dj-filippo241/maelcum_mixer/proto-max/RISULTATI-P0.md

# RISULTATI P0 — MC-CHANNEL (2026-10-14)

Piano: `docs/proto-max/piano.md` §2 P0 e §3. Generatore:
`proto-max/coefficienti/genera.py` (numeri in `canale.py`).

## Cosa contiene

- GAIN −∞ … 0 … +10 dB, law del VCA di canale (`sim/cdj/vca-law.cir`):
  metà CCW lineare in dB da −100 a 0, metà CW da 0 a +10.
- Isolator v0.4 (`eq-isolator-v0.4.md` §3, §9): banca LR4, allpass del
  2° ordine, pot lineare ×2, silenzio a fondo corsa (contatto).
  Selettore A 150/500/2500 Hz, C 150 dolce/350/3150, D 150 dolce/700/3150
  Hz (B7; fino al
  2026-10-14 sera B 100/630/4000, scartata con A, dec. 114), dissolvenza
  20 ms tra due banche che girano entrambe.
- Fader −∞ … 0, law [PROVVISORIA]: θ², −12 dB a metà corsa.
- Manopole lisciate a 10 ms.
- Non modellati: blocco della continua d'ingresso (0,72 Hz) e servo DC
  (Live non porta continua); clip e rumore (non si validano a orecchio,
  piano §1).

## FINDING: serve l'oversampling 4×

La banca convertita in digitale (bilineare con prewarp) stringe le
pendenze vicino a fs/2. Scarti contro LTspice senza oversampling:

| Incroci | 44,1 kHz | 48 kHz | 96 kHz |
|---|---|---|---|
| A 150/500/2500 | 1,09 dB (HIGH chiusa, 5 kHz) | 0,91 | 0,23 |
| B 100/630/4000 | 3,24 dB (HIGH chiusa, 8 kHz) | 2,73 | 0,85 |

Rimedio: la banca gira a 4× la frequenza di Live. Due stadi 2×
halfband polifase (schema hiir, de Soras): 12 coefficienti per
fs → 2fs, 4 per 2fs → 4fs. A 20 kHz passano con perdita < 0,000001 dB;
le immagini restano sotto −116 dB. L'infrastruttura serve anche a P1 e
P2: i saturatori la chiedono comunque.

## Verifica 1 — modello contro LTspice (`verifica.py`)

Criterio: scarto ≤ 0,5 dB dove LTspice sta sopra −40 dB; sotto, anche
il modello sotto −40 dB. Casi: le 9 righe di `eq-isolator` §4 e §9
(`iso-c-ac.log`) e le 6 della variante B (`iso-ac-b.log`), 12
frequenze, a 44,1 / 48 / 96 kHz.

| Incroci | 44,1 kHz | 48 kHz | 96 kHz |
|---|---|---|---|
| A (netlist col contatto) | 0,070 dB | 0,060 | 0,018 |
| B (netlist senza contatto) | 0,443 | 0,416 | 0,347 |

**PASS.** Lo scarto di B viene dal netlist, non dal modello: senza
contatto il pot chiuso lascia passare −54 dB (10 Ω su 10 kΩ). Con il
residuo del pot nel modello lo scarto scende a 0,01-0,03 dB. Il circuito
di progetto ha il contatto (eq-isolator §8): il modello segue quello.

## Verifica 2 — codice gen~ contro modello (`prova_gen.py`)

Il testo di `MC-CHANNEL.genexpr` tradotto in Python e suonato campione
per campione a 48 kHz (sinusoidi, ampiezza con fit ai minimi quadrati).
20 punti dell'isolator (A e B), 5 di GAIN, 3 di FADER, separazione dei
lati: **PASS, scarti ≤ 0,002 dB.**

Due errori trovati e corretti in questa verifica (il modello in
frequenza non li vedeva):

1. Ogni sotto-campione a 4× aveva filtri suoi: ogni filtro vedeva un
   campione su quattro e gli incroci scendevano di 4 volte (LOW chiusa:
   −0,4 dB a 80 Hz invece di −22,5).
2. Lo stesso errore sul secondo stadio dell'halfband: calo di −0,09 dB
   a 8 kHz con le manopole al centro.

## Verifica 3 — in Live (Filippo, 2026-10-14, `montaggio.md` §4)

- `MC-CHANNEL.amxd` si apre trascinato su una traccia; gen~ compila.
- Tutto al 50 %: suono invariato. Quattro bande a 0 %: silenzio.
- CPU con 4 dispositivi: **4 %** (240 biquad e 64 sezioni allpass per
  campione, per dispositivo). Margine ampio per P1-P4.

## Non verificato
- Confronto con LTspice dentro Max (rumore rosa, piano §3): sostituito
  dalle due verifiche sopra, che coprono la stessa catena in modo
  ripetibile.

## Variante C (2026-10-14 sera, dopo l'ascolto, dec. 114)

Richiesta di Filippo: HI a metà tra A e B; MID-HIGH che scende più in
basso; LOW e LOW-MID più accavallate. Proposta approvata: **C = 150 Hz
dolce / 350 / 3150 Hz**. Il primo incrocio è LR2 (12 dB/ott, Q 0,5):
LP2 − HP2 = allpass del 1° ordine, quindi i rami alti girano di polarità
e la somma resta piatta senza allpass in più (`canale.PENDENZE`). In
hardware è lo stesso schema con meno componenti su quell'incrocio; il
netlist LTspice di C si fa solo se C (o una sua figlia) passa l'ascolto.

Modello (`canale.isolator`, analogico), dB:

| Banda chiusa, punto | A | B | C |
|---|---|---|---|
| LOW, 50 Hz | −38,3 | −24,6 | −20,0 |
| LOW, 80 Hz | −22,5 | −10,7 | −13,1 |
| LOW, 250 Hz | −1,1 | −0,2 | −2,7 |
| LOW-MID, buco più profondo | −16,0 (275 Hz) | −26,3 (251) | **−7,8 (229)** |
| MID-HIGH, buco più profondo | −22,4 (1122) | −26,4 (1585) | −27,5 (1148) |
| HIGH, 5 kHz | −24,6 | −10,7 | −17,3 |
| HIGH, 8 kHz | −40,5 | −24,6 | −32,5 |

FINDING: con C la LOW-MID chiusa da sola scava solo −7,8 dB (stima a
voce prima del calcolo: ~−15). Banda stretta (1,2 ottave) e fianco basso
dolce: LOW e MID-HIGH la riempiono. È il prezzo dell'accavallamento.

Verifiche: `verifica.py` PASS invariato (A e B contro LTspice, il
modello LR4 non cambia); `prova_gen.py` PASS con 16 punti di C, scarti
≤ 0,001 dB. Il selettore ora porta A e C.

## Variante D (2026-10-14 sera)

Richiesta di Filippo: HI-MID «abbastanza ampio ma senza il kick», «più
simile ai mixer DJ del benchmark» (`docs/09`: confine implicito tra i
centri LO-MID e HI-MID = 620-760 Hz). **D = 150 Hz dolce / 700 / 3150 Hz**,
scelta di Filippo tra D, 500 Hz e entrambe. Nota a Filippo: contraddice in
parte la richiesta di prima (HI-MID sotto 500/630); nei mixer DJ i medi
sono campane larghe e il taglio di HI-MID si sente anche verso 400 Hz.

| Modello, dB | C (350) | D (700) |
|---|---|---|
| HI-MID aperta da sola, 250 Hz (colpo del kick) | −16,4 | −38,6 |
| HI-MID aperta da sola, 150 Hz | −35,7 | −59,6 |
| HI-MID chiusa, buco più profondo | −27,5 (1148 Hz) | −19,9 (1514 Hz) |
| LOW-MID chiusa, buco più profondo | −7,8 (226 Hz) | −13,8 (367 Hz) |

Selettore a tre posizioni (A, C, D), dissolvenza 20 ms tra varianti
vicine. `prova_gen.py` PASS con 9 punti di D in più.

## Selettore CURVA (2026-10-14, 23:55)

Filippo vuole la curva dei DJM Pioneer. I dati (docs/09 §7) dicono
−12 dB a ore 9 (DJM-600/850) e taglio rapido a fine corsa; col pot
lineare di serie nessuna rete passiva ci arriva. Per sentire se la
differenza conta: selettore **CURVA = LINEARE / PIONEER** (ideale, solo
ascolto). PIONEER: lato taglio (2θ)^1,5, lato boost uguale al lineare.

| Manopola | 5 % | 10 % | 20 % (ore 9) | 30 % | 40 % | 50 % | 75 % | 100 % |
|---|---|---|---|---|---|---|---|---|
| LINEARE, dB | −20,0 | −14,0 | −8,0 | −4,4 | −1,9 | 0 | +3,5 | +6,0 |
| PIONEER, dB | −30,0 | −21,0 | −11,9 | −6,7 | −2,9 | 0 | +3,5 | +6,0 |

`prova_gen.py` PASS (6 punti della curva PIONEER su D). Se PIONEER vince
all'ascolto, il circuito per costruirla resta da studiare (pot a taper
con trim, oppure stadio attivo).

## Selettore EQ TIPO (2026-10-15, voce B5)

Filippo tiene B5 aperta come opzione d'ascolto: **EQ TIPO = ISOLATOR /
SERIE**. SERIE è l'EQ in serie archiviato (v0.3 beta-3,
`docs/fase1/eq-serie-v0.3.md`): LOW Baxandall a shelf (70 Hz), LOW-MID e
MID-HIGH a campana sottrattiva (250 Hz Q 0,8 e 1 kHz Q 0,9), HIGH
sottrattiva con HP2 (~4,9 kHz). L'EQ di progetto resta l'isolator
(dec. 105). Modello: `coefficienti/serie.py`, ricavato dai componenti di
`sim/eq-serie/cascade-b3.cir` con op-amp ideali. Gira a 4× come
l'isolator; dissolvenza di 20 ms tra i due EQ. INCROCI e CURVA agiscono
solo su ISOLATOR.

Law delle manopole (eq-serie §10): LOW e HIGH a tratti, con il kill
negli ultimi 5 % di corsa; LOW-MID e MID-HIGH pot lineare col cursore
caricato dal summer (10k su 49,9k). Per la HIGH il netlist dà solo gli
estremi: la law intermedia segue quella della LOW in dB, normalizzata
agli estremi del netlist [PROVVISORIO, solo ascolto].

| Manopola | 0 % | 5 % | 10 % | 20 % | 30 % | 40 % | 50 % | 75 % | 100 % |
|---|---|---|---|---|---|---|---|---|---|
| LOW, 20 Hz | −29,2 | −23,6 | −17,9 | −11,3 | −6,9 | −3,3 | 0 | +2,8 | +5,8 |
| LOW-MID, 250 Hz | −48,3 | −19,2 | −13,3 | −7,5 | −4,2 | −1,8 | 0 | +3,4 | +6,0 |
| MID-HIGH, 1 kHz | −44,0 | −19,4 | −13,5 | −7,6 | −4,2 | −1,8 | 0 | +3,4 | +6,0 |
| HIGH, 20 kHz | −9,1 | −9,2 | −9,2 | −8,3 | −6,1 | −3,2 | 0 | +2,8 | +5,9 |

Cosa si sente rispetto all'isolator: nessuna banda spegne. LOW a zero
lascia la coda del basso (−16 dB a 250 Hz, −5 a 1 kHz); i medi a zero
scavano una buca stretta (−2 dB a un'ottava dal centro); HIGH a zero
scurisce invece di togliere (+1,7 dB a 5 kHz, −3 a 10 kHz: il finding
della questione 68). Tutte a zero: ~−26 dB sotto, ma 2,5-5 kHz restano
aperti.

Verifiche:
- `verifica_serie.py`: modello contro `cascade-b3.log`, 10 modi × 12
  frequenze. **PASS**, scarto massimo 0,24 dB analogico, 0,25 a 48 kHz,
  0,07 a 44,1, 0,01 a 96 (sotto −40 dB i notch del modello sono più
  profondi: op-amp ideali).
- `prova_gen.py`: 37 punti di SERIE in più, gen~ contro modello.
  **PASS**, scarti ≤ 0,001 dB; i punti di prima restano invariati.
- Non verificato: apertura in Max (sintassi gen~) e CPU con il ramo in
  più (4 biquad × 4 sotto-campioni × 2 lati).

## CPU: solo i blocchi che si sentono (2026-10-15 sera)

Finding in Live (Filippo): con canale, filtro e 5-way sulla stessa traccia,
muovendo le manopole l'audio «cambia velocità». Causa: Live calcola i
dispositivi di una traccia in fila su un solo core; il processo Live stava
a ~80 % di un core (l'indicatore CPU di Live, ~45 %, è la media dei core).
Il MC-CHANNEL con EQ TIPO non partiva più (Edit compreso). Con i
dispositivi MC spenti il problema spariva.

Rimedio: MC-CHANNEL calcola solo le varianti con peso > 1e-5 (−100 dB):
in uso normale una banca su quattro (A, C, D, SERIE), due durante i 20 ms
di dissolvenza. Gli stati di un blocco spento vanno a zero, così riparte
pulito. `prova_gen.py` PASS, più una prova nuova dei cambi di selettore
(A → D → SERIE → C: valore giusto dopo l'assestamento, nessun picco).

## SERIE v2 (2026-10-31, todo 210)

In Live, EQ TIPO = SERIE dava rumore fortissimo e clip continuo con la
musica che suona; tornava normale su ISOLATOR. La prova Python
(`prova_gen.py`) sullo stesso codice era stabile, e nel modello non c'e
alcun anello: le celle sommano in avanti. La causa esatta dentro gen~ non
e trovata. La v1 calcolava i biquad passando alla bilineare i polinomi in
s interi (coefficienti fino a 1e8 prima della divisione).

v2: LOW = due celle del 1o ordine, fattori esatti del Baxandall
(R + Zb) / (R + Za); LOW-MID, MID-HIGH e HIGH = biquad con prewarp da f0, Q
e guadagno al centro del circuito, come le bande dell'isolator che in Live
funzionano. Stabili per costruzione: polo piu vicino al cerchio 0,99938
(0-100 % di corsa, 44,1-192 kHz a 4x). `verifica_serie.py` contro
`cascade-b3.log`: PASS (scarto max 0,24 dB analogico, 0,23 dB a 48 kHz).
`prova_gen.py`: PASS. Comandi e law invariati.

Protezione (stesso giorno, solo prototipo): un campione NaN, infinito o
oltre +36 dBFS azzera gli stati ed esce silenzio; senza, un NaN avvelena il
mixer della traccia di Live. `MC-CHANNEL-PROVA` (`genera.py --prova`) ha
in piu il selettore STADI SERIE per accendere le celle una alla volta.

## XONE al posto di SERIE (2026-10-31, B5)

All'ascolto SERIE v2 era pulito, ma Filippo: «l'eq taglia veramente troppo
poco» (a 0 %: LOW -25 dB a 70 Hz, medi buco stretto, HIGH -3 dB a 10 kHz).
Richiesta: «serie ridisegnato in modo tale da essere simile al eq degli
xone». Il selettore EQ TIPO ora e ISOLATOR / XONE; il modello archiviato
`serie.py` resta, non e piu nel dispositivo.

Modello `coefficienti/xone.py`, dall'EQ musicale del Xone:92 (user guide
AP5345, guida Limited Edition): LO 250 Hz e HI 2,5 kHz da +6 dB a kill
(coppie Linkwitz-Riley 2: g LP2 - HP2, allpass a g = 1, a fondo corsa
filtro a 12 dB/ottava), LO-MID 350 Hz e HI-MID 2 kHz campane RBJ da +6 a
-30 dB, Q 0,6 in taglio e 2 in boost [PROVVISORIO: il Xone non le
pubblica]. Law delle manopole dell'isolator, CURVA compresa.

| pos % | LO a 60 Hz | LO-MID a 350 Hz | HI-MID a 2 kHz | HI a 10 kHz |
|---|---|---|---|---|
| 0 | -25,3 | -30,0 | -30,0 | -24,7 |
| 10 | -12,3 | -14,0 | -14,0 | -12,2 |
| 25 | -5,6 | -6,0 | -6,0 | -5,5 |
| 50 | 0 | 0 | 0 | 0 |
| 100 | +5,8 | +6,0 | +6,0 | +5,8 |

(CURVA LINEARE, 48 kHz.) A 0 % il LO e un passa-alto: piu si scende sotto
250 Hz, piu taglia (-37 dB a 30 Hz); lo stesso per HI sopra 2,5 kHz.
Tutte al centro: piatto entro 1e-11 dB. Polo piu vicino al cerchio
0,99949 (44,1-192 kHz a 4x). `prova_gen.py`: PASS (casi XONE gen~ contro
`xone.xone_os`). `MC-CHANNEL-PROVA` tolto: serviva solo al guasto di SERIE.

## DJM al posto di XONE (2026-10-31, B5)

All'ascolto XONE taglia ancora troppo poco (Filippo). ISOLATOR va bene;
Filippo vuole un'opzione che tagli tantissimo, sul modello del DJM-900NXS,
in due versioni («dammi sia 1 che 2»): fedele al manuale e spinta. Il
selettore EQ TIPO ora e ISOLATOR / DJM -26 / DJM SPINTO -40; `xone.py`
resta come archivio, non e piu nel dispositivo.

Dato del manuale DJM-900NXS: LOW 70 Hz, MID 1 kHz, HI 13 kHz, ognuna da
-26 a +6 dB. Pioneer non pubblica dove partono gli scaffali ne la larghezza
della campana: i numeri sotto sono scelte [PROVVISORIO]. Modello
`coefficienti/djm.py`: celle RBJ (scaffali S = 1, campana), LOW = scaffale
basso, LOW-MID = campana a 1 kHz, HIGH = scaffale alto, MID-HIGH non agisce.
Law dell'isolator in dB, fermata al fondo; +6 dB a fine corsa.

| variante | scaffale LOW | scaffale HIGH | stadi per lato | Q MID | fondo |
|---|---|---|---|---|---|
| DJM -26 | 300 Hz | 3,6 kHz | 1 | 0,7 | -26 dB |
| DJM SPINTO -40 | 320 Hz | 3 kHz | 2 | 0,5 | -40 dB |

Tagli a 0 % (le altre al centro, 48 kHz):

| banda | DJM -26 | DJM SPINTO -40 |
|---|---|---|
| LOW a 70 / 150 / 250 / 500 Hz | -25,8 / -22,5 / -15,8 / -5,5 | -39,8 / -36,6 / -26,8 / -8,4 |
| MID a 300 / 1000 / 4000 Hz | -7,3 / -26,0 / -5,9 | -16,5 / -40,0 / -14,7 |
| HIGH a 2 / 3,5 / 5 / 13 kHz | -4,6 / -12,6 / -18,0 / -25,5 | -9,3 / -24,3 / -32,9 / -39,8 |

Corsa uguale per tutte: 10 % circa -14 dB, 25 % -6 dB, 50 % 0, 100 % +6
(CURVA LINEARE). Tutte al centro: piatto. `prova_gen.py`: PASS (casi DJM
F e P gen~ contro `djm.djm_os`, cambi di selettore senza picchi);
`prova_semplice.py` PASS; `regole_gen.py` nessuna collisione; rumore
bianco con manopole a 0 e a 100 %: stabile. MC-CHANNEL-S invariato.

## INCROCI A 400 e A 450 (2026-10-31, libretto 7.2)

Filippo: «incroci da rivedere: vorrei un MID-HIGH più ampio verso il basso
(non di molto)»; scelta «400 450». Due voci nuove nel selettore INCROCI di
MC-CHANNEL, tutte LR4 come A: A 400 = 150 / 400 / 2500 Hz, A 450 = 150 /
450 / 2500 Hz. Le voci si chiamano ora A 500, C 350, D 700, A 400, A 450
(il numero e l'incrocio fra LOW-MID e MID-HIGH). MC-CHANNEL-S resta su A.

Esito: Filippo sceglie **C** (dec. 152). MC-CHANNEL-S passa da A a C;
A 400 e A 450 restano nel selettore della versione completa.

## MC-CHANNEL-S sulla curva LINEARE (2026-11-04, todo 240, dec. 168)

L'hardware usa un pot lineare B a catalogo: la curva PIONEER non si fa
(dec. 168, `sim/eq-iso/RISULTATI-incroci-C.md` §3). MC-CHANNEL-S passa da
PIONEER a LINEARE, come il mixer vero. Sopra il centro non cambia niente;
sotto il centro il taglio è più dolce: a ore 9 la banda sta a −8 dB invece
di −12, a 10 % a −14 invece di −21.

Il selettore CURVA di MC-CHANNEL ha già la voce LINEARE (pot lineare ×2):
nessuna voce nuova. Confronto con la simulazione dell'hardware (stesso
§3, tutte le manopole alla stessa posizione, 1 kHz):

| θ | 0,05 | 0,1 | 0,2 | 0,25 | 0,3 | 0,4 | 0,5 | 0,75 | 1 |
|---|---|---|---|---|---|---|---|---|---|
| prototipo LINEARE, dB | −20,0 | −14,0 | −8,0 | −6,0 | −4,4 | −1,9 | 0 | +3,5 | +6,0 |
| HW pot lineare B, dB | −19,7 | −13,8 | −7,9 | −6,0 | −4,4 | −1,9 | 0 | +3,5 | +6,0 |

Scarto massimo 0,3 dB, a θ 0,05. Unica differenza vera: a fondo corsa il
prototipo tace, l'hardware resta a −48 dB (residuo di 20 Ω del pot, niente
contatto di fondo corsa, dec. 127). Il prototipo non la imita.

MC-CHANNEL invariato (rigenerato identico). `prova_semplice.py` confronta
ora il -S con MC-CHANNEL su INCROCI C 350 e CURVA LINEARE: PASS, scarto 0
su 6 casi. `prova_gen.py` PASS; `regole_gen.py` nessuna collisione.

## GAIN a pot doppio in MC-CHANNEL e MC-CHANNEL-S (2026-11-12, dec. 162)

Il GAIN del prototipo seguiva ancora la legge del VCA (−100 dB → 0 → +10 dB, a ore 11 già
−20 dB). La dec. 162 ha messo un pot doppio nel segnale: ora il prototipo usa il circuito T1
(`sim/gain-pot/`, pot 10k lineare, Rl 4,30k dal cursore a massa, non invertente ×3,15;
`canale.gain_lin`, `genera.py`). All'orecchio: la metà sinistra diventa un trim (−5,2 dB al
25 %, silenzio solo a fondo corsa), la metà destra resta 0 → +10 dB (+4,3 dB al 75 %). Lo
stesso per il GAIN dei ritorni (RISULTATI-P3, T2). Prove: `prova_gen.py` (attesi dal modello)
e `prova_fx.py` PASS; `prova_semplice.py` PASS.

Verificato in: Python sì / LTspice no (la curva viene da `sim/gain-pot/gain_pot.py`) / Live no.
