dj-filippo241/maelcum_mixer/docs/01-decisioni-bloccate.md

# Decisioni bloccate

> Regola del progetto: una decisione sta qui UNA VOLTA SOLA. Se cambia, si sposta in
> `questioni-aperte.md` con la data e il motivo, e qui si aggiorna. Niente duplicati.
>
> Legenda origine: **[F]** = detta da Filippo il 2026-09-17 · **[R]** = dal resoconto
> ChatGPT (da riverificare sull'export completo) · **[C]** = proposta di Claude accettata da Filippo.

## Scopo e portata

1. **[F]** Esemplare unico, per il soundsystem di Filippo. Nessuna produzione in serie: si ottimizza per qualità sonora e manutenibilità, non per costi.
2. **[F]** Ruolo di Claude: supporto quasi totale — specifica, progettazione circuiti, simulazioni, selezione componenti, schemi.
3. **[F]** Costruzione fisica: da decidere chi la esegue (vedi questioni aperte).
4. **[F]** Ordine di costruzione — **fase 1**: un modulo canale (phono o CDJ/line), un modulo FX, master out, alimentazione di base. **Fase 2**: 5-way preamp e filtro globale. Motivazione: i moduli semplici validano il backplane prima di affrontare i blocchi difficili.
5. **[F]** Metodo: PRIMA revisione completa e critica del lavoro fatto con ChatGPT (appena arriva l'export), POI si progetta. Niente costruzione sulla base del solo resoconto parziale.

## Architettura generale (dal resoconto, da confermare su export)

6. **[R]** 100% analogico per l'audio. Nessun DSP interno. Il DSP esterno resta responsabile di: crossover di sistema, protezione altoparlanti, EQ di sistema, delay/allineamento, gestione finali.
7. **[R]** Livelli: nominale 0 dBu; headroom interna pulita ≥ +24 dBu come requisito DI SISTEMA (non di ogni IC — correzione 1/2 della review).
8. **[R]** Alimentazione: rail di sistema ±24 V con regolazione locale per ogni dominio di tensione degli integrati (es. ±15 V locali).
9. **[R]** Nessun compressore/limiter/AGC nel percorso audio. Le uniche nonlinearità volute: overdrive del filtro globale e drive del 5-way. [ECCEZIONE dec. 145, 2026-10-31: limiter fisso sul solo modulo MIC.]
10. **[R]** Protezione elettrica ≠ processing dinamico: restano obbligatorie protezioni DC, corto, ESD, mute power-on/off (non sono "dinamica").
11. **[R]** Buffering a bassa impedenza tra stadi/moduli. Ogni uscita (MASTER, BOOTH, REC) ha il suo buffer dedicato: mai un buffer unico splittato.
12. **[R]** Architettura stereo: no pan, controlli linked L/R, tracking ≤ 0,25 dB, mono-compatibile.
13. **[R]** Costruzione modulare su backplane. Il backplane separa fisicamente: bus audio, bus di controllo, alimentazione, ground/reference, chassis/shield. Niente connessioni a nodi interni tra moduli. Niente hot-swap. Test point sui moduli.
14. **[R]** Convenzione d'interfaccia CV 0–5 V sul backplane — è una convenzione di interfaccia, NON la tensione nativa di ogni circuito (ogni stadio può avere la sua legge interna, es. esponenziale per le frequenze).

## Canali DJ

15. **[R]** 4 canali DJ. Catena: input → gain → EQ → split CUE/FX → filtro (selettore locale) → fader → bus.
16. **[F]** Ogni canale può esistere come modulo a sé stante.
17. **[F]** EQ di canale: 4 bande in stile Xone — bassi, medio-bassi, medi, alti. Ogni knob scende fino a −∞ (full CCW = kill della banda).
18. **[F]** Frequenze e comportamenti esatti dell'EQ di canale: da rivedere insieme in seguito (non bloccati).
19. **[R]** Phono: ingressi con RIAA (costanti 3180/318/75 µs come riferimento concettuale — il circuito vero è da progettare), loading/capacità dipendenti dalla testina, terminale di terra dedicato per giradischi.

## 5-way performance EQ (il "preamp")

20. **[R]** Il 5-way sta tra i bus di canale e il master: DJ bus → 5-way → master.
21. **[F]** Le 5 bande (SUB, KICK, MID, HIGH, SUPER HI) corrispondono alle 5 vie fisiche dell'impianto di Filippo.
22. **[F]** I kill switch stanno nella sezione preamp: uno per via, tarati per spegnere interamente il segnale di quella via dell'impianto.
23. **[R]** KILL prima dell'EQ creativo: l'EQ non può ripristinare materiale killato. Il KILL va progettato come filter bank complementare (le 5 bande sommate ricostruiscono risposta piatta senza kill attivi), non come 5 filtri indipendenti.
24. **[F]** Curva del drive — piena CCW = pulito (0); a metà corsa (~50%) il 5-way lavora nel punto ottimale (es. boost +7 dB senza distorsione); oltre il 50% la saturazione entra progressivamente e interagisce con i gain di banda e con l'overdrive del filtro. Da tradurre in taper del pot + gain staging.
25. **[R]** Drive: JFET in prima istanza / BJT asimmetrico in seconda, post-EQ, con input drive e headroom globali. È un dub-preamp su misura, non un parametrico generico.

## Filtro globale

26. **[R]** Controlli: 4 condivisi (freq HPF, freq LPF, risonanza, overdrive) + selettore locale per canale HPF/OFF/LPF. (La versione precedente "controlli locali per canale" è SUPERATA.)
27. **[R]** SVF 4 poli; HPF 20 Hz–1,5 kHz; LPF 500 Hz–20 kHz; risonanza fino all'auto-oscillazione che segue il cutoff (max ~+6/+10 dBu con limiting morbido); overdrive DOPO il filtro.
28. **[F]** Riferimento sonoro: più vicino allo Sherman Filterbank che all'E&S — carattere aggressivo, risonante, personalità marcata.
29. **[F]** Auto-oscillazione usata musicalmente (non solo come colore al limite).

## Sistema FX

30. **[R]** 4 bus FX. Mandate con EQ 2 bande e switch di assegnazione. Ritorni con fader.
31. **[R]** Matrice di feedback tra FX: 12 percorsi diretti, 3 destinazioni per ritorno, niente self-route. Da progettare come rete di routing analogica unica, non come 12 hack indipendenti.
32. **[R]** Reroute PRE-fader: il fader del ritorno taglia l'audio verso il master ma NON il feedback interno.
33. **[R]** VCA analogici per il rerouting (THAT 2180 come candidato reale) con gestione di livello propria (il VCA non eredita automaticamente il +24 dBu di sistema).
34. **[F]** Interfaccia pedali: pronta SIA per pedali chitarra SIA per rack da studio → pad di mandata selezionabile (−20 dB è valore di prototipo, non congelato). Ritorno: alta impedenza (≥ 1 MΩ), alto headroom, protezione.
35. **[F/C]** I controlli della matrice vanno pensati per l'uso dal vivo: utilizzabili mentre si mixa, con via di fuga rapida (il fader taglia subito l'audio). Elettricamente identica alla versione studio.

## Mic e ingressi generici

36. **[F]** Mic: solo dinamici, NIENTE phantom 48 V. Semplifica preamp e protezioni; gain ~40-50 dB.
37. **[R]** Ingressi mono generici: architettura a modulo sorgente generico, non cucita su uno strumento specifico. Mono → stereo conversion, EQ 2 bande, clip warning, FX send.

## Master, uscite, metering

38. **[R]** MASTER LEVEL: −∞ → 0 dB → +6 dB, stadio attivo (non solo pot passivo), stereo-linked, full CCW = mute pratico. Meter DOPO il level (il meter mostra il livello reale in uscita).
39. **[R]** BOOTH: presa da MASTER SUM prima del MASTER LEVEL; −∞ → 0 dB; il master level non influenza il booth.
40. **[R]** REC: presa da MASTER SUM prima di entrambi i level; nessun controllo utente; ≈ 0 dBu al nominale.
41. **[F]** REC out → registratore Zoom (modello esatto da comunicare; implica livello/impedenza/connettore adatti all'ingresso Zoom).
42. **[R]** Uscita master: driver di linea bilanciato attivo, XLR L/R, Z out < 50 Ω ideale, capacità pulita ≥ +24 dBu, protezione corto, niente trasformatore d'uscita, nessuna colorazione intenzionale.
43. **[R]** Metering a 6 zone: blue (poco) → green (safe) → yellow (loud) → amber (hard) → red (extreme) → purple (clipping reale, con clip detector vero sul nodo).
44. **[R]** Banda complessiva target 8 Hz–35 kHz con filtro OFF (il filtro inserito limita volutamente la banda); la tolleranza esatta (es. ±0,1 dB) NON si specifica prima di misurare.

## Alimentazione

45. **[F/C]** PSU: lineare con trasformatore toroidale + regolazione locale per sezione. Nessun vincolo di peso dichiarato. Switching = piano B se il peso diventasse un problema.
46. **[R]** Power-on mute e power-off mute obbligatori. Sequencing e protezione per ramo di modulo. Budget di corrente e termico da calcolare.

## Interfaccia fisica

47. **[F]** Fader = slider; tutto il resto = potenziometri rotativi.
48. **[R]** Il design del pannello frontale è di Filippo; da Claude solo i requisiti elettrici (consumi modulo, pin connector, correnti backplane, contatti di massa, schermature, accessi di servizio/test).

## Modulo MASTER OUT — decisioni di Filippo (2026-09-18)

49. **[F]** MASTER OUT universale: deve lavorare con la maggior parte dei DSP standard, nessun processor specifico di riferimento (XLR bilanciato, 0 dBu nominale, capace di pilotare ingressi pro +4 dBu con trim, Z out < 50 Ω).
50. **[F]** REC OUT universale: compatibile con la maggior parte dei registratori standard (Zoom o equivalente): jack TRS con cablaggio unbalanced-compatible, attenuazione fissa a −10 dBV [PROVVISORIO], jumper −10/−20 dB opzionale sul PCB.
51. **[F]** Connettore BOOTH: XLR bilanciato.
52. **[F]** MASTER LEVEL con detent meccanico a unity. L'hardware di tutte le manopole (marca/modello pot, slider, cap) si rivede globalmente in una sessione dedicata più avanti.
53. **[F]** Metering master alla massima precisione possibile: scala logaritmica 20 segmenti per canale a passi 3 dB (LM3915 in cascata come candidato), attacco < 1 ms, decay regolabile, purple = clip detector indipendente con latch 0,5 s.
54. **[F]** Rail ±15 V low-noise con LT3045/LT3094 confermati (summing, CV del VCA, meter).
55. **[F]** La logica colori/zone del meter NON si reinventa: è definita nel backlog con ChatGPT e si recupera dall'export [EXPORT]. La scala elettrica a 20 segmenti è progettata indipendentemente dai colori.

## Modulo CANALE CDJ/LINE (2026-09-18)

56. **[F]** Scope fase 1 del canale: SOLO ingresso line (CDJ/line). La sezione phono/RIAA non si progetta ora; il modulo lascia spazio a una variante phono futura. Design v0.1 in `docs/fase1/cdj-line-channel.md`.
57. **[R derivato]** Split CUE e FX send sono PRE-FADER (derivato dalla catena bloccata del resoconto, voce 15): canale chiuso non zittisce CUE né FX send.

## Dalle risposte di Filippo ai 12 quesiti + status document (2026-09-18 pomeriggio)

58. **[R2]** Corpus di riferimento CHIUSO: resoconto 00 + i due status doc del 2026-09-18 (`docs/export-chatgpt/`) sono la referenza completa e definitiva. Non è possibile ottenere un export migliore della conversazione; non esiste una "project specification" separata lato ChatGPT. Le voci [EXPORT] si risolvono contro questi documenti o restano aperte in modo definitivo.
59. **[R2]** Dettagli confermati dagli status doc: canali STEREO identici; gain canale −∞→0→+10 dB con detent centrale e tracking ≤0,5 dB; EQ 4 bande −∞→0→+6 dB (LOCKED) con tracking ≤0,25 dB e law "lenta al centro, rapida agli estremi"; frequenze EQ proposte 70/250/1k/5k Hz (LOW/LOW-MID/MID-HIGH/HIGH, Q ~0,7-0,9); assignment FX multiple simultanee con precision analogue switch (JFET scartati); CUE post-EQ/pre-filter/pre-fader; return gain −∞→0→+20 dB; meter DJ completo post-filter/overdrive pre-fader con persistenza e calibrazione identica tra canali; tabella legge di reroute FX.
60. **[F]** Il MODULO FILTRO è ESTERNO ai canali (chiarimento del proprietario, corregge la lettura di docs/03 §3.3): il canale ha SOLO il selettore HPF/OFF/LPF; i 4 core filtro stereo + controlli condivisi (freq HPF, freq LPF, risonanza, overdrive) + stadio overdrive vivono nel modulo filtro dedicato. Tra canale e modulo filtro: send/return audio sul backplane + logica del selettore. L'ipotesi originale del CDJ v0.1 §3.6 è quella valida.
61. **[F]** Build order confermato (nessuno spezzamento 1a/1b necessario, dato il filtro esterno): fase 1 = canale line (senza phono; filtro su OFF/bypass finché il modulo filtro non esiste) + modulo FX + master-out + PSU base; fase 2 = modulo filtro e 5-way. Phono Rev A solo su carta.
62. **[F]** Phono V1: MM-only (copre testine DJ standard e MM di alta qualità); MC fuori scope (eventuale step-up/Rev B). Connettore RCA stereo + ground dedicato; 47 kΩ al connettore; capacità interna selezionabile con default 100 pF, accesso solo tecnico (nessun selettore user). Gain totale 40-42 dB NON congelato: si bilancia nel gain-staging globale. Primo stadio: entrambe le varianti dei documenti restano [PROVVISORIO] (21,3 dB del PDF, grounded sul PhL-100 / 26,0 dB dell'addendum DOCX, che Filippo indica come successivo) — sceglie la simulazione (rumore vs overload).
63. **[F]** REC OUT: 0 dBu nominali fissi, nessun controllo utente («la cosa più semplice e standard»); pad solder-only 0/−10/−20 dB sul PCB per registratori sensibili (accesso tecnico). Supersede la proposta −10 dBV + jumper utente.
64. **[F]** Terza banda EQ = MID-HIGH @ ~1 kHz (è ciò che Filippo chiama «medi»).
65. **[F — REQUISITO NUOVO]** Capacità infrasub ~10 Hz: il mixer deve poter scendere sotto i sub. Specifica derivata: banda complessiva −3 dB a ≤8 Hz (10 Hz entro ±1 dB); territorio del KILL SUB esteso a ~10-90 Hz; nessun accoppiamento AC con corner >5 Hz nel percorso principale (DC servo); metering leggibile anche a 10 Hz (peak detector senza sagging) — **PARTE REVISIONATA 2026-09-28 dalla decisione 81: ballistica meter stile Pioneer DJM (release ~0,3 s), «senza sagging» sostituito da «leggibile a zone con ballistica viva»**; HPF min esteso a 10 Hz oppure 20 Hz con posizione OFF per l'infrasub → [APERTO-F, nuova voce 49]. Il resto della decisione (banda infrasub, DC servo, territorio KILL SUB) resta invariato.
66. **[R2]** Riferimento impianto: typologia «5-way dub soundsystem» (i modelli specifici non contano, erano indicativi); crossover di riferimento ~90 Hz / ~350 Hz / ~1,2 kHz / ~3,5 kHz [PROVVISORIO]; espansione futura 4×SUB + 4×KICK annotata come concept.

## Modulo FILTRO — architettura scelta da Filippo (2026-09-18, "B prime")

67. **[RIVISTA dalla dec. 159 (2026-10-31): i core non sono più per canale, ma uno stereo per sezione sulla somma dopo il fader; pannello e 6 knob restano.]** **[F]** Architettura filtro = **B′**: un core filtro dedicato per canale (4 stereo, tutti nel modulo filtro esterno — decisione 60 confermata), con DUE set di parametri indipendenti e condivisi: sezione HPF (freq, resonance, overdrive) e sezione LPF (freq, resonance, overdrive) = **6 knob sul modulo filtro**. Sul modulo canale: **solo switch 3 posizioni HPF/OFF/LPF** (niente BPF — escluso esplicitamente). Tutti i canali nella stessa modalità seguono gli stessi knob. L'overdrive di canale segue il set della sezione selezionata dallo switch. Conseguenza elettrica accettata: 8 core mono (4 canali × L/R) sullo stesso PCB, con trimming per il tracking (voce 51).
68. **[F derivato — veto possibile]** HPF min esteso a **10 Hz** (range 10 Hz–1,5 kHz): conseguenza diretta del requisito infrasub (decisione 65) — con filtro inserito e knob al minimo, l'infrasub a 10 Hz resta udibile. Fattibilità del converter da verificare in simulazione SVF; se impossibile, ripiegare a 20 Hz + posizione OFF e riaprire la questione.
69. **[F]** Phono, conferma risposta "7 rca": pannello = RCA stereo + ground dedicato; loading/capacità solo interni (tecnico). Capacità selezionabile: resta come opzione economica su solder-pad/DIP interno (default ~100 pF) — non è strettamente necessaria (un valore fisso ben scelto + capacità del cavo copre il 90% dei casi MM), ma costa ~2 € e dà margine di rifinitura; se Filippo preferisce eliminarla, fisso ~150 pF.

## Legge dei knob filtro + gain staging (2026-09-18 pomeriggio)

70. **[F]** Legge dei controlli di frequenza del filtro (HPF e LPF): agli estremi della corsa il filtro **cancella tutto** (silenzio); la curva è musicale per ~il 90% centrale e **accelera fortemente negli ultimi ~5% a entrambe le estremità**. Implementazione: shaper di CV a tratti (rete diodi/resistori, tecnica standard da sintetizzatore, rifinitura a banco). Conseguenza ingegneristica [DA CONFERMA ESPLICITA]: entrambe le sezioni spazzano l'intera banda audio ~10 Hz–25 kHz (carattere Sherman) — questo SUPEREREBBE i range dei documenti (HPF 20 Hz–1,5 kHz / LPF 500 Hz–20 kHz). Range gm ~2500:1 con converter esponenziale + tempco (tecnica VCO da synth, fattibilità da verificare in simulazione SVF; niente fallback 20 Hz: Filippo rifiuta il compromesso di base).
71. **[C]** Mappa dei domini di alimentazione (sheet §1): ±24 V solo stadio HV master; ±18 V per tutto l'audio di potenza/percorso; ±15 V ultra-low-noise per phono/mic/CV/metering/CUE; +5 V control. Il gain-staging sheet (`docs/fase1/gain-staging-sheet.md`) è la referenza autorevole dei livelli.
72. **[C]** Gain totale phono: **42 dB** a 1 kHz (bilanciamento di sistema: testina 5 mV → −1,8 dBu ≈ nominale con gain di canale a 0). Split primo stadio (21,3 vs 26 dB) rinviato alla simulazione phono.
73. **[C]** 5-way con riferimento interno −6 dB: pad −6 in ingresso, makeup +6 in uscita — headroom per i boost +15 dB delle bande, nessun effetto udibile (simmetrico).

## Conferma filtro full-range + feedback comunicazione (2026-09-18)

74. **[F]** Conferma e precisione della decisione 70, nelle parole di Filippo: il filtro è fatto di **2 sezioni — una low-pass e una high-pass — entrambe tarate sul range 10 Hz–35 kHz**. Knob con curva musicale nei ~90% centrali e forte accelerazione negli ultimi ~5% a entrambe le estremità; all'estremo di taglio il segnale è cancellato del tutto (HPF in cima alla corsa, LPF in fondo). Il fallback a 20 Hz è DEFINITIVAMENTE TOLTO («di base non lo voglio»). La decisione 68 è assorbita in questa. Nota ingegneristica: range gm ~3500:1 (~11,8 ottave) via converter esponenziale + tempco; la precisione richiesta è più lasca di un VCO (un filtro tollera ±5-10% in frequenza senza che sia udibile come "stonato"); fattibilità da verificare in simulazione (fase 2); le macchine di riferimento (Sherman Filterbank, E&S) coprono range analoghi.
75. **[F — comunicazione]** Feedback di Filippo: linguaggio troppo stringato, in particolare sulle sensazioni sonore. Registrato come regola 8 del CLAUDE.md di progetto: quando si parla di suono, spiegare in modo concreto e disteso cosa si sente e in che situazione.

## Modulo CANALE CDJ — topologia EQ (2026-09-24)

76. **[F]** Topologia EQ del canale CDJ = **serie per banda (famiglia Baxandall / filtri a guadagno variabile in cascata)**. Origine: questione 62 — la simulazione LTspice (`sim/cdj-eq/RISULTATI-eq.md`) ha dimostrato che la cella a contribuzione bipolare non realizza fisicamente il kill/boost locked sulle bande LOW/HIGH (la math validata ignorava la fase dei filtri; misure: kill LOW −8 dB @20 Hz con bump +1,5 dB @70 Hz, boost HIGH ~0 dB al centro, leak all-kill −0,67 dB). Filippo sceglie l'opzione B. Proprietà da realizzare in EQ v0.3 [target ingegneristici PROVVISORI, da confermare in simulazione]: kill profondo e monotono per banda (target −20…−40 dB), boost +6 dB locked (requisito §1 immutato), detent piatto entro ±0,1-0,3 dB (tolleranze componenti — non più "zero esatto per costruzione": sotto la soglia uditiva e sotto il requisito di tracking 0,25 dB, giudicato accettabile), law "lenta al centro, rapida agli estremi" [requisito immutato]. Conseguenze: ridisegno EQ v0.3 (celle, curve, law, BOM §6); il residuo all-kill va quantificato in v0.3 (questione 59 riformulata); il metodo di tracking stereo resta aperto (questione 53: pot doppi selezionati/trim vs VCA per banda). Opzione A (bande parallele Linkwitz-Riley + VCA per banda) archiviata come alternativa documentata se la via serie non rispetterà i requisiti di kill/piattezza; opzioni C/D scartate (rattoppi). La SPECIFICA non cambia: il requisito comportamentale §1 resta, cambia il design che lo realizza.

## Modulo CANALE CDJ — profondità kill EQ (2026-09-24)

77. **[F]** Profondità del kill per banda dell'EQ in serie (celle v0.3, decisione 76) = **−30 dB** (rapporto di rete Rp/R ≈ 31). Scelta tra −30 (raccomandazione di Claude: impedenze basse, rumore contenuto, ~3% di ampiezza residua = il basso sparisce percepito in un mix) e −40 (più margine sulle sovrapposizioni, reti più rumorose). Il silenzio assoluto resta lavoro del fader: il kill è un gesto musicale, non un mute. Dimostrazione misurata: `sim/eq-serie/low-cell.cir` (−29,8 dB monotoni, nessun bump) + `docs/fase1/eq-serie-v0.3.md` §2. La v0.3-beta progetta le reti di tutte e 4 le bande su questa profondità (chiusa la questione 66).

## Prototipazione musicale digitale (2026-09-24)

78. **[F]** Prima del prototipo su millefori si costruisce un **prototipo musicale in Max for Live** (Ableton Live Suite, controllo a mouse) del **mixer completo**: catena canali → EQ serie → filtro globale → 5-way → bus FX con matrice di feedback → master, in fasi giocabili successive. Scopo: validare A ORECCHIO gesto, curve, leggi dei controlli e carattere musicale PRIMA di spendere in componenti; chiudere le questioni musicali pendenti (61 drive/referenze, 63 mux filtro, 64 allineamento 4 poli, review centri EQ, taper) con ascolti A/B immediati. Il metodo della fase circuitale resta intatto: il prototipo M4L valida la MUSICA, non l'elettricità (rumore, saturazione OTA reale, tracking meccanico restano di competenza del millefori e delle misure). Piano: `docs/proto-max/piano.md`; le patch vivono nel repo (`proto-max/`) come .maxpat versionati, assemblati in dispositivi .amxd dentro Live (procedura documentata). Regola pratica: le curve/leggi approvate a orecchio nel prototipo diventano requisito per il design circuitale corrispondente.
79. **[C 2026-09-28, orig. questione 6]** Topologia front-end phono MM: stadio piatto low-noise (OPA1612 ×21) + subsonica Sallen-Key 13 Hz + RIAA PASSIVA (equazioni chiuse τ318/τ3180/τ75) + stadio piatto OPA1654 ×60,6 = 42 dB a 1 kHz; niente RIAA in feedback (warp nel loop), niente elettrolitici nel percorso (DC bloccata dalla SK). Design e numeri: `docs/fase1/phono-stage.md` v0.1.

## Sessione decisioni (2026-09-28)

80. **[F — ratifica voce 55]** Soppressione transiente delle commutazioni CV: **famiglia unica ramp 1 ms lineare-in-dB + break-before-make per TUTTE le commutazioni comandate in tensione del mixer** (gate kill 5-way, reroute/assign FX, BBM modo filtro). Dati misurati a supporto: kill al picco +10 dBu brusco → transiente HF 3,64 V (click udibile); ramp 1 ms → 1,39 V (−8,4 dB, fade esponenziale senza kink, residuo post-fade 1,8 mV); 3 ms → 0,90 V ma gesto pigro (`sim/five-way/gate-ramp.cir`). Reroute FX: τ 1 ms chiude in ~5 ms, τ 5 ms in ~25 ms = troppo lento (`sim/fx/`, FX v0.2 §8.3). BBM filtro validata sulla famiglia 1 ms (2026-09-28, `sim/filtro/bbm-ramp.cir`). Conseguenza progettuale: un solo riferimento di temporizzazione e un solo blocco di smoothing CV per tutto il mixer. Chiude la voce 55 delle questioni aperte. **[PARZIALMENTE REVOCATA 2026-09-30 dalla decisione 88: il gate kill 5-way passa a switch hard-cut (niente VCA, niente ramp); restano validi reroute/assign FX e BBM modo filtro.]** [REV 2026-11-03, todo 224: negli assign FX-SEND la «ramp» con RC sul pin IN dell'ADG1434 non esiste (pin logico, scatta secco); il requisito «niente click» si ottiene col taglio al passaggio per lo zero, come il kill (dec. 164): `sim/fx/RISULTATI-fx-send-assign.md`.]
81. **[F — ratifica voce 19 (ballistica) + REVISIONE decisione 65]** Ballistica dei meter = **stile Pioneer DJM** (referenza di Filippo: la barra dei mixer DJ): attacco rapido (cattura del picco esatta, già dimostrata: +0,006% a 1 kHz), **release ~0,3 s** — barra viva che segue la musica; latch clip purple 442 ms invariato (nodo separato, conforme SPEC 300-500 ms). REVISIONE della parte metering della decisione 65: «metering leggibile anche a 10 Hz (peak detector senza sagging)» è sostituito da **«metering leggibile a zone, con ballistica viva»**: la pulsazione sui bassi (a 10 Hz con τ 0,3 s: −2,9 dB/ciclo ≈ 1 segmento su scala 3 dB) è accettata come informazione musicale, non più come difetto. La raccomandazione tecnica precedente (release ≥1 s, 3 s consigliato) è SUPERATA dalla scelta estetica. Affinamento della costante (0,2-0,5 s) a banco/prototipo. Restano aperte nella voce 19: soglie red/purple, numero segmenti per le posizioni non-master, tipo meter, tarature per posizione, architettura driver.
82. **[F — referenze sonore questione 61]** Carattere delle tre distorsioni VOLUTE (decisione 9: uniche nonlinearità del mixer), nelle parole di Filippo: (1) **Drive 5-way** = «prima nastro, nell'ultimo 20% entra nel territorio del fuzz» — saturazione calda da tape machine per la prima parte della corsa (infittisce senza rompersi, compressione leggera), transizione a saturazione dura stile fuzz negli ultimi ~20%. Raffina il taper di SPECIFICA §6: CCW = 0 dB pulito, ~50% = punto ottimale +7 dB clean, 50→80% = colore nastro progressivo, 80→100% = territorio fuzz. (2) **Overdrive filtro** = **Sherman Filterbox**: raschio acido che cresce con la risonanza; il core OTA nudo del design v0.2 (~1% THD morbido a 0 dBu) è già di questa famiglia — referenza vincolante anche per l'ascolto questione 70 lato filtro, (a) carattere vs (c-B) pulito. (3) **EQ 5-way spinto** (+15 dB e oltre) = **sporca progressivamente**: il boost estremo di banda satura e diventa un effetto, non solo volume; interagisce col drive (le due manopole lavorano insieme). Passo successivo (ingegneria): specifica per stadio — ordine armonico, durezza della saturazione, interazione col picco di risonanza — e simulazione con modelli OTA/diodi/JFET reali; le referenze diventano requisito per il prototipo M4L (decisione 78) e sbloccano il design del drive JFET 5-way e dell'overdrive filtro.
83. **[F — chiude questione 60]** Swing insufficiente del composito master (misurato +23,2 dBu contro requisito locked ≥+24 dBu, voci 7/42): adotta **opzione (a) — stadio finale a GUADAGNO** (emettitore comune dentro l'anello di retroazione globale): recupera ~6 dB con lo stesso op-amp e realizza l'intento del gain-staging sheet §1 («il +24 vero esiste solo all'XLR»); il rail HV ±24 V viene usato come progettato invece che sottoutilizzato dal follower. Il requisito ≥+24 dBu RESTA INVARIATO (opzione (d) scartata); scartate anche bootstrap (b) e op-amp d'ingresso su ±24 V (c). Prossimo passo ingegneristico: ridisegno del finale master-out in configurazione a guadagno + verifica LTspice (swing, THD, rumore d'anello, Z out <50 Ω, protezioni invariate) → master-out v0.3. **[REVISIONATA 2026-09-29 dalla decisione 86: la via discreta a guadagno è BOCCIATA dai dati di simulazione → bootstrap delle alimentazioni OPA1612.]**
86. **[F — revisione decisione 83, 2026-09-29]** Stadio d'uscita master: il VAS discreto a guadagno (CE dentro l'anello globale, via tecnica della decisione 83) è **BOCCIATO dai dati di simulazione** (`sim/master-out/compG-*.cir` + RISULTATI-composite §v0.3): (1) bistabilità all'accensione — il CE del VAS satura e inverte il segno dell'anello (latch misurato a +11,3 V fissi in uscita; mitigabile con CCS 12 mA + diodo Baker, ma conferma la fragilità); (2) muro di stabilità strutturale — con un op-amp già compensato (OPA1612, polo interno 25 Hz) ogni polo del VAS sotto il crossover porta il margine di fase a ~0: picchi closed-loop misurati +4,7…+14 dB a 56-148 kHz su 15 combinazioni di compensazione (Cc 22-330p × Rz 1-4,7k × Cf 22-330p), con residuo +3…+4,5 dB a 35 kHz = FUORI dalla banda ±0,5 dB. Servirebbe un booster piatto oltre ~188 MHz: impossibile con stadio discreto a guadagno. **VIA ADOTTATA = BOOTSTRAP delle alimentazioni OPA1612** (opzione (b) originaria della questione 60, rivalutata): rail locali che seguono l'uscita (pass serie NPN/PNP riferiti a OUT tramite stringa LED/zener, Δ ≈ 3-5 V; handoff senza gradini ai rail statici ±23,7 V al tetto); composito INVARIATO (diamond follower, A_vas = 1, feedback unity a −in come v0.2) → stabilità = v0.2 già verificata (picco +3,3 dB @50 MHz solo senza carico capacitivo, sparisce con cavo 10 nF). Swing atteso ±21…21,5 V = +25,7…+25,9 dBu (conversione dBu corretta il 2026-09-29; valore ATTESO superato: il Test 6 non modellava l'Iq reale — capability definitiva ±20,4-20,9 V nella verifica v0.3 sotto) → requisito ≥+24 dBu rispettato. Nessun chip nuovo: +6-8 discreti per gamba (due pass, due stringhe di riferimento, bias). **v0.3 VALIDATA 2026-09-29** (suite Test 7-12, `sim/master-out/compB-*.cir` + RISULTATI-composite §v0.3): rete finale = pass MJE340/350 + stringa 9×1N4148 (Δ ≈ 5,3 V; alternativa 3 LED rossi al prototipo) + bias JFET in modo CRD (Idss ≈ 4 mA) + Re 33 Ω; con Iq REALE 40 mA (il Test 6 era ottimistico: ±21,5 senza assorbimento) capability **±20,4-20,9 V = +25,4…+25,6 dBu PASS con 1,4-1,6 dB**; THD a +24 dBu PASS (0,00012-0,0042 %); sizing pass: 0,75 W idle / 1,0 W programma / 2,7 W picco → rame ≥4 cm²; corto auto-limitato 106 mA (target <60 mA [PROVVISORIO] revisionato dai dati: dissipazione = worst di programma, corto sostenuto sopravvive; nessun limitatore dedicato (protezione estrema = dominio PSU; rivalutare solo se il banco smentisce)); servo DC 30 µV; power-on ±15 V coperto dal mute [§3.7]; Cboot rail↔OUT bocciato in sim (glitch); resta a banco: modello TI, ripple/PSRR, termica su rame.
84. **[F — chiude questione 69]** Sensitivity dei ritorni FX: **NESSUN selettore d'ingresso e NESSUN limite interno di gain** — la regola K4 (livello_in × gain ≤ +23 dBu) è rispettata per disciplina operativa («sto attento io»): esemplare unico con operatore unico (Filippo). Range gain VCA invariato (−∞→0→+20 dB), pannello FX invariato. Comportamento in violazione di K4 = clip interno documentato come user error (coerente col caso VCA CDJ a +10 dB, cdj §7 item 4).
85. **[F — questione 24, parte 5-way]** Comandi gain delle 5 bande del 5-way = **5 pot rotativi** (il gain di banda è trattato come parametro, non come fader). Kill switch fisici, pot position e switch width restano come da design. Il principio «fader = slider» (decisione 47) resta valido per fader di canale e ritorni FX. Resto della questione 24 (3 comandi nuovi phono: selettore LINE/PHONO, switch C load 100/200/300 pF, eventuale switch subsonica profonda 13↔18-20 Hz) → TRASFERITO alla voce 40 (sessione hardware/pannello).
87. **[F — 2026-09-30, ratifica griglia drive §5.3]** Drive 5-way: la griglia musicale misurata (five-way §5.3, D4h `drive-chain8.cir` — THD θ×programma: pulito 0,07-0,70 % a θ0-50 programma nom, nastro 0,6-3,3 % a θ65-80, fuzz 10-36 % a θ≥90 o con programma hot a θ50+; law end-to-end 0/+7/+9,5/+12/+14/+16 dB) è **CONFERMATA**: i valori sono bloccati come punto di partenza. La review di tutti i valori «estetici» (taper/knee fini, ceiling fuzz come parametro musicale) sarà fatta **a orecchio sul prototipo Max for Live** (decisione 78, attualmente in pausa fino a design completo), non su numeri a tavolino. Chiude la conferma pendente della voce 10 (questioni aperte) — regola 2 soddisfatta. Restano: D5 risonanza (dopo q70), shaper fisico. (D6 rumore FATTO lo stesso giorno → decisione 88.)
88. **[F — 2026-09-30, chiude voce 71B — REVOCA PARZIALE decisione 80]** Rumore 5-way e architettura dei kill. FINDING (campagna 2026-09-30, `sim/five-way/RISULTATI-module-noise-v021.md` + benchmark `docs/05-benchmark-preamp-scena-2026-09-30.md`): (1) quirk LTspice `.meas INTEG` → tutti i totali √INTEG del repo ~21,5 dB ottimisti; (2) rumore THAT 218x da datasheet (−98 dBV a 0 dB gain, 20 Hz-20 kHz non pesati, Rout 20k; −104 dBV con I/V 10k — condizioni verificate sul PDF): i 6 VCA nel percorso mono 5-way davano −77,3 dBu (θ0) contro il target −90 A-wtd = FALLITO di 10-15 dB; (3) benchmark su 9 costruttori della scena dub: unico numero pubblicato = Ligwa EQ −80 dB non pesati (SN relativa ~84 dB, «super clean»), 0 su 9 usano VCA nel percorso (kill = switch/relè/DSP), −90 dBuA più severo di qualsiasi spec di categoria. DECISIONE: **(a) kill 5-way = HARD-CUT con switch analogici di precisione in serie al percorso di banda** (famiglia IC del selettore assign FX/LINE-PHONO; Ron ~33 Ω; pilotati dagli switch fisici di pannello esistenti — l'audio NON passa dai contatti di pannello: usura/crackle evitati, gesto invariato); **10 THAT 218x RIMOSSI dai gate** (conteggio mixer ~24-26 chip; lotto clone voce 37: 56-64 → ~40-48 pz). Conseguenza accettata con dati in mano: il kill perde il fade 1 ms e torna gesto chop col click (transiente misurato 3,64 V hard-cut vs 1,39 V con ramp — standard della scena: Jah Tubbys/JB cut-out, Mostec relè) → **decisione 80 REVOCATA per la parte gate-kill, RESTA VALIDA per reroute/assign FX e BBM modo filtro**. Residuo off-state dello switch (isolamento ~−60…−70 dB a 20 kHz via capacità) da quantificare nel redesign del gate [QUANTIFICATO 2026-09-30, five-way §8.10: π SPDT −95 dB @20 kHz, all-kill ≤−85,5 dB; serie semplice bocciata −22…−52]. **(b) Il drive MANTIENE il THAT 218x** (law dec. 82 invariata) con I/V secondo regola datasheet 10k (floor −104 dBV). **(c) Pacchetto fix ingegneristiche** (nessun impatto musicale): servo drive con op-amp classe OPA2134 (8 nV/√Hz invece di TL062 35), banca con op-amp reali (classe OPA1654 4,5 nV invece della macro uniforme 6 nV); nota CV: THAT raccomanda processare le CV a 61 mV/dB (10× la nostra 6,1) → budget rumore CV da verificare nel design di sistema (q. 20/21). **(d) NUOVO TARGET RUMORE 5-way (sheet §3): ≤ −80 dBu A-wtd**, punto di misura dichiarato: uscita modulo 5-way, ingressi terminati, gain nominali, drive θ0 (il rumore segue la law del drive: +3,6 dB a θ50 a fronte di +7 dB di segnale = SNR migliora). Misurato con catena switch+fix (`module-noise-v03.cir`, metodo corretto densità 10 punti): **−81,0 dBu unweighted = −83,2 A-wtd a θ0 → margine 3,2 dB** (θ50: −77,4/−79,6). Restano da ritarare sulla stessa campagna (voce 71A): canale CDJ (EQ β3 reale −89,2 dBu: target −92 superato dalla sola EQ), bus FX (−88, mai simulato), XLR master (−92, dominato da monte). I target ritarati vanno ratificati con gli stessi criteri: pesatura A dichiarata, punto di misura scritto, integrazione mai da √INTEG.
89. **[F — 2026-09-30, chiude voce 71A — RITARATURA sheet §3]** Rumore: target unificati dopo la campagna a metodo corretto (budget canale DJ completo −90,3 dBu A-wtd con EQ β3 82% + GAIN VCA 18%; FX send −98,9/−100,8 PASS 12,8 dB; rerun filtro: core nudo −90,3…−126 unwt ideale, die reale stimato −84…−76 a fc max; master stadio −119,2 VALIDO; 5-way −83,2 già dec. 88; finding metodo: Rvn 240k in module-noise-v03 sovrastimava il drive ~2,6 dB [CORREZIONE 2026-10-01: sul totale l'effetto è −0,77 dB — la quota drive con gli switch è ~22-32%, non l'87% del v021; rerun v031: −83,9 A-wtd θ0, margine 3,9 dB]). DECISIONE di Filippo: **(a) canale CDJ ≤ −80 dBu A-wtd** (out driver, ingressi terminati, gain nominali): misurato −90,3 = PASS 10,3 dB → NESSUNA fix circuitale (proposte EQ R×0,5 con pot 5k e I/V sul GAIN VCA RESPINTE: pot 10k restano, voce 40 invariata); **(b) filtro ≤ −80 dBu A-wtd** (send 0 dBu, out core/buffer): core nudo (a) in sim ideale −91,4 PASS; die reale −84…−76 = AL LIMITE nel worst case a fc max → il rumore entra come dato d'input nell'ascolto q70 (non è un veto: la scelta musicale resta sovrana); (c-B) VCA-nel-loop in target per costruzione; **(c) FX bus send ≤ −88 confermato** (misurato −100,8); **(d) sistema XLR master ≤ −78 dBu A-wtd** alle condizioni dichiarate in docs/06 §2 (4 canali terminati attivi + 5-way + 4 ritorni FX, drive θ0, fader unity); stadio master resta ≤ −92 (misurato −119,2). Criteri invariati (dec. 88): pesatura A dichiarata, punto di misura scritto, integrazione mai da √INTEG. Coda 71A (non blocca nulla): budget canale di RITORNO FX (mai simulato — il vero contributo FX al sistema; stima provvisoria classe −88…−92), rerun consolidato module-noise-v03 (Rvn corretto 133k per I/V 10k + invertitori gate §8.10 five-way), budget summer DJ bus/master al design di sistema. [CODA CHIUSA 2026-10-01: ritorno FX −94,5/−96,4 A-wtd (4× = −90,4, GAIN VCA 75%); summer DJ bus −107,5 / master summing+level VCA −96,3 = trascurabili (+0,02/+0,06 dB); v031 −82,3/−83,9 θ0 (θ50 −79,4), margine 3,9 dB; SISTEMA RICALCOLATO −80,5 dBu A-wtd = PASS 2,5 dB sul target ≤−78 qui ratificato.] Sintesi e tabelle: docs/06-ritaratura-rumore-71A.md §7.
90. **[F — 2026-10-01, sessione design di sistema — chiude parzialmente voci 18/19/20]** Tre scelte di Filippo per il sistema. **(a) METERING (voce 19)**: barre LED verticali **a zone** stile DJM (master stereo + zone DJ/FX/5-way); soglie: verde ≤ +6 dBu, ambra +6…+18, rosso +18…+24 (avvicina saturazione), **purple = latch clip ≥ +23 dBu** (saturazione reale del dominio ±18 V); ballistica dec. 81 invariata (attacco rapido, release ~0,3 s affinabile a banco 0,2-0,5, latch 442 ms); driver = famiglia logaritmica LM3915 già a BOM CDJ [PROVVISORIO — regola 3: topologia/valori nel design]. **(b) CUE (voce 18)**: knob **blend CUE↔Master + level**, 2 uscite cuffia in parallelo; switch cue per canale multipli (punto locked invariato: post-EQ, pre-filter, pre-fader); split cue NON incluso (eventuale revisit in sessione hardware, voce 40). **(c) PSU (voce 20)**: **toroidale unico multi-avvolgimento** (secondari dedicati audio / OTA / switch-logica) + regolazione locale per modulo (LM317/337 + cap-moltiplicatore sui ±18 V; LT3045/LT3094 sui ±15/16 V OTA, dec. 54); rail NUOVO ±15 V per switch kill/assign/LINE-PHONO (ADG1434-class max ±16,5, §8.10 five-way); fanless con dimensionamento termico; protezione abuso corto prolungato del master = dominio PSU (come da master-out v0.3: corto 106 mA auto-limitato, Q1 1,0 W worst); budget rumore CV a 61 mV/dB (nota dec. 88c) dentro il design PSU/CV. Resti delle voci 18/19/20 + voci 21/22 → design ingegneristico in docs/fase3/ (piano in 00-piano-sistema.md).
91. **[F — 2026-10-01, revisione controlli FX send/return]** Due decisioni di Filippo. **(a) MICRO-MODULO FX-SEND ×4**: EQ2 + level + switch di assign ESCONO dal canale CDJ e vivono in un micro-modulo separato, **uno identico per canale (4× stesso PCB)**; i 4 bottoni assign per canale RESTANO sul pannello canale e pilotano gli switch del micro-modulo via linee logiche +5 V (l'audio non passa dai contatti pannello — schema del kill, dec. 88). Catena e comportamenti LOCKED di SPECIFICA invariati: EQ2 bande ~120 Hz/~4,5 kHz con law dedicate, level −∞…0 (niente gain positivo), assign S1-S4 multipli e simultanei con BBM + ramp 1 ms (dec. 80), punto di presa post-EQ/pre-filter/pre-fader, iniezione bufferizzata sui bus; cdj §3.5 [E] diventa l'interfaccia verso il micro-modulo. **(b) SELF-FEEDBACK = quarto pot per bus**: la matrice di reroute passa da 12× a **16× THAT 218x** (3 pot cross + 1 pot self per bus: il bus rimanda a se stesso); law = stessa famiglia a tratti (§8.3 fx-module) + smoothing 1 ms (dec. 80); carattere al massimo = **BOUNDED-BY-DESIGN come i 3 pot esistenti** (il pedale satura l'anello, uscita mai ai rail; senza pedale inserito e pot al max può fischiare = disciplina operatore K4, dec. 84); stabilità da RIVERIFICARE in simulazione (`sim/fx/fx-loop-self.cir`). Conseguenze: conteggio 218x ~28-30 chip nel mixer (era ~24-26 post-dec. 88), lotto clone voce 37 → ~44-52 pz [PROVVISORIO — ricalcolo a design]; backplane: nuova classe di modulo FX-SEND (pinout in docs/fase3/sistema-backplane.md); design in docs/fase1/fx-send-module.md (nuovo) + fx-module.md v0.3-WIP.
92. **[F — 2026-10-01, chiude la nota dec. 88c]** Scala delle CV dei VCA: **resta 6,1 mV/dB** — law esistenti (dec. 82/87) e design drive/FX/reroute invariati — con **disciplina di routing CV** (twisted pair / stella dal pannello, CTRL_GND separato come da S2 grounding) e **test hum→wobble a banco**. Dati (sim `psu-cv-hum.cir`, S1): 1 mV di hum 50 Hz sulla linea CV = 0,32 dBpp di wobble a 6,1 mV/dB contro 0,032 a 61; il rumore intrinseco del generatore CV è irrilevante in entrambe le scale (µV → mdB): il tema è il solo pickup della linea da pannello. La migrazione a 61 mV/dB (×10 su shaper/buffer CV: law musicale identica a parità di corsa pot, +20 dB di immunità) resta **fallback documentato** se il banco mostra wobble udibile; ibrido (61 sulle corse lunghe, 6,1 locale) scartato (due scale = più trim e rischio errori di cablaggio).

## TASK 0 riconciliazione rail (2026-10-01)

93. **[F — 2026-10-01, TASK 0 riconciliazione-power-rails — REV SPECIFICA §3 bus potenza]** Set unico dei rail di potenza sul backplane: riconciliazione BLOCCANTE S1 PSU ↔ S3 backplane ↔ SPECIFICA §3 ↔ S2 grounding risolta **a favore dell'architettura dec. 90(c)** (secondari dedicati + regolazione locale), che Filippo aveva già ratificato: la riga [BLOCCATO] «±24 V, +5 V» della SPECIFICA (consolidamento 2026-09-18) è REVOCATA e sostituita da **«raw ±27 V audio, raw ±22 V LN/OTA, raw ±26 V [M] HV (solo master), +5 V control»** + AGND/CTRL_GND/CHASSIS invariati. Tabella: **W1 2×19 V / 1,2 A → ±27 V audio raw** (LM317/337 locali → 19,2 V → cap-moltiplicatore → ±18,0 V; margine dropout a rete −10%: 1,6 V); **W2 2×17 V / 0,6 A → ±22 V LN/OTA raw** (DUE STADI: LM317/337 → ±16,5 V → LT3045/LT3094 → **±15,0 V esatti** — dec. 54 INVARIATA; fatto datasheet: LT3045 Vin max **20 V** e Vout max 15 V, LT3094 −20 V/500 mA — l'ipotesi handoff «Vin max 15 V → pre-reg 78L15» era basata su premessa errata e il 78L15 è bocciato: 100 mA e 15,0 V d'uscita non lasciano headroom al LT3045; ±15 V switch/kill/assign = 78L15/79L15 diretti dal raw LN); **W3 RIDIMENSIONATO 2×20 V / 0,3 A → ±26 V [M] HV raw solo master** (il 2×17 V di S1 v0.1 era sottodimensionato: raw ~22,4 V < statici ±23,7 V richiesti dallo swing master-out v0.3 VERIFICATO; con 2×20 V l'inviluppo statici diventa **±23,6…29,2 V su rete ±10%** — il punto verificato ±23,7 diventa il WORST CASE a rete −10%: requisito ≥+24 dBu PASS con margine ≥1,2 dB in ogni condizione di rete — **VERIFICATO IN SIM sull'inviluppo (Test 13, `sim/master-out/compB-swing3-env.cir` + `compB-short-env.cir`, RISULTATI-composite)**: capability +20,57/−20,05 V = +25,2…+25,5 dBu a statici 23,6 V; a rete alta capability ≥+26,3 dBu (level plan worst +22 dBu dentro); corto sostenuto a 29,2 V: limite 106 mA INVARIATO, Q1 1,00→1,28 W medi sempre dentro rame ≥4 cm²); **+5 V control REGOLATO nel modulo PSU** (W4 8 V / 1,2 A → 7805/LM2940-class + bulk 10 mF — il «+10 raw sul backplane» in S1 §8 era un errore: viaggia solo il +5 V regolato; dissipazione ~5 W worst su piastra chassis [PROVVISORIO]). **Corrente +5 V riconciliata: worst ~1,0 A** (LED 103 segmenti 0,5 + LM3915 V+ 0,1 + relay mute 0,15 + logiche/moduli 0,25), dimensionamento 1,25 A = margine 25% (S1 v0.1 diceva 0,9 A = sottostimato; S3 diceva 1,25 A = tenuto come valore di dimensionamento). Correnti per raw: ±27 audio ~0,9 A tip / 1,1 A max (picchi transitori assorbiti dal bulk 2×10 mF); ±22 LN ~0,28/0,45 A (+switch <0,05); [M] 0,13/0,17 A; +5 0,55/1,0 A. Pinout riga a (mappa identica tutte le classi): ±27 2+2 pin · ±22 2+2 · ±26[M] 2+2 (popolato solo dal master) · AGND 8 · +5 2 · CTRL_GND 2 · CHASSIS 2 · SPARE 6. Supervisor: finestre per avvolgimento (soglie [PROVVISORIO] a banco; la finestra unica 16 V della sim S1 v0.1 era relativa al raw singolo). Trasformatore: ~88 VA totali / 120 VA = margine ~27%. Doc allineati: `sistema-psu.md` v0.2, `sistema-backplane.md` v0.2, `sistema-grounding.md` §6, sheet §1 REV, `master-out.md` [M] REV. Chiude il BLOCCANTE della review 2026-10-01 e la parte rail delle voci 20/22 (docs/02).

## Ratifiche fase 3 (2026-10-01, sessione post-TASK 0)

94. **[F — 2026-10-01, ratifiche fase 3 — CHIUDE questione 38]** Tre ratifiche di Filippo. **(a) Chiusura q38** (proposte S3 §9 confermate dai numeri): standard elettrico I/O tra moduli = **single-ended 0 dBu, bilanciato solo verso l'esterno** (XLR master/mic) — base su cui sono chiusi crosstalk DJ bus (−98 dB @1 kHz / −72 @20 kHz, `sim/cdj/`), isolamento slot backplane (< −100 dB stimato, S3 §4) e budget rumore sistema (−80,5 dBu A-wtd PASS, docs/06 §7); **MASTER SUM = 7 contributori stereo** (5-way, 4 ritorni FX, mic, generic) con summing invertente su massa virtuale **nel modulo master** (master-out §A2); il summing finale vive nel modulo MASTER (già [BLOCCATO] SPECIFICA §10 — chiusura formale). **(b) GLOBAL_MUTE muta ANCHE i buffer d'iniezione FX-SEND**: la linea c9 del backplane (comandata dal controller mute [L] del master: power-on/off con delay 1,5-2 s + guasto rail, master-out §3.7) ammutolisce i relay d'uscita dei moduli che ne hanno uno E i buffer d'iniezione dei 4 micro-moduli FX-SEND (dec. 91a). Motivazione: catena FX completamente silenziosa nelle transizioni — nessuna eccitazione della matrice 16× con self-feedback (dec. 91b; caso K4: pot self al massimo senza pedale = anello bounded ma "caldo" — il mute sui send elimina il fischio al rilascio). Nessuna perdita musicale: il global mute non è un comando performativo (scatta solo a power-on/off e su guasto). Comportamento del CUE durante il mute = materia del design S5. Il [PROVVISORIO] di fx-send-module §4 diventa deciso. **(c) Principio ergonomico backplane**: ogni classe di modulo ha **etichetta sul telaio + maniglia estrattore di colore proprio** (il coding meccanico per classe che rende impossibile l'inserimento errato resta ingegneria S3 §7); palette colori concreta e hardware = voce 40 (sessione hardware, Filippo).

## Deroga rumore FX-send (2026-10-02, sessione S5)

95. **[F — 2026-10-02, deroga condizione target rumore sistema — REVOCA PARZIALE della condizione di misura di dec. 89, non del target]** Misurato il send chain FX a canali vivi (`sim/fx/send-chain-noise.cir` + `RISULTATI-send-chain-71A.md`): −98,5 dBu A-wtd per canale al jack send con level al massimo (la stima −95 di fx-send-module §6 era conservativa); il floor indipendente dal level (buffer di iniezione + coppia di resistenze 10k della convenzione multidrop, 19,3 nV/√Hz per send) porta il SISTEMA a ~−73 dBu A-wtd appena UN assign è ON, e a −66,6 con 4 send a level 0 dB, contro il target ≤ −78 (dec. 89). Ratifica di Filippo: **DEROGA D'USO** — il target −78/−80,5 verificato (docs/06 §7) vale nella condizione «assign FX non attivi»; con FX in uso il floor di sistema è −73 dBu A-wtd (−66,6 worst a level max), accettato come carattere del caso d'uso: nel soundsystem è mascherato dal programma (≈ 27 dB SPL equivalenti contro 22 del target), in ambiente quieto è fruscio udibile solo a FX assegnato. Disciplina operatore (famiglia K4, dec. 84): level dei send quanto serve. Le leve di fix restano documentate ma NON attuate (bufferizzazione wiper pot HIGH + scala trio sottrattivo 49,9k → 4,99k: toglierebbe la parte level-dipendente, non il floor; convenzione di iniezione 10k intoccata). Doc allineati: docs/06 §7 addendum, fx-send-module §6, RISULTATI-send-chain-71A. **[REV 2026-11-03, todo 184 — numeri corretti]** I −73 / −66,6 non seguono dai dati del loro documento (servirebbero ~26 dB fra jack send e master). Rifatto con la scheda v0.2 (`sim/fx/RISULTATI-send-chain-v2.md`): con pedale a 0 dB il sistema resta a −81,8 dBu A-wtd con 4 send al massimo su ogni bus (−80,4 coi reroute a peso 1). La deroga resta scritta ma oggi non serve: il target vale anche con gli FX in uso.

## Standard qualità cuffie (2026-10-12)

96. **[F — 2026-10-12, sessione redesign ampli cuffia v0.2]** Standard di qualità del percorso CUE/cuffie: **classe sistema cuffie dei mixer Pioneer DJM** — strumento per mixare, nessun requisito di qualità audiofila. Conseguenze: (a) la THD a 20 kHz dell'ampli cuffia v0.2 (0,105 % su 16 Ω, 0,015 % su 32 Ω, armoniche fuori banda — `sim/system/RISULTATI-cue.md` Test 8) è ACCETTATA, nessuna rincorsa alla banda d'anello; (b) nelle scelte future del modulo cue (componenti, Zout 10 Ω al jack, tolleranze) vincono robustezza, stabilità e livello sufficiente sulla finezza di misura; (c) i target già verificati restano come sono (THD ≤0,1 % @1 Vrms 1 kHz, rumore ≤ −90 dBu A-wtd, clamp ~140 mA).

## Moduli MIC e MONO (2026-10-13)

97. **[F — 2026-10-13, correzioni e ratifiche di Filippo all'architettura MIC/MONO — CHIUDE le questioni 15 e 16 lato architettura]** (a) Il modulo MIC e il modulo MONO sono **due moduli separati** (niente scheda unica a due popolazioni). (b) Su ciascun modulo ci sono **solo**: GAIN, EQ 2 bande, **4 pot send** (uno per bus FX, «come in un normale live mixer»; nessun bottone di assign — prima formulazione della stessa giornata «4 bottoni», poi semplificata da Filippo in 4 pot), **un LED di metering a tre colori: verde = segnale ok, giallo = in prossimità del clip, rosso = clip**. Nessun altro comando. (c) Nell'architettura generale ci sono **al massimo 4 di questi moduli** (4 in totale tra MIC e MONO, in qualunque combinazione — confermato; **primo prototipo: 1 MIC + 3 MONO**). (d) **Passa-alto fisso a 60 Hz sul MIC: ratificato** (Sallen-Key 2° ordine: −3,1 dB a 60 Hz, −0,55 dB a 100 Hz). Conseguenze di ingegneria (`docs/fase4/mic-mono-moduli.md`): ogni pot send = attenuatore passivo −∞…0 dB post-EQ + buffer di iniezione sempre collegato al bus (rumore sul bus a pot chiuso −111,2 dBu A-wtd per modulo; con 4 moduli bus da −100,8 a ~−99,5, target −88 PASS); mute globale delle mandate via switch non di pannello (dec. 94b); MASTER SUM resta a 7 contributori (dec. 94a) con i MIC in multidrop su MSUM6 e i MONO su MSUM7; bus FX a 12 contributori (caso già verificato); rumore del mic sempre presente sul master al livello fissato dal GAIN (doc §6). Soglie elettriche del LED al nodo pre-EQ [PROVVISORIO, ingegneria, tarabili]: verde ≥ −6, giallo ≥ +11, rosso ≥ +17 dBu.

## Ricalcoli di ingegneria (2026-10-13)

98. **[C — 2026-10-13, ingegneria — REV dei numeri di dec. 93, architettura invariata]** Trasformatore ridimensionato. La v0.2 della PSU sottostimava il ramo audio (mancavano 4 FX-SEND, ampli cuffia, moduli MIC/MONO: 1,2 A reali contro 0,9) e trattava il trasformatore come ideale (nessuna resistenza d'avvolgimento, corrente nominale confrontata con la corrente DC). Simulato col trasformatore reale (`sim/system/psu-w1…w4-real.cir`): a rete −10 % tre avvolgimenti su quattro scendevano sotto il minimo dei regolatori e lavoravano al 132-163 % della corrente nominale. Nuovi secondari: **W1 2×21 V 2,5 A · W2 2×18 V 1,0 A · W3 2×20 V 0,4 A · W4 9 V 2,0 A = toroidale unico da 200 VA** (era 120 VA). Toroidale unico, regolazione locale e fanless restano (dec. 90c). Nomi dei rail di dec. 93 invariati; valori nominali reali: audio ~27 V, LN ~24 V, [M] ~27 V. Dettaglio e tabella: `docs/fase3/sistema-psu.md` REV 2026-10-13. Master-out RIVERIFICATO ai nuovi estremi 23,3 / 30,3 V (Test 17): capability +25,1 dBu a rete −10 % (PASS 1,1 dB), corto 106,5 mA, rame dei pass ≥ 5 cm².

## Drive 5-way e overdrive filtro: nuova direzione (2026-10-13)

99. **[F — 2026-10-13, risposta di Filippo alle voci A1/A2/A3 — CHIUDE la questione 72; REVISIONE delle decisioni 24, 82 (punti 1 e 2) e 87]** (a) **Drive 5-way = due saturatori distinti, due manopole**: **GROWL** (referenza: il growl dell'Abzu, cioè una valvola spinta forte; l'Abzu lo fa in digitale, l'omologo analogico è il GROWL di SP Audio — `docs/05`) e **NASTRO** (JFET tape drive). Si usano separati o insieme. **Il fuzz non esiste in questa versione.** (b) Uso musicale, parole di Filippo: il GROWL serve «per ottenere effetto growl» e lavora **solo su sub e bassi**; il NASTRO serve «a scaldare/impreziosire tracce più moderne e senza anima o ingrossare tracce un po' più scariche». (c) **I saturatori stanno dopo il gain e non alzano il volume: si autoregolano** (tolleranza: «mai, o poco»). Il boost pulito +7 dB a metà corsa della vecchia manopola DRIVE è eliminato: il volume lo fanno i gain di banda e il master. (d) **Curva delle due manopole**: effetto molto flebile nel primo 5-10 % di corsa, poi i saturatori lavorano quasi subito. (e) **La catena v0.3** (218x → JFET → diff pair fuzz, griglia corretta five-way §5.3bis) **è ARCHIVIATA come alternativa, non cancellata**: «in caso ci potremmo tornare». (f) **Overdrive del filtro = circuito e carattere DIVERSI dal drive 5-way** («se no diventa ridondante»): serve a rendere «più drammatici e violenti i transienti di filtro»; **meno aggressivo dello Sherman Filterbank**, per non assordare la gente o rompere l'impianto; settaggi molto estremi accessibili a fine corsa; **curva che accelera nel tratto finale**, così resta più corsa utile all'inizio. Il riuso della cella drive 5-way (filter-module §5bis v0.1) è quindi SUPERATO. Restano all'ingegneria, coi numeri da mostrare a Filippo (regola 2): quali bande sono «sub e bassi», percorso del NASTRO (assunto: tutto il segnale), ordine dei due saturatori, topologia del GROWL, metodo di autoregolazione del livello, law dell'overdrive filtro, rumore e conteggio chip. Pannello: il 5-way passa da 1 a 2 manopole di saturazione (voce 40). **Aggiunte dello stesso giorno, sui numeri dei ridisegni (five-way §5bis, filter-module §5ter): (g) il GROWL lavora sotto 350 Hz** (sub e tutta la zona della cassa; alternative scartate 90 e 200 Hz); **(h) tetto dell'overdrive filtro alzato «senza esagerare»**: +3 dB sul ramo saturato → uscita massima ~+5,5 dBu, picco di risonanza a fine corsa +4,6 dBu (era +1,6), programma +3 dB a fine corsa. **(i) Le tre griglie (NASTRO, GROWL, overdrive filtro) sono CONFERMATE come punto di partenza** («ok va bene»); rifinitura a orecchio sul prototipo M4L.

100. **[F — 2026-10-13, CHIUDE la voce A5 (rumore a filtri inseriti)]** Il target di sistema ≤ −78 dBu A-wtd vale a filtri OFF e, con l'overdrive v0.2, è rispettato anche a filtri inseriti con l'overdrive chiuso (−78,5 misurato). Con l'overdrive aperto il soffio del core sale (−77,8 a metà corsa, −74,8 a fine corsa, 4 filtri inseriti, in silenzio): **accettato come condizione d'uso** — «il caso in cui il drive è aperto al massimo e senza musica sarebbe pressoché impossibile». Stessa logica della decisione 95 per le mandate. Dati: `filter-module.md` §5ter, `docs/06` §9.

101. **[RIVISTA dalla dec. 159 (2026-10-31): il percorso unico per canale resta (HPF/OFF/LPF), ma gli 8 core diventano 4, sui bus HPF e LPF dopo il fader; il mux del CV sparisce.]** **[F — 2026-10-13, CHIUDE la questione 63 (voce A4)]** Filtro: **un solo percorso attivo per canale** (HPF oppure LPF, interruttore a tre posizioni HPF/OFF/LPF sul canale). I due filtri in serie sullo stesso canale sono scartati: sarebbero di fatto un passa-banda, già escluso dalla decisione 67, e raddoppierebbero core (16), chip di overdrive e rumore. Canali diversi restano liberi di stare in modi diversi nello stesso momento. Conferma la lettura assunta dal design: 8 core mono, 8 celle overdrive, mux del CV = uno switch SPDT per canale che sceglie il set della sezione attiva.

102. **[F — 2026-10-13, law delle manopole FREQ e RES del filtro — PRECISA le decisioni 70/74, punto di partenza da rivedere dopo il prototipo M4L]** «Comincia mantenendo la curva di freq e la curva di resonance come su Xone:96; al massimo aggiusteremo dopo il prototipo Max». Dati pubblici della Xone:96 (user guide Allen & Heath): FREQ 20 Hz (tutta antioraria) – 20 kHz (tutta oraria), filtro state variable; RES da MILD («very subtle effect») a WILD («feedback just short of self-oscillation»); nessuna curva numerica pubblicata; misura indipendente (wavealign.app): picco ~+7 dB a RES massima, un solo punto. **(a) FREQ**: la curva Xone (esponenziale, ottave uguali per grado) occupa il 90 % centrale della corsa: f(5 %) = 20 Hz, f(95 %) = 20 kHz, cioè f = 20 Hz · 1000^((θ − 0,05)/0,9); gli ultimi 5 % per lato portano agli estremi della decisione 74: 10 Hz a 0 %, 35 kHz a 100 % (velocità ×1,8 in basso e ×1,45 in alto, in ottave: è l'«accelerazione agli estremi» della decisione 70, ora senza ambiguità). Sostituisce i valori provvisori f(5 %) = 14 Hz / f(95 %) = 25 kHz. **(b) RES**: curva Xone sul primo 90 % della corsa (da effetto sottile a un passo dall'auto-oscillazione: smorzamento lineare con la rotazione, Q = 0,707/(1 − θ/0,9), già la law del design v0.2); **nell'ultimo 10 % il filtro entra in auto-oscillazione** come nel progetto attuale (+7,3…+8,6 dBu con soft limiter) — scelta esplicita di Filippo: «Xone + fischio in fondo». Limite dichiarato: la forma intermedia della curva RES della Xone non è pubblicata; la corrispondenza è per costruzione (stesso tipo di filtro), non per misura.

## EQ di canale = isolator (2026-10-13)

103. **[REVOCATA lo stesso giorno dalla DECISIONE 104 — resta come storico]** **[F — 2026-10-13 — REVOCA la decisione 77 (kill −30 dB, «il silenzio resta lavoro del fader»); SUPERA la topologia della decisione 76 (EQ in serie Baxandall) e il design EQ v0.3 beta-3; CHIUDE le questioni 59 (A7) e 68 (B4)]** «L'EQ a 4 vie voglio che si comporti come l'isolator EQ negli ultimi Pioneer: al minimo ci deve essere totale silenzio.» Requisito: ogni banda dell'EQ dei canali DJ va da silenzio (−∞) a 0 dB al centro a boost (+6 dB [ASSUNTO: valore già in SPECIFICA §4 e tipico degli isolator]); tutte e quattro al minimo = canale muto, senza auto-mute e senza contare sul fader. Conseguenza d'ingegneria: un EQ in serie non può dare silenzio (le stopband dei filtri in cascata sono finite: misurato −1 dB a 2,5 kHz e +1 dB a 5 kHz in all-kill); serve la struttura a bande in PARALLELO (split a crossover → guadagno per banda → somma), cioè la banca allineata in fase già validata per il kill del 5-way (five-way §3.1: somma piatta esatta, tutte le vie chiuse = silenzio). Il design EQ v0.3 beta-3 resta ARCHIVIATO come riferimento. Da fare (ingegneria): banca a 4 vie per canale, law dei pot −∞…0…+6, rumore e conteggio op-amp; frequenze di incrocio = punto di partenza dai centri attuali, review a orecchio (B5).

104. **[REVOCATA lo stesso giorno dalla DECISIONE 105 — resta come storico]** **[F — 2026-10-13 — REVOCA la decisione 103; RIPRISTINA le decisioni 76 e 77 e il design EQ v0.3 beta-3; CHIUDE la questione 59 (A7)]** Dopo il confronto su come lavorano gli EQ Pioneer classici (−26 dB per banda, non silenzio) e sul perché un EQ in serie non arriva a −∞: «manterrei l'EQ come era disegnato, senza diventare un isolator, ma aggiungerei un interruttore che spegne del tutto quando la manopola sarà totalmente a zero». (a) L'EQ dei canali DJ resta quello in serie v0.3 beta-3 (kill −30 dB per banda, dec. 77). (b) **Si aggiunge il muto a fine corsa** (opzione (b) della questione 59): contatti di fine corsa sulle manopole EQ + interruttore analogico sul canale. **Lettura d'ingegneria, da confermare da Filippo**: in un EQ in serie un contatto non può spegnere la sola banda della sua manopola (le bande sono filtri in fila, non rubinetti); il muto agisce sul CANALE e scatta quando TUTTE E QUATTRO le manopole sono a zero. Con una sola manopola a zero la sua banda resta a −30 dB. (c) Torna aperta la questione 68 (B4, kill della banda HIGH), ora meno pesante: riguarda solo il suono con 1-3 bande chiuse. Da fare (ingegneria): circuito del muto (commutazione senza click, famiglia ramp 1 ms dec. 80), pot con contatto di fine corsa (voce 40).

105. **[F — 2026-10-13 — REVOCA la decisione 104 (EQ in serie + muto a fine corsa); REVOCA la 77; SUPERA la topologia della 76 e il design EQ v0.3 beta-3 (ARCHIVIATO, non cancellato); riprende il requisito della 103]** «Ok, rifai il 4 band EQ in modo che sia un isolator.» Percorso della scelta: Filippo ha chiesto se ogni banda potesse spegnersi da sola con un interruttore a fine corsa, poi se il taglio potesse scendere a −60 dB invece di −30; la risposta d'ingegneria (in un EQ in serie il limite è la pendenza, non la profondità) ha portato alla scelta dell'isolator. Requisito: ogni banda dell'EQ dei canali DJ va dal silenzio a 0 dB al centro a +6 dB [ASSUNTO da SPECIFICA §4]; quattro bande chiuse = canale muto. Ingegneria [C], simulata lo stesso giorno (`docs/fase1/eq-isolator-v0.4.md`, `sim/eq-iso/`): banca LR4 allineata in fase a 3 incroci (matematica della kill bank del 5-way), pot lineare + buffer per banda, somma a guadagno 2. Misurato: centro piatto entro 0,01 dB; LOW −37 dB a 50 Hz, HIGH −39 dB a 8 kHz; rumore −97,1 dBu A-wtd (l'EQ in serie: −89,2). **Rinviato all'ascolto da Filippo il 2026-10-13 (valori di partenza: 150/500/2500 Hz, +6 dB, law lineare)**: (a) incroci (150/500/2500 o 100/630/4000 Hz: le bande medie chiuse da sole fanno −16…−26 dB secondo la larghezza); (b) boost +6 dB; (c) law lineare. Conseguenze: il muto di canale della 104 cade (todo 36/37); la voce 68 cade; 12 quad op-amp per canale invece di 6 (+24 sul mixer; PSU da riverificare; costo stimato +300…400 €); voce 53 riformulata (pot doppi lineari).

106. **[C — 2026-10-13 — REVISIONA la decisione 98 per il solo avvolgimento audio]** Trasformatore da ~225 VA: avvolgimento audio W1 = 2×21 V **3,0 A** (era 2,5 A); gli altri secondari restano quelli della dec. 98. Motivo: l'EQ isolator (dec. 105) aggiunge 24 quad op-amp e porta il ramo audio da 1,2 a ~1,4 A; W1 a 2,5 A lavorava al 105-107 %, a 3,0 A lavora al 90-92 % con raw minimo 23,8 V a rete −10 % (requisito ≥ 21,7 V). Simulazione: `sim/system/psu-w1-iso.cir`. Ratificata da Filippo («42 ok»). Taglia commerciale (225 o 250 VA) da scegliere all'acquisto.

107. **[F — 2026-10-14 — CHIUDE la questione 53 (A6)]** Tracking stereo dell'EQ dei canali (≤ 0,25 dB tra L e R): **pot doppi lineari selezionati**, con trim al centro dove serve. Niente VCA per banda (avrebbe aggiunto ~32 chip, corrente e rumore). Dato d'ingresso: con l'isolator un errore del 2 % al centro del pot vale 0,17 dB (eq-isolator §5). Il criterio di selezione dei pot va nella sessione hardware (voce 40).

108. **[F — 2026-10-14 — CHIUDE la questione 25 (A9); SUPERA il «pad selezionabile» dell'interfaccia pedali (SPECIFICA §7, fx-module §4)]** Livello verso i pedali = **solo la manopola LEVEL del micro-modulo FX-SEND** (−∞…0 dB); il pad interno prima del pedale è **fisso a 0 dB**, niente ponticello per pedale. La compensazione sta al ritorno: GAIN −∞…0…+20 dB. Parole di Filippo: «possiamo dare poco a pedali con poca headroom ma "pomparli" poi nel canale di ritorno, oppure dare tanto a pedali con tanta headroom e smorzarli nel canale di ritorno». Costo accettato: ogni dB tolto in mandata e rimesso al ritorno alza dello stesso dB il fruscio del pedale; un pedale delicato vuole LEVEL quasi chiusa (con bus a +16 dBu e LEVEL aperta, al jack arrivano +16 dBu). Ingegneria conseguente: la law del pot LEVEL deve dare risoluzione nel tratto −30…−10 dB; la regola di stabilità del loop (fx-module §4, g_loop) si riformula su LEVEL + GAIN ritorno, da riverificare al banco col pedale vero. **RICONFERMATA da Filippo il 2026-10-14 («tieni la 108 così com'è») dopo la correzione di Claude sui due costi reali, entrambi ACCETTATI:** (1) il soffio di fondo della mandata (~−98,5 dBu A-wtd al jack, indipendente da LEVEL) non è più attenuato dal pad: con LEVEL a −20 e GAIN ritorno a +20 arriva al master a ~−78,5 dBu A-wtd per FX così usato (sistema ~−77 con un FX aperto) [STIMA da valori misurati]; (2) il giro di feedback bus → pedale → GAIN → reroute non contiene LEVEL: vale GAIN + reroute (dB), quindi con GAIN +20 l'auto-oscillazione parte a reroute −20 dB, ~45 % di corsa invece che a fine corsa. Alternative scartate: pad interno per pedale; presa del reroute prima del GAIN.

## Filtro: core OTA col partitore (2026-10-14)

109. **[C — 2026-10-14, D5 (todo 10) — SUPERA il core (a) nudo della v0.2 e il soft limiter sul nodo BP (filter-module §3, §5); B1 resta aperta]** Filippo ha scelto il core (a) «per ora» (B1). La simulazione col chip reale ha mostrato che il core (a) nudo non funziona ai livelli di progetto: il picco di risonanza resta sotto ~−12 dBu, un programma a 0 dBu perde 23 dB sul taglio, l'auto-oscillazione suona ~3,5 ottave sotto FREQ (`sim/filtro/RISULTATI-D5.md` §1). Scelta di Filippo tra tre varianti mostrate coi numeri: **core (a′) = OTA con partitore 1/30 davanti agli ingressi** (Rd 100 Ω / Ra 2,9k; C 33 nF/30 = 1,1 nF, mappa Iabc → fc e shaper invariati), come nei filtri OTA reali. Il limitatore dell'oscillazione diventa una **perdita non lineare dal buffer BP al summer** (4,7k + 2+2 1N4148): l'ampiezza non dipende più dal taglio. Costi accettati, mostrati prima della scelta: rumore del core −87,4 dBu A-wtd a fc max, sistema con 4 filtri inseriti e overdrive chiuso −79,0 (PASS 1,0 dB); oscillazione a RES 100 % a +4,9 dBu, 1,1 dB sotto il requisito +6…+10 (SPECIFICA §5), con la nota che cala di ~6 semitoni tra 90 % e 100 % di RES; su un programma a 0 dBu il fischio sale al massimo ~+1 dB sopra la musica (sul −10 dBu +8,5 dB, sul −30 dBu pieno). Alternative scartate: 1/20 (più silenzioso, risonanza e oscillazione più deboli, −8 semitoni) e 1/40 (sistema −77,7: FAIL 0,3 dB). B1 resta aperta: (a′) contro (c-B), (a′) è il valore di lavoro. Restano da riconfermare (voce A17): griglia dell'overdrive e law RES, scritte su picchi ideali.

110. **[F — 2026-10-14, risposta di Filippo alla voce A17 — CHIUDE A17; REVISIONA la decisione 99 (i) per l'overdrive del filtro, la 102 (b) per la forza della risonanza e il requisito di oscillazione della SPECIFICA §5]** I quattro numeri del filtro col chip reale (core (a′), dec. 109; `sim/filtro/RISULTATI-D5.md` §2-§4) sono **accettati come punto di partenza**, tutti nella forma raccomandata da Claude. (a) **Risonanza**: il picco si ferma a +7…+9 dB sopra un programma a −10 dBu e a ~+1-2 dB sopra un programma a 0 dBu; sul −30 dBu è quello ideale. È il comportamento del core (a′) e coincide con l'unica misura pubblica della Xone:96 (~+7 dB a RES massima, dec. 102). La law RES della dec. 102 resta (Q = 0,707/(1 − θ/0,9)); cambia solo l'attesa sul picco. (b) **Overdrive del filtro**: la griglia di riferimento diventa quella di `d5-chain.cir` (filter-module §5quater) e sostituisce quella di `od2-chain.cir` confermata nella dec. 99 (i): il fischio arriva all'overdrive a −1,5…+2 dBu, fischio e programma si sporcano quasi insieme, 11-22 % a fine corsa, il primo raschio lo fa già il core (1,3-2 %). Tetto +5,5 dBu invariato (misurato +5,4). Rifinitura a orecchio sul prototipo (B6). (c) **Livello dell'auto-oscillazione**: requisito abbassato da +6…+10 a **~+5 dBu** (misurato +4,9 a RES 100 %, ~5 dB sopra il nominale). Motivo: già ben sopra la musica, e coerente con «non assordare la gente né rompere l'impianto» (dec. 99 f). Alternativa scartata: tre diodi per lato (~+7 dBu, nota che cala di più). (d) **Nota dell'oscillazione**: il calo di ~6 semitoni tra 90 % e 100 % di RES è **accettato come carattere** (il fischio «affonda» a fine corsa, uguale a ogni FREQ). Alternativa scartata: compensazione RES → FREQ. Conseguenza per il prototipo Max: il core del filtro deve riprodurre il tetto (picco che dipende dal livello d'ingresso) e il calo di nota, altrimenti l'ascolto di B1/B6 giudica un filtro ideale.

## Review contro il benchmark (2026-10-14)

111. **[RIVISTA in (b) dalla dec. 161 (2026-10-31): il crossfader esce dal progetto; prima la dec. 160 lo voleva solo in CV.]** **[F — 2026-10-14, review del progetto contro il benchmark esteso (`docs/07`, 41 modelli), 13 domande una alla volta (`docs/08-review-benchmark-2026-10-14.md`) — PRECISA le decisioni 1, 97 e la SPECIFICA §1, §3, §8, §9]** (a) **Identità**: il mixer è un ibrido voluto, in parti uguali, tra mixer DJ con funzioni dub, preamp da sound system e banco da dub live; compromessi accettati. (b) **Nessun fork**: un solo progetto, **tutto predisposto** per aggiungere senza grosse modifiche i moduli opzionali discussi: **uscite per via** (crossover proprio dopo la somma del master, incroci a scatti o a schede; il 5-way non basta perché ritorni FX, mic e mono entrano dopo), **crossfader** (loop post-fader dei 4 canali verso il modulo e ritorno prima del DJ bus), **EQ grafico** (punti d'inserzione sul master e/o dopo il 5-way), **sirena** (slot MONO già esistente). Le «versioni» sono configurazioni dello stesso mixer. (c) **Uscita**: resta full-range stereo verso un DSP esterno («mi assicura che venga usato al top da quasi tutti gli impianti»). (d) **Aggiunte**: **tasto MONO sul master** (somma L+R); **tasto MUTE sul modulo MIC** (non sul MONO); niente basso mono, niente limiter sul mic. (e) **Ambiente**: requisiti da **sound system all'aperto**: fino a 40 °C ambiente, tropicalizzazione delle schede, pot sigillati, connettori robusti, telaio rigido, flight case, pannello protetto da polvere e liquidi. (f) **Protezione dei sub**: per ora delegata al DSP esterno, scritta come requisito d'impianto; il filtro auto-oscilla fino a ~15-30 Hz con RES ≥ 90 % e FREQ nel primo ~10-15 % (gesto dell'«affondo»). Alternative restate aperte: RES che cala sotto ~40 Hz, passa-alto fisso ~20 Hz sul master, range LPF accorciato. (g) **Confermati com'è**: rumore (S/N ~83 dB A contro ~89-90 dei mixer da club; target dec. 89 invariato: sul sound system all'aperto il soffio resta sotto il rumore d'ambiente); uscita pulita senza trasformatore (il colore lo dà il NASTRO, messo lì apposta; colora solo il DJ bus); 4 canali DJ; sirena ed eco esterni.

112. **[F — 2026-10-14 — REVISIONA la decisione 90(c) per la sola parte «fanless»]** Dopo il bilancio termico rifatto (~114 W dentro il telaio, ~131 W coi moduli opzionali; con 40 °C ambiente l'interno arriverebbe a 55-70 °C, `docs/fase3/sistema-psu.md` REV dec. 111), Filippo sceglie **due ventole a termostato**: spente sotto ~35 °C interni, velocità che sale col caldo; il mixer resta progettato per lavorare a ventole ferme fino a ~30 °C ambiente, quindi una ventola guasta non lo ferma. Alternative mostrate e scartate: restare senza ventola (camino), ventole sempre accese, termostato + LED d'allarme sul pannello. Restano di Claude [PROVVISORIO]: ventole da 120 mm lente con filtro antipolvere sulle prese (all'aperto: manutenzione), alimentazione e ritorno separati dall'audio, controllo lineare della tensione (niente PWM vicino all'audio), posizione delle prese (mai sul pannello superiore, dec. 111 e).

113. **[F — 2026-10-14 — PRECISA la decisione 90(c) e la 93 sulla collocazione della PSU; ispirazione dal benchmark: Isonoe, Condesa, banchi Soundcraft/A&H con alimentatore esterno]** «Voglio alimentazione esterna.» Il toroidale, i raddrizzatori, i condensatori grandi, un **primo stadio di regolazione** dei rail e il +5 V stanno in un **box esterno**, collegato al mixer con un cavo multipolare e un connettore circolare robusto. Restano nel mixer la **regolazione finale locale per modulo** (principio della dec. 93 intatto), le ventole a termostato (dec. 112) e il punto unico di massa. Motivi: calore (fuori ~30-45 W, dentro da ~131 a ~95-100 W, e la rete alta non scalda più il mixer), ronzio del trasformatore lontano da phono e mic, peso. Niente switching (dec. 90c intatta). Dettagli d'ingegneria in `docs/fase3/sistema-psu.md` REV dec. 113 [PROVVISORIO].

## Ascolto del prototipo Max P0 (2026-10-14)

114. **[F — 2026-10-14, ascolto di MC-CHANNEL in Live (P0, `proto-max/RISULTATI-P0.md`) — CHIUDE in parte B7/A15; PRECISA la decisione 105 punti (b) e (c)]** (a) **Boost dell'isolator +6 dB: confermato.** (b) **GAIN di canale: law confermata** (−∞ … 0 … +10 dB, metà CCW lineare in dB da −100 a 0, metà CW da 0 a +10, `sim/cdj/vca-law.cir`). (c) **Curva delle manopole dell'isolator: da sistemare**, ma solo con pot commercialmente disponibili: niente taper custom. Le alternative si costruiscono con pot di serie (ed eventuali resistenze) e si provano nel prototipo. (d) **Incroci: né A (150/500/2500 Hz) né B (100/630/4000 Hz) vanno bene.** Restano aperti (B7).

## Sessione 2026-10-21

115. **[F — 2026-10-21 — PRECISA le decisioni 111 e 112 (W1 3,5 A); nasce dalla correzione del conteggio dei VCA, todo 114]** **Avvolgimento audio W1 = 2×21 V 4,0 A** (era 3,5 A), trasformatore **~270 VA** (era ~250). Motivo: il modulo FX ha 40 VCA, non 20 (`docs/fase3/sistema-vca-trim.md` §4); con tutti i moduli opzionali il ramo audio sale a ~1,81 A e il W1 da 3,5 A lavorava al 98-100 % (`sim/system/psu-w1-vca.cir`). Con 4,0 A: 88 %, raw minimo 23,9 V a rete −10 %. Scelta di Filippo fra «tenere 3,5 A» e «4,0 A», su raccomandazione di Claude (un avvolgimento al limite scalda e invecchia). Fusibile del W1 da T4 A a T5 A. Dettagli: `docs/fase3/sistema-psu.md` REV 2026-10-21.

116. **[F — 2026-10-21, guardando i render dei pannelli (`docs/pannelli/`) — PRECISA la decisione 90(a) e il metering S4]** **Ogni ritorno FX ha la sua barra di meter da 10 LED, come i canali CDJ** (era un solo meter per i 4 ritorni). Tap invariato: post-GAIN/EQ2, pre-fader, mono centrato (il più alto fra L e R), stessa scala e stessi colori delle zone. Conseguenze: barre 8 → 11, segmenti ~103 → ~133, LM3915 10 → 13, detector 8 → 11 canali; +5 V nel caso peggiore (5 mA/segmento) 1,0 → ~1,15 A contro 1,25 A di dimensionamento (con LED da 2 mA ~0,3 A). Dettagli: `docs/fase3/sistema-metering.md` REV dec. 116.

117. **[F — 2026-10-21, guardando i render dei pannelli — SUPERA lo switch WIDTH a 3 posizioni (SPECIFICA §EQ creativo, decisione 85 «switch width come da design»)]** **WIDTH dell'EQ creativo del 5-way diventa una manopola continua, libera come GAIN e POSITION, da Q3 (stretta) a Q0,3 (larga)** (era uno switch Q3/Q1/Q0,5). Escursione scelta da Filippo fra Q0,5…3 (raccomandata), Q0,5…6 e Q0,3…3. Ingegneria [C]: pot doppio 1k come partitore su bp_b, buffer ×10 e invertitore OPA1612; il pot GAIN si alimenta dallo stesso segnale, così il boost non dipende da WIDTH senza secondo deck. Simulato: Q 3…0,3 entro lo 0,1 %, boost uguale su tutta la corsa (±0,005 dB), notch −46,6…−47,7 dB, rumore a detent invariato (`sim/five-way/RISULTATI-width-continuo.md`). Si perde lo scatto ripetibile. Taper [PROVVISORIO] alla sessione hardware (voce 40). Dettagli: `docs/fase2/five-way-module.md` §4.3.

118. **[F — 2026-10-21, sessione hardware delle manopole (voce 40, todo 12), blocco 1 — taglia dei rotativi]** (a) **Manopole rotative principali = classe 14 mm (Alps RK14K o equivalente)**, la famiglia dell'EQ dei Pioneer DJM-300/500/600: tocco da mixer da club, doppia 10k lineare con scatto al centro a catalogo. Scartate la 9 mm (tocco leggero da controller) e la 24-27 mm (doppia 10k con detent non a catalogo). Raccomandazione di Claude accettata. (b) **Disposizione disassata, come sul Xone:DB4** (parole di Filippo: «li voglio posizionati disassati come sul xone db4»): le manopole di una colonna non stanno tutte in fila, una sì e una no si spostano di lato. Vale per il disegno dei pannelli (`docs/pannelli/`, render da rifare). (c) **EQ di FX-SEND, ritorni FX, MIC e MONO: pot più piccoli (classe 9 mm, Alps RK09 o equivalente) e SENZA scatto al centro** (Filippo, stessa sessione). Restano aperti per i blocchi successivi: curve speciali (taper custom o resistenze aggiunte), contatto di fondo corsa dell'EQ di canale, tenuta alla polvere contro la dec. 111 (e), fader, selettori, bottoni, jack, connettori, cappucci. Inventario: `docs/fase3/sistema-comandi.md` §Scelte hardware.

## Sessione 2026-10-22

119. **[F — 2026-10-22, sessione manopole (voce 40, todo 12), blocco 2 — PRECISA la dec. 111 (e) «pot sigillati»]** **Pot a corpo chiuso (classe Alps RK14K / RK09, resistenti a polvere e flussante, senza grado IP), e la protezione la fa il pannello**: guarnizione sotto ogni manopola, coperchio del flight case per il trasporto, pot sostituibili senza rifare la scheda (montaggio da definire nel PCB). Motivo: un pot doppio 10k con scatto al centro e grado IP65 o più non esiste a catalogo (il più vicino, Bourns PTM902, è IP40; Vishay P16 IP67 solo singolo); un pezzo su misura costa ordine minimo e mesi. Scartata l'alternativa «pot sigillati su misura». Raccomandazione di Claude accettata.

120. **[F — 2026-10-22, sessione manopole (voce 40, todo 12), blocco 4 — fader]** **Fader dei canali e dei ritorni FX = corsa 100 mm** (8 fader), la corsa lunga delle console da studio: massimo controllo fine nel gesto lento. Scartate 45 mm e 60 mm (raccomandazione di Claude: 60 mm, come i canali del Xone:92). Conseguenza: le file coi fader crescono di ~40 mm in altezza contro il 60 mm; render dei pannelli da rifare. Resta di ingegneria il tracking stereo ≤ 0,5 dB (dec. 59): i fader doppi a catalogo sbagliano fino a 3 dB fra le piste; strade da confrontare: fader selezionati, oppure fader che comanda un VCA (come il Xone:92).

121. **[F — 2026-10-22, sessione manopole (voce 40, todo 12), blocco 5 — kill del 5-way]** **I 5 kill del 5-way sono levette a tre posizioni ON-OFF-(ON)**: in su la via resta spenta (kill fisso), al centro suona, in giù è spenta finché si tiene il dito e torna da sola a molla (kill a tempo). Levette sigillate per uso esterno (dec. 111 e, 119). Scartati il bottone a ritenuta con luce (stile Xone) e il bottone a due modi (tocco breve / pressione lunga). Raccomandazione di Claude accettata. Elettrica invariata (switch π SPDT, dec. 88, five-way §8.10): la logica del kill riceve l'OR dei due contatti della levetta.

122. **[F — 2026-10-22, sessione manopole (voce 40, todo 12), blocco 5 — selettore del filtro di canale]** **Il modo del filtro di ogni canale (HPF / OFF / LPF) si sceglie con una levetta a tre posizioni fisse**: su = HPF, centro = OFF, giù = LPF; resta dove la si lascia. Stessa famiglia delle levette dei kill (dec. 121), sigillata. Scartati la manopola a scatti e i tre bottoni con luce. Raccomandazione di Claude accettata. Elettrica invariata: rampa di 1 ms al cambio di modo (dec. 80).

123. **[F — 2026-10-22, sessione manopole (voce 40, todo 12), blocco 5 — bottoni di canale]** **CUE e assign FX 1-4 = bottoni con luce, a ritenuta** (cinque stati da vedere insieme, anche al buio); **LINE/PHONO = levetta piccola** (si imposta una volta per serata, non si sposta per sbaglio). Proposta di Claude accettata; scartate le levette per CUE/assign e il bottone con luce per LINE/PHONO.

124. **[F — 2026-10-22, sessione manopole (voce 40, todo 12), blocco 7 — cappucci] [PROVVISORIO]** **Cappucci gommati** (presa sicura con mani sudate o umide, all'aperto; indice stampato o in rilievo; si cambiano quando si consumano). Filippo: «presumibilmente li stamperò in 3D, ma per ora 1». Conseguenza di ingegneria: tutti i rotativi con lo stesso albero (6 mm a D, come RK14K e RK09L) e altezze d'albero in poche misure, così un solo disegno di cappuccio stampato si adatta a tutti; un materiale flessibile stampabile (classe TPU) dà la presa della gomma. Scartati alluminio pieno e plastica dura. Raccomandazione di Claude accettata.

125. **[F — 2026-10-22, sessione manopole (voce 40, todo 12) — taglia e scatto di ogni manopola]** Tabella confermata da Filippo in un messaggio solo («confermo»), compresi i consigli di Claude sulle righe in dubbio. **Taglie**: grande = pot 14 mm (dec. 118); piccola = pot 9 mm; **media = stesso pot 14 mm con cappuccio più piccolo (~12 mm)**, così l'albero resta uno (dec. 124). **Grandi, senza scatto**: LEVEL FX-SEND, GAIN dei ritorni FX, filtro FREQ/RES/DRIVE, GROWL e NASTRO, BOOTH, GAIN e SEND 1-4 di MIC e MONO. **Grandi con scatto**: GAIN canale (0 dB), EQ canale (centro), GAIN delle 5 vie (centro: tenuto su consiglio di Claude, a centro la cella è piatta), MASTER (0 dB), BLEND del CUE (centro). **Medie, senza scatto**: POSITION e WIDTH del 5-way. **Piccole**: reroute e SELF del modulo FX **con scatto al centro** (da verificare a catalogo il pot singolo 9 mm con scatto); senza scatto gli EQ di FX-SEND, ritorni, MIC e MONO e il LEVEL delle cuffie. Il GAIN di MIC/MONO non ha scatto (nessun punto 0 dB fisso). Totale 115 manopole (la 117 ha aggiunto i 5 WIDTH): 64 grandi, 10 medie, 41 piccole. Tabella: `docs/fase3/sistema-comandi.md` §Taglia e scatto.

126. **[F — 2026-10-22, sessione manopole (voce 40, todo 12) — PRECISA la dec. 59 sul fader «conduttivo-plastica stereo linked ≤ 0,5 dB»]** **I fader dei canali e dei ritorni FX sono fader singoli (mono) che comandano un VCA per lato, come sul Xone:92.** Il tracking L/R ≤ 0,5 dB della dec. 59 resta e lo danno i VCA trimmati (`sistema-vca-trim.md`), non il fader; il fader da 100 mm (dec. 120) può essere un modello qualunque e la sua curva si fa nello shaper. Motivo: nessun fader doppio a catalogo sta sotto 0,5 dB (Penny & Giles PGF8000 ±1,0 dB, PGF3000 e Alps RS60 ±3 dB). Costo: +16 VCA (4 canali + 4 ritorni, stereo; ~78 chip nel mixer), +20…45 mA per ramo sul W1 (oggi all'88 %), rumore a fader aperto da ricalcolare (docs/06). Scartati fader doppi selezionati a coppie e ±1 dB coi PGF8000. Raccomandazione di Claude accettata. Da fare (ingegneria): cella fader-VCA nel canale (cdj-line-channel §3.8) e nei ritorni (fx-module), shaper della curva del fader, bilancio PSU, budget di rumore, conteggio VCA in sistema-vca-trim §4.

127. **[F — 2026-10-22, sessione manopole (voce 40, todo 12) — PRECISA la dec. 105 (isolator: «tutte a fondo corsa = canale muto»)]** **Niente contatto di fondo corsa sui 16 pot dell'EQ di canale**: pot doppi lineari normali con residuo garantito dal costruttore ≤ 20 Ω su 10k (Alps RK14J; da verificare per la RK14K). Una banda chiusa scende a circa −54 dB invece di −100 (eq-isolator §5, §8); con la musica che suona il kill resta un kill; con tutte e quattro chiuse resta un filo udibile solo nel silenzio, e il muto vero del canale è il fader (VCA, −100 dB, dec. 126). Motivo: un pot doppio con scatto al centro e contatto a fondo corsa non esiste a catalogo (pezzo su misura). Scartato il pot su misura col contatto. Raccomandazione di Claude accettata.

128. **[F — 2026-10-22, sessione manopole (voce 40, todo 12) — connettori]** **Le due uscite cuffia del CUE sono entrambe jack stereo 6,3 mm** (standard delle cuffie DJ e da studio; la spina 3,5 mm usa un adattatore). Scartata la coppia 6,3 + 3,5 mm (la 3,5 regge meno l'uso dal vivo). Raccomandazione di Claude accettata. Restano come proposta di ingegneria, senza scelta sonora: connettori a corpo metallico con guarnizione verso il pannello, XLR con blocco (dec. 111 e, 119).

129. **[F — 2026-10-22, sessione manopole (voce 40) — curve dei pot] [PROVVISORIO: da sentire nel prototipo prima di ordinare resistenze e pot]** Scelte di Filippo sulle opzioni di `docs/fase3/sistema-comandi.md` §Ingegneria dei comandi (tutte uguali ai consigli di Claude, salvo G): **A3** EQ di FX-SEND, ritorni, MIC e MONO = pot lineare + resistenze di legge, curve diverse per bassi (pieni per quasi tutta la corsa, spariscono alla fine) e alti (calano subito, poi gradualmente), **0 dB a metà corsa** (correzione dello stesso giorno, Filippo: «eq secondari 1»; il «due terzi» dell'opzione presentata era un dettaglio inventato da Claude, la law dei documenti FX ha 0 dB a metà); **B2** GAIN delle 5 vie = lineare + resistenze: boost uniforme fino a +15 dB, taglio sul 90 % della mezza corsa, buco completo negli ultimi gradi (eq-serie §10); **C2** WIDTH = log ~20 % (centro corsa ~Q1); **D1** LEVEL di FX-SEND e cuffie = log A 10 % (−20 dB a metà); **E2** GAIN di MIC/MONO = dB spalmati su tutta la corsa: col circuito del mic serve la curva **inversa C 20 %**, non la A descritta nell'opzione (correzione di Claude nello stesso giorno: la A ammassa ancora di più i dB in alto, 31 dB a metà corsa; la C dà 29,5 / 36,3 / 46,4 / 50,9 / 59,3 dB a 0/25/50/75/100 %, `proto-max/coefficienti/mic.py`); per il MONO (circuito diverso) curva da verificare; **F1** SEND di MIC/MONO = log A; NASTRO resta log A 10 % (five-way §5bis, Filippo); **G** fader di canali e ritorni = «come un mixer DJ Pioneer», la curva che **sale gradualmente** delle tre del DJM-900NXS2 (Filippo, stessa sessione: «2»); stima −12 dB a metà corsa, quella già simulata (`sim/shaper/shaper-fader.cir`, `sim/cdj/RISULTATI-fader-vca.md`). I valori delle resistenze di legge si calcolano cella per cella dopo l'ascolto (regola 3).

130. **[F — 2026-10-22, dopo il budget (`docs/09-budget.md`)] Il modulo FX si divide in 4 moduli FX-RET, uno per bus.** Ogni FX-RET porta il summing del proprio bus, il driver e i jack del pedale, il ritorno (buffer, GAIN, EQ2, meter, fader) e i 4 VCA di reroute stereo (3 cross + SELF) verso i net S1-S4. Pannello: 4 strisce da 36 mm al posto del pannello unico da 144 mm, stessi comandi. I 4 moduli sono identici e intercambiabili: il numero del bus lo dà la posizione sul backplane. Chiude l'assunzione «FX = modulo unico, da ratificare in fase di layout» (SPECIFICA §3, backplane §10) e torna ai 4 moduli FX RETURN dei documenti d'origine. Ingegneria [C, PROVVISORIO]: `docs/fase1/fx-module.md` §2bis, `docs/fase3/sistema-backplane.md` REV dec. 130. Costo: +8 sezioni op-amp per modulo (iniezione dei reroute sui net), +3 connettori C96, budget quasi invariato (4 × 120-239 € contro 453-906 €).

131. **[F — 2026-10-26, todo 143] Alimentazione con riserva.** Filippo: «voglio riserva sull'alimentazione». Chiude A19 (W1 4,0 A al 97-100 % con tutti gli opzionali). Ingegneria [C, PROVVISORIO, `sim/system/RISULTATI-psu-box.md` §7]: riconta dal basso del ramo audio con le correnti dei datasheet (OPA1612 3,6 mA per canale, la tabella di progetto ne contava 2) → 2,12 A base, 2,44 A con tutti gli opzionali, 2,70 A di progetto per ramo; LN 0,60 A. Criterio di riserva: avvolgimenti ≤ 80 % al carico di progetto anche a rete +10 %. Risultato: **W1 2×21 V 7,0 A** (76-79 %), **W2 2×18 V 1,5 A** (77-80 %), **toroidale ~420 VA** (era ~270, dec. 115), Rsense del W1 0,15 Ω, bulk del W1 22 mF per ramo (mute 12,4 ms prima che i locali escano), fusibili primario T3,15 A / W1 T8 A / W2 T2 A, aletta del box Rθ ≤ 0,43 K/W, calore nel mixer ~118 / 132 W (ventole: +4 K). Supera i numeri del trasformatore delle dec. 98, 106 e 115.

132. **[F — 2026-10-27, scheda dell'impianto Horns & Bricks (`docs/10-impianto-horns-and-bricks.md`)] Il mixer sostituisce mixer DJ, mixer live e preamp; l'impianto resta a 5 vie.** (a) Maelcum prende il posto del mixer DJ, del Soundcraft EPM6 e del preamp Ligwa 1U: la catena diventa sorgenti → maelcum → dbx DriveRack VENU360 → finali. (b) Oggi l'impianto ha 4 vie (SUB, KICK, MID, HIGH); la quinta (supertweeter piezo Monacor MPT-177 su Crown XLi800, incrocio sopra ~8-12 kHz) arriva a breve, prima del mixer. Le decisioni 21 e 22 (5 bande = 5 vie, un kill per via) restano valide.

133. **[F — 2026-10-27, avvio delle PCB] Manopole saldate sulla scheda.** I pot (e i comandi di pannello in genere) stanno sul PCB del loro modulo; il modulo è appeso al pannello e i pot a montaggio orizzontale escono dal pannello (la meccanica di `sistema-backplane.md` §7.2). Niente harness pannello → scheda per i pot. Supera il «front connector» dei design doc (FX-SEND §4: pot via harness); le linee dei bottoni assign dal pannello canale al FX-SEND restano su cavo (logica +5 V, nessun audio). Conseguenza: la bozza `pcb/fx-send/` v0.1 va rifatta coi pot a bordo; misure e posizione dei comandi seguono i render di `docs/pannelli/` [PROVVISORIO fino al #123].

134. **[C — 2026-10-27, chiude A8 (voce 23)] Montaggio misto: fabbrica per l'SMD, a mano per i grandi.** Le schede arrivano dalla fabbrica (classe JLCPCB PCBA) con i componenti a montaggio superficiale già saldati; a mano restano pot, connettori (C96, jack, XLR), elettrolitici e TO-220/TO-126. I pot si saldano per ultimi, allineati al pannello (dec. 133). Motivo: manodopera stimata ~600-1.000 € in fabbrica contro ~2.000-4.500 € di un tecnico a mano (60-120 h), e chip a passo 0,65 mm su 4 strati poco adatti alla saldatura manuale. Conseguenze per le PCB: impronte SMD standard (0805/1206, SOIC, TSSOP) lato componenti; parti speciali (OPA1612, V2181L, ADG1434, LT3045) da verificare nel magazzino della fabbrica o da fornire a parte [PROVVISORIO fino al preventivo].

135. **[F — 2026-10-27, chiude il todo 123] Posizione dei comandi = render dei pannelli di oggi.** Le PCB prendono la posizione di ogni comando dai render di `docs/pannelli/` così come sono (larghezze, altezze, colonne disassate ±5,5 mm della dec. 118). Il generatore `genera_pannelli.py` scrive `docs/pannelli/coordinate.json`, che le schede leggono; un cambio di pannello si fa lì e le schede si rigenerano. Misure del telaio e ventilazione restano alla q29 [PROVVISORIO fino al prototipo].

136. **[F — 2026-10-27, precisa la dec. 133] Pot su scheda comandi, cavo ammesso, tipo di pot libero.** Filippo: «puoi mettere i pot coi cavi e puoi cambiare il tipo di pot se ti serve». La forma scelta (ingegneria [C]): i pot ad albero verticale stanno su una scheda comandi parallela al pannello, esattamente nelle posizioni della dec. 135 (zig-zag compreso); un cavo piatto corto la collega alla scheda principale col C96. Supera il «montaggio orizzontale» della dec. 133, che non permette lo zig-zag ±5,5 mm. Il tipo di pot si sceglie per scheda (es. FX-SEND: Alps RK09L doppio 10k per LOW, HIGH e LEVEL). Prima applicazione: `pcb/fx-send/` v0.2.

137. **[F — 2026-10-27, chiude A20 (todo 156); precisa le dec. 65, 68, 74 e 102] Infrasub: la banda resta, il gesto no; HPF del filtro da 20 Hz.** Filippo: «forse 10 Hz era esagerato». Dato: il VENU360 taglia le casse a 37 Hz, quindi sotto ~37 Hz l'impianto non suona niente. Benchmark dei limiti bassi in `docs/07` §5: 5-15 Hz nei migliori analogici, 20 Hz nella maggior parte dei mixer DJ. Scelte di Filippo: (1) **la banda del circuito resta** com'è nella dec. 65 (−3 dB a ≤8 Hz, 10 Hz entro ±1 dB, servo DC, nessun accoppiamento AC sopra 5 Hz): costa poco e tiene il basso in fase sopra i 37 Hz; (2) **l'infrasub non è più un gesto musicale** del progetto. KILL SUB (interruttore che spegne tutta la banda SUB) e meter restano invariati: non hanno corsa da recuperare; (3) **HPF del filtro: fondo a 20 Hz, come il Xone:96 vero.** Legge della sezione HPF: f = 20 Hz · 1000^(θ/0,95) da 0 a 95 % di corsa (20 Hz → 20 kHz), ultimi 5 % fino a 35 kHz invariati; 37 Hz cade a ~8,5 % di corsa (prima ~13 %). La sezione LPF resta 10 Hz–35 kHz (dec. 74/102). Fatti lo stesso giorno: shaper CV della sezione HPF senza ramo basso (`sim/shaper/shaper-filtro-freq-hpf.cir`, sistema-shaper §3) e legge nel prototipo MC-FILTRO (rigenerato, `prova_filtro.py` PASS) [PROVVISORIO fino all'ascolto, come la dec. 102]. Anti-rumble sul phono: dec. 138.

138. **[F — 2026-10-27, segue la dec. 137; precisa la dec. 79] Subsonica del phono a 18 Hz, fissa, senza comando.** Filippo sceglie un anti-rumble fisso come il Rane MP2015 (18 Hz), invece di un interruttore sul pannello. Ingegneria [C]: la Sallen-Key HP 2 poli già presente nel phono passa da 13 a 18 Hz (Rs1 61,9k, Rs2 124k, C 100n). Effetto: rumble e warp a 10 Hz −4,9 dB in più (margine di warp ~1,8×), −0,18 dB a 37 Hz, +12° di fase a 40 Hz solo sul phono; requisito «−1 dB max a 30-40 Hz» rispettato (`sim/cdj/RISULTATI-phono-sub18.md`). Supera l'opzione pannello «subsonica profonda» (phono-stage §3). Le linee restano larghe (dec. 65/137).

139. **[F — 2026-10-28, todo 181; precisa la dec. 52 e master-out §3.2] MASTER: lo scatto sta al centro e lì è 0 dB.** Dato di Claude: i pot a catalogo (classe Alps RK14K) hanno lo scatto solo al centro; uno scatto al 75-80 % della corsa, come chiedeva master-out §3.2, è un pezzo su misura. Filippo sceglie l'opzione 1 fra tre (scatto al centro / 0 dB al 75-80 % senza scatto / scatto su misura). Conseguenza: dal fondo al centro il MASTER sale dal silenzio a 0 dB; dal centro a fine corsa aggiunge fino a +6 dB, con un gesto lento e preciso, come il GAIN dei canali. Curva [PROVVISORIO, dec. 129]: sotto il centro 40 log10(2θ) (−12 dB al 25 %), sopra lineare in dB. Ingegneria [C]: shaper a 4 rami col pot rovescio e un ramo d'offset per il +6 dB (`sim/shaper/shaper-master.cir`, `master_fit.py`): sopra il centro ±0,03 dB, allo scatto 0,0…−0,17 dB da 20 a 50 °C, pot chiuso −101…−126 dB. Il BOOTH (−∞ → 0 dB, senza scatto) usa la curva del fader (`shaper-fader.cir`). Dettagli: `docs/fase3/sistema-shaper.md` §3.

140. **[F — 2026-10-28, todo 167; precisa la dec. 133; RIVISTA dalla dec. 142: 3 schede affiancate, non due sovrapposte] Il modulo MASTER è fatto di due schede sovrapposte.** Dato di Claude: lo stadio d'uscita a +24 dBu (bootstrap, dec. 86) va ripetuto 4 volte (caldo e freddo di L e R), ~40 componenti ciascuno; il master arriva a ~350-400 componenti, ~3,5 volte il FX-SEND. Filippo sceglie l'opzione 1 fra tre (due schede sovrapposte / una scheda sola più profonda / due posti nel telaio). Scheda di SEGNALE col C96: somma, MONO, VCA di MASTER e BOOTH con i loro shaper, buffer, detector dei meter. Scheda di USCITA sopra, unita da un connettore: 4 stadi d'uscita del master, driver del booth, relè, mute controller, alimentazione [M]. Pannello e posto nel telaio invariati. Più la scheda comandi dietro il pannello (pot, MONO, LED), come il FX-SEND. Cambiare scelta costa poco fino all'ordine delle schede: le schede si rigenerano dai file Python.

141. **[F — 2026-10-28, todo 167] XLR e jack REC sul pannello posteriore del mixer, su una schedina a parte.** Filippo sceglie l'opzione 1 fra due (schedina sul retro collegata con un cavo / connettori sul bordo della scheda d'uscita). Sulla schedina stanno i 4 XLR (master L/R, booth L/R), il TRS del REC e le protezioni al connettore di master-out §3.3 (R serie, ferrite, condensatore verso il telaio, TVS, pin 1 al telaio). La posizione sul retro resta libera.

142. [RIVISTA dalla dec. 158 per l'altezza: schede a trapezio 185 → 120 mm, non più 220 fisse] **[F — 2026-10-28, todo 199; rivede la dec. 140, precisa la q29] Schede alte 220 mm, componenti sui due lati, numero di schede per modulo libero.** Filippo toglie il vincolo delle schede di misura fissa (il 100 × 165 del FX-SEND era una misura di lavoro di Claude, mai decisa). Restano gli slot e il backplane sul fondo (dec. 94, backplane §7.2): l'altezza delle schede è comune a tutti i moduli ed è l'altezza interna del telaio, ora **220 mm** (mixer alto ~25 cm); la profondità di una scheda segue il suo pannello. Sotto un pannello stanno quante schede affiancate servono. I componenti SMD si montano sui due lati dove serve (montaggio in fabbrica, dec. 134; costo in più accettato). Filippo sceglie «220, due lati» fra tre (165 un lato: master in 6 schede; 165 due lati: 4; 220 due lati: 3). Conseguenza per il master (~600 componenti): **3 schede affiancate** sotto il pannello (segnale col C96 + 2 di uscita) più la scheda comandi e la schedina connettori (dec. 141); supera le «due schede sovrapposte» della dec. 140. FX-SEND: una scheda sola, sale a 220 mm per arrivare al backplane. [PROVVISORIO fino al prototipo, q29]

143. **[F — 2026-10-29, segue la dec. 142] Le schede d'uscita del master si innestano nel backplane: il master occupa 3 slot.** Dato di Claude: sulla scheda di segnale (100 × 220, due lati) Freerouting lasciava aperte, in tre giri, le alimentazioni che dovevano attraversarla dal C96 ai cavi verso le altre schede (RAW±26, +5V, CTRL_GND; `pcb/master/NOTE.md`). Filippo sceglie di dare un C96 anche alle 2 schede d'uscita. Ingegneria [C]: le schede d'uscita prendono dal backplane RAW±26 [M] (a9-a12), +5V, CTRL_GND, GLOBAL_MUTE (c9, pilotata dal mute controller) e AC_OK (c17); nessun audio sul loro C96. La scheda di segnale tiene la riga a standard e la riga b; verso le uscite manda solo audio e CLIP su un cavo piatto (J2). Le alimentazioni forti non passano più vicino alle masse virtuali. Backplane: 2 slot in più, classe MASTER-OUT con codifica propria. Pannello invariato. [PROVVISORIO fino al prototipo]

144. **[F — 2026-10-29, principio; chiude il lato «vincoli» della q29] La forma del telaio non limita la funzione: il requisito primario è il funzionamento.** Filippo: «libera i requisiti del telaio: la forma non deve limitare la funzione». Ordine di progetto: prima il circuito che funziona (rumore, masse, calore, alimentazioni e piste corte), poi le schede che gli servono (misura, numero, lati, connettori), infine il telaio disegnato attorno alle schede. Misure, slot e numero di schede (dec. 140, 142, 143) sono conseguenze, [PROVVISORIO]: si cambiano quando la funzione lo chiede. Restano requisiti, perché sono funzione: il pannello e la posizione dei comandi di Filippo (dec. 135), l'uso all'aperto e il flight case (dec. 111 e), il calore (dec. 112), la manutenzione a moduli estraibili senza hot-swap (backplane §7).

145. **[F — 2026-10-31, todo 30; chiude il punto «limiter» di B9; eccezione alla dec. 9] Il modulo MIC ha un limiter fisso, senza comandi.** Filippo sceglie il limiter (era «da valutare dopo l'ascolto» nella review `docs/08`, risposta 6) e la forma 1 di quattro: soglia tarata dentro, sempre attivo, niente manopola né tasto. Vale solo per il MIC: il MONO e il resto del mixer restano senza dinamica (dec. 9). Ingegneria [C]: il limiter usa il VCA del MUTE (dec. 111), più un rilevatore di picco in retroazione; nessun chip di guadagno in più. Fra tre varianti simulate Filippo sceglie la 2 (rilascio 1 s): soglia +12 dBu all'uscita del modulo, un grido a +20 dBu esce a +12,8 dBu, attacco tenuto da ~2 ms, dopo il grido −4,4 dB a 50 ms e 0 dB a 300 ms, THD 0,78 % a 100 Hz solo mentre limita (`sim/mic/RISULTATI-mic-limiter.md`). Soglia e tempi [PROVVISORIO]: si sentono in MC-MIC.

## Ascolto del libretto (2026-10-31)

Filippo ha suonato il libretto `proto-max/tutorial-live.html` dopo la Prova 0 passata senza salti. Risposte per numero di prova.

146. **[F — 2026-10-31, libretto 7.3 — CHIUDE la curva di B7; precisa la dec. 114(c)]** **Curva delle manopole dell'isolator: PIONEER** (taglio (2 theta)^1,5, boost uguale; `proto-max/coefficienti/canale.py`). Resta la regola della dec. 114(c): solo pot a catalogo, la curva si realizza con un pot di serie. Incroci: aperti (7.2, «da rivedere: vorrei un MID-HIGH più ampio verso il basso, non di molto»).

147. **[F — 2026-10-31, libretto 7.4 — conferma la dec. 105]** **EQ di canale: ISOLATOR.** L'EQ in serie (SERIE, poi XONE, poi DJM) resta solo come opzione d'ascolto nel prototipo (B5).

148. **[F — 2026-10-31, libretto 8.1 e 8.2 — CHIUDE B1 e B2; conferma la dec. 109, supera la scelta d'ascolto PULITO del 2026-10-21]** (a) **Core del filtro: OTA (a′) col partitore 1/30.** Il core PULITO (c-B) resta progettato e archiviato (`sim/filtro/RISULTATI-cb-4p.md`). (b) **Pendenza a 4 poli: Butterworth.** Restano da rivedere la risonanza (8.3: «troppa») e la law del DRIVE (8.4, sotto).

149. **[F — 2026-10-31, libretto 8.4 — PRECISA la dec. 99 (overdrive del filtro) e B6]** **Il DRIVE del filtro entra molto prima di metà corsa.** Ingegneria [C, PROVVISORIO]: quantità m = theta (era theta^2,5): a 25 % di corsa 0,25 (era 0,03), a 50 % 0,5 (era 0,18). Pot lineare.

150. **[F — 2026-10-31, libretto 9.1, 9.2, 9.3, 9.4 — CHIUDE B3 per la scelta della variante; PRECISA la dec. 99 (GROWL) e B6]** (a) **Crossover del 5-way: variante E**, gli incroci dell'impianto (80 / 170 / 1,2k / 6k Hz). Resta il riallineamento ai dati del VENU360 (dec. 132, B3). (b) **GROWL: versione LIBERO** (kl 0,6043): la dec. 99 va rivista su questa base (todo 61). (c) **NASTRO (versione EXCITER) più udibile nella prima metà della corsa**: [C, PROVVISORIO] taper log 20 % al posto del taper A 10 % (a metà corsa 0,17 invece di 0,085 del fondo corsa 0,85). (d) **Click dei kill a levetta: va bene così.**

151. **[F — 2026-10-31, libretto 7.1 e 10.5]** Primo controllo del canale (bypass identico, tutte le bande a 0 = silenzio): passato. **Law del MASTER e tasto MONO: vanno bene** (B8, parte master). Le prove 10.1-10.4 (feedback e law degli effetti) aspettano i bus rifatti con l'instradamento di Live (todo 209).

152. **[F — 2026-10-31, libretto 7.2, dopo la prova di A 400 e A 450 — CHIUDE gli incroci di B7; precisa le dec. 105 e 114]** **Incroci dell'EQ isolator di canale: variante C, 150 Hz dolce (LR2) / 350 Hz / 3150 Hz** (era la partenza A 150 / 500 / 2500). Con la curva PIONEER (dec. 146) l'isolator di canale è definito per l'ascolto; MC-CHANNEL-S usa C. Il design hardware (`docs/fase1/eq-isolator-v0.4.md`) va riallineato a questi incroci.

153. **[F — 2026-10-31, libretto 8.3, dopo due prove — PRECISA la dec. 102(b) e la dec. 110; chiude la risonanza di B6]** **Law della RES del filtro: Q che cresce in modo uniforme fino a 8 volte la base al 90 % di corsa, poi autoscillazione da ~93 % con fine corsa gres −0,25** (era 1 − theta/0,9 e −0,75). Il fischio col core OTA scende da ~+4,7 a ~+0,5 dBu e cala ~2 semitoni invece di ~5,5 (`proto-max/RISULTATI-P1.md` §RES nuova). Ingegneria da fare: la curva esponenziale col pot logaritmico e il fondo corsa nel design del filtro (`docs/fase2/filter-module.md`).

154. **[F — 2026-10-31, dopo l'ascolto di XONE, DJM -26 e DJM SPINTO -40 — CHIUDE B5; conferma la dec. 105]** **L'EQ in serie è scartato in tutte le forme provate** (SERIE v1 e v2, XONE, DJM -26, DJM SPINTO -40). Filippo: «djm 26 e 40 già scartati, vado con isolator». I modelli restano in archivio (`proto-max/coefficienti/serie.py`, `xone.py`, `djm.py`; dec. regola 10); il selettore EQ TIPO resta nel prototipo ma non ha più domande aperte.

155. **[F — 2026-10-31, libretto, seconda risposta — conferma le dec. 149 e 150(b)]** (a) **DRIVE del filtro con m = theta (pot lineare): confermato** («drive filtro ok»). (b) **GROWL: versione LIBERO confermata** («growl libero ok»): diventa il GROWL di progetto e sostituisce la law della dec. 99; il design doc del 5-way va riallineato (todo 61). (c) NASTRO: ancora in dubbio («non sono sicuro sia ancora abbastanza»): terza prova con pot lineare (a metà corsa 0,425 del fondo corsa; prima 0,17, all'inizio 0,085) [PROVVISORIO].

## Telaio e schede (2026-10-31)

156. **[F — 2026-10-31, todo 203, domanda BURN del 29/10] Tetto di riempimento: 70 % per scheda.** Filippo sceglie 70 fra 70 / 75 / 85 / nessuno (BURN proponeva 75). Dato: il FX-SEND passa al 75 %, la scheda di segnale del master non passa al 100 % (282 impronte, 84 collegamenti di massa aperti dopo due correzioni a vuoto). Riferimento di densità: 200 componenti su 100 × 220 mm coi due lati. Una scheda che supera il tetto si divide, non si stringe.

157. **[F — 2026-10-31, todo 203; precisa la q29 e la dec. 144] Telaio da rack: largo al massimo 19", alto in unità rack intere, profondità contenuta.** Filippo: «il mixer può essere largo massimo 19 inch per fittare nei rack, altezza libera basta che siano multipli di unità rack, mentre la profondità non può essere esagerata, perché deve avere senso anche sdraiato come mixer DJ». Il pannello completo è già 482,6 mm (19") × 572,5 mm: va portato a **13U = 577,85 mm**. Dato del benchmark (`docs/07`, misure cercate online il 31/10): altezza sul tavolo da ~70 mm (E&S DJR400) a 135 mm (A&H Xone:464 in rack), media ~104 mm.

158. **[F — 2026-10-31, todo 203; RIVEDE la dec. 142 per l'altezza delle schede] Sul tavolo il mixer è inclinato come il Xone:464, un po' più alto: ~150 mm davanti e ~215 mm dietro (~6°).** Filippo sceglie «inclinato e un po' più alto» fra piatto 135 mm, inclinato come il 464 (135 → 197) e questa. Ingegneria [C, PROVVISORIO]: 30 mm di riserva fra pannello, scheda comandi e fondo col backplane; le schede sotto il pannello diventano **trapezi alti ~185 mm in fondo al pannello e ~120 mm verso chi suona**. Più spazio ai moduli in fondo (5-way, master, CUE). Piano delle schede: `pcb/PIANO-schede.md`.

## Filtro dopo il fader (2026-10-31)

159. **[F — 2026-10-31, idea di Filippo (le due domande citate sotto), verificata da Claude sul manuale dello Xone:92 e confermata da Filippo («riscrivila e aggiusta diagrammi e pcb»); origine corretta il 2026-11-10, todo 262: prima era segnata [C]; RIVEDE le dec. 67 e 101 per i core, la catena del canale (cdj-line-channel §1: filtro e meter) e la dec. 100 per il rumore a filtri inseriti] Il filtro lavora dopo il fader, sulla somma dei canali assegnati, come lo Xone:92.** Origine: domanda di Filippo («se il filtro fosse post fader si semplificherebbe enormemente vero?», «è già così avendo solo 1 controllo di resonance e frequenza per filtro»). Verifica: diagramma a blocchi del manuale Xone:92 Mk2, p. 26: VCA del fader → FILTER SELECT 1/OFF/2 → bus FILTER 1 MIX e FILTER 2 MIX → un VCF stereo per bus. (a) **Catena del canale**: … → EQ → split (CUE, FX SEND: invariati, pre-fader e pre-filtro) → METER → FADER → interruttore HPF / OFF / LPF, che manda il segnale dopo il fader sul DJ bus, sul **bus HPF** o sul **bus LPF** (net multidrop con R 10k lato sorgente, come il DJ bus). Commutazione morbida sul canale (ADG + rampa 1-5 ms, PROVVISORIO). (b) **Modulo filtro: 4 core mono** (sezione HPF L/R, sezione LPF L/R) invece di 8; ogni sezione ha FREQ, RES e DRIVE suoi (pannello e 6 knob invariati). Le uscite delle due sezioni entrano nel DJ bus. Spariscono il send/return per canale e il mux del CV. (c) **Sezione senza canali = muta** (dai bit FILT_MODE, già sulla riga c del backplane): niente fischio della RES quando nessun canale è assegnato. (d) **Cosa cambia all'orecchio, accettato**: il DRIVE satura la somma dei canali della sezione (i dischi si sporcano a vicenda) e segue il fader (fader basso = meno saturazione); un solo fischio per sezione invece di uno per canale. Il risultato lineare (FREQ, RES) è lo stesso di prima. (e) **[BLOCCATO dalla dec. 161(b)]** il meter DJ legge prima del fader e non vede più il filtro (come sullo Xone:92, meter pre-fader). (f) Numeri: filtro da ~800 a ~450 componenti (stima), 24 → 12 LM13700, 8 → 4 VCA dell'overdrive (VCA del mixer ~78 → ~74), 3 schede al 57 % nelle proposte B e C (`pcb/PIANO-schede.md`). Da rifare: rumore a filtri inseriti (docs/06 §11, era −79,0 con 4 core in serie al segnale; ora 2 core al massimo) e livelli del bus (somma di più canali verso il core con partitore 1/30). Il prototipo MC-FILTRO filtra per canale: uguale sul lineare, diverso sul DRIVE (da sentire).

160. **[SUPERATO dalla dec. 161 (2026-10-31): niente crossfader, nemmeno opzionale] ** **[C — 2026-10-31, proposta di Claude accettata da Filippo («crossfader si»), dal controllo «altri errori simili» chiesto dopo la dec. 159; RIVEDE la dec. 111(b) per il crossfader] Crossfader opzionale solo in tensione di controllo, sul VCA del fader del canale.** Il crossfader è uno, con una curva sola, e fra il fader e il crossfader nessuno legge il segnale del canale: le due attenuazioni si sommano in dB nella CV dei 2 VCA del fader (VCA esponenziale: dB + dB). (a) Sul canale: levetta X / OFF / Y (PROVVISORIO, sul pannello del canale) che sceglie quale CV del crossfader si somma alla CV del fader (1 sezione op-amp, shaper del fader invariato). (b) Il modulo crossfader (UTIL-XF) porta solo il crossfader, la curva e due CV, XF_X e XF_Y, sulla riga c (c10-c11, i CV generici della convenzione 0-5 V); niente audio. (c) Spariscono l'anello audio post-fader (XF_SEND/XF_RET, slot 6-7 del canale; ponticelli JXF), driver e buffer dell'anello nei 4 canali, 8 VCA e 24 trimmer del modulo. All'orecchio nulla cambia. Con la dec. 159 il canale assegnato al filtro passa prima dal crossfader, poi dal filtro (come il Xone:92: fader e crossfader prima del bus del filtro, lineare). Da fare: law del crossfader in CV (curva e taglio, voce del modulo opzionale) e verifica del fondo scala del VCA con le due CV sommate (−∞ = floor −100 dB).

161. **[F — 2026-10-31, «meter ok togli il crossfader interamente»; RIVEDE la dec. 111(b) e SUPERA la dec. 160; CHIUDE A21 e conferma la dec. 159(e)] (a) Niente crossfader, nemmeno come modulo opzionale.** Spariscono il modulo UTIL-XF, la levetta X/OFF/Y del canale e le CV XF_X/XF_Y: c10-c11 tornano CV generici, gli slot 6-7 del canale restano di riserva. Il fader del canale comanda i suoi 2 VCA e basta. **(b) Meter DJ del canale: pre-fader, dopo l'EQ, senza filtro** (come lo Xone:92): da PROVVISORIO a BLOCCATO.

162. **[C — 2026-11-02, proposta di Claude (A22) accettata da Filippo («1», dopo la simulazione); CHIUDE A22; RIVEDE cdj-line-channel §3.2 (GAIN a VCA, 27/09) e fx-module §5 (GAIN del ritorno a VCA)] GAIN dei 4 canali e dei 4 ritorni FX con pot doppio lineare selezionato nel percorso del segnale, niente VCA.** (a) **Gesto**: metà destra come prima (0 → +10 dB canale, 0 → +20 dB ritorno); metà sinistra = **trim**, non più quasi-fader: canale −2/−3 dB a ore 11, −6/−10 dB a ore 9, silenzio solo negli ultimi 5-10 % della corsa (prima −20 dB a ore 11). Detent a 0 dB al centro. (b) **Tracking accettato**: ≤ 0,5 dB solo con pot selezionati stretti (0,5 % fra le piste) e da circa −10 dB in su; sul ritorno verso +20 dB fino a ~0,8 dB. Errore del detent fra moduli dalla tolleranza della pista: ≤ 0,6 dB canale, ≤ 0,3 dB ritorno (pot a tolleranza stretta o resistenza scelta a banco). (c) **Circuito** [PROVVISORIO fino al banco]: canale = T1, partitore caricato (pot 10k, Rl 4,30k) + non invertente ×3,15; ritorno = T2, pot in retroazione (Ra 1,24k) + invertente ×0,625 dopo il buffer a guadagno 2. Zero continua sulla pista (fruscio della manopola: lo stesso compromesso dell'EQ, dec. 107). (d) **Effetti**: −16 VCA (~74 → ~58 chip), −~48 trimmer, −8 shaper di CV; rumore canale −94,5 dBu A (era −92,9), ritorno −96,1 (era −93,9), sistema a filtri OFF −82,9 (era −81,9). Simulazione: `sim/gain-pot/RISULTATI-gain-pot.md`. La variante della rampa della levetta HPF/OFF/LPF col VCA del fader resta aperta (A22bis).

163. **[F — 2026-11-03, «si per la soluzione proposta», dopo la simulazione; CHIUDE A22bis; PRECISA la dec. 159(a) (commutazione morbida sul canale) e applica la dec. 80 alla levetta del filtro] La levetta HPF/OFF/LPF del canale commuta col «dip» del VCA del fader, senza rampa propria.** (a) **Funzionamento**: girando la levetta, il VCA del fader scende a −100 dB in ~1 ms (due celle RC 2 × 0,5 ms, CV a S), l'ADG cambia bus nel silenzio a ~1,6 ms, il VCA torna su in ~3 ms (−1 dB a ~3,6 ms). (b) **All'orecchio, accettato**: nell'impianto un respiro di 3-4 ms invece del click (secco: +14 dB sopra la musica sul bus che riceve); levetta in ritardo di 1,6 ms; CUE, FX SEND e meter pre-fader non vedono il dip: in cuffia il disco resta continuo. (c) **Circuito** [PROVVISORIO fino al banco]: logica autotemporizzata per canale (74HC86 + 74HC14 + 74HC74, antirimbalzo RC), due celle RC 10k/50n con buffer (mezzo OPA1654) sommate sul nodo EC− dei 2 VCA del fader; nessun VCA in più. (d) **Da verificare a banco**: il respiro su un disco vero, il feedthrough della CV nell'audio, il rimbalzo della levetta. Simulazione: `sim/cdj/RISULTATI-filtsel-dip.md` (`sim/cdj/filtsel-dip.cir`). **[REV 2026-11-11, todo 289; confermata da Filippo il 2026-11-11, «1 si», todo 293]** Con la logica vera il circuito disegnato teneva il buco ~40 ms e poteva lasciare il canale muto se la levetta tornava indietro: corretto (DIFF ripreso da due porte libere, ritardo 68k/47n con diodo di scarica). Numeri nuovi: ADG a ~2,6 ms (1,4-3,8 con le soglie del 74HC14), sempre sotto −120 dB; respiro sotto −20 dB ~4 ms invece di ~3; la risalita dopo l'ADG è la stessa. RISULTATI-filtsel-dip §5.

164. **[F + C — 2026-11-03; requisito di Filippo («secco va bene ma non deve sentirsi scoppi nelle casse»), circuito proposto da Claude e simulato; RIVEDE la dec. 88 e la dec. 150(d) per il click del kill] Il kill del 5-way resta secco ma senza scoppi: l'interruttore taglia e riapre al passaggio per lo zero della sua via.** (a) **Correzione**: il benchmark (`docs/05`) non dice che i kill della scena fanno click; «il click è lo standard della scena» (dec. 88) era una deduzione di Claude. Nel nostro 5-way le vie si risommano e il DSP dell'impianto le ridivide: il gradino del kill (2,18 V al summer, ~4,4 V in uscita al picco) arriva alle trombe come schiocco. (b) **Circuito** [PROVVISORIO]: per via e per lato un comparatore con isteresi di pochi mV guarda la via; un 74HC74 copia la levetta sul pin IN dell'ADG1434 al fronte del comparatore; tempo massimo ~20 ms se la via è muta. Per modulo: 3 comparatori quad, 5 doppi 74HC74, ~40 passivi; nessun VCA, fruscio invariato. (c) **Numeri** (`sim/five-way/RISULTATI-kill-zc.md`, `kill-zc.cir`): gradino da −92 dB (SUB) a −44 dB (SUPER) rispetto al secco; col ritardo reale della catena (0,4 µs) da −80 a −32 dB. Sonda del click: SUB nessun click, KICK un «tic» 34 dB sotto lo scoppio di oggi. (d) **Gesto**: il kill aspetta lo zero della via: al massimo SUB 13,5 ms, KICK 6,3 ms, MID 2,9 ms, HIGH e SUPER sotto 0,5 ms; in media la metà. Il taglio resta netto, senza dissolvenza. Da sentire nel prototipo MC-5WAY.

## Drive del 5-way a bande (2026-11-03)

165. **[F + C — 2026-11-03, revisione delle tabelle di distorsione; requisito di Filippo, circuito proposto da Claude e calcolato col modello del prototipo; RIVEDE la dec. 99 (g) e la dec. 155 (b) per il circuito del GROWL] [PROVVISORIO fino all'ascolto in MC-5WAY e alla verifica LTspice] GROWL a bande: basso più sporco anche sui picchi, medi un po', alti quasi niente.** (a) **Requisito**, parole di Filippo: «aumenterei un po' la distorsione sui bassi, poi a salire distorcere un po' i medi e distorcere pochissimo alti e super alti, deve funzionare anche con picchi forti di basso». Il GROWL LIBERO di oggi sui picchi a +10 dBu scende al 7,5 % e a 1 kHz sporca al 57 % perdendo 4,4 dB. (b) **Circuito** [C]: due rami in parallelo al pulito, una manopola (pot doppio: miscela + spinta lineare in dB). Ramo del basso: passa-basso Butterworth **a 4 poli a 250 Hz** (prima 2 poli a 350 Hz), clipper invertente Rf 47k con 1 diodo / 3 diodi e **470 Ω in serie** (prima 2,2k: sui picchi il clipper tornava lineare), spinta 0 → **+20 dB** (prima +18), miscela 0,9. Ramo dei medi, nuovo: la banda fra il passa-basso e un polo a 2,5 kHz va in un clipper morbido Rf 10k, 3 + 3 diodi con 4,7k in serie, spinta 0 → +6 dB, a pari livello a piccolo segnale. Alti sopra 2,5 kHz puliti. (c) **Frequenza del basso: 250 Hz** [F, «250», fra 250 e 200]: con 350 Hz il medio basso (500 Hz) sporcava al 45-56 %; con 200 Hz il kick finiva a cavallo del confine (51 % e −5,9 dB sul colpo). (d) **Numeri** (fine corsa, sul mix di Filippo a 0 dBu interni / sui picchi a +10 dBu): SUB 50 Hz 28 % +4,2 dB / 22 % −1,7; KICK 120 Hz 42 % +2,4 / 33 % −4,0; 500 Hz 23 % +2,0 / 20 % −3,0; 1 kHz 6 % −0,1 / 7,2 % −2,6; 3 kHz 2,3 % / 5,3 %; 12 kHz 0 % / 0,7 %. Tabelle e modello: `proto-max/RISULTATI-P2.md` §12, `proto-max/coefficienti/growl_bande.py` (variante D). Costo: un passa-basso a 2 poli e un clipper in più per lato.

166. **[F + C — 2026-11-03, revisione delle tabelle di distorsione; requisito di Filippo, circuito proposto da Claude e calcolato col modello del prototipo; PRECISA la dec. 155 (c) e il todo 213] [PROVVISORIO fino all'ascolto in MC-5WAY e alla verifica LTspice] NASTRO a bande, dal NASTRO LIBERO: poco sui sub, poco sui kick, molto su medi e alti, poco sui super.** (a) **Requisito**, parole di Filippo: «sul nastro partiamo dalla versione libera e dammi il grado di distorsione per ognuna delle 5 bande: voglio poca distorsione sui sub, distorsione bassa sui kick, molta distorsione su medi ed alti, poca distorsione sui super alti». Il NASTRO LIBERO di oggi distorce uguale su tutte le vie (39 % sul mix a fine corsa). (b) **Sub puliti anche sui picchi e kick abbastanza puliti** [F, «si pulisci sub e anche i kick abbastanza, cosi da poter usare growl e nastro insieme volendo»]. (c) **Circuito** [C]: il JFET e lo stadio di spinta del NASTRO LIBERO (+12 dB) fra enfasi e de-enfasi. Enfasi: due celle del 1o ordine che tagliano i bassi (zero 80 Hz, polo 400 Hz, −14 dB ciascuna) e due che tagliano i super (polo 5 kHz, zero 10 kHz, −6 dB ciascuna). De-enfasi: le celle inverse dopo il JFET, con 12 dB in meno sui bassi e 7 dB in meno sui super, così il volume di sub e kick non sale. A piccolo segnale il ramo resta piatto; ogni via arriva al JFET con un livello diverso. Costo stimato: ~8 condensatori e un op-amp doppio per lato. (d) **Numeri** (fine corsa, sul mix di Filippo / sui picchi): `proto-max/RISULTATI-P2.md` §12, `proto-max/coefficienti/nastro_bande.py` (variante B8). (e) **GROWL e NASTRO insieme a fine corsa** [F, «1»]: sub e kick arrivano al 52 % e al 77 % sul mix, perché il NASTRO sporca le armoniche del GROWL (100-500 Hz). È il gesto estremo voluto; a metà corsa le due manopole convivono (sub 23 % contro 18 % del GROWL da solo). Alternativa scartata: NASTRO che comincia da ~800 Hz (medio basso col solo NASTRO 30 → ~12 %). (f) Le altre voci di NASTRO VER (OGGI, COMPLETO, COMPL. MEDI, EXCITER, CLASSE A, LIBERO) restano nel prototipo per il confronto d'ascolto.

## Decisioni del 2026-11-04

167. **[F — 2026-11-04, «ritenuta», dopo lo schema del MIC (todo 30, todo 238)] Il tasto MUTE del MIC è a ritenuta: premuto una volta il mic resta muto, ripremuto torna aperto.** Lo schema `pcb/mic/mic.py` lo suppone già; la rampa di 1 ms (dec. 111) e il limiter nel VCA del MUTE (dec. 145) non cambiano. Nota: le decisioni 165 e 166 sono dell'altra sessione del 2026-11-04 (GROWL e NASTRO a bande), già su main.

168. **[F — 2026-11-04, «1», dopo la verifica hardware del todo 211; RIVEDE la dec. 146 per l'hardware] Le manopole dell'isolator usano un pot lineare B a catalogo: la curva PIONEER resta sopra il centro, sotto il centro il taglio è più dolce.** La curva PIONEER (dec. 146) con pot di serie non si fa: nessuna rete attorno a un pot lineare la segue (160 000 reti provate, `sim/eq-iso/RISULTATI-incroci-C.md` §3). Con il lineare: sopra il centro identica; sotto il centro la banda sta +4,0 dB a ore 9, +7,1 dB a theta 0,1, +10,3 dB a theta 0,05 rispetto a PIONEER; fondo corsa −48 dB col residuo garantito di 20 ohm (dec. 127: il −54 era calcolato con 10 ohm). Scartati: pot a 4 sezioni (scarto 4,7 dB, scatto al centro non trovato), VCA per banda (32 VCA). Nel prototipo la curva che corrisponde all'hardware è LINEARE (selettore CURVA di MC-CHANNEL).

## Decisioni del 2026-11-09

169. **[F — 2026-11-09, todo 218; RIVEDE la dec. 125 (taglia di ogni manopola) e la dec. 120 (fader da 100 mm); precisa le dec. 118 e 123] Taglia di ogni comando, su cinque taglie di manopola, due di levetta, due di bottone e due di fader.** Filippo, comando per comando (tabella in `docs/fase3/sistema-comandi.md` §Taglia e scatto): canale GAIN piccola, EQ grande, LINE/PHONO levetta piccola, FILTRO levetta grande, assign FX bottoni grandi, CUE bottone piccolo, fader lunghi; FX-SEND LEVEL media, EQ molto piccola; MIC GAIN piccola, EQ molto piccola, SEND media, MUTE bottone grande; MONO GAIN (livello) grande, EQ piccola, SEND media; FX-RET fader corti, GAIN piccola, EQ piccola, reroute e SELF media; filtro FREQ grande, RES e DRIVE media; 5-way GAIN molto grande («prendi esempio da benchmark»), POSITION e WIDTH grandi, GROWL e NASTRO grandi, KILL levetta grande; MASTER grande, BOOTH media, tasto MONO grande; CUE BLEND grande, LEVEL cuffie media. Totale 115 manopole: 5 molto grandi, 35 grandi, 42 medie, 23 piccole, 10 molto piccole. Ingegneria [C, PROVVISORIO fino al piano schede (todo 203)]: la scala delle taglie, la lunghezza dei fader corti e i pezzi stanno nel documento dei comandi. Fader (Filippo, seconda risposta): canali 60 mm, ritorni FX 45 mm (era 100 mm per tutti, dec. 120); fader mono → VCA (dec. 126), la lunghezza non tocca il tracking; la curva «come Pioneer DJM» (dec. 129 G) si riporta sulla corsa nuova nello shaper. Taglia molto piccola: cappuccio 6 mm sul pot da 9 mm (Filippo, terza risposta); niente pot sotto i 9 mm. Nessun comando aggiunto né tolto. I render di `docs/pannelli/` non sono ancora rigenerati: la dec. 135 (posizioni delle PCB dai render) vale sui render nuovi solo quando Filippo li approva.

170. **[F — 2026-11-09, todo 203; precisa le dec. 141, 144 e 157] Regole della disposizione dei pannelli.** Filippo: (a) rack 19", larghezza fissa (conferma la dec. 157); (b) il filtro può essere largo come 4 canali; (c) il 5-way può allargarsi fino a tutta la larghezza; (d) il CUE sta in basso, vicino a uno dei due angoli; (e) tecniche miste per collegare i moduli: i moduli suonati tanto hanno le schede sotto il loro pannello, un modulo grosso con pochi comandi (il master) può stare lontano dai suoi comandi; (f) connettori tutti dietro, come un mixer DJ; MIC e MONO possono averli davanti solo sul bordo, dove i cavi non disturbano i comandi. Prima bozza con queste regole: proposta D (`docs/pannelli/proposta_d.py`, `proposta-D.svg`), 11U invece di 12-13U, tutti i moduli entro il 70 %. (g) Prese cuffia davanti, sul pannello del CUE nell'angolo (Filippo, stessa sessione: «davanti»), come sui mixer DJ. Seconda bozza: proposta E (`docs/pannelli/proposta_e.py`), 10U = 444 mm. La disposizione resta da scegliere.

171. **[F — 2026-11-09, «1»; precisa la dec. 91 per il solo pannello] Canale CDJ e mandata FX sullo stesso pannello, schede separate.** La striscia del canale continua sotto il fader con la sezione FX SEND (EQ HIGH, EQ LOW, LEVEL), divisa da una linea: niente seconda fascia col nome. L'elettronica resta quella della dec. 91: micro-modulo FX-SEND con la sua scheda, uguale per 4 e sostituibile, sotto la stessa striscia. Scartato il modulo unico (pannello e scheda insieme): risparmio stimato 15-25 € per canale (docs/09, distinta FX-SEND), nessun guadagno udibile (un buffer a guadagno 1 in meno), schede del canale già a PASSA da rifare. Prima bozza: proposta F (`docs/pannelli/proposta_f.py`), 13U.

172. **[F — 2026-11-09, «sinistra», todo 203; precisa le dec. 157, 158 e 170] Disposizione dei pannelli: proposta F col CUE a sinistra.** In fondo il MASTER largo 19", poi il 5-WAY largo 19"; sotto, a sinistra la colonna FILTRO (HPF e LPF affiancati) → 4 strisce CDJ da 50 mm con la sezione FX SEND (dec. 171) → CUE con le cuffie davanti, nell'angolo davanti a sinistra; a destra MIC e 3 MONO, poi i 4 ritorni FX. Nessun pannello cieco: lo spazio va ai moduli fitti. GAIN/LEVEL ed EQ in colonna sfalsata in tutte le strisce (dec. 118); SEND di MIC e MONO e reroute dei ritorni a due a due. Pannello 13U = 578 mm (`docs/pannelli/proposta_f.py`, `proposta-F.svg`). Scartata la variante col CUE a destra (12U = 533 mm, `proposta-F-cue-destra.svg`, resta come alternativa). Schede [C, PROVVISORIO]: tutte entro il 70 % (la più piena il filtro, 69 %); master sotto il proprio pannello in fondo, vicino alle XLR; i 4 reroute dei ritorni (pot → CV) nei posti liberi sotto il 5-way. Scartate D (11U) ed E (10U). I render dei moduli e `coordinate.json` (dec. 135) si rifanno da questa disposizione dopo l'ok di Filippo.

173. **[F — 2026-11-09, «2», todo 249; chiude la proposta del todo 170 e il todo 252; precisa le dec. 142 e 172] Canale CDJ su una scheda sola, lunga ~287 mm; ritorno FX su due schede.** Filippo sceglie «una scheda lunga» fra due schede col cavo piatto 2x18 (piano F) e una scheda sola. Motivo: nessun cavo fra le schede per i cursori dei pot dell'isolator; le 16 reti dei pot vanno solo dal cavo J2 della scheda comandi. Prezzo accettato: una scheda grande, un errore la fa rifare tutta. Ingegneria [C, PROVVISORIO]: 380 impronte, da dietro a davanti sotto la striscia, alta 162 → 129 mm, al 70 % (`pcb/PIANO-SCHEDE-F.md`, 28 schede in tutto). Il ritorno FX resta su due schede (segnale sotto la striscia, reroute sotto il 5-way, cavo 2x16): sotto la striscia restano ~70 mm, il reroute ne vuole ~140. La scelta del foglio A/B/C della proposta è superata dalla dec. 172: il FX-SEND ha una scheda lunga 100 mm e il C96 (95 mm) ci sta. Da fare: il generatore col trapezio della dec. 158 (proposta P3), poi `canale.py` rigenerato su una scheda (`canale-isolator.py` archiviato).

174. **[F — 2026-11-09, todo 261 e 263; supera la scelta del 6/11 «prima la versione analogica completa, il misto in pausa fino alla fine»] Parte la versione mista digitale/analogica, accanto a quella analogica.** Progetto parallelo in `misto/`, come `cheap/`: non modifica `docs/`, `sim/`, `pcb/`. Griglia del 6/11 (dialogo BURN): analogico/misto × completo/economico. Scelte di Filippo (registro `misto/01-decisioni-misto.md`): M1 obiettivi = prima costo e spazio, poi valori modificabili senza saldare dove costa poco; niente scene, MIDI, movimenti a tempo. M2 tre condizioni: l'audio non passa mai per numeri, il chip muove solo le CV; chip comune su zoccolo, ricambio programmato nel flight case, firmware aperto; nessun gradino udibile. M3 stesso pannello, comandi e funzioni della versione completa. M4 valori modificabili da computer via USB, nessun display. M5 un chip per modulo. Primo inventario dei circuiti di comando in `misto/02-inventario-comandi.md`. La dec. 6 («100% analogico per l'audio») resta valida: il misto non tocca l'audio.

175. **[F — 2026-11-10, ascolto in MC-5WAY con la guida `proto-max/ascolti-5way.pdf`; chiude B3 e B6 per il 5-way, todo 60, 213, 246, 247, 255, 260; precisa le dec. 150 (a), 164, 165 e 166] Incroci H, GROWL e NASTRO a bande.** (a) **Incroci H: 60 / 250 / 1200 / 8000 Hz** («H»), al posto di E 80/170/1,2k/6k. Via KICK di 2,1 ottave: il kill KICK abbassa la cassa di ~13 dB invece di ~6; il kill SUB scende da −10 a −6 dB, il kill MID da −13 a −9 (`RISULTATI-P2` §20, Python). (b) **Kill allo zero della via: pulito** («1»): nessun clic, nessun ritardo udibile (dec. 164 confermata). (c) **GROWL: versione BANDE** (dec. 165), **senza ritocchi** («4 mi sembrava ok»: niente enfasi né diodi cambiati, todo 246). **Curva più lenta: a metà corsa 30 %** dell'effetto («meta corsa 30»): mg = t^1,74 (prima t^1,5, 35 %); fine corsa uguale. Hardware: pot doppio a curva logaritmica. (d) **NASTRO: versione BANDE B9** (dec. 166 col ritocco del 4/11, `RISULTATI-P2` §16-18), curva inversa di oggi 1 − (1 − t)^2,5. (e) **Medi schiacciati sui picchi a fine corsa (−5,9 dB): vanno bene, è il carattere** («1»). Conseguenze: la domanda dei super a −14 o −7 dB (todo 247) cade, la B9 ha una cella sola a −5 dB; la banca del 5-way va riallineata agli incroci H (design doc §3.2, §8.2bis, kill allo zero §8.11). Verificato in: Python sì / LTspice sì per NASTRO B9 e kill allo zero, no per la banca H / Live sì (ascolto di Filippo).

176. **[F — 2026-11-10, `docs/pannelli/moduli-filippo-2026-11-10.pdf` («ho aggiornato i moduli come li vorrei … pensaci tu» per centramenti e ottimizzazione) e todo 217 («opzione 1»); precisa le dec. 118, 169 e 172] Moduli della disposizione F ridisegnati da Filippo; pot dell'EQ del FX-SEND.** (a) **Canale**: GAIN in alto a sinistra con LINE/PHONO accanto; EQ in colonna sfalsata a passo 25,9 mm; sezione FX SEND con LEVEL sopra e HIGH e LOW affiancati sotto (scritte «HIGH» e «LOW»). (b) **MIC e MONO uguali**, 61 × 190 mm (MONO prima 180): GAIN grande in alto a sinistra (MUTE accanto nel MIC), EQ HIGH ed EQ LOW piccoli in colonna sfalsata, SEND 1-4 in colonna sfalsata invece che a due a due, LED in fondo. Il GAIN del MIC passa da piccola a grande, l'EQ del MIC da molto piccola a piccola. (c) **Ritorni FX**: stessa testa di MIC e MONO (GAIN da piccola a grande), reroute in colonna sfalsata, fader 45 mm col meter. (d) **Filtro**: per sezione FREQ grande al centro e più in alto, RES a sinistra, DRIVE a destra. (e) **CUE**: cuffie a sinistra, BLEND e LEVEL a destra. (f) **Master**: BOOTH a sinistra, meter L e R al centro col MONO sotto, MASTER a destra. (g) **5-way**: per ogni via nome, LED tricolore, GAIN molto grande con la levetta del kill a destra, POSITION e WIDTH sotto; GROWL e NASTRO da grande a molto grande, in colonna a destra. **LED delle vie** («1 anche super»): un LED tricolore di livello su ognuna delle 5 vie, SUPER compresa: verde = segnale, giallo = vicino al limite, rosso = satura. Punto di lettura e soglie da progettare [C, APERTO]. (h) **Messa in passo [C]**: passi costanti (EQ 25,9 mm, SEND e reroute 18,9 mm, vie del 5-way 79,4 mm), gruppi centrati (CUE sui quarti del pannello, master attorno al centro: il gruppo nel PDF stava 26,5 mm a destra), POSITION e WIDTH simmetrici sotto il GAIN. Scatti come la tabella di `sistema-comandi.md` (reroute al centro sì; GROWL, NASTRO e GAIN dei ritorni no). Pannello sempre 13U = 578 mm, schede tutte entro il 70 %. Fonte unica: `docs/pannelli/proposta_f.py`. (i) **Pot dell'EQ del FX-SEND (todo 217): Alpha RD902F doppio 9 mm lineare senza scatto** (opzione 1); assenza dello scatto da confermare sul disegno del catalogo.

## Decisioni del 2026-11-11

177. **[F — 2026-11-11, «2 si», todo 292; chiude A24; precisa la dec. 176 (g)] LED di livello delle 5 vie.** (a) Lettura dopo il drive, alla presa del meter: il LED segue il GAIN della via, GROWL e NASTRO compresi. (b) Soglie all'uscita del modulo: verde da −18 dBu, giallo da +12, rosso da +18 (rosso = tetto di progetto del modulo). (c) Il LED legge la somma L+R (~136 impronte); un suono solo a sinistra legge 6 dB più basso. Scartata la lettura del lato più forte (~+80 impronte). Circuito e numeri: `docs/fase2/five-way-led-livello.md` §3, §6; `sim/five-way/RISULTATI-led-livello.md`. Verificato in: Python no / LTspice sì / Live no.

## Decisioni del 2026-11-12

178. **[F — 2026-11-12, «3», todo 26; chiude A10 e la voce 29] Nome sul telaio: «maelcum mixer».** Resta il nome del progetto. Le misure del telaio le hanno già fissate le dec. 158, 170 e 172 (rack 19", 13U = 578 mm, inclinato ~150 → 215 mm). Grafica e posizione del nome sul pannello: di Filippo, in Illustrator (dec. 176). Nella stessa sessione A11 (strumenti di misura) resta rinviata fino al prototipo: todo 306, FERMO.
