dj-filippo241/maelcum_mixer/pcb/NOTE-generatore.md

# Generatore delle PCB: revisione del 2026-10-28

Revisione di `pcb/tools/pcbgen.py` prima del master (#167). Quattro analisi in parallelo
(errori, struttura, qualità audio misurata sulla scheda, coerenza coi documenti), poi le
correzioni. Banco di prova: FX-SEND, rigenerato.

## Cosa cambia

| Prima | Adesso |
|---|---|
| `build()` usciva sempre «tutto bene» (codice 0); gli errori restavano nel JSON | Esito **PASSA / NON PASSA** in fondo e nel `riepilogo.json`; con errori il processo esce con codice 1 |
| Nessun confronto col giro prima | Riga «PEGGIO» per ogni conteggio di ERC, DRC o controllo audio che cresce |
| Report di kicad-cli e `.ses` di Freerouting letti anche se vecchi | Cancellati prima di ogni giro; se un comando non li produce, il generatore si ferma |
| `routing: true` se il file `.ses` esisteva | Collegamenti aperti contati rete per rete dal log: la massa la chiudono le colate, una rete di segnale aperta è un errore |
| Schema confrontato col netlist in un senso solo | Nei due sensi: anche una rete nata nello schema (due pin sullo stesso punto) è un errore |
| `check()`: solo reti con un pin | Anche pin di alimentazione dimenticati, pin dichiarati due volte, riferimenti doppi, nomi di rete quasi uguali (refusi) |
| Classi di rete solo nella scheda in memoria | Scritte anche nel `.kicad_pro`: un ritocco in KiCad le conosce |
| 51 avvisi di parità «net_conflict» mescolati agli altri | Contati a parte come «atteso» (pin liberi del C96, staffe dei pot) |
| Campo «Nota» solo nello schema (19 avvisi) | Copiato sull'impronta; i fori non entrano nella distinta |
| uuid casuali: la PCB cambiava tutta a ogni giro | uuid ripetibili: git mostra solo le differenze vere |
| 100n di disaccoppiamento piazzati col blocco, a 8-13 mm dal pin (fino a 78 mm di pista) | Legati al loro chip in automatico e messi a ~2 mm dal pin, col pad dell'alimentazione verso il pin |
| Via di massa sempre verso l'esterno, anche sopra un altro pad | Prima fuori, poi sotto il corpo del chip; isole di colata tolte |

File nuovi:

- `pcb/tools/backplane.py`: pinout del C96 (righe a e c comuni, §3 e §5 del backplane). Il modulo scrive solo la riga b.
- `pcb/tools/audiocheck.py`: controllo audio dopo il routing (regole A1-A5 sotto). Gira in 0,2 s. Da riga di comando legge le regole da `d.audio_rules` del file del modulo.
- `pcb/fx-send/cavo.py`: l'ordine dei fili del cavo piatto, letto dalle due schede.
- `sim/lint_cir.py`: le regole di simulazione del CLAUDE.md come controllo dei `.cir`.

## Controllo audio (audiocheck.py)

Soglie di partenza, da rivedere con la prima scheda costruita:

| Regola | Cosa | Soglia |
|---|---|---|
| A1 | 100n dal pin di alimentazione | ≤ 3 mm pad-pad, ≤ 5 mm di pista; regolatori ≤ 10 mm |
| A2 | Masse virtuali e ingressi invertenti | ≤ 25 mm di pista, ≤ 1 via; reti del cavo ≤ 40 mm |
| A3 | Passivi di una rete sensibile dal pin dell'op-amp | ≤ 6 mm |
| A4 | Accoppiamento stimato da reti rumorose | ≤ 0,05 pF |
| A5 | Piste sensibili nel riquadro dei regolatori | nessuna (+3 mm) |

Ogni modulo dichiara le sue reti in `d.audio_rules` (esempio in `fx-send.py`). Per ora il
controllo **non ferma** la scheda: misura e segnala i peggioramenti. Diventa un errore quando
il piazzamento a grappolo (sotto) lo rende raggiungibile.

FX-SEND, prima e dopo questa revisione:

| Regola | v0.2 | adesso |
|---|---|---|
| A1 | 24 (tutti gli op-amp a 8-13 mm) | 10 (solo regolatori; ogni op-amp entro 3 mm) |
| A2 | 35 | 29 |
| A3 | 26 | 23 |
| A4 | 4 | 4 |
| A5 | 4 | 3 |

## Correzione di circuito trovata dall'analisi

**Mute degli assign (FX-SEND).** Era un circuito aggiunto disegnando (NOTA), non dal design
doc. Con mute attivo e bottone premuto l'ingresso dell'ADG1434 stava a 1,21 V, fra le soglie
0,8 e 2,0 V: il mute non garantiva lo spegnimento. Da acceso stava a 2,5 V. Ora: 100k a massa
e 1k in serie al FET. Acceso 4,55 V, mute 0,45 V, rampe 0,9 ms e 0,09 ms. Dettagli in
`pcb/fx-send/NOTE.md` punto 12.

## Piazzamento a grappolo (2026-10-28, todo 183)

Ogni R e C (non elettrolitico) si lega a un op-amp: prima per un pin di segnale in
comune (stesso blocco, poi un altro blocco), poi per una rete in comune con un passivo
già legato. Il passivo va accanto al suo pin, sul lato del pin, col pad della rete in
comune verso il pin; se il posto è occupato scorre lungo il lato, poi una fila più in
fuori (spazio `d.cluster_gap`, 0,5 mm). Il grappolo viaggia col chip nel piazzamento a
blocchi. Si spegne con `d.cluster_auto = False`.

FX-SEND, prima e dopo:

| Regola | prima | grappolo 0,2 mm | grappolo 0,5 mm (adesso) |
|---|---|---|---|
| A1 | 10 | 10 | 10 |
| A2 | 29 | 22 | 28 |
| A3 | 23 | 10 | 12 |
| A4 | 4 | 5 | 8 |
| A5 | 3 | 3 | 4 |
| esito | PASSA | NON PASSA (2 aperti di Freerouting) | PASSA |

Con 0,2 mm Freerouting lasciava aperti un filo del cavo e un tratto di +15SW: 0,5 mm
è il compromesso. A3 (passivi lontani dal pin) è risolto. Quello che resta in A2, A4 e
A5 non dipende dalla cella: sono piste lunghe dal C96 (S*_OUT, SEND_IN, 90-130 mm) e
dal cavo dei pot (NA/NB/NC) che passa accanto ai regolatori. Serve il punto 1 sotto.

## Retro della scheda (dec. 142, 2026-10-28)

Le schede sono alte 220 mm e possono portare SMD sui due lati. Nel file del modulo:
`d.side = "B"` prima dei blocchi da mettere sul retro, `d.side = "F"` per tornare al lato
componenti. Regole del generatore:

- Sul retro va solo l'SMD. Foro passante, connettori, elettrolitici radiali e pezzi con
  `place` restano sul lato componenti anche dentro un blocco «B».
- Un chip del retro porta con sé i suoi 100n e il suo grappolo, ribaltati attorno al chip.
  Se il grappolo contiene un pezzo a foro passante, tutto il gruppo resta davanti.
- Il retro si piazza dopo il davanti: ogni gruppo nel primo posto libero, colonna per
  colonna da sinistra. Ostacoli: i pin dei pezzi a foro passante (+1 mm) e i gruppi già messi.
- I ponticelli a stagno non entrano nella distinta (sono rame), come i fori.

## Blocchi vicino al loro connettore (2026-11-04, todo 196)

Prima i blocchi andavano in colonne nell'ordine del file: sul FX-SEND l'alimentazione finiva
in alto accanto al cavo dei pot (J2) e il buffer d'ingresso a metà scheda, lontano dal C96.
Adesso (`_place_near`, il vecchio modo resta come `_place_columns`):

- Ogni blocco cerca il posto libero (passo 1,5 mm) più vicino ai pin dei connettori fissi
  (pezzi con `place`) con cui ha una rete in comune; peso 3 per un pin di connettore, 1 per un
  pin di un blocco già messo. Contano solo le reti dei pezzi del blocco: un passivo legato al
  chip di un altro blocco (grappolo) non sposta il suo blocco.
- Ordine: prima i blocchi con più pin di connettore; il blocco dei regolatori per ultimo, con
  una penalità se sta a meno di `d.power_from_cable` (60 mm) dai pin del cavo (`audio_rules["cavo"]`).
  `d.power_first = True` lo fa scegliere per primo.
- Ogni blocco prova 6 forme; un blocco oltre 40 mm con lati più lunghi di 1:3 (`d.block_aspect`)
  solo se nessun'altra forma entra: un'alimentazione di 24 × 120 mm faceva da muro e -18V
  restava aperta. Fra due blocchi un corridoio di 3 mm (`d.block_margin`): con 1,5 mm restava
  aperto un tratto di RAW+27.
- Se un blocco non trova posto si torna alle colonne (nota nel riepilogo); `d.place_mode =
  "colonne"` le forza. Il retro non cambia.

FX-SEND, controllo audio:

| Regola | colonne (todo 205) | vicino ai connettori |
|---|---|---|
| A1 | 10 | 9 |
| A2 | 24 | 14 |
| A3 | 12 | 12 |
| A4 | 5 | 2 |
| A5 | 6 | 0 |
| esito | PASSA | PASSA |

Varianti provate, tutte NON PASSA: alimentazione per ultima a forma libera (-18V aperta, 6),
alimentazione per prima (-18V aperta, 7), corridoio 1,5 mm (RAW+27 aperta, 1). Freerouting non
dà lo stesso risultato a ogni giro: un PASSA singolo con una rete al limite non è una prova.

## Regole delle classi (2026-11-04)

Le vie piccole delle reti sottili (29/10) stavano nella scheda (0,2 mm) ma non nel
`.kicad_pro` (0,25 mm): Freerouting tracciava a 0,2 e il DRC contava errori di distanza
(FX-SEND 36; probabile causa dei 3 del master, giro 5). Ora una fonte sola, `Design._classrules`.

## Pad gemelli e fanout di traverso (2026-11-04, master)

Due opzioni nuove, spente di default (FX-SEND rigenerato con le opzioni spente: PASSA):

- `d.link_pairs = True`: due pad a foro passante vicini (<= 4 mm) della stessa impronta e della
  stessa rete si uniscono con una pista dritta prima di Freerouting. Freerouting li lascia spesso
  aperti (cursore e capo di un trimmer, pin doppi del C96; sulla J4 2x2 del master sempre). Su
  pin SMD no: Freerouting conta come aperta una pista che non ha tracciato lui (il DRC no). Per lo
  stesso motivo, con l'opzione accesa i collegamenti già uniti escono dal conto degli aperti.
- `d.fanout_more = True`: se i due posti della via di massa sull'asse del pad sono occupati, si
  prova anche di traverso e più lontano (0,75 / 1,1 / 1,5 mm). Un pad di massa senza via resta
  un'isola di colata quando il routing la spezza. Master: pad senza via da 15 a 5.

Regola per i connettori: due pin vicini della stessa rete su un header fanno fallire Freerouting
su tutta la rete. Pin alternati (+5V, CTRL_GND, +5V, CTRL_GND) o `link_pairs`.

## Schema leggibile (2026-11-09)

Lo schema del generatore mette un'etichetta su ogni pin: giusto per la macchina, illeggibile per
una persona. `pcb/tools/leggibile.py` disegna un secondo schema dallo stesso netlist, per chi
legge o monta la scheda. Lo schema che alimenta la PCB non cambia.

```bash
/Applications/KiCad/KiCad.app/Contents/Frameworks/Python.framework/Versions/3.9/bin/python3 pcb/tools/leggibile.py pcb/mono/mono.py [altri ...]
# il master d'uscita vuole il lato: pcb/master/master-uscita.py:L
# il backplane vuole il tratto: pcb/backplane/tratto.py:T1 (fino a T4); blocchi e valori del
# backplane si traducono a modello (BLOCK_RULES, VALUE_RULES in leggibile_en.py)
```

Esce in `pcb/<scheda>/leggibile/`: `.kicad_sch`, PDF, `erc.json`, `riepilogo.json`. Esito
LEGGIBILE PASSA solo se il confronto col netlist voluto passa nei due sensi e l'ERC non ha errori.

Gli schemi sono in inglese (richiesta di Filippo, 2026-11-09): titoli dei blocchi, titoli e valori
descrittivi stanno in `pcb/tools/leggibile_en.py`; i file delle schede restano in italiano. Un
blocco o un valore senza traduzione ferma il giro. I nomi delle reti restano quelli della PCB.
Con più schede in un lancio esce anche `pcb/schematics-readable.pdf`: copertina con indice e
legenda, poi una pagina per scheda nell'ordine dei file dati (unione con `pdfunite` di poppler).

Regole del disegno: alimentazioni e masse come simboli; passivi attaccati coi fili al pin che
toccano (in serie lungo il pin, in derivazione verso il simbolo); etichetta solo dove il filo non
arriva (riquadro = la rete va in un altro blocco); i lati con più di 3 pin (connettori, LM339,
ADG1434) portano solo etichette, e i loro passivi stanno in gruppi a catena sotto.

Trappole pagate: nello stesso processo tre moduli caricano il proprio `cavo.py` col nome uguale e
Python riusa il primo (un processo per modulo); un confronto `== 0` su una differenza di float
faceva scalinate sui pin del C96 (tolleranza 0,01 mm). Un ritocco a un modulo `.py` vuole un
nuovo giro anche di `leggibile.py`: lo schema leggibile non si aggiorna da solo.

## Scheda a trapezio (dec. 158, 2026-11-09, todo 272)

Il telaio è inclinato: sotto il pannello le schede scendono da dietro a davanti. Nel file del
modulo: `board=(L, H_dietro, H_davanti)` al posto di `board=(L, H)`. Il lato in basso (C96,
backplane) resta dritto; il lato in alto scende in diagonale. x = 0 è il lato di dietro.

- Contorno, colate di massa e fascia senza piste lungo il bordo seguono la diagonale.
- Il triangolo tagliato via entra nel piazzamento come scalini di rettangoli da 4 mm
  (`_cut_boxes`), con 1,5 mm di margine: lato componenti e retro.
- `d.ytop(x)` dà la y del bordo in alto: i pezzi fissi vicino al pannello (fori, cavo dei pot)
  si mettono a `d.ytop(x) + margine`. `celle_vca.cavo` prende anche `y`.
- Un rettangolo dà gli stessi file di prima: le schede già generate non cambiano.
- Le misure di ogni scheda vengono da `pcb/PIANO-SCHEDE-F.md`. Prima scheda a trapezio: il canale
  (287 × 162-129 mm, dec. 173). Le altre (MIC, MONO, FX-SEND, FX-RET) restano a 100 × 220 finché
  non si rigenerano sulle misure del piano. Il canale PASSA il 2026-11-11 (giro 10, todo 272).
- `DesignRiprova` (2026-11-11): Freerouting fino a `d.route_tries` volte (4), finché il DRC non
  trova aperti né errori di distanza. Nato nel MIC (todo 248), ora nel generatore: lo usano
  `mic.py` e `canale.py`. Le schede grandi lo vogliono: ogni giro sbaglia in un punto diverso.

## Cosa resta (in ordine)

1. **Retro vicino ai connettori.** Il retro si piazza ancora nel primo posto libero.
2. **Blocchi con riferimenti fissi** (R1xx lato L, R2xx lato R): oggi una resistenza aggiunta
   rinumera tutte quelle dopo.
3. **Fonte dichiarata per ogni valore** (`fonte="sim/fx/x.cir:Rf"`) e uno script che la
   confronta col `.cir`. Avrebbe trovato da solo le discordanze di NOTE.md.
4. **Isola CTRL_GND** per la logica degli assign, vicino a J3 e ai pin c del C96.
5. **Regolatori:** condensatori d'ingresso e d'uscita a ≤ 10 mm (A1 rimasto).
