dj-filippo241/maelcum_mixer/docs/storico-sessioni.md

# Storico delle sessioni — maelcum mixer

> Cronaca spostata dal `CLAUDE.md` il 2026-10-13 (todo #27), parola per parola.
> NON è la fonte delle decisioni: quelle stanno in `docs/01-decisioni-bloccate.md`,
> le aperte in `docs/02-questioni-aperte.md`. Qui resta il «come ci siamo arrivati»:
> finding, lezioni di simulazione, numeri superati. Dove un paragrafo vecchio
> contraddice uno più recente, vale il più recente.

## Fase attuale

**Corpus ChatGPT CHIUSO (2026-09-18).** Non arriverà un export migliore: resoconto (`docs/00-...`) + due status doc (`docs/export-chatgpt/`) = referenza completa (decisione 58). Revisione critica FATTA: `docs/03-revisione-critica.md`. Architettura filtro decisa: `docs/04-architettura-filtro-e-diagramma.md` + decisioni 67/70/74 (B′, 2 sezioni full-range 10 Hz–35 kHz). Gain-staging sheet FATTO: `docs/fase1/gain-staging-sheet.md` (chiude questioni 31/47/52, gain phono 42 dB, mappa domini). SPECIFICA.md v0.1 FATTA. Simulazioni LTspice dell'EQ FATTE (2026-09-24, `sim/cdj-eq/RISULTATI-eq.md`): **finding critico** — la cella a contribuzione bipolare non può fisicamente realizzare il kill/boost LOW/HIGH (la math validata ignorava la fase dei filtri); Filippo ha deciso: **EQ in serie per banda, famiglia Baxandall (decisione 76)**. EQ v0.3 **BETA-3 FATTA** (2026-09-27, `docs/fase1/eq-serie-v0.3.md` §9.7 + `sim/eq-serie/`): op-amp reali (macro OPA1654/1612, libreria condivisa `sim/lib/opamp-audio.inc`) — rumore confermato −110,7 dBu (margine 18,7 dB), offset detent RISOLTO (−0,0001 dB con coppia 0,1%: era artefatto della macro vecchia, trim multi-giro non serve), griglia 10 modi ±0,2 dB, banda 35 kHz; integrata in `cdj-line-channel.md` **v0.3**. **Decisione 78**: prototipo MUSICALE del mixer completo in Max for Live PRIMA del millefori — piano fasi P0-P4 in `docs/proto-max/piano.md` (valida a orecchio curve/law/carattere; chiude 61/63/64/67/68; il millefori resta la porta elettrica). **IN PAUSA per direzione Filippo 2026-09-25: prima finire tutto il design.** Design modulo filtro **v0.2** FATTO (`docs/fase2/filter-module.md`): converter 10 Hz–35 kHz dimostrato, risonanza→auto-oscillazione +7,3…+8,6 dBu con soft limiter SIMULATA (questione 11), distribuzione mirror bufferizzati tracking ≤1,6% (51), law shaper specificato. Modulo **FX v0.2** FATTO (ora v0.3-WIP: matrice 16× self-FB, dec. 91) (`docs/fase1/fx-module.md`): loop feedback bounded-by-design simulato, matrice 12× THAT 218x; v0.2 (2026-09-27/28): law a tratti del reroute VERIFICATA end-to-end (§8.3, smoothing 1 ms raccomandato), claim TVS/banda 40 kHz CORRETTO (§8.4: il polo lo fa la Z sorgente), DC servo ritorni VALIDATO (corner libero 0,05-0,5 Hz), EQ2 = celle serie scalate VALIDATE. **5-WAY v0.2-WIP** (`docs/fase2/five-way-module.md`): banca kill LR4 allineata in fase VALIDATA (somma piatta ESATTA via allpass A2 dai crossover), 5 celle parametriche SVF + cascata VALIDATE, rumore modulo −108,4 dBu PASS, gate VCA + ramp 1 ms VALIDATO; resta il drive JFET (BLOCCATO su questione 61; LM13700 modellato in sim/lib). **THAT 218x = SINGLE channel** (datasheet 2026-09-27): ~34-36 chip nel mixer, modello condiviso `sim/lib/that2181.inc`; voce 37 riscritta (grado/prezzo = decisione di Filippo). **Peak detector condiviso** SIMULATO (`sim/meter/` + RISULTATI): release meter ≥1 s (3 s raccomandato), latch clip 442 ms dimostrato (SPEC ✓) — dati per questione 19. CDJ §7: VCA law/headroom e summing DJ bus/crosstalk VERIFICATI. Fix trasversale 2026-09-25: SK high-pass vuole R_fb = R_gnd/2 per Q 0,707 (bug ereditato da v0.2, corretto ovunque). **SESSIONE 2026-09-28**: (1) LM13700 REALE modellato (`sim/lib/lm13700.inc`) → FINDING: tetto di stato 52 mV a f0 per ogni integratore OTA → celle 5-way nude inutilizzabili e core filtro = compressore ~1% THD a 0 dBu (questione 70); (2) PoC topologie pulite VALIDATO (`sim/five-way/RISULTATI-cell-clean.md`): **(c-A) JFET VCR bootstrappato** adottata per le celle → **CELLE v0.2.1 RILASCIATE** (five-way §4.2: THD 0,005%, law ±0,03%, rumore −121,7 dBu) e (c-B) VCA 218x come alternativa; lato FILTRO resta scelta MUSICALE (a) carattere vs (c-B) pulito (ascolto con 61/64); ramp BBM filtro VALIDATA (famiglia 1 ms, ratifica 55); (3) **FRONT-END PHONO MM v0.1** (decisione 79, chiude q6, `docs/fase1/phono-stage.md`: RIAA passiva 42 dB, EIN 0,36 µV, overload +18 dBu; canale = **v0.4**); (4) **DIAGRAMMI SVG dei 5 moduli** in `docs/diagrammi/` (+index.html); (5) housekeeping D1-D9 e CLAUDE.md allineato due volte. **SESSIONE DECISIONI (2026-09-28/29, commit ee7a1dc)**: decisioni 80-85 — 80: famiglia unica BBM + ramp 1 ms per tutte le commutazioni CV (chiude 55); 81: ballistica meter stile Pioneer DJM, release ~0,3 s + REVISIONE dec. 65 parte metering («senza sagging» → «leggibile a zone con ballistica viva»); 82: referenze distorsione 61 (drive 5-way = «prima nastro, ultimi 20% fuzz», overdrive filtro = Sherman Filterbox, EQ spinto = sporca progressivamente) → SBLOCCATI drive JFET, overdrive filtro, ascolto q70; 83: master = finale a GUADAGNO nel feedback globale (chiude 60, requisito +24 dBu invariato → master-out v0.3); 84: ritorni FX senza selettore/limite, K4 = disciplina operatore (chiude 69); 85: gain 5-way = 5 pot rotativi (q24 chiusa per il 5-way; comandi phono → voce 40). Voce 37: FINDING CRITICO — THAT 2180/2181/2162 END OF LIFE (memo THAT 2026-09-01), **LTB entro 2026-09-30** (sales@thatcorp.com), ricerca prezzi annotata (clone CoolAudio V2181L $2,10-2,95 / €2,80-3,75; originale listino $2,55-4,61), decisione approvvigionamento PENDING; questione 53 rinviata alla 37. **SESSIONE 2026-09-29**: VAS discreto a guadagno (via tecnica della dec. 83) PROVATO E BOCCIATO in simulazione — latch d'accensione (CE satura, il segno dell'anello si inverte: out bloccato +11,3 V) + muro di stabilità strutturale (op-amp già compensato + polo VAS sotto crossover = doppio integratore: picchi closed-loop +4,7…+14 dB a 56-148 kHz e +3…+4,5 dB residui a 35 kHz = fuori banda, su 15 combinazioni Cc×Rz×Cf — `sim/master-out/compG-*.cir` + RISULTATI-composite §v0.3) → **decisione 86: BOOTSTRAP delle alimentazioni OPA1612** (opzione (b) della q60): rail locali flottanti OUT±4,4 V (stringa 7×1N4148 + pass serie MJE340/350, handoff dolce ai rail statici ±23,7 V), composito v0.2 invariato (A_vas=1, stabilità nota) → **swing VALIDATO: ±21,1-21,5 V = +25,7…+25,9 dBu (conversione corretta; ATTESO superato lo stesso giorno dalla verifica con Iq reale: definitivi ±20,4-20,9 V = +25,4…+25,6), requisito ≥+24 PASS con ~1,7 dB di margine** (`compB-swing.cir`); suite v0.3 restante: AC/THD/rumore/corto, sizing Iq 40 mA, JFET CCS per simmetria rail inferiore, protezioni/servo DC. **SESSIONE 2026-09-29 (pomeriggio)**: (1) voce 37 DECISA da Filippo — acquisti SOSPESI fino al superamento del prototipo M4L, finestra LTB lasciata scadere consapevolmente → rotta clone CoolAudio V2181L (56-64 pz post-prototipo); 53 agganciata (clone trimmable). (2) **MASTER-OUT v0.3 CHIUSA** — suite completa con Iq REALE 40 mA (macro OPAMAC-ISUP, Test 7-12): FINDING: il Test 6 era ottimistico (±21,5 V senza assorbimento; con Iq e bias a R lo swing crolla a +19,3/−17,9). Rete finale: stringa 9×1N4148 (Δ ≈ 5,3 V) + bias JFET in modo CRD (Idss ≈ 4 mA) + Re 33 → **capability ±20,4-20,9 V = +25,4…+25,6 dBu PASS (margine 1,4-1,6 dB)**, THD a +24 dBu PASS (0,00012 %@1k / 0,0042 %@35k su 600 Ω — livello che la v0.2 non poteva misurare; a 14 Vp identica alla v0.2 = A/B ✓), banda 8 Hz-35 kHz −0,0002…+0,008 dB, rumore −119,2 dBu (target −100: PASS 19 dB), corto auto-limitato dal bootstrap **106 mA** (v0.2: 460; Q1 1,0 W medi = worst di programma → target <60 mA [PROVVISORIO] REVISIONATO dai dati: niente limitatore dedicato, abuso prolungato = dominio PSU), servo DC 30 µV (Vos 3 mV, fc 0,048 Hz, rete Rsrc/Rinj/Rf/Rg = guadagno netto 1,000), power-on ±15 V coperto dal mute [§3.7]. Sizing pass: 0,75 W idle / 1,0 W programma / 2,7 W picco → rame ≥4 cm². LEZIONI: macro in 2 varianti (specchio lineare per .ac/.noise, abs per .tran — il kink a I(E3)=0 rompe la linearizzazione; lo specchio lineare in tran è 4× lento); Cboot 1 µ rail↔OUT BOCCIATO (glitch 0,3-0,4 V/periodo → THD 5,9-38 %); margine clamp drv ≥ ~1,5 V (sotto → comb THD); .nodeset obbligatorio. (3) **DRIVE 5-WAY v0.3 VALIDATO** (task 3, ordine di Filippo «2 e poi 3»): catena 218x (law end-to-end MISURATA ESATTA 0/+7/+9,5/+12/+14/+16 dB a θ 0/50/65/80/90/100) → JFET CS nudo «nastro» (ginocchio 0,7-1,0 Vp; il pulito a CCW lo garantisce la law: −9,4 dB prima del saturatore) → DIFF PAIR PNP single-ended «fuzz» (steering ±1,9 V, ceiling ±2,79 V, basi dal drain via R matched: Vce ≈ −14 mai saturo) → recovery invertente 2k/2k (polarità totale non invertente) + servo DC 2 op-amp su reco (fc 0,31 Hz, −65 µV). Griglia musicale THD θ×programma in five-way §5.3 → **CONFERMA DI FILIPPO PENDENTE (regola 2)**; 7 iterazioni con 6 lezioni di topologia (§5.4: feedback su drain CS = positivo; shunt JFET carico; 3 latch di bias; servo deve sentire il nodo che nulla). Restano D5 risonanza (dopo q70) e D6 rumore (→ module-noise). **SESSIONE 2026-09-30 (mattina)**: (1) griglia drive §5.3 **CONFERMATA da Filippo → decisione 87** (valori bloccati come punto di partenza; review «estetica» a orecchio sul prototipo M4L). (2) **PHONO sub-100 Hz ATTRIBUITO E RISOLTO** (phono-stage.md REV): residuo −0,5/−1,4/−3,9 dB = polo DC block 15,9 Hz (attenuazione diretta + carico rete RIAA) — fix Rb2 100k→1M (polo 1,59 Hz): curva ≤±0,05 dB su 100 Hz-20 kHz, −0,24 dB a 30 Hz (requisito PASS); le netlist rumore/overload v0.1 non avevano il polo → EIN/warp già coerenti col circuito fixato. (3) **MODULE-NOISE v0.2.1 + D6 FATTI** (five-way §8.9 + `sim/five-way/RISULTATI-module-noise-v021.md`): **FINDING SISTEMICO — quirk LTspice 26.0.2: `.meas INTEG` su noise integra en²·√Δf → tutti i totali √INTEG del repo ~21,5 dB ottimisti** (phono già corretto: EIN 1,79 µV 10-20k, out −79,8 dBu, 19 dB sotto il vinile; master-out margine vero ~2 dB da confermare; lista → voce 71A docs/02). Secondo quirk: iniezioni rumore solo con E lineare 4 nodi; subckt VCAM + banca SK = bug parse → inline. D6 drive: **−85,7 dBu pre-makeup, VCA 218x dominante 87%** (stima handoff −98/Rg doppiamente smentita), servo TL062 via Rinj secondo (10,1 µV), Rg terzo (5,4). Modulo completo con 6 218x (rumore datasheet −98 dBV a 0 dB): **−77,3 dBu θ0 / −73,0 θ50 vs target sheet §3 −90 A-wtd: FAIL 10-15 dB**; anche senza VCA −84,1 (R SK 86,6k/174k + servo); realistico con fix ingegneristiche −83…−86 A-wtd → **DECISIONE DI FILIPPO PENDENTE (voce 71B)**: deroga / ridisegno gate-drive / ibrido. [SUPERATO IN GIORNATA: 71B CHIUSA → DECISIONE 88 — kill a switch (10 VCA rimossi; chip ~24-26, lotto clone ~40-48), drive tiene 218x con I/V 10k, fix servo/banca, target ≤ −80 dBu A-wtd RATIFICATO (misurato −83,2 θ0 / −79,6 θ50 con `module-noise-v03.cir`); master-out VALIDO PASS 19 dB; EQ β3 reale −89,2 dBu (target canale −92 mancato → 71A); phono EIN 1,79 µV. I claim √INTEG citati sopra nel paragrafo (EQ −110,7, modulo −108,4/−101, celle −121,7, phono 0,36 µV, filter −107,8…−134,8 da rerun) sono invalidati dal quirk INTEG → voce 71A.] **SESSIONE 2026-10-13 — MIC e MONO, ARCHITETTURA v0.1 + DECISIONE 97** (`docs/fase4/mic-mono-moduli.md` + `sim/mic/` + diagramma `mic-mono.svg`; q15/q16 chiuse): **dec. 97 [F]: due moduli SEPARATI; comandi SOLO gain, EQ2, 4 POT SEND (uno per bus, come un live mixer; niente bottoni), 1 LED di metering a tre colori (verde ok / giallo vicino al clip / rosso clip; soglie PROVV −6/+11/+17 dBu); max 4 moduli in qualunque combinazione, PRIMO PROTOTIPO = 1 MIC + 3 MONO; passa-alto 60 Hz sul mic RATIFICATO** (la prima stesura con scheda unica, manopola SEND unica + bottoni, MIC ON e 3 LED è stata bocciata da Filippo: «non prendere decisioni che non ti spettano»). MIC = INA OPA1612 a 30 dB FISSI + stadio 0…+30 dB: EIN −126,5 dBu (150 Ω) costante con la manopola, CMRR 74 dB con sorgente sbilanciata 10 Ω (bias 2×47k: con 2×10k crollava a 60), overload 300 mV rms; uscita modulo −97,3/−90,0/−69,3 dBu A-wtd a 30/38/59 dB (il mic è sempre aperto: sistema dentro −78 fino a ~46 dB di gain). MONO = buffer FET 1 MΩ + pot passivo + make-up +10 dB: −101,3 dBu A-wtd. Mandata = pot passivo −∞…0 dB post-EQ + buffer sempre sul bus (−111,2 dBu A-wtd per modulo a pot chiuso; bus con 4 moduli ~−99,5, target −88 PASS); MIC in multidrop su MSUM6, MONO su MSUM7 (7 contributori invariati); bus FX a 12 contributori (verificato). Nessuna domanda aperta su MIC/MONO. **Diagramma `mic-mono.svg` NON aggiornato dopo le ultime ratifiche (LED tre colori, 4 confermato): Filippo vuole rigenerare i diagrammi solo quando lo chiede lui.** **FINDING SISTEMICO — QUIRK 3 LTspice 26.0.2**: `sim/lib/opamp-audio.inc` con E1 comportamentale NON propagava la en degli op-amp nel `.noise` (test: 5,0 nV invece di 35,3) → libreria CORRETTA (E lineare 4 nodi); stima impatto sui totali esistenti +0,1…+0,4 dB line-level, +0,7…+1,1 5-way, phono e filtro da ricalcolare → **voce 73 docs/02** (campagna 71A da rifare, macro inline da correggere). Lezione `.meas ac`: usare `FIND V(nodo)`, mai `FIND dB(V(nodo))` (stampa il dB del dB). **STESSA SESSIONE, pomeriggio — DESIGN TEORICO COMPLETO: restano solo decisioni di Filippo (lista A/B in testa a `docs/02`)**: (1) **voce 73 CHIUSA**: campagna rumore rifatta con la en degli op-amp (libreria + 17 netlist corretti): canale −90,0, 5-way −83,2 (margine 3,2), filtro (a) −89,9, phono EIN ~2,0 µV, **sistema −80,0 dBu A-wtd PASS 2,0 dB** (`docs/06` §8). (2) **DECISIONE 98 [C]: trasformatore 200 VA** (era 120): il budget audio non contava FX-SEND e cuffie (1,2 A, non 0,9) e il trasformatore era trattato come ideale — a rete −10 % tre avvolgimenti su quattro andavano sotto il minimo dei regolatori; nuovi secondari 2×21 V 2,5 A · 2×18 V 1,0 A · 2×20 V 0,4 A · 9 V 2,0 A; master riverificato (Test 17: +25,1 dBu a rete −10 %, rame pass ≥5 cm²). LEZIONE: con ponte + condensatore la corrente efficace d'avvolgimento è ~1,9× la DC; simulare sempre con EMF a vuoto e R d'avvolgimento. (3) **SHAPER definito** (`docs/fase3/sistema-shaper.md`, `sim/shaper/`): 1 op-amp + 2-3 rami diodo, reroute FX ±0,25 dB da 0 a −15 dB tra 20 e 50 °C, drive ±0,2 dB, position ±1 % ideale / +3,6 % a caldo con E96. (4) **OVERDRIVE FILTRO v0.1** (`filter-module.md` §5bis): cella drive 5-way riusata con pad −6/make-up +6, +8 VCA (mixer ~36-38 chip), canale filtro −83,1 dBu A-wtd, sistema con 4 filtri inseriti −75,3. (5) **FINDING: griglia drive 5-way (dec. 87) etichettata 3 dB bassa** (`SINE` vuole il picco: 0,388/0,775/2,45 erano −9/−3/+7 dBu): a nominale θ100 = 6,9 % THD, non 0,7 % → dec. 87 da RICONFERMARE (five-way §5.3bis); stesso errore in `fx-summing.cir` (margine vero 3,3 V, non 7,2). (6) **Audit infrasub (voce 58)**: il percorso line non aveva nessun blocco della continua → C ingresso 0,72 Hz + servo sul make-up EQ (sheet §6). (7) Inventario comandi per la voce 40: `docs/fase3/sistema-comandi.md` (109 manopole).

**Deroga registrata (2026-09-18)**: Filippo ha autorizzato l'avvio del design di fase 1 SENZA attendere l'export. Si lavora solo su sezioni già giudicate solide dalla review o con architettura bloccata. Stato design: **MASTER OUT v0.3 DEFINITIVA** (bootstrap rail OPA1612 VERIFICATO con Iq reale: capability +25,4…+25,6 dBu PASS, THD PASS a +24 dBu, corto auto-limitato 106 mA, servo DC — decisioni 83→86, Test 7-12; restano solo verifiche a banco), **CANALE CDJ/LINE v0.4** (PHONO MM v0.1 incluso, decisione 79; §3.3 EQ in serie — decisioni 76/77, §7 simulazioni complete) e **FX v0.3-WIP** (+ micro-moduli FX-SEND ×4, dec. 91) in `docs/fase1/`, **MODULO FILTRO v0.2** e **5-WAY v0.3** in `docs/fase2/` (celle v0.2.1 + DRIVE validato: law esatta, griglia §5.3 dec. 87 + GATE KILL π SPDT §8.10 dec. 88/89). Export chiuso (decisione 58): le voci [EXPORT] sono risolte dalla revisione critica o definitivamente aperte. **AGGIORNAMENTO 2026-10-13 (dec. 99-104): il drive 5-way corrente è la v0.4 (five-way §5bis: GROWL + NASTRO, la v0.3 è ARCHIVIATA), l'overdrive filtro corrente è la v0.2 (filter-module §5ter, la v0.1 §5bis è superata), le law del filtro sono quelle della dec. 102, l'EQ di canale è la v0.3 beta-3 + muto a fine corsa (dec. 104). Dove questo file cita «drive v0.3», «griglia dec. 87», «fuzz», «overdrive = cella drive riusata» o «+8 VCA / ~36-38 chip», vale lo storico: il conteggio chip corrente è ~34-36. FINDING pulizia 2026-10-13: i servo DC a 0,31 Hz stavano nelle celle sostituite → buco della continua riaperto su filtro e 5-way (gain-staging-sheet §6), fix provvisorio non simulato.**

## Prossimo passo concreto

**AGGIORNAMENTO 2026-10-13 (in testa alla coda): il design teorico è completo. Tocca a Filippo: lista A (13 decisioni sulla carta) e B (6 a orecchio) in testa a `docs/02-questioni-aperte.md`. Le più urgenti: A1 riconferma griglia drive, A2 law overdrive filtro, A3 voce 72, A4 voce 63, A5 rumore a filtri inseriti. Ingegneria residua, tutta dipendente da quelle scelte o dal banco: lista C dello stesso file. I diagrammi SVG NON sono aggiornati alle modifiche del 2026-10-13 (Filippo li fa rigenerare quando lo chiede).**

**DECISIONE 99 [F] (2026-10-13 pomeriggio) — chiude A1/A2/A3 e la voce 72**: drive 5-way = DUE saturatori con DUE manopole, GROWL (valvola spinta forte, referenza Abzu/SP Audio, solo sub e bassi) e NASTRO (JFET tape); NIENTE fuzz; i saturatori NON alzano il volume (si autoregolano), niente boost pulito; primo 5-10 % di corsa quasi inerte; catena v0.3 ARCHIVIATA come alternativa (non cancellare). Overdrive filtro = circuito DIVERSO dal drive, meno aggressivo dello Sherman, estremi a fine corsa, curva che accelera nel finale: il riuso della cella drive (§5bis) è SUPERATO. **RIDISEGNI SIMULATI lo stesso giorno**: drive 5-way **v0.4** (five-way §5bis, `sim/five-way/drive2-chain*.cir`: saturatori in PARALLELO al pulito, y = x + m·(k·SAT − x), pot doppi diretti, NESSUN VCA; GROWL = LP 350 Hz [F] + clipper a diodi 1/3 asimmetrico, NASTRO = CS JFET con Rs divisa 150 + 900 bypassata; volume ±0,2 dB al nominale su tutta la corsa, NASTRO 5,5 % / GROWL 20 % a fine corsa) e overdrive filtro **v0.2** (filter-module §5ter, `sim/filtro/od2-chain.cir`: tosatore simmetrico 2+2 diodi in parallelo al pulito, 1 VCA per cella sul segnale differenza, tetto ~+5,5 dBu (alzato di 3 dB su richiesta di Filippo: k 1,171; diodi/guadagno diversi NON spostano il tetto, prove O3/O4), law m = θ^2,5; sistema a filtri inseriti MISURATO: −78,5 dBu A-wtd a overdrive chiuso (PASS), −77,8 a metà, −74,8 tutto aperto in silenzio — un tosatore amplifica i segnali piccoli, quindi anche il soffio del core: +7,4 dB a fine corsa). LEZIONE: il CS JFET con Rs tutta in serie taglia a scalino (la gradualità della v0.3 veniva dal VCA). **Griglie CONFERMATE da Filippo (dec. 99 g-h-i: GROWL sotto 350 Hz, tetto +3 dB). Rumore MISURATO (`drive2-noise.cir`, `od2-noise.cir`): drive 5-way −112,3…−103,7 dBu A-wtd pre-makeup (v0.3: −90,1) → modulo 5-way intero MISURATO −85,9 A-wtd (`module-noise-v04.cir`, margine 5,9 dB, indipendente dalle manopole); overdrive ridisegnato a 3 op-amp con polarità diritta (`od2-noise-b.cir`, `od2-pol-b.cir`). DECISIONE 100 [F]: rumore con overdrive aperto accettato come condizione d'uso (chiude A5). Pendenti: ricalcolo totale di sistema a filtri OFF, dispersione JFET, D5.** **DECISIONE 101 [F]: filtro a UN percorso per canale (HPF oppure LPF), chiude la voce 63; 8 core, 8 celle overdrive.** **DECISIONE 104 [F] (revoca la 103 «isolator» presa e ritirata lo stesso giorno): EQ dei canali DJ = in serie v0.3 beta-3 CONFERMATO (dec. 76/77) + MUTO A FINE CORSA (tutte e 4 le manopole a zero → interruttore spegne il canale; in serie un contatto non può spegnere una banda sola); chiude 59/A7, la 68/B4 resta aperta con peso ridotto. Da fare: circuito del muto. NOTA DI METODO: gli EQ Pioneer classici fanno −26 dB per banda con bande larghe sovrapposte, non silenzio; solo il modo ISOLATOR arriva a −∞.** **DECISIONE 102 [F]: law FREQ e RES del filtro = Xone:96 come partenza — FREQ: 20 Hz–20 kHz esponenziale tra 5 % e 95 % di corsa, ultimi 5 % per lato fino a 10 Hz / 35 kHz (sostituisce 14 Hz / 25 kHz); RES: curva Xone sul primo 90 %, auto-oscillazione nell'ultimo 10 % («Xone + fischio in fondo»). Shaper di frequenza CALCOLATO e simulato (`sim/shaper/shaper-filtro-freq.cir`, sistema-shaper §3: esatto dal 10 al 90 %, ginocchi −12…+8 % a 50 °C).** Helper: `sim/fourier_tab.py`, `sim/drive2_tab.py`.

**ALLINEAMENTO 2026-10-13 (decisioni 93-96 e S5, mancanti in questo file)**: **dec. 93** = set unico dei rail sul backplane (raw ±27 / ±22 / ±26[M] / +5 V, W3 2×20 V, LN in due stadi ±16,5 → ±15,0; numeri poi rivisti dalla dec. 98, trasformatore 200 VA); **dec. 94** = (a) I/O tra moduli single-ended 0 dBu, MASTER SUM a 7 contributori, summing nel modulo master (chiude q38), (b) GLOBAL_MUTE anche sui buffer FX-SEND, (c) principio ergonomico etichetta + colore per classe; **dec. 95** = deroga d'uso sul rumore FX-send (target −78 a send non assegnati; con FX in uso −73…−66,6 accettato); **dec. 96** = standard cuffie classe Pioneer DJM (THD 20 kHz 0,105 % su 16 Ω accettata). **S5 CUE è CHIUSO** (`docs/fase3/sistema-cue.md`, ampli cuffia v0.2 chiuso in simulazione il 2026-10-12: THD 0,005 % su 16 Ω a 1 Vrms, rumore −114,5 dBu A-wtd): il design di sistema fase 3 è completo. I diagrammi sono 7 SVG + FX-SEND e CUE, generati da `docs/diagrammi/genera_diagrammi.py` (stato dec. 96: vecchi su 5-way, filtro, mic/mono). **Il blocco «IN CIMA ADESSO: (i) S5 CUE…» più sotto è STORICO: la coda corrente è quella dei todo e della lista C di `docs/02`.**

FATTI (al 2026-09-30 mattina): tutto quanto sopra PIÙ griglia drive CONFERMATA (dec. 87), PHONO sub-100 Hz risolto (Rb2 1M; curva ≤±0,05 dB 100 Hz-20k, −0,24 dB a 30 Hz), MODULE-NOISE v0.2.1 + D6 (finding sistemico quirk INTEG −21,5 dB su tutti i √INTEG del repo; drive −85,7 dBu VCA-dominante; modulo −77,3/−73,0 dBu vs target −90: FAIL → voce 71). FATTI (2026-09-30 pomeriggio/sera): **GATE KILL A SWITCH design CHIUSO** (five-way §8.10 + `sim/five-way/RISULTATI-gate-switch.md`: π SPDT classe ADG1434 Ron 4,7 Ω, off-isolation −95 dB @20 kHz (serie semplice bocciata −22…−52), invertitori unity SUB/MID per la polarità, flatness −0,004…−0,011 dB preservata, click hard-cut 2,18 V al summer = accettato dec. 88, pilotaggio pannello +5 V via 10k, rail ±15 V dedicato → q20); **VOCE 71A CHIUSA → DECISIONE 89** (budget canale DJ −90,3 A-wtd (EQ β3 82% + GAIN VCA 18%), FX send −100,8 PASS 12,8, rerun filtro −90,3…−126 ideale / die reale −84…−76 a fc max, finding Rvn 240k in v03 → corretto dal rerun v031: −83,9 A-wtd θ0, margine 3,9 dB (la stima ~5,5 era sbagliata: quota drive ~22-32% con gli switch); target ratificati: canale −80 SENZA fix, filtro −80 con input q70, FX −88, sistema −78; `docs/06-ritaratura-rumore-71A.md`). **DECISIONE 88 (2026-09-30, ratifica di Filippo dopo benchmark 9 costruttori in `docs/05-benchmark-preamp-scena-2026-09-30.md`)**: kill 5-way a SWITCH analogici hard-cut (10 THAT 218x rimossi dai gate; dec. 80 revocata per il kill, resta per FX/BBM; click accettato = standard di scena), drive mantiene 218x con I/V 10k (−104 dBV), fix servo OPA2134-class + banca op-amp reali; **target rumore 5-way ≤ −80 dBu A-wtd RATIFICATO** (misurato −83,2 θ0 con `module-noise-v03.cir`, margine 3,2 dB). **IN CIMA ADESSO: (i) S5 CUE design (q18: blend CUE↔Master + level dec. 90b, 2 uscite parallele, ampli ~1 Vrms su 32-250 Ω, isolamento; usa i rail definiti da S1) — ultimo workstream del piano fase 3; (ii) verifica datasheet ufficiale ADG1434 Rev. E + ESD (vale per kill, assign FX, micro-moduli FX-send); (iii) housekeeping: allineare voci docs/02 18-22 ai design docs/fase3/ + voce 37 chip ~28-30 (dec. 91) + coda 71A residua (rumore send chain a canali vivi: stima −95 dBu/canale, fx-send-module §6). FATTI 2026-10-01 (design di sistema, piano docs/fase3/00): DECISIONI 90 (metering barre LED a zone + soglie, CUE blend, PSU toroidale), 91 (micro-moduli FX-SEND ×4 + self-feedback 4° pot = matrice 16×218x, bounded confermato in sim, dry loop = K4), 92 (CV resta 6,1 mV/dB + routing curato + test banco; 61 = fallback); S1 PSU v0.1 (120 VA, 4 secondari, protezione 3 strati, sim PASS); S2 grounding (stella 3 piani); S3 backplane (DIN 41612 + classe FX-SEND, net multidrop bus FX); S4 metering (scala assoluta +24 dBu, LM3915×10, detector 0,3 s verificato, soglie ±0,005 dB, purple latch 479 ms). CODA 71A CHIUSA 2026-10-01: ritorno FX −96,4 A-wtd (4× = −90,4, VCA gain 75%), summer DJ bus −107,5 / master+level VCA −96,3 trascurabili (+0,02/+0,06 dB), rerun v031 −82,3/−83,9 A-wtd θ0 (margine 3,9 dB; invertitori +0,02, switch π +0,01); SISTEMA RICALCOLATO −80,5 dBu A-wtd = PASS 2,5 dB su ≤−78 (dec. 89 confermata) — docs/06 §7.** Poi, in ordine: (1) fix ingegneristiche rumore indipendenti dalla decisione (servo silenzioso o Rinj 2,2k→22k + R1s ×10 / C1s ÷10, I/V VCA a 10k, R banca scalate, op-amp reali 1,1 nV nella banca) + **rivalidazione rumore trasversale voce 71A** (master-out −119,2 VALIDO (integrazione manuale già corretta, PASS 19 dB); EQ β3 RICALCOLATA: −89,2 dBu reale, den 190 nV piatta — target canale −92 superato dalla sola EQ → ritaratura di SISTEMA; celle PoC superate dalla campagna v021; filtro da rerun (correzione stimata 2-6 dB, spettro band-limited); mancano budget canale DJ completo e FX bus — mai simulati; metodo §8.9: densità a 10+ punti, mai √INTEG); (2) design di sistema (PSU 20 con rail OTA ±15/16 e protezione corto prolungato master, CUE 18, metering 19 con ballistica dec. 81, grounding 21 incl. GND phono, backplane 22); (3) D5 interazione drive-risonanza + overdrive filtro (dopo q70/61); (4) prototipo millefori filtro con ascolto (a) vs (c-B) (q70); (5) mux modo filtro (dopo 63), reperibilità (pot custom taper, TVS ≤5 pF, dual JFET matched, clone V2181L, MJE340/350 + BF245B-class); (6) banco master-out: modello TI ufficiale, ripple/PSRR, corto sostenuto termico, LED vs 1N4148, trim law, Zobel eventuale; (7) shaper fisico drive/FX ed eventuale trim pair; (8) banco phono: EIN inverse-RIAA, curva, warp reale. APERTO-F residuo: 40 (sessione hardware), 59/63/64/67/68 (ascolti M4L), q70 lato filtro (nuovo input rumore: dec. 89), 53; voce 71 CHIUSA (71B → dec. 88, 71A → dec. 89; coda chiusa 2026-10-01: ritorno FX/summer/v031 fatti, sistema −80,5 A-wtd PASS 2,5 dB).

## Sessione 2026-10-13 sera (seconda): isolator integrato nel canale, rumore di sistema ricalcolato

- Polarità dell'isolator: somma finale resa NON invertente (mix passivo
  a 5 rami + OP1612 a guadagno 10). Zero op-amp in più. Fase a 5 Hz da
  +173° a −6,7°. Il servo DC entra come quinto ramo del mix.
- Lezione: in una somma non invertente il «piedino +» del servo è il
  nodo di mix; il ramo del servo conta nella media (1/5), quindi il
  guadagno dell'op-amp sale da 8 a 10.
- Lezione: scalare i resistori di mix da 5k a 2,49k ripaga il guadagno
  di rumore più alto (EQ −97,3 contro −97,1).
- Canale completo −94,6 dBu A-wtd; sistema a filtri OFF −82,9 (docs/06
  §10). Le righe «filtri inseriti» del §9 usavano il 5-way vecchio.
- Fase in `.meas ac`: confermato `FIND V(out) AT f`, gradi nel secondo
  numero.
