dj-filippo241/maelcum_mixer/docs/00-resoconto-chatgpt-2026-09-17.md

# Resoconto ChatGPT — architettura mixer dub (estratto parziale)

> **Fonte**: conversazione ChatGPT di Filippo, incollata il 2026-09-17.
> **Stato**: PARZIALE — in attesa dell'export completo, che sostituirà/affiancherà questo file.
> **Natura**: materiale grezzo cronologico. Le decisioni qui dentro vanno verificate
> contro l'export completo e consolidate in `SPECIFICA.md`.
> Nota: rimossi dall'originale solo i frammenti di interfaccia web (pubblicità, avvisi di sistema).

---

At this point the system architecture is sufficiently locked. The next phase should not be another long sequence of abstract architecture points; it should become a circuit-engineering / specification phase.

## 1. Open topics

### A. Signal architecture — mostly closed

Only a few details remain:
- Exact internal balanced/unbalanced boundaries
- Final module I/O electrical standards
- Final backplane connector/pinout
- Exact bus nominal/max levels
- Final master/booth/record reference levels

These are mostly downstream of the actual circuit designs.

### B. DJ channel

Still to design:
- Phono input protection
- RIAA topology
- RIAA gain distribution
- Phono loading/capacitance
- Line input stage
- Variable gain circuit
- 4-band EQ topology
- 4-band EQ frequencies
- EQ Q/bandwidth
- EQ kill implementation
- FX send split
- 2-band send EQ
- Filter interface
- Fader/output stage
- CUE pickup point

This is one of the biggest blocks.

### C. Global filter

We have the functional behaviour, but not the actual circuit. Open:
- HPF topology
- LPF topology
- HPF frequency range
- LPF frequency range
- filter slope
- resonance/Q architecture
- resonance maximum
- channel routing implementation
- HPF/LPF shared-control architecture
- overdrive topology
- overdrive gain range
- overdrive headroom
- bypass/OFF architecture
- filter compensation/gain staging

This deserves its own detailed design phase.

### D. 5-way performance EQ

Probably the largest remaining circuit-design problem.

Locked concept: 5 parallel frequency-selective band cells → gain/kill → active sum

Open:
- exact band topology
- five frequency regions
- position implementation
- position ranges
- width implementation
- width range
- relationship between position and width
- +15 dB gain stage
- −∞ band kill
- input drive stage
- nonlinear behaviour
- inter-band interaction
- summing architecture
- stability under extreme settings
- maximum internal signal levels

This should be treated as a custom dub-preamp circuit, not a generic parametric EQ.

### E. FX send system

Open:
- exact send-EQ topology
- send-EQ frequencies
- assignment-switch topology
- switch transient suppression
- FX bus summing topology
- bus headroom
- pedal-output attenuation
- pedal driver topology
- pedal return protection
- return input impedance
- return gain topology
- return EQ
- return rerouting attenuation topology

### F. FX feedback matrix

Architecture is locked, but circuit implementation remains:
- 12 directed paths
- three destinations per return
- attenuation law
- summing topology
- isolation between destinations
- feedback stability
- noise accumulation
- switch/control implementation

This should be designed as a real analogue routing network, not as 12 independent hacks.

### G. Mic channel

Open:
- mic preamp topology
- gain range
- input impedance
- input protection
- 2-band EQ topology
- EQ frequencies
- clip-warning threshold
- FX send interface
- master contribution stage

### H. Generic mono inputs

Open:
- exact number of supported module variants
- input impedance
- gain topology
- 2-band EQ
- EQ frequencies
- FX send
- clip-warning circuit
- mono → stereo conversion

The important point is that this should remain a generic source-module architecture, rather than being designed around any particular instrument.

### I. Master section

Open:
- master summing resistor/gain values
- master bus reference level
- master level amplifier
- +6 dB maximum implementation
- output driver topology
- balanced-output implementation
- Booth gain stage
- Record buffer
- DC protection
- output short protection

### J. CUE/headphones

Open:
- CUE summing
- CUE/master crossfade topology
- headphone amplifier
- output impedance
- headphone protection
- two-output architecture
- power isolation from sensitive audio

### K. Metering

Open:
- exact meter type
- number of LEDs
- peak detector time constants
- DJ meter calibration
- FX-return calibration
- 5-way meter calibration
- master meter calibration
- red-warning thresholds
- meter-driver architecture

### L. Power

Still substantial:
- final rail architecture
- ±24 V implementation
- secondary analogue rails
- control rails
- PSU topology
- transformer/SMPS decision
- regulation
- current budget
- module branch protection
- sequencing
- power-on mute
- power-off mute
- thermal budget

### M. Grounding / EMC

Open at implementation level:
- exact analogue-0V topology
- chassis/0V bonding point
- XLR shield treatment
- RCA shield treatment
- pedal ground strategy
- turntable ground strategy
- EMC filtering
- RF protection
- final chassis grounding

### N. Mechanical/electrical integration

Only electrical questions (front-panel design owned by Filippo):
- module power consumption
- connector pin count
- connector family
- backplane trace/current requirements
- module grounding contacts
- shielding requirements
- service/test access

---

## MASTER LEVEL → MASTER OUT

Final analogue output stage:

```
MASTER SUM
    ↓
MASTER LEVEL
    ↓
MASTER METER
    ↓
BALANCED OUTPUT DRIVER
    ↓
MASTER OUT L/R
```

### MASTER LEVEL

Range: −∞ → 0 dB → +6 dB, with:
- 0 dB = unity
- positive gain only above unity
- full CCW = practical mute
- stereo-linked L/R
- tracking target ≤0.25 dB
- no pan
- no separate L/R level controls

The control should use an active gain stage, rather than a passive potentiometer alone. That gives consistent impedance and excellent tracking at the output.

### Output level targets

At normal operation MASTER SUM ≈ 0 dBu; with MASTER LEVEL at 0: MASTER OUT ≈ 0 dBu.

If pushed:
- +6 dBu → strong
- +10 dBu → very hot
- +18 dBu → extreme
- ≥ +24 dBu → clean analogue capability

The mixer therefore doesn't need to operate near its maximum output level during normal use.

### MASTER METER

The meter is positioned after MASTER LEVEL, so it tells the actual level being sent to the external system. If MASTER LEVEL increases by 3 dB, the meter moves by 3 dB.

Six-zone system: Blue → Green → Yellow → Amber → Red → Purple
- blue = little
- green = safe
- yellow = loud
- amber = hard
- red = extreme
- purple = actual clipping

### Balanced output

Proper active balanced line driver:
- balanced XLR L/R
- low output impedance, ideally <50 Ω
- high common-mode rejection
- ≥+24 dBu clean capability
- short-circuit/current protection
- no output transformer required
- no intentional coloration

The output stage should remain clean even when the internal mixer is being pushed.

### Output protection

At the connector: DC protection, RF filtering, transient protection, controlled power-up/down mute. But no aggressive capacitive filtering that compromises the 8 Hz–35 kHz overall bandwidth.

### Important distinction

The external DSP remains responsible for: system crossover, speaker protection, system EQ, delay/alignment, amplifier management. The mixer simply delivers the clean, high-headroom stereo analogue programme. That keeps the mixer from becoming a second DSP.

---

## BOOTH + REC outputs

Branch from MASTER SUM, different jobs:

```
                    ┌──► MASTER LEVEL → MASTER OUT
MASTER SUM ─────────┼──► BOOTH LEVEL  → BOOTH OUT
                    │
                    └──► FIXED REC    → REC OUT
```

### BOOTH

- Source: MASTER SUM, **before** MASTER LEVEL
- Control: −∞ → 0 dB; 0 dB = unity; full CCW = mute
- stereo-linked, no independent L/R control
- active buffer/gain stage, balanced output
- Changing MASTER level doesn't change booth level (useful for a monitor system)
- Targets: normal ~0 dBu, maximum ~0 dBu, clean capability ≥+24 dBu internally
- No limiter or compressor

### REC

- Source: MASTER SUM, before MASTER LEVEL and before BOOTH LEVEL
- No user level control — records what the mixer produces independently of listening/output levels
- Target: REC OUT ≈ 0 dBu when MASTER SUM is at nominal level
- Stereo L/R, buffered output, low impedance, preferably balanced internally; final connector depends on intended recorder/interface

Consequence: if the internal mixer is run extremely hot, REC can also become hot. Accepted given the project philosophy. The recorder/interface should handle the expected line-level range. No compressor/limiter on REC.

### Isolation

Each output gets its own buffer. Never MASTER → one buffer → split three ways:

```
MASTER SUM
   │
   ├── dedicated MASTER buffer
   ├── dedicated BOOTH buffer
   └── dedicated REC buffer
```

This prevents one output load from affecting another.

Next: FX send/return electrical architecture (most unusual part; feedback, pedal headroom and modular routing interact).

---

## Consolidamento — ripetizioni identificate (da eliminare nella specifica unica)

Consolidation targets, not new design decisions:

1. **Analogue-only / no DSP** — repeated across all sections → one global project constraint.
2. **±24 V / high-headroom philosophy** — → one global gain/headroom specification, exceptions noted locally.
3. **0 dBu nominal / +24 dBu clean target** — → one global reference table.
4. **No compressor/limiter/AGC** — → one global "dynamic behaviour" rule.
5. **Intentional nonlinear stages only** (filter overdrive, 5-way drive) — → stated once globally.
6. **Low-Z buffering between modules** — → one global modular/audio-interface rule.
7. **Stereo architecture** (no pan, linked controls, matched L/R, mono-compatible) — → one stereo-handling specification.
8. **DJ channel signal flow** (input → gain → EQ → CUE/FX split → filter → drive → meter → fader → bus) — keep one authoritative diagram.
9. **DJ EQ** (centres, Q, gain range, contribution-cell concept, tracking, flat-at-zero) — one spec table + one topology explanation.
10. **DJ filter** (global controls, local HPF/OFF/LPF selection, 4-pole SVF, 20 Hz–1.5 kHz HPF, 500 Hz–20 kHz LPF, resonance/self-oscillation, overdrive after filter, common control signals) — one dedicated Filter Module specification.
11. **Filter control distribution** — AUTHORITATIVE VERSION: four shared controls (HPF freq, LPF freq, resonance, overdrive) + local per-channel mode selector only. The old "local channel controls" version is superseded and must be removed, not preserved alongside.
12. **5-way EQ architecture** ("reference + frequency contributions") — one topology section.
13. **5-way KILL architecture** (physical speaker-way territories, complementary filtering, independent KILL/EQ behaviour, "KILL cannot be restored by EQ") — one dedicated KILL specification.
14. **5-way frequency ranges** (creative EQ ranges + physical KILL ranges) — one table, two columns.
15. **5-way drive** (JFET first / asymmetric BJT second, post-EQ, global input drive and headroom) — one drive-stage specification.
16. **FX architecture** (four buses, send routing, return routing, cross-FX feedback) — one complete FX signal-flow diagram + separate send/return specs.
17. **FX reroute behaviour** (pre-fader reroute, fader doesn't kill internal feedback, no self-route, −∞→0 dB) — one FX feedback/routing rules section.
18. **FX headroom/interface** (−20 dB pedal pad, +18 dBu tolerance, ≥1 MΩ return, ≤50–100 Ω send impedance, ≥+24 dBu internal headroom) — one pedal-interface specification.
19. **Master signal flow** (DJ bus → 5-way → master; FX/mic/generic → master) — one authoritative master diagram.
20. **Metering** (colour hierarchy, meter positions) — one global metering section + one table of meter locations.
21. **Power/grounding** (rails, decoupling, analogue/control ground separation, chassis, sequencing) — one power architecture section.
22. **Modular/backplane architecture** (module types, buses, power rails, no internal-node connections, test points, no hot-swap) — one backplane/interface specification.
23. **Component-level discussion** — provisional values superseded/qualified: separate locked functional decisions / provisional engineering targets / open engineering decisions / rejected ideas.
24. **"Next step" statements** — remove from reference document except one actual project roadmap.
25. **Repeated justification** — retain the decision and one concise technical rationale.

Biggest cleanup opportunity: turn the conversation into one authoritative specification, not a chronological record. Preserve the history of corrections, but mark old versions as **superseded** rather than presenting both as active requirements.

---

## Revisione di fattibilità (22 punti) — esito della verifica ChatGPT

Overall: the system is feasible; nothing fundamentally impossible. But the specification should NOT be frozen yet.

| Area | Assessment |
|---|---|
| Overall analogue mixer concept | Feasible |
| 4 DJ channels | Feasible |
| Phono/RIAA | Feasible |
| 4-band DJ EQ | Feasible, topology needs designing |
| Global analogue filter | Feasible, technically challenging |
| Self-oscillating resonance | Feasible |
| Filter overdrive | Feasible |
| 5-way isolator/EQ | Feasible, probably hardest section |
| 4 FX buses + cross-feedback | Feasible |
| Pedal interfaces | Feasible, needs better level strategy |
| Analogue VCAs | Feasible |
| Stereo linked controls | Feasible |
| Modular backplane | Feasible |
| ±24 V architecture | Feasible, needs careful component selection |
| +24 dBu internal headroom | Feasible |
| −90 dBu noise target | Possible, ambitious for complete system |
| 8 Hz–35 kHz bandwidth | Possible, needs disciplined design |
| Complete production unit | Feasible, but not from current specification alone |

### Correzioni importanti ([X] = da correggere prima di congelare la specifica)

1. **±24 V non è alimentazione universale per op-amp.** OPA1612: max ±18 V. ±24 V è il rail di sistema; ogni IC analogico va regolato localmente al suo massimo consentito. Architettura sensata: ±24 V main + rail locali ±15 V. Conseguenza: +24 dBu = 12.28 Vrms = 17.37 Vpeak = 34.7 Vpp → un ampli a ±15 V non ce la fa con margine; ±18 V è marginale; serve stadio d'uscita discreto o ampli HV per il +24 dBu. Diversi domini di tensione per compiti diversi: normale ingegneria.
2. **+24 dBu è un requisito più serio di come suonava.** Conseguenze su: selezione op-amp, stadi d'uscita, tensioni nominali resistori/condensatori, scelta VCA, headroom OTA del filtro, creepage/clearance PCB, distorsione sotto carico, regolazione PSU, condizioni di guasto. THAT 2180: max ±18 V, input overload ~+18 dBV a ±15 V. +24 dBu = requisito di sistema/stadio, NON imposto a ogni IC.
3. **8 Hz–35 kHz va qualificato.** Con filtro OFF il percorso può essere 8–35 kHz; con LPF inserito la banda è volutamente limitata. 8–35 kHz attraverso l'intero mixer (phono, EQ, SVF, VCA, summing, FX, feedback, stadi nonlinear, output) è raggiungibile ma non si può specificare ±0.1 dB su tutta la gamma senza progettare e misurare.
4. **SVF 20 Hz–20 kHz: il range di controllo 1000:1 è un problema ingegneristico vero.** Con C integratore provvisorio 4.7 nF: range gm ≈ 0.59 µS → 0.59 mS. Un pot lineare su un OTA ordinario non dà un controllo bello 20 Hz–20 kHz. Direzione giusta: controllo logaritmico, current scaling, range multipli/gm controllato, OTA/integratori current-controlled. Topologia da progettare attorno al dispositivo reale.
5. **Risonanza del filtro: specifica troppo hand-wavy.** 0–70% normale, 70–90% aggressivo, 90–100% oscillazione, oscillazione che segue il cutoff, max ~+6/+10 dBu, soft limiting: concettualmente ragionevole, ma "soft nonlinear limiting" non è un circuito. Difficile: stabilità su tutto il range, risonanza che approccia unity loop gain in modo prevedibile, oscillazione che parte a posizione prevedibile, ampiezza che non scappa, limiting che non rovina il comportamento, musicalità, niente enorme energia subsonica a 20 Hz, niente problemi parassiti a 20 kHz.
6. **Il 5-way è molto più complesso di come è stato talvolta raccontato.** KILL fisico (5 bande complementari SUB/KICK/MID/HIGH/SUPER HI) + 5 bande EQ creative indipendenti (frequency/width/gain) + drive nonlinear + meter + summing. Combinazione variable freq + variable width + gain/kill + complementary KILL + stereo matching + high headroom + low noise = progettare uno strumento analogico a cinque bande su misura.
7. **Il KILL serve più definizione matematica prima del PCB.** "KILL before EQ" è concettualmente giusto, ma kill non significa energia matematicamente zero nella banda e nulla altrove: è una risposta di filtro complementare progettata perché le cinque bande combinate ricostruiscano approximately flat il programma senza KILL attivi. Le cinque sezioni vanno progettate come filter bank, non come cinque filtri arbitrari indipendenti.
8. **DJ EQ "reference + contribution": il concetto è legittimo, il circuito no (non ancora).** V_out = V_ref + G(V_band) deve essere costruito perché la legge del controllo produca 0 dB, attenuazione, boost, comportamento di fase, interazione tra bande. Il concetto è sound; il circuito NON è stabilito.
9. **FX VCA: parte più solida dell'architettura.** Return → reroute attenuation → injection buffer con VCA audio vero (es. THAT 2180) è ragionevole. Correzione: non assumere che il VCA gestisca automaticamente il livello di sistema +24 dBu; il VCA vuole la sua gestione di livello.
10. **Il pad pedali fisso −20 dB è troppo semplicistico.** Buon valore di prototipo, NON valore di produzione universale. Pedali diversi aspettano livelli radicalmente diversi. Meglio: attenuazione di mandata selezionabile/regolabile con impostazione nominale sensata. Lato ritorno: alta impedenza e alto headroom.
11. **FX feedback: topologia concettualmente sound.** FX1 → FX2 → FX1; il fader del ritorno agisce sul master udibile ma non sul rerouting interno: buona distinzione funzionale. Il punto pericoloso è il loop gain: garantire che il loop possa oscillare ma non danneggiare l'elettronica, niente accumulo DC, niente oscillazione ultrasonica eccessiva, pedale mai oltre i suoi limiti elettrici, rumore che non esplode. Tutto risolvibile, nessuna impossibilità fondamentale.
12. **"No limiter" ok, ma protezione ≠ limiting.** Niente limiter/compressore audio, ma servono: current limiting/protezione d'uscita, protezione corto, ESD/protezione ingressi, protezione DC fault, mute power-on/power-off, eventuale RF protection. La specifica finale deve separare esplicitamente signal-path dynamics da electrical protection.
13. **−90 dBu di rumore per l'intero sistema è ambizioso.** −90 dBu da un singolo stadio line-stage curato ≠ −90 dBu dall'intero mixer (phono, EQ, filtri, VCA, bus summing, loop FX). Problemi probabili: phono preamp, grounding, rumore PSU, ritorni FX, feedthrough controllo VCA, summing amplifier, molte linee di controllo analogiche, contaminazione power digitale/controllo, layout PCB, routing cavi tra moduli. Cambiare la specifica: target di rumore per stadio + calcolo del noise budget completo.
14. **Backplane modulare: serve molta più disciplina sul bus analogico.** Pericolo: backplane gigante con audio dappertutto → crosstalk, impedenza di terra, oscillazioni, pickup EMI, contaminazione feedback FX, bleed control-voltage, rumore clock/controllo (anche senza audio digitale). Il backplane deve distinguere: audio bus, control bus, power, ground/reference, chassis/shield, e tenere fisicamente segregati i segnali più sensibili.
15. **Il sistema di controllo CV analogico è già un sottosistema sostanziale.** Quattro CV condivisi del filtro, controlli EQ, gain, fader, routing FX, controlli VCA, risonanza, overdrive, frequency... Legittimo, ma attenzione a: potenziometro → traccia lunga/backplane → circuito audio sensibile. Le tensioni di controllo vanno bufferizzate e filtrate; il backplane deve impedire che il movimento dei controlli diventi modulazione/rumore udibile.
16. **"0–5 V CV everywhere" NON è ancora finale.** Proposta utile di architettura, non legge universale: un OTA può volere corrente, un VCA ha la sua legge dB/V, la risonanza può servire nonlinear, la frequenza vuole conversione esponenziale, l'overdrive una curva custom. 0–5 V è una convenzione d'interfaccia da usare dove utile, non la tensione nativa di ogni circuito. Il backplane può comunque standardizzarla.
17. **Phono/RIAA: la discussione componenti era troppo semplificata.** Le costanti di tempo 3180 µs / 318 µs / 75 µs sono corrette, ma un preamp RIAA reale non è tre filtri RC indipendenti: serve la funzione di trasferimento composita corretta, con gain, loading, capacità d'ingresso, caratteristiche op-amp, rumore, overload, accuratezza poli/zeri. Classificazione: riferimento concettuale corretto, non circuito finito.
18. **Capacità d'ingresso phono: dipende dalla testina.** 100–300 pF totali è un range di partenza ragionevole, ma la testina vede: cartuccia + cavo RCA + PCB + rete d'ingresso. Per le MM conta molto. Non congelare "100–300 pF" come target universale finché la popolazione di testine previste non è definita.
19. **"Technics ground" ok, ma il grounding va progettato come sistema.** Terminali dedicati per giradischi: semplici. La parte potenzialmente problematica: analogue 0 V, control ground, chassis, PE, masse pedali, masse phono che interagiscono. Serve una strategia di grounding vera; qui la revisione di un ingegnere elettrico sul PCB varrebbe molto.
20. **Meter a colori: nessun problema elettrico.** Blue/green/yellow/amber/red/purple completamente fattibile. Unica correzione: "purple = actual clipping" richiede un vero clip detector sul nodo appropriato, non semplicemente "il LED in cima diventa viola". Facile da implementare.
21. **Master output spec: solida.** Active balanced output, low Z, high headroom, booth separato, rec fisso, buffering indipendente, mute power-up/down, niente compressore/limiter master. Un line driver bilanciato professionale lo fa. L'esatta capacità +24 dBu dipende dallo stadio d'uscita e dalla tensione di alimentazione scelti.
22. **La "categoria di allucinazione" più grande non sono i componenti: è fingere che alcuni circuiti fossero già risolti.** In più punti la discussione è passata velocemente da requisito funzionale a specifica di circuito apparentemente precisa senza derivare il circuito completo: topologia EQ esatta, implementazione SVF, limiting di risonanza, matematica del filter bank 5-way, transfer nonlinear esatto, noise budget, distribuzione potenza completa, impedenze backplane esatte, leggi di controllo VCA esatte. Non necessariamente sbagliati: **ipotesi ingegneristiche presentate con più certezza di quanta meritassero**. È ciò da pulire più aggressivamente.

### Verdetto ingegneristico

[OK] **Fondamentalmente sound**: architettura generale, requisito analogue-only, 4 canali DJ, architettura bus stereo, routing FX, cross-FX feedback, concetto filtro globale, concetto isolator 5-way, costruzione modulare, master/booth/record separati, VCA analogici, filosofia high-headroom, protezioni dedicate, niente audio digitale.

[WARNING] **Fattibile ma serve circuit engineering vero**: DJ EQ, SVF globale, risonanza/auto-oscillazione, overdrive filtro, filter bank 5-way, EQ a larghezza variabile 5-way, implementazione KILL, noise budget, sistema control-voltage, backplane, architettura di potenza, interfaccia pedali, uscite bilanciate.

[X] **Da correggere esplicitamente prima di congelare la specifica**:
- Non trattare ±24 V come alimentazione op-amp universale
- Non assumere che ogni stadio possa consegnare +24 dBu
- Non congelare −20 dB come pad pedali universale
- Non dichiarare −90 dBu per il mixer completo senza noise budget calcolato
- Non trattare i calcoli RC RIAA come un circuito RIAA vero
- Non trattare il sistema 0–5 V CV come intrinseco a ogni circuito analogico
- Non trattare SVF/risonanza come già risolti
- Non trattare il filter bank 5-way come cinque EQ progettati indipendentemente
- Non congelare valori componenti esatti prima di scegliere la topologia
- Non confondere "specifica funzionale" con "specifica elettrica"

Nessuna parte maggiore del concetto va scartata. Il progetto ha raggiunto il punto in cui serve **cambiare metodologia**:

- Finora: functional architecture → plausible circuit concepts → provisional numbers
- Da qui: functional requirement → mathematical transfer function → topology → component selection → simulation → PCB/layout constraints → prototype → measurement → revision

Nota positiva: l'architettura mappa bene su tecnologie analogiche reali — op-amp audio di precisione (OPA1612) e VCA a bassa distorsione (THAT 2180) sono building block reali e disponibili.

**Esito: fattibile. Ma non ancora specificato elettricamente a sufficienza per costruire.**

---

*Ultima riga della conversazione ChatGPT: «ok lets go forward ask me a series of questions i can help you clarify if there are any prior to create the summary» — il lavoro di consolidamento in specifica unica non era ancora iniziato quando l'export è stato interrotto.*
