dj-filippo241/maelcum_mixer/docs/fase3/sistema-cue.md

# Sistema CUE / cuffie — S5 (voce q18)

**v0.2 — 2026-10-12** (v0.1 2026-10-02; v0.2 = ampli cuffia ridisegnato, §5). Ultimo workstream del piano fase 3
(`00-piano-sistema.md`). Chiude il design di sistema: dopo questo doc il
design elettrico del mixer è COMPLETO e si può proporre la ripresa del
prototipo M4L (dec. 78). Simulazioni: `sim/system/cue-*.cir`, risultati
in `sim/system/RISULTATI-cue.md`. Requisiti: SPECIFICA §10 [BLOCCATO],
decisioni 90(b), 93, 94(b); interfacce backplane: `sistema-backplane.md`
v0.2 §3-§5.

## 1. Requisiti e vincoli ereditati (non ridiscussi)

- CUE solo sui 4 canali DJ, punto locked post-EQ / pre-filter / pre-fader
  (cdj §3.4: buffer dedicato → switch di canale → CUE bus). Più cue
  attivi sommati; niente cue su FX/mic/generic; niente meter cuffia.
- Blend CUE↔Master: CCW = cue, centro = 50/50, CW = master; stesso mix su
  entrambe le uscite; level condiviso; 2 uscite cuffia in parallelo;
  split cue NON incluso (voce 40).
- Ampli cuffia dedicato high-current, ~1 Vrms su 32-250 Ω, alimentazione
  e ground isolati (regolazione LOCALE nel modulo, come tutti i moduli).
- Rumore di sistema ≤ −78 dBu A-wtd (dec. 89) da non erodere: il percorso
  cue non alimenta il master (isolato by construction); target proprio
  del percorso cuffia ≤ −90 dBu A-wtd al jack.
- Standard elettrico I/O: single-ended 0 dBu tra moduli (dec. 94a);
  ricevitore cue sum = iniezione 10k su massa virtuale, ricevitore MON =
  buffer ≥ 100k (S3 §4); driver di modulo ≤ 50 Ω.
- GLOBAL_MUTE (linea c9): **il CUE NON lo ascolta** (scelta di Filippo
  2026-10-02, chiude la materia aperta da dec. 94b): la cuffia resta viva
  durante power-on/off e guasti rail del master. La protezione dai
  transienti PROPRI del modulo cue è locale (§6).

## 2. Diagramma a blocchi del modulo

```
(dal backplane, slot CUE: 4× cue in L/R + MON in L/R + riga a/c)
  CUE1-4 L/R ──► [A] CUE SUMMING L/R (massa virtuale, Rf 10k, −1)
                        │
  MON in L/R ──► [B] MON BUFFER L/R (follower direct, +1)
                        │
            [C] BLEND CUE↔MASTER (pot doppio 10k lin, centro = 50/50)
                        │
            [D] LEVEL (pot doppio 10k log, CCW = silenzio)
                        │
            [E] AMPLI CUFFIA L/R (OP1612 + diamond, gain +1, ±18 locali)
                        │
            [F] USCITE: Rser 10 Ω ×4 → relay DPDT ×2 → 2 jack stereo
                        │
  raw ±22 → ±16,5 → LT3045/94 → ±15,0 LN  ([A][B][C][D] + riferimenti)
  raw ±27 → LM317/337 → ±18 audio locali  ([E])
  +5 V → [G] CONTROLLO LOCALE (timer + supervisore ±22 → relay [F])
```

Ogni blocco stereo con sezioni separate L/R; nessun buffer condiviso tra
destinazioni (regola della casa, master-out §2).

## 3. [A] CUE SUMMING

Summer invertente a massa virtuale: 4 ingressi × 10k (resistenze di
iniezione lato sorgente, nel modulo CDJ, convenzione multidrop S3 §4) +
Rf 10k → guadagno −1 per cue attivo, nominale 0 dBu ciascuno. Somma di 4
cue a nominale = +12 dBu (3,1 V): dentro i ±15 V LN (capability ~+20 dBu,
sheet §1); picchi oltre = disciplina operatore, come il summing master.
L'ingresso a massa virtuale isola i contributori: uno switch aperto
(lato CDJ, π SPDT classe ADG1434, off-isolation −95 dB @20 kHz) rimuove
il canale dal net senza interagire con gli altri. OP1612 dual (1 chip
L/R), rail ±15 LN. Polarità: −1 (vedi §7).

## 4. [B] MON BUFFER — presa dal master (DECISIONE di Filippo 2026-10-02)

Tap nel modulo master: **post-summing [A2], pre-master-level [D]** —
stesso nodo di programma di REC e BOOTH, buffer dedicato nuovo **[N]**
(adderendum in `master-out.md`). Comportamento stile DJM-900NXS2
(verificato sui manuali: il master cue Pioneer è pre master level; lo
Xone:92 invece monitora il bus LR MIX post-master): il blend non segue
la manopola master, che nel dub è un gesto performativo; il programma
vero si ascolta dal booth. Conseguenza accettata: master a zero ≠
silenzio in cuffia sul lato master del blend.

Buffer [N] nel master: OP1612 unity NON invertente, uscita ≤ 50 Ω verso
lo slot 8 del backplane. Nel modulo cue il ricevitore MON è un **follower
direct** (senza resistenza serie): una 100k in serie inietterebbe
40,7 nV/√Hz; il requisito S3 «≥ 100k sul net» è soddisfatto
dall'impedenza d'ingresso del follower (correnti di bias in pA), e il
ritorno DC è garantito dal driver d'uscita [N] del master. Polarità: +1
(vedi §7). Rail ±15 LN.

## 5. [C][D][E][F] Blend, level, ampli cuffia, uscite

**Blend [C]**: pot doppio gang 10k LINEARE, estremi pilotati da sorgenti
a bassa Z (uscite di [A] e [B]): law lineare in tensione ESATTA
(RISULTATI-cue Test 2). Isolamento agli estremi CHIUSO ANALITICO
2026-10-02 (banco = conferma): Zo closed-loop OP1612 a 20 kHz =
Zo_ol/(1+T) ≈ 60 Ω/4000 ≈ 15 mΩ (Zo_ol ≈ 60 Ω assunto per la famiglia
bipolare TI, T = GBW/f = 4000) → leak = 15 mΩ/10 k = **−116 dB**; il
−138 dB della sim (macro Zo = 0) è il limite inferiore. Centro =
50/50 con −6 dB per parte [BLOCCATO confermato in sim]; detent centrale
sul pot = hardware, voce 40. A centro, carico visto da ciascuna sorgente ≈ 10k:
trascurabile per OP1612.

> **REV 2026-11-11 (todo 294, `pcb/cue/NOTE.md` punto 2).** Il Test 2 non
> aveva il LEVEL sul cursore del BLEND. Il LEVEL da 10k carica il cursore
> (sorgente fino a 2,5 kΩ al centro): peso 1/(1 + X(1−X)), al centro −8 dB
> per parte invece di −6. Rimedio [C, PROVVISORIO]: inseguitore OPA1612 [C2]
> fra cursore del BLEND e capo orario del LEVEL, su ±15 LN. La law torna
> esatta. OPA1612 nel modulo: 5 (anche l'ampli cuffia
> passa a un chip per lato, per il piazzamento: `pcb/cue/NOTE.md` punto 10).

**Level [D]**: pot doppio gang 10k LOGARITMICO, CCW = wiper a massa =
silenzio vero (−∞). Wiper → ingresso non invertente di [E]; ritorno DC
del bias (2 pA) attraverso la pista: nessun pop.

**Ampli cuffia [E] — v0.2 (2026-10-12, CHIUSO in sim)**: gain **+1**
(chiuso per calcolo 02/10; banco = sanity). Topologia: OP1612 con
feedback DC Rf 470 Ω preso su OUTA (pre-Rserie) e compensazione Cf
330 pF uscita→ingresso invertente (crossover dell'anello esterno
~1 MHz); **Rdrv 1 kΩ** tra op-amp e rete di bias (isola l'op-amp e fissa
la corrente che i limitatori devono vincere); **Vbe-multiplier vero tra
le due basi** (Ra 1 k + trimmer 500 Ω, Rb 1 k, nominale 210 Ω = idle
20 mA) con bypass 1 µF, pilotato da CCS JFET Idss ~8 mA sopra e sotto;
base stopper 22 Ω; finali class-AB MJE340/350 con **Re 6,8 Ω** (uno per
ramo: stabilità termica E senso corrente); limitatori Vbe sui Re con
100 Ω in base. Numeri (RISULTATI-cue Test 1 e 5-8): THD @1 Vrms
0,005 % su 16 Ω / 0,0008 % su 32 Ω / 0,0002 % su 250 Ω; clamp
126-142 mA sui carichi reali, 168 mA in corto franco; idle 20,0 mA
fermo entro ±0,03 mA tra 27 e 75 °C; nessun picco ad anello chiuso
(−3 dB a 0,94-3,8 MHz sui carichi reali); quadra pulita fino a 2 nF al
jack (22 nF: 13-17 % di sovraelongazione, smorzata in 1,6 µs).
Livello massimo: clip di corrente a ~4,0 Vp su 32 Ω = 2,85 Vrms =
254 mW = +24,0 dBm (su 250 Ω resta il limite di sorgente 5,45 Vrms =
+20,7 dBm; lo stadio regge 8,65 Vp puliti): con cuffia poco sensibile
(84 dB SPL/mW) sono 108/105 dB SPL, abbondanti per la scena. A 20 kHz
la THD sale a 0,015 % su 32 Ω e 0,105 % su 16 Ω (guadagno d'anello
~50): accettato da Filippo (dec. 96: standard classe cuffie DJM,
nessun requisito audiofilo), armoniche fuori banda. Dissipazione finali: 0,35 W a
riposo, 0,65-0,93 W medi in limitazione con programma, ~3,0 W in corto
DC sostenuto → TO-126 su rame ≥ 4 cm², abuso prolungato = dominio
termico come master-out v0.3. **Vincolo di layout**: nessuna capacità
su OUTA prima della Rserie (1 nF = 24 % di sovraelongazione). Rail
**±18 V audio locali** (LM317/337 dal raw ±27 + bulk 1000 µF/100 nF):
lo stadio di potenza cuffia NON sta sul rail LN; i blocchi di segnale
[A]-[D] restano su ±15,0 LN. «Alimentazione isolata» [BLOCCATO SPEC
§10] = regolazione locale dedicata, soddisfatta. Storia: la v0.1
(op-amp sul nodo base del multiplier, nessuna compensazione) oscillava
a burst RF ai passaggi per lo zero — il «THD 5-13 %» del 02/10 sera
era quell'oscillazione, non crossover (RISULTATI-cue Test 1 REV 2).

**Uscite [F]**: per canale, l'uscita ampli si sdoppia su 2 jack stereo
con Rserie 10 Ω 2 W per ramo-jack (8 resistenze nel modulo): la Rserie
isola i due jack (un carico non modula l'altro), garantisce stabilità su
carico capacitivo (feedback pre-Rserie) e limita il corto insieme al
limitatore. Zout al jack = 10 Ω: damping factor 3,2 su 32 Ω — colore
della cuffia legato alla sua curva d'impedenza, accettato e documentato
(standard degli ampli cuffia con protezione serie); su 250 Ω l'effetto
è −0,34 dB. Level/max: 0,762 Vrms su 32 Ω con sorgente a nominale =
requisito «~1 Vrms» raggiunto con level ~90 % [PROVV: gain +2 dB se a
banco risulta corto]. Relay DPDT ×2 (uno per jack, contatti L+R) tra
Rserie e connettore, comandati da [G]; normalmente diseccitati = cuffia
muta = stato sicuro.

## 6. [G] Protezione locale (il CUE non ascolta c9)

Scelta di Filippo: durante GLOBAL_MUTE la cuffia RESTA viva (il mute
globale scatta solo a power-on/off e su guasto rail del master; tenere
la cuffia indipendente permette di continuare a cueare durante un
guasto master). Restano da togliere i transienti PROPRI del modulo cue:

- Power-on: supervisore a finestre sui raw locali (±22 < 17 V e ±27 < 20 V,
  stesso stile S1 §4/master §3.7) + timer RC 1,5-2 s → relay [F] si
  eccitano solo a rail stabili: il bang d'accensione non arriva mai ai
  jack.
- Power-off: hold-up sui bulk locali (~50-100 ms) + comparatore: al calo
  dei raw i relay aprono in < 10 ms, il pop di spegnimento resta dentro.
- Guasto rail cue: stessa finestra → relay aperti: cuffia muta (il suo
  amplificatore non ha più rail puliti), master indipendente.

Tutto analogico, niente MCU (coerenza col progetto). Consumo +5 V: 2
relay DPDT eccitati in normale esercizio ≈ 56 mA + controller ~2 mA
(budget +5 V dec. 93: worst 1,0 A → 1,06 A, dentro il dimensionamento
1,25 A). **Spec relay per classe** (parte concreta alla reperibilità
post-M4L, congelata): bobina 5 V, DPDT, contatti ≥ 2 A, bobina ≤ 30 mA,
contatti dorati; famiglia esempi Omron G6K-2 / Panasonic TQ2 / Fujitsu
JS2. **Click relay CHIUSO ANALITICO**: a power-on i relay chiudono a
timer scaduto con ampli stabile — alla chiusura il solo gradino è l'offset
DC (Vos × gain ≈ 1 mV in cuffia = 31 µW su 32 Ω: inudibile); a power-off
aprono in <10 ms con programma forse presente: bounce sotto segnale =
tick udibile allo spegnimento, stesso carattere di master-out §3.7
(pattern casa accettato); se a banco desse fastidio: sequenza locale
«muta il blend 10 ms prima dei relay» (una cella RC in più sul
controller).

> **Simulato 2026-11-12 (todo 298, RISULTATI-cue Test 9).** Soglie, timer (1,42-1,95 s con
> CT da −20 % a +10 %) e apertura dei relè in 4,1 ms dal guasto di un raw. Allo spegnimento la
> cuffia muta coi ±18 dell'ampli ancora pieni. CT in distinta: X7R 50 V.

## 7. Polarità e fase tra i due percorsi del blend

Polarità relativa VERIFICATA in sim (RISULTATI-cue Test 3): cue summer
−1 e MON buffer +1 (con [A2] del master che inverte a monte) fanno
SOMMARE le due componenti al centro del blend quando lo stesso programma
è presente su entrambi i lati (0 dB, nessuna cancellazione); un anello
invertito per errore cancellerebbe a −104 dB.

> **REV 2026-11-03 (todo 227, `sistema-polarita.md` F4) — conto sbagliato.**
> Il Test 3 supponeva che a [A2] arrivasse il canale diritto. Il canale
> passa prima dal ricevitore del DJ bus (massa virtuale, −1): a [A2] arriva
> rovesciato e MON esce +S. Con cue summer −1 il centro del blend
> CANCELLA. Rimedio [PROVVISORIO]: buffer MON del modulo CUE invertente
> (20k/20k 0,1 %, carico per il driver [N] ≤ 50 Ω): MON torna −S dopo il
> buffer e la riga «design» del Test 3 torna valida.

Fase: l'idea allpass phase-matching (handoff 02/10, identità A2 di
five-way §8.2) è valutata e CHIUSA NEGATIVA: il percorso master
attraversa la banca 5-way (prodotto di 4 allpass A2: ritardi di gruppo
~64 µs a 3,5 kHz fino a ~2,5 ms a 90 Hz), il percorso cue no.
Compensare significherebbe replicare 4 sezioni A2 × 2 op-amp × 2 canali =
16 op-amp nel modulo cue per il solo caso «cue di un canale già in
programma al centro del blend» — costo sproporzionato a un caso d'uso
marginale (il cue serve per materiale NON in programma; al centro si
staziona poco). Resta documentato: al centro, cue di un canale vivo =
comb filtering udibile sulle bande dove il ritardo 5-way dà sfasamento
180°; comportamento inherente ai crossfade cue/master di tutti i mixer
(confronto DJM/Xone: stesso carattere).

## 8. Rail, correnti, backplane

| Rail locale | Da | Per | Corrente (idle / picco) |
|---|---|---|---|
| ±15,0 LN | pre-reg ±16,5 + LT3045/94 dal raw ±22 | [A][B][C][D], riferimenti | ~23 / 25 mA |
| ±18 audio | LM317/337 dal raw ±27 + bulk locale | [E] | ~61 mA a riposo (2 canali × (20 idle + 10,6 CCS)) / ≤ ~340 mA col clamp su entrambi i canali (REV v0.2 2026-10-12: clamp verificato 126-168 mA per canale) |
| +5 V | bus backplane (regolato in PSU, dec. 93) | [G] relay + controller | ~58 / 60 mA |

La riga correnti CUE di `sistema-backplane.md` §6 ([PROVV fino a S5]:
±50/±110 su ±27, ±30/±90 su ±22) è REVISIONATA con questi numeri
(§6 REV in quel doc). Pinout slot CUE invariato (S3 §3: 4 cue in + MON in
slot 5 + riga a/c comuni); il modulo cue ascolta c9? NO (dec. Filippo):
la riga c9 resta connessa ma inascoltata per scelta — segnato sul doc
backplane §5 per chi legge.

## 9. Rumore e crosstalk

- Rumore al jack (level max, blend centro, 1 cue attivo, ampli v0.2):
  8,76 nV/√Hz piatto → **−114,5 dBu A-wtd** vs target −90: PASS 24,5 dB;
  in cuffia 32 Ω/100 dB/mW ≈ −2 dB SPL (RISULTATI-cue Test 4 rerun).
- Crosstalk cue→cue: massa virtuale + switch aperti lato CDJ (−95 dB
  @20 kHz classe ADG1434): by construction.
- Crosstalk MON→cue agli estremi del blend: −116 dB stimati (Test 2).
- L→R: ampli separati; jack→jack: stesso segnale by design (uscite
  parallele [BLOCCATO]), interazione solo via Rserie in corto franco
  (accettato: guasto, non uso).

## 10. BOM di massima [molto PROVVISORIA — regola 3]

3× OPA1612 (summer L/R, MON L/R, ampli L/R) · 2× MJE340 + 2× MJE350 (finali, v0.2) · 2× NPN piccolo segnale
(multiplier) + 2× NPN + 2× PNP (limitatori) ·
4× JFET CRD Idss ~8 mA (o LM334 trimmati) · 2× LT3045 + 2× LT3094 ·
2× LM317 + 2× LM337 · 2× relay DPDT 5 V · pot doppio 10k lin con detent
centrale ×1 + pot doppio 10k log ×1 (voce 40) · 8× R 10 Ω 2 W · 4× R 6,8 Ω
· 2× jack stereo (voce 40) · trimmer multiplier 500 Ω ×2 · per canale
Rf 470 Ω, Cf 330 pF, Rdrv 1 k, Cb 1 µF film, 2× 22 Ω, 2× 100 Ω ·
bulk/bypass locali.
Nel modulo master: +1 OPA1612 per il buffer [N] MON.

## 11. Simulazioni eseguite (2026-10-02, ampli v0.2 il 2026-10-12)

`sim/system/cue-hp-load.cir` (Test 1: carichi 16/25,8/32/250/corto ×
1 Vrms/12 Vp: THD, clamp, potenza) · `cue-blend.cir` (Test 2: law e
isolamento, due toni) · `cue-blend-pol.cir` (Test 3: polarità al centro)
· `cue-chain-noise.cir` (Test 4: rumore, densità a 12 punti) ·
`cue-hp-idle.cir` (Test 5: idle × trimmer × temperatura) ·
`cue-hp-step.cir` (Test 6: quadra e carico capacitivo) · `cue-hp-ac.cir`
(Test 7: risposta ad anello chiuso per punto di lavoro) ·
`cue-hp-20k.cir` (Test 8: THD a 20 kHz). Risultati e lezioni di metodo
in `sim/system/RISULTATI-cue.md`.

## 12. Aperti (non bloccano il design)

- Rete bias+limitatori: **CHIUSA in sim con la v0.2 (2026-10-12)**.
  Restano a banco: set del trimmer a 20 mA sul hardware reale,
  stabilità col chip OPA1612 vero (la macro è a polo singolo senza
  limite di corrente: i Test 6-7 vanno ripetuti con oscilloscopio),
  tracking termico reale multiplier↔finali.
- Budget rail: lo stadio v0.2 assorbe ~61 mA a riposo su ±27 (la stima
  S5 v0.1 era ~15): verificare il margine del secondario W1 in
  `sistema-psu.md` (non ricalcolato in questa sessione).
- A-weight della campagna rumore: possibile pessimismo ~3 dB della
  tabella della casa (RISULTATI-cue Test 4, nota di metodo).
- Relay: parte concreta dentro la spec per classe qui sopra, alla
  reperibilità post-M4L (congelata).
- Jack/posizione/detent/level range: sessione hardware (voce 40, Filippo).
- Conferme a banco residue (sanity, non decisioni): gain +1 con cuffie
  reali, isolamento blend a 20 kHz col chip reale (stima −116 dB),
  eventuale tick di power-off.
