dj-filippo241/maelcum_mixer/docs/fase3/sistema-backplane.md

# Sistema backplane (questione 22 + parte 38) — v0.2 [PROVVISORIO — regola 3; potenza REV dec. 93]

Data: 2026-10-01 (workstream S3, piano `00-piano-sistema.md`, dec. 90;
v0.2 stessa data: TASK 0 riconciliazione rail, dec. 93).
Vincoli [BLOCCATI] da SPECIFICA §3 [REV decisione 93]: bus potenza sul
backplane = **raw ±27 V audio, raw ±22 V LN/OTA, raw ±26 V [M] HV (solo
master), +5 V control (regolato nella PSU), analogue 0 V, control ground,
chassis/shield** (il «±24 V unico» del consolidamento 2026-09-18 è
SUPERATO: attuazione dec. 90(c) — secondari dedicati + regolazione
locale); i rail ±18 V audio e ±15 V LN si generano LOCALMENTE in ogni
modulo, ciascuno dal suo raw (dec. 45 + miglioria §3 + dec. 93);
separazione fisica audio/controllo/potenza/ground; connettori robusti
card-edge/board-to-board con keying; nessun bus floating; no hot-swap;
test point per modulo; CV 0-5 V = convenzione d'interfaccia. Masse:
topologia in `sistema-grounding.md` (stella unica alla PSU; qui viaggiano
i ritorni dedicati).

## REV 2026-11-11 — backplane a tratti per la disposizione F (todo 269) [C, PROVVISORIO]

Con la disposizione F (dec. 172) le schede stanno in due versi: un backplane unico
(§10, «~15 slot in linea») non serve più. Quattro tratti, uno per zona del fondo:
T1 fondo (MASTER segnale e uscite, 5-WAY 1-2, PSU-IN), T2 canali (FILTRO 1-2, 4 canali,
4 FX-SEND), T3 cuffie (CUE), T4 destra (MIC, 3 MONO, 4 FX-RET). 25 slot. Fra i tratti:
6 cavi piatti di segnale, ognuno solo VE o solo linee pilotate, ogni filo di segnale fra
due masse; 3 cavi di potenza Mini-Fit Jr dal T1 (stella nel PSU-IN) agli altri tratti.
Le reti di ogni slot vengono dal netlist vero della scheda (5-way e filtro: righe b di §4).
Piano, reti e cavi: `pcb/backplane/PIANO.md` (da `piano_f.py`); schede e scelte NOTA:
`pcb/backplane/NOTE.md`. Supera §10 «un backplane unico» e la lunghezza ≤ 70-80 cm.

## REV 2026-10-22 — decisione 130: quattro moduli FX-RET [PROVVISORIO]

La classe FX (un modulo, 1 slot) diventa **FX-RET ×4**: un modulo per bus,
4 slot. I 4 moduli sono identici e intercambiabili; il numero del bus lo
decide la posizione sul backplane. Riga b della classe FX-RET:

| Slot | Segnale | Note |
|---|---|---|
| 1 | BUS_IN L/R | dal net Sn del proprio bus (n = posizione) sul virtual-earth locale, Rf 10k |
| 2-5 | S1_OUT…S4_OUT L/R | reroute verso i 4 net, incluso il proprio (SELF); STESSE posizioni di FX-SEND e MIC/MONO |
| 6 | RET_OUT L/R | verso MSUM(n+1) del master (FX-RET 1 → MSUM2 … FX-RET 4 → MSUM5) |
| 7-10 | spare | |

Righe a e c: mappa comune. Codifica meccanica: una sola per i 4 FX-RET
(non per posizione), così un ritorno si sostituisce con un altro.
Connettori sul backplane: ~21 → **~24**. Le colonne «FX» della tabella
§4 e la riga «FX» delle tabelle §2 e §6 sono SUPERATE da questa REV.
Correnti: ogni FX-RET ≈ un quarto del modulo FX di `sistema-psu.md` (REV
2026-10-21) più ~16 mA per ramo per le 8 sezioni d'iniezione dei reroute
(`fx-module.md` §2bis) [STIMA: +~64 mA sul W1 in tutto, da sommare nel
todo 128].

## REV 2026-10-14 — decisione 113: alimentatore esterno [PROVVISORIO]

La riga a conserva la mappa (§3) ma cambiano i valori: i pin «±27 V raw
AUDIO» portano **±22,0 V pre-regolati** dal box; i pin «±22 V raw LN»
portano **±19 V pre-regolati**; [M] resta raw (±27 nominali); +5 V
invariato. Lo slot PSU diventa **PSU-IN**: riceve il cavo dal box,
ospita la stella, i fusibili di ramo e il controllo delle ventole
(dec. 112). Dettagli in `sistema-psu-esterno.md` (todo 51): il PSU-IN
mette TVS, Schottky inverso, fusibile di gruppo e bulk locale su ogni rail;
il backplane porta una **PTC per slot e per rail** (sostituisce i fusibili
5×20 per modulo).

## REV 2026-10-14 — decisione 111: predisposizioni per i moduli opzionali [PROVVISORIO]

Moduli che il backplane deve accogliere senza grosse modifiche (dec. 111 b):
crossfader, EQ grafico, uscite per via, sirena. Principio: **nessun
commutatore nel percorso audio a modulo assente**. Dove un modulo si
inserisce nel segnale, il backplane porta un **ponticello di continuità**
(link a innesto, una coppia L/R per punto) che si toglie quando il modulo
c'è. Senza modulo il segnale passa sul rame, come oggi.

1. **[SUPERATO dalla dec. 161 (2026-10-31): niente crossfader, nemmeno opzionale] ** Tutto il punto 1 è storia. **[REV 2026-10-31, dec. 160: crossfader solo in CV, sul VCA del fader; l'anello audio sparisce] ** Il crossfader agisce sulla CV dei 2 VCA del fader: il canale somma alla CV
   del fader la CV XF_X o XF_Y (levetta X/OFF/Y sul canale). Il modulo UTIL-XF manda solo le due
   CV su c10-c11. Slot 6-7 del canale e ponticelli JXF non servono più: il testo sotto è storia.
   **Crossfader — anello audio post-fader.** Il crossfader deve agire
   solo sul contributo al DJ bus: CUE, mandate FX e filtro restano
   pre-fader (SPECIFICA §4). Il VCA di gain del canale sta all'inizio della
   catena e non va usato (scartato: abbasserebbe anche cuffia e mandate).
   Nel canale CDJ, dopo [H] fader: **XF_SEND out (slot 6)** con driver
   dedicato ≤ 50 Ω → **XF_RET in (slot 7)** su buffer ≥ 100 k → [I] driver
   del DJ bus. Sul backplane: **ponticello JXF per canale** (4 coppie L/R)
   tra slot 6 e 7. Modulo assente = ponticello = segnale invariato. Il
   modulo crossfader (UTIL-XF) contiene 8 VCA (2 per canale) e la logica
   d'assegnazione. Costo nel canale, sempre presente: 1 driver + 1 buffer
   stereo (~4 sezioni op-amp, rumore ~−112 dBu, trascurabile).
2. **EQ grafico — due punti d'inserzione.**
   - Dopo il 5-way: il net 5-WAY slot 2 (MSUM out) → MASTER slot 1 (MSUM1
     in) passa da un **ponticello J5W** (L/R). Il modulo grafico, se c'è,
     riceve il 5-way e rimanda su MSUM1.
   - Sul master: il modulo MASTER espone **INS_SEND (slot 9) e INS_RET
     (slot 10)** dopo il sommatore e il tasto MONO, prima dei quattro
     buffer (master-out REV dec. 111). Ponticello **JMS** tra i due slot
     sul backplane. Così il grafico agisce su master, booth, rec e cuffia
     MON, come sull'impianto.
3. **Uscite per via — presa dopo il MASTER LEVEL.** Il modulo MASTER
   porta **VIE_TAP** (post-level, post-MONO, 0 dBu nominale, driver
   dedicato ≤ 50 Ω) su **b31-b32** (L/R; AGND da b30). Il modulo vie ha le
   sue uscite su pannello posteriore, non sul backplane, e ascolta
   GLOBAL_MUTE (c9).
4. **Sirena**: slot MIC/MONO esistente, nessuna modifica.

**Slot nuovi.** I 2 slot UTILITY diventano 3 slot dedicati + 1 spare:

| Classe | Riga b | Riga c |
|---|---|---|
| ~~UTIL-XF (crossfader)~~ tolto dalla dec. 161 | — | — |
| UTIL-GEQ (EQ grafico) | slot 1 = 5W_IN (dal 5-way), slot 2 = 5W_OUT (verso MSUM1), slot 3 = MS_IN (da INS_SEND), slot 4 = MS_OUT (verso INS_RET) | GLOBAL_MUTE |
| UTIL-VIE (uscite per via) | slot 1 = VIE_TAP in (da b31-b32 del master) | GLOBAL_MUTE |
| UTILITY | spare | spare |

Connettori sul backplane: ~19 → **~21**. Correnti dei moduli opzionali:
`sistema-psu.md` REV dec. 111 (ramo audio 1,4 → ~1,7 A, W1 3,5 A).

## 1. Famiglia connettori — scelta

| Candidato | Pro | Contro | Esito |
|---|---|---|---|
| **DIN 41612 tipo C (3×32 = 96 pos, passo 2,54 mm)** | 3 file FISICHE separate = la separazione potenza/audio/controllo [BLOCCATA] viene gratis (riga a/b/c); 2,2-3 A/pin; keying/codifica meccanica nativa; storico pro-audio/broadcast; ancora prodotto (TE/HARTING/ept + clone economici); versione angolo retto per moduli verticali | costo medio (~4-8 €/coppia); serve PCB o telaio forato | **SCELTA [PROVVISORIO — q29 meccanica]** |
| Card-edge 2×50 (gold fingers) | economico, meccanica semplice | solo 2 file (separazione per posizione, non fisica); usura delle dita a inserzioni ripetute; keying solo per intaglio; corrente/pin ~1 A | fallback se il budget meccanico (q29) lo impone |
| D-sub HD 44 | reperibile, robusto | non è un backplane (point-to-point per modulo); densità bassa per 40+ segnali | scartato |
| Molex Mini-Fit Jr | 9 A/pin, keying per housing | densità bassa sui segnali, ingombro; soluzione ibrida = due famiglie da gestire | scartato (ibrido possibile solo per la PSU) |

Corrente per pin: 2,2 A nominale IEC 60603-2 (derating ~30% con pin
adiacenti carichi) → i 2 pin per rail raw del §3 (REV dec. 93) danno
capacità ≥3 A contro un assorbimento max per raw di 1,1 A (§6):
margine ≥2,7× (≥4× sul tipico 0,9 A).

## 2. Classi di modulo e connettori

| Classe | Qtà moduli | Connettori | Note |
|---|---|---|---|
| CDJ CH1-4 | 4 | 1×C96 | out DJ bus, cue, send tap (→FX-SEND, dec. 91), out bus HPF e bus LPF + mode bit (dec. 159) |
| FX-SEND | 4 | 1×C96 | micro-modulo send (dec. 91a): EQ2+level+assign di UN canale; bottoni via harness dal pannello canale |
| FILTRO | 1 | 1×C96 | [dec. 159] bus HPF in, bus LPF in, 2 uscite sul DJ bus = 4 slot stereo, 8 mode bit in (muto della sezione) |
| 5-WAY | 1 | 1×C96 | DJ bus in → out MASTER SUM |
| FX | 1 | 1×C96 | 4 bus-net in (multidrop, dec. 91) + 4 return out = 8 slot stereo |
| MASTER | 1 | 1×C96 | 7 contributori MASTER SUM + MON out verso CUE |
| MASTER-OUT (dec. 143) | 2 | 1×C96 cad. | solo alimentazione e controllo: RAW±26 [M] a9-a12, +5V, CTRL_GND, GLOBAL_MUTE c9, AC_OK c17; nessun audio; schede d'uscita del master accanto alla scheda di segnale |
| CUE | 1 | 1×C96 | 4 cue in + MON in; ampli cuffia locale |
| MIC / MONO | fino a 4 in totale (dec. 97) | 1×C96 cad. | due moduli SEPARATI, stessa classe di slot: out MASTER SUM + 4 out sui net dei bus FX (`docs/fase4/mic-mono-moduli.md`) |
| PSU | 1 | 1×C96 (lato distribuzione) + morsetti/viti per ingresso rete e secondari | la PSU È la stella (§grounding): i radiali AGND partono dal suo connettore |
| UTILITY/spare | 2 | 2×C96 | future/prototipi (SPECIFICA §3 "utility/future") |

Totale: ~19 connettori femmina sul backplane (maschi sui moduli, angolo
retto, montaggio a pannello) [REV dec. 91: +4 FX-SEND].

## 3. Riga a — POTENZA (mappa IDENTICA per tutte le classi — REV decisione 93)

| Pos | Segnale | Note |
|---|---|---|
| a1-a2 | +27 V raw AUDIO | 2 pin paralleli (≥3 A vs 1,1 A max); ferrite + bulk locale nel modulo (sheet §1) |
| a3-a4 | −27 V raw AUDIO | idem |
| a5-a6 | +22 V raw LN/OTA | 2 pin (≥3 A vs 0,5 A max) |
| a7-a8 | −22 V raw LN/OTA | idem |
| a9-a10 | +26 V raw [M] HV | solo master: la mappa è identica ma SOLO il modulo MASTER popola ferrite+bulk su questi pin [dec. 143: li usano le 2 schede MASTER-OUT, non la scheda di segnale] |
| a11-a12 | −26 V raw [M] HV | idem |
| a13-a20 | AGND (analogue 0 V, ritorni) | 8 pin = <1 mΩ di percorso; è il radiale di stella del modulo |
| a21-a22 | +5 V control | REGOLATO nella PSU (dec. 93); LED/logiche; 2 pin ≈ 4 A capacità vs 1,25 A di dimensionamento |
| a23-a24 | CTRL_GND | ritorno logico/CV; bond ad AGND solo alla stella PSU |
| a25-a26 | CHASSIS/SHIELD | alla piastra di montaggio del modulo (bond chassis unico alla stella) |
| a27-a32 | SPARE | riserva (es. −5 V futuro, +48 V phantom se il mic cambiasse — oggi NO phantom [BLOCCATO V1]) |

I rail audio ±18 V e ±15 V LN NON viaggiano sul backplane [BLOCCATO]:
ogni modulo li genera dal SUO raw dedicato (dec. 93): ±18,0 V =
LM317/337 a 19,2 V + cap-moltiplicatore dal ±27; ±15,0 V LN = pre-reg
±16,5 (LM317/337) → LT3045/94 dal ±22 (dec. 54 — LT3045 Vin max 20 V,
Vout max 15 V); ±15 V switch (ADG14xx-class, dec. 88/90) = 78L15/79L15
diretti dal ±22. Il modulo MASTER genera tutto dal ±26 [M] (LDO locali
±18/±15, master-out [M] REV). Eccezione sense: il MASTER sente i raw
±27/±22 sui propri pin di riga a per il supervisor mute (finestre per
avvolgimento, S1 §4 v0.2) — solo lettura di tensione, nessun assorbimento.

## 4. Riga b — AUDIO (single-ended 0 dBu, convenzione q38 confermata qui [PROVVISORIO])

Struttura: **10 slot stereo** (L, R, AGND) = 30 posizioni + 2 spare
(b31-b32; sul MASTER = VIE_TAP L/R, dec. 111). L'AGND ogni 3 pin isola gli slot adiacenti (capacità pin-pin
~0,5-1 pF: crosstalk stimato < −100 dB a 20 kHz su impedenze 10k —
coerente col misurato DJ bus −98 dB @1 kHz / −72 @20 kHz, `sim/cdj/`).
**[REV 2026-10-26, todo 133]** La stima < −100 dB vale fra nodi ad alta
impedenza. Verso un net a massa virtuale (S1-S4, DJ bus) la corrente
accoppiata entra in Rf: 1 pF da una linea pilotata vale −58 dB a 20 kHz
(`sim/fx/RISULTATI-fx-ret-bus-130.md` §3). Vincolo PCB: net a massa virtuale
in stripline con guardia, ≤ 0,2 pF verso ogni linea pilotata, nessun
parallelo lungo; Cf 10 pF sul summing di ogni ricevitore.

Semantica degli slot PER CLASSE (slot 1 = b1-b3, slot 2 = b4-b6, …):

| Slot | CDJ (CHn) | FILTRO | 5-WAY | FX | MASTER | CUE | MIC/GEN |
|---|---|---|---|---|---|---|---|
| 1 | DJBUS out L/R | ~~CH1 send in~~ BUS_HPF in (net)² | DJBUS in L/R | BUS1 net in¹ | MSUM1 in (5-way) | CUE1 in (CH1) | MSUM out |
| 2 | CUE out L/R | ~~CH1 return out~~ BUS_LPF in (net)² | MSUM out L/R | BUS2 net in¹ | MSUM2 in (FX1) | CUE2 in (CH2) | S1_OUT (net¹) |
| 3 | SEND TAP out (→FX-SEND) | ~~CH2 send in~~ HPF out → DJBUS (net)² | — | BUS3 net in¹ | MSUM3 in (FX2) | CUE3 in (CH3) | S2_OUT (net¹) |
| 4 | ~~FILT_SEND out~~ BUS_HPF out L/R (net)² | ~~CH2 return out~~ LPF out → DJBUS (net)² | — | BUS4 net in¹ | MSUM4 in (FX3) | CUE4 in (CH4) | S3_OUT (net¹) |
| 5 | ~~FILT_RET in~~ BUS_LPF out L/R (net)² | ~~CH3 send in~~ spare | — | RET1 out (→MSUM2) | MSUM5 in (FX4) | MON in (master) | S4_OUT (net¹) |
| 6 | ~~XF_SEND out~~ spare (dec. 160-161) | ~~CH3 return out~~ spare | — | RET2 out (→MSUM3) | MSUM6 in (mic) | — | — |
| 7 | ~~XF_RET in~~ spare (dec. 160-161) | ~~CH4 send in~~ spare | — | RET3 out (→MSUM4) | MSUM7 in (generic) | — | — |
| 8 | — | ~~CH4 return out~~ spare | — | RET4 out (→MSUM5) | MON out L/R | — | — |
| 9 | spare | spare | spare | spare | INS_SEND out (dec. 111) | spare | spare |
| 10 | spare | spare | spare | spare | INS_RET in (dec. 111) | spare | spare |

² **REV dec. 159 (2026-10-31)**: il filtro lavora dopo il fader. I bus HPF e LPF sono net
multidrop come il DJ bus: ogni canale inietta con R 10k lato sorgente sul net scelto dalla
levetta; il modulo filtro riceve sul virtual-earth (Rf 10k, Cf 10 pF) e reinietta le uscite
delle due sezioni sul DJ bus con R 10k. I bit FILT_MODE (c1-c8) restano: servono al muto
della sezione senza canali. Crossfader: tolto dalla dec. 161.

¹ **REV dec. 91 (2026-10-01)**: i bus FX S1-S4 sono NET MULTIDROP (stessa
convenzione del DJ bus): i 4 moduli FX-SEND (out S1-S4), MIC e GEN
iniettano ciascuno con la propria R 10k lato sorgente sullo stesso net;
il modulo FX riceve il net sul pin e somma sul virtual-earth (Rf 10k
locale, fx-module §3). Il SEND TAP del canale CDJ (slot 3) va allo slot 1
del proprio FX-SEND. Classe **FX-SEND** (×4): slot 1 = SEND_IN L/R (da
CDJ n), slot 2-5 = S1_OUT…S4_OUT L/R (sui net di bus), slot 6-10 = spare;
riga a/c come mappa comune (raw ±27 → ±18 audio locale, raw ±22 → ±15
switch locale 78L15/79L15, +5 V control per i pull-up bottoni; bottoni assign = harness diretto dal
pannello canale al front connector del modulo, NON sulla riga c: la mappa
controllo resta identica per tutte le classi).
**REV 2026-10-13 (architettura MIC/MONO v0.1, dec. 97)**: la classe MIC/GEN aveva un
solo slot «FXSEND out», ma i bus sono 4: ora slot 2-5 = S1_OUT…S4_OUT,
nelle STESSE posizioni della classe FX-SEND. Mandata = 4 pot send (dec. 97), niente switch di assign: ogni buffer
d'iniezione resta sempre sul bus e pilota due R 10k, una sul net L e
una sul net R. Fino a 4
moduli MIC/MONO: i MIC si sommano in multidrop sul net MSUM6, i MONO sul
net MSUM7 (R di somma lato sorgente; ingressi MSUM6/7 del master
direttamente sulla massa virtuale — nota di revisione per master-out §A2).
I contributori di MASTER SUM restano 7 (dec. 94a); i bus FX arrivano a 12
contributori, caso già verificato (fx-module §3).

Regole elettriche: driver di modulo ≤50 Ω (out driver dedicati, come il
canale CDJ); ricevitore = iniezione 10 kΩ su summing a massa virtuale
(DJ bus, MASTER SUM, FX send, CUE sum) o buffer ≥100 k (filter send,
cue monitor); nessun doppino terminato/impedenza caratteristica: con
≤0,5 m di percorso e ≤40 kHz di banda (fx §8.4) le linee sono
elettricamente corte (λ = km). Bilanciato solo verso l'esterno
(XLR master/mic [BLOCCATO]).

## 5. Riga c — CONTROLLO/CV (mappa IDENTICA per tutte le classi)

| Pos | Segnale | Note |
|---|---|---|
| c1-c8 | FILT_MODE CH1-4 [1:0] | 8 bit: 2 per canale (HPF/OFF/LPF), dal pannello canale al modulo filtro [dec. 159: pilotano anche l'ADG di instradamento sul canale; al filtro servono per il muto della sezione]; livelli 0/+5 V, serie 10k, pull-down 100k lato filtro (stessa disciplina del pilotaggio kill §8.10 five-way); filtro con bit assente = OFF (bypass secco) |
| c9 | GLOBAL_MUTE | dal controller mute del master (supervisore rail + timer, master-out §3.7): lo ascoltano i relay di uscita dei moduli che ne hanno uno + i buffer d'iniezione dei 4 FX-SEND (dec. 94(b): i send mutano col mute globale — nessuna eccitazione della matrice self-FB nelle transizioni). Il modulo CUE NON ascolta c9 (scelta di Filippo 2026-10-02, `sistema-cue.md` §6: la cuffia resta viva durante mute/guasti master; la protezione power del modulo cue è locale) |
| c10-c13 | CV_BUS 0-5 V ×4 | convenzione d'interfaccia [BLOCCATO]: CV remoti (es. filter freq shared, utility); [dec. 161: liberi, il crossfader è tolto]; generazione nel dominio ±15 V LN (sheet §1) |
| c14-c15 | LED_DIM / SVC | dimming LED comune (PWM lento dal PSU) + linea di servizio spare |
| c16, c20, c24, c28 | CTRL_GND | ritorni intercalati: ogni gruppo di segnali ha il suo ritorno adiacente |
| c17 | AC_OK | **[REV 2026-10-28, scheda del master]** linea open collector dal PSU-IN (alto = rete presente, `sistema-psu-esterno.md` §2.5) verso il mute controller del master; la pull-up sta nel PSU-IN |
| c18-c19, c21-c23, c25-c27, c29-c32 | SPARE | riserva (future: meter link, automation, MIDI…) |

## 6. Correnti stimate per classe e per raw [PROVVISORIO — il calcolo esatto è di S1/PSU; REV dec. 93: split per rail dedicato]

| Classe | ±27 audio (tip/max) | ±22 LN (tip/max) | ±26 [M] | +5 V | Nota dominante |
|---|---|---|---|---|---|
| CDJ ×4 | ±113/±160 mA cad. [REV 2026-10-13, dec. 105: +24 sezioni per l'EQ isolator, ~2 mA l'una; era ±65/±110] | ±17/±40 cad. (phono LN) | — | ~20 mA | op-amp ~56 sezioni (EQ isolator 48 + somme, servo, buffer) + 1-3 VCA |
| 5-WAY | ±250/±350 mA | ~5/10 (Iq 78L15 switch) | — | ~20 mA | ~35 quad + 2 VCA + 3 switch IC (µA) |
| FILTRO | ±110/±150 mA | ±65-100/±190 (OTA + riserva c-B) | — | ~20 mA | 8 core OTA (Iabc!) + ~20 quad [dec. 159: 4 core + ~12 quad; correnti da ridurre al ricalcolo PSU, per ora restano come riserva] |
| FX | ±180/±300 mA [PROVV] | — | — | ~20 mA | 20 VCA 218x (16 matrice + 4 ritorno gain, dec. 91b) + op-amp |
| FX-SEND ×4 (dec. 91) | ±40/±60 mA cad. | ~5/10 cad. (78L15 switch) | — | ~10 mA | ~18 sezioni op-amp + 2 switch IC (µA) |
| MASTER | — (LDO ±18/±15 locali da [M]) | — | ±130/±170 | ~30 mA | HV stage Iq 40 mA×2 + summing/meter + LDO locali |
| CUE | ~61 a riposo / ≤ ~340 col clamp su entrambi i canali [REV 2026-10-12, ampli cuffia v0.2: stadio su ±18 locali da ±27, NON su LN; clamp VERIFICATO 126-168 mA per canale] | ~23/25 (summing/MON/blend/level su ±15 LN) | — | ~58/60 (2 relay DPDT eccitati + controller locale) | 1 Vrms/32 Ω ×2 uscite; design e numeri in `sistema-cue.md` §8 |
| MIC/MONO (fino a 4, dec. 97) | ±22/±40 cad. (mic) · ±30/±45 cad. (mono) [REV 2026-10-13] | ±20/±30 cad. (solo mic: front-end LN) · ~5 (mono: detector) | — | ~15 mA cad. | ~17-18 sezioni op-amp + 1 switch IC (solo mute mandate); `docs/fase4/mic-mono-moduli.md` §7 |
| LED/metering (tutti) | — | ±100/±125 (albero riferimenti) | — | 200/500 mA | dato S4: ~103 segmenti (master 2×20 + zone 10×~6), 2 mA typ / 5 mA worst |
| **Totale per raw** | **~±1,4 A tip** [REV 2026-10-13 sera, dec. 105/106: isolator +0,19 A; era ~1,2 A dalla dec. 98] (somma dei max singoli ~1,7 A — nota sotto) | **~±0,28 A tip / ±0,45 A picco** (+switch µA-Iq) | **±0,13/±0,17 A** | **~0,55/1,0 A worst** (dimensionamento 1,25 A) | W1 3,0 A (dec. 106; era 2,5 dalla dec. 98) · W2 1,0 A · W3 0,4 A · W4 2,0 A (S1 REV 2026-10-13; erano 1,2/0,6/0,3/1,2) |

Nota sui massimi (dec. 93): i «max» per classe sono inviluppi conservativi
del PICCO DI SEGNALE (scala ms) del singolo modulo — non si presentano mai
tutti insieme (crest factor musicale). Il trasformatore è dimensionato sui
totali tipici (S1 §1: 0,9 A audio, 0,28 A LN, 130 mA [M], 0,55 A +5) e il
bulk (2×10 mF per W1/W2) fornisce i picchi; la somma dei max singoli
(~1,5 A su ±27) serve solo al dimensionamento delle piste del singolo
ramo e dei fusibili di ramo (S1 §4).

## 7. Keying, meccanica, riparabilità

1. **Codifica per classe**: i connettori DIN 41612 accettano pin di
   codifica/guide in posizioni diverse → ogni classe ha la SUA codifica
   (CDJ, FILTRO, …): l'inserimento errato è meccanicamente impossibile.
   In aggiunta: etichetta classe sul telaio + colore della maniglia
   estrattore per classe [principio RATIFICATO dec. 94(c); palette e
   hardware = voce 40 — sessione hardware].
2. **Meccanica proposta**: backplane orizzontale sul fondo del telaio;
   moduli verticali, appesi al pannello frontale (viti + rondelle
   dentate per continuità chassis), connettore maschio angolo retto che
   innesta verso il basso; guide laterali in lamiera per l'allineamento.
   Manutenzione: sviti il pannello, sfili il modulo — nessuna rimozione
   di cablaggio. Ingombri esatti = questione 29 (pannello di Filippo).
   [REV 2026-10-28, dec. 142] Schede alte 220 mm (dal pannello al
   backplane, comune a tutti i moduli), SMD sui due lati dove serve,
   più schede affiancate sotto un pannello quando non basta una.
3. **Comportamento a modulo rimosso** (q38): sistema SPENTO (no
   hot-swap [BLOCCATO]). Ad ogni modo: le uscite dei moduli assenti non
   caricano i bus (i bus sono ingressi a massa virtuale con iniezione
   10k: un modulo assente = un'assenza, non un carico — crosstalk e
   somma già validati così, `sim/cdj/djbus-*`); un modulo PRESENTE MA
   SPENTO può essere alimentato di rimando dai pin audio (diodi ESD
   degli op-amp): la serie ≥470 Ω-10k su ogni linea limita la corrente
   <1 mA — sotto il limite clamp 30 mA degli switch ADG1434 ma FUORI
   SPECIFICA (non sono power-off protected:
   `docs/fase1/adg1434-datasheet-verify.md` §2); regola di servizio
   OBBLIGATORIA: mai alimentare segnali esterni col mixer spento.
4. **Backplane fase 1** (prototipo validazione: CDJ + FX + master + PSU
   base, SPECIFICA §fase): stessa famiglia connettori, 4 slot + 2 spare,
   anche millefori con barra AGND in rame (§8 grounding); il pinout è
   già quello definitivo → la fase 1 valida davvero il backplane.

## 8. Costruzione backplane

- PCB 2 strati minimo (lato componenti = segnali, lato saldature =
  pour AGND + piste potenza rinforzate); piste raw (±27/±22/±26[M])
  ≥ 2,5 mm o doppie, +5 V ≥ 1,5 mm (dec. 93);
  AGND pour continuo sotto la riga a; riga b con AGND di slot a pour
  dedicato; riga c separata da pista CTRL_GND.
- In alternativa fase 1: millefori + barra di rame AGND 4×20 mm, fili
  radiali 1,5 mm² per la potenza, cavetto schermato a coppie per l'audio
  (ogni slot stereo = 1 cavetto 3 conduttori con drain a AGND).
- Ogni connettore: condensatori di bypass 100 n tra pin potenza e AGND
  lato backplane + 10 µ bulk per slot di modulo.

## 9. Chiusure per q38 — RATIFICATE 2026-10-01 → decisione 94(a)

1. Standard elettrico I/O backplane: **single-ended 0 dBu tra moduli,
   bilanciato solo verso l'esterno** (la proposta provvisoria dell'export
   è confermata dai numeri: rumore/crosstalk validati su questa base).
2. Ingressi MASTER SUM: **7 contributori stereo** (5-way, 4 FX return,
   mic, generic) — il summing vive nel modulo master (inverting
   virtual-earth, `master-out.md` §A2).
3. Summing finale: modulo MASTER (già [BLOCCATO] SPECIFICA:127).

## 10. Assunzioni dichiarate

[REV 2026-10-29, dec. 144] Principio: la forma del telaio segue la funzione. Le
assunzioni sotto (lunghezza, numero di slot, schede verticali) cambiano se la funzione lo chiede.

- Moduli = schede verticali dietro pannello (non card-cage Eurocard):
  il DIN 41612 angolo retto lo permette; se q29 sceglie il card-cage,
  stessa famiglia, montaggio diverso.
- Un backplane unico (non segmentato): ~15 slot in linea, lunghezza
  ≤70-80 cm [PROVVISORIO — q29]; a quella lunghezza le cadute sui raw
  sono <10 mV con piste §8 (loop ~6 mΩ su 2,5 mm² × 0,7 m a 1,1 A —
  dentro il margine dropout dei regolatori locali, verifica S1 §2 v0.2).
- ~~FX = modulo unico con matrice interna (accorpamento dei 4 FX RETURN
  dei doc: da ratificare in fase di layout, SPECIFICA §3).~~ SUPERATA dalla
  dec. 130: 4 moduli FX-RET (REV in testa).
