dj-filippo241/maelcum_mixer/docs/fase1/cdj-line-channel.md

# FASE 1 — Modulo CANALE CDJ/LINE: design circuitale v0.4 (2026-09-28)

> **REV 2026-10-13 (decisione 105)**: l'EQ è l'ISOLATOR a 4 bande
> (`eq-isolator-v0.4.md`), integrato nel canale: §3.3 nuova, §4, §5, §6,
> §7 item 7. La vecchia §3.3 (EQ in serie) resta sotto come archivio.

> **v0.4 (2026-09-28)**: aggiunge il front-end PHONO MM come variante
> d'ingresso (decisione 56 realizzata): design completo in
> `docs/fase1/phono-stage.md` v0.1 (decisione 79) — catena RIAA passiva
> 42 dB, EIN 1,79 µV (10-20k, ricalc. 2026-09-30), overload +18 dBu; selettore LINE/PHONO dopo il blocco
> phono, prima di [B] GAIN. Il resto del canale è invariato dalla v0.3.

> **v0.3 (2026-09-25)**: SUPERSEDE la v0.2 per §3.3 (EQ in serie, decisioni 76/77 —
> celle a contribuzione bocciate dalla simulazione) e allinea §4-§8 alle misure beta-3
> (`docs/fase1/eq-serie-v0.3.md`). Il resto del documento è invariato dalla v0.2.

> **v0.2 (2026-09-18)**: SUPERSEDE la v0.1 (in storia git). Allineato a: decisioni 58-76,
> gain-staging sheet v1.0, status doc rev2, e validazione matematica dell'EQ
> (`sim/eq_analysis.py` + `sim/eq_results.txt`) — **quest'ultima smentita in parte dalla
> simulazione LTspice (2026-09-24, `sim/cdj-eq/RISULTATI-eq.md`): la math era zero-fase
> per LOW/HIGH → decisione 76, EQ in serie per banda (Baxandall); ridisegno in v0.3.**
> [SUPERATO 2026-09-28: phono MM v0.1 FATTO (dec. 79), selettore in §3.1bis — nota storica] Scope: SOLO line/CDJ — phono Rev A resta
> su carta (decisioni 56/61), il front-end dedicato + selettore PHONO/LINE arriverà in Rev B
> del modulo senza cambiare il resto della catena (status doc PDF §6: "dedicated PHONO and
> LINE front ends → selector → common DJ GAIN").

## 1. Requisiti (valori locked aggiornati)

- **[REV 2026-10-31, dec. 159]** Catena nuova: … → EQ → split post-EQ (CUE, FX SEND,
  invariati) → METER DJ → FADER → interruttore HPF/OFF/LPF dopo il fader: DJ bus, bus HPF
  o bus LPF (net multidrop, R 10k). Il filtro filtra la somma dei canali assegnati (§3.6).
  Il send/return del filtro sparisce. La catena qui sotto resta come storia.
- Catena [SUPERATO dalla dec. 159]: RCA stereo → protezione → buffer → GAIN → EQ 4 bande → split post-EQ:
  (1) CUE, (2) FX SEND, (3) dry → FILTER SEND/RETURN (modulo filtro esterno, decisione 60)
  → METER DJ → FADER → out driver ≤50 Ω → DJ BUS
- GAIN [BLOCCATO]: −∞ → 0 (detent) → +10 dB; stereo linked; tracking ≤0,5 dB
- EQ [BLOCCATO nel comportamento]: 4 bande LOW/LOW-MID/MID-HIGH/HIGH; −∞ → 0 (flat, detent)
  → +6 dB; tracking stereo ≤0,25 dB; law lenta al centro e rapida agli estremi
- EQ frequenze [PROVVISORIO — review con Filippo aperta]: 70 Hz Q~0,7 (shelf) /
  250 Hz Q~0,8 (bell) / 1 kHz Q~0,9 (bell) / 5 kHz Q~0,7 (shelf)
  [SUPERATO dalla dec. 105: isolator con incroci 150 / 500 / 2500 Hz di
  partenza, da sentire sul prototipo (docs/02 B7)]
- CUE [BLOCCATO]: post-EQ, pre-filter, pre-fader
- FX SEND [BLOCCATO]: pre-fader, pre-filter; EQ2 (LOW ~120 Hz, HIGH ~4,5 kHz, −∞..0..+6) [REV dec. 91a: EQ2+level+switch assign vivono nel MICRO-MODULO FX-SEND (`docs/fase1/fx-send-module.md`); al canale restano send tap bufferizzato ≤50 Ω e bottoni pannello via linee logiche; comportamenti locked invariati];
  level −∞..0; assign MULTIPLI simultanei S1-S4 con precision analogue switch
- Filtro [BLOCCATO]: switch 3 vie HPF/OFF/LPF sul canale; audio via send/return al modulo
  filtro; break-before-make + ramp 1-5 ms (nel modulo filtro)
- METER DJ [BLOCCATO, dec. 159(e) e 161(b): pre-fader, senza filtro; prima BLOCCATO post-filter/overdrive, pre-fader]; peak con persistenza; calibrazione
  identica tra canali (trim di calibrazione previsti)
- FADER [BLOCCATO]: slider conduttivo-plastica stereo linked ≤0,5 dB; buffer ≤50 Ω
- Livelli: gain-staging sheet §2 (dominio audio ±18 V; ±15 V LN per CV/meter/phono futura)

## 2. Diagramma a blocchi (metà canale L; R identica e linked)

```
[RCA IN] ─► [A] PROT+BUFFER ─► [B] GAIN (VCA stereo, detent unity) ─► [C] EQ 4 BANDE
                                                                          │
                                          ┌───────────────────────────────┼──────────────────┐
                                          │                               │                  │
                                   [D] CUE SEND                    [E] FX SEND          [F] FILTER I/F
                                    (buffer → CUE bus)         (EQ2 → level → assign [micro-modulo FX-SEND, dec. 91a]     (send/return al
                                                                multipli S1-S4 → bus)     modulo filtro;
                                          │                        │                      switch 3 vie)
                                          ▼                        ▼                          │
                                     (modulo CUE)             (modulo FX)              ritorno filtro
                                          └────────────────────────┴──────────────────────────┤
                                                                                              ▼
                                                                              [G] METER DJ (pickup)
                                                                                              ▼
                                                                              [H] FADER + buffer
                                                                                              ▼
                                                                              [I] OUT DRV → DJ BUS
[H2] PSU locale: ±24 in → ±18 audio (LM317/337 + post-filtro) · ±15 LN (LT3045/3094:
     CV, meter; phono = blocco [A0] §3.1bis) · +5 control (LED/logiche)
```

## 3. Design per stadio

### 3.1 [A] Ingresso line + protezione
Invariato dalla v0.1: RCA dorato isolato da chassis (rondella dedicata); R serie 100 Ω +
TVS low-cap + bead; polo RC >100 kHz; buffer OPA1612 unity, Z_in ≥47 kΩ, dominio ±18 V.
**[REV 2026-10-13, audit voce 58 — gain-staging sheet §6]** Aggiunto blocco della continua in ingresso: C film 2,2 µF + 100 kΩ verso massa (polo 0,72 Hz, −0,02 dB a 10 Hz; Z_in 100 kΩ). E sullo stadio di make-up dell'EQ (§3.3) [dal 2026-10-13: sulla somma dell'isolator, 0,058 Hz] un servo DC, cella dei ritorni FX (0,053 Hz): toglie gli offset di VCA ed EQ prima di CUE, send, filtro e fader. Prima il percorso line non aveva nessun blocco della continua fino al 5-way.

### 3.1bis [A0] Ingresso PHONO e selettore (v0.4, rinvia a phono-stage.md)

RCA phono isolati + terminale GND (stella analogue-0V, q. 21); loading
47 kΩ || C 100/200/300 pF switch [PROVVISORIO q7]; blocco RIAA =
phono-stage.md §2-3 (42 dB, out −2 dBu nom su ±15 V LN); uscita del blocco
→ selettore LINE/PHONO (switch analogico precisione, famiglia assign FX,
BBM + mute breve) → ingresso di [B] GAIN (stesso nodo del buffer line [A]).
MC esclusa da questa variante (dec. 62; q. 7 per il futuro).

### 3.2 [B] GAIN — raccomandazione: VCA stereo a singola CV

> **[SUPERATO dalla dec. 162, 2026-11-02]** Il GAIN è un pot doppio lineare
> selezionato nel percorso del segnale, niente VCA. Circuito T1
> [PROVVISORIO]: buffer [A] → pot 10k lin (in → massa) con Rl 4,30k dal
> cursore a massa → non invertente OPA1612 ×3,15 (2,15k/1k) → isolator [C].
> Metà sinistra della manopola = trim (−2/−3 dB a ore 11, silenzio negli
> ultimi 5-10 %); 0 dB al detent; +10 a fine corsa. Tracking ≤ 0,5 dB da
> −10 dB in su con pot selezionati stretti. Rumore del canale −94,5 dBu A
> (era −92,9). Numeri e netlist: `sim/gain-pot/RISULTATI-gain-pot.md`. Il
> testo sotto (VCA, trim, shaper) resta come storia.
Il tracking ≤0,5 dB esclude il pot doppio meccanico diretto (±1-2 dB tipici). Raccomandato
[PROVVISORIO — corretto da datasheet 2026-09-27: 218x = SINGLE channel, "dual" sono i
porti di controllo]: 2× THAT 2180/2181 (stessa famiglia del master level — un solo tipo di
VCA in tutto il mixer, ricambio unico; tracking L/R via trim di law o selezione coppie,
voce 37) pilotati da UN pot con detent → shaper di law →
CV 0-5 V (generatore su ±15 V LN). Law: −∞ a full CCW, 0 dB al detent (~50% corsa),
+10 dB a fine CW. **Law e headroom VERIFICATI in simulazione (2026-09-27, §7
item 4)**: detent 0 dB esatto, floor −100 dB, +18 dBu pulito con 5,5 dB di
margine; il tracking L/R richiede trim di law (2181) o selezione di coppia
(2180) — voce 37. Alternativa economica da scartare solo se la sim dice che il VCA
colora: pot doppio selezionato + trim (più lavoro di calibrazione, tracking a rischio).

**REV 2026-10-26 (todo 124, `docs/fase3/sistema-vca-trim.md` §3) — trim
dei VCA applicato al canale.** Coppie per canale: GAIN e fader (dec. 126),
4 chip. Uscita dello shaper ×2 e bipolare; la CV entra SOLO da EC− (pin 3),
negativa per alzare, positiva per tagliare; EC+ (pin 2) a massa. Ultimo
stadio: partitore 1,00k / 1,00k sul pin (lato L, 0,1 %); lato R 900 Ω +
piazzole del trimmer 200 Ω 25 giri e del ramo d'offset (trimmer 50k fra
±15 V LN → 1,5 MΩ). Trimmer di simmetria su ogni chip: 50k cermet fra
±15 V LN → 150 kΩ → pin 4, 51 Ω verso massa. La law al pin resta quella
simulata: cambia solo l'implementazione dello shaper. Il boost +10 dB del GAIN non usa più EC+: la CV
scende sotto zero (~−61 mV al pin a +10 dB). Trimmer per canale: 4 di
simmetria montati; trim di law solo a piazzole (tracking ≤ 0,5 dB coperto
dall'abbinamento, §6 del documento trim).

### 3.3 [C] EQ 4 bande — ISOLATOR (decisione 105, integrato 2026-10-13)

Design, misure e limiti: **`eq-isolator-v0.4.md`** (§3 topologia, §8
completamento, §9 integrazione). Qui solo l'interfaccia col canale.

- **Ingresso**: uscita del VCA di gain [B]. La banca non supera mai il
  livello d'ingresso su nessun nodo interno.
- **Uscita**: stadio di somma OPA1612, bassa impedenza, **polarità
  diritta** (somma non invertente, eq-isolator §9). È il nodo di split:
  da qui partono CUE [D], send tap [E], filter send [F] e fader [H].
- **Guadagno**: 0 dB al detent (entro 0,004 dB), +6 dB con una banda a
  fine corsa nella sua banda, +6 dB piatti con tutte a fine corsa.
- **Silenzio**: contatto di fondo corsa per banda; quattro manopole
  chiuse = −100 dB (canale muto senza fader).
- **Continua**: servo DC sulla somma (polo 0,058 Hz, residuo ≤ 2 mV). È
  il servo che §3.1 metteva sul make-up dell'EQ in serie.
- **Manopole**: 4 pot doppi LINEARI 10 kΩ con detent al centro e
  contatto di fondo corsa (voce 40). Niente taper custom.
- **Silicio per canale stereo**: 12 quad OPA1654 + 1 dual OPA1612 + 1
  dual per i servo.
  **[REV 2026-11-04, todo 211: incroci C (dec. 152) → 10 quad OPA1654;
  curva PIONEER (dec. 146) non realizzabile col pot lineare, eq-isolator §10.]**
- Numeri musicali rinviati all'ascolto (docs/02 B7): incroci, boost,
  law.

### 3.3-ARCHIVIO EQ 4 bande — SERIE per banda, famiglia Baxandall (v0.3, decisioni 76/77)

> **[SUPERATO dalla DECISIONE 105, 2026-10-13]** L'EQ corrente è l'isolator a 4 bande (§3.3 qui sopra). Questa sezione resta come archivio.

> **v0.3 (2026-09-25)**: sostituisce integralmente le celle a contribuzione della
> v0.2, bocciate dalla simulazione (fase dei filtri LOW/HIGH —
> `sim/cdj-eq/RISULTATI-eq.md`, questione 62 → decisione 76). Design completo,
> griglie misurate e law del pot: **`docs/fase1/eq-serie-v0.3.md`** (stato beta-3)
> + netlist in `sim/eq-serie/`.

Architettura per lato: 4 celle in cascata + buffer, **12 sezioni op-amp** (3 quad):
buffer in −6 dB (riferimento interno, principio dec. 73) → LOW shelf complementare
(R 1k / Rp 31k: kill −29,3 dB a gonna larga, boost +6 shelf liscio) → LM campana
250 Hz sottrattiva `−(1−b·BP)` (notch esatto −45 dB al centro) → MH campana 1 kHz
(stessa famiglia) → HIGH sottrattiva `−(1−b·HP2)` (boost +6 shelf; kill: bump +2 dB al corner,
−9…−14 dB a 20-35 kHz → questione 68) → make-up +6 dB con trim (azzera l'offset di detent).

Proprietà misurate (LTspice, macromodelli — dettagli e griglie in eq-serie-v0.3.md §9):
1. Detent piatto: ±0,02 dB relativo su 20 Hz–35 kHz (offset costante −0,12 dB → trim).
2. Boost +6,0 dB per banda [requisito locked rispettato]; worst all-boost +7,5 dB @250.
3. Kill: shelf −30 dB (LOW: −29,3 con gonna fino a 1 kHz; HIGH: bump +2/−9…−14 → questione 68),
   campane: notch −45/−66 dB al centro, larghezza da Q. (Numeri aggiornati alla correzione Q HP2=0,707 del 2026-09-25.)
4. **All-kill ≠ silenzio**: residuo +1,1 dB @5 kHz (tra le gonne dei notch e il kill
   HIGH debole) → il fader resta il muto vero; auto-mute = questione 59 (numeri
   definitivi registrati).
5. Curva dub (LOW+HIGH su, medi giù): +5,6 / −45 / −46 / +5,5 dB — estetica target.
6. Rumore: [REV 2026-09-30: −110,7 INVALIDATO dal quirk INTEG LTspice — EQ reale −89,2 dBu (den 190 nV/√Hz piatta): il target canale ≤−92 è superato dalla sola EQ → ritaratura sistema = voce 71] [RISOLTO → dec. 89: canale ≤−80 A-wtd, budget completo −90,3 = PASS 10,3 dB senza fix].
7. Livelli: picco interno 7,6 V a +16 dBu all-boost (riferimento −6 dB); estremo
   +18 dBu = saturazione d'uscita intenzionale, niente clipping a metà catena.
8. Tracking stereo: pot doppi ≤1% → L−R ≤0,16 dB (PASS ≤0,25); 2% → 0,32 (limite,
   trim) — questione 53; alternativa VCA documentata.

Law del pot (specifica eq-serie-v0.3.md §10): asimmetrica — boost +6 in mezza corsa
(lineare), cut −30 dB con accelerazione negli ultimi 5% (filosofia dec. 70); detent
meccanico con click a metà. Taper custom su pot doppi conduttivo-plastica → sessione
hardware voce 40. Validazione a orecchio della law sul prototipo M4L (dec. 78,
IN PAUSA fino a design completo — direzione Filippo 2026-09-25).

EQ2 di FX send/return (questione 65): stessa famiglia di celle (2 bande: shelf LOW
~120 Hz + campana/shelf HIGH ~4,5 kHz, law dedicate) — design nel modulo FX.

### 3.4 [D] CUE send
Punto locked: post-EQ, pre-filter, pre-fader. Buffer dedicato → switch CUE di canale →
CUE bus. Nessuna elaborazione.

### 3.5 [E] FX send [REV 2026-10-01 → decisione 91a: interfaccia al micro-modulo FX-SEND]

La sezione send (EQ2 + level + switch assign) NON è più a bordo del
canale: vive nel **micro-modulo FX-SEND** (uno identico per canale,
`docs/fase1/fx-send-module.md`). Al canale resta l'interfaccia:
- **SEND TAP**: punto locked invariato (post-EQ, pre-filter, pre-fader)
  → buffer out ≤50 Ω → backplane (slot 3 CDJ) → IN del micro-modulo
  (linea corta, convenzione backplane §4);
- **BOTTONI ASSIGN**: i 4 bottoni S1-S4 restano sul pannello del canale
  (gesto invariato) → harness diretto al connettore frontale del
  micro-modulo (linee logiche +5 V con ramp ~1 ms, audio MAI dai
  contatti — schema kill dec. 88);
- Comportamenti LOCKED (EQ2 bande/law, level −∞…0, assign multipli e
  simultanei, BBM + ramp 1 ms dec. 80, iniezione bufferizzata) restano
  BLOCCATI in SPECIFICA: si sono solo spostati di scatola.
[Storico v0.3: EQ2 a bordo canale con celle serie scalate (questione 65),
law dedicate, assign con precision switch — design traslato nel
micro-modulo senza modifiche elettriche di comportamento.]

### 3.6 [F] Interfaccia filtro (modulo esterno)

**[REV 2026-10-31, dec. 159]** Dopo il fader il canale ha tre uscite su tre net
multidrop: DJ bus, bus HPF, bus LPF (R 10k lato sorgente ciascuna). L'interruttore
HPF/OFF/LPF pilota un ADG (PROVVISORIO, tipo ADG1434) con break-before-make e rampa
1-5 ms: la commutazione morbida passa dal modulo filtro al canale.
**[DEC. 163, 2026-11-03]** La rampa non è propria: la fa il VCA del fader (§3.8) con un
«dip». Una logica autotemporizzata (74HC86 + 74HC14 + 74HC74) vede la levetta cambiare,
abbassa il VCA con due celle RC 10k/50n bufferizzate (mezzo OPA1654) sommate sul nodo EC−
(giù a −100 dB in ~1 ms), commuta l'ADG a ~1,6 ms e rilascia (su in ~3 ms). Click sul bus
che riceve: sotto la musica (secco: +14 dB). All'orecchio un respiro di 3-4 ms; CUE, FX
SEND e meter non lo vedono. [PROVVISORIO fino al banco: feedthrough della CV, rimbalzo
della levetta.] `sim/cdj/RISULTATI-filtsel-dip.md`.
**[REV 2026-11-11, todo 289]** Con la logica vera il circuito disegnato aveva due guasti: il
nodo DIFF dei diodi si scaricava solo dal 100k (buco di ~40 ms) e una levetta che torna
indietro col CLK alto lasciava il canale muto 40-80 ms. Correzione: DIFF ripreso da due
porte libere (74HC14 sez. 6 + 74HC86 sez. 4), ritardo 68k/47n con diodo di scarica. L'ADG
commuta a 1,4-3,8 ms (soglie del 74HC14), sempre sotto −120 dB; il respiro sotto −20 dB passa
da ~3 a ~4 ms. RISULTATI-filtsel-dip §5. I 2 bit di modo
restano sulla riga c: al modulo filtro servono per zittire la sezione senza canali.
Backplane: lo slot 4 (FILT_SEND) diventa BUS_HPF out, lo slot 5 (FILT_RET) BUS_LPF
out. **Fase 1**: senza modulo filtro l'interruttore resta su OFF; nessun ponticello.
Il testo sotto vale come storia.
Send/return stereo via backplane + 2 bit di modo (HPF/OFF/LPF) sulla sezione control.
Il break-before-make e la rampa vivono nel modulo filtro. **Nota fase 1**: finché il
modulo filtro non esiste, il prototipo canale si collauda con send e return ponticellati
sul backplane (bypass) — il canale funziona dry, tutto il resto si valida lo stesso.

### 3.7 [G] Meter DJ
[REV dec. 159(e) e 161(b), BLOCCATO: pre-fader, dopo l'EQ; non vede più il filtro.] Prima: post-filter (return), pre-fader. Peak detector attacco <1 ms, persistenza/hold con decay
lento; [PROVVISORIO] 10 segmenti ×3 dB per lato (LM3915, range −24…+12 dBu) + LED purple
di clip con latch 300-500 ms. Trim di calibrazione per l'identicità tra canali (voce 54).
Numero segmenti definitivo: al design del modulo metering.

### 3.8 [H] Fader + [I] out driver

> **[SUPERATO dalla dec. 161 (2026-10-31): niente crossfader, nemmeno opzionale] ** Niente anello e niente levetta X/OFF/Y: il fader va dritto alla levetta del filtro.
> **[REV 2026-10-31, dec. 160: crossfader solo in CV, sul VCA del fader; l'anello audio sparisce] ** Il canale non apre più l'anello: una levetta X/OFF/Y somma
> alla CV del fader la CV XF_X o XF_Y dal backplane (c10-c11). Il testo che segue è storia.
> **[REV 2026-10-14, dec. 111]** Tra [H] e [I] il canale apre un anello per
> il modulo crossfader opzionale: XF_SEND (driver ≤ 50 Ω, slot 6) → XF_RET
> (buffer ≥ 100 k, slot 7). Senza modulo lo chiude il ponticello JXF del
> backplane (`sistema-backplane.md` REV dec. 111). CUE, send FX e filtro
> restano pre-fader e non lo vedono.
> **[REV 2026-10-22, dec. 126]** Il fader è un fader MONO da 100 mm (60 mm dalla dec. 169, 2026-11-09) che
> comanda due VCA 2181 (uno per lato) con uno shaper a diodi: tracking dai
> VCA trimmati, curva [PROVVISORIO] −12 dB a metà corsa, fader chiuso
> ≥ 102 dB. Rumore del canale −92,9 dBu A-wtd (era −94,6). Dettagli:
> `sim/cdj/RISULTATI-fader-vca.md`. Il testo sotto è SUPERATO.

Slider doppio conduttivo-plastica (hardware: sessione dedicata, voce 40), −∞..0,
tracking ≤0,5 dB con selezione/trim; buffer OPA1612 ≤50 Ω → DJ BUS (injection 10 kΩ
[PROVVISORIO dai doc §24/35]). Fallback VCA come §3.2 se il tracking meccanico delude.

## 4. Level plan (da gain-staging sheet §2, corretto con i risultati EQ)

| Nodo | Nominale | Max programma | Estremo | Dominio |
|---|---|---|---|---|
| Ingresso RCA | 0 dBu | +8 dBu | — | ±18 V |
| Post-GAIN | 0 dBu | +10 dBu | +18 dBu (user error: sorgente calda + gain max) | ±18 V |
| Post-EQ | 0 dBu | +16 dBu | saturazione d'uscita intenzionale (worst all-boost misurato +7,5 dB; il rail ±16,5 V = +23,5 dBu fa da tetto). EQ con riferimento interno −6 dB: picchi interni ≤7,6 V a +16 dBu (`sim/eq-serie/cascade-b2-level.cir`) | ±18 V (+23) |
| Post-EQ, isolator (dal 2026-10-13) | 0 dBu | +16 dBu | +6 dB piatti con tutte le bande al massimo (misurato +6,01); clip dell'EQ con circa +17,5 dBu in ingresso, come nell'EQ in serie. Nodi interni mai sopra l'ingresso: il riferimento interno −6 dB non serve più. Modo comune sulla somma: 1/10 dell'uscita | ±18 V |
| Filter return | 0 dBu | +16…+20 (drive inserito) | saturazione voluta | ±18 V |
| Post-FADER / out | 0 dBu | +16 dBu | — | ±18 V |

## 5. Rumore (target sheet §3: ≤−92 dBu A-wtd all'out driver)

**Misurato v0.3 beta-3** (`sim/eq-serie/cascade-b3-noise.cir`, cascata EQ al detent,
20 Hz–20 kHz, macro reali OPA1654/OPA1612 da `sim/lib/opamp-audio.inc`):
**−110,7 dBu** integrato [REV 2026-09-30 INVALIDATO: reale −89,2 dBu — quirk INTEG, voce 71] → margine 18,7 dB sul target (la macro "uniforme" di beta-2
era già calibrata vicina alla OPA1654 reale: numero CONFERMATO, non solo stimato). [REV 2026-09-30: il margine non esiste — reale −89,2 dBu vs target −92: MANCATO → voce 71A; RISOLTO 2026-09-30 sera → decisione 89: target canale RITARATO a ≤ −80 dBu A-wtd, budget completo misurato −90,3 A-wtd (EQ 82% + GAIN VCA 18%) = PASS 10,3 dB SENZA fix — `sim/cdj/RISULTATI-channel-noise-71A.md`]
Regole confermate: pot 10 kΩ sulle celle (voce 48), summer a 49,9 kΩ (non 100 k),
bracci shelf ≤31 kΩ; OPA1612 solo su nodi a bassa Z (regola in libreria: bipolare,
sorgenti <100 Ω). Restano da aggiungere: VCA di gain (a monte, già nel budget del
GAIN — macro THAT 218x pronto in `sim/lib/that2181.inc`) e out driver.

**[REV 2026-10-13 — isolator, `sim/cdj/channel-noise-v04-iso.cir`]**
Canale completo (blocco della continua, buffer, VCA di gain al detent,
isolator, fader, out driver): **−94,6 dBu A-wtd** con le manopole EQ al
centro (−92,9 piatto), −89,1 con tutte al massimo, −104,8 con tutte a
zero. Target ≤ −80 (dec. 89): PASS 14,6 dB. Era −90,0 con l'EQ in
serie. Ora il VCA di gain pesa più dell'EQ. Tabella di sistema:
`docs/06` §10.

## 6. BOM di massima v0.3 (esclusi pot/fader/connettori/pannello)

| Voce | Qtà approx | Costo |
|---|---|---|
| OPA1654 quad (celle EQ serie: 3 per canale) | 6 | ~30-36 € |
| OPA1612 dual (buffer in/make-up EQ, out driver) | 2-3 | ~10-15 € |
| THAT 2181 (VCA gain; + eventuali VCA di banda se tracking 53 sceglie VCA) | 1-3 | ~6-18 € |
| Reti RC celle (0,1% bracci shelf, C0G/PP campane e HP2) | — | ~10-15 € |
| LM3915 ×2 + clip detector | 3 | ~3 € |
| Switch analogici assign FX | 0 sul canale (→ 8 π SPDT ×4 nel micro-modulo FX-SEND, dec. 91a) | — |
| Regolatori locali (LM317/337 + LT3045/3094) + passivi | — | ~12-15 € |
| **Totale stimato per canale stereo** | | **~80-110 €** (v0.2: 70-95; delta = buffer/make-up + reti. Fuori tabella: 4 pot doppi taper custom dell'EQ → voce 40) |

**[REV 2026-10-13 — isolator]** Le prime due righe e la riga delle reti
RC cambiano: OPA1654 quad ×12 (era 6), OPA1612 dual ×4 (somme EQ,
buffer d'ingresso, buffer fader, out driver), 1 dual per i servo, reti
della banca R 0,1 % / C 1 % C0G o film (~60 condensatori) + 3 trimmer
d'incrocio per lato. EQ: ~130-160 € per canale contro 45-60 [STIMA di
Claude, senza preventivi, eq-isolator §5]; canale intero ~165-210 €.
Fuori tabella: 4 pot doppi lineari con detent e contatto di fondo corsa
(voce 40).

## 7. Simulazioni — stato (aggiornamento 2026-09-27)

FATTE:
1. Celle a contribuzione (v0.2): `sim/cdj-eq/RISULTATI-eq.md` — finding critico
   di fase → decisione 76, topologia serie. THD: non misurabile coi macromodelli
   lineari, si verifica al prototipo col modello TI reale.
2. Tracking/mismatch: fatto per entrambe le topologie. Serie: pot doppi ≤1% →
   L−R ≤0,16 dB PASS; 2% → 0,32 limite (`low-cell-track.cir`, `cascade-track.cir`).
3. **EQ serie v0.3 completa (beta-3)**: celle LOW/MID/HIGH + cascata 4 bande +
   riferimento interno −6 dB + summer 49,9k: `sim/eq-serie/` (9 netlist),
   griglie e finding in `docs/fase1/eq-serie-v0.3.md` §9.

4. **GAIN VCA THAT 218x FATTO (2026-09-27, `sim/cdj/vca-law.cir` +
   `vca-headroom.cir`)**: law dB(θ) via shaper a tratti VERIFICATA (−100…0…+10
   dB esatti ai θ di progetto, detent 0 dB a 1e-8, costante 6,1 mV/dB);
   headroom: +18 dBu a GAIN 0 passa pulito (8,70 V out, margine 5,5 dB sul
   clamp ±16,5); a GAIN +10 su +18 = violazione regola K4 → clamp a 16,5 V
   (user error documentato, non guasto di design); tracking L/R SENZA trim di
   law: ±1,3 dB in attenuazione profonda, ±0,83 a −50 dB, 0 al detent, ±0,17
   a +10 → il trim di law del 2181 azzera (dati per 53/40/voce 37). THD non
   misurabile in macro lineare: stima da datasheet, verifica al prototipo
   (stesso trattamento di eq-serie §9.7).

5. **Summing DJ BUS 4 canali FATTO (2026-09-27, `sim/cdj/djbus-level.cir` +
   `djbus-crosstalk.cir`)**: worst sheet CONFERMATO — 4×0 dBu correlati →
   +12,0 dBu (4,36 Vpk, margine 11,6 dB sul clamp ±16,5); singolo canale
   +16 dBu → 8,66 Vpk (margine 5,6 dB); estremo 4×+16 correlati (+28 dBu =
   violazione K4) → clamp ±16,5 V (user error documentato, non guasto).
   Crosstalk via nodo di bus (virtual earth, classe OP1612, topologia
   [PROVVISORIO] R 10k + driver 47 Ω): −98 dB @1 kHz, −78 @10 kHz, −72
   @20 kHz, −67 @35 kHz — degrada 6 dB/ott col loop gain, inudibile;
   nella pratica comanderà l'accoppiamento PCB (design di sistema, 21).

6. **Peak detector condiviso FATTO (2026-09-27, `sim/meter/` +
   `sim/meter/RISULTATI-peak-det.md`)**: circuito candidato superdiodo +
   clamp anti-windup; droop a 10 Hz misurato per τ release 0,3/1/3 s
   (−2,9/−0,88/−0,31 dB per ciclo); ballistica RATIFICATA 2026-09-28:
   release ~0,3 s stile Pioneer DJM (decisione 81 — la pulsazione a 10 Hz
   è informazione musicale, non difetto); cattura esatta a 1 kHz (+0,006%) e su burst +18 dBu;
   35 kHz = artefatto del macro (cattura HF da verificare a banco in
   beta-3); clip latch DIMOSTRATO: flag 442 ms retriggerabile (SPEC
   300-500 ✓).

7. **Isolator integrato nel canale FATTO (2026-10-13)**: polarità
   diritta con somma non invertente (`sim/eq-iso/iso-c-ac.cir`,
   `iso-c-dc.cir`, `iso-c-noise.cir`), rumore di canale
   (`sim/cdj/channel-noise-v04-iso.cir`): numeri in eq-isolator §9.

RESTANTI:
7. Variante cella HIGH crossfade-LP2: solo se la questione 68 la sceglie
   [CADUTA con la dec. 105]
8. Banco: THD e clip dell'isolator, click del contatto di fondo corsa,
   segno reale dello stadio VCA di gain.

## 8. Questioni generate/aggiornate da questa v0.3 (stato 2026-09-27/28)

- 53 (tracking EQ stereo): numeri misurati — pot doppi ≤1% → L−R ≤0,16 dB PASS;
  2% → 0,32 limite/trim; alternativa VCA documentata. Scelta: sessione hardware (40)
- 59 (all-kill): numeri DEFINITIVI dalla cascata — residuo +1,1 dB @5 kHz:
  l'all-kill non è silenzio; fader o auto-mute (b). Ratifica dopo la 68
- 68 NUOVA (APERTO-F): profondità kill HIGH — cella sottrattiva (bump +2/−9…−14 dB,
  zero silicon extra) vs crossfade-LP2 (−24…−30 dB, +2-3 sezioni/canale). Ascolto
  sul prototipo M4L quando riparte
- 65 (EQ2 FX send/return): allineata — stessa famiglia di celle serie (2 bande),
  design nel modulo FX
- 55 (transiente assign FX): immutata, proposta uniformata al metodo filtro
- 40 (hardware pot/fader): ora include i 4 pot doppi taper custom dell'EQ
  (specifica law: `docs/fase1/eq-serie-v0.3.md` §10)
- Review frequenze EQ con Filippo: centri 70/250/1k/5k [PROVVISORI] — le curve
  misurate della serie sono la base; ascolto sul prototipo M4L
- 62 CHIUSA → decisione 76 (EQ in serie); 66 CHIUSA → decisione 77 (kill −30 dB)
