dj-filippo241/maelcum_mixer/docs/fase2/five-way-module.md

# FASE 2 — Modulo 5-WAY (dub preamp): design v0.2 + CELLE v0.2.1 (2026-09-28) + DRIVE v0.3 (2026-09-29)

> **DRIVE v0.3 VALIDATO (2026-09-29, §5)**: sbloccato dalla decisione 82
> (referenze «prima nastro, ultimi 20% fuzz»). Catena finale: THAT 218x
> (law 0→+7→+12→+16 dB compensata sullo shaper, end-to-end MISURATA ESATTA)
> → JFET CS nudo «nastro» (ginocchio 0,7-1,0 Vp; a CCW il pulito lo garantisce
> la law: −9,4 dB prima del saturatore) → DIFF PAIR PNP single-ended «fuzz»
> (steering ±1,9 V = clip duro asimmetrico; basi dal drain via R matched:
> niente latch; trim non previsto — il servo nulla l'offset, eventuale trim pair solo se il banco lo chiede) → recovery invertente 2k/2k (polarità totale
> non invertente) + servo DC 2 op-amp (−65 µV). Tutto DC-coupled (SUB 10 Hz).
> Griglia musicale θ×programma misurata in §5.3 (CONFERMATA da Filippo 2026-09-30, decisione 87 — review estetica sul prototipo M4L);
> lezioni di 7 iterazioni in §5.4; D6 (rumore) FATTO 2026-09-30 (§8.9: −85,7 dBu
> drive, VCA dominante → target −90 irraggiungibile) → **DECISIONE 88: kill a
> SWITCH analogici (10 VCA rimossi dai gate), drive tiene il 218x, target
> nuovo ≤ −80 dBu A-wtd — misurato con switch+fix: −83,2 A-wtd θ0** (§8.9; rerun v031 2026-10-01: −83,9, margine 3,9 dB — §8.10 item 6);
> D5 pendente.

> **CELLE v0.2.1 (2026-09-28, §4.2)**: topologia degli integratori cambiata
> per la questione 70 (tetto di stato 52 mV degli OTA): integratori op-amp +
> JFET come VCR bootstrappato (gate a Vcm + vds/2: quadraticità cancellata
> esatta), position via Vcm (law lineare-in-f, shaper esponenziale famiglia
> dec. 70), core a riferimento locale −12 dBu con make-up ×4 assorbito nel
> summer d'uscita (zero silicon extra). VERIFICATO sui valori finali
> (`sim/five-way/cell-v021-*.cir`): law 250-1500 Hz ±0,03%, Q invariante,
> THD 0,005% nominale / 0,125% worst +10 dBu (500× meglio della cella OTA),
> notch −46…−47 dB, rumore −121,7 dBu [√INTEG SUPERATO → 71A]. LM13700 RIMOSSI dalle celle (−10);
> +10 dual JFET matched. Banca kill invariata; gate VCA [SUPERATO dec. 88 → switch π SPDT classe ADG1434 + invertitori SUB/MID, design CHIUSO §8.10]; drive invariato.
>
> **CODA BETA-3 CELLE (2026-09-28, `sim/filtro/RISULTATI-ota-real.md` §5)**:
> celle parametriche riesaminate col LM13700 REALE (`sim/lib/lm13700.inc`) —
> piccolo segnale CONFERMATO (detent piatto ±0,0001 dB, boost ±0,02 dB, notch
> vero −67…−78 dB con f0 +1% assorbita dal trim position), rumore cella
> −119,7 dBu [√INTEG SUPERATO → 71A] (dentro il budget −108,4 di §8.4 [superato → §8.9]); **FINDING BLOCCANTE**: il
> tetto di stato degli integratori OTA (52 mV a f0, strutturale) rende la
> cella nuda inutilizzabile ai livelli di progetto (a −6 dBu: gain 1,1-1,3
> contro 5,62, THD 3-6%); scaling+make-up rompe il rumore → **questione 70:
> PoC VALIDATO 2026-09-28 (`sim/five-way/RISULTATI-cell-clean.md`)** —
> raccomandata (c-A) JFET VCR bootstrappato (THD 0,004-0,11%, rumore
> −121,7 dBu, griglia v0.2 confermata, costo ~10-20 €); alternativa (c-B)
> VCA 218x ×2 (law esatta, livelli pieni, +20 chip). Rilascio celle v0.2.1
> su (c-A): §8.7.
>
> **v0.2-WIP (2026-09-27)**: (1) kill bank ALLINEATA IN FASE — soluzione
> esatta dimostrata (math + LTspice): somma piatta −0,0002…−0,008 dB su
> 5 Hz–60 kHz senza kill, all-kill = silenzio assoluto invariato (§3.1,
> §8.2); il finding v0.1 (buchi −3…−5 dB) è chiuso. (2) CELLE PARAMETRICHE +
> CASCATA 5 in serie VALIDATE: detent ±0,005 dB su 10 Hz–40 kHz, boost ±0,005
> dB sui target +9/+12/+15, notch −58…−81 dB, Q = comandata, position via gm
> esatta su 2,6 ottave (§4.1, §8.3); converter di position specificato per
> banda (§4.1). (3) RUMORE percorso completo: −108,4 dBu contro target −90,
> margine 18,4 dB [SUPERATO 2026-09-30 → §8.9: reale −77,3/−73,0 con 6 VCA;
> −83,2 A-wtd con switch dec. 88]. (4) GATE VCA + RAMP 1 ms [SUPERATO per il
> kill → dec. 88: switch] VALIDATO col macromodello THAT 218x condiviso (`sim/lib/that2181.inc`):
> click −8,4 dB vs brusco, floor −100 dB (§8.5). CORREZIONE trasversale da
> datasheet: 2180/2181 sono SINGLE channel (10 chip per i gate, non 5) —
> voce 37 aggiornata. Resta per la v0.2 completa: drive (dopo questione 61)
> e modelli reali (beta-3).
>
> **v0.1 (2026-09-25)**: primo design del 5-way performance EQ/dub preamp.
> Copre architettura, matematica del filter bank (questione 8: proposta LR4
> SIMULATA), topologia dell'EQ creativo (questione 9: architettura, law di
> position da decidere), interfaccia drive (questione 10: in attesa referenze
> di Filippo, questione 61). NON congela valori (regola 3). Fase 2: dettaglio
> circuitale completo dopo che la fase 1 ha insegnato (regola 5) — questo
> documento è architettura + funzioni di trasferimento + fattibilità.
> Fonti: SPECIFICA §6, decisioni 24/65/66/73, questioni 61 (referenze drive) e 67 (frequenze), status doc §14-18
> (`docs/export-chatgpt/documento-senza-titolo.txt`), gain-staging sheet.

## 1. Requisiti (BLOCCATO salvo dove indicato)

- Posizione: DJ BUS → 5-WAY → MASTER SUM; FX/mic/generic la bypassano.
- NON è il crossover acustico: quello lo fa il DSP esterno; il 5-way è uno
  STRUMENTO performance ispirato ai preamp dub/soundsystem.
- Riferimento interno −6 dB (pad in / makeup out, decisione 73).
- KILL: 5 sezioni = 5 vie (SUB ~10-80, KICK ~80-170, MID ~170-1,2k,
  HIGH ~1,2-6k, SUPER ~6-20k: incroci E dell'impianto, dec. 150; erano
  90/350/1,2k/3,5k, dec. 66); 24 dB/ott; overlap deliberato senza buchi; banca
  complementare (somma piatta); kill PRIMA dell'EQ creativo (il boost non
  ripristina materiale killato); kill switch per via (altoparlanti fisici).
- EQ CREATIVO: gain/position/width per banda; gain −∞/0/+15 (EQ1-3), +12
  (EQ4), +9 (EQ5); position: 20-120 / 80-400 / 250-1,5k / 800-5k / 3-20 kHz
  [PROVVISORIO]; width: narrow ~Q3 / medium ~Q1 / broad ~Q0,5 [SUPERATO dec.
  117: manopola continua Q3…Q0,3, §4.3]; position
  sposta il centro senza stravolgere gain/Q. Casi d'uso (corpus §17):
  broad+gain modesto = tonal shaping; narrow+gain alto = dub hit preciso;
  broad+gain alto = colorazione aggressiva.
- DRIVE: dopo la somma EQ, prima del meter; full CCW = 0 dB pulito, solo gain
  positivo; ~50% = +7 dB pulito; >50% saturazione progressiva che interagisce
  con gain di banda e overdrive filtro; JFET prima / BJT asimmetrico poi.
  Riferimenti operativi (corpus §18): normale −6…0 dBu, hot +10, estremo +18,
  clean headroom ≥+24 dove pratico (sheet: qui il dominio ±18 dà +23, ok).
- METER: dopo drive, prima del master sum (ballistica stile Pioneer DJM,
  dec. 81 che revisiona la dec. 65).
- Controlli: fader = slider, resto = pot (principio bloccato); gain di banda =
  5 POT ROTATIVI (decisione 85, 2026-09-28 — questione 24 chiusa per il 5-way).

## 2. Architettura

```
DJ BUS L/R (0 dBu nom, +16 worst)
  │
  ▼ PAD −6 dB (dec. 73) → buffer
  │
  ▼ KILL BANK (per lato): LR4 5 vie, GATE = SWITCH π SPDT di precisione
  │   per via (serie + shunt GND da off, §8.10) + 2 invertitori unity/lato
  │   (SUB/MID, polarità §3.1) + kill switch pannello (DEC. 88, 2026-09-30:
  │   era VCA 218x con ramp 1 ms; hard-cut accettato = standard di scena;
  │   dec. 80 revocata per questa parte, resta per FX/BBM filtro)
  │   SUB ──[gate K1]──┐
  │   KICK ─[gate K2]──┤
  │   MID ──[gate K3]──┤   (banca complementare: somma piatta §3)
  │   HIGH ─[gate K4]──┤
  │   SUPER─[gate K5]──┘
  ▼ EQ CREATIVO: 5 celle parametriche SVF in serie (gain/position/width §4)
  │   (le 5 bande EQ NON sono le 5 vie: ogni cella spazza il suo range)
  ▼ SOMMA → DRIVE JFET (law dec. 24, §5) → METER pickup (§5) →
  ▼ MAKE-UP +6 dB + trim → MASTER SUM (backplane)
```

> **REV 2026-11-03 (todo 227, `docs/fase3/sistema-polarita.md`).** Lo schema
> parte da una tensione. Il DJ bus è un net multidrop (backplane §4): in testa
> al modulo c'è il ricevitore a massa virtuale, che inverte. Dalla tensione
> d'ingresso a MSUM il modulo è non invertente (misurato: `sim/five-way/pol-5way-ac.cir`,
> fase −22° a 10 Hz, −11° a 100 kHz); dal net DJ bus a MSUM è −1,
> e [A2] lo raddrizza.

Ordine bloccato: kill bank → EQ creativo → drive → meter ("killed material
cannot be restored" — corpus §16; "boost non ripristina materiale killato"
— SPECIFICA §6).

## 3. Kill bank — matematica complementare (questione 8: RISPOSTA v0.2)

**REV 2026-11-10 (dec. 175, todo 290): incroci H, 60 / 250 / 1,2k / 8k Hz. Banca riallineata: valori e numeri in §3.2bis, simulazione in §8.2ter (`bank-aligned-h.cir`), ritardi del kill allo zero in §8.11. Le §3.2 e §8.2bis (incroci E) restano come storia.**

**REV 2026-11-05 (todo 259): incroci E, 80 / 170 / 1,2k / 6k Hz (dec. 150).**
Il testo sotto è scritto coi valori di partenza 90/350/1,2k/3,5k: la
matematica non cambia, cambiano frequenze, valori e numeri misurati.
Banca agli incroci E: §3.2 e §8.2bis (`bank-aligned-e.cir`).

**Scelta**: crossover Linkwitz-Riley
4° ordine ai 4 punti (in origine 90/350/1,2k/3,5 kHz; oggi 80/170/1,2k/6k): ogni edge = due Butterworth 2°
ordine (Q 0,707) in cascata. Proprietà che risponde ai requisiti:
- 24 dB/ott ✓ (4 poli per edge);
- "overlap deliberato senza buchi" = la sovrapposizione −6 dB delle LR ✓;
- bande: SUB = LP4(90) (passa fino a DC/10 Hz: nessun accoppiamento AC,
  requisito infrasub dec. 65 ✓); KICK = HP4(90)·LP4(350); MID = HP4(350)·
  LP4(1,2k); HIGH = HP4(1,2k)·LP4(3,5k); SUPER = HP4(3,5k);
- **somma in tensione PIATTA**: la proprietà LR a 2 vie NON basta a 5 vie —
  il finding v0.1 (§8.1) ha misurato buchi −3…−5 dB dalla fase non allineata.
  La v0.2 risolve con la banca allineata in fase (§3.1): |Σ| = 1 ESATTA,
  validata in simulazione (§8.2). La somma esce invertita (fase comune):
  il make-up ripristina la polarità assoluta (dec. 73, §2).

### 3.1 v0.2 — Banca allineata in fase (somma piatta esatta)

Identità LR4: `LP4(f) + HP4(f) = A2(f)` — allpass del 2° ordine a Q 0,707
(modulo 1 esatto, fase 0→−360°). La somma telescopica a 5 vie è esatta se
ogni banda arriva al summer con la stessa fase di riferimento = prodotto dei
4 allpass: ogni banda passa gli A2 dei crossover SOPRA la sua banda passante.

| Banda | Percorso | Allpass di compensazione | Polarità netta |
|---|---|---|---|
| SUB | LP4(90) dall'ingresso | A2(350) · A2(1,2k) · A2(3,5k) | − (3 sezioni) |
| KICK | HP4(90) → LP4(350) | A2(1,2k) · A2(3,5k) | + |
| MID | HP4(90) → HP4(350) → LP4(1,2k) | A2(3,5k) | − |
| HIGH | … → HP4(1,2k) → LP4(3,5k) | — | + |
| SUPER | … → HP4(3,5k) (fine spina) | — | + |

Somma = A2(90)·A2(350)·A2(1,2k)·A2(3,5k) → modulo 1 a ogni frequenza
(dimostrato: `sim/five-way/align_math.py`, errore 1,1e-15; validato in
LTspice: §8.2). Struttura a **spina HP condivisa**: il segnale attraversa
una cascata HP4(90) → HP4(350) → HP4(1,2k) → HP4(3,5k); ogni banda è una
presa sulla spina seguita dal suo LP4. Le HP4 non sono duplicate per banda:
la spina costa quanto la banca v0.1 (16 sezioni SK per lato).

Sezione allpass AP2 (2 op-amp): MFB bandpass invertente Q 0,707 + summer
−(1×Vin + 2×Vbp) = −A2(s) esatto. Vincoli: C1 = 2C (n1→n−), C2 = C (n1→out),
R1 = 1/(√2·ω0·C) (in→n1), R2 = 2·R1 (n1→gnd), Rf = 1,5·R1 (n−→out); summer
con Rf/Ra = 1 e Rf/Rb = 2 (coppie 0,1%). Il segno − di ogni sezione sparisce
nella polarità comune di banca (make-up, dec. 73); le bande con numero
DISPARI di allpass (SUB, MID) escono invertite: il gate corregge il segno.
MFB è appropriato qui (350 Hz–3,5 kHz, Q fisso): lo scarto v0.1 dell'MFB
riguardava gli edge LP sotto 100 Hz (rumore gain/2), non i BP.

Conteggio silicon per lato: 16 sezioni SK (spina 8 + LP 8) + 6 AP2 × 2
op-amp = 28 sezioni ≈ 7 quad/lato → **14 quad/modulo** per la banca (era 8
in v0.1). Variante "lite" (3 AP2/lato — 1 allpass per banda, il più vicino):
worst −0,125 dB invece di −0,008 dB, risparmio 3 quad/modulo [APERTO — se il
costo conta; raccomandazione ingegneria: banca completa, è il cuore del
modulo e 0,125 dB è già al limite del requisito ±0,1 dB].

Topologia per edge: Sallen-Key biquad unity-gain (1 op-amp per sezione 2
poli; R da formula con C fissi per decade, 1% + trimmer di allineamento a
banco: la piattezza vive sul matching degli 8 edge e delle 6 sezioni AP2).
Se un trimmer sposta un edge di ±10% senza muovere l'allpass corrispondente,
l'errore di somma resta ≈0,02 dB (calcolo in §8.2): i trim NON devono essere
accoppiati meccanicamente.

**Group delay della somma (dato nuovo v0.2)**: la somma allineata è un
allpass dell'8° ordine: τ ≈ 6,9 ms @10 Hz, picco 7,9 ms @58 Hz, 2,2 ms @350,
0,66 ms @1,2k, 0,19 ms @3,5k, 0,02 ms @10 kHz. Non è un costo nuovo
dell'allineamento: la banca v0.1 (non allineata) aveva già τ ≈ 7,3 ms di
picco — è il prezzo dei 24 dB/ott. La differenza v0.1→v0.2 è +0,6 ms al
picco. In ascolto: l'energia sotto ~100 Hz arriva ~7 ms dopo il medio-alto,
dentro la finestra di fusione (~20 ms) — comportamento normale di un
crossover ripido; il DSP acustico a valle fa il suo allineamento. Comunque
dato da confermare a orecchio (questione 67, ascolto M4L).

### 3.2 Incroci E (dec. 150, REV 2026-11-05) — valori e numeri

Stessa banca, stesse sezioni, frequenze 80 / 170 / 1,2k / 6k Hz. Valori di
partenza [PROVVISORIO — regola 3], formule del §3.1:

| Edge | Sallen-Key (C, R; HP: R a massa = 2R) | AP2 (C, R1 / R2 / Rf) |
|---|---|---|
| 80 Hz | 100 nF, 14,1 k (HP 28,1 k) | — (nessuna banda lo compensa) |
| 170 Hz | 100 nF, 6,62 k (HP 13,2 k) | 47 nF, 14,1 k / 28,2 k / 21,1 k |
| 1,2 kHz | 10 nF, 9,38 k (HP 18,8 k) | 10 nF, 9,38 k / 18,8 k / 14,1 k |
| 6 kHz | 4,7 nF, 3,99 k (HP 7,98 k) | 1,5 nF, 12,5 k / 25,0 k / 18,8 k |

Numero di sezioni e di chip invariato (16 SK + 6 AP2 per lato).

**Group delay della somma**: picco 10,1 ms a 54 Hz (era 7,9 ms a 58 Hz).
8,8 ms a 10 Hz, 1,5 ms a 350 Hz, 0,53 ms a 1,2k, 0,15 ms a 3,5k. Il
crossover a 80/170 è più stretto e più basso: il ritardo dei bassi sale
di ~2 ms, sempre dentro la finestra di fusione (~20 ms).

**Cosa si sente coi kill** (residuo minimo dentro la banda tolta, §8.2bis):

| Kill | Incroci E | Prima (90/350/1,2k/3,5k) |
|---|---|---|
| SUB | −96 dB a 5 Hz, −34 dB a 30 Hz | −76 a 10 Hz |
| KICK | **−9,6 dB a 117 Hz** | −18,4 |
| MID | −28 dB a 450 Hz | −16,4 |
| HIGH | −22,4 dB a 2,7 kHz | −14,0 |
| SUPER | −32 dB a 15 kHz, −50 a 25 kHz | −50,5 a 15k |

KICK è una via stretta (80-170 Hz, poco più di un'ottava): col kill il
kick cala di ~10 dB ma non sparisce, perché le code di SUB e MID ci si
sovrappongono. MID e HIGH, più larghe, si tolgono molto meglio di prima.
È lo stesso comportamento del prototipo MC-5WAY con CROSSOVER E, che
usa la stessa banca.
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
