dj-filippo241/maelcum_mixer/pcb/fx-send/comandi/fx-send-comandi.png

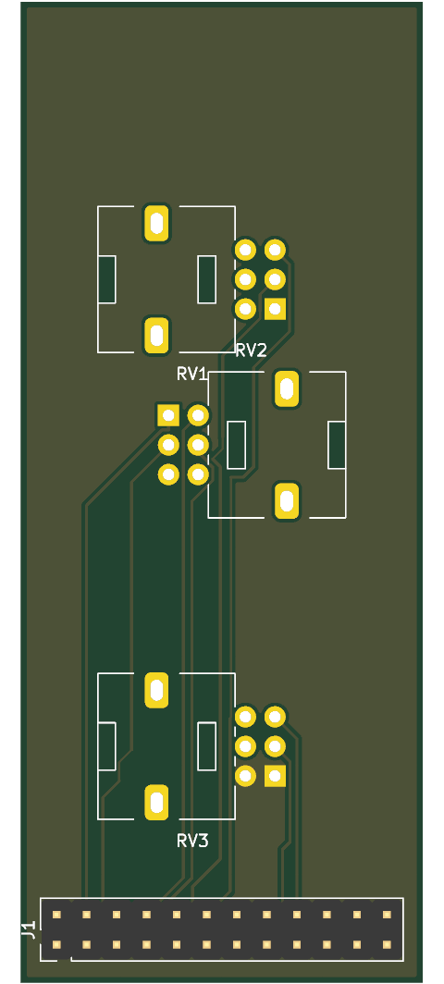
pcb/fx-send/comandi/fx-send-comandi.png
