dj-filippo241/maelcum_mixer/pcb/fx-send/fx-send.png

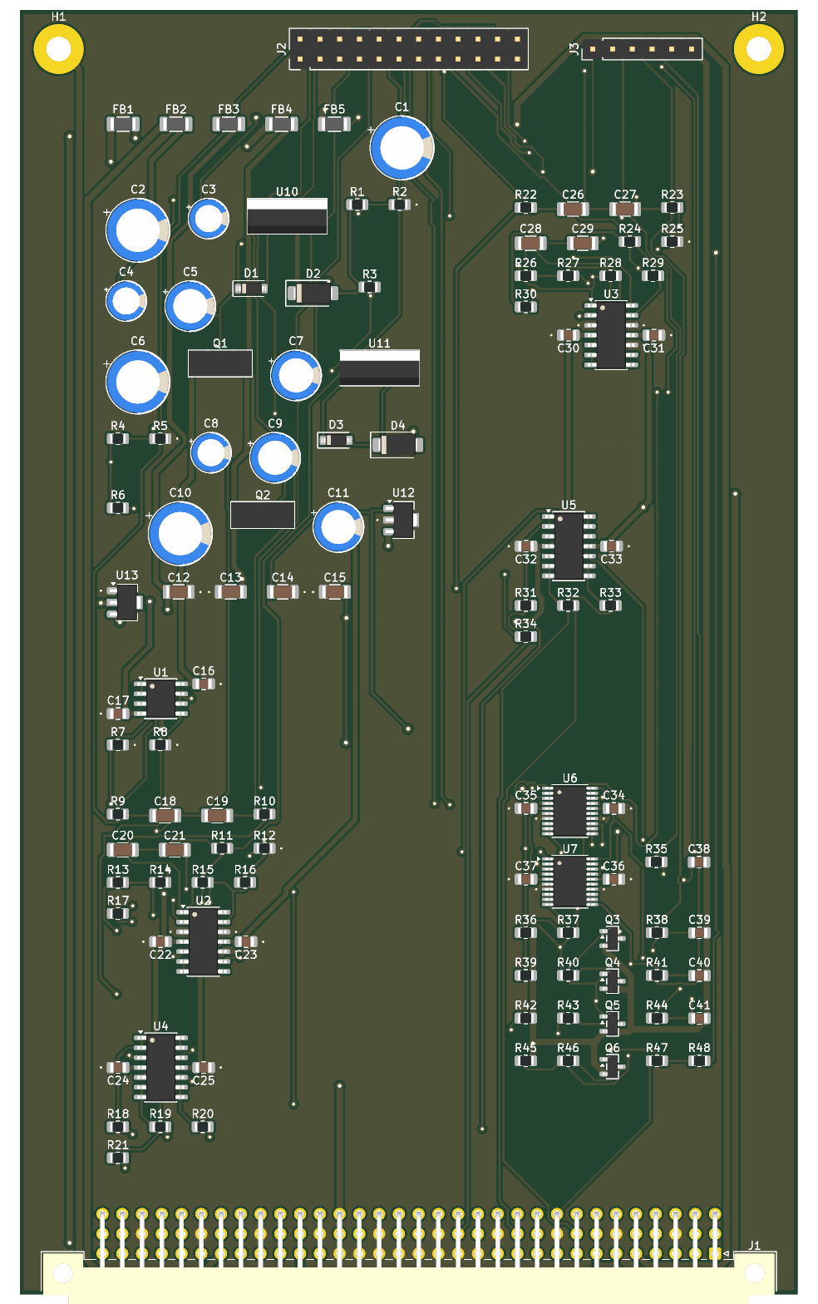
pcb/fx-send/fx-send.png
