dj-filippo241/maelcum_mixer/pcb/canale/bom.csv

quantita | valore | impronta | riferimenti | nota
2 | 220u 35V | CP_Radial_D8.0mm_P3.50mm | C1 C2
1 | 47p C0G | C_0805_2012Metric | C115
1 | 100n C0G | C_1206_3216Metric | C116 | hold: niente altro sul nodo (sim/meter)
2 | 1u 50V | C_1206_3216Metric | C12 C13
2 | 22p C0G | C_0805_2012Metric | C121 C124
1 | 50n C0G | C_1206_3216Metric | C129 | NOTA: 50n = 47n + 3n3 in parallelo | tau 0,5 ms
1 | 50n C0G | C_1206_3216Metric | C130 | NOTA: 50n = 47n + 3n3 in parallelo
1 | 47n | C_0805_2012Metric | C138
2 | 1u 25V | C_1206_3216Metric | C14 C15
1 | 4u7 25V | C_1206_3216Metric | C16 | rumore del riferimento (datasheet: 4,7 uF)
3 | 4u7 25V | C_1206_3216Metric | C17 C19 C20
2 | 10u 25V | C_1206_3216Metric | C18 C21
1 | 1u | C_1206_3216Metric | C22
56 | 100n | C_0805_2012Metric | C23 C24 C27 C28 C29 C30 C58 C59 C60 C61 C62 C63 C64 C65 C66 C67 C96 C97 C98 C99 C100 C101 C102 C103 C104 C105 C107 C108 C109 C110 C111 C112 C113 C114 C117 C118 C119 C120 C122 C123 C125 C126 C127 C128 C131 C132 C133 C134 C135 C136 C137 C139 C140 C141 C142 C143
2 | 2u2 film | C_1812_4532Metric | C25 C26 | blocco della continua (voce 58)
1 | 47u 10V | CP_Radial_D5.0mm_P2.00mm | C3
8 | 220n C0G | C_1210_3225Metric | C31 C32 C42 C43 C69 C70 C80 C81
12 | 100n C0G | C_1210_3225Metric | C33 C34 C35 C36 C49 C51 C71 C72 C73 C74 C87 C89
12 | 10n C0G | C_1206_3216Metric | C37 C38 C39 C40 C41 C57 C75 C76 C77 C78 C79 C95
2 | 10u 35V | CP_Radial_D5.0mm_P2.00mm | C4 C8
2 | 94n C0G | C_1210_3225Metric | C44 C82 | NOTA: 2C, coppia in parallelo da fissare col layout (RISULTATI-incroci-C §1)
2 | 47n C0G | C_1210_3225Metric | C45 C83
4 | 9n4 C0G | C_1206_3216Metric | C46 C52 C84 C90 | NOTA: 2C, coppia in parallelo da fissare col layout (RISULTATI-incroci-C §1)
6 | 4n7 C0G | C_1206_3216Metric | C47 C53 C55 C85 C91 C93
4 | 200n C0G | C_1210_3225Metric | C48 C50 C86 C88 | NOTA: coppia in parallelo da fissare col layout
2 | 47u 35V | CP_Radial_D6.3mm_P2.50mm | C5 C9
2 | 21n15 C0G | C_1206_3216Metric | C54 C92 | NOTA: 4,5 x 4,7n, coppia in parallelo da fissare col layout
2 | 20n C0G | C_1206_3216Metric | C56 C94 | NOTA: coppia in parallelo da fissare col layout
2 | 470u 25V | CP_Radial_D8.0mm_P3.50mm | C6 C10
2 | 27n C0G | C_1206_3216Metric | C68 C106 | integratore 1M/27n
2 | 100u 25V | CP_Radial_D6.3mm_P2.50mm | C7 C11
1 | 1N4148W | D_SOD-123 | D1 | scarica Cadj
1 | 1N4148W | D_SOD-123 | D12 | NOTA: OR a diodi
1 | 1N4148W | D_SOD-123 | D14 | scarica il ritardo al rilascio: CLK giù in pochi us (todo 289)
1 | S1G | D_SMA | D2 | protezione inversa
6 | 1N4148W | D_SOD-123 | D3 D8 D9 D10 D11 D13
1 | S1G | D_SMA | D4
1 | LM4040-5.0 | SOT-23 | D5
2 | TVS bidir <=5 pF | D_SOD-323 | D6 D7 | NOTA: parte da scegliere (TVS low-cap)
7 | ferrite 600R | L_1206_3216Metric | FB1 FB2 FB3 FB4 FB5 FB6 FB7
1 | C96 maschio | DIN41612_C_3x32_Male_Horizontal_THT | J1 | DIN 41612 C 3x32, angolo retto
1 | 2x18 cavo piatto | PinHeader_2x18_P2.54mm_Vertical | J2 | cavo piatto corto verso la scheda comandi dietro il pannello (dec. 133)
1 | 1x5 ingressi | PinHeader_1x05_P2.54mm_Vertical | J3 | NOTA: cavo verso gli RCA sulla schedina dei connettori (dec. 141)
1 | BD139 | TO-126-3_Vertical | Q40
1 | BD140 | TO-126-3_Vertical | Q41
2 | 120 1% | R_0805_2012Metric | R1 R4
15 | 10k 0.1% | R_0805_2012Metric | R10 R11 R37 R39 R43 R45 R53 R55 R86 R88 R92 R94 R102 R104 R146
2 | 100 | R_0805_2012Metric | R12 R17 | R serie (cdj §3.1)
2 | 47 | R_0805_2012Metric | R120 R122 | driver <= 50 ohm verso il FX-SEND (slot 3)
2 | 47 | R_0805_2012Metric | R121 R123 | NOTA: 47R dopo lo switch CUE (slot 2)
1 | 20k 0.1% | R_0805_2012Metric | R124 | NOTA: barra unica del canale, (L+R)/2 con due 20k
5 | 20k 0.1% | R_0805_2012Metric | R125 R129 R133 R134 R138
1 | 4k02 0.1% | R_0805_2012Metric | R126 | g = 0,287 (doc 0,288), come il master
1 | 3M | R_0805_2012Metric | R128 | release 0,3 s (dec. 81)
2 | 100k | R_0805_2012Metric | R13 R18 | polo 0,72 Hz, Zin 100k
2 | 6k19 | R_0805_2012Metric | R130 R135 | 5,1k del datasheet a -15 V riscalato a -18 V (come il master)
2 | 150k | R_0805_2012Metric | R131 R136
2 | 51 | R_0805_2012Metric | R132 R137
1 | 43.2k 0.1% | R_0805_2012Metric | R139
2 | 4k30 0.1% | R_0805_2012Metric | R14 R19 | Rl dal cursore a massa (T1)
1 | 68.1k 0.1% | R_0805_2012Metric | R140
1 | 357k 0.1% | R_0805_2012Metric | R141
1 | 20.0k 0.1% | R_0805_2012Metric | R142
1 | 38.3k 0.1% | R_0805_2012Metric | R143
1 | 976 0.1% | R_0805_2012Metric | R144
1 | 1.33k 0.1% | R_0805_2012Metric | R145
1 | 9k76 0.1% | R_0805_2012Metric | R147
1 | 18k7 0.1% | R_0805_2012Metric | R148 | stadio del partitore x(-1,916): CV al pin = out/10,02 (todo 281)
1 | 100k | R_0805_2012Metric | R149 | pot staccato = shaper a 0 V (come il master)
2 | 2k15 0.1% | R_0805_2012Metric | R15 R20
1 | 18k2 0.1% | R_0805_2012Metric | R150
2 | 1k 0.1% | R_0805_2012Metric | R151 R153
1 | 17k4 0.1% | R_0805_2012Metric | R152
1 | 2M7 | R_0805_2012Metric | R154 | partitore da ~950 ohm: 2,7M = +-5,3 mV come prima
2 | 10k | R_0805_2012Metric | R155 R156
1 | 4k99 0.1% | R_0805_2012Metric | R157 | NOTA: 4,4 V -> shaper -8,8 V -> stadio al rail -> 0,70-0,80 V al pin
2 | 10k | R_0805_2012Metric | R158 R160 | levetta verso CTRL_GND sulla scheda comandi
2 | 10k | R_0805_2012Metric | R159 R161 | NOTA: antirimbalzo 1 ms
2 | 1k 0.1% | R_0805_2012Metric | R16 R21 | x3,15
1 | 68k | R_0805_2012Metric | R163 | NOTA: 68k x 47n, ADG a 1,5-4 ms con le soglie del 74HC14 (todo 289)
1 | 1k | R_0805_2012Metric | R164 | NOTA: bit di modo sulla riga c | il backplane li porta per posizione
1 | 10k | R_0805_2012Metric | R166 | NOTA: tasto CUE a ritenuta verso +5VF
2 | 10k 0.1% | R_0805_2012Metric | R168 R171 | R lato sorgente sul DJ bus
2 | 10k 0.1% | R_0805_2012Metric | R169 R172 | R lato sorgente sul bus HPF
2 | 10k 0.1% | R_0805_2012Metric | R170 R173 | R lato sorgente sul bus LPF
1 | 1k74 1% | R_0805_2012Metric | R2 | E96 1,74k = 19,4 V (fx-send NOTE punto 16)
8 | 4k81 0.1% | R_0805_2012Metric | R22 R23 R32 R33 R71 R72 R81 R82
12 | 3k20 0.1% | R_0805_2012Metric | R24 R26 R46 R47 R48 R49 R73 R75 R95 R96 R97 R98
4 | 6k42 0.1% | R_0805_2012Metric | R25 R27 R74 R76
2 | 2k37 0.1% | R_0805_2012Metric | R28 R77 | calcolo 2,38k
2 | 10k7 0.1% | R_0805_2012Metric | R29 R78
1 | 1k | R_0805_2012Metric | R3 | NOTA: cap-moltiplicatore come il FX-SEND (~50 mA)
6 | 3k57 0.1% | R_0805_2012Metric | R30 R59 R60 R79 R108 R109
2 | 7k15 0.1% | R_0805_2012Metric | R31 R80
2 | 6k81 0.1% | R_0805_2012Metric | R34 R83
2 | 13k7 0.1% | R_0805_2012Metric | R35 R84
2 | 10k2 0.1% | R_0805_2012Metric | R36 R85
6 | 4k99 0.1% | R_0805_2012Metric | R38 R44 R54 R87 R93 R103 | sim 5k: E96 4,99k
4 | 7k59 0.1% | R_0805_2012Metric | R40 R50 R89 R99
4 | 15k2 0.1% | R_0805_2012Metric | R41 R51 R90 R100
4 | 11k4 0.1% | R_0805_2012Metric | R42 R52 R91 R101
1 | 1k74 1% | R_0805_2012Metric | R5
2 | 5k05 0.1% | R_0805_2012Metric | R56 R105 | calcolo 5,07k
4 | 5k05 0.1% | R_0805_2012Metric | R57 R58 R106 R107
3 | 1k | R_0805_2012Metric | R6 R127 R165
8 | 2k49 0.1% | R_0805_2012Metric | R61 R62 R63 R64 R110 R111 R112 R113
2 | 2k 0.1% | R_0805_2012Metric | R65 R114 | ramo del servo
2 | 1k8 0.1% | R_0805_2012Metric | R66 R115
2 | 200 0.1% | R_0805_2012Metric | R67 R116
2 | 1M | R_0805_2012Metric | R68 R117
4 | 100k | R_0805_2012Metric | R69 R118 R162 R167
2 | 150k 0.1% | R_0805_2012Metric | R7 R8
2 | 499 0.1% | R_0805_2012Metric | R70 R119 | polo 0,058 Hz, corsa +-129 mV
1 | 1k5 | R_0805_2012Metric | R9 | NOTA: ~6,7 mA nel riferimento (come il master)
2 | 50k | Potentiometer_Bourns_3266W_Vertical | RV1 RV2 | trim di simmetria (THD minima)
1 | 2k | Potentiometer_Bourns_3266W_Vertical | RV3 | trim di law, 25 giri (vca-trim §3.2): montato solo se la coppia esce da 0,5 dB
1 | 50k | Potentiometer_Bourns_3266W_Vertical | RV4 | trim d'offset di coppia
1 | OPA1612AIDR | SOIC-8_3.9x4.9mm_P1.27mm | U1 | buffer d'ingresso
1 | OPA1654AIDR | SOIC-14_3.9x8.7mm_P1.27mm | U10 | isolator lato R, sezioni 9-12
1 | OPA1654AIDR | SOIC-14_3.9x8.7mm_P1.27mm | U11 | isolator lato R, sezioni 13-16
1 | OPA1654AIDR | SOIC-14_3.9x8.7mm_P1.27mm | U12 | isolator lato R, sezioni 17-20
1 | OPA1612AIDR | SOIC-8_3.9x4.9mm_P1.27mm | U13 | somma x10 (2 per banda)
1 | OPA1642AIDR | SOIC-8_3.9x4.9mm_P1.27mm | U14 | servo DC (classe OPA2134 nel doc | OPA1642, SBOS484D)
1 | OPA1612AIDR | SOIC-8_3.9x4.9mm_P1.27mm | U15 | buffer CUE e SEND TAP, L
1 | OPA1612AIDR | SOIC-8_3.9x4.9mm_P1.27mm | U16 | buffer CUE e SEND TAP, R
1 | OPA1654AIDR | SOIC-14_3.9x8.7mm_P1.27mm | U17 | inseguitore di scala, superdiodo, buffer dell'hold (LM3915 sulla scheda comandi)
2 | V2181L | SOIC-8_3.9x4.9mm_P1.27mm | U18 U19
1 | OPA1612AIDR | SOIC-8_3.9x4.9mm_P1.27mm | U2 | GAIN T1, non invertente x3,15
1 | OPA1612AIDR | SOIC-8_3.9x4.9mm_P1.27mm | U20 | I/V del fader, pilota i 10k dei bus
1 | OPA1612AIDR | SOIC-8_3.9x4.9mm_P1.27mm | U21 | shaper F
1 | OPA1612AIDR | SOIC-8_3.9x4.9mm_P1.27mm | U22 | due celle RC del dip con buffer (RISULTATI-filtsel-dip caso 3)
1 | 74HC14PW | TSSOP-14_4.4x5mm_P0.65mm | U23 | NOTA: antirimbalzo, ritardo Schmitt, DJSEL = NOT(Q0 xor Q1), NDIFF (todo 289)
1 | 74HC86PW | TSSOP-14_4.4x5mm_P0.65mm | U24 | NOTA: confronto levetta / stato | sez. 4 = NOT(NDIFF) = DIFF ripreso (todo 289)
1 | 74HC74PW | TSSOP-14_4.4x5mm_P0.65mm | U25 | NOTA: stato dell'ADG
2 | ADG1434YRUZ | TSSOP-20_4.4x6.5mm_P0.65mm | U26 U27 | SPDT: A = IN alto, B = shunt a massa (datasheet Rev. E tabella 9)
1 | OPA1654AIDR | SOIC-14_3.9x8.7mm_P1.27mm | U3 | isolator lato L, sezioni 1-4
1 | OPA1654AIDR | SOIC-14_3.9x8.7mm_P1.27mm | U4 | isolator lato L, sezioni 5-8
1 | LM317 | TO-220-3_Vertical | U40
1 | LM337 | TO-220-3_Vertical | U41
1 | 78L15 | SOT-89-3 | U42
1 | 79L15 | SOT-89-3 | U43
1 | LT3045EMSE | MSOP-12-1EP_3x4.039mm_P0.65mm_EP1.651x2.845mm | U44 | EN/UV a IN | ILIM a massa | PG libero | PGFB a IN (come master-segnale.py)
1 | LT3094EMSE | MSOP-12-1EP_3x4.039mm_P0.65mm_EP1.651x2.845mm | U45 | EN/UV a IN | PG libero | PGFB a IN | ILIM a massa | VIOC libero
1 | OPA1612AIDR | SOIC-8_3.9x4.9mm_P1.27mm | U46 | +5 e -5 V di riferimento
1 | OPA1654AIDR | SOIC-14_3.9x8.7mm_P1.27mm | U5 | isolator lato L, sezioni 9-12
1 | OPA1654AIDR | SOIC-14_3.9x8.7mm_P1.27mm | U6 | isolator lato L, sezioni 13-16
1 | OPA1654AIDR | SOIC-14_3.9x8.7mm_P1.27mm | U7 | isolator lato L, sezioni 17-20
1 | OPA1654AIDR | SOIC-14_3.9x8.7mm_P1.27mm | U8 | isolator lato R, sezioni 1-4
1 | OPA1654AIDR | SOIC-14_3.9x8.7mm_P1.27mm | U9 | isolator lato R, sezioni 5-8
