dj-filippo241/maelcum_mixer/pcb/psu-in/bom.csv

quantita | valore | impronta | riferimenti | nota
2 | 2200u 35V | CP_Radial_D18.0mm_P7.50mm | C1 C2
2 | 1000u 35V | CP_Radial_D12.5mm_P5.00mm | C3 C4
2 | 1000u 63V | CP_Radial_D12.5mm_P5.00mm | C5 C6
1 | 1000u 10V | CP_Radial_D12.5mm_P5.00mm | C7
2 | SMBJ26A | D_SMB | D1 D3 | TVS verso il suo 0 V (§4.1)
1 | SMBJ5.0A | D_SMB | D13 | TVS verso il suo 0 V (§4.1)
7 | SS54 | D_SMC | D2 D4 D6 D8 D10 D12 D14 | Schottky inverso
2 | SMBJ22A | D_SMB | D5 D7 | TVS verso il suo 0 V (§4.1)
2 | SMBJ33A | D_SMB | D9 D11 | TVS verso il suo 0 V (§4.1)
2 | T4A | Fuseholder_Cylinder-5x20mm_Stelvio-Kontek_PTF78_Horizontal_Open | F1 F2 | fusibile di gruppo 5x20 (§4.3)
2 | T1A | Fuseholder_Cylinder-5x20mm_Stelvio-Kontek_PTF78_Horizontal_Open | F3 F4 | fusibile di gruppo 5x20 (§4.3)
1 | T500mA | Fuseholder_Cylinder-5x20mm_Stelvio-Kontek_PTF78_Horizontal_Open | F5 | fusibile di gruppo 5x20 (§4.3) | NOTA: 63 V per il clamp del TVS a 33 V di standoff
1 | T500mA | Fuseholder_Cylinder-5x20mm_Stelvio-Kontek_PTF78_Horizontal_Open | F6 | fusibile di gruppo 5x20 (§4.3)
1 | T2A | Fuseholder_Cylinder-5x20mm_Stelvio-Kontek_PTF78_Horizontal_Open | F7 | fusibile di gruppo 5x20 (§4.3)
1 | T500mA | Fuseholder_Cylinder-5x20mm_Stelvio-Kontek_PTF78_Horizontal_Open | F8 | fusibile delle ventole (§4.3)
1 | C96 maschio | DIN41612_C_3x32_Male_Horizontal_THT | J1 | DIN 41612 C 3x32, angolo retto | riga a intera, compresi i [M] a9-a12
1 | Mini-Fit Jr 2x12 | Molex_Mini-Fit_Jr_5566-24A2_2x12_P4.20mm_Vertical | J2 | NOTA: cavo interno dal connettore circolare del pannello posteriore (>= 5 A per contatto, §3)
1 | 1x3 driver ventole | PinHeader_1x03_P2.54mm_Vertical | J3 | NOTA: verso il driver lineare delle ventole (§4.5), circuito da progettare
1 | bond CHASSIS-AGND | PinHeader_1x02_P2.54mm_Vertical | JB1 | UNICO bond CHASSIS-AGND, removibile per la diagnosi del ronzio (grounding §2)
1 | 10k | R_0805_2012Metric | R1 | NOTA: pull-up dell'open collector AC_OK (§2.5)
4 | 0 | R_2512_6332Metric | R2 R3 R4 R5 | NOTA: ponte di stella (0 ohm 2512): un 0 V per conduttore
1 | 0 | R_2512_6332Metric | R6 | UNICO bond AGND-CTRL_GND (grounding §2)
