dj-filippo241/maelcum_mixer/pcb/fx-send/bom.csv

quantita | valore | impronta | riferimenti | nota
2 | 220u 35V | CP_Radial_D8.0mm_P3.50mm | C1 C2
2 | 1u 50V | C_1206_3216Metric | C12 C13
2 | 1u 25V | C_1206_3216Metric | C14 C15
18 | 100n | C_0805_2012Metric | C16 C17 C22 C23 C24 C25 C30 C31 C32 C33 C34 C35 C36 C37 C38 C39 C40 C41
4 | 180n C0G | C_1206_3216Metric | C18 C19 C26 C27
4 | 10n C0G | C_1206_3216Metric | C20 C21 C28 C29
1 | 47u 10V | CP_Radial_D5.0mm_P2.00mm | C3
2 | 10u 35V | CP_Radial_D5.0mm_P2.00mm | C4 C8
2 | 47u 35V | CP_Radial_D6.3mm_P2.50mm | C5 C9
2 | 470u 25V | CP_Radial_D8.0mm_P3.50mm | C6 C10
2 | 100u 25V | CP_Radial_D6.3mm_P2.50mm | C7 C11
1 | 1N4148W | D_SOD-123 | D1 | scarica Cadj
1 | S1G | D_SMA | D2 | protezione inversa
1 | 1N4148W | D_SOD-123 | D3
1 | S1G | D_SMA | D4
5 | ferrite 600R | L_1206_3216Metric | FB1 FB2 FB3 FB4 FB5
1 | C96 maschio | DIN41612_C_3x32_Male_Horizontal_THT | J1 | DIN 41612 C 3x32, angolo retto
1 | 2x12 cavo piatto | PinHeader_2x12_P2.54mm_Vertical | J2 | cavo piatto corto verso la scheda comandi (pot a bordo, dec. 133)
1 | 1x6 bottoni | PinHeader_1x06_P2.54mm_Vertical | J3 | bottoni assign dal pannello del canale (logica +5 V, dec. 133)
1 | BD139 | TO-126-3_Vertical | Q1
1 | BD140 | TO-126-3_Vertical | Q2
4 | 2N7002 | SOT-23 | Q3 Q4 Q5 Q6
2 | 120 1% | R_0805_2012Metric | R1 R4
2 | 5k23 0.1% | R_0805_2012Metric | R11 R24
2 | 2k49 0.1% | R_0805_2012Metric | R12 R25 | sim 2,5k: E96 2,49k
12 | 10k 0.1% | R_0805_2012Metric | R13 R14 R18 R19 R20 R21 R26 R27 R31 R32 R33 R34
6 | 49k9 0.1% | R_0805_2012Metric | R15 R16 R17 R28 R29 R30
1 | 1k74 1% | R_0805_2012Metric | R2 | E96 1,74k = 19,4 V (1,72k = 19,2 V non esiste all'1 %)
1 | 1k | R_0805_2012Metric | R3 | NOTA: cap-moltiplicatore scalato a ~50 mA (sim: 47R/10mF per 0,85 A)
4 | 10k | R_0805_2012Metric | R35 R38 R41 R44
4 | 1k | R_0805_2012Metric | R37 R40 R43 R46 | NOTA: mute a 0,45 V (VIL 0,8 V), rampa ~0,09 ms
1 | 100k | R_0805_2012Metric | R48 | c9 alto = muto (fail-safe), RISULTATI-mute-ctrl
1 | 1k74 1% | R_0805_2012Metric | R5
2 | 1k | R_0805_2012Metric | R6 R47
1 | 100k | R_0805_2012Metric | R7 | NOTA: tiene l'ingresso a massa senza canale
5 | 100k | R_0805_2012Metric | R8 R36 R39 R42 R45
4 | 324 0.1% | R_0805_2012Metric | R9 R10 R22 R23
1 | OPA1612AIDR | SOIC-8_3.9x4.9mm_P1.27mm | U1
1 | LM317 | TO-220-3_Vertical | U10
1 | LM337 | TO-220-3_Vertical | U11
1 | 78L15 | SOT-89-3 | U12
1 | 79L15 | SOT-89-3 | U13
4 | OPA1654AIDR | SOIC-14_3.9x8.7mm_P1.27mm | U2 U4 U3 U5
2 | ADG1434YRUZ | TSSOP-20_4.4x6.5mm_P0.65mm | U6 U7 | pinout e tabella di verità verificati, Rev. E
