dj-filippo241/maelcum_mixer/pcb/backplane/t1/bom.csv

quantita | valore | impronta | riferimenti | nota
18 | 100n 50V | C_0805_2012Metric | C1 C3 C5 C7 C9 C11 C13 C15 C17 C19 C21 C23 C25 C27 C29 C31 C33 C35 | bypass di slot (backplane §8)
18 | 10u 50V X7R | C_1206_3216Metric | C2 C4 C6 C8 C10 C12 C14 C16 C18 C20 C22 C24 C26 C28 C30 C32 C34 C36 | bulk di slot (backplane §8) | NOTA: MLCC 50 V
2 | PTC 0.3 A | Fuse_1812_4532Metric | F1 F2 | PTC di slot (psu-esterno §4.3) | NOTA: tenuta 0.3 A, >= 33 V, 1812
4 | PTC 0.05 A | Fuse_1812_4532Metric | F10 F12 F15 F17 | PTC di slot (psu-esterno §4.3) | NOTA: tenuta 0.05 A, >= 33 V, 1812
4 | PTC 0.5 A | Fuse_1812_4532Metric | F11 F13 F16 F18 | PTC di slot (psu-esterno §4.3) | NOTA: tenuta 0.5 A, >= 33 V, 1812
6 | PTC 0.2 A | Fuse_1812_4532Metric | F3 F4 F5 F6 F7 F8 | PTC di slot (psu-esterno §4.3) | NOTA: tenuta 0.2 A, >= 33 V, 1812
2 | PTC 0.1 A | Fuse_1812_4532Metric | F9 F14 | PTC di slot (psu-esterno §4.3) | NOTA: tenuta 0.1 A, >= 33 V, 1812
1 | ponticello J5W | PinHeader_2x02_P2.54mm_Vertical | J5W | ponticello di continuità (dec. 111): 5-way -> MSUM1 (EQ grafico dopo il 5-way) | due cavallotti 1-2 e 3-4
1 | C96 femmina 5W1 | DIN41612_C_3x32_Female_Vertical_THT | J5W1 | slot 5W1, classe 5way | pin da SINTETICO (backplane §4). Fila a a 2.11 mm dal piano medio della scheda di modulo, lato F del modulo verso la fila c (Harting 09 03 196 6921)
1 | C96 femmina 5W2 | DIN41612_C_3x32_Female_Vertical_THT | J5W2 | slot 5W2, classe 5way | pin da SINTETICO (backplane §4). Fila a a 2.11 mm dal piano medio della scheda di modulo, lato F del modulo verso la fila c (Harting 09 03 196 6921)
1 | cavo C1 T1-T2 (VE) | IDC-Header_2x05_P2.54mm_Vertical | JC1 | NOTA: cavo piatto, ogni segnale fra due fili di massa | solo net a massa virtuale
1 | cavo C2 T1-T2 (pilotato) | IDC-Header_2x05_P2.54mm_Vertical | JC2 | NOTA: cavo piatto, ogni segnale fra due fili di massa | solo linee pilotate
1 | cavo C5 T1-T4 (VE) | IDC-Header_2x05_P2.54mm_Vertical | JC5 | NOTA: cavo piatto, ogni segnale fra due fili di massa | solo net a massa virtuale
1 | cavo C6 T1-T4 (pilotato) | IDC-Header_2x10_P2.54mm_Vertical | JC6 | NOTA: cavo piatto, ogni segnale fra due fili di massa | solo linee pilotate
1 | C96 femmina MAS | DIN41612_C_3x32_Female_Vertical_THT | JMAS | slot MAS, classe master | pin da pcb/master/segnale (netlist). Fila a a 2.11 mm dal piano medio della scheda di modulo, lato F del modulo verso la fila c (Harting 09 03 196 6921)
1 | ponticello JMS | PinHeader_2x02_P2.54mm_Vertical | JMS | ponticello di continuità (dec. 111): inserzione del master (EQ grafico) | due cavallotti 1-2 e 3-4
1 | C96 femmina OUT_L | DIN41612_C_3x32_Female_Vertical_THT | JOUT_L | slot OUT_L, classe uscita | pin da pcb/master/uscita-L (netlist). Fila a a 2.11 mm dal piano medio della scheda di modulo, lato F del modulo verso la fila c (Harting 09 03 196 6921)
1 | C96 femmina OUT_R | DIN41612_C_3x32_Female_Vertical_THT | JOUT_R | slot OUT_R, classe uscita | pin da pcb/master/uscita-R (netlist). Fila a a 2.11 mm dal piano medio della scheda di modulo, lato F del modulo verso la fila c (Harting 09 03 196 6921)
1 | potenza P2 T1-T2 | Molex_Mini-Fit_Jr_5566-10A2_2x05_P4.20mm_Vertical | JP2 | NOTA: Mini-Fit Jr 2x5 | radiale AGND del tratto fino alla stella del PSU-IN (grounding §2)
1 | potenza P3 T1-T3 | Molex_Mini-Fit_Jr_5566-10A2_2x05_P4.20mm_Vertical | JP3 | NOTA: Mini-Fit Jr 2x5 | radiale AGND del tratto fino alla stella del PSU-IN (grounding §2)
1 | potenza P4 T1-T4 | Molex_Mini-Fit_Jr_5566-10A2_2x05_P4.20mm_Vertical | JP4 | NOTA: Mini-Fit Jr 2x5 | radiale AGND del tratto fino alla stella del PSU-IN (grounding §2)
1 | C96 femmina PSU | DIN41612_C_3x32_Female_Vertical_THT | JPSU | slot PSU, classe psu-in | pin da pcb/psu-in (netlist). Fila a a 2.11 mm dal piano medio della scheda di modulo, lato F del modulo verso la fila c (Harting 09 03 196 6921)
1 | presa JVIE | PinHeader_1x03_P2.54mm_Vertical | JVIE | NOTA: predisposizione VIE_TAP del master (UTIL-VIE, dec. 111), nessuno slot nella disposizione F
