dj-filippo241/maelcum_mixer/pcb/backplane/t3/bom.csv

quantita | valore | impronta | riferimenti | nota
5 | 100n 50V | C_0805_2012Metric | C1 C3 C5 C7 C9 | bypass di slot (backplane §8)
5 | 10u 50V X7R | C_1206_3216Metric | C2 C4 C6 C8 C10 | bulk di slot (backplane §8) | NOTA: MLCC 50 V
3 | PTC 0.1 A | Fuse_1812_4532Metric | F1 F2 F4 | PTC di slot (psu-esterno §4.3) | NOTA: tenuta 0.1 A, >= 33 V, 1812
2 | PTC 0.5 A | Fuse_1812_4532Metric | F3 F5 | PTC di slot (psu-esterno §4.3) | NOTA: tenuta 0.5 A, >= 33 V, 1812
1 | cavo C3 T2-T3 (pilotato) | IDC-Header_2x11_P2.54mm_Vertical | JC3 | NOTA: cavo piatto, ogni segnale fra due fili di massa | solo linee pilotate
1 | C96 femmina CUE | DIN41612_C_3x32_Female_Vertical_THT | JCUE | slot CUE, classe cue | pin da pcb/cue (netlist). Fila a a 2.11 mm dal piano medio della scheda di modulo, lato F del modulo verso la fila c (Harting 09 03 196 6921)
1 | potenza P3 T1-T3 | Molex_Mini-Fit_Jr_5566-10A2_2x05_P4.20mm_Vertical | JP3 | NOTA: Mini-Fit Jr 2x5 | radiale AGND del tratto fino alla stella del PSU-IN (grounding §2)
