dj-filippo241/maelcum_mixer/pcb/cue/comandi/bom.csv

quantita | valore | impronta | riferimenti | nota
1 | jack stereo 6,3 | Jack_6.35mm_Neutrik_NJ3FD-V_Vertical | J1 | punta L, anello R, manicotto HPG | PHONES 1 (dec. 128)
1 | jack stereo 6,3 | Jack_6.35mm_Neutrik_NJ3FD-V_Vertical | J2 | punta L, anello R, manicotto HPG | PHONES 2 (dec. 128)
1 | 2x7 cavo piatto | PinHeader_2x07_P2.54mm_Vertical | J3 | stesso ordine di J2 su cue.py (FILI)
1 | 2x3 cavo piatto | PinHeader_2x03_P2.54mm_Vertical | J4 | stesso ordine di J3 su cue.py (CUFFIE)
1 | 10k lin, scatto al centro | Potentiometer_Alps_RK09L_Double_Vertical | RV1 | BLEND: antiorario = cue, centro = 50/50 (-6 dB per parte), orario = master | manopola BLEND, pot di classe 14 mm, cappuccio 15.0 mm
1 | 10k log | Potentiometer_Alps_RK09L_Double_Vertical | RV2 | LEVEL: antiorario = silenzio vero (cursore a massa) | manopola LEVEL, pot di classe 14 mm, cappuccio 12.0 mm
