dj-filippo241/maelcum_mixer/pcb/fx-send/comandi/bom.csv

quantita | valore | impronta | riferimenti | nota
1 | 2x12 cavo piatto | PinHeader_2x12_P2.54mm_Vertical | J1 | stesso ordine di J2 su fx-send.py
1 | 10k doppio | Potentiometer_Alps_RK09L_Double_Vertical | RV1 | LEVEL: tutto antiorario = silenzio | manopola LEVEL, cappuccio 12.0 mm
1 | 10k doppio | Potentiometer_Alps_RK09L_Double_Vertical | RV2 | HIGH: tutto antiorario = kill (Rp1h = 0, fx-eq2.cir) | manopola EQ HIGH, cappuccio 6.0 mm
1 | 10k doppio | Potentiometer_Alps_RK09L_Double_Vertical | RV3 | LOW Baxandall: tutto antiorario = kill (Za max), cursore = massa virtuale | manopola EQ LOW, cappuccio 6.0 mm
