dj-filippo241/maelcum_mixer/pcb/mic/comandi/bom.csv

quantita | valore | impronta | riferimenti | nota
1 | LED bicolore VR 3 mm | LED_D3.0mm-3 | D1 | NOTA: un LED bicolore al centro (giallo = verde + rosso, celle_micmono.led3) | il render del pannello mostra tre punti a passo 4 mm
1 | 2x12 cavo piatto | PinHeader_2x12_P2.54mm_Vertical | J1 | stesso ordine di J2 sulla scheda principale (cavo.py)
1 | 5k C | Potentiometer_Alps_RK09L_Single_Vertical | RV1 | GAIN 0...+30 dB: orario = cursore verso GP1 (curva C, todo 131) | manopola GAIN, pot di classe 14 mm (RK09L: KiCad non ha l'RK14)
1 | 10k | Potentiometer_Alps_RK09L_Single_Vertical | RV2 | HIGH: tutto antiorario = kill | manopola EQ HIGH, pot di classe 9 mm (RK09L: KiCad non ha l'RK14)
1 | 10k | Potentiometer_Alps_RK09L_Single_Vertical | RV3 | LOW Baxandall: cursore = massa virtuale | manopola EQ LOW, pot di classe 9 mm (RK09L: KiCad non ha l'RK14)
1 | 10k | Potentiometer_Alps_RK09L_Single_Vertical | RV4 | SEND 1: tutto antiorario = silenzio | manopola SEND 1, pot di classe 14 mm (RK09L: KiCad non ha l'RK14)
1 | 10k | Potentiometer_Alps_RK09L_Single_Vertical | RV5 | SEND 2: tutto antiorario = silenzio | manopola SEND 2, pot di classe 14 mm (RK09L: KiCad non ha l'RK14)
1 | 10k | Potentiometer_Alps_RK09L_Single_Vertical | RV6 | SEND 3: tutto antiorario = silenzio | manopola SEND 3, pot di classe 14 mm (RK09L: KiCad non ha l'RK14)
1 | 10k | Potentiometer_Alps_RK09L_Single_Vertical | RV7 | SEND 4: tutto antiorario = silenzio | manopola SEND 4, pot di classe 14 mm (RK09L: KiCad non ha l'RK14)
1 | tasto MUTE | SW_PUSH_6mm | SW1 | NOTA: tasto a ritenuta fra +5VF e MUTE_SW
