dj-filippo241/maelcum_mixer/docs/11-benchmark-dimensioni.md

# Benchmark: dimensioni e cosa le decide (ricerca 2026-10-31, todo 203)

Domanda di Filippo: «come fanno gli altri mixer a rimanere così piccoli?», su tutti i modelli di
`docs/05` e `docs/07`. Misure cercate online il 31/10, fonti in fondo. «incerto» = fonti in
disaccordo o assi non dichiarati; «n.d.» = nessuna misura pubblicata trovata. Volume = L × P × A
del contenitore (per i corpi inclinati è un massimo).

## Tabella

| Modello | Tipo | L × P × A (mm) | Volume | Note sulla costruzione |
|---|---|---|---|---|
| E&S DJR400 | rotary 4 canali, cablato punto-punto | 280 × 210 × 70 (incerto) | ~4 L | pochi comandi, niente moduli |
| MasterSounds Radius 4 | rotary 4 canali | 330 × 190 × 76 (incerto) | ~5 L | isolator 2 incroci |
| Union Audio elara.4 MK2 | analogico 4 canali | 230 × 283 × 88 | ~6 L | isolator 3 bande |
| Condesa Carmen V | rotary 4 canali, tutto discreto | 340 × 260 × 80 | ~7 L | una recensione sola |
| A&H Xone:92 | analogico 6 canali, 2 VCF | 320 × 358 × 88 | ~10 L | — |
| PLAYdifferently Model 1 | analogico 6 canali | 320 × 368 × 104-115 (incerto) | ~12 L | filtri passivi |
| Rane MP2015 | rotary ibrido (DSP) | 333 × 356 × 109 (incerto) | ~13 L | — |
| Pioneer DJM-900NXS2 | digitale 4 canali | 333 × 414 × 108 | ~15 L | DSP, schermo, effetti |
| A&H Xone:96 | analogico + scheda audio | 336 × 410 × 109 | ~15 L | — |
| Bozak CMA-10-2DL | discreto, schede a innesto, 19" | 483 × 268 × 125 | ~16 L | moduli a innesto |
| Formula Sound FF6000 | analogico 6 canali, 19" 7U | 483 × 312 × 110 (incerto) | ~17 L | — |
| AlphaTheta Euphonia | rotary, mix digitale | 429 × 331 × 120 | ~17 L | — |
| Pioneer DJM-V10 | digitale 6 canali | 438 × 467 × 108 | ~22 L | — |
| Mackie 1604-VLZ4 | banco live 16 canali | 440 × 433 × 129 | ~25 L | banco economico |
| **A&H Xone:464** | **ibrido DJ + live, 19" 10U** | **483 × 444 × 135** (in rack) | **~29 L** | **una scheda verticale per canale** |
| **maelcum (proposte A-C)** | **analogico, 19" 12U, moduli** | **483 × 533 × 150-215** | **~47 L** | **~6.200 componenti, ~115 manopole** |
| Midas Venice F16 | banco live 16 canali, 19" 13U | 483 × 578 × 245 max (incerto) | ≤ ~68 L | rack, corpo inclinato |
| A&H GL2400-24 | banco live 24 canali | 817 × 560 × 150 | ~69 L | — |
| A&H GS-R24M | banco studio 24 canali | 1124 × ~612 × 191 (incerto) | ~130 L | — |
| Soundcraft Ghost 24 | banco studio 24 canali | largo 1059 (il Ghost LE 32: 1303 × 781 × 228) | > 150 L | — |
| API 1608-II | banco discreto | n.d. (disegno API: 957 mm su un lato, 104 kg) | — | moduli 500 |

Senza misure pubblicate (n.d.): Ligwa, Sage Sound (formato 5U / 3U), Klementz, SP Audio, Dub Sonic,
JB Audio Units, Jah Tubby's (rack 19" acciaio), Mostec, Abzu, Moses Audio (6U), Leviel 5W4U (4U),
Ras EFX, Jo Red, Valv-a-tron, BADDRIDDIM, UREI 1620, Isonoe ISO420 (12" × 12" in pianta), MCI di
King Tubby, Black Ark. JBK Audio è software.

## Cosa decide le dimensioni

1. **La superficie la decide il pannello, non l'elettronica.** I DJM digitali hanno pochissimi
   chip, eppure occupano 15-22 L: più dello Xone:92 analogico (10 L). Pianta grande = tanti
   comandi, schermo, spazio per le mani. Maelcum in pianta (483 × 533) è vicino allo Xone:464
   (483 × 444) e al Venice F16 (483 × 578).
2. **L'altezza sul tavolo la decide l'elettronica.** Tutti i mixer DJ stanno fra 70 e 120 mm, i
   banchi live analogici fra 130 e 230 mm. Lo Xone:464, analogico a schede verticali, sta in
   135 mm. Maelcum, con le proposte, va da 150 a 215 mm: è l'unico punto in cui è fuori misura.
3. **Pochi canali e poche funzioni = piccolo.** I rotary da 4-7 L hanno 4 canali, un isolator e
   quasi nient'altro. Maelcum ha 4 canali con isolator, 5-way con 5 vie, 4 bus FX con matrice,
   MIC, 3 MONO, filtro a 8 core, master a +24 dBu: è più vicino a un banco live che a un mixer DJ.
4. **Il digitale toglie chip, non pannello.** Un DSP sostituisce centinaia di parti analogiche,
   ma i DJM digitali restano alti ~108 mm come gli analogici: sotto quei 108 mm ci sono fader,
   pot e una o due schede piatte.
5. **I moduli costano spazio, ma poco.** Bozak (16 L) e Xone:464 (29 L) sono a schede a innesto
   e restano piccoli. La differenza con maelcum è il numero di componenti per modulo (trimmer,
   VCA, isolator a 24 sezioni per lato), non i moduli in sé.

## Cosa vuol dire per maelcum

- Il riferimento giusto è lo **Xone:464**: stessa larghezza 19", pianta simile, moduli verticali,
  135 mm di altezza in rack. Maelcum è ~60 % più voluminoso, quasi tutto in altezza.
- Per scendere verso 135 mm le leve sono quelle che riducono i componenti per modulo, o lo
  spazio sotto il pannello: parti più piccole e tetto più alto (dec. 134, 156), meno trimmer,
  pot saldati direttamente sulla scheda del modulo invece della scheda comandi col cavo
  (dec. 136). Togliere funzioni è l'ultima leva: le funzioni sono scelte di Filippo.
- I DJM digitali non sono il modello: sono piccoli per il pannello, non per l'elettronica.

## Fonti

Xone:92 [HTFR](https://htfr.com/allen-heath-xone-92.html) · Xone:96 [Gearbase](https://www.djresource.eu/Gearbase/gear/3443) ·
Xone:464 [Recordcase](https://www.recordcase.de/en/allen-heath-xone-464), [Musician's Friend](https://www.musiciansfriend.com/pro-audio/allen-heath-xone-464-16-input-pro-club-dj-mixer) ·
DJM-900NXS2 [Pioneer DJ](https://www.pioneerdj.com/en/product/mixer/archive/djm-900nxs2/black/specifications/) ·
DJM-V10 [DJ Solutions](https://www.dj-solutions.ie/store/mixers/dj-mixer/pioneer-djm-v10/) ·
Rane MP2015 [Seconcept](https://seconcept.com/products/mp2015) ·
E&S DJR400 [Music is my sanctuary](https://musicismysanctuary.com/djr-400-rotary-mixer-from-es) ·
Model 1 [Bonedo](https://www.bonedo.de/?p=263268), [Musicstore](https://www.musicstore.com/en_US/USD/PLAYdifferently-MODEL1/art-DJE0006406-000) ·
Radius 4 [The Vinyl Factory](https://thevinylfactory.com/news/mastersounds-new-generation-radius-rotary-mixers) ·
FF6000 [Leisuretec](https://leisuretec.co.uk/product/ff6000-6ch-dual-format-19quot-dj-mixer-with-linear-faders-webfor00001/NWRiOC9GRi02MDAwLU1hbnVhbC5wZGY=) ·
Euphonia [Full Compass](https://www.fullcompass.com/prod/630195-alphatheta-euphonia-professional-rotary-mixer) ·
Condesa Carmen V [Bonedo](https://www.bonedo.de/artikel/condesa-carmen-v-rotary-mixer-test/) ·
Bozak CMA-10-2DL [MoPOP](https://mopop.emuseum.com/objects/108624/bozak-cma102dl-stereo-mixerpreamplifier) ·
elara.4 MK2 [Musicstore](https://www.musicstore.de/en_GB/GBP/Union-Audio-ELARA-4-Mk2/art-DJE0008659-000) ·
Mackie 1604-VLZ4 [Thomann](https://thomannmusic.com/mackie_1604_vlz4.htm) ·
GL2400 [Pro Acoustics](https://www.proacousticsusa.com/allen-heath-gl2400-24-24-channel-live-sound-mixer.html) ·
GS-R24M [Pro Acoustics](https://www.proacousticsusa.com/allen-heath-gs-r24m-24-channel-studio-recording-mixer.html) ·
Venice F16 [Musicstore](https://musicstore.com/en_CH/CHF/Tannoy-Venice-F16-8-Mono-und-4-Stereo-Firewire/art-PAH0010998-000) ·
Ghost [specifiche Soundcraft](https://manualmachine.com/soundcraft/ghost/10457758-brochure), [Ghost LE](https://8thstreet.com/Product/Get/10567/soundcraft-ghost-le-32-channel-state-of-the-art-32-channel-analog-mixer) ·
API 1608-II [disegno API](https://www.APIaudio.com/docs/files/1608-II_dimensions_2021-05-24.pdf) ·
Mostec [Reggae Roast](https://reggaeroast.co.uk/products/mostec-preamp)
