dj-filippo241/maelcum_mixer/sim/eq_results.txt

MAELCUM MIXER — EQ 4 bande, celle a contribuzione bipolare
Baseline [PROVVISORIO]: 70/250/1k/5k Hz — analisi del 2026-09-18

=== detent — tutti i knob a 0 (deve essere piatto esatto) ===
   f[Hz]    dB
      10     0.00
      20     0.00
      35     0.00
      50     0.00
      70     0.00
     100     0.00
     150     0.00
     250     0.00
     400     0.00
     700     0.00
    1000     0.00
    1400     0.00
    2500     0.00
    3500     0.00
    5000     0.00
    8000     0.00
   12000     0.00
   20000     0.00
   35000     0.00

=== LOW kill (k=-1) ===
   f[Hz]    dB
      10   -73.63
      20   -49.59
      35   -30.50
      50   -19.23
      70   -10.67
     100    -5.04
     150    -2.08
     250    -0.71
     400    -0.27
     700    -0.09
    1000    -0.04
    1400    -0.02
    2500    -0.01
    3500    -0.00
    5000    -0.00
    8000    -0.00
   12000    -0.00
   20000    -0.00
   35000    -0.00

=== LOW boost +6 (k=+1) ===
   f[Hz]    dB
      10     6.02
      20     6.01
      35     5.89
      50     5.53
      70     4.65
     100     3.17
     150     1.68
     250     0.65
     400     0.26
     700     0.09
    1000     0.04
    1400     0.02
    2500     0.01
    3500     0.00
    5000     0.00
    8000     0.00
   12000     0.00
   20000     0.00
   35000     0.00

=== LOW-MID kill ===
   f[Hz]    dB
      10    -0.00
      20    -0.02
      35    -0.06
      50    -0.12
      70    -0.25
     100    -0.59
     150    -1.94
     250  -180.00 <-
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
2. Boost LOW a 20 Hz: +6.01 dB (atteso ~+6)
3. Kill LOW a 20 Hz: -49.6 dB (atteso molto profondo)
4. Boost MID-HIGH a 1 kHz: +6.02 dB (atteso +6.02)
5. Worst boost (4 bande a +6): picco +6.64 dB (sovrapposizione bande)
6. Worst cut (4 bande kill): residuo massimo -2.6 dB nelle sovrapposizioni
