dj-filippo241/maelcum_mixer/pcb/schematics-readable.pdf

1 | 2 | 3 | 4 | 5 | 6 | 7 | 8
1 | 2 | 3 | 4 | 5 | 6 | 7 | 8

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
F Date:
KiCad E.D.A. 10.0.7
Size: A3 | Rev: Id: 1/1

## Title: maelcum mixer - readable schematics

File: schematics-cover.kicad_sch

Sheet: /

Generated by pcb/tools/leggibile.py

# maelcum mixer - readable schematics of the generated boards

# One page per board. Each drawing is generated from the same netlist as the board's PCB

and checked against it in both directions (pcb/tools/leggibile.py). Values are PROVISIONAL drafts.

2 | maelcum CHANNEL CDJ/LINE (v0.4) - draft v0.1 (383 parts, rev. 0.2-draft)
3 | maelcum CHANNEL control board - draft v0.1 (34 parts, rev. 0.1-draft)

# Page Board

4 | maelcum FX-SEND (dec. 91a) - draft v0.2 (120 parts, rev. 0.3-draft)
5 | maelcum FX-SEND control board - draft v0.2 (4 parts, rev. 0.2-draft)
6 | maelcum FX-RET (dec. 130) - draft v0.1 (199 parts, rev. 0.1-draft)
7 | maelcum FX-RET reroute (dec. 91) - draft v0.1 (225 parts, rev. 0.1-draft)
8 | maelcum FX-RET control board - draft v0.1 (23 parts, rev. 0.1-draft)
9 | maelcum MASTER signal board (dec. 140) - draft v0.1 (285 parts, rev. 0.2-draft)
10 | maelcum MASTER OUTPUT board L (dec. 142-143) - draft v0.1 (155 parts, rev. 0.1-draft)
12 | maelcum MASTER control board - draft v0.1 (60 parts, rev. 0.1-draft)
13 | maelcum MIC (dec. 97) - draft v0.1 (213 parts, rev. 0.1-draft)
14 | maelcum MIC control board - draft v0.1 (10 parts, rev. 0.1-draft)
15 | maelcum MONO (dec. 97) - draft v0.1 (127 parts, rev. 0.1-draft)
16 | maelcum MONO control board - draft v0.1 (9 parts, rev. 0.1-draft)
18 | maelcum CUE control board - draft v0.1 (6 parts, rev. 0.1-draft)
19 | maelcum PSU-IN (dec. 113) - draft v0.1 (41 parts, rev. 0.1-draft)
11 | maelcum MASTER OUTPUT board R (dec. 142-143) - draft v0.1 (144 parts, rev. 0.1-draft)
20 | maelcum backplane T1 (rear: MASTER, 5-WAY, PSU-IN) - draft v0.1 (75 parts, rev. 0.1-draft)
21 | maelcum backplane T2 (channels: FILTER, 4 CHANNELS, 4 FX-SEND) - draft v0.1 (170 parts, rev. 0.1-draft)
23 | maelcum backplane T4 (right: MIC, 3 MONO, 4 FX-RET) - draft v0.1 (137 parts, rev. 0.1-draft) - Arrow and ground symbols are power rails and grounds; the name under the symbol is the rail (AGND, +18V, -15SW ...).
17 | maelcum CUE / cuffie (sistema-cue v0.2) - draft v0.1 (160 parts, rev. 0.1-draft)
22 | maelcum backplane T3 (headphones: CUE) - draft v0.1 (22 parts, rev. 0.1-draft)

How to read the drawings - Resistors and capacitors are wired to the op-amp pin they touch: in series along the pin, shunt towards the rail. - A plain name on a wire is a net that continues elsewhere in the same block. - A name in a box is a net that goes to another block on the same board, or to a connector. - Connectors and many-pin chips (C96, LM339, ADG1434) carry only names; their parts are drawn in chains below them. - Dashed frames are the functional blocks of the board, in signal order. Net names are the PCB identifiers.

# J1A C96 male RAW+22 RAW+22 RAW-22 RAW-22

# V22F- V-

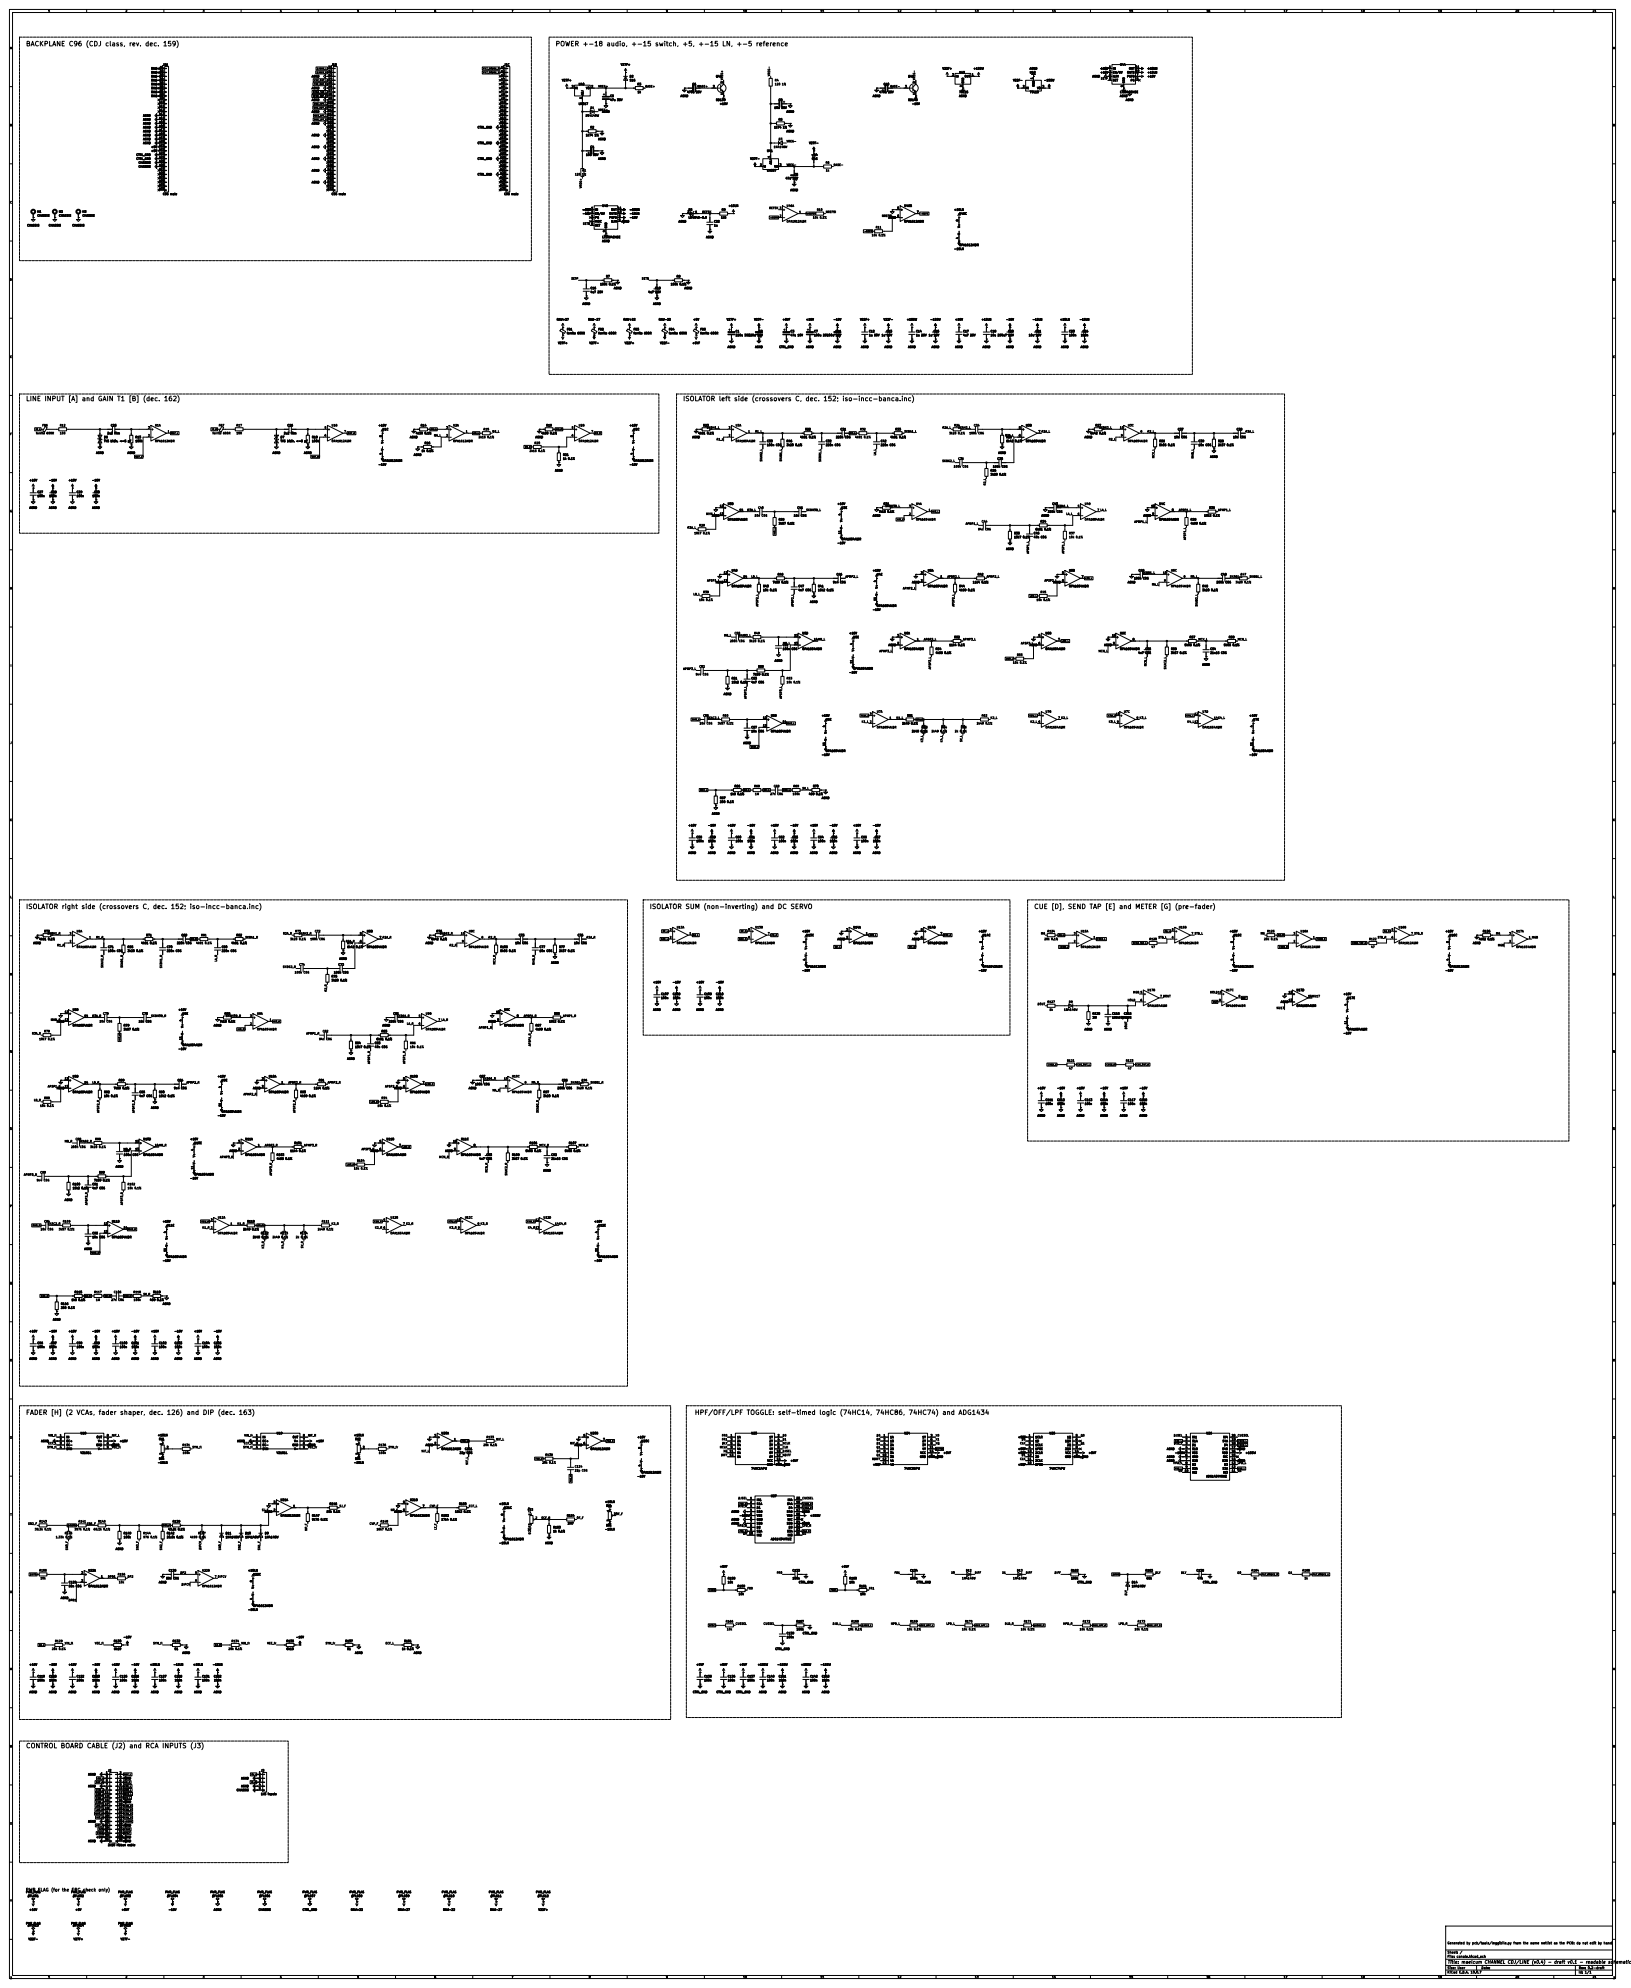
[picture p3: page 2]

BACKPLANE C96 (CDJ class, rev. dec. 159)

POWER +-18 audio, +-15 switch, +5, +-15 LN, +-5 reference

J1A C96 male
C96 male RAW+27 RAW+27 RAW-27 RAW-27

RAW-27 RAW-27 RAW+27 RAW+27

c32 RAW-22 RAW-22 RAW+22 RAW+22

LINE INPUT [A] and GAIN T1 [B] (dec. 162)

ISOLATOR left side (crossovers C, dec. 152; iso-incc-banca.inc)

ISOLATOR right side (crossovers C, dec. 152; iso-incc-banca.inc)

FADER [H] (2 VCAs, fader shaper, dec. 126) and DIP (dec. 163)

HPF/OFF/LPF TOGGLE: self-timed logic (74HC14, 74HC86, 74HC74) and ADG1434

CONTROL BOARD CABLE (J2) and RCA INPUTS (J3)
MET
2x18 ribbon cable

PWR_FLAG (for the ERC check only)
+18V #FLG01 PWR_FLAG

Generated by pcb/tools/leggibile.py from the same netlist as the PCB: do not edit by hand

Sheet: /
File: canale.kicad_sch
Title: maelcum CHANNEL CDJ/LINE (v0.4) - draft v0.1 - readable schematic

# levetta LINE/PHONO +5VF

# GW_L +5VF_FXS MET

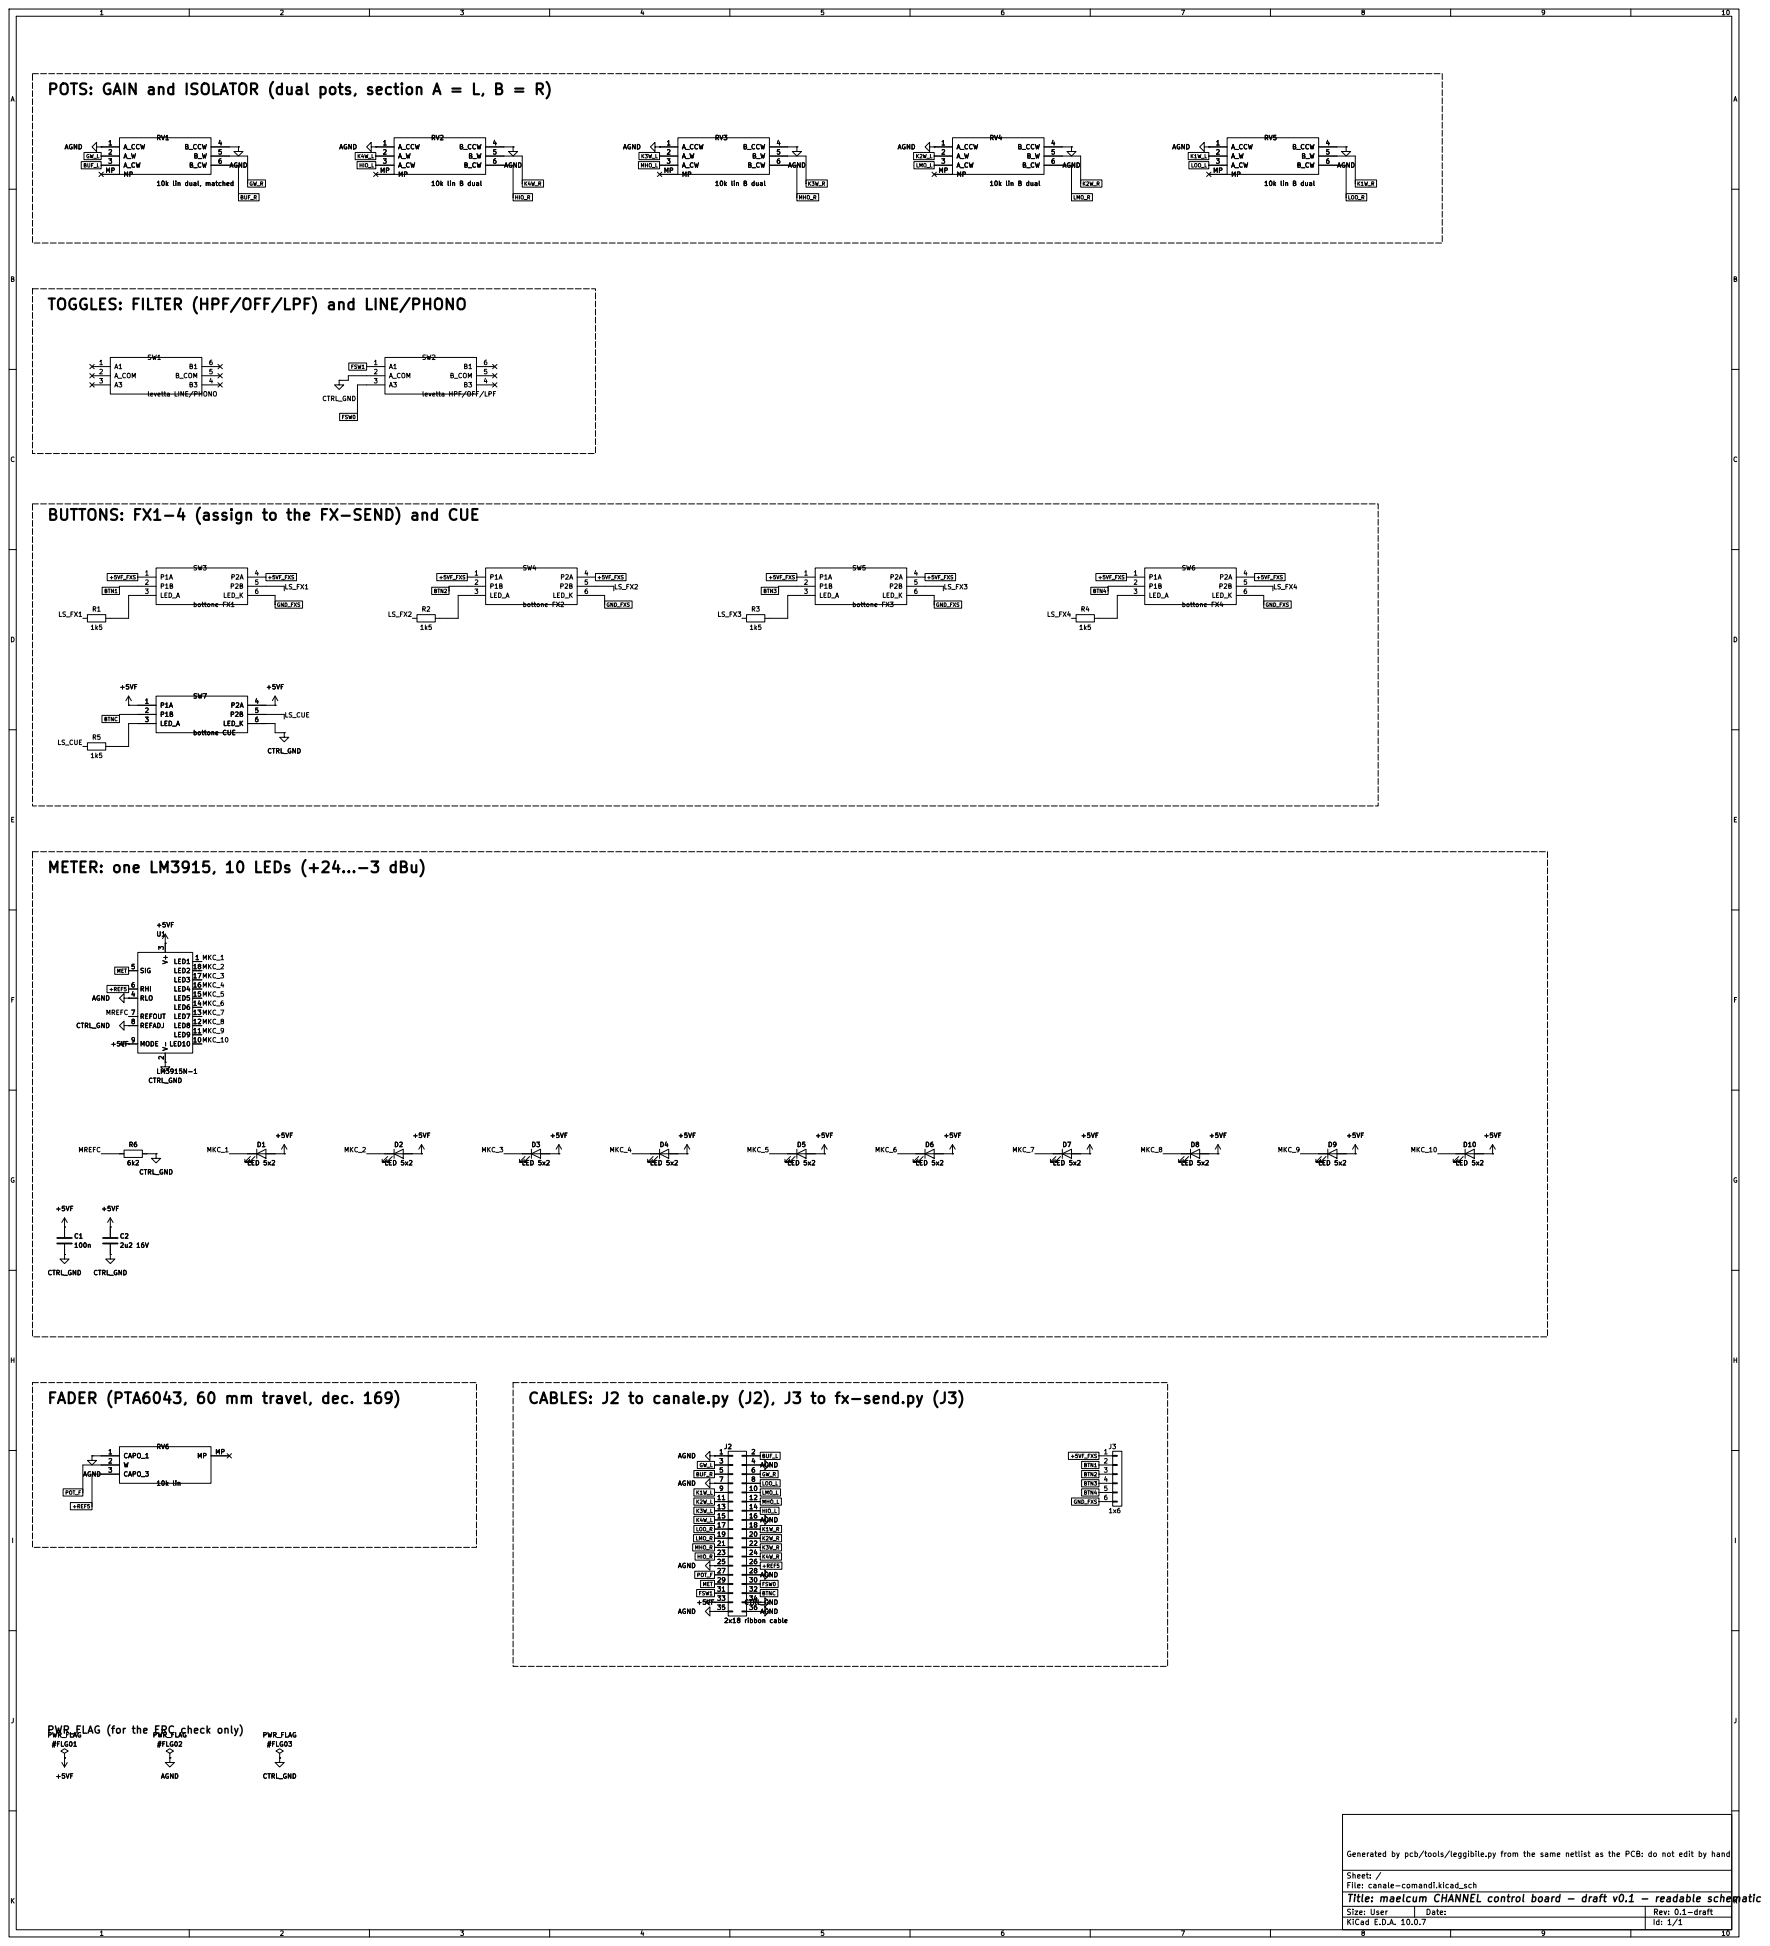
[picture p4: page 3]

POTS: GAIN and ISOLATOR (dual pots, section A = L, B = R)

TOGGLES: FILTER (HPF/OFF/LPF) and LINE/PHONO

levetta HPF/OFF/LPF

LS_FX3 BUTTONS: FX1-4 (assign to the FX-SEND) and CUE

FADER (PTA6043, 60 mm travel, dec. 169)

CABLES: J2 to canale.py (J2), J3 to fx-send.py (J3)
GW_L K2W_L POT_F MHO_R
FSW1 BUF_R
AGND

PWR_FLAG (for the ERC check only)
#FLG01 PWR_FLAG

File: canale-comandi.kicad_sch
Title: maelcum CHANNEL control board - draft v0.1 - readable schematic

# 220u 35V C6

100k V+

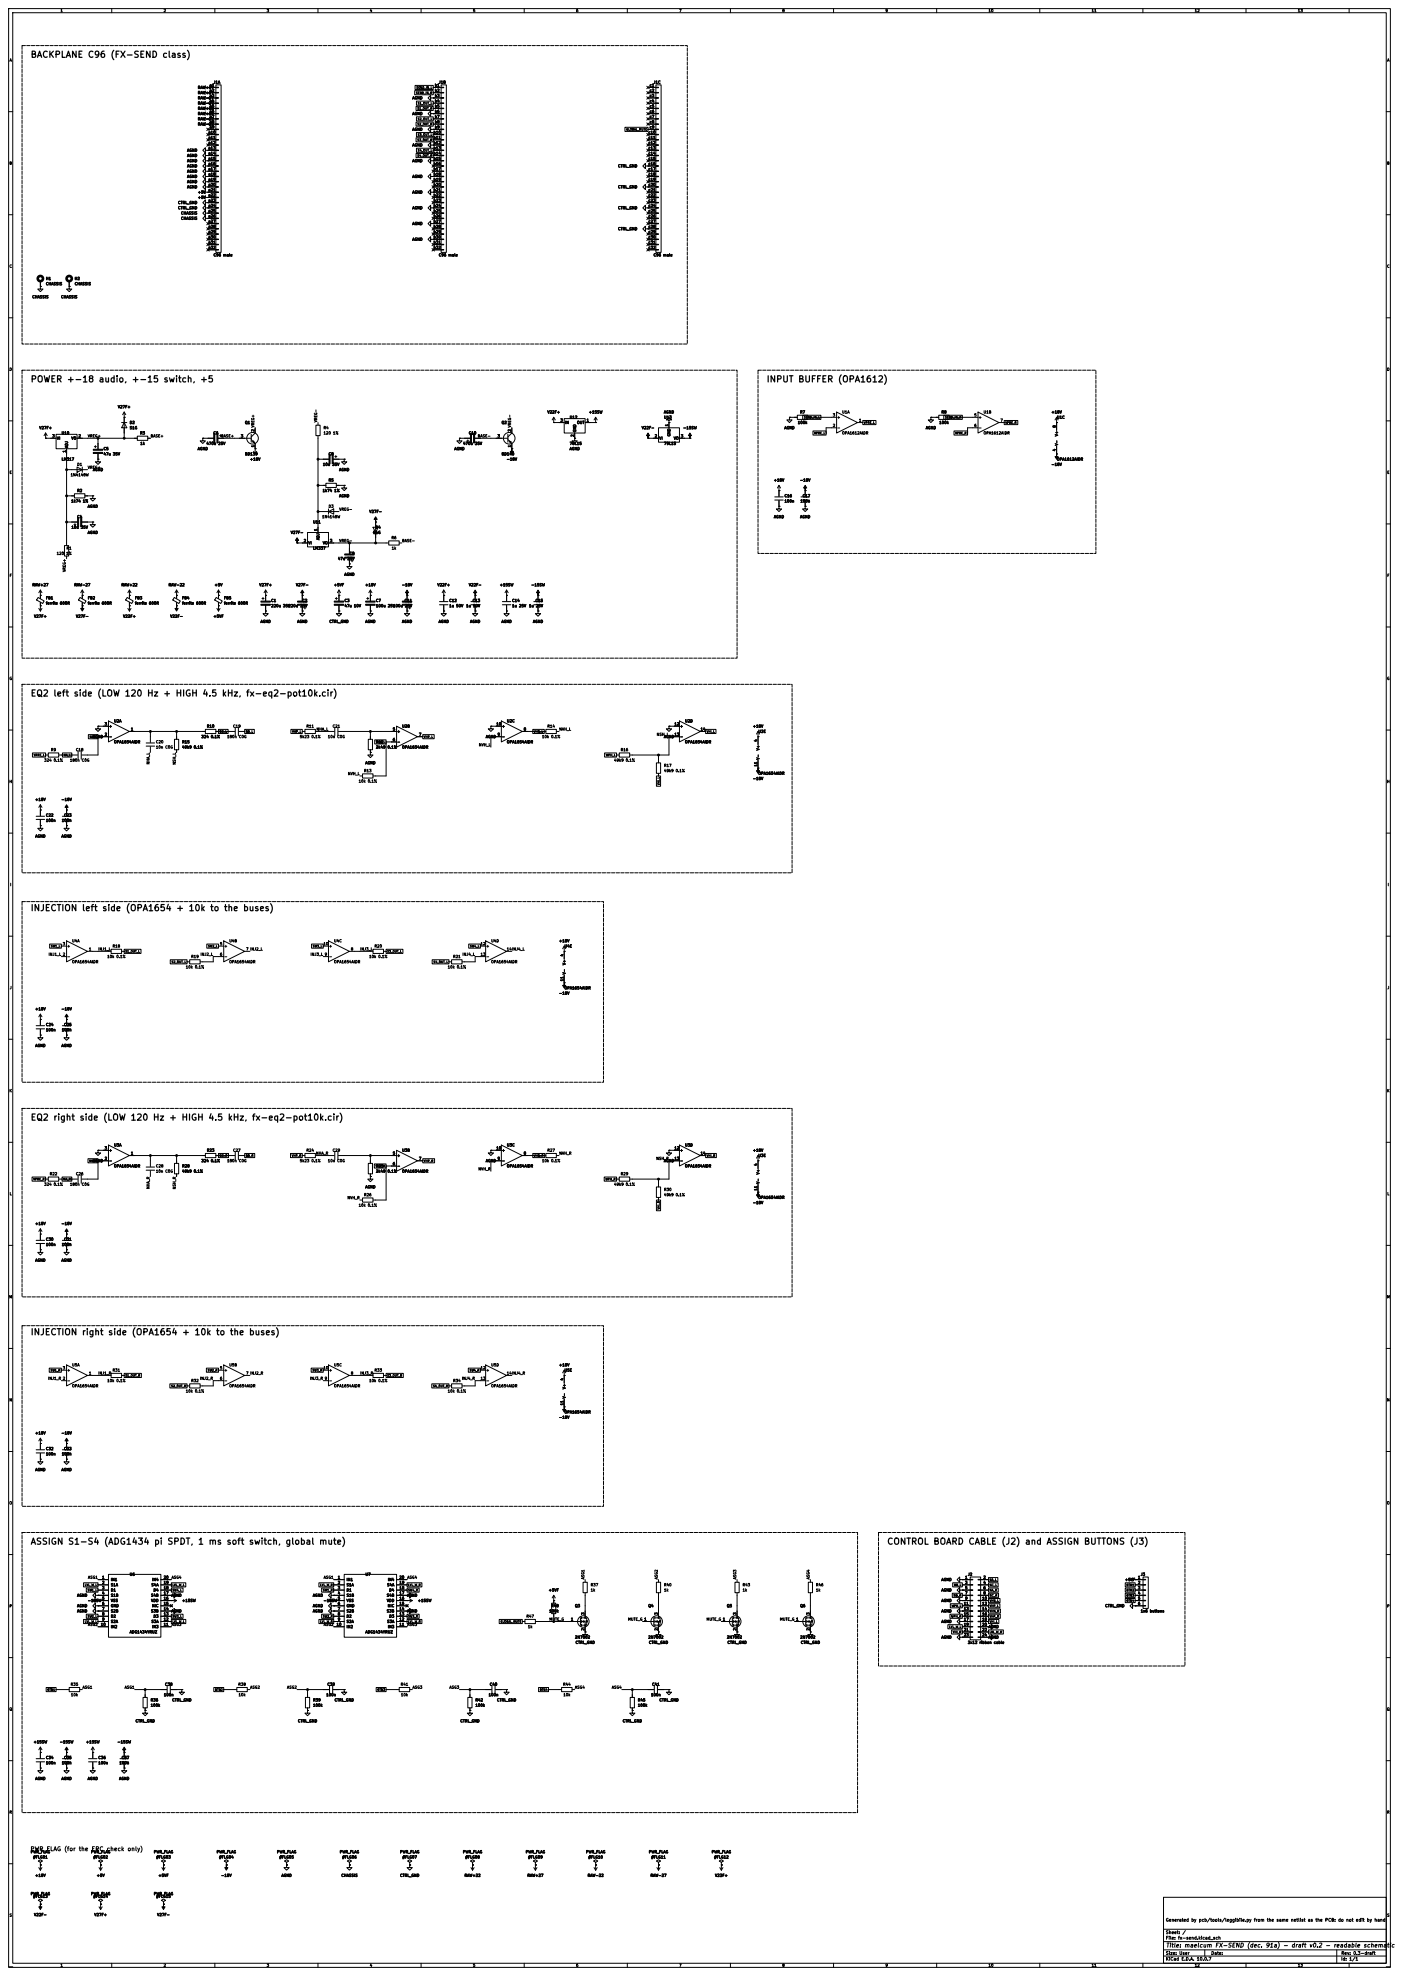
[picture p5: page 4]

BACKPLANE C96 (FX-SEND class)

CHASSIS CHASSIS RAW+27 RAW-27 RAW-27 RAW+27
RAW-22 RAW+22 RAW-22 RAW+22 +5V

EQ2 left side (LOW 120 Hz + HIGH 4.5 kHz, fx-eq2-pot10k.cir)

INJECTION left side (OPA1654 + 10k to the buses)

EQ2 right side (LOW 120 Hz + HIGH 4.5 kHz, fx-eq2-pot10k.cir)

INJECTION right side (OPA1654 + 10k to the buses)

Generated by pcb/tools/leggibile.py from the same netlist as the PCB: do not edit by hand ⁺⁵VF

File: fx-send.kicad_sch
Title: maelcum FX-SEND (dec. 91a) - draft v0.2 - readable schematic

# VHP_L WPH_L CABLE TO THE MAIN BOARD

# POTS (positions from the panel render)

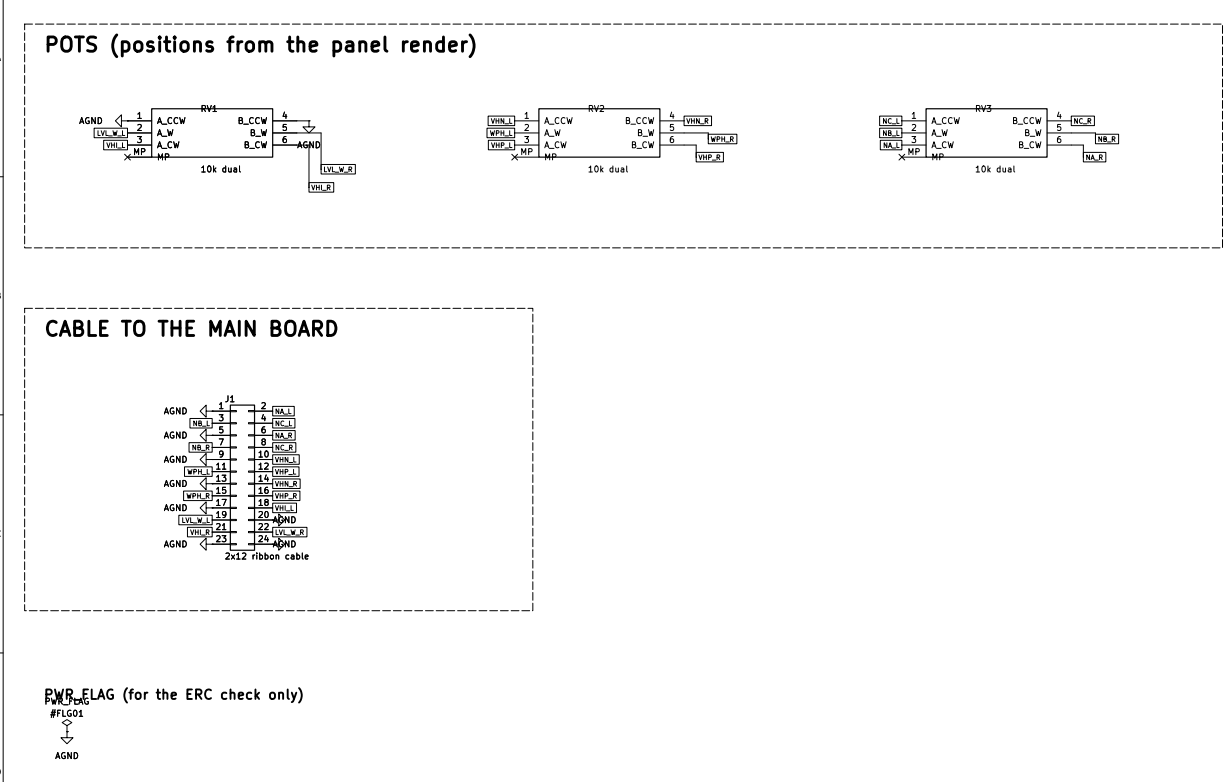
[picture p6: page 5]
FGH; FGH Date:; Size: User; Rev: 0.2-draft; A_CCW 1 A_W 2; B_CCW; 10k dual AGND; AGND; 2x12 ribbon cable; A_CCW 1; 10k dual; 10k dual VHN_L NB_R; VHN_R WPH_R; LVL_W_R; VHI_R; LVL_W_L VHI_L; VHP_R WPH_R; LVL_W_L; NC_R WPH_L VHI_R; VHN_R; VHP_L NA_L; VHN_L NA_R; VHI_L VHP_R; RV1 10k dual A_CCW 1 A_W 2; 2x12 ribbon cable 1; #FLG01 PWR_FLAG

PWR_FLAG (for the ERC check only)
#FLG01 PWR_FLAG

File: fx-send-comandi.kicad_sch
Title: maelcum FX-SEND control board - draft v0.2 - readable schematic

# 51 ADJ 1

# 3 Q40 BD139

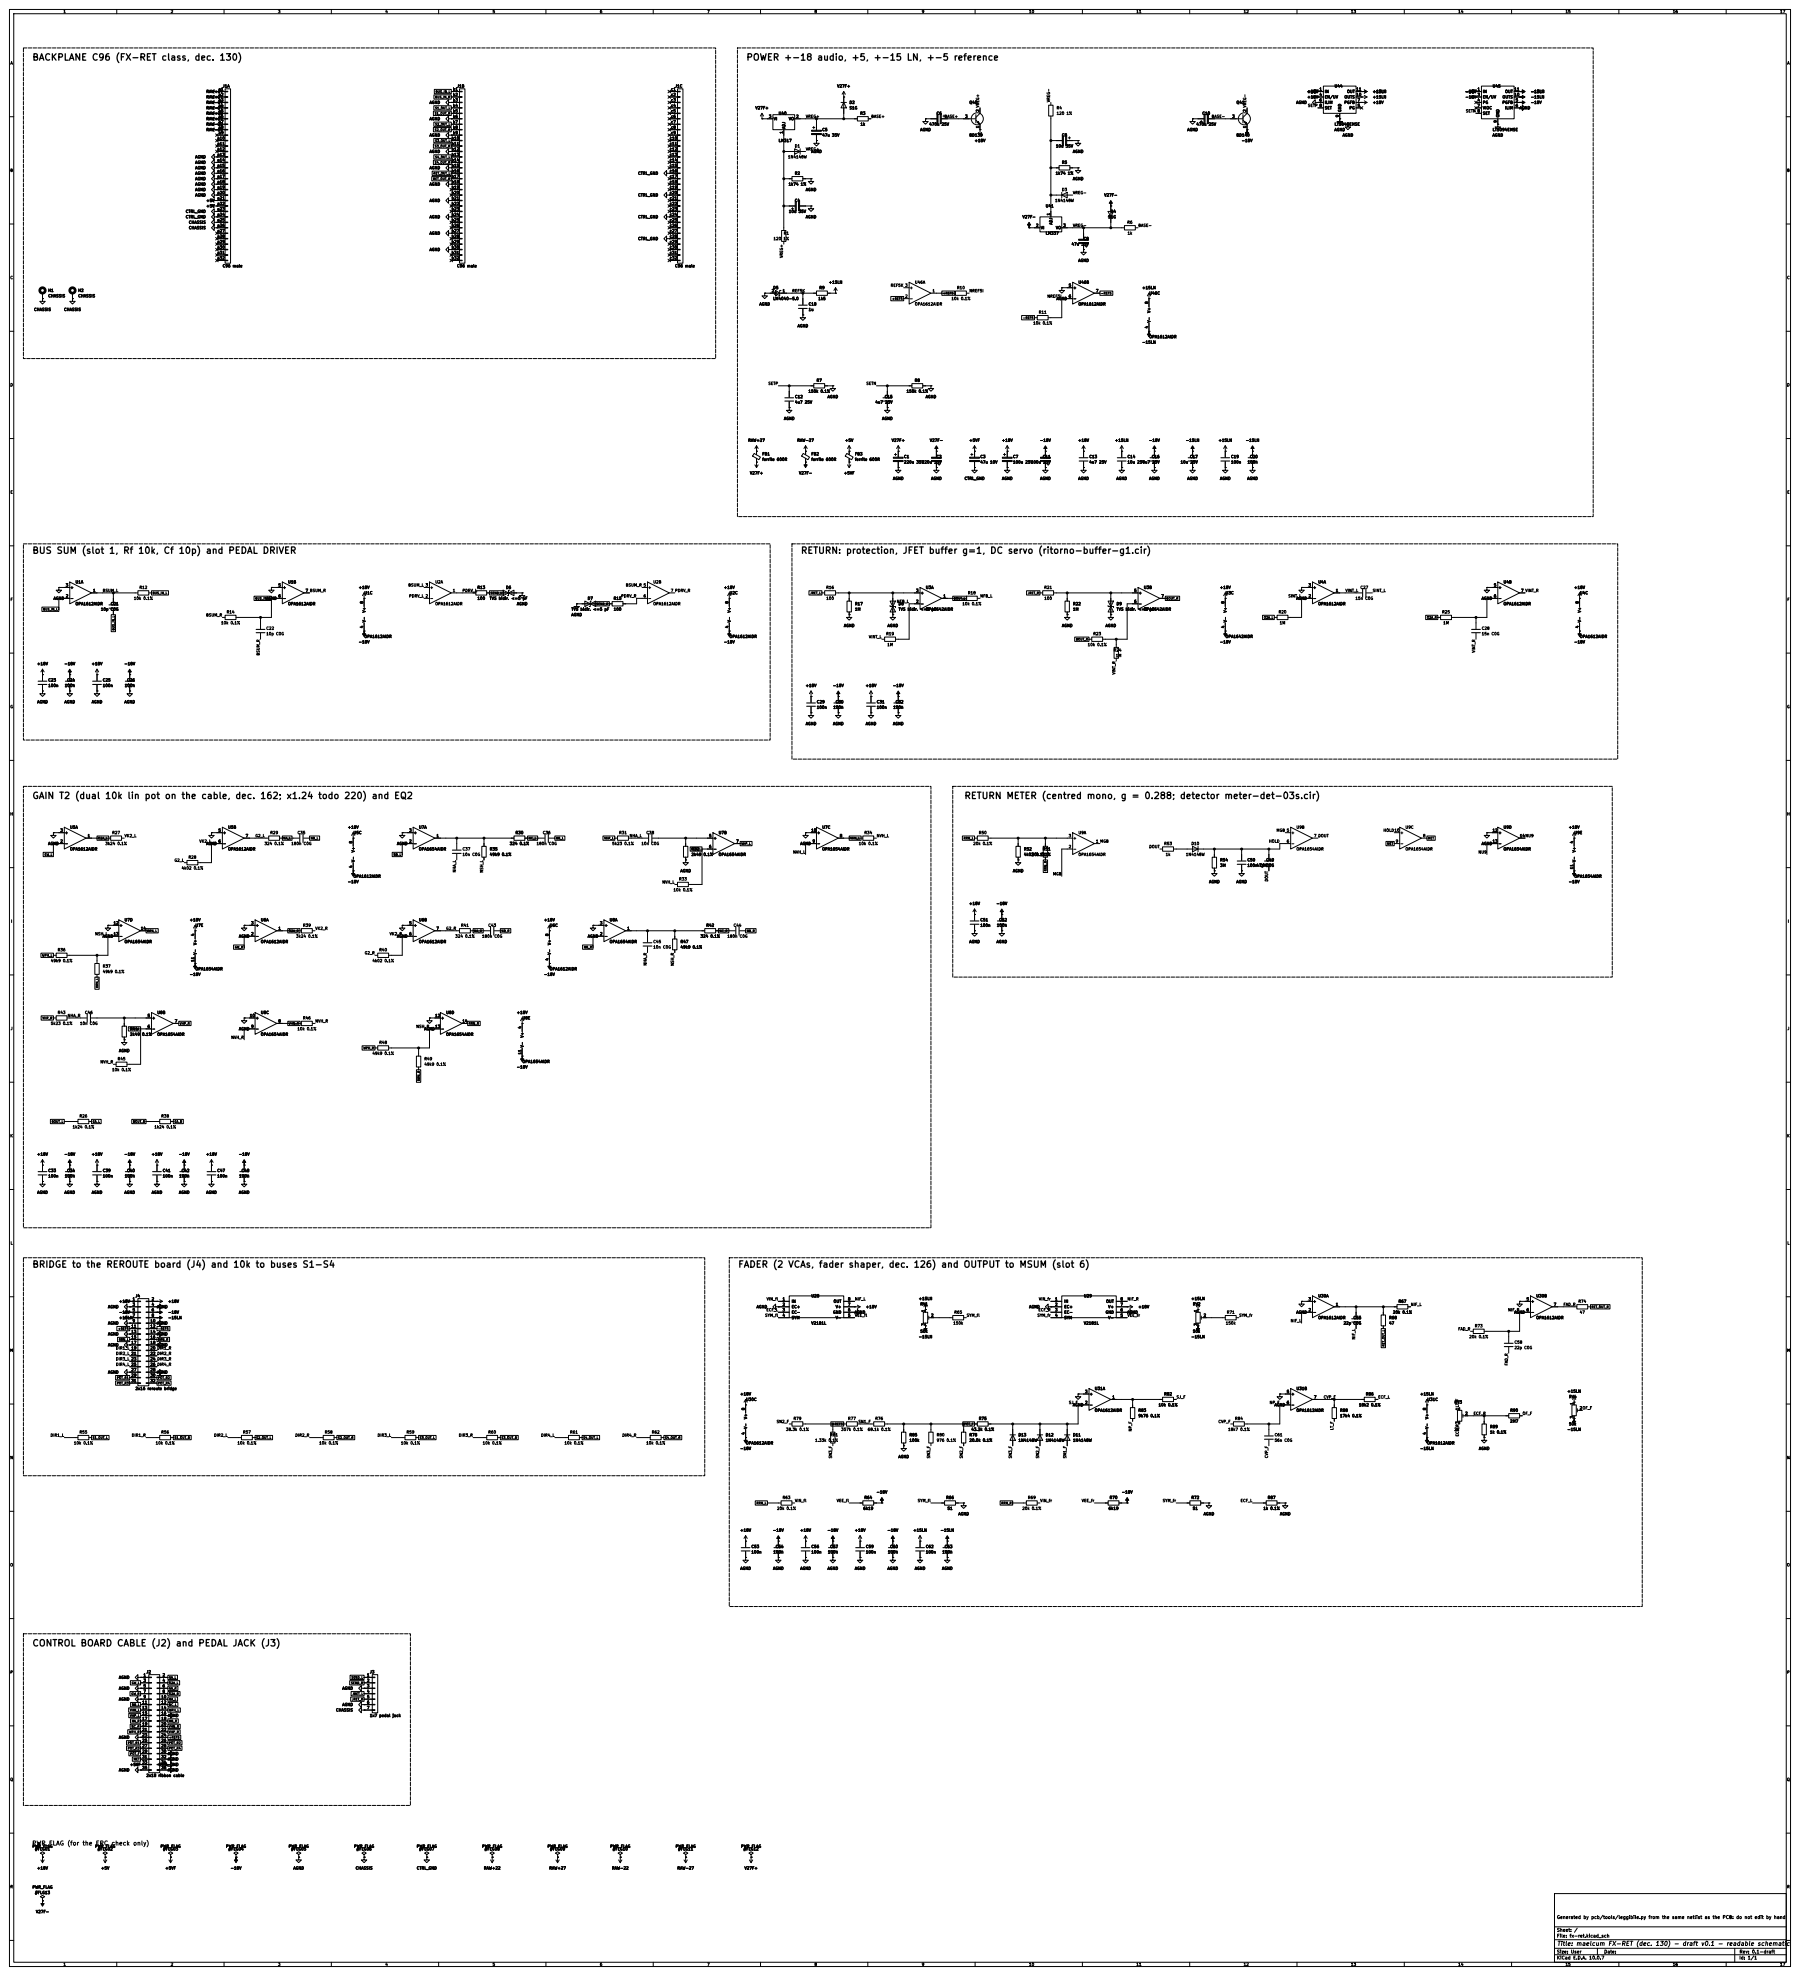
[picture p7: page 6]

BACKPLANE C96 (FX-RET class, dec. 130)

POWER +-18 audio, +5, +-15 LN, +-5 reference

J1A C96 male
CHASSIS RAW-22 RAW-22 RAW+22 RAW-27 RAW+27 RAW-27 RAW+27 RAW+22

RETURN: protection, JFET buffer g=1, DC servo (ritorno-buffer-g1.cir)

GAIN T2 (dual 10k lin pot on the cable, dec. 162; x1.24 todo 220) and EQ2

RETURN METER (centred mono, g = 0.288; detector meter-det-03s.cir)

BRIDGE to the REROUTE board (J4) and 10k to buses S1-S4

FADER (2 VCAs, fader shaper, dec. 126) and OUTPUT to MSUM (slot 6)

File: fx-ret.kicad_sch
Title: maelcum FX-RET (dec. 130) - draft v0.1 - readable schematic

20k 0.1% V-
-18V V-

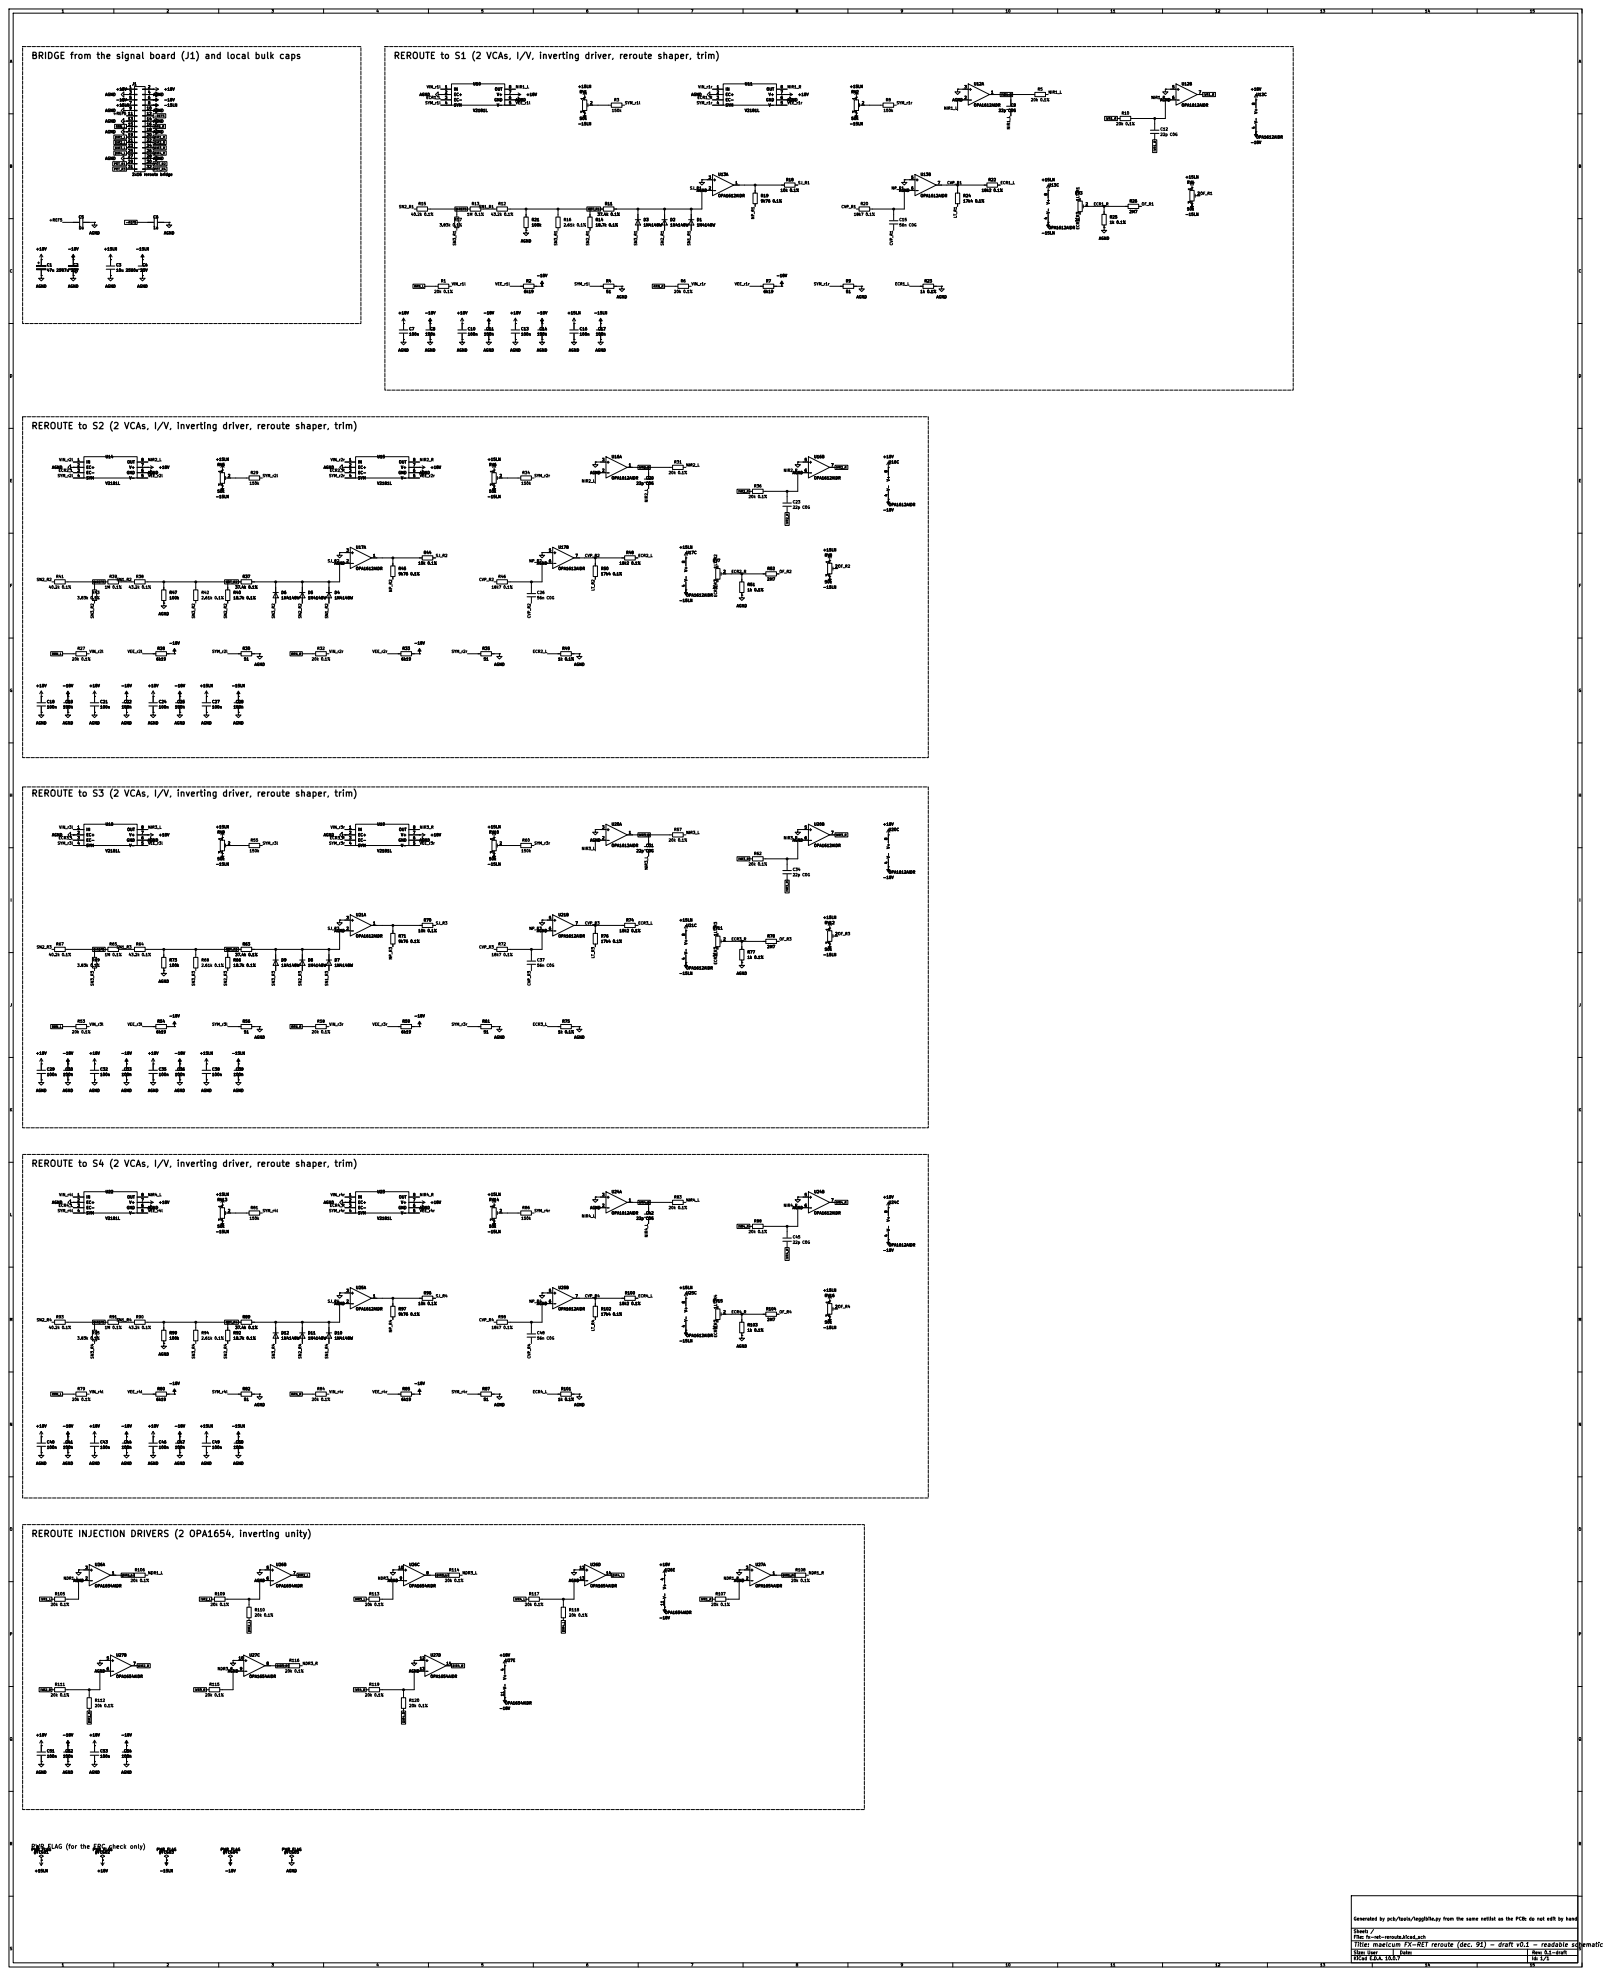
[picture p8: page 7]

REROUTE to S2 (2 VCAs, I/V, inverting driver, reroute shaper, trim)

CVP_R3 REROUTE to S3 (2 VCAs, I/V, inverting driver, reroute shaper, trim)

REROUTE to S4 (2 VCAs, I/V, inverting driver, reroute shaper, trim)

REROUTE INJECTION DRIVERS (2 OPA1654, inverting unity)

File: fx-ret-reroute.kicad_sch
Title: maelcum FX-RET reroute (dec. 91) - draft v0.1 - readable schematic

# 10k dual +5VF +5VF D1

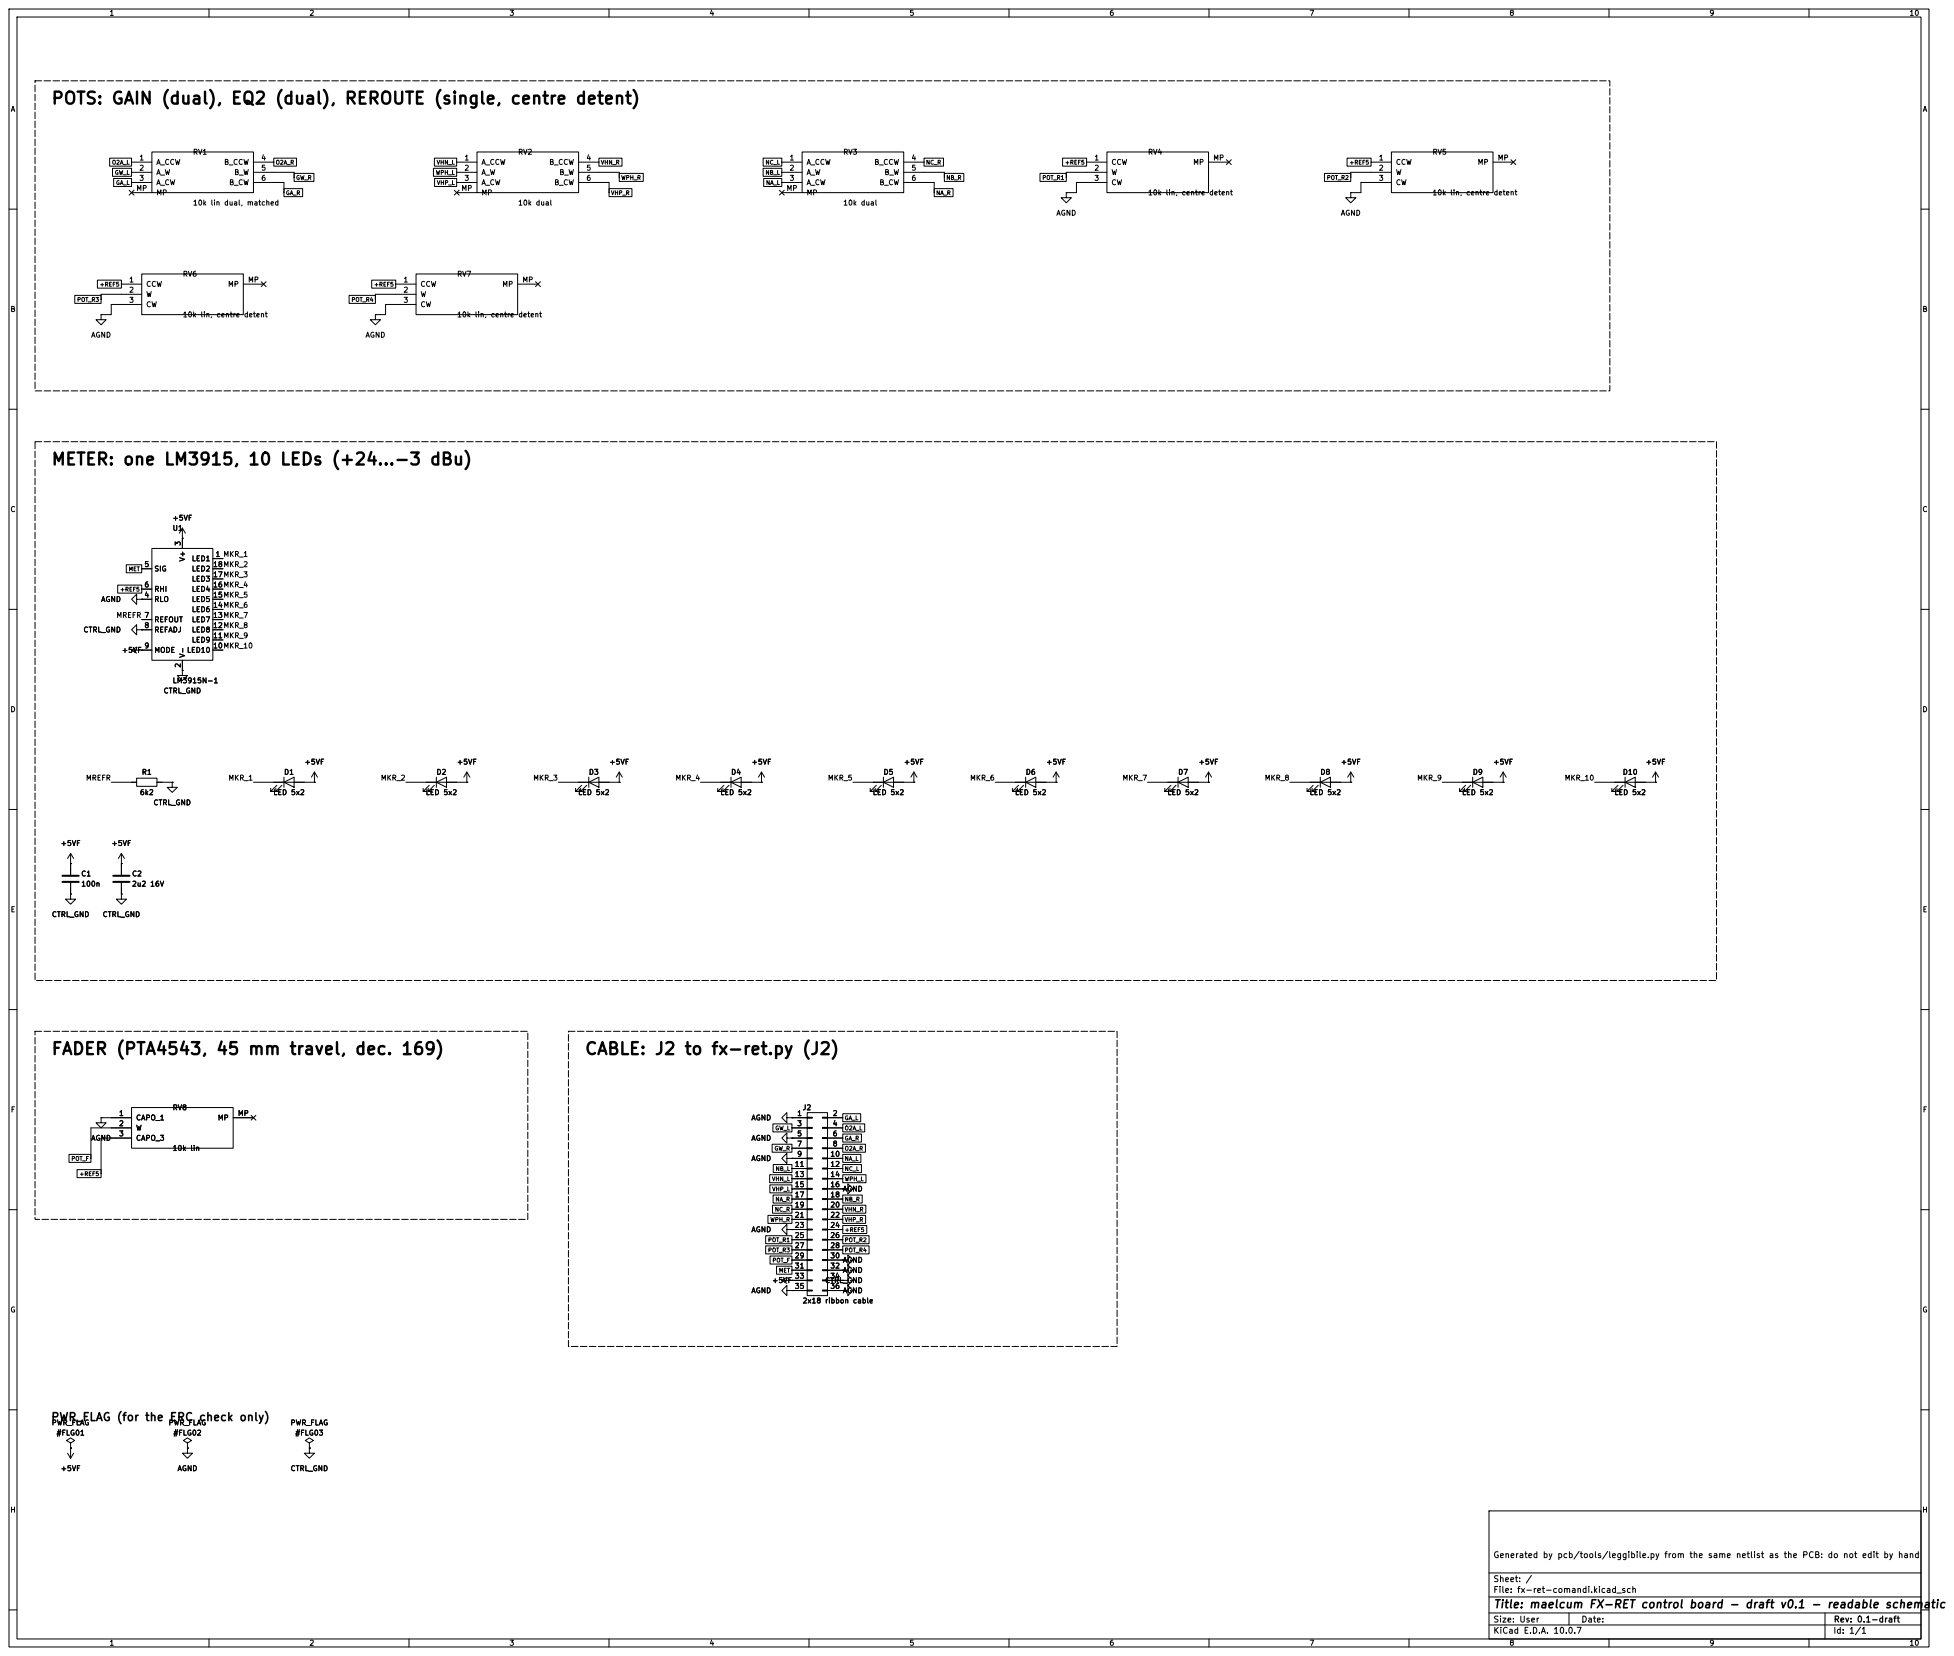
[picture p9: page 8]

METER: one LM3915, 10 LEDs (+24...-3 dBu)
LED10 10 LED9 11 LED8 12 LED7 13 LED6 14 LED5 15 LED4 16 LED3 17 LED2 18 U1
LED1 1 V-
SIG 5 RHI 6 REFOUT 7 REFADJ 8 MODE 9
LED 5x2 D3

FADER (PTA4543, 45 mm travel, dec. 169)

PWR_FLAG (for the ERC check only)
#FLG01 PWR_FLAG

File: fx-ret-comandi.kicad_sch
Title: maelcum FX-RET control board - draft v0.1 - readable schematic

# AGND V-

# 3 Q40 BD139

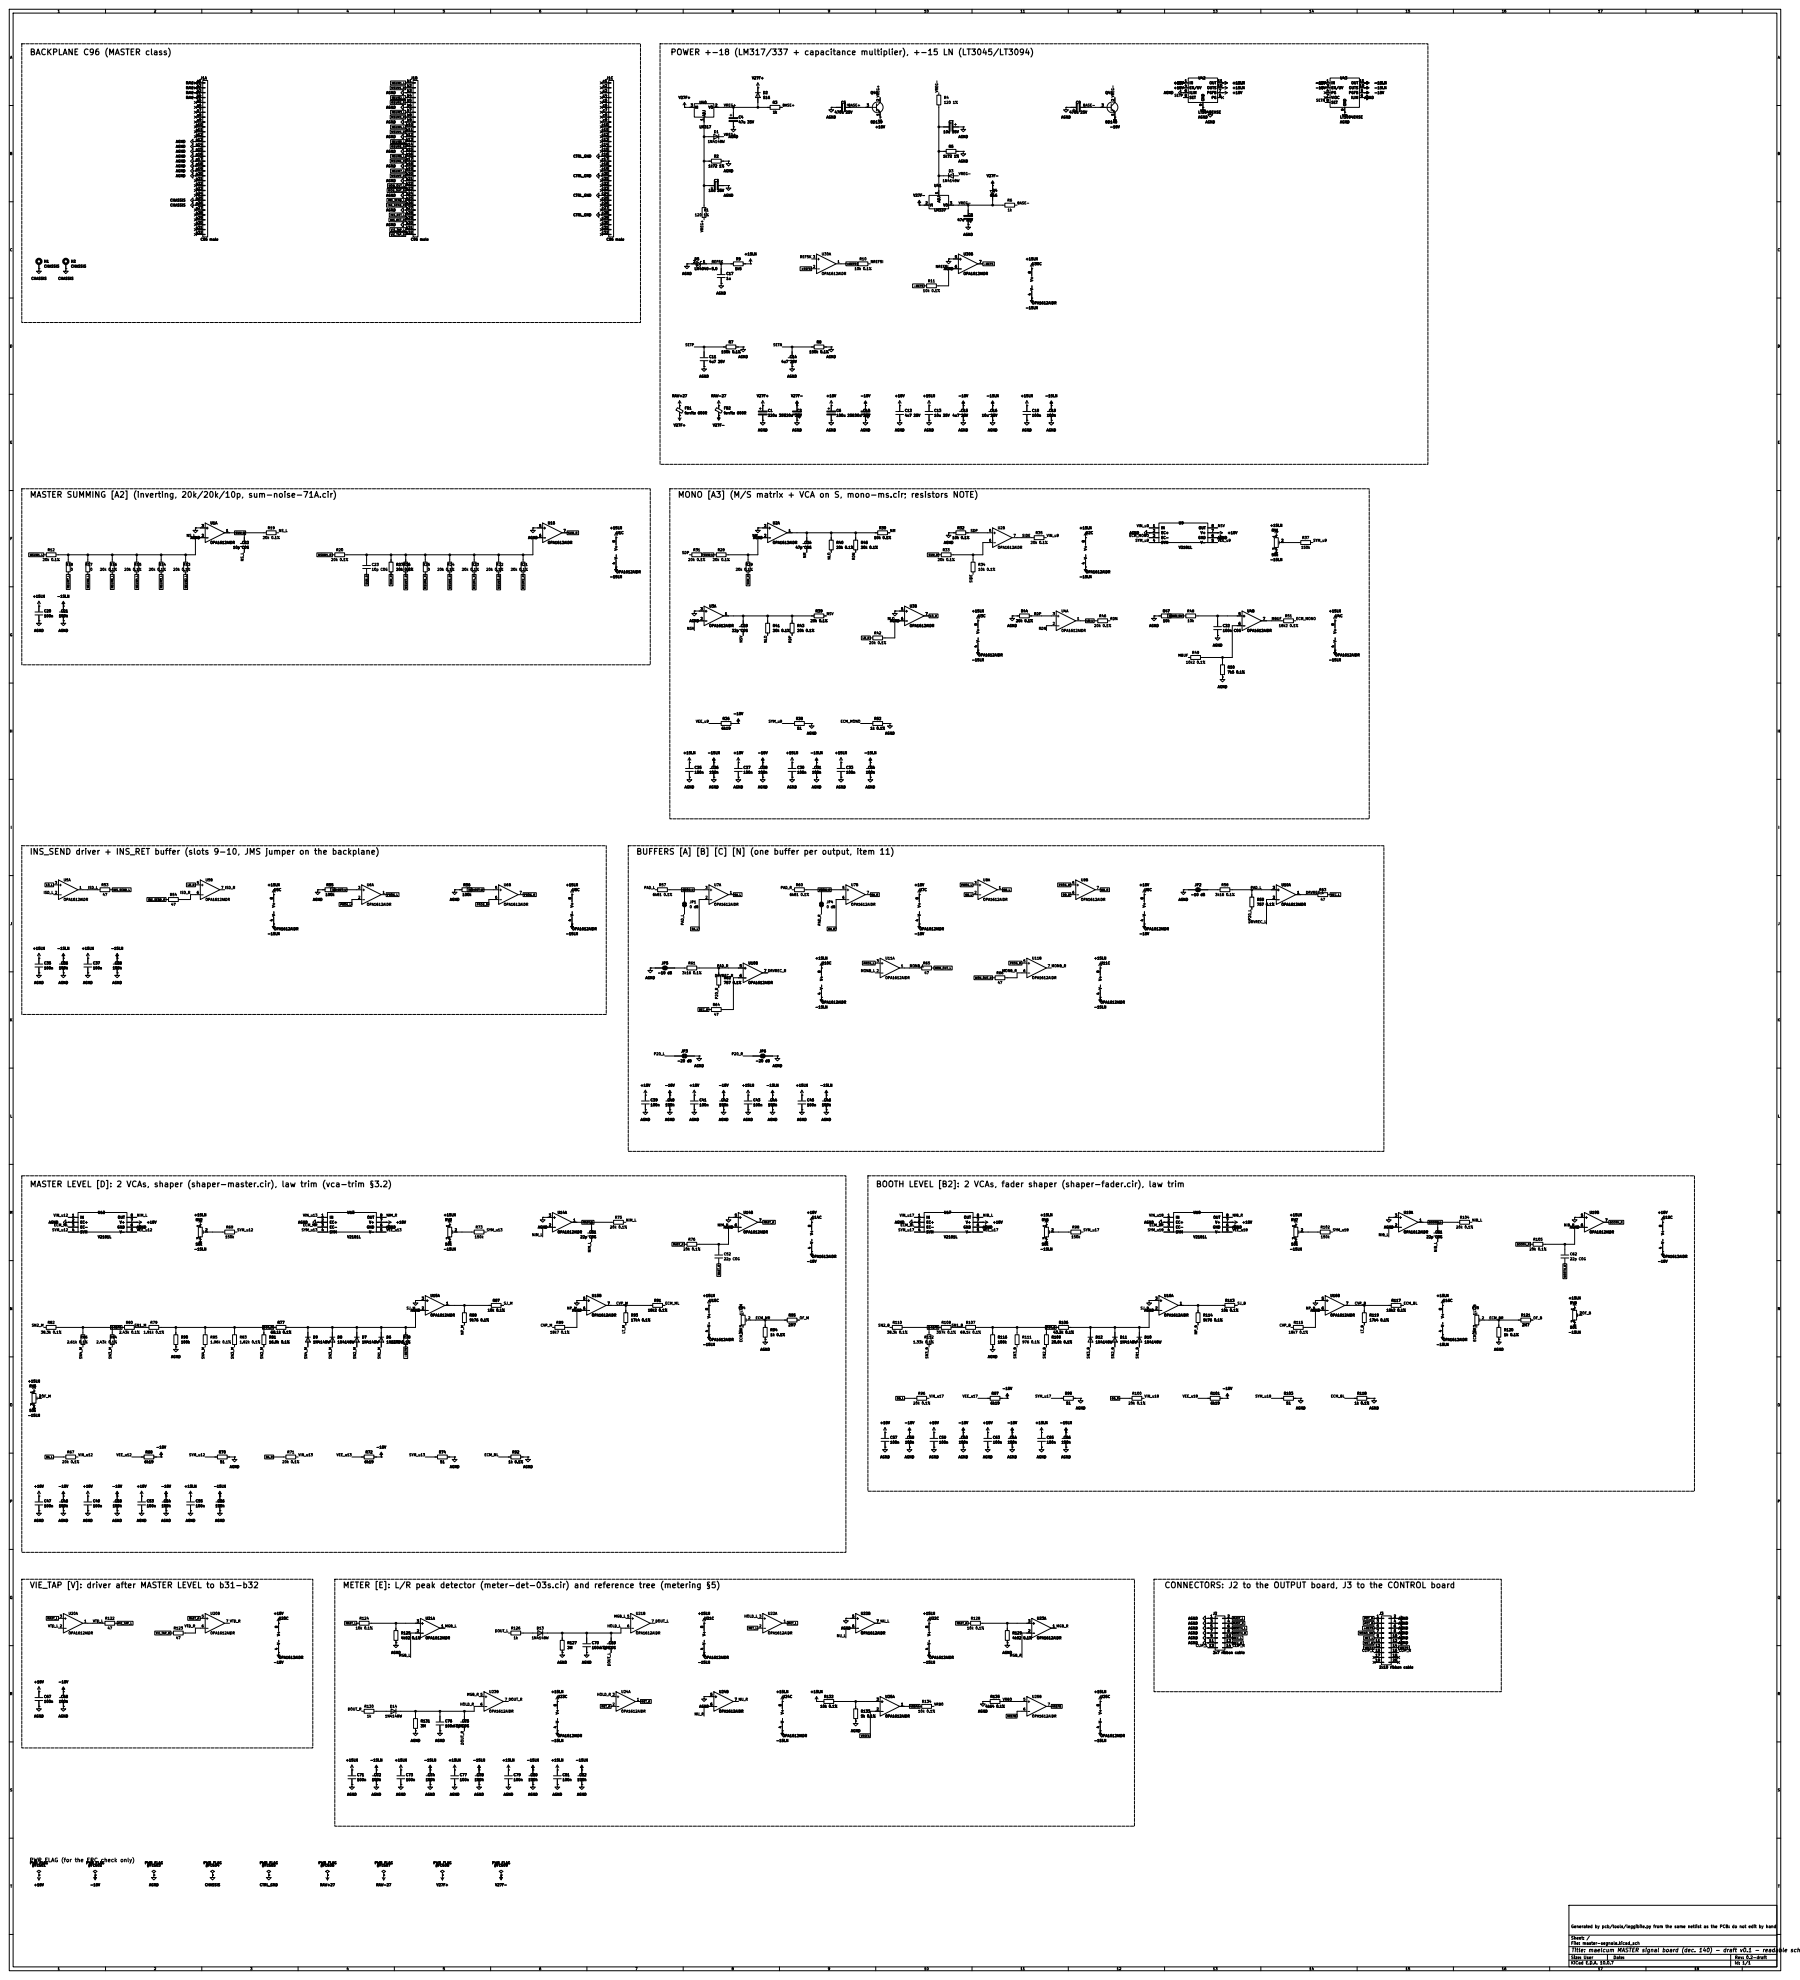
[picture p10: page 9]

POWER +-18 (LM317/337 + capacitance multiplier), +-15 LN (LT3045/LT3094)

INS_SEND driver + INS_RET buffer (slots 9-10, JMS jumper on the backplane)

BUFFERS [A] [B] [C] [N] (one buffer per output, item 11)

MASTER LEVEL [D]: 2 VCAs, shaper (shaper-master.cir), law trim (vca-trim §3.2)

VIE_TAP [V]: driver after MASTER LEVEL to b31-b32

File: master-segnale.kicad_sch
Title: maelcum MASTER signal board (dec. 140) - draft v0.1 - readable schematic

1k62 1% V+

# 10k ADJ 1

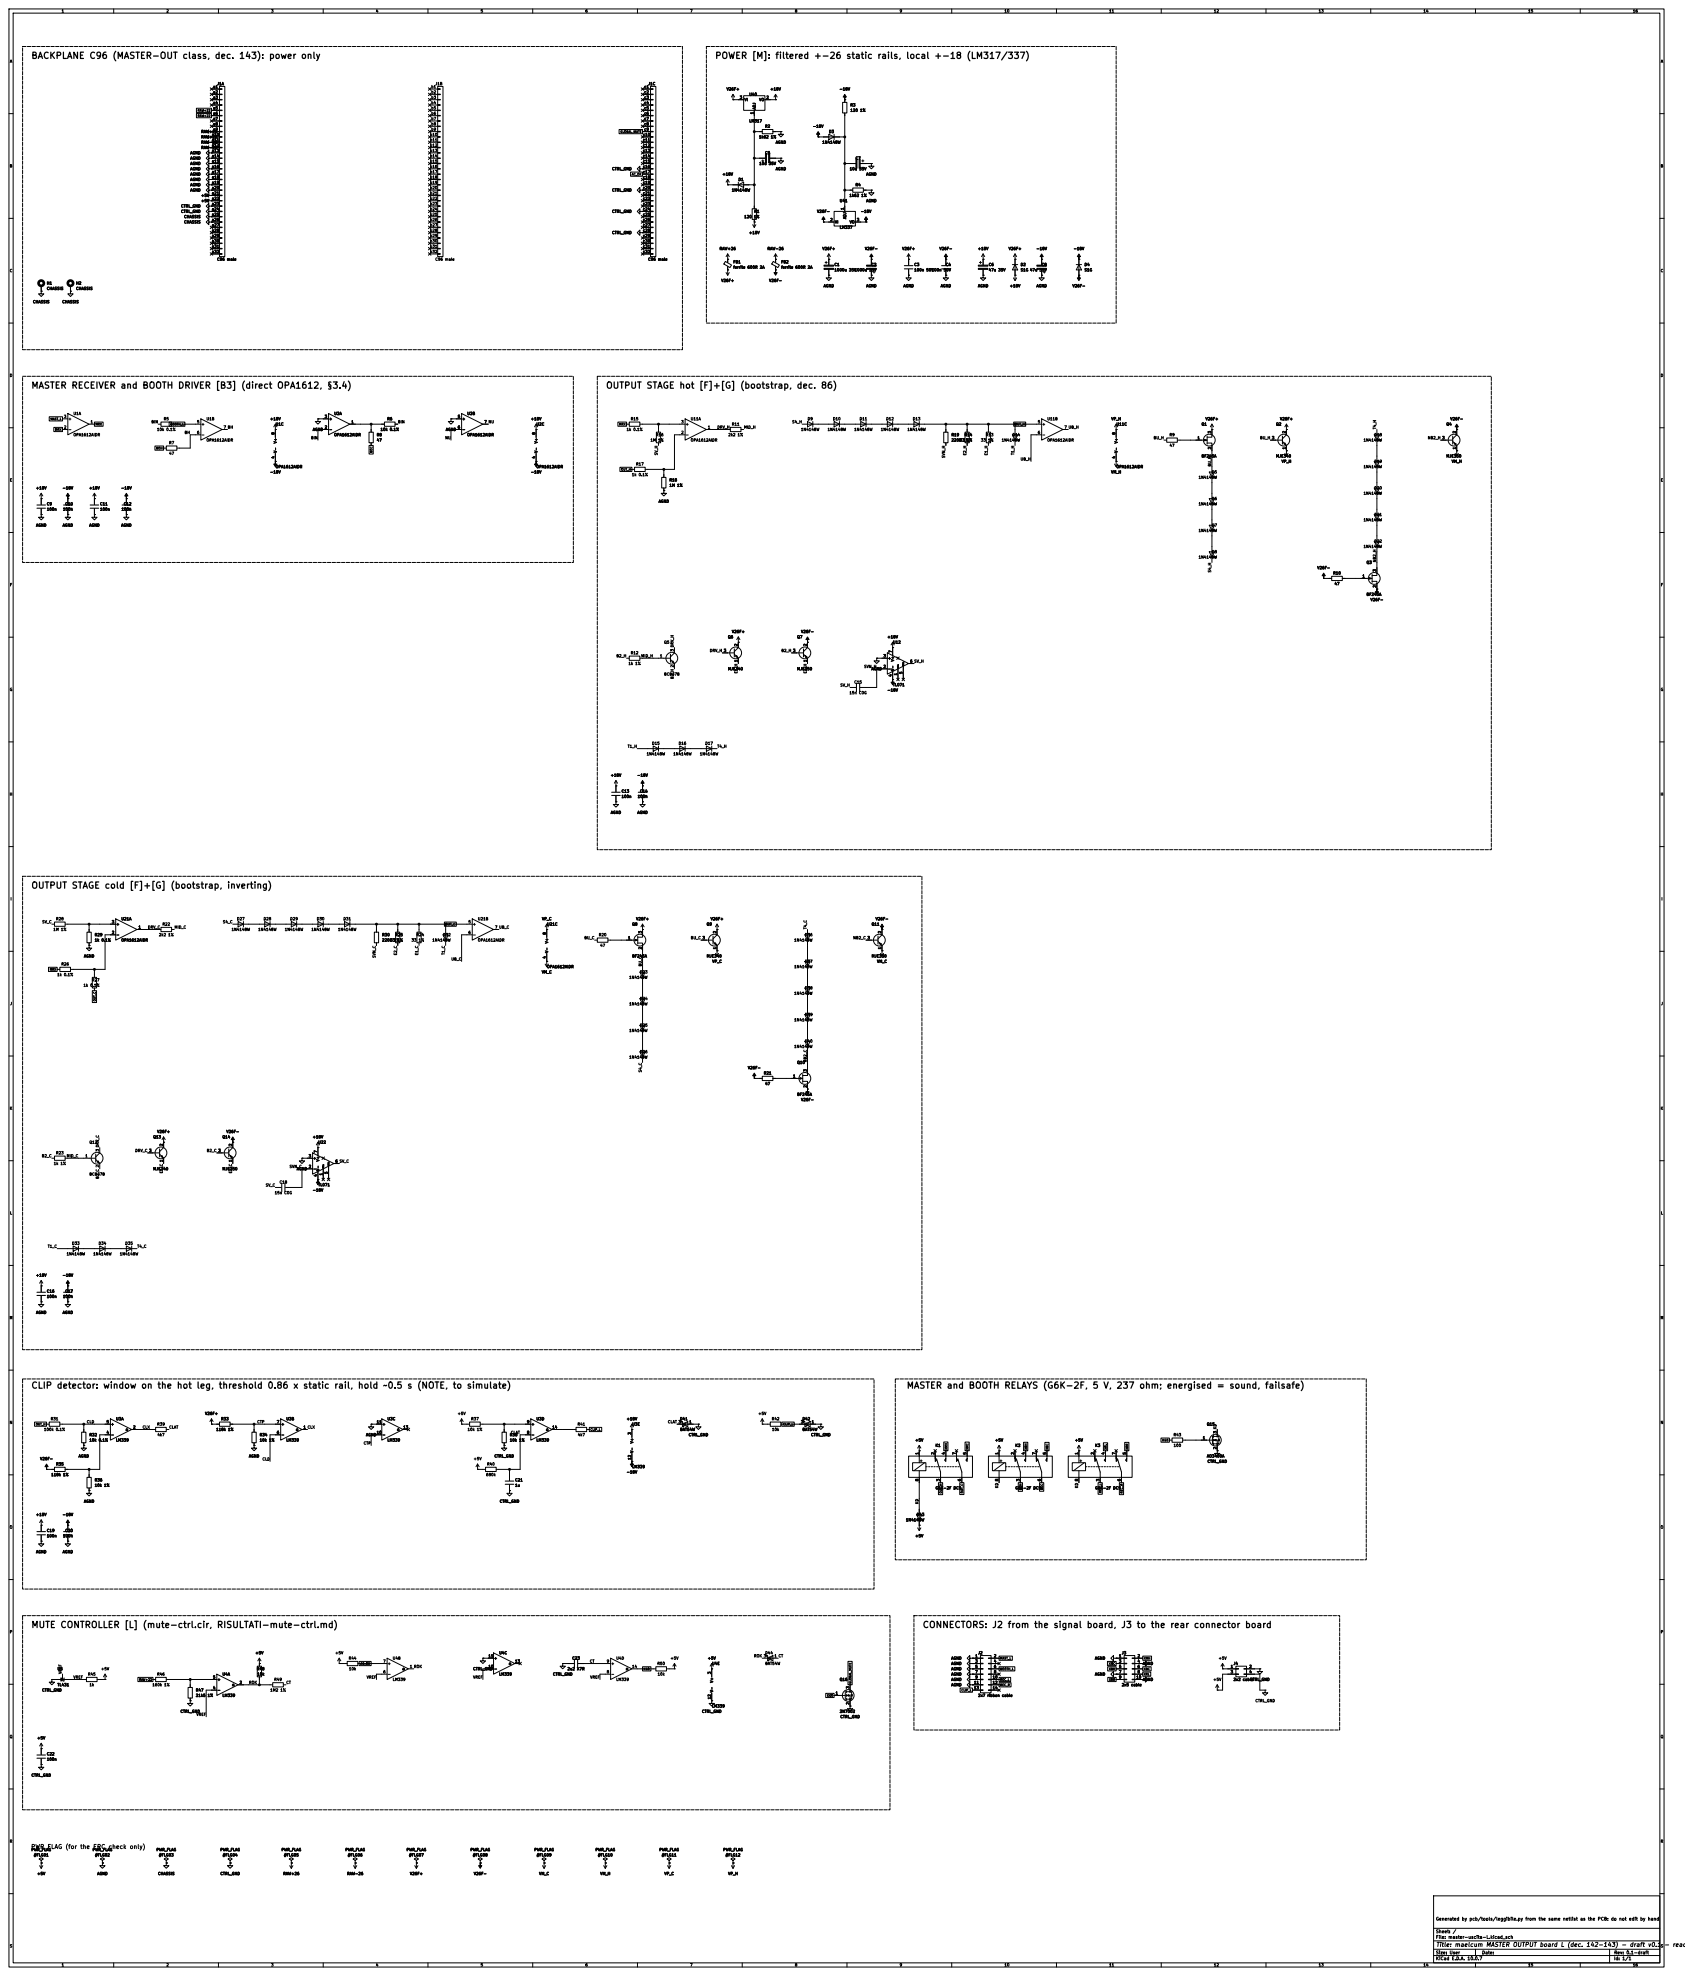
[picture p11: page 10]

5 -OUT_H 6

OUTPUT STAGE cold [F]+[G] (bootstrap, inverting)

CLIP detector: window on the hot leg, threshold 0.86 x static rail, hold ~0.5 s (NOTE, to simulate)

MASTER and BOOTH RELAYS (G6K-2F, 5 V, 237 ohm; energised = sound, failsafe)

MUTE CONTROLLER [L] (mute-ctrl.cir, RISULTATI-mute-ctrl.md)

CONNECTORS: J2 from the signal board, J3 to the rear connector board

File: master-uscita-L.kicad_sch
Title: maelcum MASTER OUTPUT board L (dec. 142-143) - draft v0.1 - readable schematic

10k 0.1% V+

# #FLG12 PWR_FLAG V-

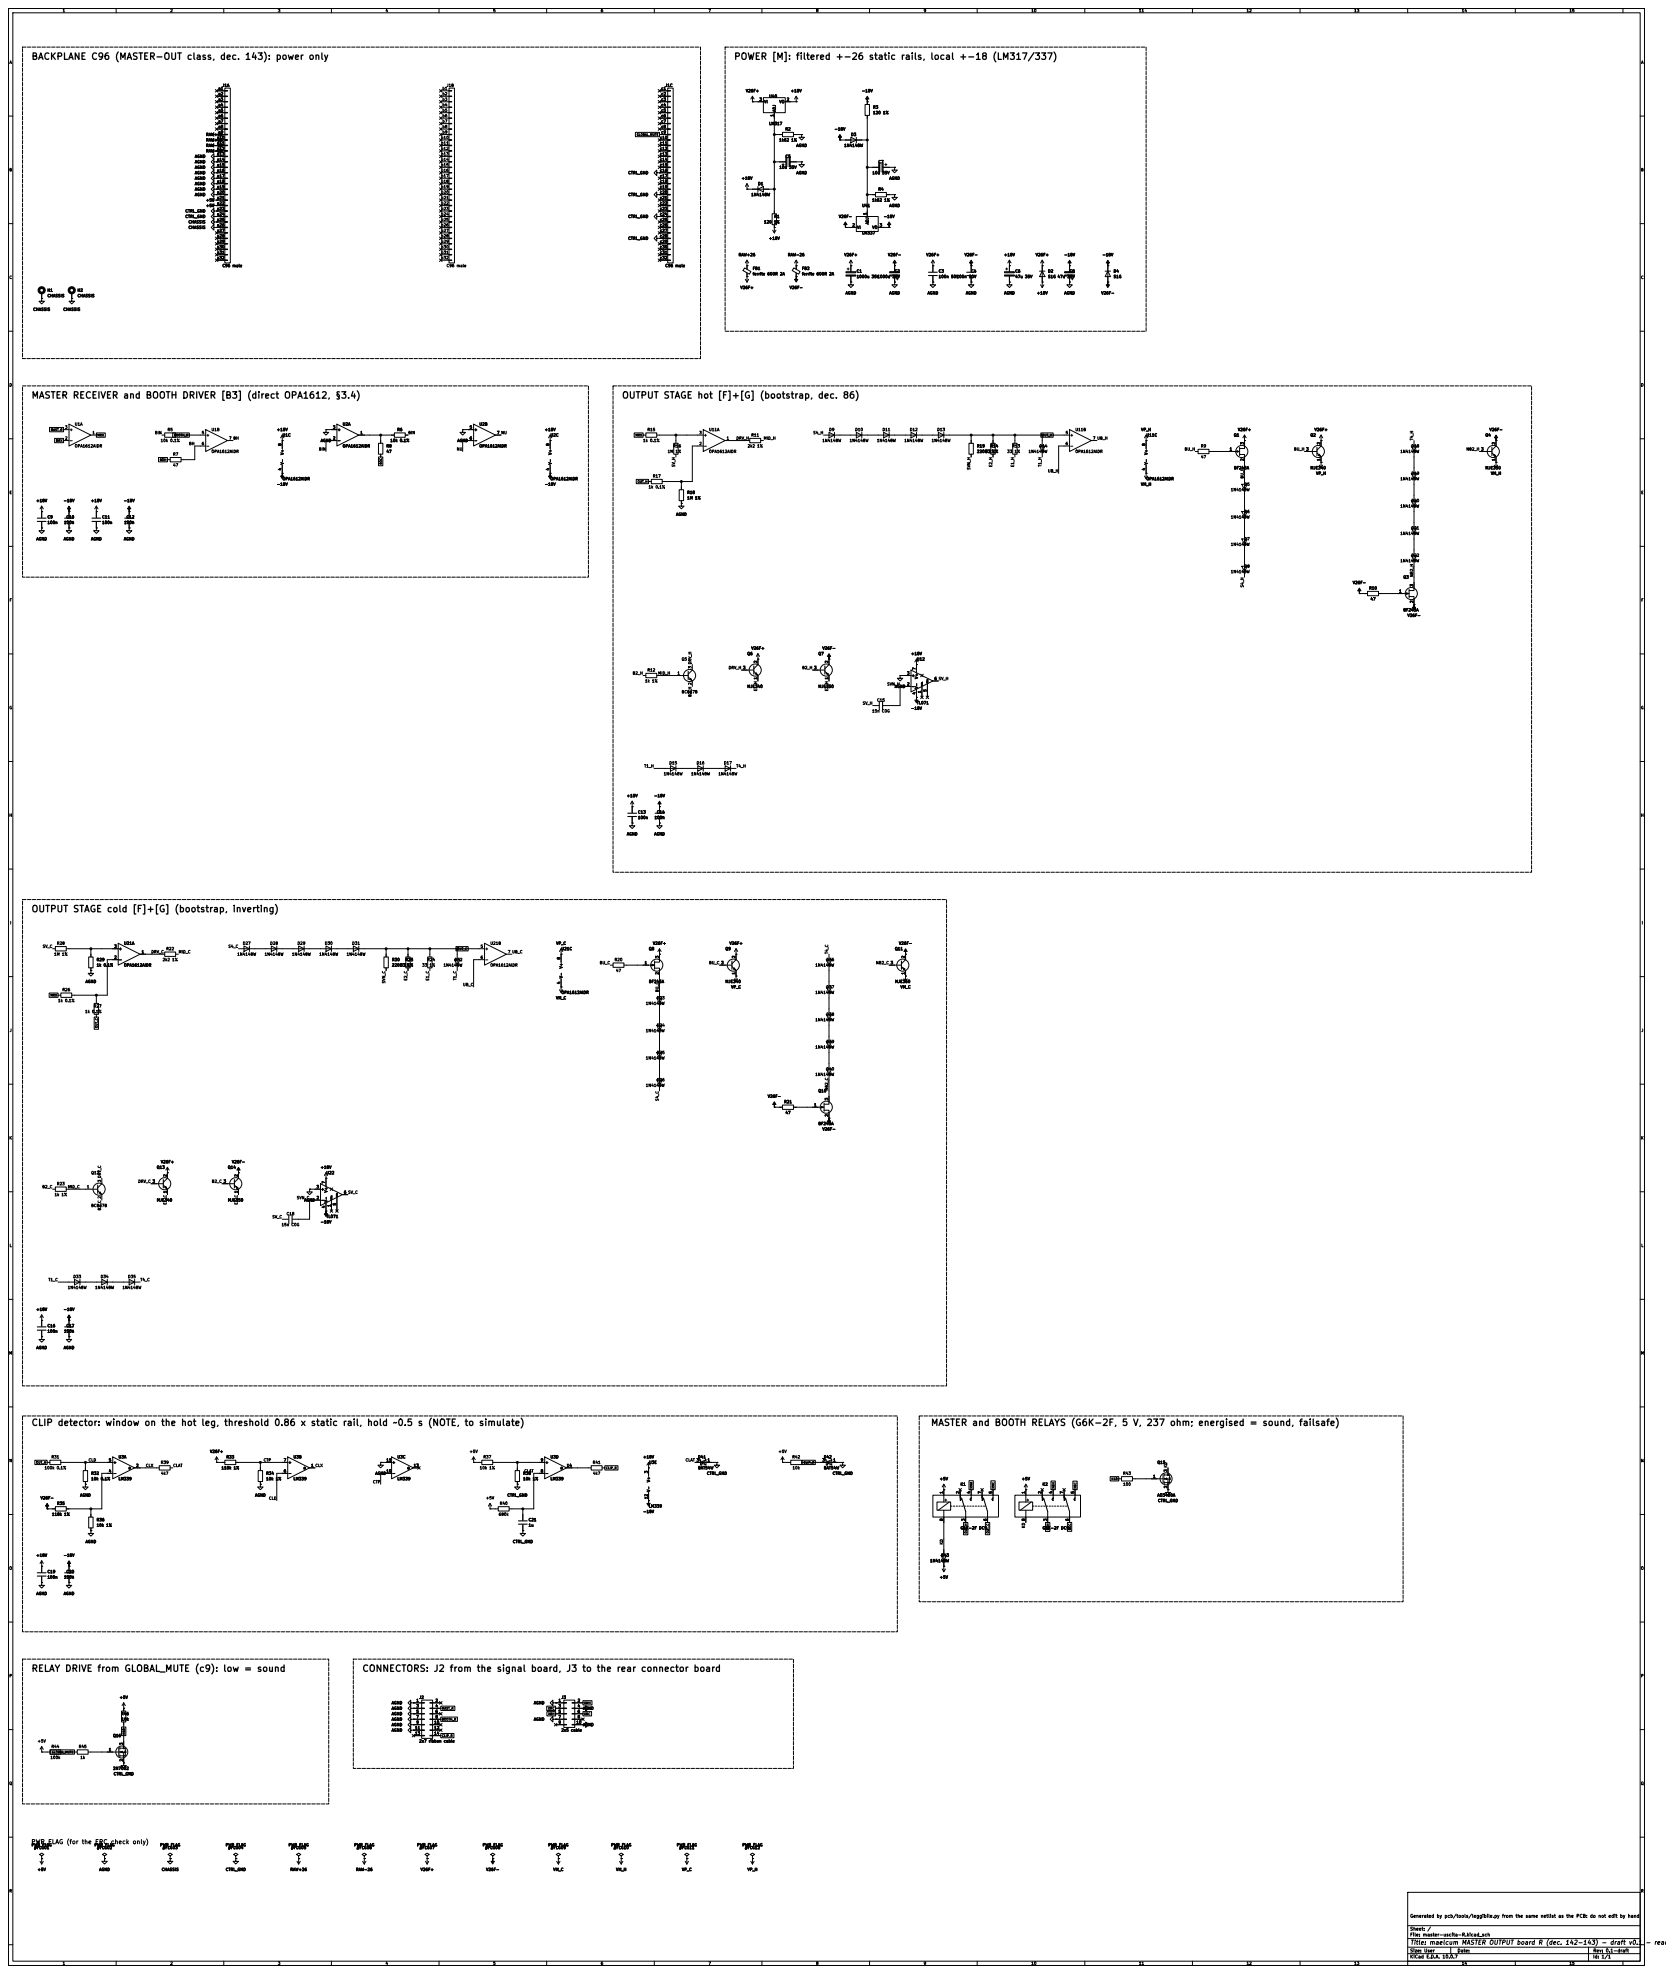
[picture p12: page 11]

MASTER RECEIVER and BOOTH DRIVER [B3] (direct OPA1612, §3.4)

OUTPUT STAGE hot [F]+[G] (bootstrap, dec. 86)

OUTPUT STAGE cold [F]+[G] (bootstrap, inverting)

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

MASTER and BOOTH RELAYS (G6K-2F, 5 V, 237 ohm; energised = sound, failsafe)

RELAY DRIVE from GLOBAL_MUTE (c9): low = sound

CONNECTORS: J2 from the signal board, J3 to the rear connector board

File: master-uscita-R.kicad_sch
Title: maelcum MASTER OUTPUT board R (dec. 142-143) - draft v0.1 - readable schematic

# 10k lin +5V

# LED 5x2 +5V

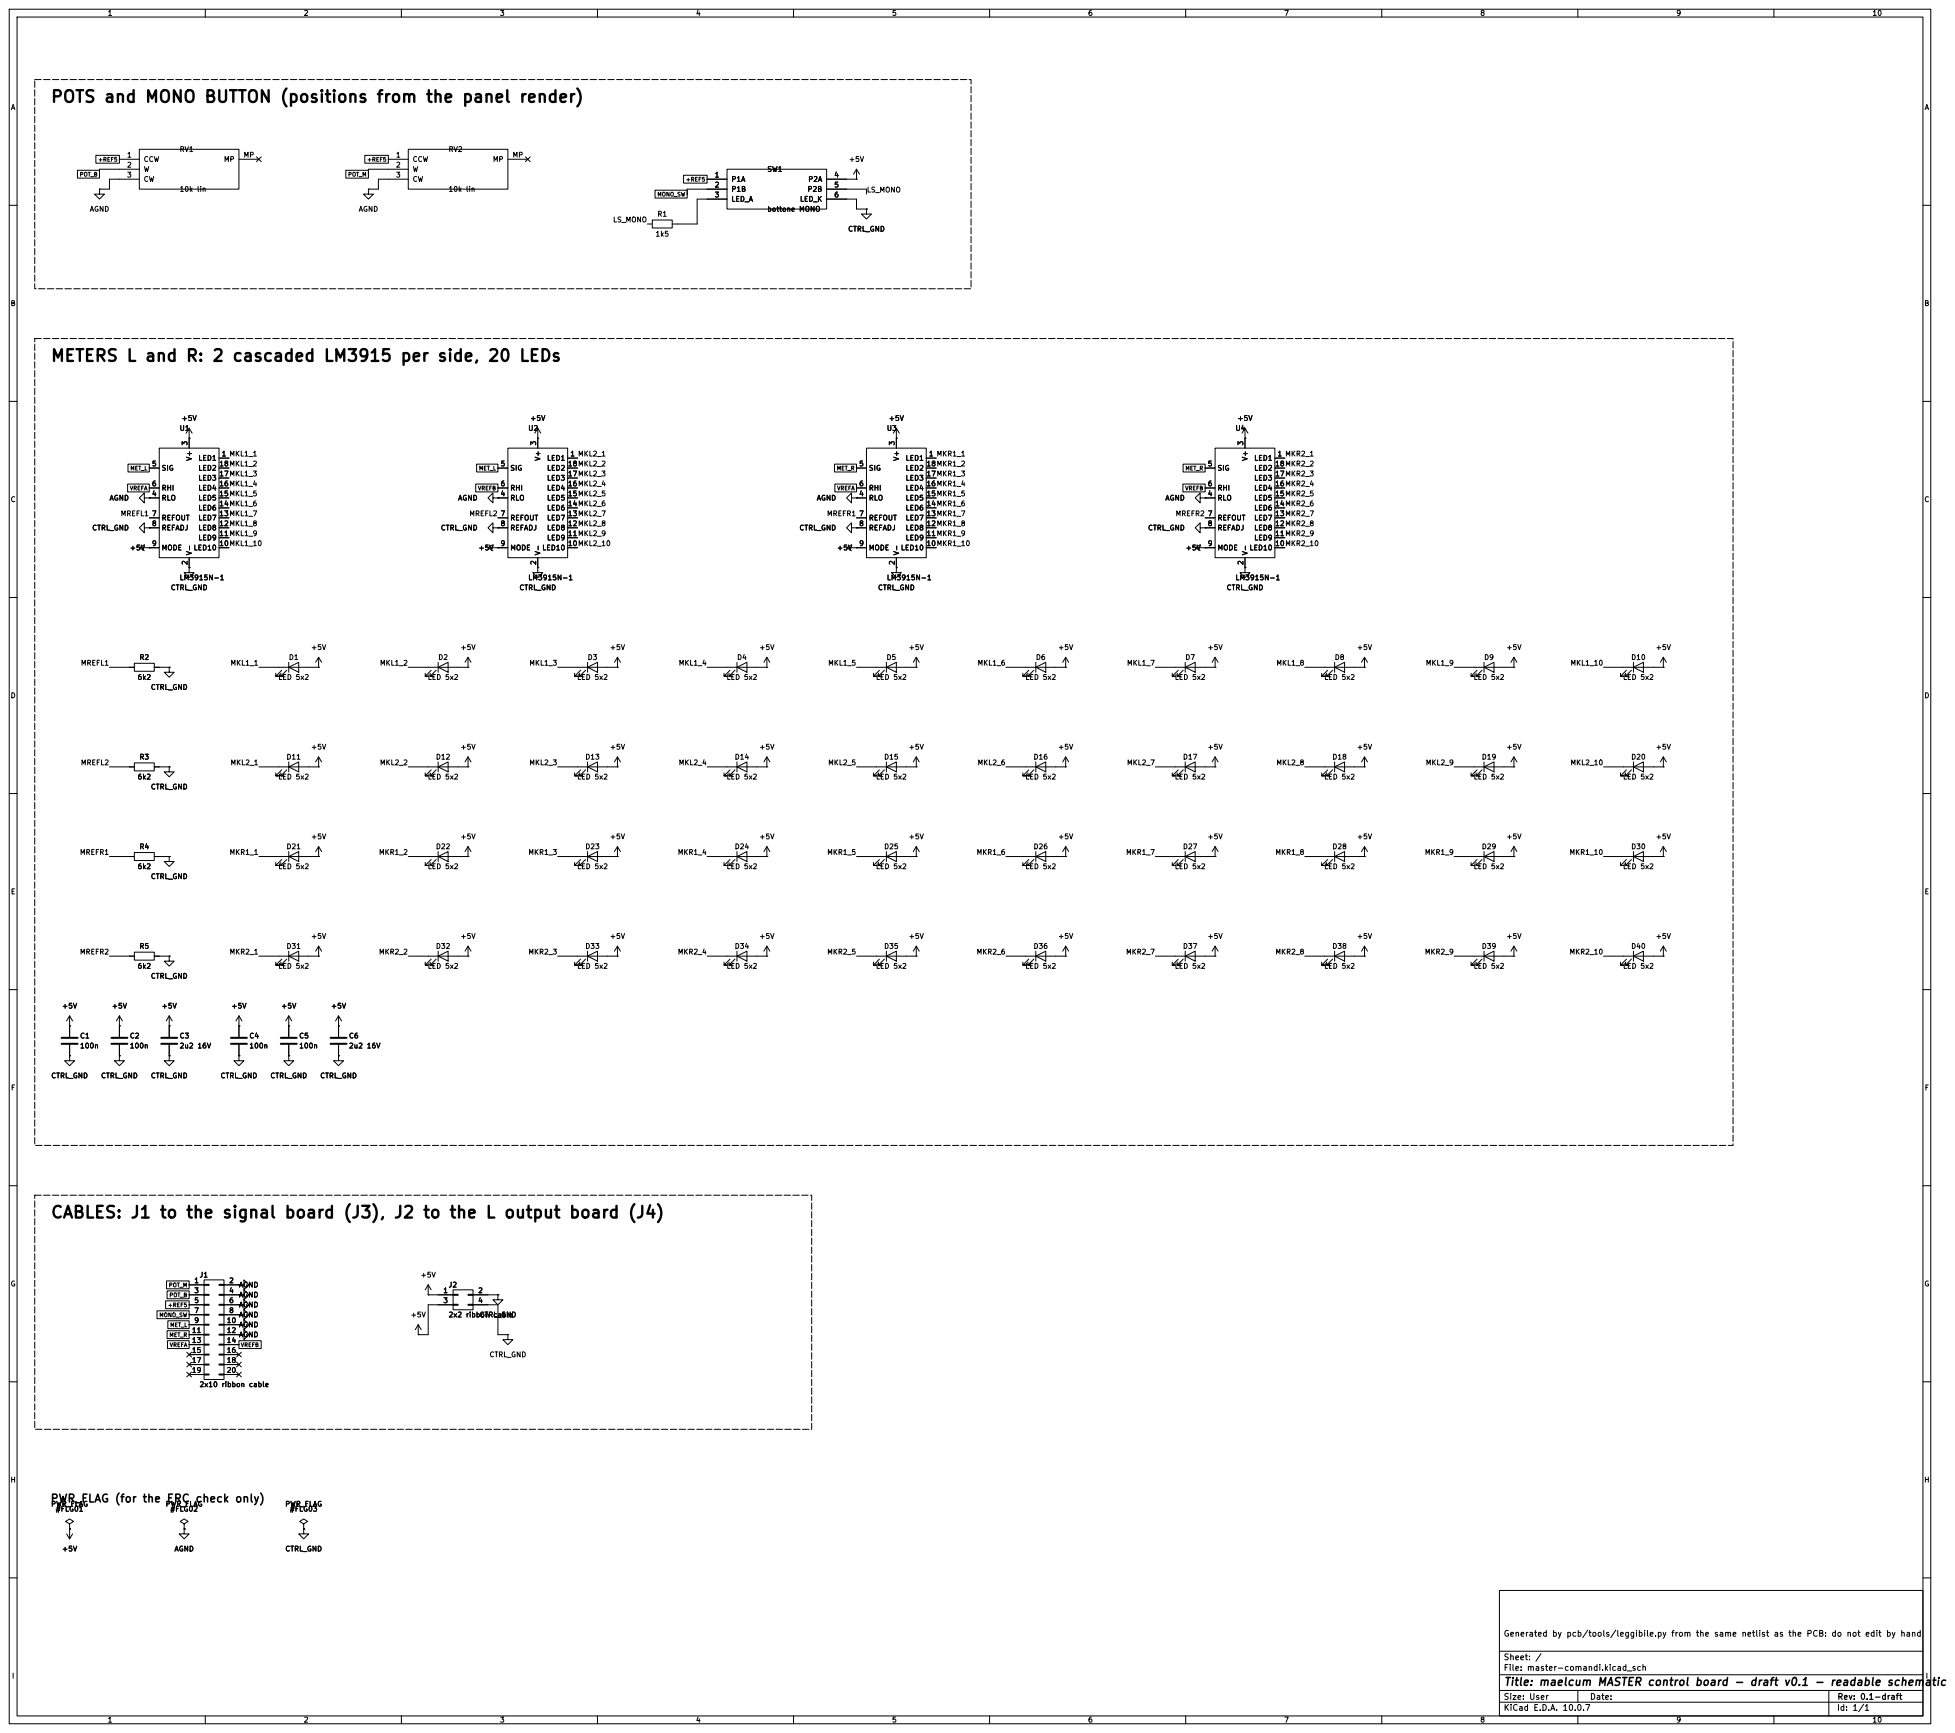
[picture p13: page 12]

POTS and MONO BUTTON (positions from the panel render)

METERS L and R: 2 cascaded LM3915 per side, 20 LEDs
LED10 10 LED9 11 LED8 12 LED7 13 LED6 14 LED5 15 LED4 16 LED3 17 LED2 18 U1
LED1 1 V-
SIG 5 RHI 6 REFOUT 7 REFADJ 8 MODE 9

CABLES: J1 to the signal board (J3), J2 to the L output board (J4)

PWR_FLAG (for the ERC check only)

File: master-comandi.kicad_sch
Title: maelcum MASTER control board - draft v0.1 - readable schematic

# +15LN -15LN

1k74 1% V+

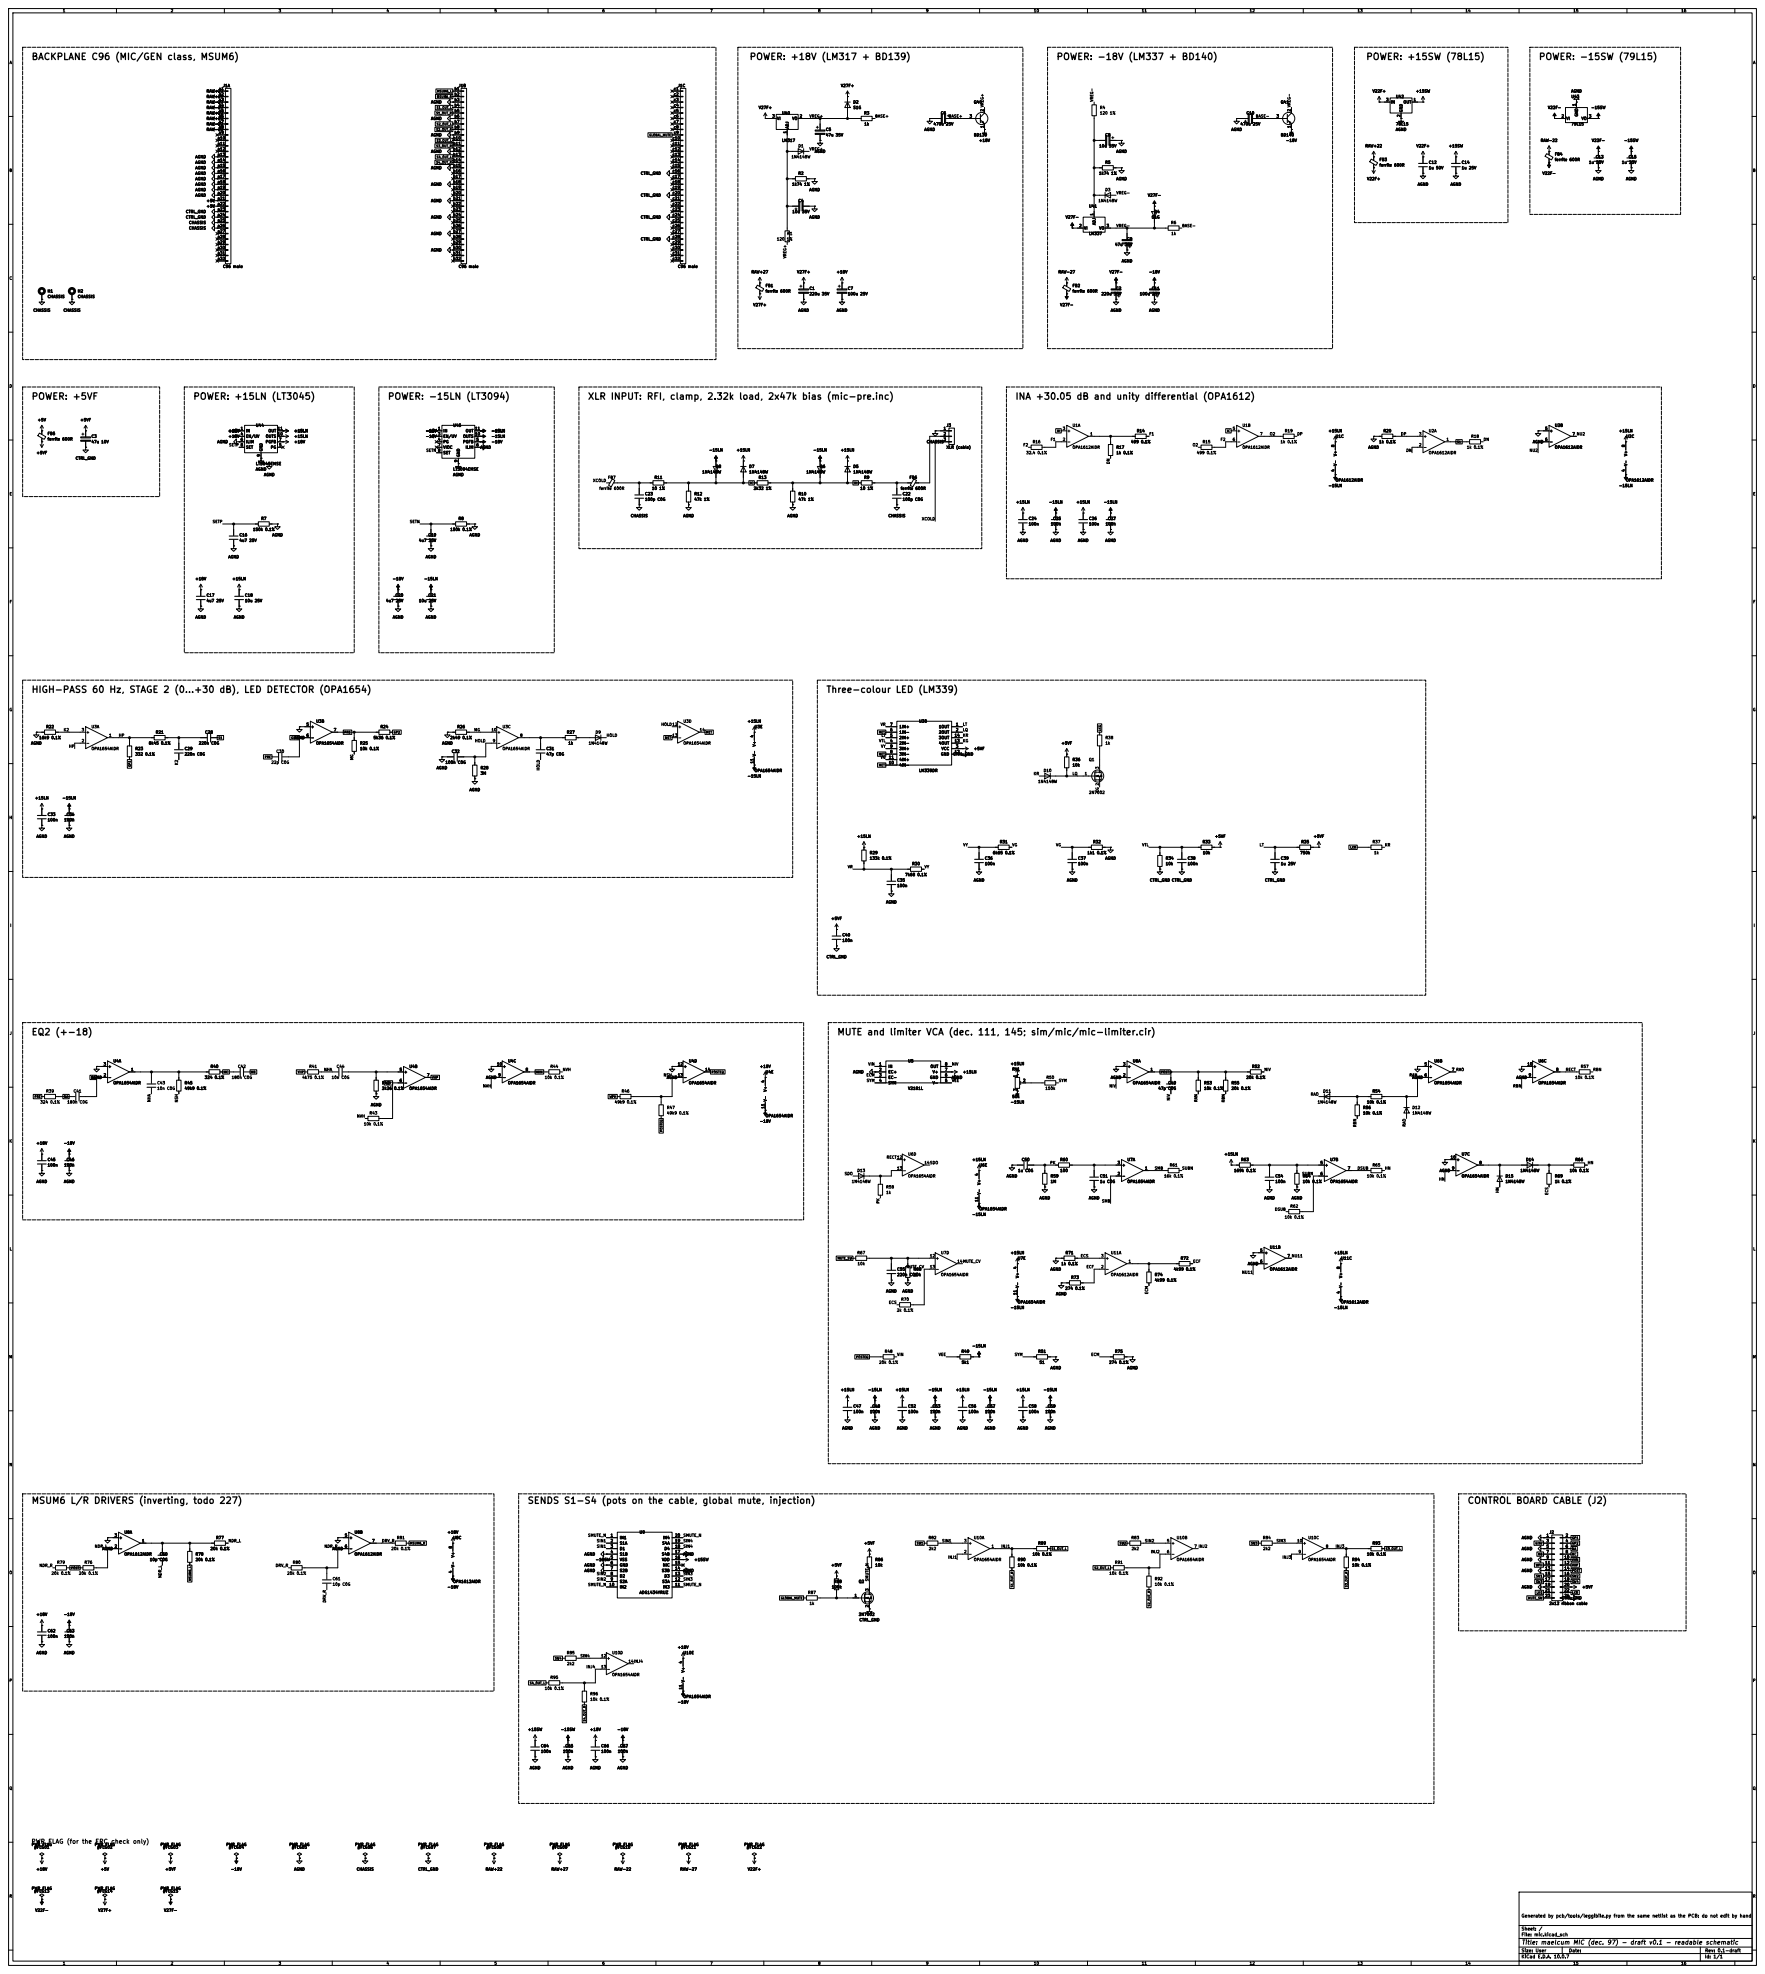
[picture p14: page 13]

J1A C96 male CTRL_GND
RAW-22 RAW+22 RAW+22 RAW-22 RAW-27 RAW+27 RAW+27 RAW-27

BACKPLANE C96 (MIC/GEN class, MSUM6)

J1A C96 male
RAW-27 RAW+27 RAW+27 RAW-27 RAW-22 RAW+22 RAW+22 RAW-22

XLR INPUT: RFI, clamp, 2.32k load, 2x47k bias (mic-pre.inc)

HIGH-PASS 60 Hz, STAGE 2 (0...+30 dB), LED DETECTOR (OPA1654)

SENDS S1-S4 (pots on the cable, global mute, injection)

File: mic.kicad_sch
Title: maelcum MIC (dec. 97) - draft v0.1 - readable schematic

GP1 | POST GINV | SW1 | POST PWR_FLAG (for the ERC check only)

# CABLE TO THE MAIN BOARD

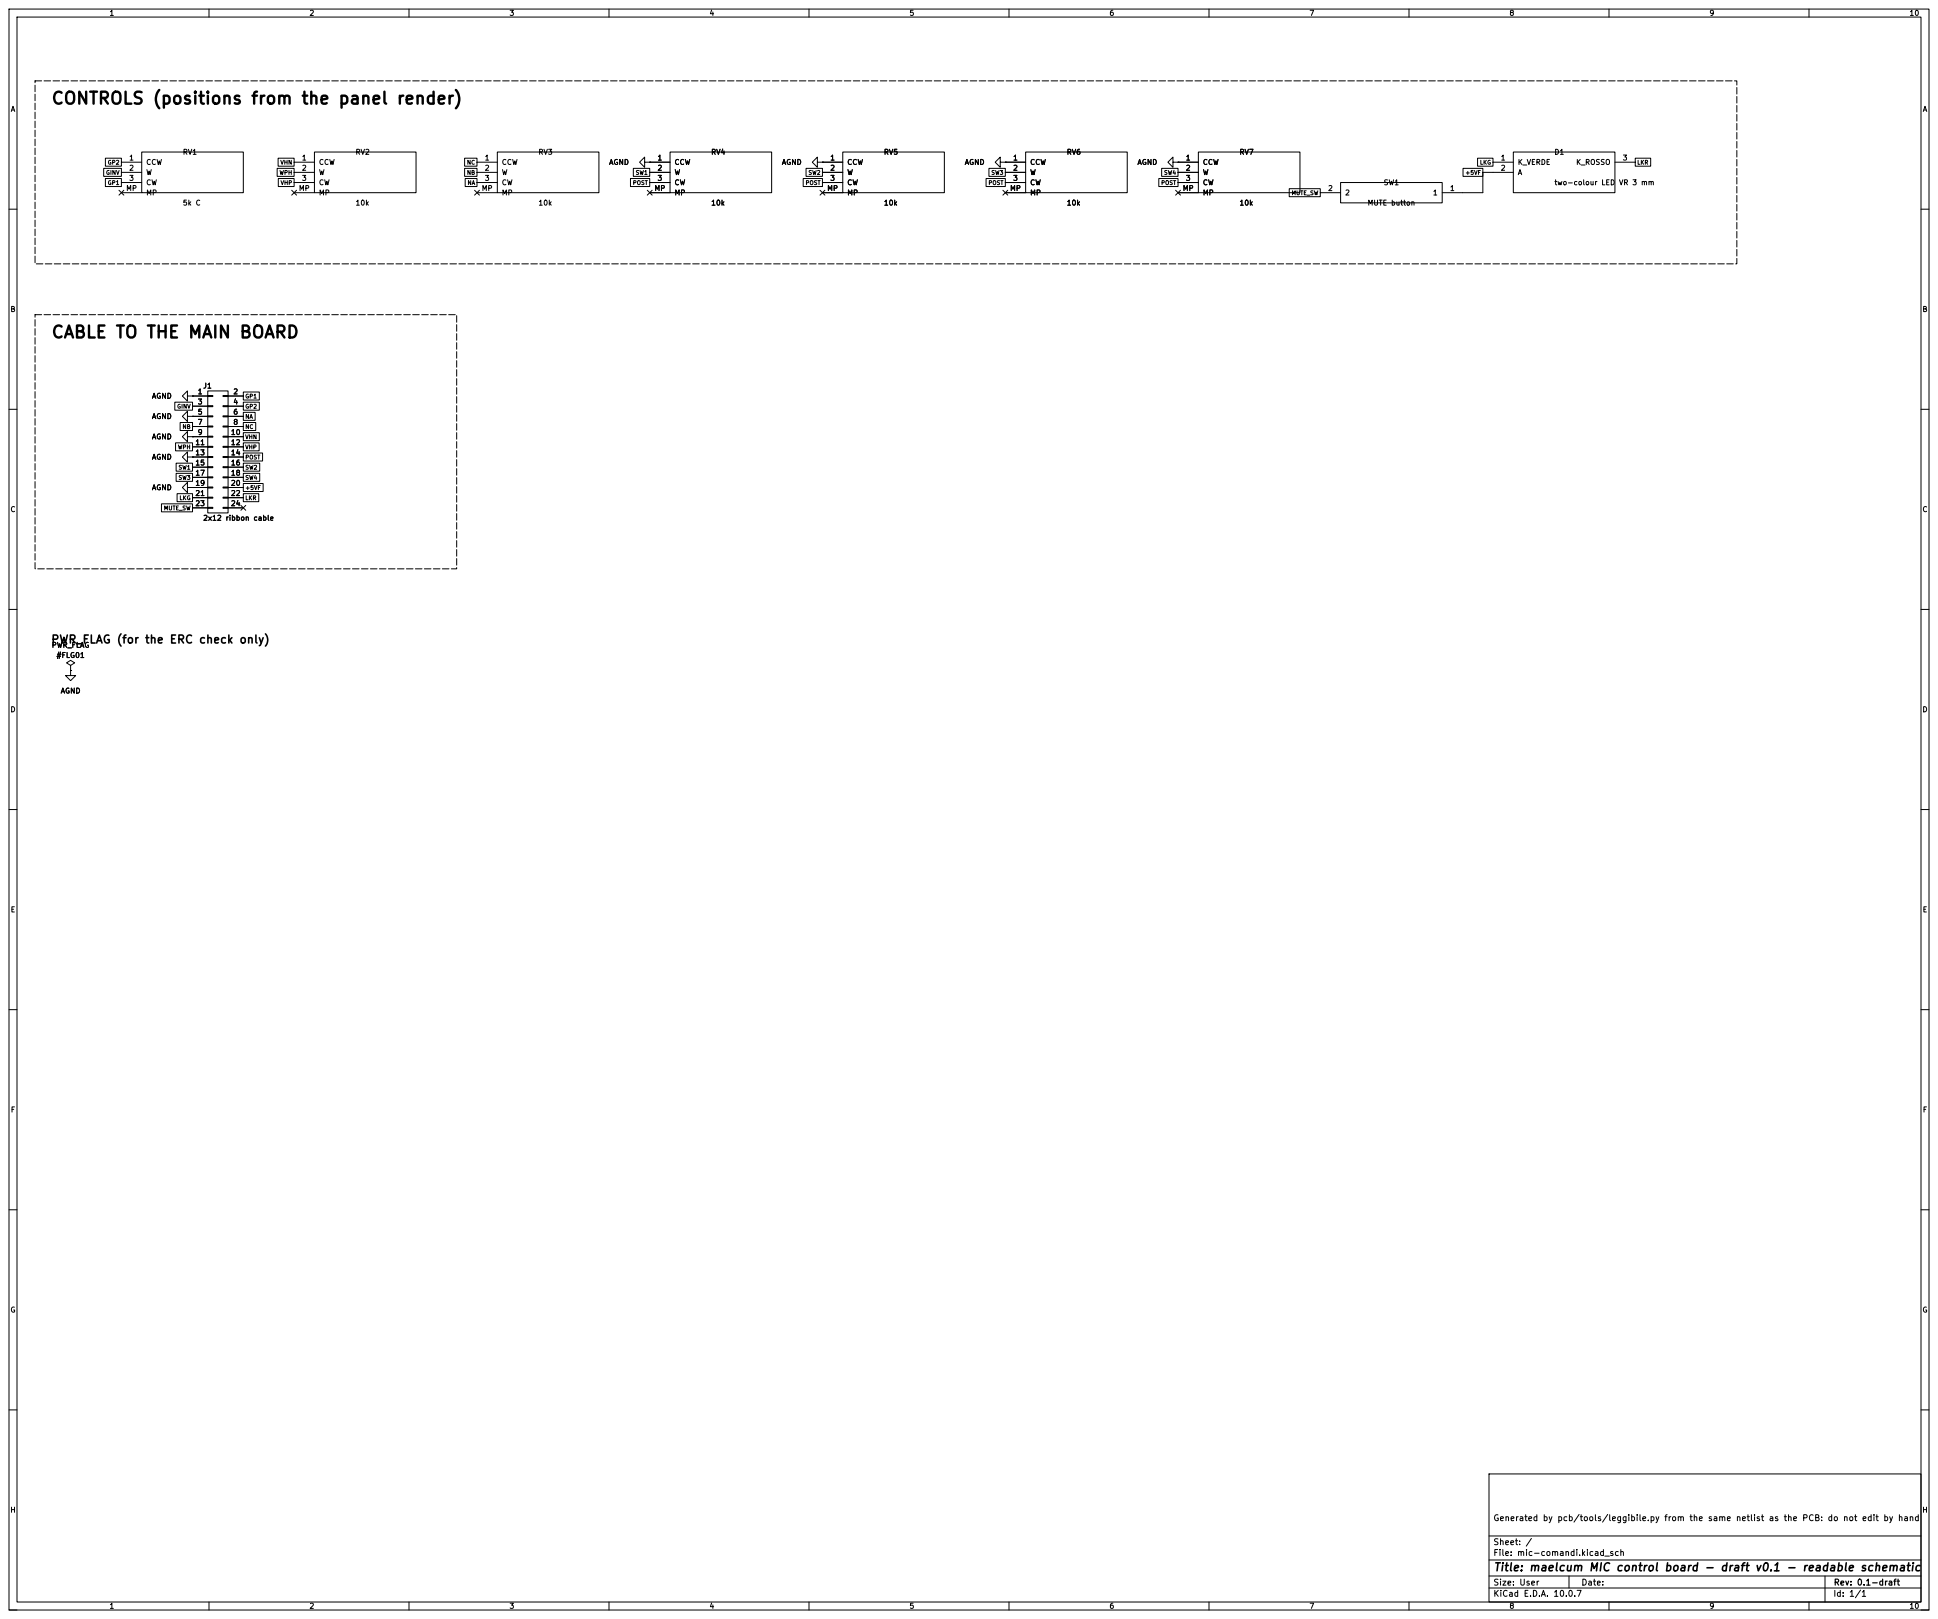
[picture p15: page 14]
FGH; FGH Date:; CCW 1; AGND; SW1 MUTE button CCW 1; 10k CCW 1; #FLG01 PWR_FLAG; K_VERDE 1; K_ROSSO; 10k AGND; 2x12 ribbon cable; VHP; POST NC; POST VHN; NCNA; LKG; POST SW3 WPH; VHN; VHP WPH; LKR; SW3 MUTE_SW; MUTE_SW; LKG +5VF GINV; 2x12 ribbon cable 1

CONTROLS (positions from the panel render)

two-colour LED VR 3 mm

File: mic-comandi.kicad_sch
Title: maelcum MIC control board - draft v0.1 - readable schematic

# LM317 H1CHASSIS CHASSIS H2CHASSIS CHASSIS

# RAW-27 RAW+27 RAW-27 RAW+27 RAW+22 RAW+22 RAW-22 RAW-22

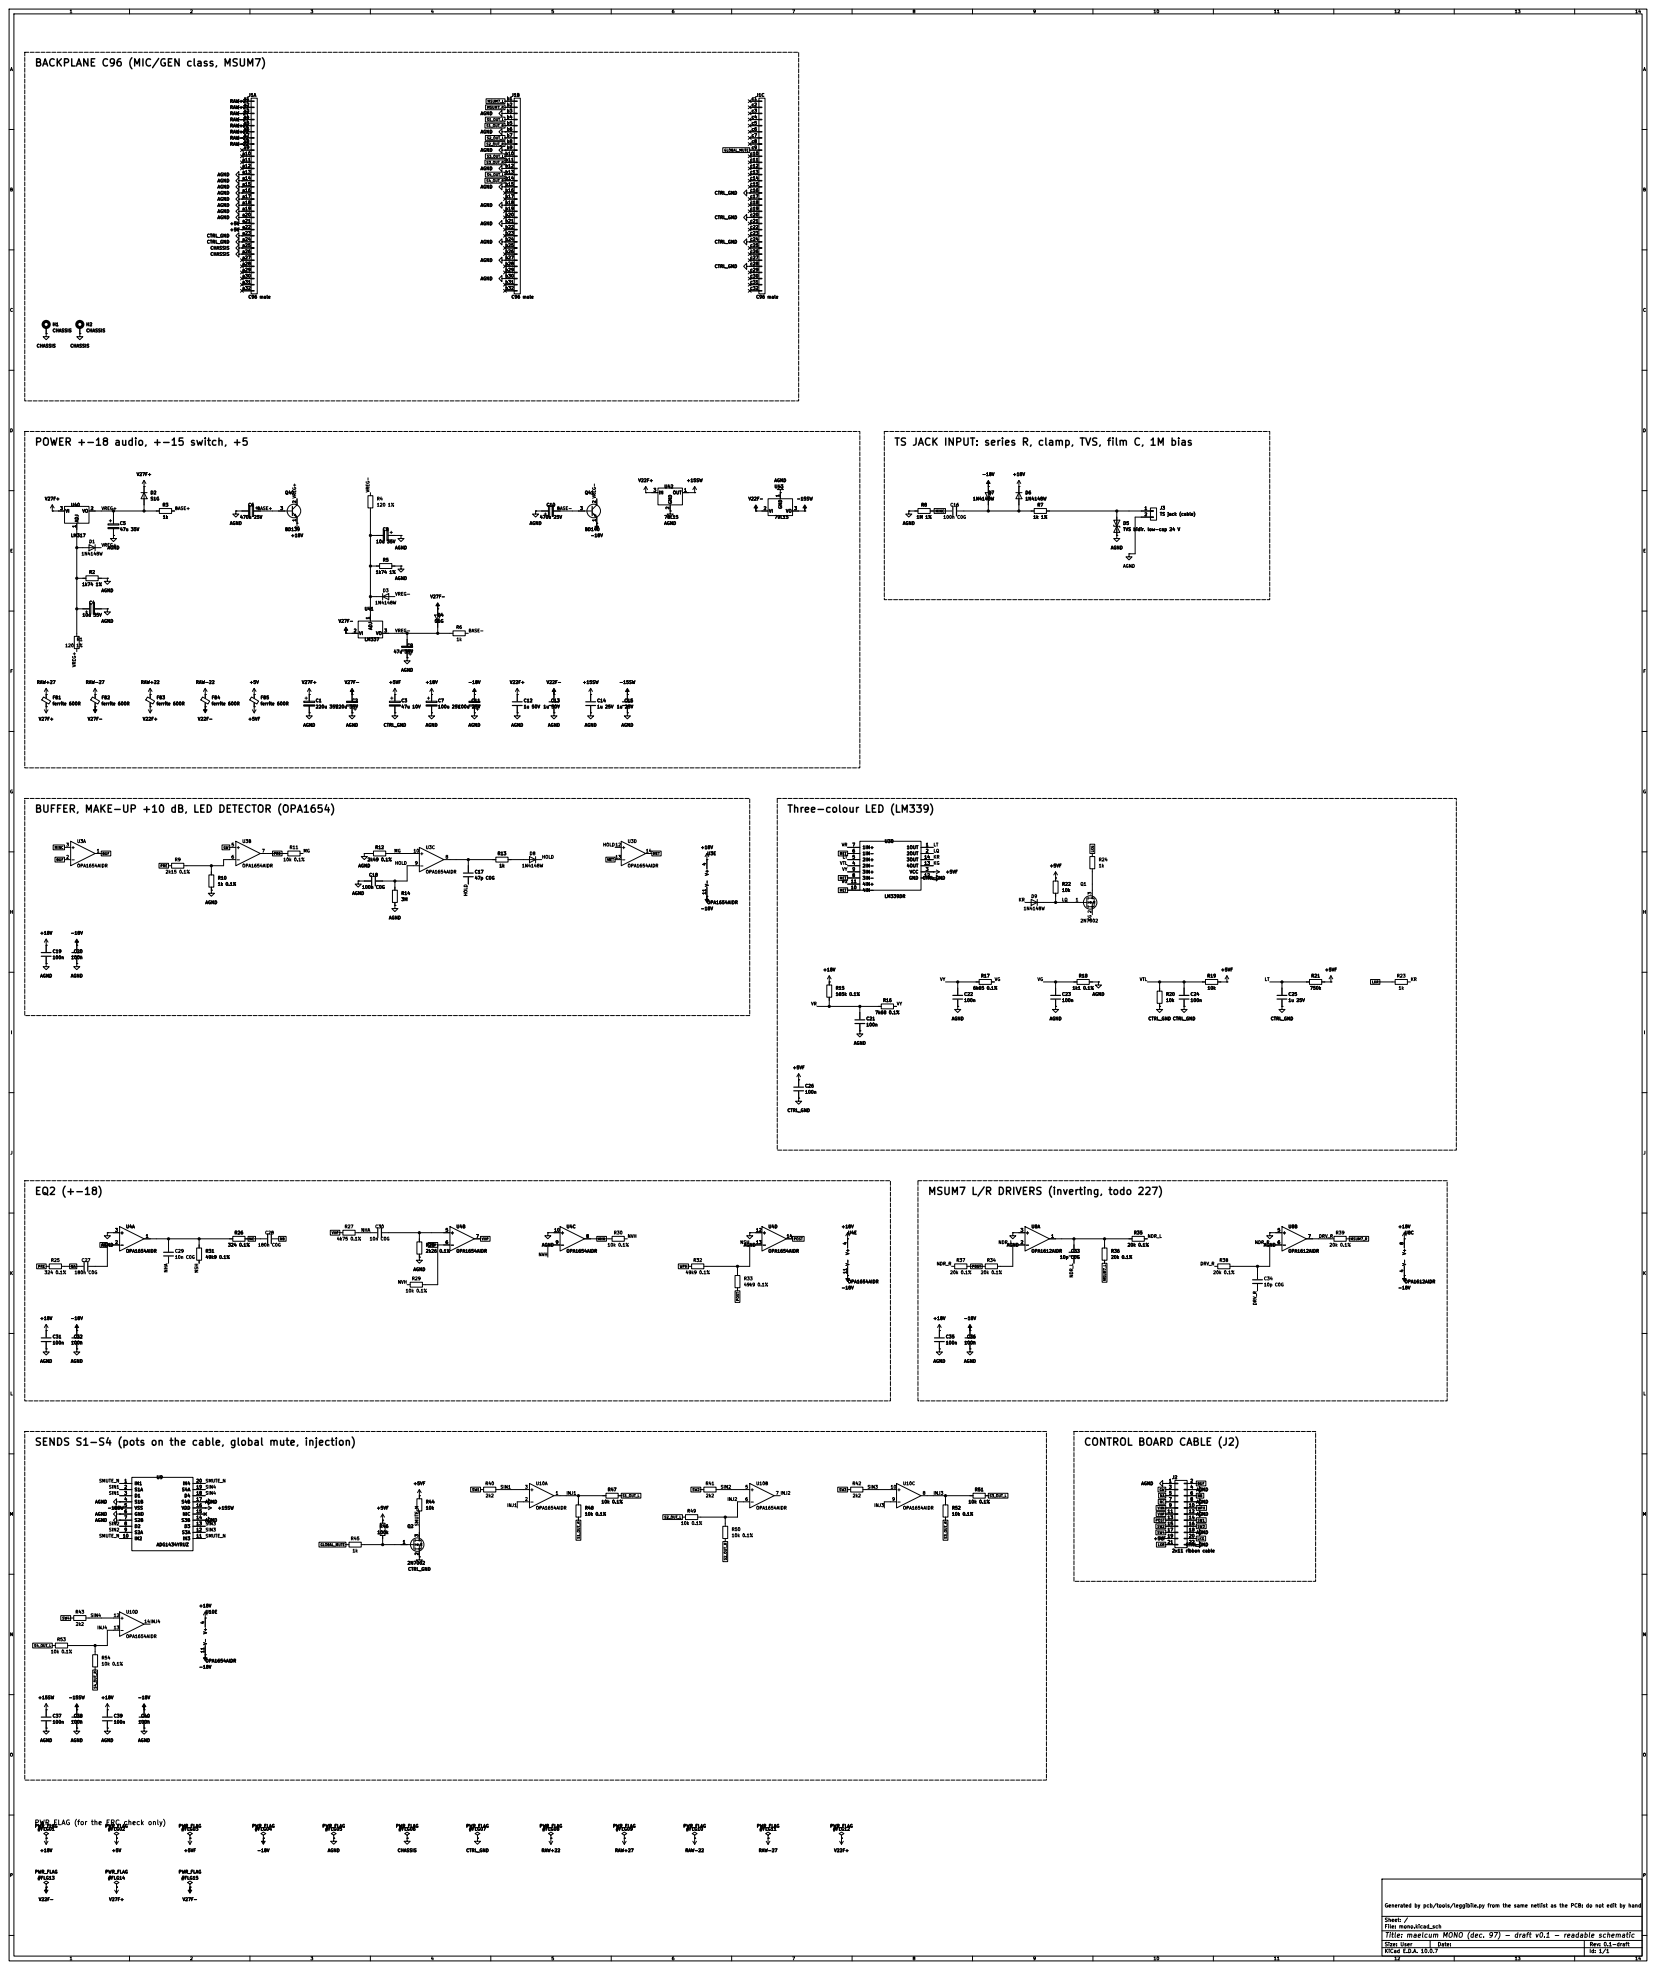
[picture p16: page 15]

BACKPLANE C96 (MIC/GEN class, MSUM7)

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

TS JACK INPUT: series R, clamp, TVS, film C, 1M bias

Generated by pcb/tools/leggibile.py from the same netlist as the PCB: do not edit by hand ADJ 1

TVS bidir. low-cap 24 V

BUFFER, MAKE-UP +10 dB, LED DETECTOR (OPA1654)

SIN4 SENDS S1-S4 (pots on the cable, global mute, injection)

File: mono.kicad_sch
Title: maelcum MONO (dec. 97) - draft v0.1 - readable schematic

VHP | POST | SW4 CABLE TO THE MAIN BOARD

# CONTROLS (positions from the panel render)

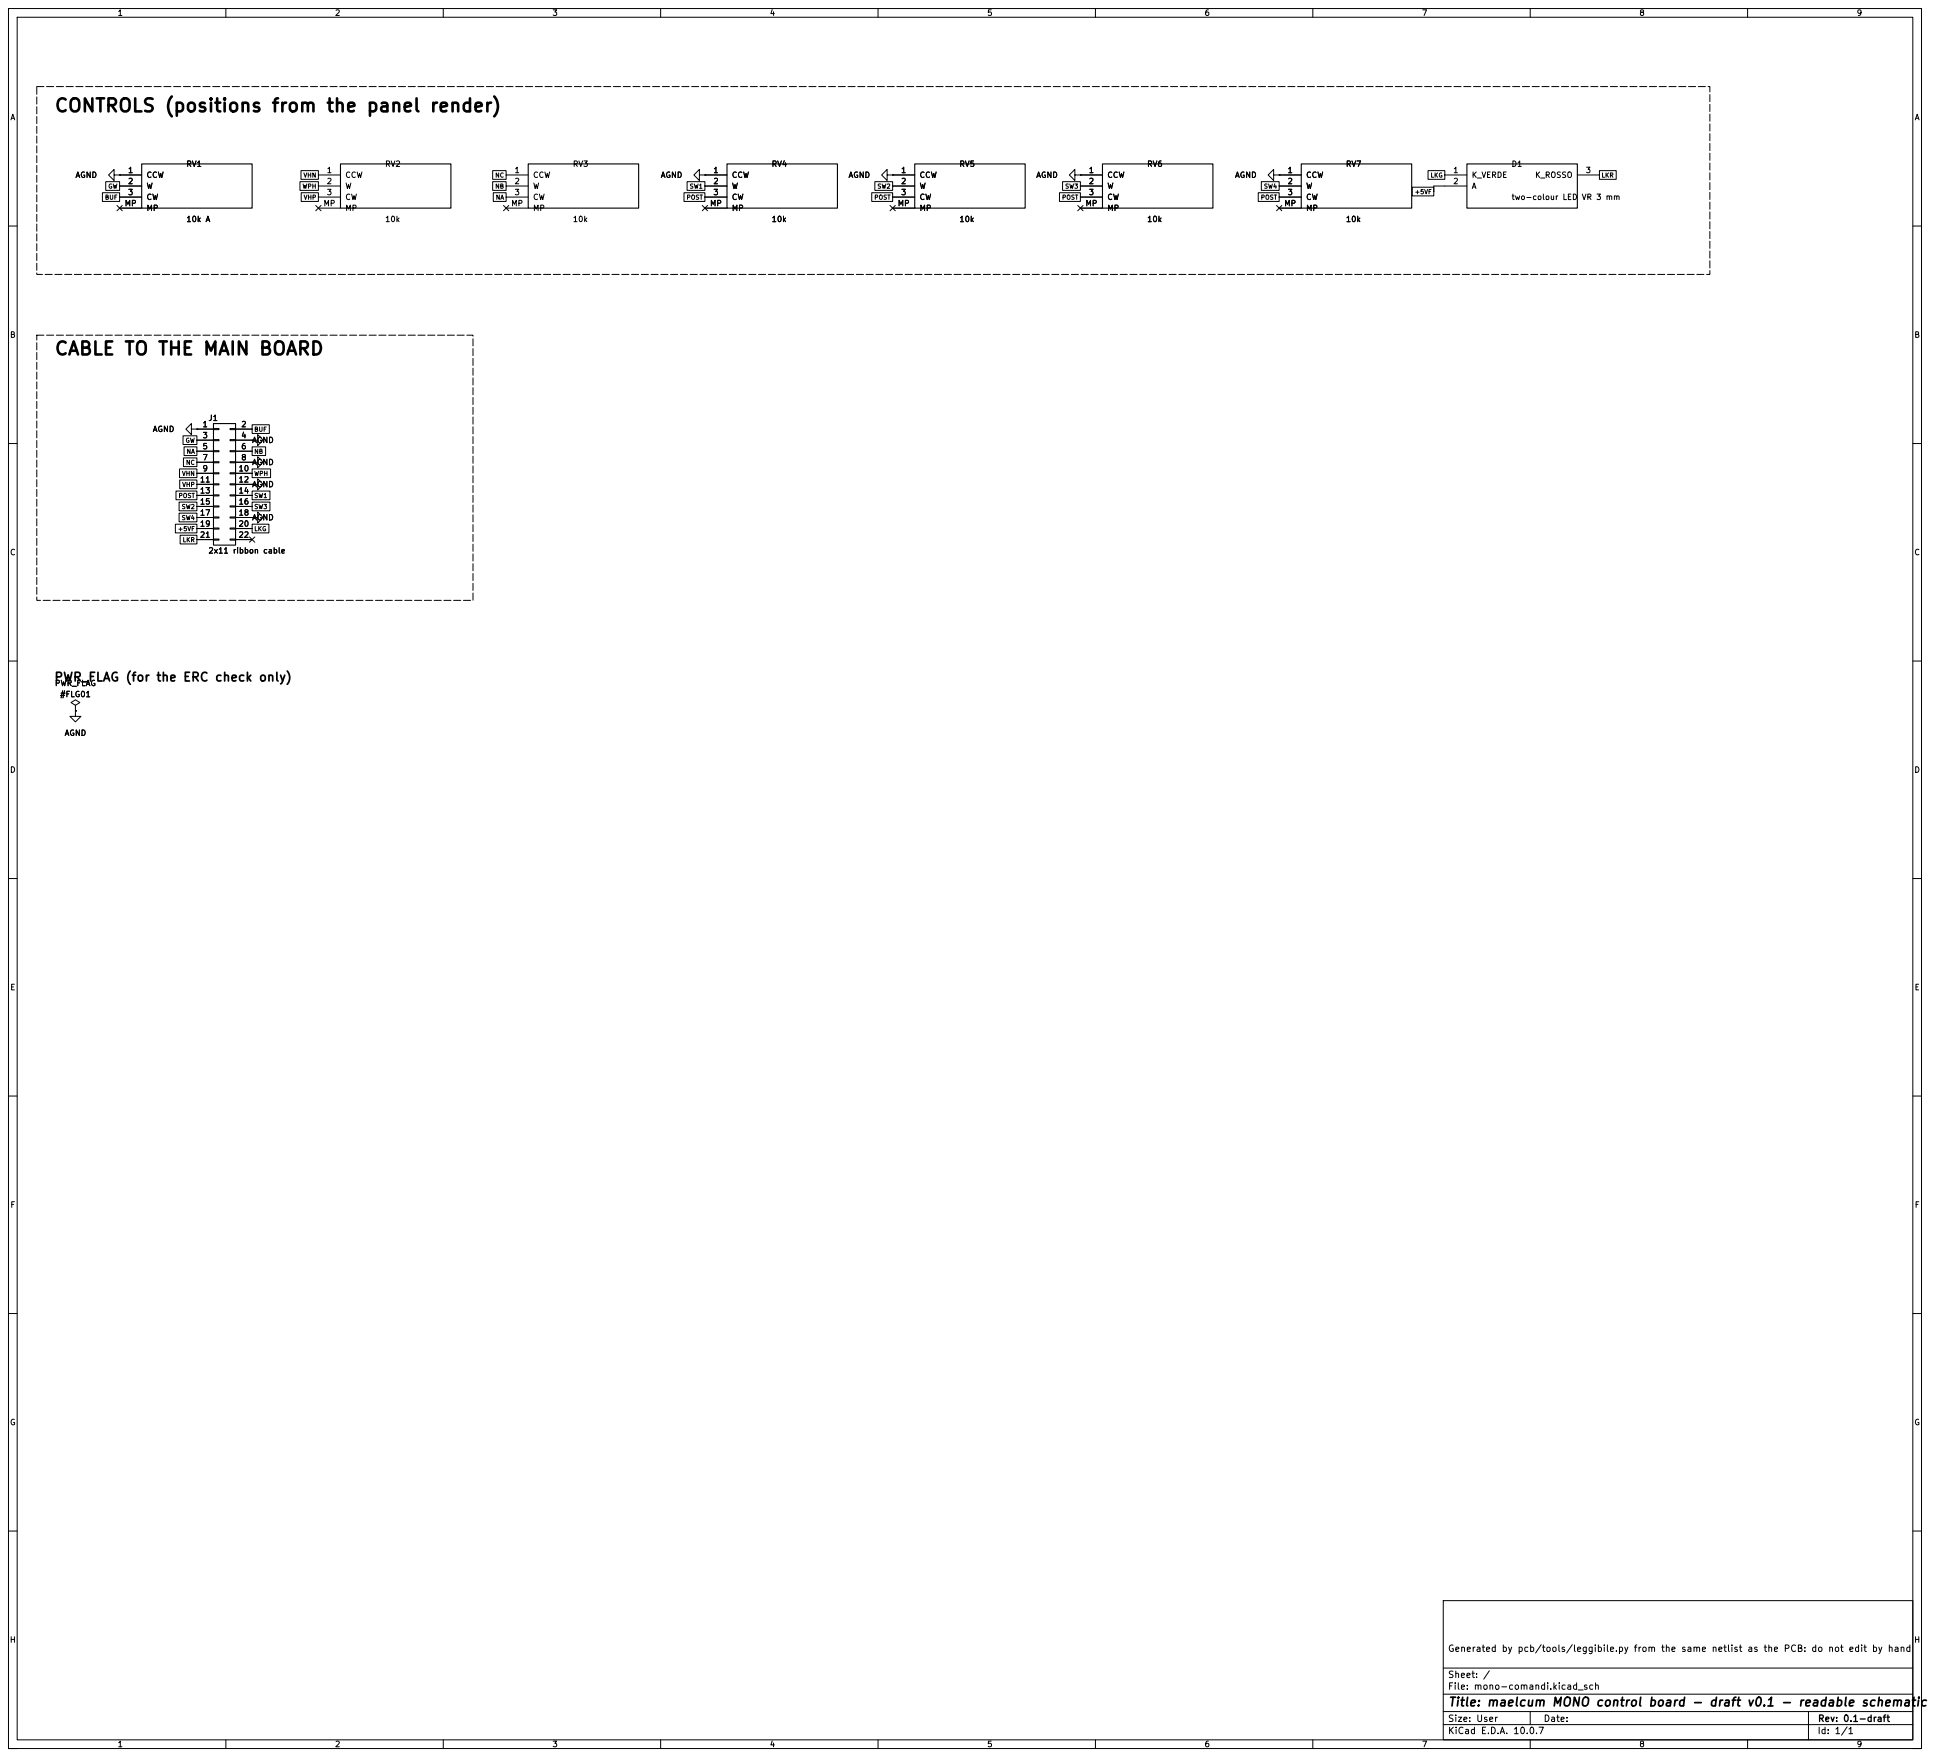
[picture p17: page 16]
FGH; FGH Date:; CCW 1; AGND; 2x11 ribbon cable; K_VERDE 1; K_ROSSO; CCW; AGND 1; 10k CCW 1; BUF; POST SW1; SW3 POST NC; POST NA; LKG; NA WPH; NCNB; VHN; LKR; POST; SW2 WPH; VHP; BUF NB; 2x11 ribbon cable 1; 10k A CCW 1; #FLG01 PWR_FLAG

two-colour LED VR 3 mm

PWR_FLAG (for the ERC check only)
#FLG01 PWR_FLAG

File: mono-comandi.kicad_sch
Title: maelcum MONO control board - draft v0.1 - readable schematic

# AGND V-

-18V C6

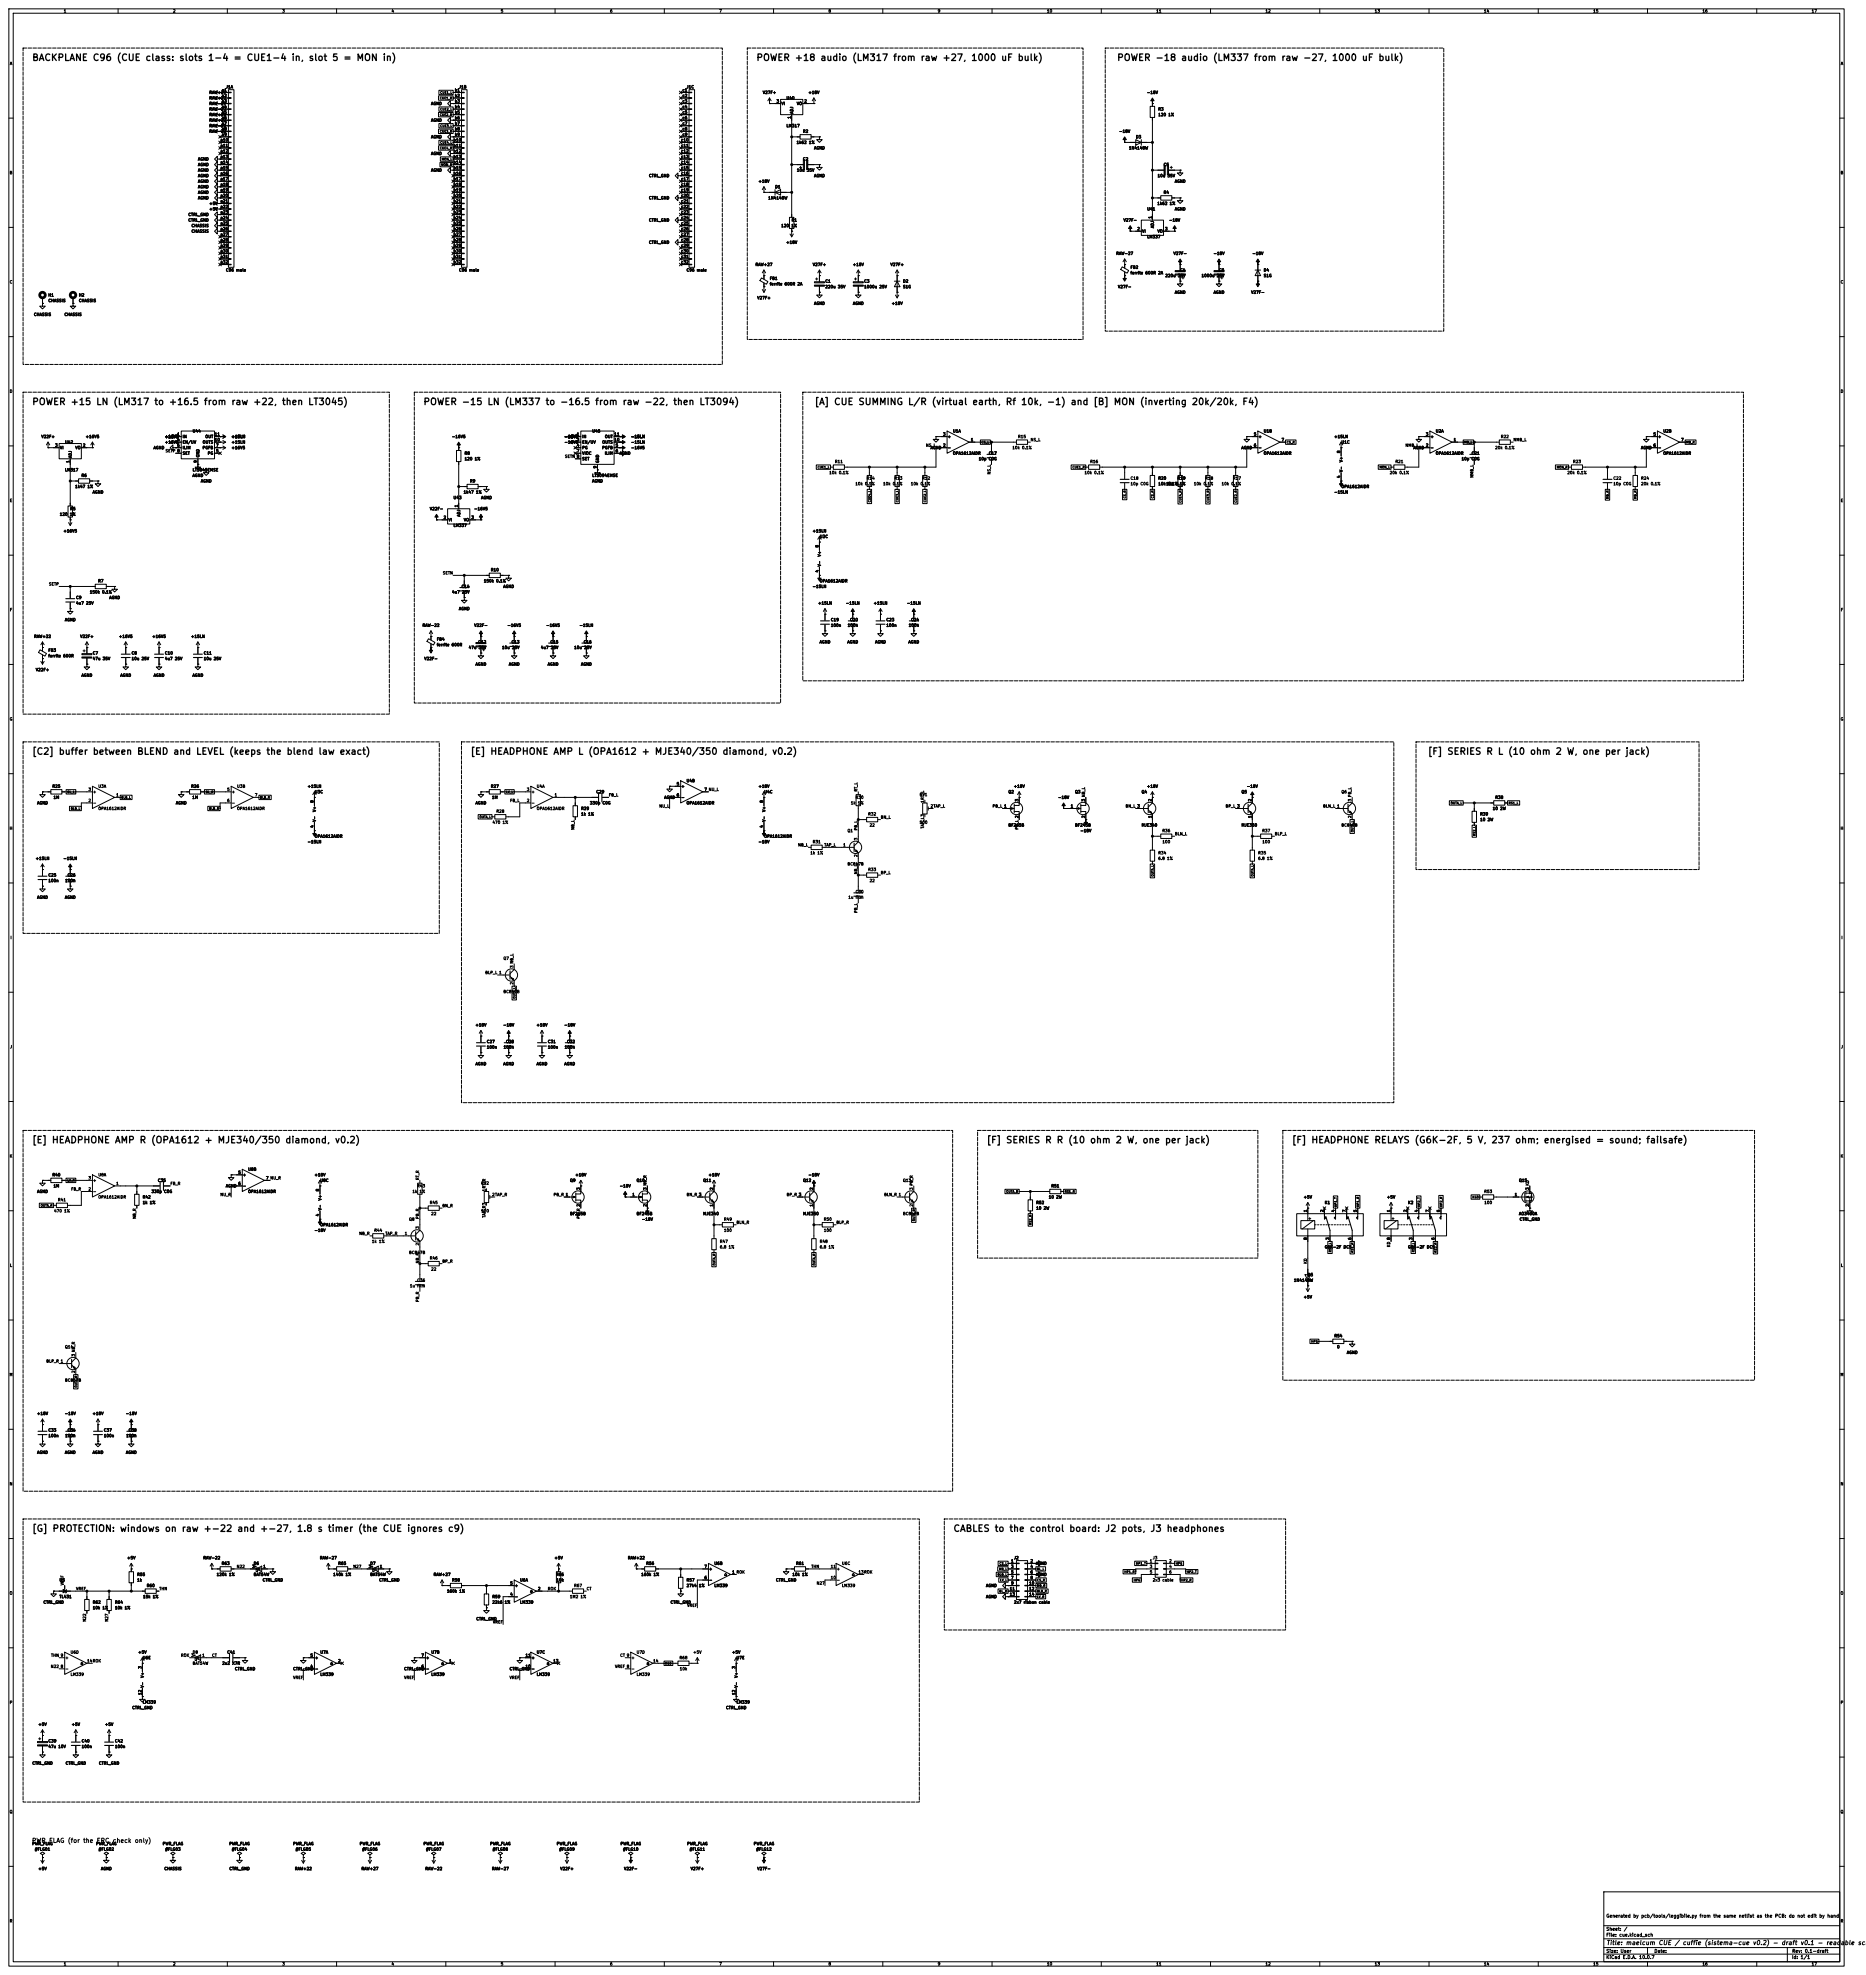
[picture p18: page 17]

BACKPLANE C96 (CUE class: slots 1-4 = CUE1-4 in, slot 5 = MON in)
RAW+22 +16V5

POWER +18 audio (LM317 from raw +27, 1000 uF bulk)

POWER -18 audio (LM337 from raw -27, 1000 uF bulk)
1N4148W OUTA_R

RAW+27 RAW+27 RAW-27 RAW-27 RAW+22 CTRL_GND

POWER +15 LN (LM317 to +16.5 from raw +22, then LT3045)

POWER -15 LN (LM337 to -16.5 from raw -22, then LT3094)

[A] CUE SUMMING L/R (virtual earth, Rf 10k, -1) and [B] MON (inverting 20k/20k, F4)

[C2] buffer between BLEND and LEVEL (keeps the blend law exact)

[F] SERIES R L (10 ohm 2 W, one per jack)

[F] SERIES R R (10 ohm 2 W, one per jack)

[F] HEADPHONE RELAYS (G6K-2F, 5 V, 237 ohm; energised = sound; failsafe)

[G] PROTECTION: windows on raw +-22 and +-27, 1.8 s timer (the CUE ignores c9)

CABLES to the control board: J2 pots, J3 headphones

File: cue.kicad_sch
Title: maelcum CUE / cuffie (sistema-cue v0.2) - draft v0.1 - readable schematic

CS_R | HP1_R HP1_T | HP1_T CABLES: J3 pots (J2 of cue.py), J4 headphones (J3 of cue.py)

# BLEND and LEVEL POTS, HEADPHONE JACKS (positions from the panel render)

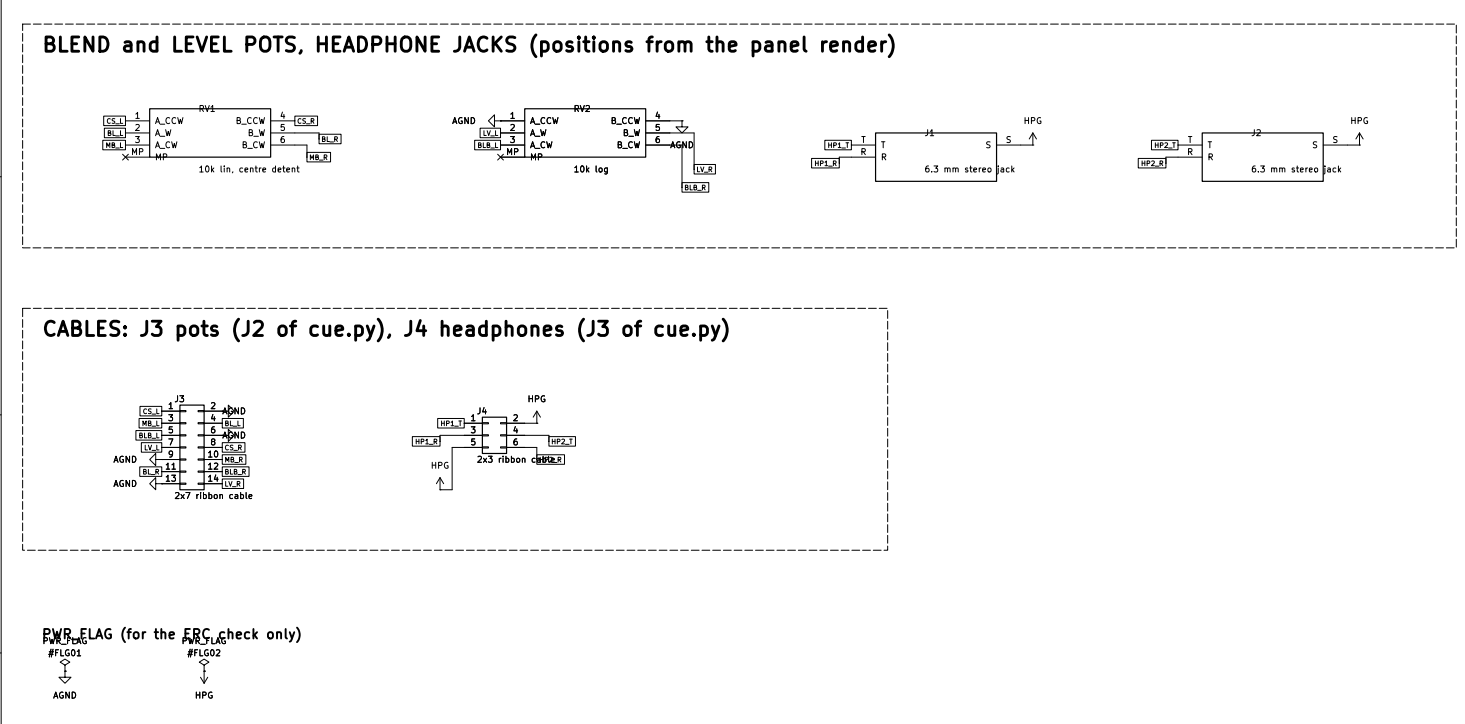
[picture p19: page 18]
FGH; FGH Date:; AGND; HPG; A_CCW 1 A_W 2; B_CCW; 10k lin, centre detent; 2x3 ribbon cable 1; #FLG02 PWR_FLAG; 10k log; BLB_L BL_L; BLB_R HP2_T CS_R; CS_L MB_L BLB_L; BLB_R MB_R; 2x7 ribbon cable 1; #FLG01 PWR_FLAG

6.3 mm stereo jack HPG

6.3 mm stereo jack AGND

AGND
2x7 ribbon cable HPG

PWR_FLAG (for the ERC check only)
#FLG01 PWR_FLAG

File: cue-comandi.kicad_sch
Title: maelcum CUE control board - draft v0.1 - readable schematic

# J1A C96 male

# CHASSIS C-19

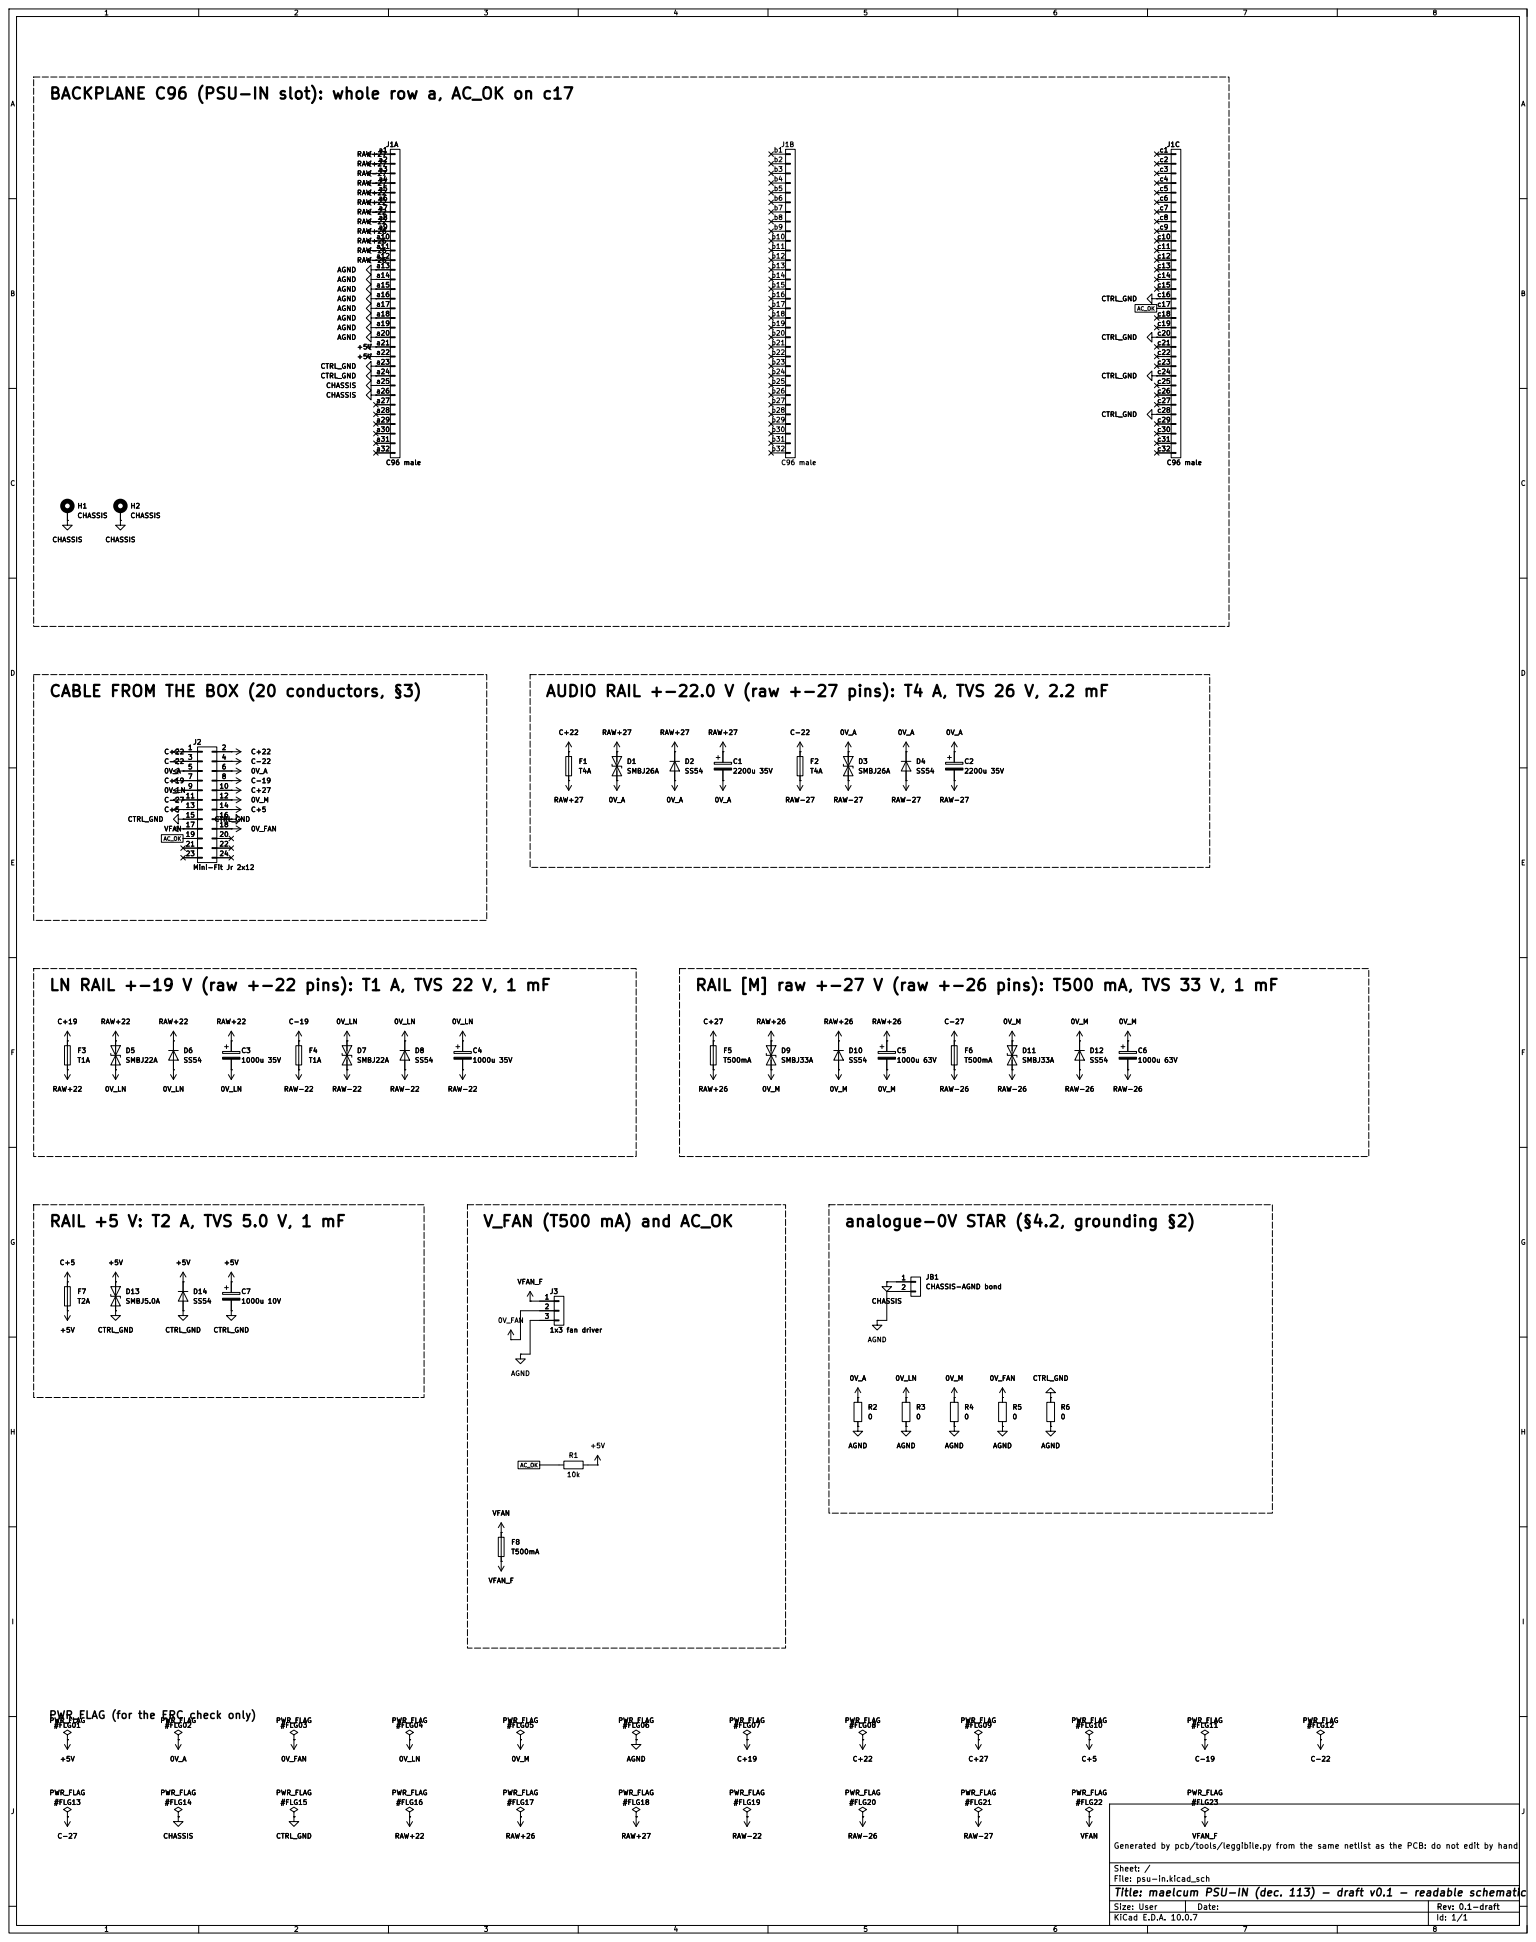
[picture p20: page 19]

BACKPLANE C96 (PSU-IN slot): whole row a, AC_OK on c17

CABLE FROM THE BOX (20 conductors, §3)
J2Mini-Fit Jr 2x12

AUDIO RAIL +-22.0 V (raw +-27 pins): T4 A, TVS 26 V, 2.2 mF

LN RAIL +-19 V (raw +-22 pins): T1 A, TVS 22 V, 1 mF

RAIL [M] raw +-27 V (raw +-26 pins): T500 mA, TVS 33 V, 1 mF

PWR_FLAG (for the ERC check only)

File: psu-in.kicad_sch
Title: maelcum PSU-IN (dec. 113) - draft v0.1 - readable schematic

# JMASA C96 female MAS

# JOUT_LA C96 female OUT_L

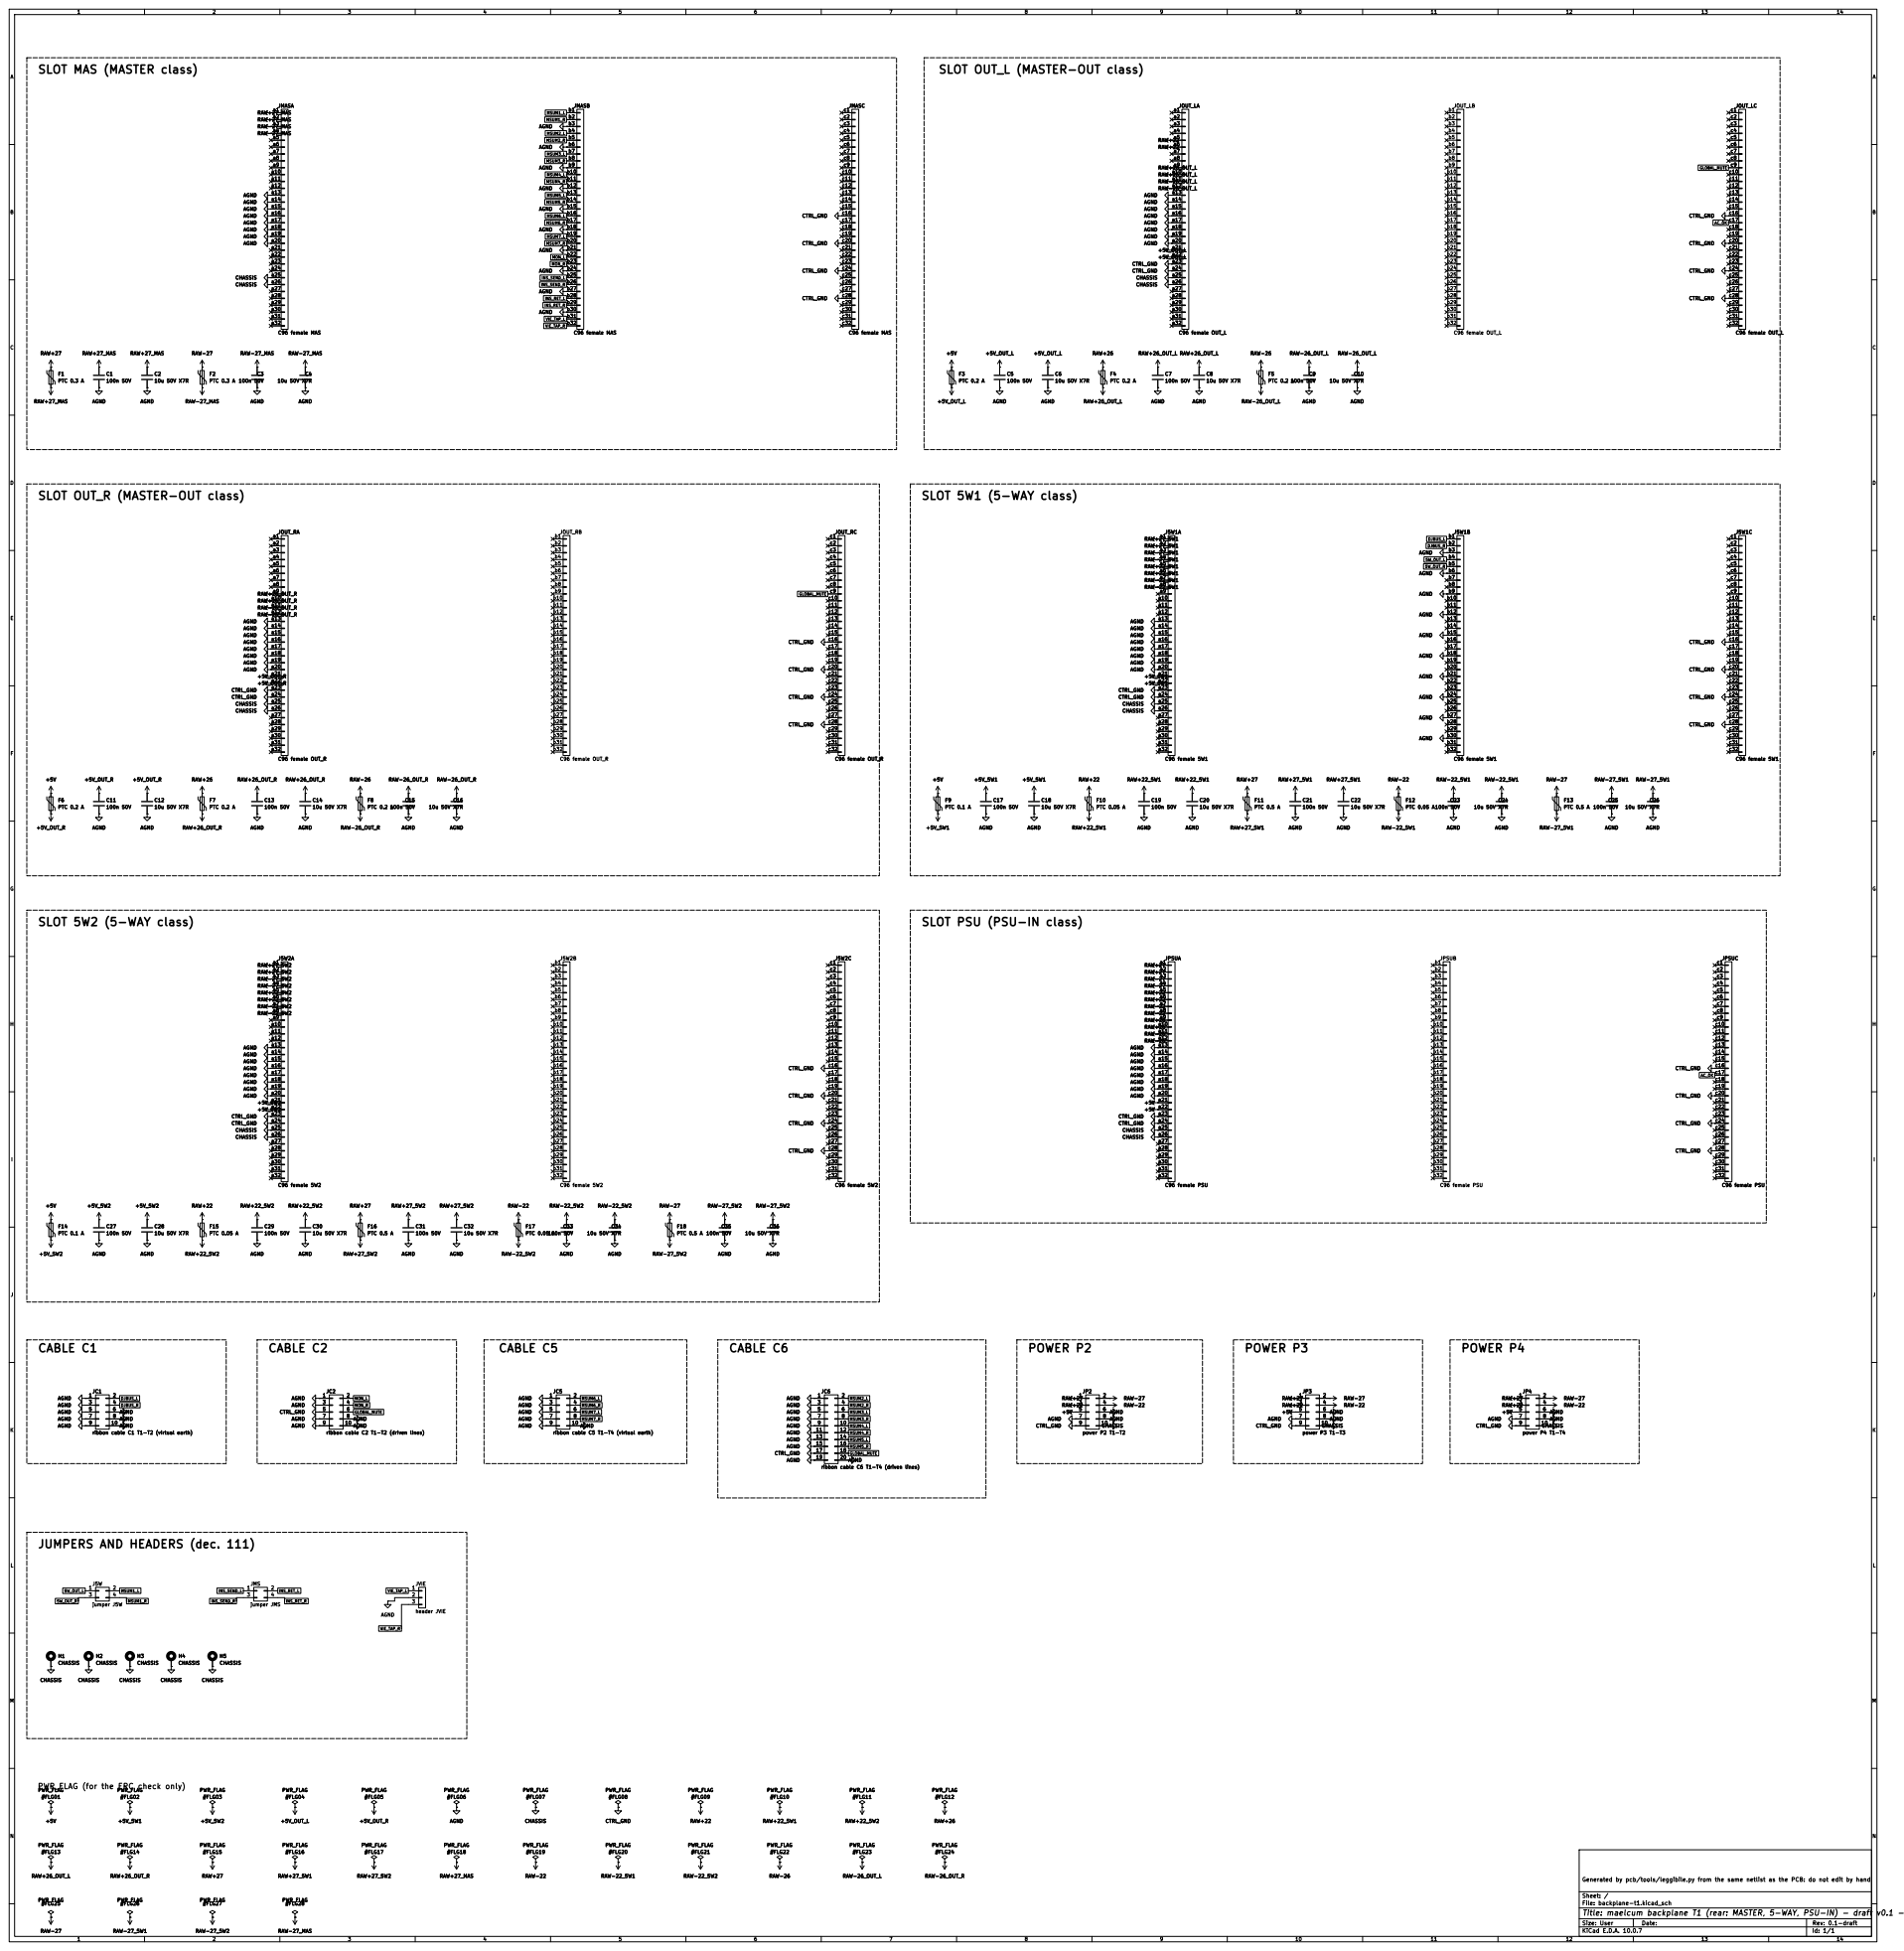
[picture p21: page 20]

SLOT MAS (MASTER class)

SLOT OUT_L (MASTER-OUT class)

SLOT OUT_R (MASTER-OUT class)

SLOT PSU (PSU-IN class)

JPSUA C96 female PSU
a32 RAW-22 RAW+27 RAW+27 RAW-27 CHASSIS CTRL_GND

ribbon cable C1 T1-T2 (virtual earth)

ribbon cable C2 T1-T2 (driven lines)

ribbon cable C5 T1-T4 (virtual earth)

ribbon cable C6 T1-T4 (driven lines)

JUMPERS AND HEADERS (dec. 111)

PWR_FLAG (for the ERC check only)
#FLG01 PWR_FLAG

File: backplane-t1.kicad_sch
Title: maelcum backplane T1 (rear: MASTER, 5-WAY, PSU-IN) - draft v0.1 - readable schematic

# JCH2A C96 female CH2

# JCH1A C96 female CH1

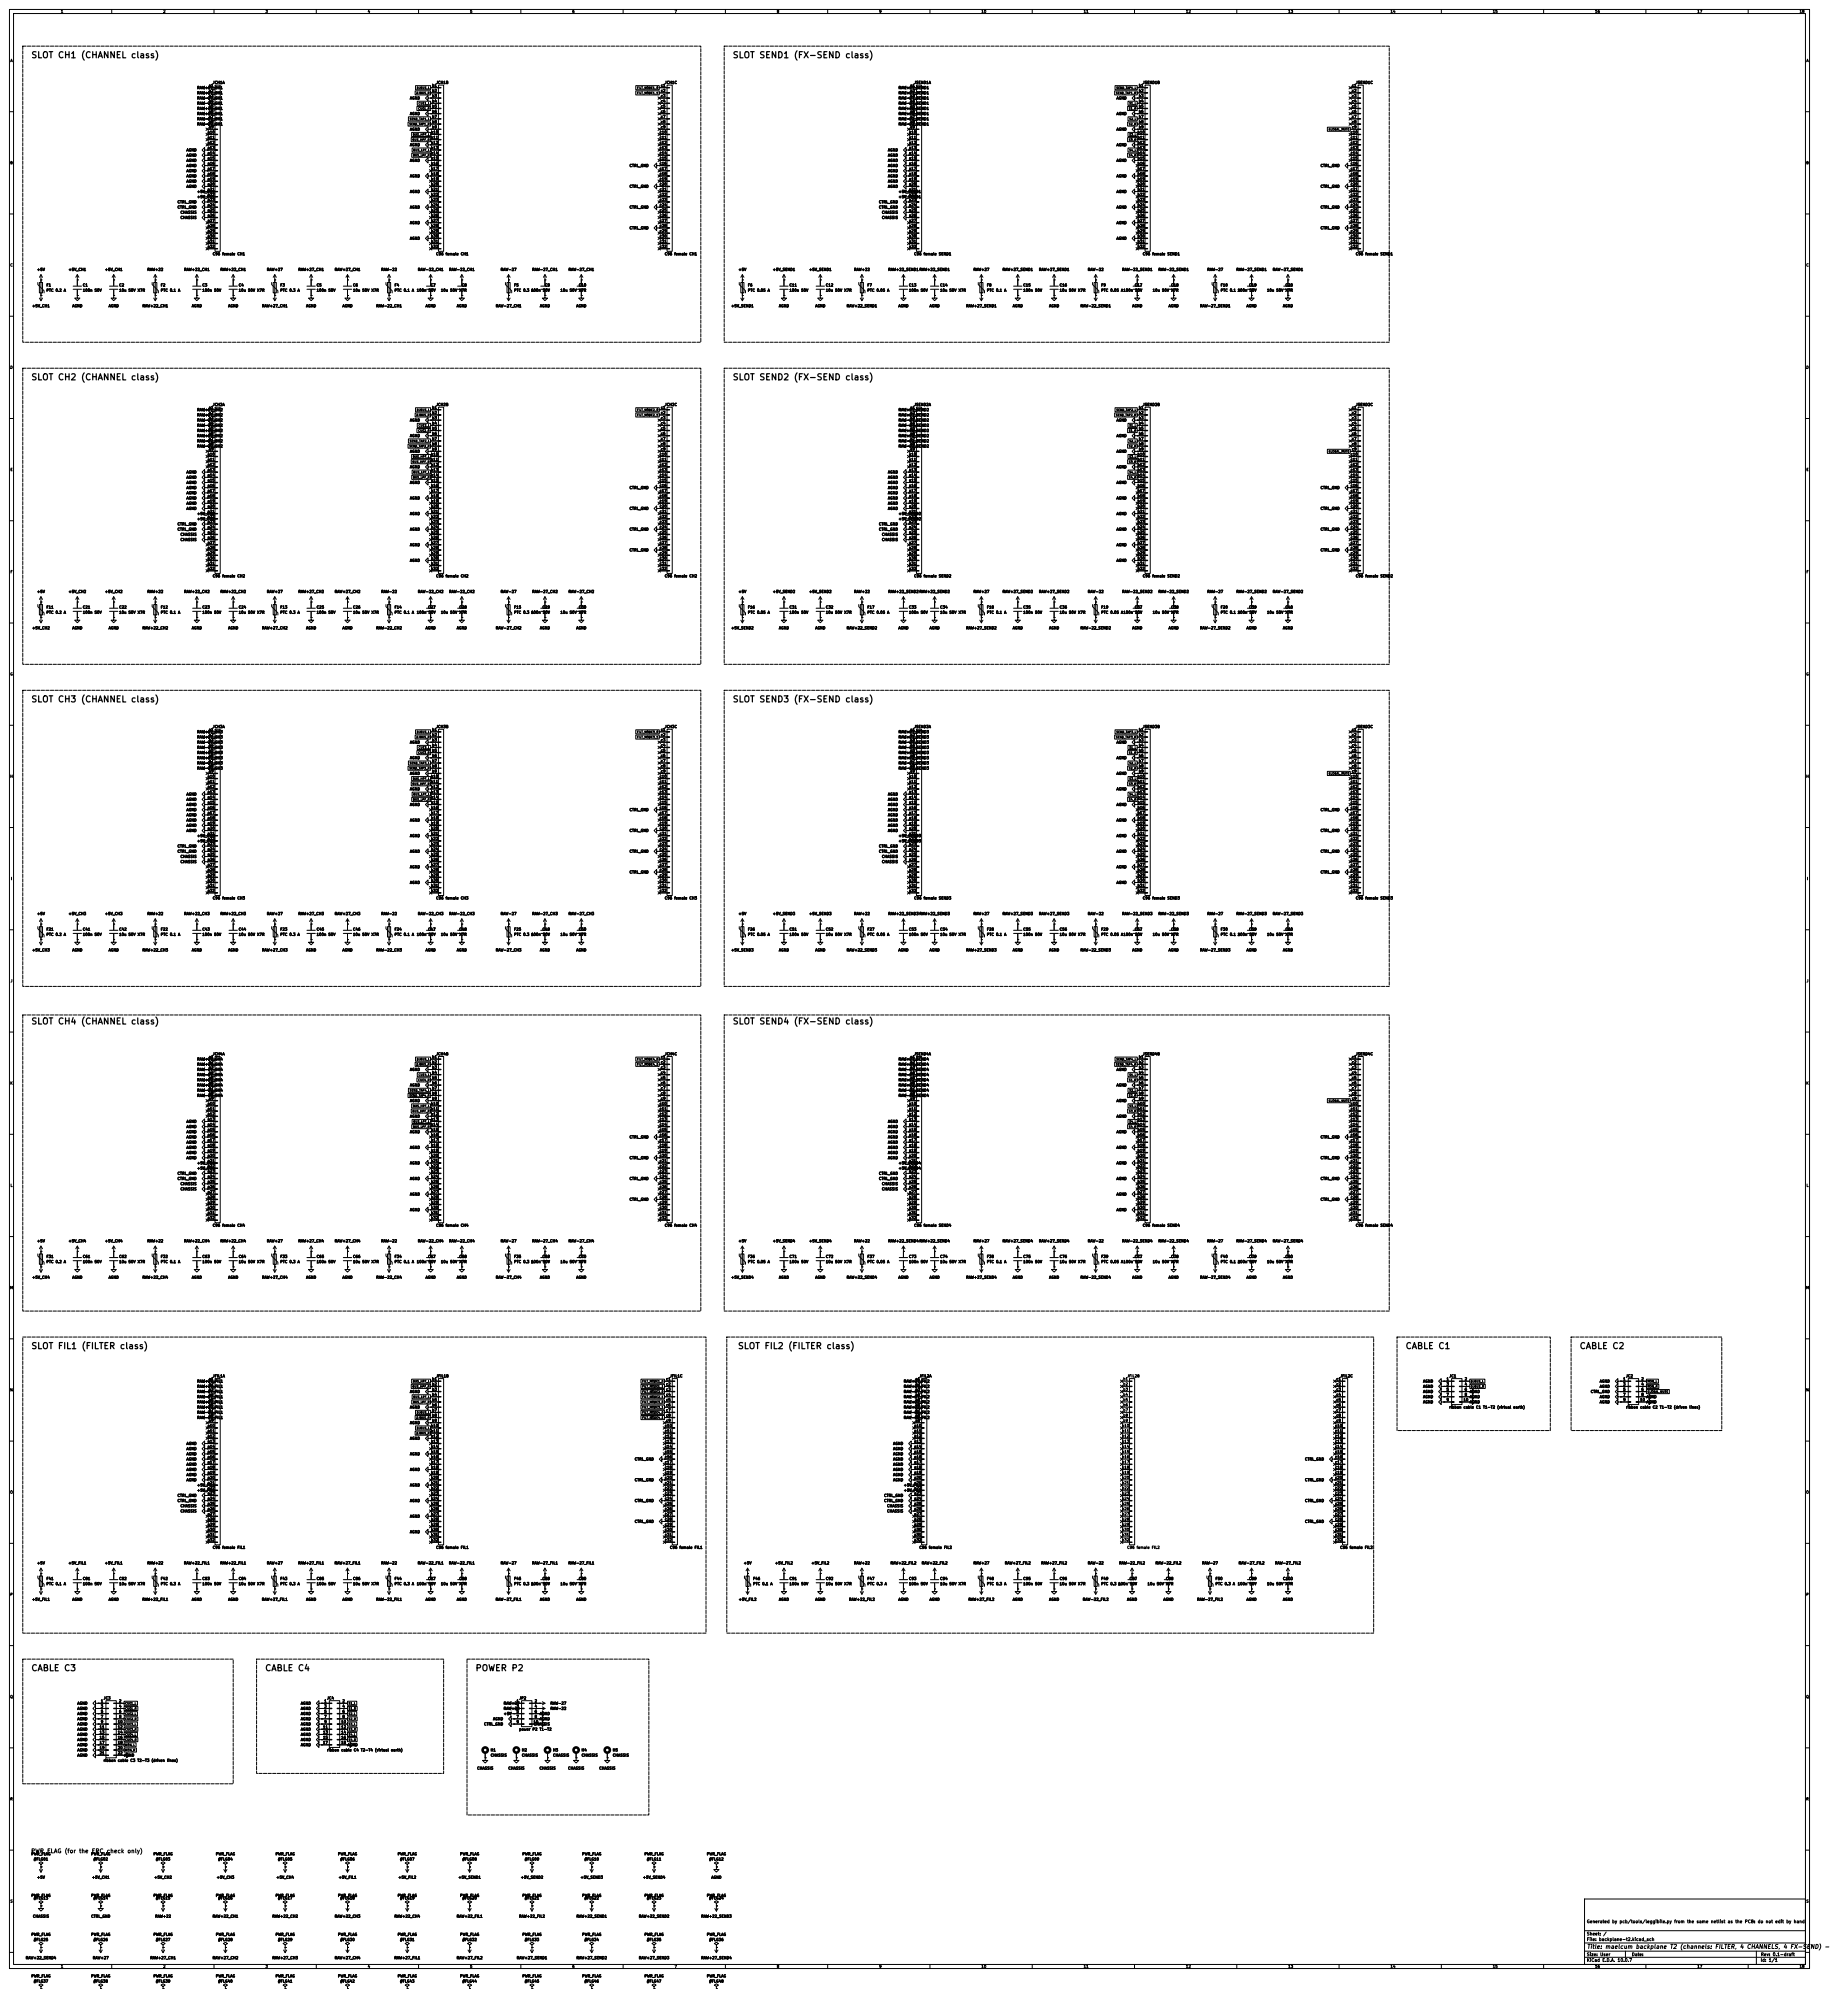
[picture p22: page 21]

SLOT SEND1 (FX-SEND class)

SLOT SEND2 (FX-SEND class)

SLOT SEND3 (FX-SEND class)

SLOT SEND4 (FX-SEND class)

RAW+27_FIL1 RAW-22_FIL1 RAW-22_FIL1 RAW+22_FIL1 RAW+27_FIL1 RAW-27_FIL1 RAW-27_FIL1 RAW+22_FIL1 RAW+22

RAW-27_FIL2 RAW+22_FIL2 RAW-22_FIL2 RAW-22_FIL2 RAW+22_FIL2 RAW+27_FIL2 RAW+27_FIL2 RAW-27_FIL2 RAW+22_SEND4

ribbon cable C1 T1-T2 (virtual earth)

ribbon cable C2 T1-T2 (driven lines)

ribbon cable C3 T2-T3 (driven lines)

File: backplane-t2.kicad_sch
Title: maelcum backplane T2 (channels: FILTER, 4 CHANNELS, 4 FX-SEND) - draft v0.1 - readable schematic

RAW+27_SEND4 RAW-27 RAW+27_SEND3 RAW-22_SEND4

# JCUEA C96 female CUE

# CUE3_L CUE1_R MON_L CUE4_R

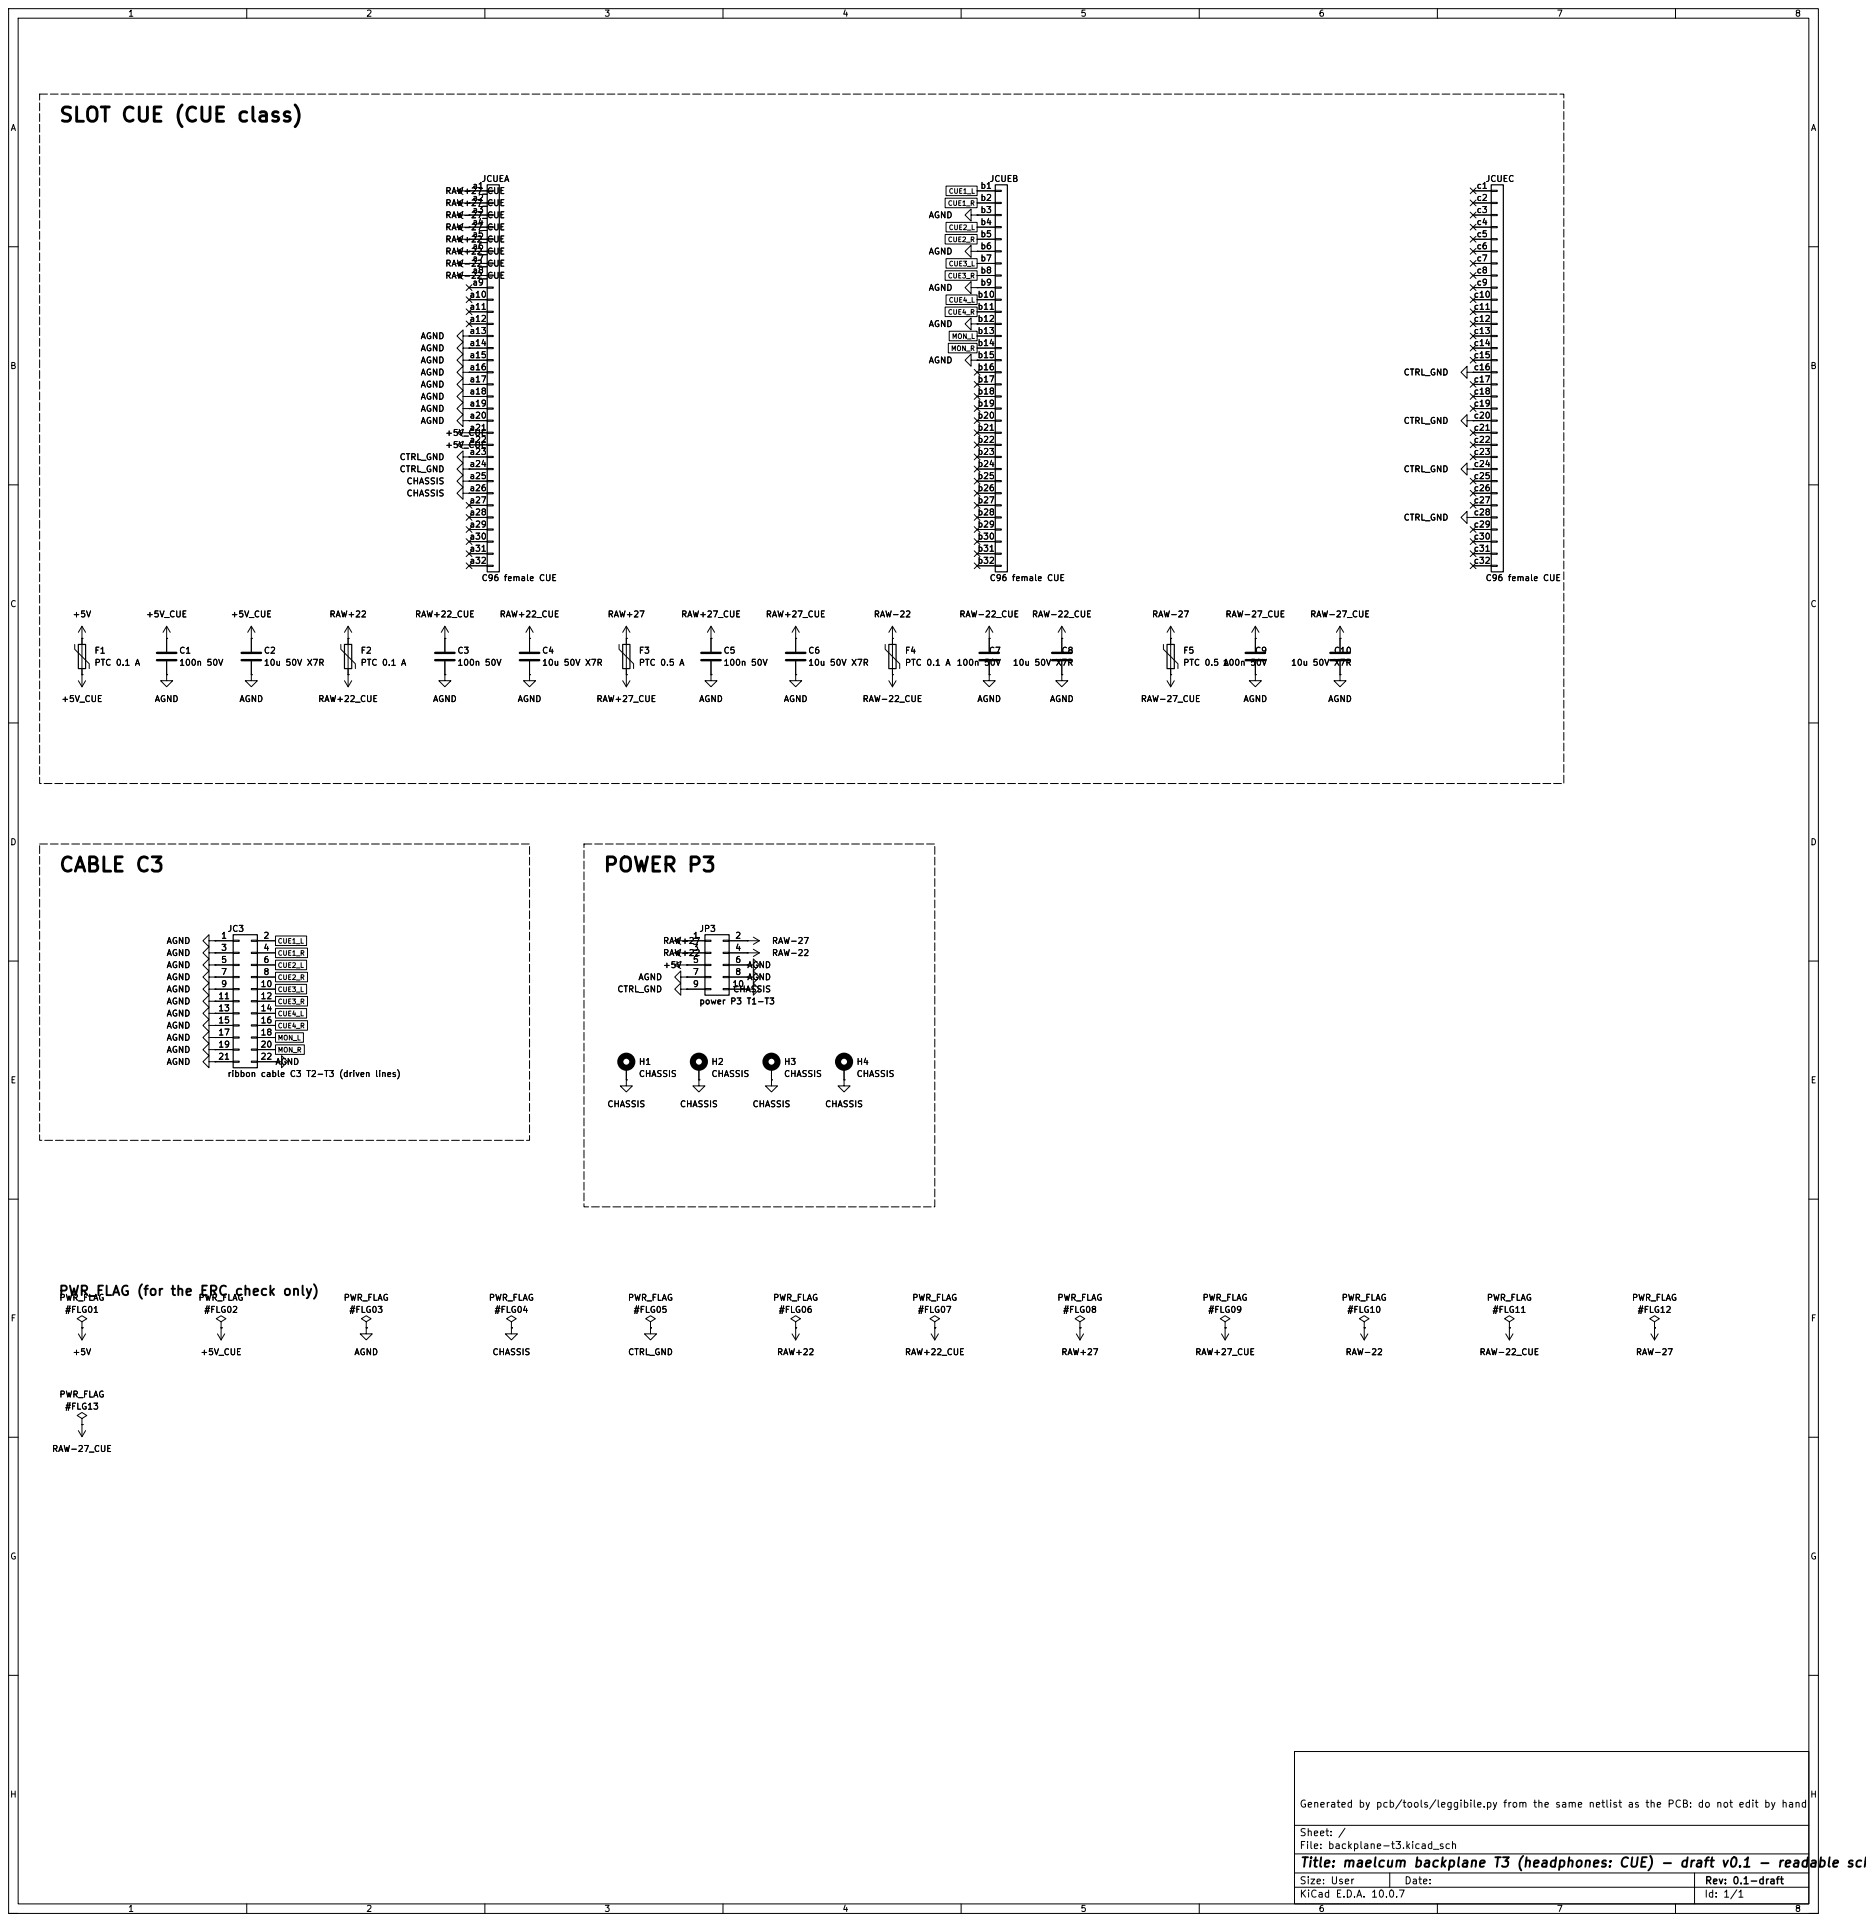
[picture p23: page 22]

SLOT CUE (CUE class)

CUE2_R PWR_FLAG (for the ERC check only)

File: backplane-t3.kicad_sch
Title: maelcum backplane T3 (headphones: CUE) - draft v0.1 - readable schematic

# JRET1A C96 female RET1

# JMICA C96 female MIC

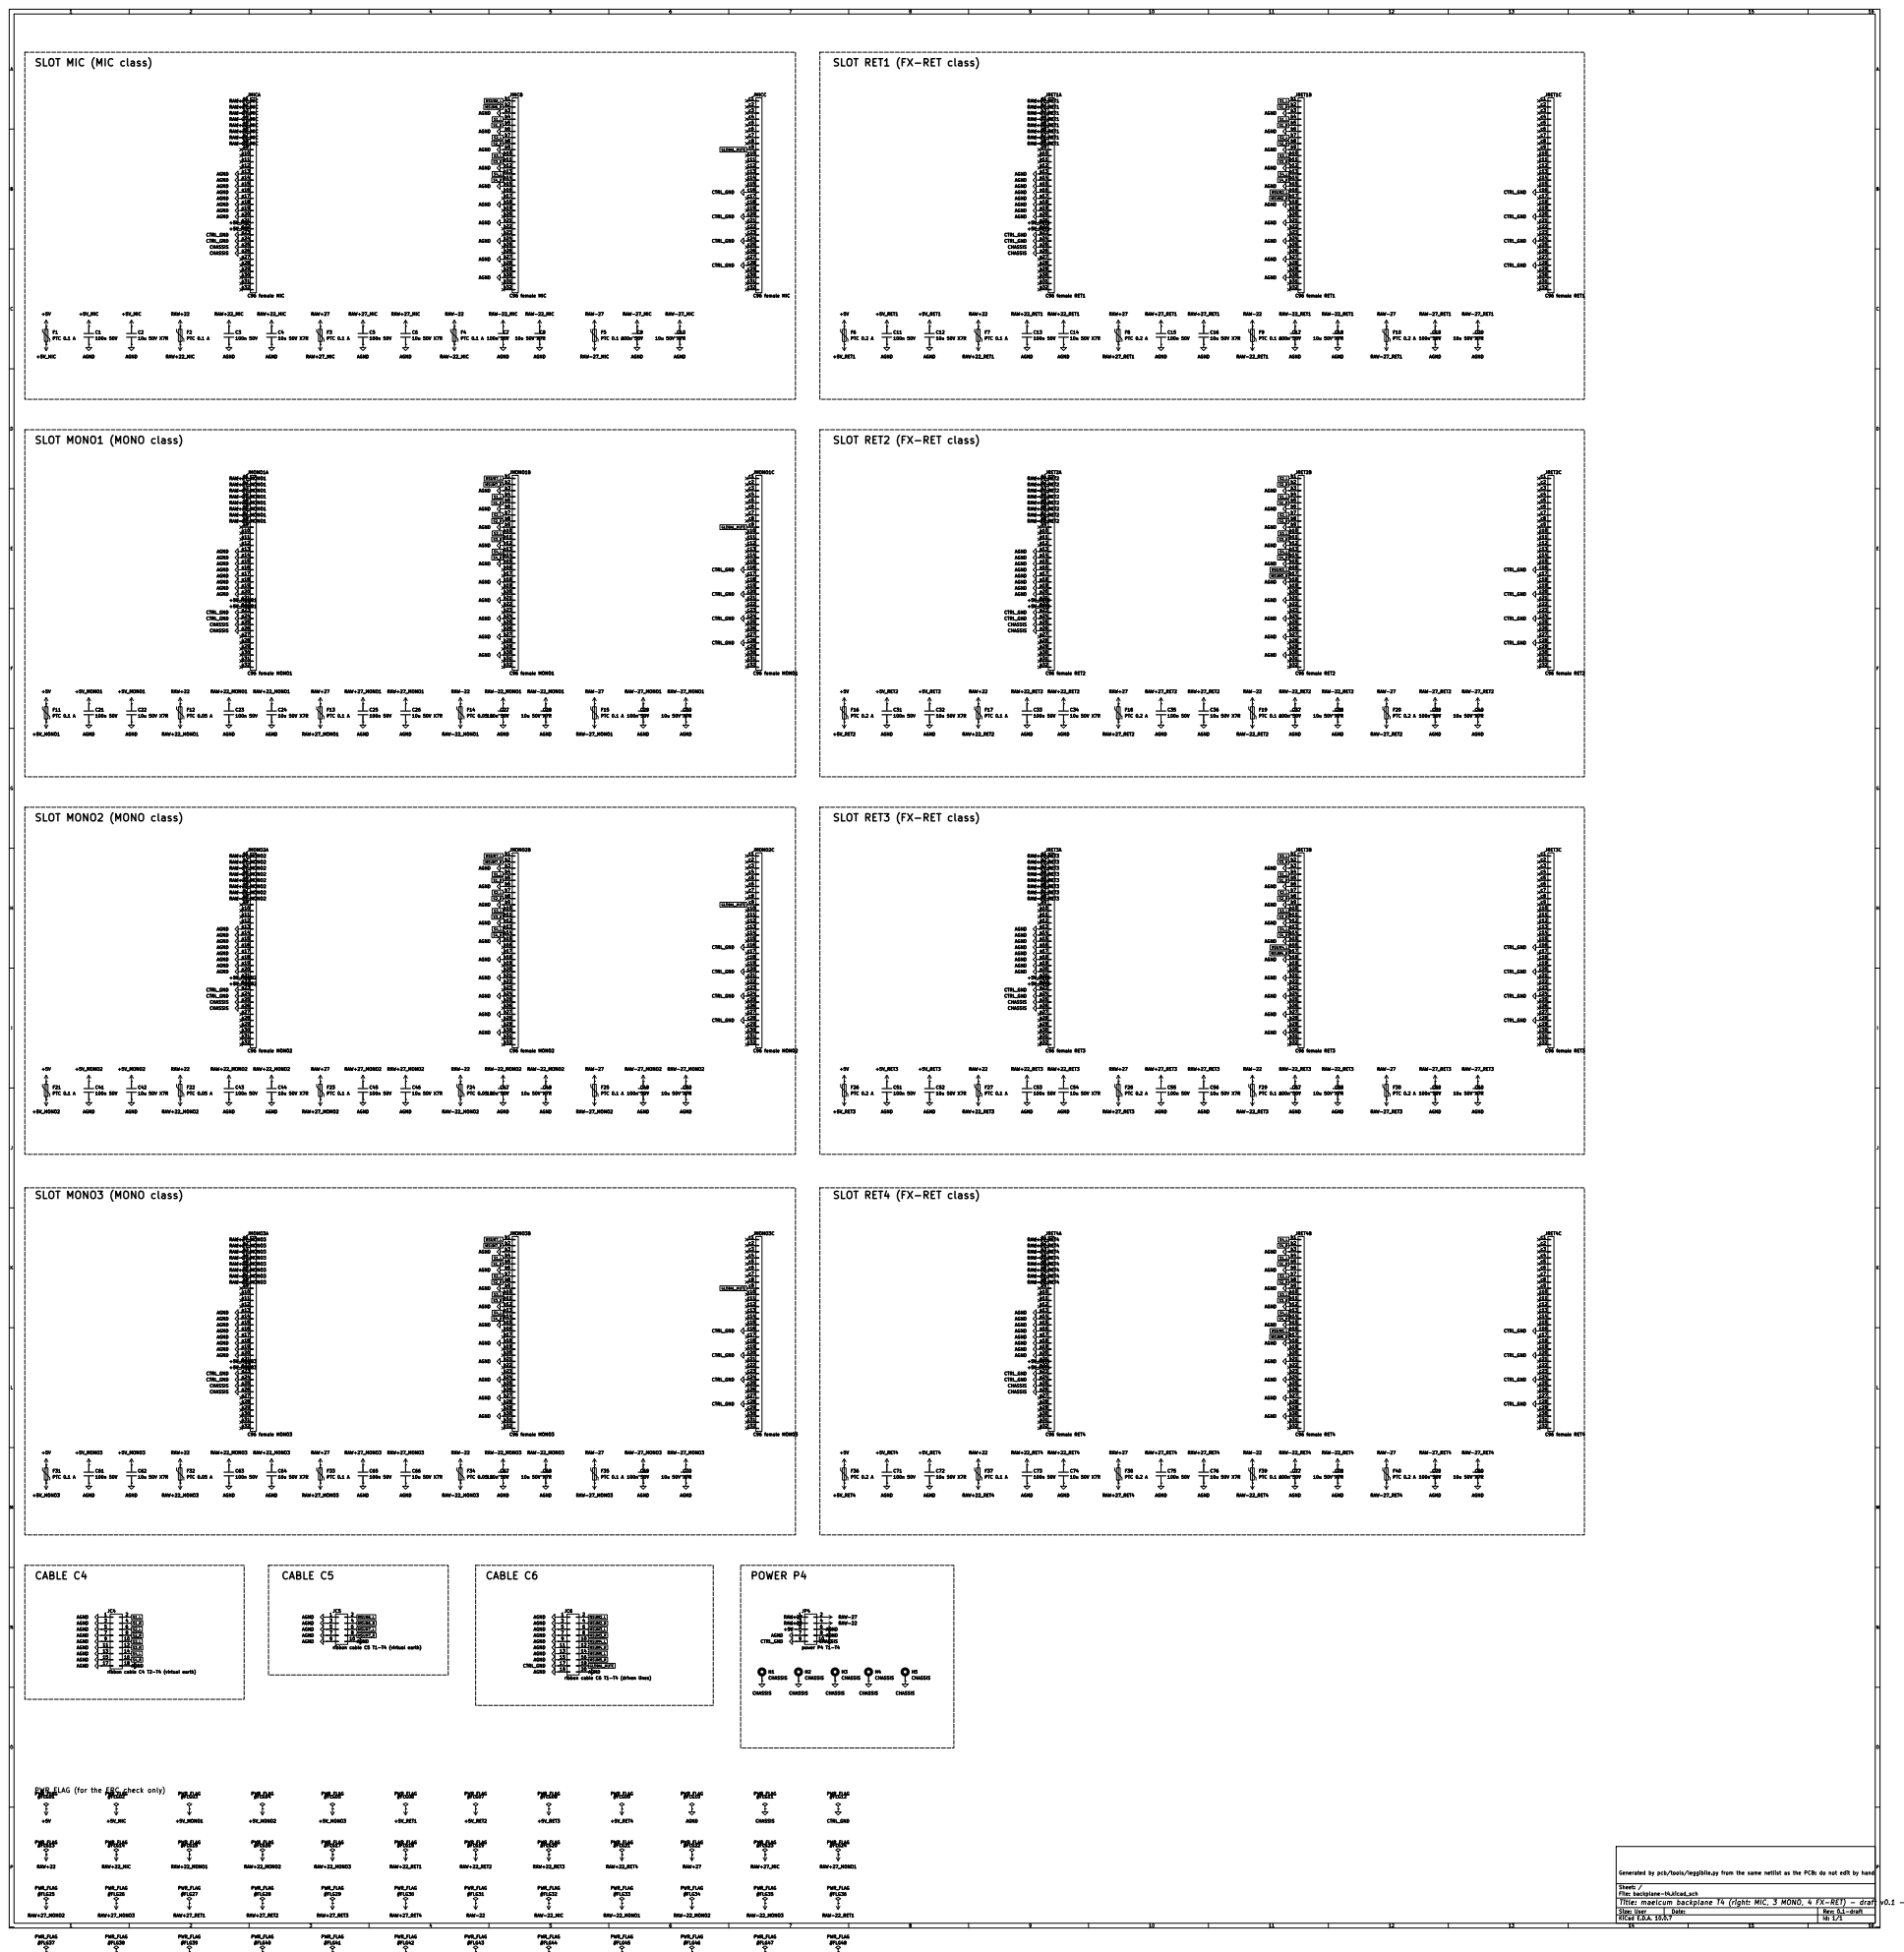
[picture p24: page 23]

SLOT MIC (MIC class)

SLOT RET1 (FX-RET class)

RAW+27_RET1 RAW-27_RET1 RAW-27_RET1 RAW+27_RET1 RAW+22_RET1 RAW+22_RET1 RAW-22_RET1 RAW-22_RET1

SLOT RET2 (FX-RET class)

SLOT RET3 (FX-RET class)

RAW+27_MONO2 RAW+27_MONO2 RAW-27_MONO2 RAW-27_MONO2

SLOT MONO3 (MONO class)
a32 RAW+27_MONO3 RAW+27_MONO3 RAW-27_MONO3 RAW-22_MONO3 RAW-22_MONO3 RAW-27_MONO3 RAW+22_MONO3 RAW+22_MONO3 CHASSIS CTRL_GND

SLOT RET4 (FX-RET class)

ribbon cable C5 T1-T4 (virtual earth)

ribbon cable C4 T2-T4 (virtual earth)

ribbon cable C6 T1-T4 (driven lines)

File: backplane-t4.kicad_sch
Title: maelcum backplane T4 (right: MIC, 3 MONO, 4 FX-RET) - draft v0.1 - readable schematic
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
