dj-filippo241/maelcum_mixer/docs/pannelli/pannelli.pdf

# Moduli singoli

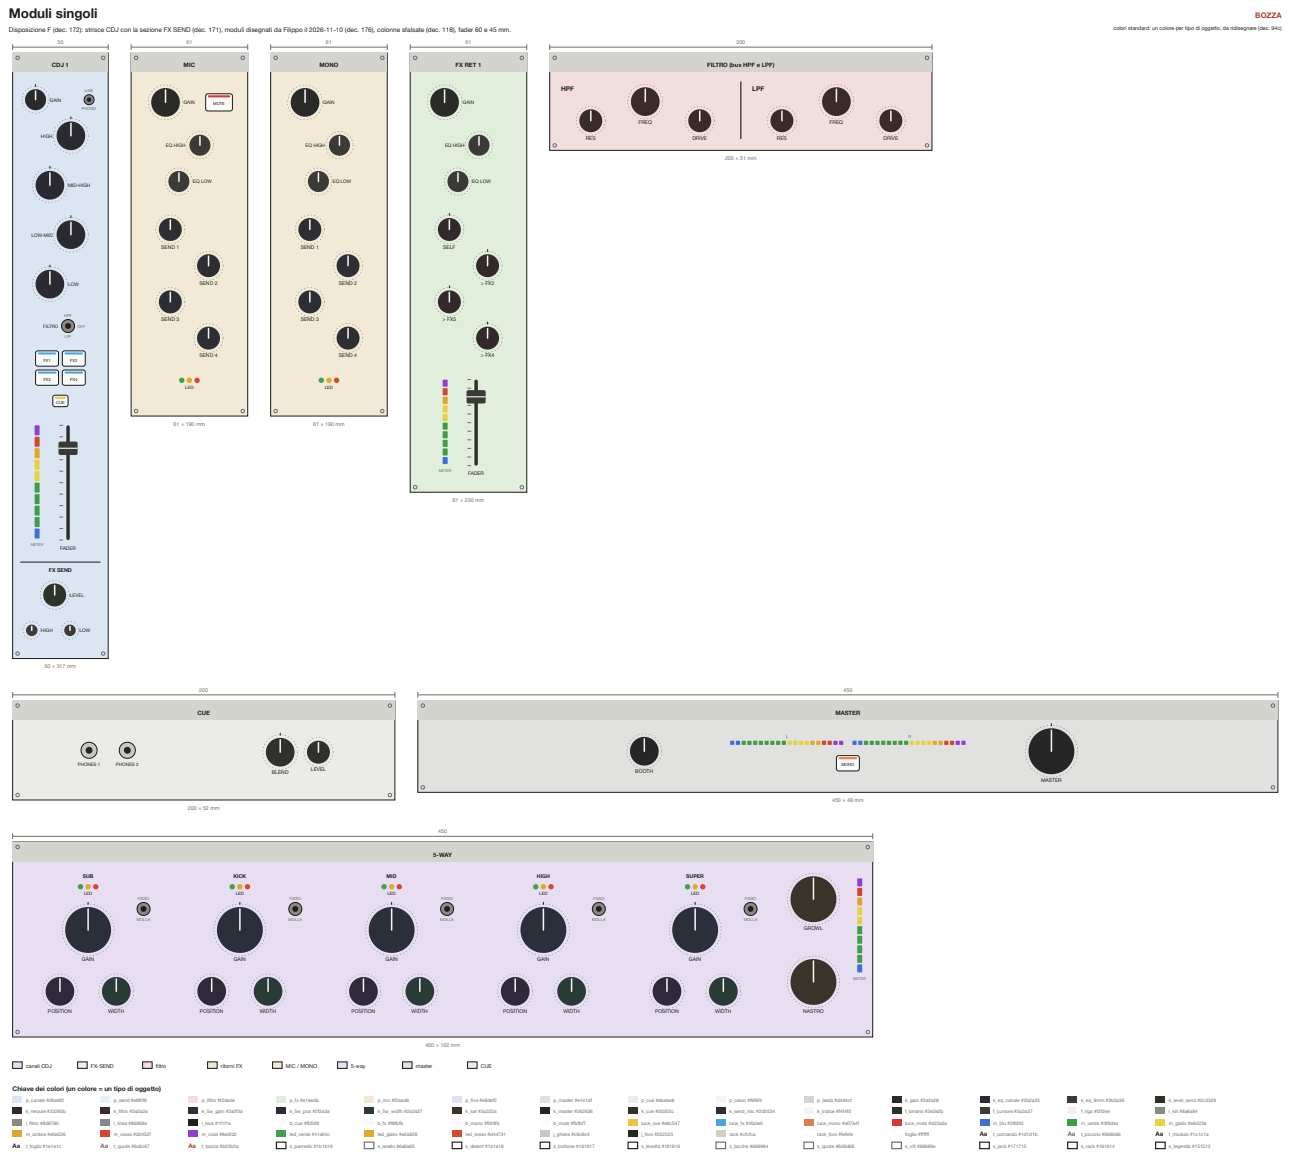
[picture p25: page 1]
BOZZA; CDJ 1; GAIN; LINE; PHONO; HIGH; MID-HIGH; LOW-MID; LOW; HPF; LPF; FILTRO; OFF; CUE; METER; FADER; FX SEND; LEVEL; MIC; EQ HIGH; EQ LOW; MUTE; SEND 1; SEND 2; SEND 3; SEND 4; LED; MONO; FX RET 1; SELF; RES; FREQ; DRIVE; PHONES 1; PHONES 2; BLEND; MASTER; BOOTH; 5-WAY; SUB; FISSO; MOLLA; POSITION; WIDTH; KICK; MID; SUPER; GROWL; NASTRO; canali CDJ; FX-SEND; filtro; ritorni FX; MIC / MONO; 5-way; master; p_canale #dbe6f2; p_send #e8f0f8; p_filtro #f2dede; p_fx #e1eedb; p_mic #f2ead6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

Disposizione F (dec. 172): strisce CDJ con la sezione FX SEND (dec. 171), moduli disegnati da Filippo il 2026-11-10 (dec. 176), colonne sfalsate (dec. 118), fader 60 e 45 mm.

colori standard: un colore per tipo di oggetto, da ridisegnare (dec. 94c)

FILTRO (bus HPF e LPF)

Chiave dei colori (un colore = un tipo di oggetto)

# Setup ridotto

2 canali CDJ con FX SEND · 1 MIC · 1 MONO · 4 FX RET · filtro · 5-way · master · CUE · telaio inclinato (dec. 158) · tetto 70 % (dec. 156) · disposizione F (dec. 172)

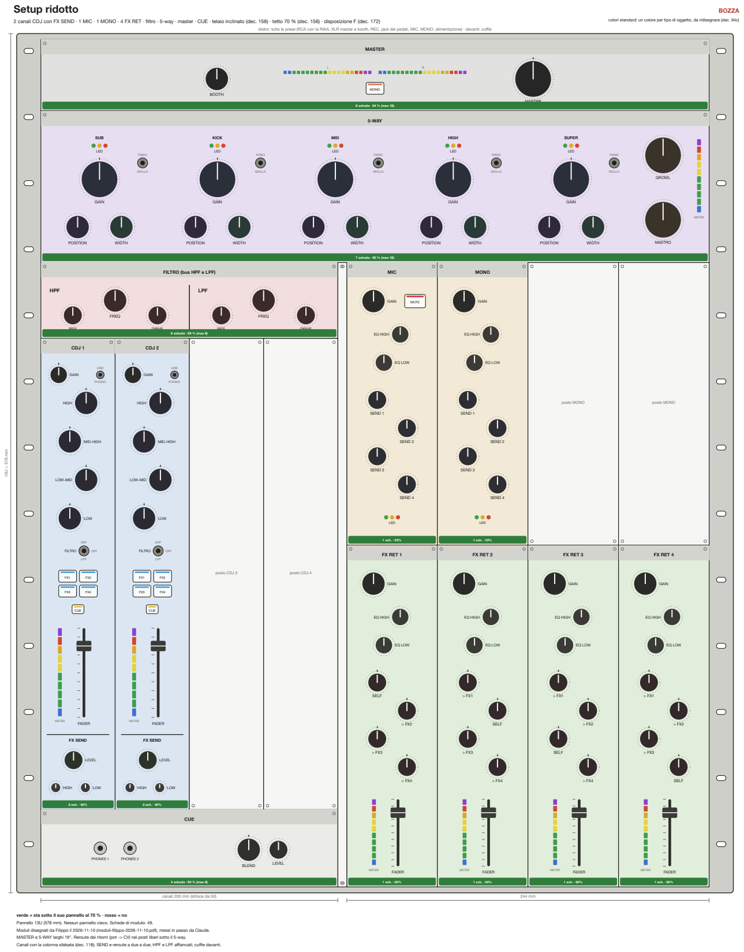
[picture p26: page 2]
MASTER; BOOTH; MONO; 5-WAY; SUB; LED; FISSO; MOLLA; GAIN; POSITION; WIDTH; KICK; MID; HIGH; SUPER; GROWL; NASTRO; METER; HPF; RES; FREQ; DRIVE; LPF; CDJ 1; LINE; PHONO; MID-HIGH; LOW-MID; LOW; FILTRO; OFF; CUE; FADER; FX SEND; LEVEL; CDJ 2; posto CDJ 3; posto CDJ 4; PHONES 1; PHONES 2; BLEND; MIC; EQ HIGH; EQ LOW; MUTE; SEND 1; SEND 2; SEND 3; SEND 4; posto MONO; FX RET 1; SELF; FX RET 2; FX RET 3; FX RET 4; 8 schede · 64 % (max 18); 7 schede · 60 % (max 18); 6 schede · 69 % (max 8)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

dietro: tutte le prese (RCA con la RIAA, XLR master e booth, REC, jack dei pedali, MIC, MONO, alimentazione) · davanti: cuffie

FILTRO (bus HPF e LPF)

verde = sta sotto il suo pannello al 70 % · rosso = no
Pannello 13U (578 mm). Nessun pannello cieco. Schede di modulo: 49.
Moduli disegnati da Filippo il 2026-11-10 (moduli-filippo-2026-11-10.pdf), messi in passo da Claude.
MASTER e 5-WAY larghi 19". Reroute dei ritorni (pot -> CV) nei posti liberi sotto il 5-way.
Canali con la colonna sfalsata (dec. 118); SEND e reroute a due a due; HPF e LPF affiancati; cuffie davanti.

# Setup completo

4 canali CDJ con FX SEND · 1 MIC · 3 MONO · 4 FX RET · filtro · 5-way · master · CUE · telaio inclinato (dec. 158) · tetto 70 % (dec. 156) · disposizione F (dec. 172)

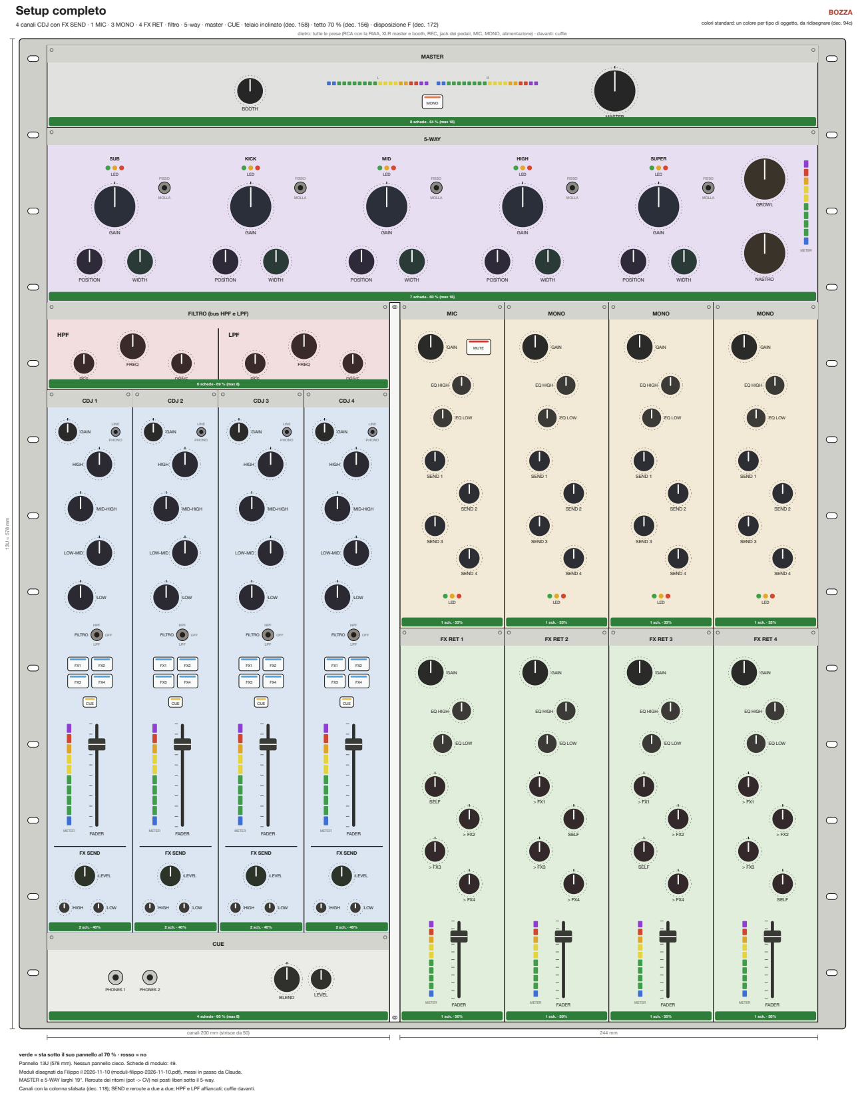
[picture p27: page 3]
BOOTH; MONO; MASTER; 5-WAY; SUB; LED; FISSO; MOLLA; GAIN; POSITION; WIDTH; KICK; MID; HIGH; SUPER; GROWL; NASTRO; METER; HPF; RES; FREQ; DRIVE; LPF; CDJ 1; LINE; PHONO; MID-HIGH; LOW-MID; LOW; FILTRO; OFF; CUE; FADER; FX SEND; LEVEL; CDJ 2; CDJ 3; CDJ 4; PHONES 1; PHONES 2; BLEND; MIC; EQ HIGH; EQ LOW; MUTE; SEND 1; SEND 2; SEND 3; SEND 4; FX RET 1; SELF; FX RET 2; FX RET 3; FX RET 4; 8 schede · 64 % (max 18); 7 schede · 60 % (max 18); 6 schede · 69 % (max 8); 2 sch. · 40%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

FILTRO (bus HPF e LPF)

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

# Proposta F: master e 5-way larghi 19", niente ciechi

richiesta di Filippo del 9/11 · comandi e taglie della dec. 169 · telaio inclinato (dec. 158) · tetto 70 % (dec. 156)

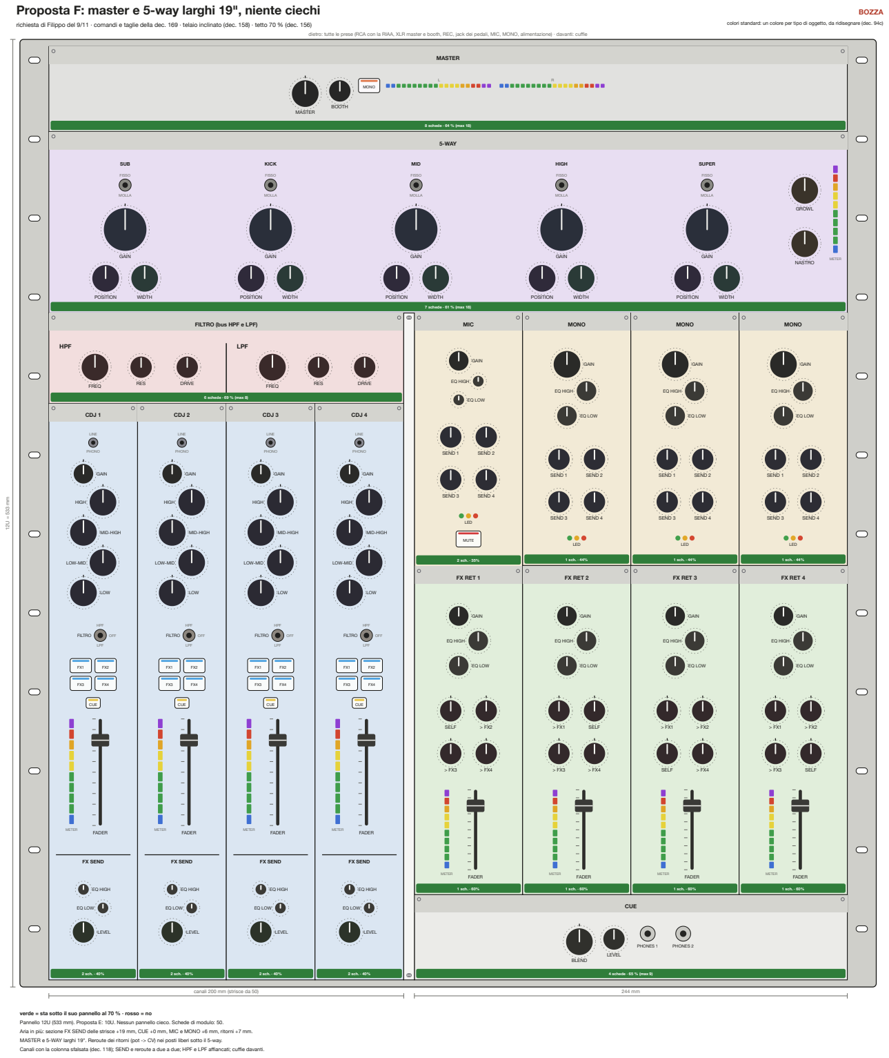
[picture p28: page 4]
MASTER; BOOTH; MONO; 5-WAY; SUB; FISSO; MOLLA; GAIN; POSITION; WIDTH; KICK; MID; HIGH; SUPER; GROWL; NASTRO; METER; HPF; FREQ; RES; DRIVE; LPF; CDJ 1; LINE; PHONO; MID-HIGH; LOW-MID; LOW; FILTRO; OFF; CUE; FADER; FX SEND; EQ HIGH; EQ LOW; LEVEL; CDJ 2; CDJ 3; CDJ 4; BLEND; PHONES 1; PHONES 2; MIC; SEND 1; SEND 2; SEND 3; SEND 4; LED; MUTE; FX RET 1; SELF; FX RET 2; FX RET 3; FX RET 4; 8 schede · 64 % (max 18); 7 schede · 61 % (max 18); 6 schede · 69 % (max 8); 2 sch. · 40%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

FILTRO (bus HPF e LPF)

verde = sta sotto il suo pannello al 70 % · rosso = no
Pannello 12U (533 mm). Proposta E: 10U. Nessun pannello cieco. Schede di modulo: 50.
Aria in più: sezione FX SEND delle strisce +19 mm, CUE +0 mm, MIC e MONO +6 mm, ritorni +7 mm.
MASTER e 5-WAY larghi 19". Reroute dei ritorni (pot -> CV) nei posti liberi sotto il 5-way.
Canali con la colonna sfalsata (dec. 118); SEND e reroute a due a due; HPF e LPF affiancati; cuffie davanti.

# Proposta E: colonna dei canali, master in cima

richiesta di Filippo del 9/11 · misure libere, comandi e taglie della dec. 169 · telaio inclinato (dec. 158) · tetto 70 % (dec. 156)

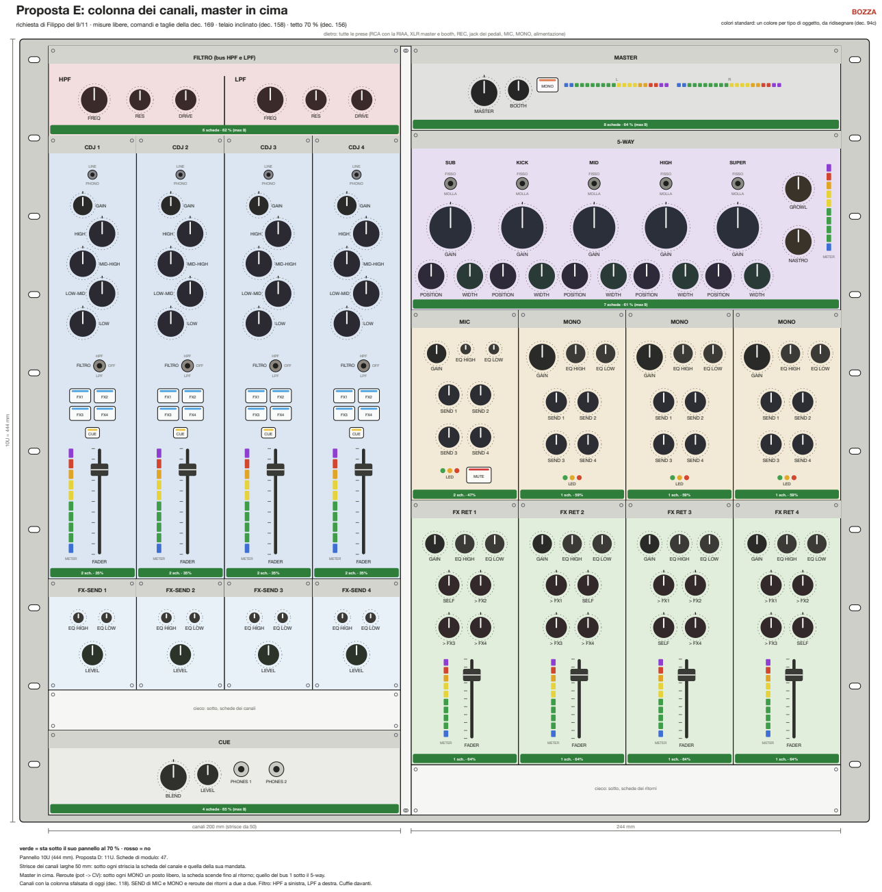
[picture p29: page 5]
HPF; FREQ; RES; DRIVE; LPF; CDJ 1; LINE; PHONO; GAIN; HIGH; MID-HIGH; LOW-MID; LOW; FILTRO; OFF; CUE; METER; FADER; FX-SEND 1; EQ HIGH; EQ LOW; LEVEL; CDJ 2; FX-SEND 2; CDJ 3; FX-SEND 3; CDJ 4; FX-SEND 4; BLEND; PHONES 1; PHONES 2; MASTER; BOOTH; MONO; 5-WAY; SUB; FISSO; MOLLA; POSITION; WIDTH; KICK; MID; SUPER; GROWL; NASTRO; MIC; SEND 1; SEND 2; SEND 3; SEND 4; LED; MUTE; FX RET 1; SELF; FX RET 2; FX RET 3; FX RET 4; 6 schede · 62 % (max 8); 2 sch. · 35%; 4 schede · 65 % (max 8)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

FILTRO (bus HPF e LPF)

cieco: sotto, schede dei canali

cieco: sotto, schede dei ritorni

verde = sta sotto il suo pannello al 70 % · rosso = no
Pannello 10U (444 mm). Proposta D: 11U. Schede di modulo: 47.
Strisce dei canali larghe 50 mm: sotto ogni striscia la scheda del canale e quella della sua mandata.
Master in cima. Reroute (pot -> CV): sotto ogni MONO un posto libero, la scheda scende fino al ritorno; quello del bus 1 sotto il 5-way.
Canali con la colonna sfalsata di oggi (dec. 118). SEND di MIC e MONO e reroute dei ritorni a due a due. Filtro: HPF a sinistra, LPF a destra. Cuffie davanti.

# Proposta D: 5-way largo dietro, tecniche miste

regole di Filippo del 9/11 (dec. 170) · taglie della dec. 169 · telaio inclinato (dec. 158) · tetto 70 % (dec. 156)

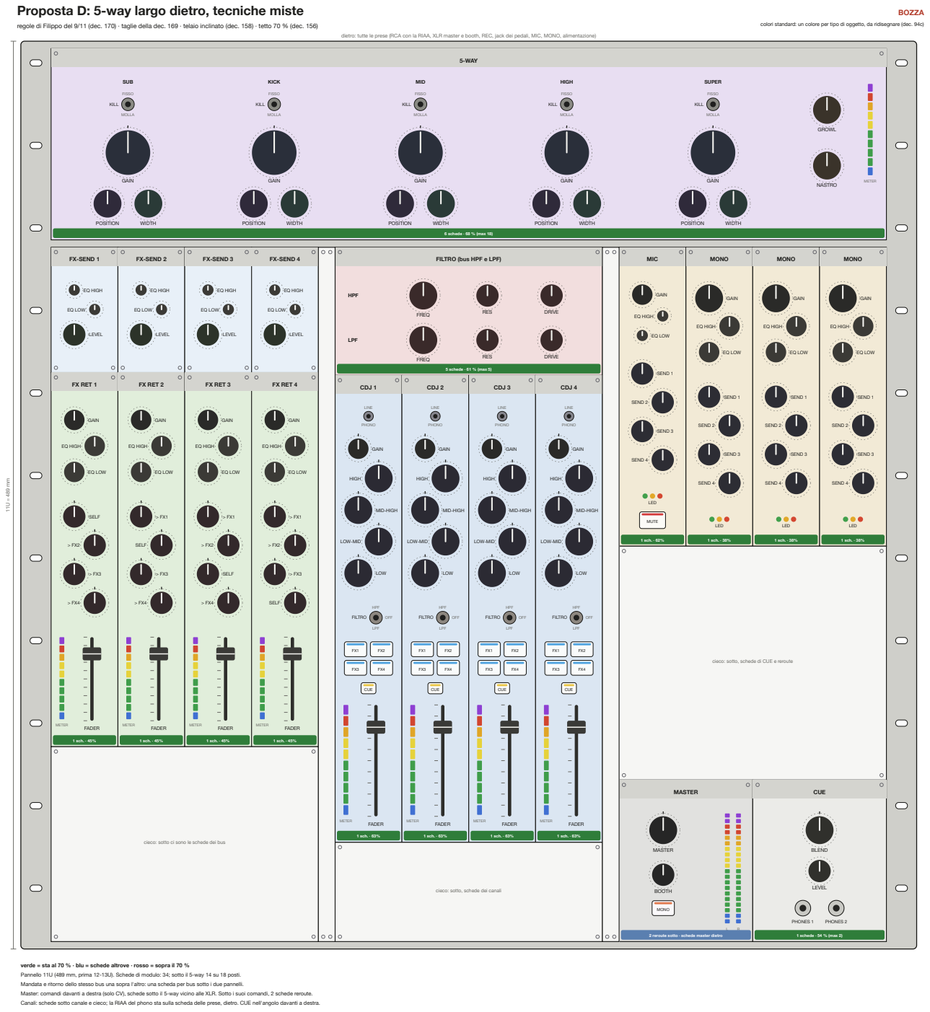
[picture p30: page 6]
5-WAY; SUB; FISSO; MOLLA; KILL; GAIN; POSITION; WIDTH; KICK; MID; HIGH; SUPER; GROWL; NASTRO; METER; FX-SEND 1; EQ HIGH; EQ LOW; LEVEL; FX RET 1; SELF; FADER; FX-SEND 2; FX RET 2; FX-SEND 3; FX RET 3; FX-SEND 4; FX RET 4; HPF; FREQ; RES; DRIVE; LPF; CDJ 1; LINE; PHONO; MID-HIGH; LOW-MID; LOW; FILTRO; OFF; CUE; CDJ 2; CDJ 3; CDJ 4; MIC; SEND 1; SEND 2; SEND 3; SEND 4; LED; MUTE; MONO; MASTER; BOOTH; BLEND; PHONES 1; PHONES 2; 6 schede · 68 % (max 18); 1 sch. · 45%; 5 schede · 61 % (max 5)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

FILTRO (bus HPF e LPF)

cieco: sotto, schede di CUE e reroute

cieco: sotto ci sono le schede dei bus

cieco: sotto, schede dei canali

verde = sta al 70 % · blu = schede altrove · rosso = sopra il 70 %
Pannello 11U (489 mm, prima 12-13U). Schede di modulo: 34; sotto il 5-way 14 su 18 posti.
Mandata e ritorno dello stesso bus una sopra l'altro: una scheda per bus sotto i due pannelli.
Master: comandi davanti a destra (solo CV), schede sotto il 5-way vicino alle XLR. Sotto i suoi comandi, 2 schede reroute.
Canali: schede sotto canale e cieco; la RIAA del phono sta sulla scheda delle prese, dietro. CUE nell'angolo davanti a destra.

# Oggi, con le schede

## disposizione del 21/10 · telaio inclinato (dec. 158) · tetto 70 % (dec. 156)

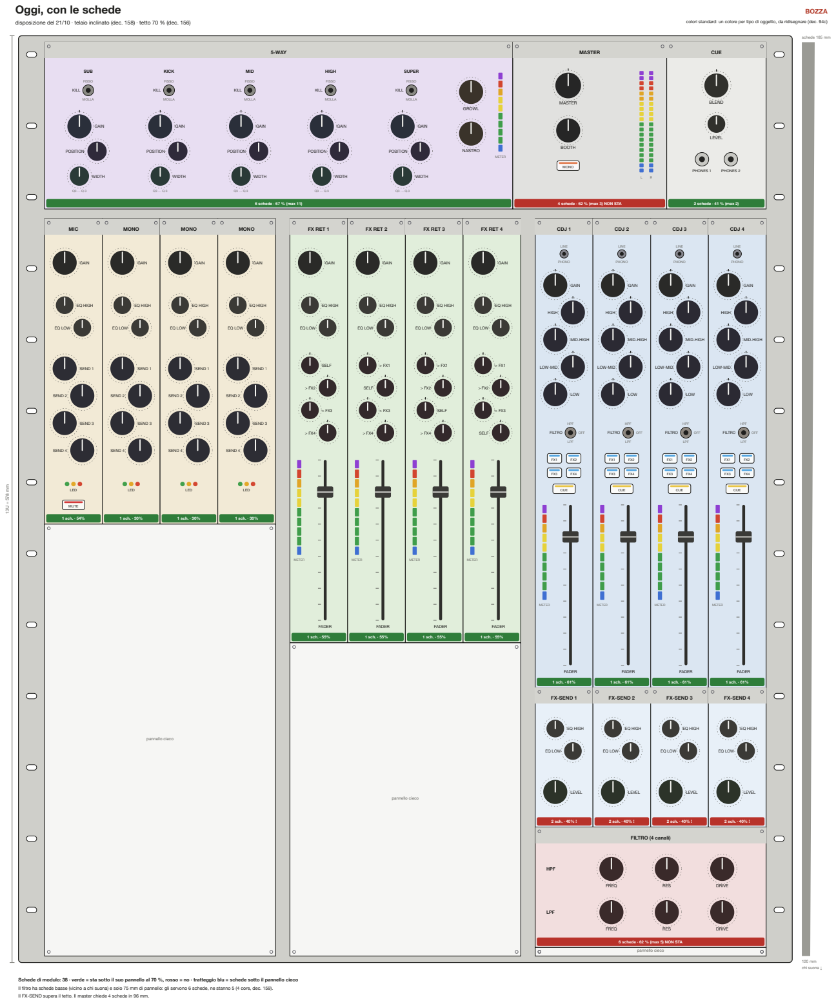
[picture p31: page 7]
SUB; FISSO; MOLLA; KILL; GAIN; POSITION; WIDTH; KICK; MID; HIGH; SUPER; GROWL; NASTRO; METER; MASTER; BOOTH; MONO; CUE; BLEND; LEVEL; PHONES 1; PHONES 2; MIC; EQ HIGH; EQ LOW; SEND 1; SEND 2; SEND 3; SEND 4; LED; MUTE; pannello cieco; FX RET 1; SELF; FADER; FX RET 2; FX RET 3; FX RET 4; CDJ 1; LINE; PHONO; MID-HIGH; LOW-MID; LOW; HPF; LPF; FILTRO; OFF; CDJ 2; CDJ 3; CDJ 4; FX-SEND 1; FX-SEND 2; FX-SEND 3; FX-SEND 4; FILTRO (4 canali); FREQ; RES; DRIVE; 6 schede · 67 % (max 11)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

6 schede · 62 % (max 5) NON STA

Schede di modulo: 38 · verde = sta sotto il suo pannello al 70 %, rosso = no · tratteggio blu = schede sotto il pannello cieco
Il filtro ha schede basse (vicino a chi suona) e solo 75 mm di pannello: gli servono 6 schede, ne stanno 5 (4 core, dec. 159).
Il FX-SEND supera il tetto. Il master chiede 4 schede in 96 mm.

# Proposta A: filtro al centro, sotto i ritorni FX

## canali a destra come oggi · master largo 108 mm, 5-way 280 mm

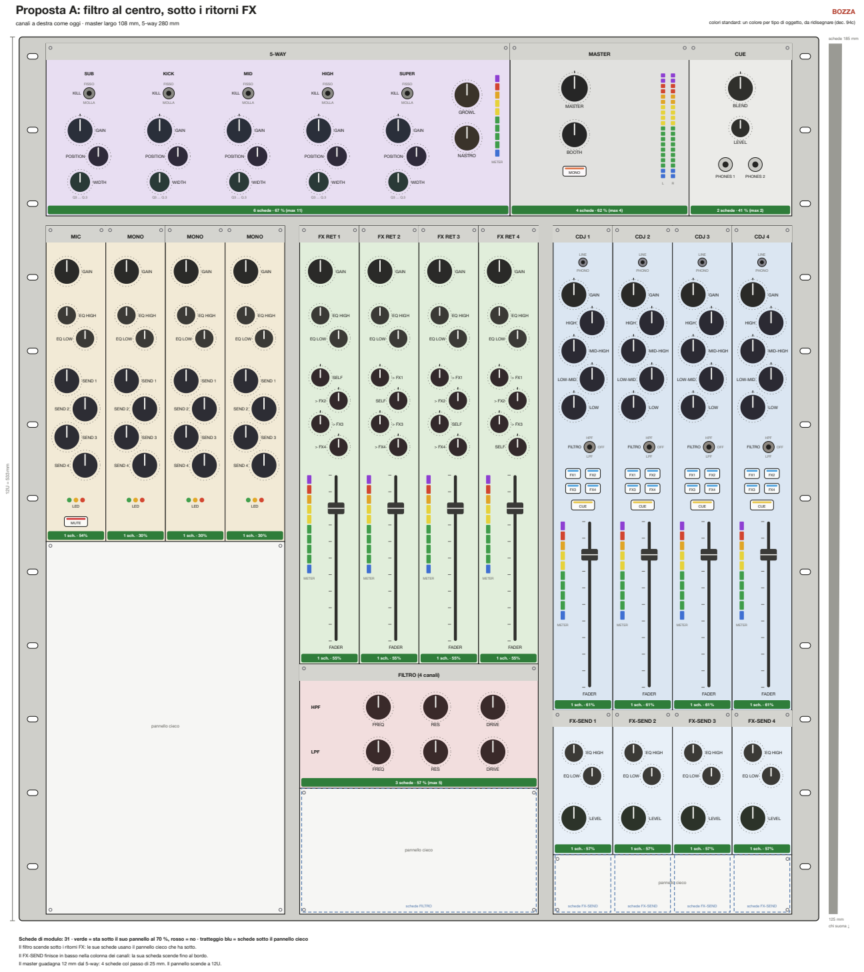
[picture p32: page 8]
SUB; FISSO; MOLLA; KILL; GAIN; POSITION; WIDTH; KICK; MID; HIGH; SUPER; GROWL; NASTRO; METER; MASTER; BOOTH; MONO; BLEND; LEVEL; PHONES 1; PHONES 2; MIC; EQ HIGH; EQ LOW; SEND 1; SEND 2; SEND 3; SEND 4; LED; MUTE; pannello cieco; FX RET 1; SELF; FADER; FX RET 2; FX RET 3; FX RET 4; FILTRO (4 canali); HPF; FREQ; RES; DRIVE; LPF; CDJ 1; LINE; PHONO; MID-HIGH; LOW-MID; LOW; FILTRO; OFF; CUE; CDJ 2; CDJ 3; CDJ 4; FX-SEND 1; FX-SEND 2; FX-SEND 3; FX-SEND 4; 6 schede · 67 % (max 11)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

schede FX-SEND

Schede di modulo: 31 · verde = sta sotto il suo pannello al 70 %, rosso = no · tratteggio blu = schede sotto il pannello cieco
Il filtro scende sotto i ritorni FX: le sue schede usano il pannello cieco che ha sotto.
Il FX-SEND finisce in basso nella colonna dei canali: la sua scheda scende fino al bordo.
Il master guadagna 12 mm dal 5-way: 4 schede col passo di 25 mm. Il pannello scende a 12U.

# Proposta B: master e filtro larghi, davanti

in fondo solo 5-way (largo 388 mm) e CUE · filtro sotto MIC e MONO · master sotto i ritorni FX

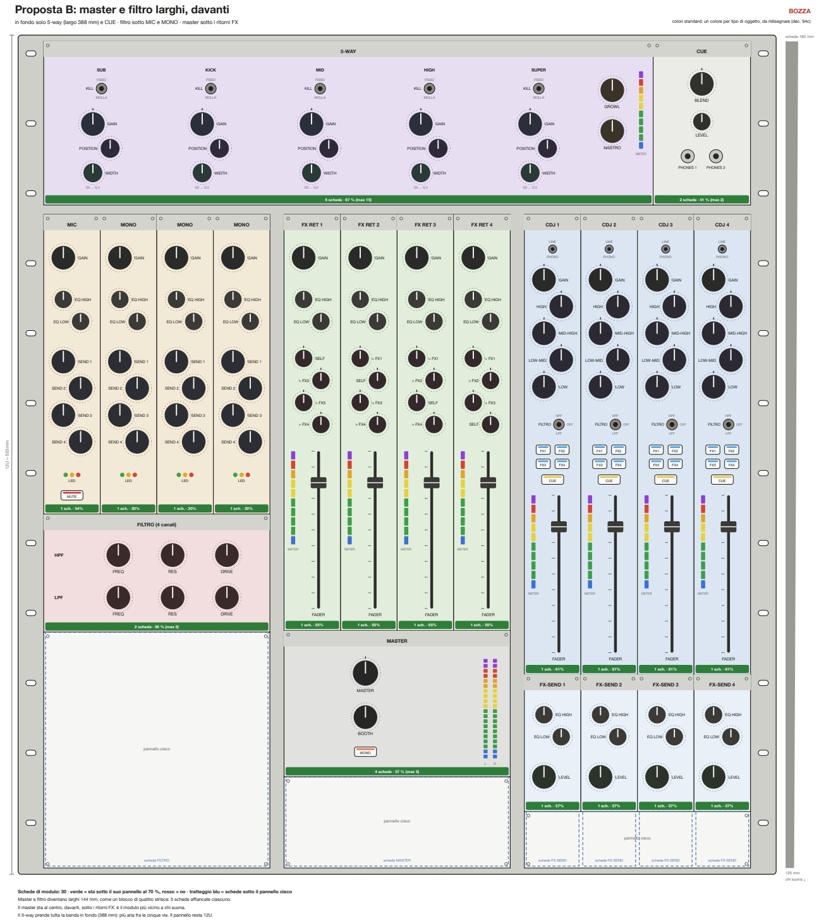
[picture p33: page 9]
SUB; FISSO; MOLLA; KILL; GAIN; POSITION; WIDTH; KICK; MID; HIGH; SUPER; GROWL; NASTRO; METER; BLEND; LEVEL; PHONES 1; PHONES 2; MIC; EQ HIGH; EQ LOW; SEND 1; SEND 2; SEND 3; SEND 4; LED; MUTE; MONO; FILTRO (4 canali); HPF; FREQ; RES; DRIVE; LPF; pannello cieco; FX RET 1; SELF; FADER; FX RET 2; FX RET 3; FX RET 4; MASTER; BOOTH; CDJ 1; LINE; PHONO; MID-HIGH; LOW-MID; LOW; FILTRO; OFF; CUE; CDJ 2; CDJ 3; CDJ 4; FX-SEND 1; FX-SEND 2; FX-SEND 3; FX-SEND 4; 6 schede · 67 % (max 15)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

schede FX-SEND

Schede di modulo: 30 · verde = sta sotto il suo pannello al 70 %, rosso = no · tratteggio blu = schede sotto il pannello cieco
Master e filtro diventano larghi 144 mm, come un blocco di quattro strisce: 5 schede affiancate ciascuno.
Il master sta al centro, davanti, sotto i ritorni FX: è il modulo più vicino a chi suona.
Il 5-way prende tutta la banda in fondo (388 mm): più aria fra le cinque vie. Il pannello resta 12U.

# Proposta C: canali al centro, master a destra

ritorni FX e filtro a sinistra · MIC, MONO e master a destra, sotto il CUE · 5-way largo 388 mm

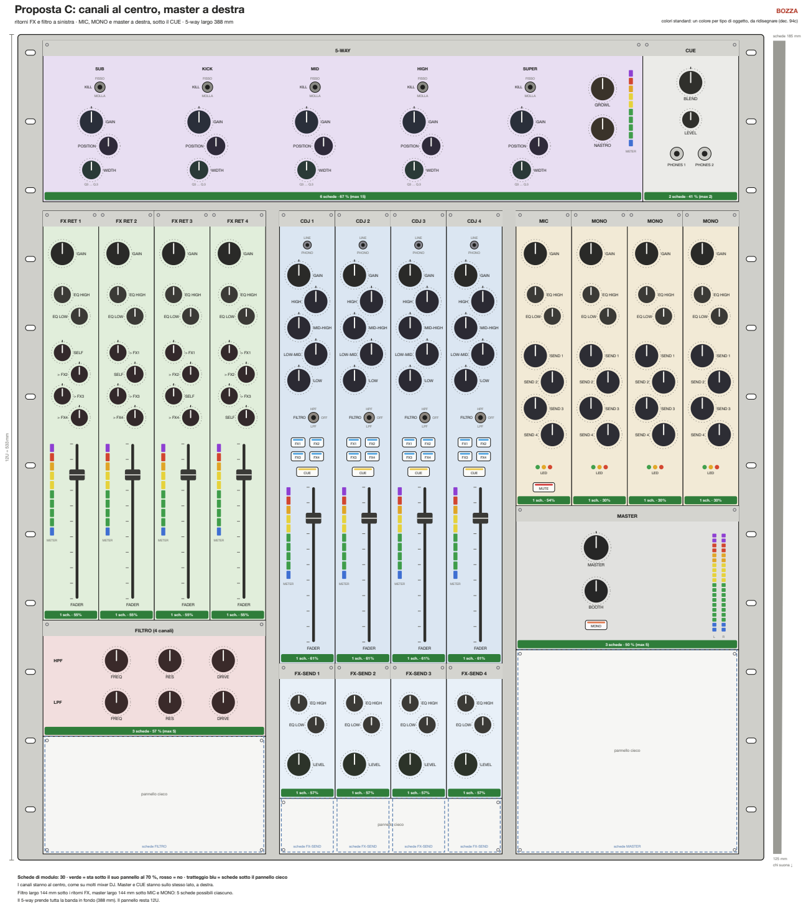
[picture p34: page 10]
SUB; FISSO; MOLLA; KILL; GAIN; POSITION; WIDTH; KICK; MID; HIGH; SUPER; GROWL; NASTRO; METER; BLEND; LEVEL; PHONES 1; PHONES 2; FX RET 1; EQ HIGH; EQ LOW; SELF; FADER; FX RET 2; FX RET 3; FX RET 4; FILTRO (4 canali); HPF; FREQ; RES; DRIVE; LPF; pannello cieco; CDJ 1; LINE; PHONO; MID-HIGH; LOW-MID; LOW; FILTRO; OFF; CUE; CDJ 2; CDJ 3; CDJ 4; FX-SEND 1; FX-SEND 2; FX-SEND 3; FX-SEND 4; MIC; SEND 1; SEND 2; SEND 3; SEND 4; LED; MUTE; MONO; MASTER; BOOTH; 6 schede · 67 % (max 15)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

schede FX-SEND

Schede di modulo: 30 · verde = sta sotto il suo pannello al 70 %, rosso = no · tratteggio blu = schede sotto il pannello cieco
I canali stanno al centro, come su molti mixer DJ. Master e CUE stanno sullo stesso lato, a destra.
Filtro largo 144 mm sotto i ritorni FX, master largo 144 mm sotto MIC e MONO: 5 schede possibili ciascuno.
Il 5-way prende tutta la banda in fondo (388 mm). Il pannello resta 12U.
