dj-filippo241/maelcum_mixer/pcb/fx-send/leggibile/fx-send.pdf

BACKPLANE C96 (FX-SEND class)

CHASSIS CHASSIS RAW+27 RAW-27 RAW-27 RAW+27
RAW-22 RAW+22 RAW-22 RAW+22 +5V
RAW+22
RAW-22

EQ2 left side (LOW 120 Hz + HIGH 4.5 kHz, fx-eq2-pot10k.cir)

INJECTION left side (OPA1654 + 10k to the buses)

EQ2 right side (LOW 120 Hz + HIGH 4.5 kHz, fx-eq2-pot10k.cir)

INJECTION right side (OPA1654 + 10k to the buses)

PWR_FLAG (for the ERC check only)
#FLG01 PWR_FLAG

Generated by pcb/tools/leggibile.py from the same netlist as the PCB: do not edit by hand +5VF

Sheet: /
File: fx-send.kicad_sch
Title: maelcum FX-SEND (dec. 91a) - draft v0.2 - readable schematic

Size: User | Rev: 0.3-draft
KiCad E.D.A. 10.0.7 | Id: 1/1
