dj-filippo241/maelcum_mixer/pcb/mic/leggibile/mic.pdf

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

BACKPLANE C96 (MIC/GEN class, MSUM6)

XLR INPUT: RFI, clamp, 2.32k load, 2x47k bias (mic-pre.inc)

HIGH-PASS 60 Hz, STAGE 2 (0...+30 dB), LED DETECTOR (OPA1654)

SENDS S1-S4 (pots on the cable, global mute, injection)

PWR_FLAG (for the ERC check only)

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

Sheet: /
File: mic.kicad_sch
Title: maelcum MIC (dec. 97) - draft v0.1 - readable schematic

Size: User | Rev: 0.1-draft
KiCad E.D.A. 10.0.7 | Id: 1/1
