dj-filippo241/maelcum_mixer/pcb/fx-send/comandi/leggibile/fx-send-comandi.pdf

POTS (positions from the panel render)

AGND
VHP_L WPH_L CABLE TO THE MAIN BOARD

PWR_FLAG (for the ERC check only)
#FLG01 PWR_FLAG

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

Sheet: /
File: fx-send-comandi.kicad_sch
Title: maelcum FX-SEND control board - draft v0.2 - readable schematic

Size: User | Rev: 0.2-draft
KiCad E.D.A. 10.0.7 | Id: 1/1
