dj-filippo241/maelcum_mixer/pcb/mic/comandi/leggibile/mic-comandi.pdf

CONTROLS (positions from the panel render)

CABLE TO THE MAIN BOARD

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

Sheet: /
File: mic-comandi.kicad_sch
Title: maelcum MIC control board - draft v0.1 - readable schematic

Size: User | Rev: 0.1-draft
KiCad E.D.A. 10.0.7 | Id: 1/1
