dj-filippo241/maelcum_mixer/pcb/canale/archivio/isolator/leggibile/canale-isolator.pdf

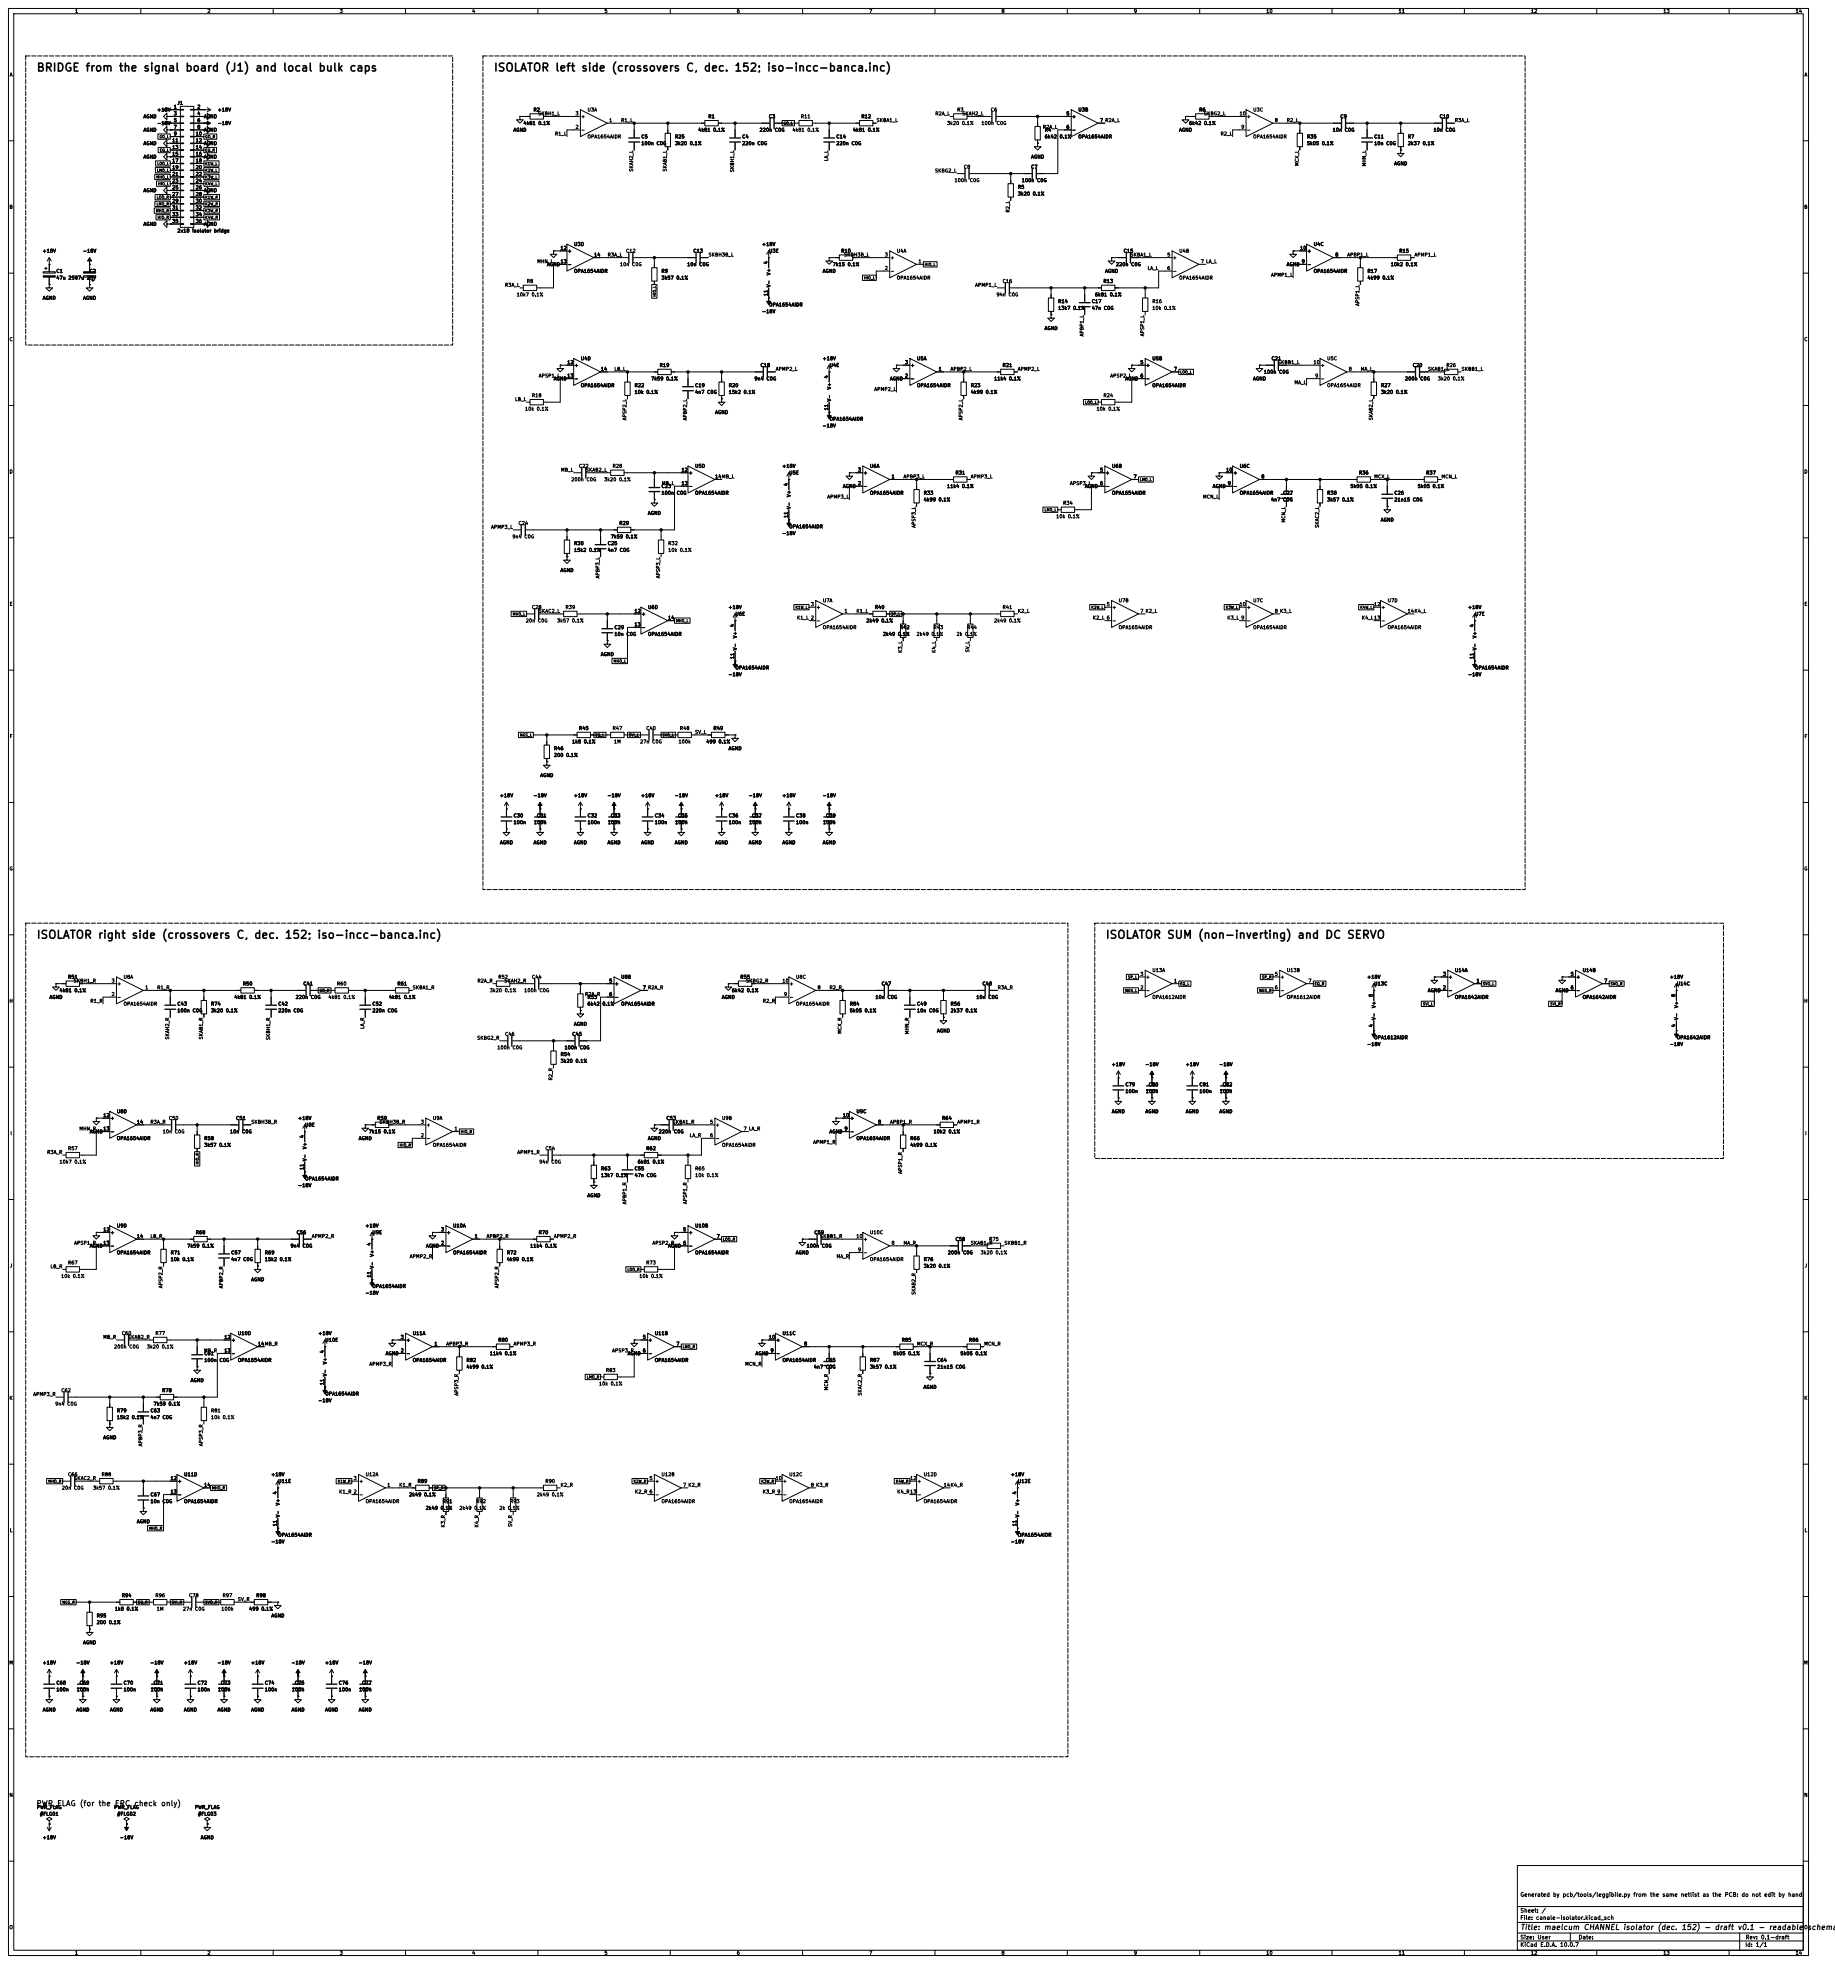
[picture p35: page 1]

ISOLATOR right side (crossovers C, dec. 152; iso-incc-banca.inc)

ISOLATOR SUM (non-inverting) and DC SERVO

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

Sheet: /
File: canale-isolator.kicad_sch
Title: maelcum CHANNEL isolator (dec. 152) - draft v0.1 - readable schematic

Size: User | Rev: 0.1-draft
KiCad E.D.A. 10.0.7 | Id: 1/1
