dj-filippo241/maelcum_mixer/pcb/canale/archivio/segnale/leggibile/canale.pdf

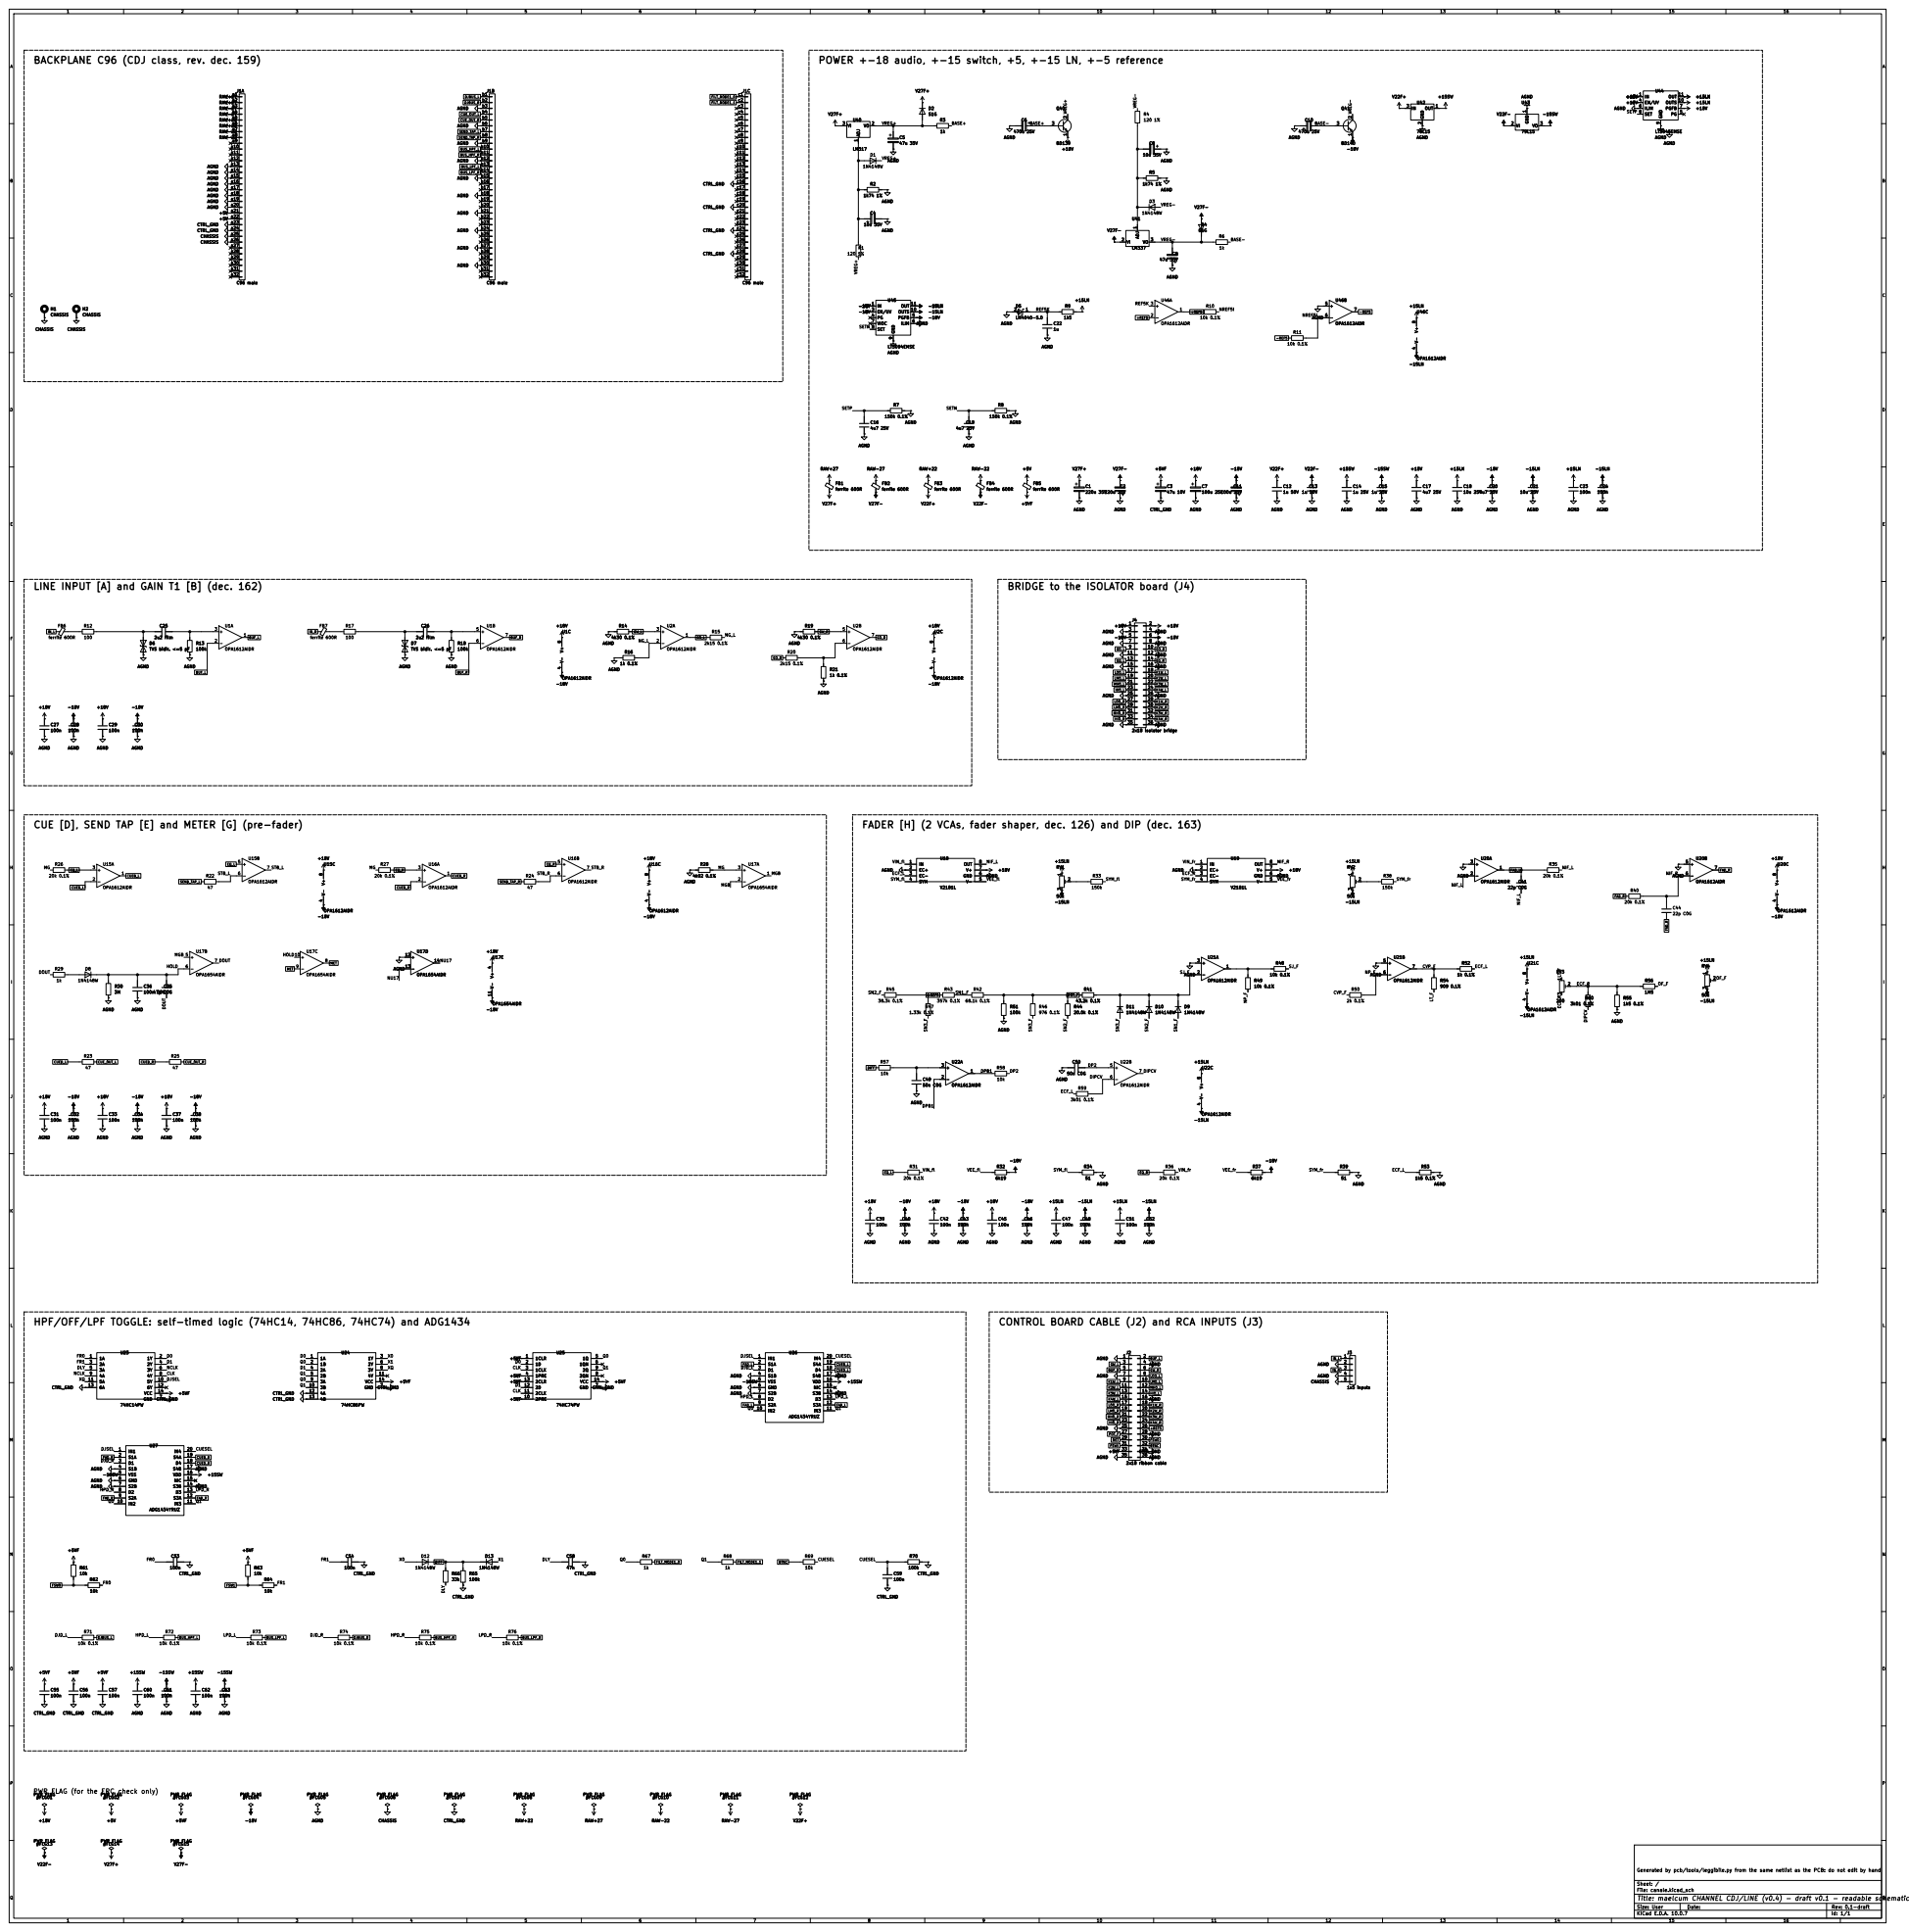
[picture p36: page 1]

b32 RAW+22 RAW-22 RAW+22 RAW-22

LINE INPUT [A] and GAIN T1 [B] (dec. 162)

BRIDGE to the ISOLATOR board (J4)
AGND+18V
AGND -18V
AGND

CUE [D], SEND TAP [E] and METER [G] (pre-fader)

FADER [H] (2 VCAs, fader shaper, dec. 126) and DIP (dec. 163)

HPF/OFF/LPF TOGGLE: self-timed logic (74HC14, 74HC86, 74HC74) and ADG1434

PWR_FLAG (for the ERC check only)
#FLG01 PWR_FLAG

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

Sheet: /
File: canale.kicad_sch
Title: maelcum CHANNEL CDJ/LINE (v0.4) - draft v0.1 - readable schematic

Size: User | Rev: 0.1-draft
KiCad E.D.A. 10.0.7 | Id: 1/1
