dj-filippo241/maelcum_mixer/docs/pannelli/moduli-filippo-2026-11-10.pdf

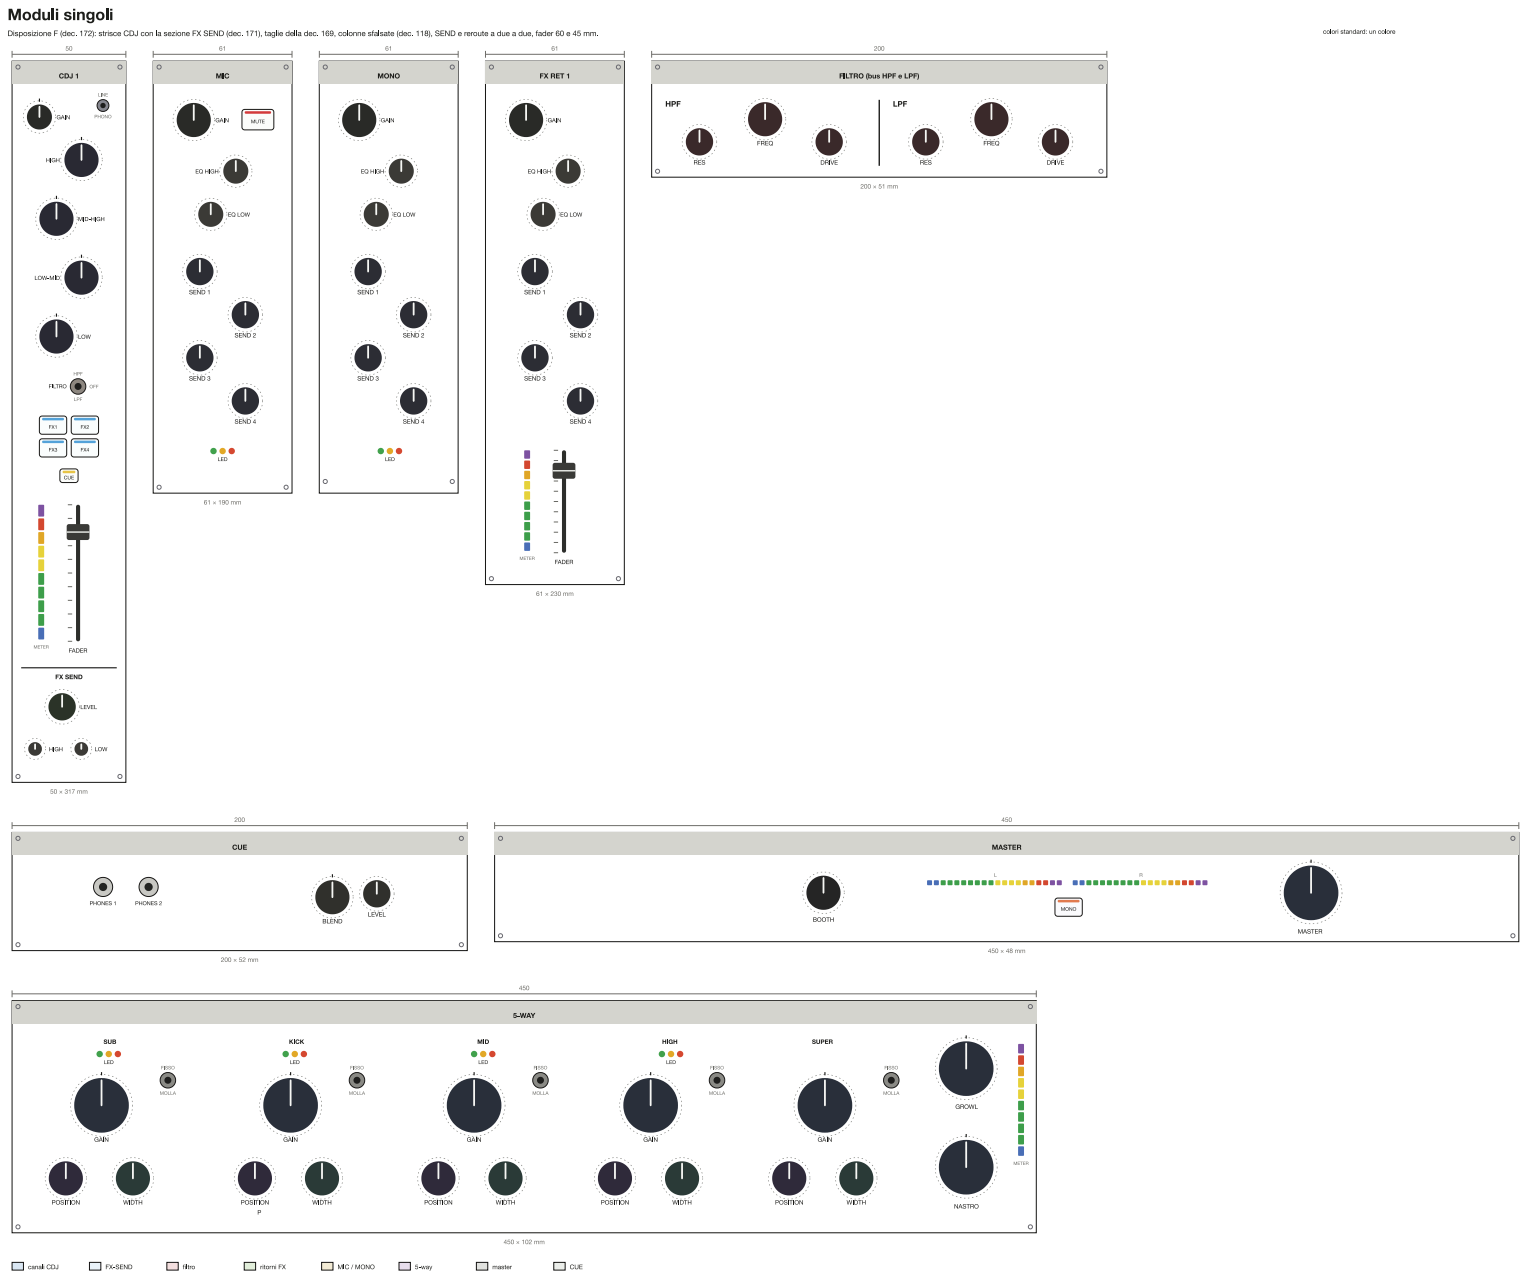
[picture p37: page 1]
