dj-filippo241/maelcum_mixer/pcb/canale/canale.kicad_pcb

## KiCad design pcb/canale/canale.kicad_pcb (2026-11-12)

Schematic: canale.kicad_sch, maelcum CANALE CDJ/LINE (v0.4) - bozza v0.1

Parts:
C1, C2: 220u 35V; CP_Radial_D8.0mm_P3.50mm
C3: 47u 10V; CP_Radial_D5.0mm_P2.00mm
C4, C8: 10u 35V; CP_Radial_D5.0mm_P2.00mm
C5, C9: 47u 35V; CP_Radial_D6.3mm_P2.50mm
C6, C10: 470u 25V; CP_Radial_D8.0mm_P3.50mm
C7, C11: 100u 25V; CP_Radial_D6.3mm_P2.50mm
C12, C13: 1u 50V; C_1206_3216Metric
C14, C15: 1u 25V; C_1206_3216Metric
C16, C17, C19, C20: 4u7 25V; C_1206_3216Metric
C18, C21: 10u 25V; C_1206_3216Metric
C22: 1u; C_1206_3216Metric
C23, C24, C27, C28, C29, C30, C58, C59, C60, C61, C62, C63, C64, C65, C66, C67, C96, C97, C98, C99, C100, C101, C102, C103, C104, C105, C107, C108, C109, C110, C111, C112, C113, C114, C117, C118, C119, C120, C122, C123, C125, C126, C127, C128, C131, C132, C133, C134, C135, C136, C137, C139, C140, C141, C142, C143: 100n; C_0805_2012Metric
C25, C26: 2u2 film; C_1812_4532Metric
C31, C32, C42, C43, C69, C70, C80, C81: 220n C0G; C_1210_3225Metric
C33, C34, C35, C36, C49, C51, C71, C72, C73, C74, C87, C89: 100n C0G; C_1210_3225Metric
C37, C38, C39, C40, C41, C57, C75, C76, C77, C78, C79, C95: 10n C0G; C_1206_3216Metric
C44, C82: 94n C0G; C_1210_3225Metric
C45, C83: 47n C0G; C_1210_3225Metric
C46, C52, C84, C90: 9n4 C0G; C_1206_3216Metric
C47, C53, C55, C85, C91, C93: 4n7 C0G; C_1206_3216Metric
C48, C50, C86, C88: 200n C0G; C_1210_3225Metric
C54, C92: 21n15 C0G; C_1206_3216Metric
C56, C94: 20n C0G; C_1206_3216Metric
C68, C106: 27n C0G; C_1206_3216Metric
C115: 47p C0G; C_0805_2012Metric
C116: 100n C0G; C_1206_3216Metric
C121, C124: 22p C0G; C_0805_2012Metric
C129, C130: 50n C0G; C_1206_3216Metric
C138: 47n; C_0805_2012Metric
D1, D3, D8, D9, D10, D11, D12, D13, D14: 1N4148W; D_SOD-123
D2, D4: S1G; D_SMA
D5: LM4040-5.0; SOT-23
D6, D7: TVS bidir <=5 pF; D_SOD-323
FB1, FB2, FB3, FB4, FB5, FB6, FB7: ferrite 600R; L_1206_3216Metric
H1, H2, H3: CHASSIS; MountingHole_3.2mm_M3_Pad
J1: C96 maschio; DIN41612_C_3x32_Male_Horizontal_THT
J2: 2x18 cavo piatto; PinHeader_2x18_P2.54mm_Vertical
J3: 1x5 ingressi; PinHeader_1x05_P2.54mm_Vertical
Q40: BD139; TO-126-3_Vertical
Q41: BD140; TO-126-3_Vertical
R1, R4: 120 1%; R_0805_2012Metric
R2, R5: 1k74 1%; R_0805_2012Metric
R3, R6, R127, R164, R165: 1k; R_0805_2012Metric
R7, R8: 150k 0.1%; R_0805_2012Metric
R9: 1k5; R_0805_2012Metric
R10, R11, R37, R39, R43, R45, R53, R55, R86, R88, R92, R94, R102, R104, R146, R168, R169, R170, R171, R172, R173: 10k 0.1%; R_0805_2012Metric
R12, R17: 100; R_0805_2012Metric
R13, R18, R69, R118, R149, R162, R167: 100k; R_0805_2012Metric
R14, R19: 4k30 0.1%; R_0805_2012Metric
R15, R20: 2k15 0.1%; R_0805_2012Metric
R16, R21, R151, R153: 1k 0.1%; R_0805_2012Metric
R22, R23, R32, R33, R71, R72, R81, R82: 4k81 0.1%; R_0805_2012Metric
R24, R26, R46, R47, R48, R49, R73, R75, R95, R96, R97, R98: 3k20 0.1%; R_0805_2012Metric
R25, R27, R74, R76: 6k42 0.1%; R_0805_2012Metric
R28, R77: 2k37 0.1%; R_0805_2012Metric
R29, R78: 10k7 0.1%; R_0805_2012Metric
R30, R59, R60, R79, R108, R109: 3k57 0.1%; R_0805_2012Metric
R31, R80: 7k15 0.1%; R_0805_2012Metric
R34, R83: 6k81 0.1%; R_0805_2012Metric
R35, R84: 13k7 0.1%; R_0805_2012Metric
R36, R85: 10k2 0.1%; R_0805_2012Metric
R38, R44, R54, R87, R93, R103, R157: 4k99 0.1%; R_0805_2012Metric
R40, R50, R89, R99: 7k59 0.1%; R_0805_2012Metric
R41, R51, R90, R100: 15k2 0.1%; R_0805_2012Metric
R42, R52, R91, R101: 11k4 0.1%; R_0805_2012Metric
R56, R57, R58, R105, R106, R107: 5k05 0.1%; R_0805_2012Metric
R61, R62, R63, R64, R110, R111, R112, R113: 2k49 0.1%; R_0805_2012Metric
R65, R114: 2k 0.1%; R_0805_2012Metric
R66, R115: 1k8 0.1%; R_0805_2012Metric
R67, R116: 200 0.1%; R_0805_2012Metric
R68, R117: 1M; R_0805_2012Metric
R70, R119: 499 0.1%; R_0805_2012Metric
R120, R121, R122, R123: 47; R_0805_2012Metric
R124, R125, R129, R133, R134, R138: 20k 0.1%; R_0805_2012Metric
R126: 4k02 0.1%; R_0805_2012Metric
R128: 3M; R_0805_2012Metric
R130, R135: 6k19; R_0805_2012Metric
R131, R136: 150k; R_0805_2012Metric
R132, R137: 51; R_0805_2012Metric
R139: 43.2k 0.1%; R_0805_2012Metric
R140: 68.1k 0.1%; R_0805_2012Metric
R141: 357k 0.1%; R_0805_2012Metric
R142: 20.0k 0.1%; R_0805_2012Metric
R143: 38.3k 0.1%; R_0805_2012Metric
R144: 976 0.1%; R_0805_2012Metric
R145: 1.33k 0.1%; R_0805_2012Metric
R147: 9k76 0.1%; R_0805_2012Metric
R148: 18k7 0.1%; R_0805_2012Metric
R150: 18k2 0.1%; R_0805_2012Metric
R152: 17k4 0.1%; R_0805_2012Metric
R154: 2M7; R_0805_2012Metric
R155, R156, R158, R159, R160, R161, R166: 10k; R_0805_2012Metric
R163: 68k; R_0805_2012Metric
RV1, RV2, RV4: 50k; Potentiometer_Bourns_3266W_Vertical
RV3: 2k; Potentiometer_Bourns_3266W_Vertical
U1, U2, U13, U15, U16, U20, U21, U22, U46: OPA1612AIDR; SOIC-8_3.9x4.9mm_P1.27mm
U3, U4, U5, U6, U7, U8, U9, U10, U11, U12, U17: OPA1654AIDR; SOIC-14_3.9x8.7mm_P1.27mm
U14: OPA1642AIDR; SOIC-8_3.9x4.9mm_P1.27mm
U18, U19: V2181L; SOIC-8_3.9x4.9mm_P1.27mm
U23: 74HC14PW; TSSOP-14_4.4x5mm_P0.65mm
U24: 74HC86PW; TSSOP-14_4.4x5mm_P0.65mm
U25: 74HC74PW; TSSOP-14_4.4x5mm_P0.65mm
U26, U27: ADG1434YRUZ; TSSOP-20_4.4x6.5mm_P0.65mm
U40: LM317; TO-220-3_Vertical
U41: LM337; TO-220-3_Vertical
U42: 78L15; SOT-89-3
U43: 79L15; SOT-89-3
U44: LT3045EMSE; MSOP-12-1EP_3x4.039mm_P0.65mm_EP1.651x2.845mm
U45: LT3094EMSE; MSOP-12-1EP_3x4.039mm_P0.65mm_EP1.651x2.845mm

Connections:
+5V: FB5.1, J1.a21, J1.a22
+5VF: C3.1, C135.1, C136.1, C137.1, FB5.2, J2.33, R158.1, R160.1, U23.14 (VCC), U24.13 (4B), U24.14 (VCC), U25.1 (1CLR), U25.4 (1PRE), U25.10 (2PRE), U25.13 (2CLR), U25.14 (VCC)
+15LN: C18.1, C23.1, C127.1, C131.1, R9.1, RV1.1, RV2.1, RV4.1, U21.8 (V+), U22.8 (V+), U44.10 (OUTS), U44.11 (OUT), U44.12 (OUT), U46.8 (V+)
+15SW: C14.1, C140.1, C142.1, U26.16 (VDD), U27.16 (VDD), U42.1 (OUT)
+18V: C7.1, C17.1, C27.1, C29.1, C58.1, C60.1, C62.1, C64.1, C66.1, C96.1, C98.1, C100.1, C102.1, C104.1, C107.1, C109.1, C111.1, C113.1, C117.1, C119.1, C122.1, C125.1, Q40.1 (E), U1.8 (V+), U2.8 (V+), U3.4 (V+), U4.4 (V+), U5.4 (V+), U6.4 (V+), U7.4 (V+), U8.4 (V+), U9.4 (V+), U10.4 (V+), U11.4 (V+), U12.4 (V+), U13.8 (V+), U14.8 (V+), U15.8 (V+), U16.8 (V+), U17.4 (V+), U18.7 (V+), U19.7 (V+), U20.8 (V+), U44.1 (IN), U44.2 (IN), U44.3 (IN), U44.4 (EN/UV), U44.7 (PGFB)
+REF5: J2.26, R10.1, U46.1, U46.2 (-)
-15LN: C21.2, C24.2, C128.2, C132.2, RV1.3, RV2.3, RV4.3, U21.4 (V-), U22.4 (V-), U45.10 (OUTS), U45.11 (OUT), U45.12 (OUT), U46.4 (V-)
-15SW: C15.2, C141.2, C143.2, U26.5 (VSS), U27.5 (VSS), U43.3 (VO)
-18V: C11.2, C20.2, C28.2, C30.2, C59.2, C61.2, C63.2, C65.2, C67.2, C97.2, C99.2, C101.2, C103.2, C105.2, C108.2, C110.2, C112.2, C114.2, C118.2, C120.2, C123.2, C126.2, Q41.1 (E), R130.2, R135.2, U1.4 (V-), U2.4 (V-), U3.11 (V-), U4.11 (V-), U5.11 (V-), U6.11 (V-), U7.11 (V-), U8.11 (V-), U9.11 (V-), U10.11 (V-), U11.11 (V-), U12.11 (V-), U13.4 (V-), U14.4 (V-), U15.4 (V-), U16.4 (V-), U17.11 (V-), U20.4 (V-), U45.1 (IN), U45.2 (IN), U45.3 (EN/UV), U45.5 (PGFB), U45.13 (IN)
-REF5: R11.2, R141.2, R143.2, R145.2, U46.7
ADJ+: C4.1, D1.2 (A), R1.2, R2.1, U40.1 (ADJ)
ADJ-: C8.2, D3.1 (K), R4.2, R5.1, U41.1 (ADJ)
AGND: C1.2, C2.1, C4.2, C5.2, C6.2, C7.2, C8.1, C9.1, C10.1, C11.1, C12.2, C13.1, C14.2, C15.1, C16.2, C17.2, C18.2, C19.1, C20.1, C21.1, C22.2, C23.2, C24.1, C27.2, C28.1, C29.2, C30.1, C43.2, C49.2, C51.2, C54.2, C57.2, C58.2, C59.1, C60.2, C61.1, C62.2, C63.1, C64.2, C65.1, C66.2, C67.1, C81.2, C87.2, C89.2, C92.2, C95.2, C96.2, C97.1, C98.2, C99.1, C100.2, C101.1, C102.2, C103.1, C104.2, C105.1, C107.2, C108.1, C109.2, C110.1, C111.2, C112.1, C113.2, C114.1, C116.2, C117.2, C118.1, C119.2, C120.1, C122.2, C123.1, C125.2, C126.1, C127.2, C128.1, C129.2, C130.2, C131.2, C132.1, C140.2, C141.1, C142.2, C143.1, D5.2 (A), D6.2 (A2), D7.2 (A2), J1.a13, J1.a14, J1.a15, J1.a16, J1.a17, J1.a18, J1.a19, J1.a20, J1.b3, J1.b6, J1.b9, J1.b12, J1.b15, J1.b18, J1.b21, J1.b24, J1.b27, J1.b30, J2.1, J2.4, J2.7, J2.16, J2.25, J2.28, J2.35, J2.36, J3.2, J3.4, R2.2, R5.2, R7.2, R8.2, R13.2, R14.2, R16.2, R18.2, R19.2, R21.2, R23.2, R25.2, R27.2, R28.2, R31.2, R35.2, R41.2, R51.2, R67.2, R70.2, R72.2, R74.2, R76.2, R77.2, R80.2, R84.2, R90.2, R100.2, R116.2, R119.2, R126.2, R128.2, R132.2, R137.2, R149.2, R151.2, R153.2, U3.12 (+), U4.10 (+), U4.12 (+), U5.3 (+), U5.5 (+), U6.3 (+), U6.5 (+), U6.10 (+), U8.12 (+), U9.10 (+), U9.12 (+), U10.3 (+), U10.5 (+), U11.3 (+), U11.5 (+), U11.10 (+), U14.3 (+), U14.5 (+), U17.12 (+), U18.2 (EC+), U18.6 (GND), U19.2 (EC+), U19.6 (GND), U20.3 (+), U20.5 (+), U21.3 (+), U21.5 (+), U26.4 (S1B), U26.6 (GND), U26.7 (S2B), U26.14 (S3B), U26.17 (S4B), U27.4 (S1B), U27.6 (GND), U27.7 (S2B), U27.14 (S3B), U27.17 (S4B), U42.2 (GND), U43.1 (GND), U44.6 (ILIM), U44.9 (GND), U44.13 (GND), U45.6 (ILIM), U45.9 (GND), U46.5 (+)
APBP1_L: C45.2, R36.2, R38.1, U4.8
APBP1_R: C83.2, R85.2, R87.1, U9.8
APBP2_L: C47.2, R42.2, R44.1, U5.1
APBP2_R: C85.2, R91.2, R93.1, U10.1
APBP3_L: C53.2, R52.2, R54.1, U6.1
APBP3_R: C91.2, R101.2, R103.1, U11.1
APMP1_L: C44.2, R36.1, U4.9 (-)
APMP1_R: C82.2, R85.1, U9.9 (-)
APMP2_L: C46.2, R42.1, U5.2 (-)
APMP2_R: C84.2, R91.1, U10.2 (-)
APMP3_L: C52.2, R52.1, U6.2 (-)
APMP3_R: C90.2, R101.1, U11.2 (-)
APNP1_L: C44.1, C45.1, R34.2, R35.1
APNP1_R: C82.1, C83.1, R83.2, R84.1
APNP2_L: C46.1, C47.1, R40.2, R41.1
APNP2_R: C84.1, C85.1, R89.2, R90.1
APNP3_L: C52.1, C53.1, R50.2, R51.1
APNP3_R: C90.1, C91.1, R99.2, R100.1
APSP1_L: R37.2, R38.2, R39.1, U4.13 (-)
APSP1_R: R86.2, R87.2, R88.1, U9.13 (-)
APSP2_L: R43.2, R44.2, R45.1, U5.6 (-)
APSP2_R: R92.2, R93.2, R94.1, U10.6 (-)
APSP3_L: R53.2, R54.2, R55.1, U6.6 (-)
APSP3_R: R102.2, R103.2, R104.1, U11.6 (-)
BASE+: C6.1, Q40.3 (B), R3.2
BASE-: C10.2, Q41.3 (B), R6.2
BTNC: J2.32, R166.1
BUF_L: J2.2, U1.1, U1.2 (-)
BUF_R: J2.5, U1.6 (-), U1.7
BUS_HPF_L: J1.b10, R169.2
BUS_HPF_R: J1.b11, R172.2
BUS_LPF_L: J1.b13, R170.2
BUS_LPF_R: J1.b14, R173.2
CHASSIS: H1.1, H2.1, H3.1, J1.a25, J1.a26, J3.5
CLK: U23.8 (4Y), U25.3 (1CLK), U25.11 (2CLK)
CTRL_GND: C3.2, C133.2, C134.2, C135.2, C136.2, C137.2, C138.2, C139.2, J1.a23, J1.a24, J1.c16, J1.c20, J1.c24, J1.c28, J2.34, R162.2, R167.2, U23.7 (GND), U24.7 (GND), U25.7 (GND)
CUEB_L: U15.1, U15.2 (-), U26.19 (S4A)
CUEB_R: U16.1, U16.2 (-), U27.19 (S4A)
CUED_L: R121.1, U26.18 (D4)
CUED_R: R123.1, U27.18 (D4)
CUESEL: C139.1, R166.2, R167.1, U26.20 (IN4), U27.20 (IN4)
CUE_OUT_L: J1.b4, R121.2
CUE_OUT_R: J1.b5, R123.2
CVP_F: R148.2, R150.1, R152.1, U21.7
D0: U23.2 (1Y), U24.1 (1A), U25.2 (1D)
D1: U23.4 (2Y), U24.4 (2A), U25.12 (2D)
D1A: D8.2 (A), R127.2
DIFF: D12.1 (K), D13.1 (K), R162.1, U23.13 (6A)
DIFFB: D14.1 (K), R155.1, R163.1, U24.11 (4Y)
DIPCV: R157.1, U22.6 (-), U22.7
DJBUS_L: J1.b1, R168.2
DJBUS_R: J1.b2, R171.2
DJD_L: R168.1, U26.3 (D1)
DJD_R: R171.1, U27.3 (D1)
DJSEL: U23.10 (5Y), U26.1 (IN1), U27.1 (IN1)
DLY: C138.1, D14.2 (A), R163.2, U23.5 (3A)
DOUT: C115.1, R127.1, U17.7
DP1: C129.1, R155.2, U22.3 (+)
DP2: C130.1, R156.2, U22.5 (+)
DPB1: R156.1, U22.1, U22.2 (-)
ECF_L: R150.2, R151.1, U18.3 (EC-)
ECF_R: R153.1, R154.2, RV3.2, RV3.3, U19.3 (EC-)
EQ_L: R66.2, R68.1, R124.1, R129.1, U13.1, U15.3 (+), U15.5 (+)
EQ_R: R115.2, R117.1, R125.1, R134.1, U13.7, U16.3 (+), U16.5 (+)
FAD_L: C121.2, R133.2, U20.1, U26.2 (S1A), U26.9 (S2A), U26.12 (S3A)
FAD_R: C124.2, R138.2, U20.7, U27.2 (S1A), U27.9 (S2A), U27.12 (S3A)
FILT_MODE1_0: J1.c1, R164.2
FILT_MODE1_1: J1.c2, R165.2
FR0: C133.1, R159.2, U23.1 (1A)
FR1: C134.1, R161.2, U23.3 (2A)
FSW0: J2.30, R158.2, R159.1
FSW1: J2.31, R160.2, R161.1
GO_L: C31.1, R15.1, R32.1, U2.1
GO_R: C69.1, R20.1, R81.1, U2.7
GW_L: J2.3, R14.1, U2.3 (+)
GW_R: J2.6, R19.1, U2.5 (+)
HA_L: C55.2, R57.2, R59.1, U6.8
HA_R: C93.2, R106.2, R108.1, U11.8
HIO_L: J2.14, R30.2, U4.1, U4.2 (-)
HIO_R: J2.23, R79.2, U9.1, U9.2 (-)
HOLD: C115.2, C116.1, D8.1 (K), R128.1, U17.6 (-), U17.10 (+)
HPD_L: R169.1, U26.8 (D2)
HPD_R: R172.1, U27.8 (D2)
INC_L: C25.2, R13.1, U1.3 (+)
INC_R: C26.2, R18.1, U1.5 (+)
INF_L: FB6.2, R12.1
INF_R: FB7.2, R17.1
INP_L: C25.1, D6.1 (A1), R12.2
INP_R: C26.1, D7.1 (A1), R17.2
IN_L: FB6.1, J3.1
IN_R: FB7.1, J3.3
K1W_L: J2.9, U7.3 (+)
K1W_R: J2.18, U12.3 (+)
K1_L: R61.1, U7.1, U7.2 (-)
K1_R: R110.1, U12.1, U12.2 (-)
K2W_L: J2.11, U7.5 (+)
K2W_R: J2.20, U12.5 (+)
K2_L: R62.1, U7.6 (-), U7.7
K2_R: R111.1, U12.6 (-), U12.7
K3W_L: J2.13, U7.10 (+)
K3W_R: J2.22, U12.10 (+)
K3_L: R63.1, U7.8, U7.9 (-)
K3_R: R112.1, U12.8, U12.9 (-)
K4W_L: J2.15, U7.12 (+)
K4W_R: J2.24, U12.12 (+)
K4_L: R64.1, U7.13 (-), U7.14
K4_R: R113.1, U12.13 (-), U12.14
LA_L: C42.2, R34.1, R37.1, U4.6 (-), U4.7
LA_R: C80.2, R83.1, R86.1, U9.6 (-), U9.7
LB_L: R39.2, R40.1, R43.1, U4.14
LB_R: R88.2, R89.1, R92.1, U9.14
LMO_L: J2.10, R55.2, U6.7
LMO_R: J2.19, R104.2, U11.7
LOO_L: J2.8, R45.2, U5.7
LOO_R: J2.17, R94.2, U10.7
LPD_L: R170.1, U26.13 (D3)
LPD_R: R173.1, U27.13 (D3)
LT_F: R152.2, RV3.1
MA_L: C48.2, R48.1, U5.8, U5.9 (-)
MA_R: C86.2, R97.1, U10.8, U10.9 (-)
MB_L: C50.2, R50.1, R53.1, U5.13 (-), U5.14
MB_R: C88.2, R99.1, R102.1, U10.13 (-), U10.14
MCN_L: C55.1, R58.2, U6.9 (-)
MCN_R: C93.1, R107.2, U11.9 (-)
MCX_L: C54.1, R56.2, R57.1, R58.1
MCX_R: C92.1, R105.2, R106.1, R107.1
MET: J2.29, U17.8, U17.9 (-)
MG: R124.2, R125.2, R126.1, U17.3 (+)
MGB: U17.1, U17.2 (-), U17.5 (+)
MHN_L: C39.2, R29.1, U3.13 (-)
MHN_R: C77.2, R78.1, U8.13 (-)
MHO_L: C56.2, J2.12, U6.13 (-), U6.14
MHO_R: C94.2, J2.21, U11.13 (-), U11.14
MHX_L: C37.2, C38.1, C39.1, R28.1
MHX_R: C75.2, C76.1, C77.1, R77.1
NCLK: U23.6 (3Y), U23.9 (4A)
NDIFF: U23.12 (6Y), U24.12 (4A)
NGS_L: R66.1, R67.1, U13.2 (-)
NGS_R: R115.1, R116.1, U13.6 (-)
NG_L: R15.2, R16.1, U2.2 (-)
NG_R: R20.2, R21.1, U2.6 (-)
NIF_L: C121.1, R133.1, U18.8 (OUT), U20.2 (-)
NIF_R: C124.1, R138.1, U19.8 (OUT), U20.6 (-)
NP_F: R147.2, R148.1, U21.6 (-)
NREF5I: R10.2, R11.1, U46.6 (-)
NU17: U17.13 (-), U17.14
OF_F: R154.1, RV4.2
POT_F: J2.27, R139.1, R140.1, R142.1, R144.1, R149.1
Q0: R164.1, U24.2 (1B), U24.9 (3A), U25.5 (1Q), U26.10 (IN2), U27.10 (IN2)
Q1: R165.1, U24.5 (2B), U24.10 (3B), U25.9 (2Q), U26.11 (IN3), U27.11 (IN3)
R1_L: C33.1, R22.2, R46.1, U3.1, U3.2 (-)
R1_R: C71.1, R71.2, R95.1, U8.1, U8.2 (-)
R2A_L: C35.1, R24.2, U3.6 (-), U3.7
R2A_R: C73.1, R73.2, U8.6 (-), U8.7
R2_L: C37.1, R26.2, R56.1, U3.8, U3.9 (-)
R2_R: C75.1, R75.2, R105.1, U8.8, U8.9 (-)
R3A_L: C38.2, C40.1, R29.2, U3.14
R3A_R: C76.2, C78.1, R78.2, U8.14
RAW+22: FB3.1, J1.a5, J1.a6
RAW+27: FB1.1, J1.a1, J1.a2
RAW-22: FB4.1, J1.a7, J1.a8
RAW-27: FB2.1, J1.a3, J1.a4
REF5K: C22.1, D5.1 (K), R9.2, U46.3 (+)
SEND_TAP_L: J1.b7, R120.2
SEND_TAP_R: J1.b8, R122.2
SETN: C19.2, R8.1, U45.8 (SET)
SETP: C16.1, R7.1, U44.8 (SET)
SH_F: R146.2, R147.1, U21.1
SJ_F: D9.1 (K), D10.1 (K), D11.1 (K), R139.2, R146.1, R157.2, U21.2 (-)
SKAA1_L: C42.1, R32.2, R33.1
SKAA1_R: C80.1, R81.2, R82.1
SKAB1_L: C48.1, R46.2, R47.1
SKAB1_R: C86.1, R95.2, R96.1
SKAB2_L: C50.1, R48.2, R49.1
SKAB2_R: C88.1, R97.2, R98.1
SKAC2_L: C56.1, R59.2, R60.1
SKAC2_R: C94.1, R108.2, R109.1
SKAG2_L: C35.2, C36.1, R26.1
SKAG2_R: C73.2, C74.1, R75.1
SKAH1_L: C31.2, C32.1, R22.1
SKAH1_R: C69.2, C70.1, R71.1
SKAH2_L: C33.2, C34.1, R24.1
SKAH2_R: C71.2, C72.1, R73.1
SKAH3B_L: C40.2, C41.1, R30.1
SKAH3B_R: C78.2, C79.1, R79.1
SKBA1_L: C43.1, R33.2, U4.5 (+)
SKBA1_R: C81.1, R82.2, U9.5 (+)
SKBB1_L: C49.1, R47.2, U5.10 (+)
SKBB1_R: C87.1, R96.2, U10.10 (+)
SKBB2_L: C51.1, R49.2, U5.12 (+)
SKBB2_R: C89.1, R98.2, U10.12 (+)
SKBC2_L: C57.1, R60.2, U6.12 (+)
SKBC2_R: C95.1, R109.2, U11.12 (+)
SKBG2_L: C36.2, R27.1, U3.10 (+)
SKBG2_R: C74.2, R76.1, U8.10 (+)
SKBH1_L: C32.2, R23.1, U3.3 (+)
SKBH1_R: C70.2, R72.1, U8.3 (+)
SKBH2_L: C34.2, R25.1, U3.5 (+)
SKBH2_R: C72.2, R74.1, U8.5 (+)
SKBH3B_L: C41.2, R31.1, U4.3 (+)
SKBH3B_R: C79.2, R80.1, U9.3 (+)
SN1_F: D9.2 (A), R140.2, R141.1
SN2_F: D10.2 (A), R142.2, R143.1
SN3_F: D11.2 (A), R144.2, R145.1
SP_L: R61.2, R62.2, R63.2, R64.2, R65.2, U13.3 (+)
SP_R: R110.2, R111.2, R112.2, R113.2, R114.2, U13.5 (+)
STB_L: R120.1, U15.6 (-), U15.7
STB_R: R122.1, U16.6 (-), U16.7
SVI_L: C68.1, R68.2, U14.2 (-)
SVI_R: C106.1, R117.2, U14.6 (-)
SVO_L: C68.2, R69.1, U14.1
SVO_R: C106.2, R118.1, U14.7
SV_L: R65.1, R69.2, R70.1
SV_R: R114.1, R118.2, R119.1
SW_fl: R131.1, RV1.2
SW_fr: R136.1, RV2.2
SYM_fl: R131.2, R132.1, U18.4 (SYM)
SYM_fr: R136.2, R137.1, U19.4 (SYM)
V22F+: C12.1, FB3.2, U42.3 (IN)
V22F-: C13.2, FB4.2, U43.2 (VI)
V27F+: C1.1, D2.1 (K), FB1.2, U40.3 (VI)
V27F-: C2.2, D4.2 (A), FB2.2, U41.2 (VI)
VEE_fl: R130.1, U18.5 (V-)
VEE_fr: R135.1, U19.5 (V-)
VIN_fl: R129.2, U18.1 (IN)
VIN_fr: R134.2, U19.1 (IN)
VREG+: C5.1, D1.1 (K), D2.2 (A), Q40.2 (C), R1.1, R3.1, U40.2 (VO)
VREG-: C9.2, D3.2 (A), D4.1 (K), Q41.2 (C), R4.1, R6.1, U41.3 (VO)
X0: D12.2 (A), U24.3 (1Y)
X1: D13.2 (A), U24.6 (2Y)
XQ: U23.11 (5A), U24.8 (3Y)

Notes on the sheet:
BACKPLANE C96 (classe CDJ, REV dec. 159)
ALIMENTAZIONE +-18 audio, +-15 switch, +5, +-15 LN, +-5 riferimento
INGRESSO LINE [A] e GAIN T1 [B] (dec. 162)
ISOLATOR lato L (incroci C, dec. 152; iso-incc-banca.inc)
ISOLATOR lato R (incroci C, dec. 152; iso-incc-banca.inc)
SOMMA DELL'ISOLATOR (non invertente) e SERVO DC
CUE [D], SEND TAP [E] e METER [G] (pre-fader)
FADER [H] (2 VCA, shaper del fader, dec. 126) e DIP (dec. 163)
LEVETTA HPF/OFF/LPF: logica autotemporizzata (74HC14, 74HC86, 74HC74) e ADG1434
CAVO SCHEDA COMANDI (J2) e INGRESSI RCA (J3)

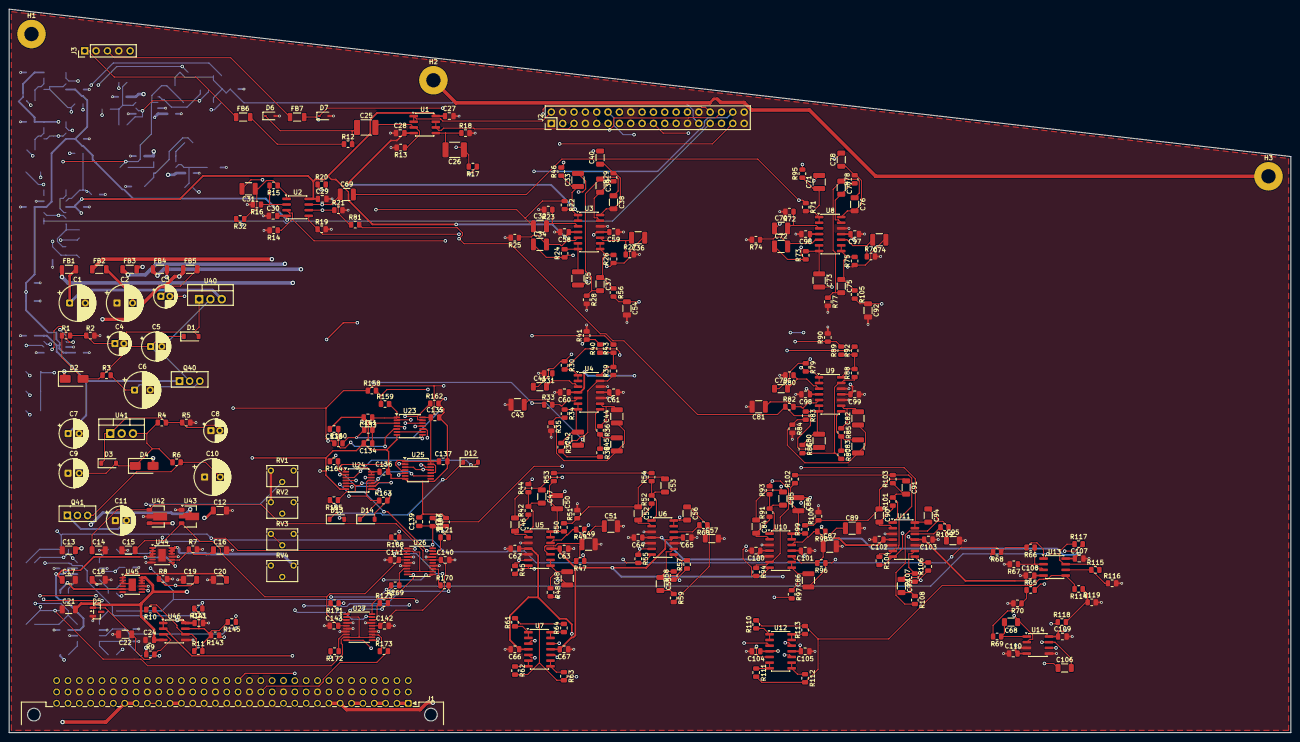
[picture p38: board canale.kicad_pcb from above]

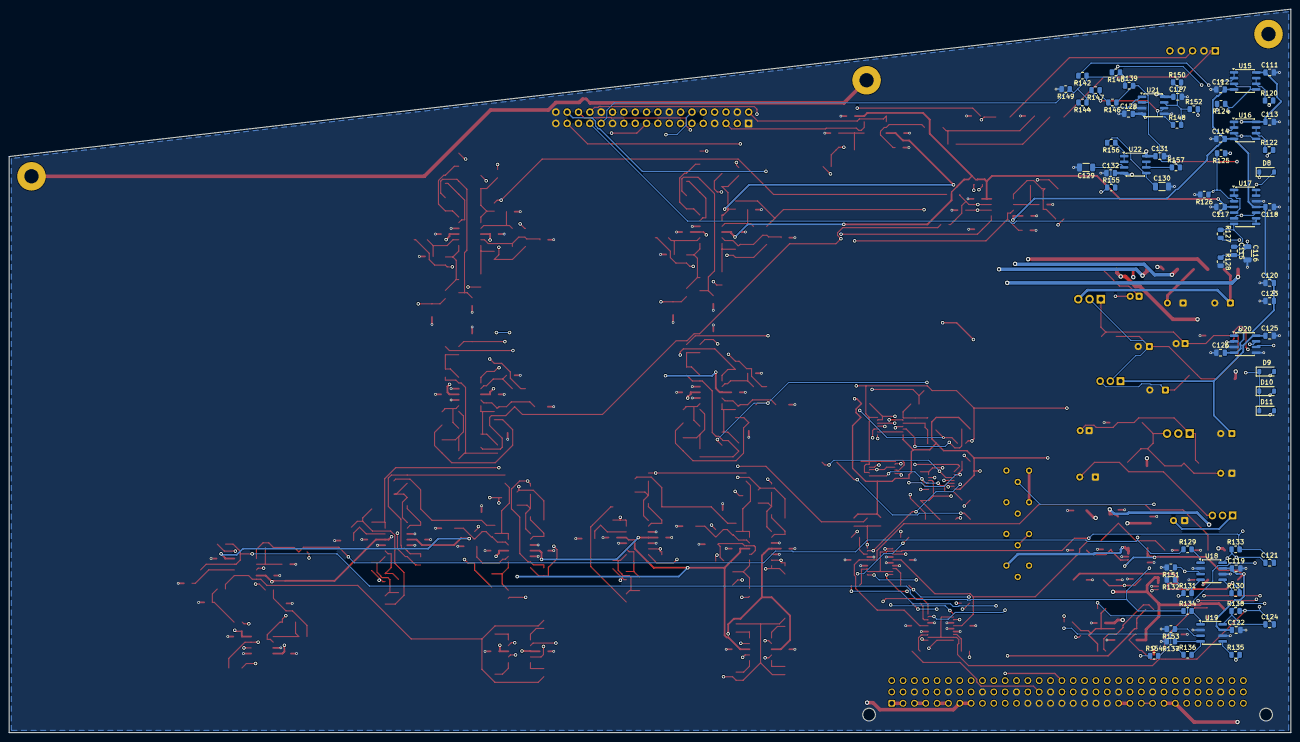
[picture p39: board canale.kicad_pcb from below]

Board: 4 copper layers, 287.0 x 162.0 mm, 383 parts (67 on the bottom side), 244 nets.
