dj-filippo241/maelcum_mixer/pcb/master/uscita-R/master-uscita-R.kicad_pcb

## KiCad design pcb/master/uscita-R/master-uscita-R.kicad_pcb (2026-11-12)

Schematic: master-uscita-R.kicad_sch, maelcum MASTER scheda di USCITA R (dec. 142-143) - bozza v0…

Parts:
C1, C2: 1000u 35V; CP_Radial_D12.5mm_P5.00mm
C3, C4: 100n 50V; C_0805_2012Metric
C5, C7: 10u 35V; CP_Radial_D5.0mm_P2.00mm
C6, C8: 47u 35V; CP_Radial_D6.3mm_P2.50mm
C9, C10, C11, C12, C13, C14, C16, C17, C19, C20: 100n; C_0805_2012Metric
C15, C18: 15n C0G; C_1206_3216Metric
C21: 1u; C_1206_3216Metric
D1, D3, D5, D6, D7, D8, D9, D10, D11, D12, D13, D14, D15, D16, D17, D18, D19, D20, D21, D22, D23, D24, D25, D26, D27, D28, D29, D30, D31, D32, D33, D34, D35, D36, D37, D38, D39, D40, D43: 1N4148W; D_SOD-123
D2, D4: S1G; D_SMA
D41, D42: BAT54W; SOT-323_SC-70
FB1, FB2: ferrite 600R 2A; L_1206_3216Metric
H1, H2: CHASSIS; MountingHole_3.2mm_M3_Pad
J1: C96 maschio; DIN41612_C_3x32_Male_Horizontal_THT
J2: 2x7 cavo piatto; PinHeader_2x07_P2.54mm_Vertical
J3: 2x5 cavo; PinHeader_2x05_P2.54mm_Vertical
K1, K2: G6K-2F DC5; Relay_DPDT_Omron_G6K-2F
Q1, Q3, Q8, Q10: BF245A; TO-92_Inline_Wide
Q2, Q6, Q9, Q13: MJE340; TO-126-3_Vertical
Q4, Q7, Q11, Q14: MJE350; TO-126-3_Vertical
Q5, Q12: BC847B; SOT-23
Q15: AO3400A; SOT-23
Q16: 2N7002; SOT-23
R1, R3: 120 1%; R_0805_2012Metric
R2, R4: 1k62 1%; R_0805_2012Metric
R5, R6, R32: 10k 0.1%; R_0805_2012Metric
R7, R8, R9, R10, R20, R21: 47; R_0805_2012Metric
R11, R22: 2k2 1%; R_0805_2012Metric
R12, R23: 1k 1%; R_0805_2012Metric
R13, R14, R24, R25: 33 1%; R_1206_3216Metric
R15, R17, R26, R27, R29: 1k 0.1%; R_0805_2012Metric
R16, R18, R28: 1M 1%; R_0805_2012Metric
R19, R30: 220k 1%; R_0805_2012Metric
R31: 100k 0.1%; R_0805_2012Metric
R33, R35: 118k 1%; R_0805_2012Metric
R34, R36, R37, R38: 10k 1%; R_0805_2012Metric
R39, R41: 4k7; R_0805_2012Metric
R40: 680k; R_0805_2012Metric
R42, R46: 10k; R_0805_2012Metric
R43: 100; R_0805_2012Metric
R44: 100k; R_0805_2012Metric
R45: 1k; R_0805_2012Metric
U1, U2, U11, U21: OPA1612AIDR; SOIC-8_3.9x4.9mm_P1.27mm
U3: LM339; SOIC-14_3.9x8.7mm_P1.27mm
U12, U22: TL071; SOIC-8_3.9x4.9mm_P1.27mm
U40: LM317; TO-220-3_Vertical
U41: LM337; TO-220-3_Vertical

Connections:
+5V: D43.1 (K), J1.a21, J1.a22, K1.1, K2.1, R37.1, R40.1, R42.1, R44.2, R46.2
+18V: C6.1, C9.1, C11.1, C13.1, C16.1, C19.1, D1.1 (K), D2.2 (A), R1.1, U1.8 (V+), U2.8 (V+), U3.3 (V+), U12.7 (V+), U22.7 (V+), U40.2 (VO)
-18V: C8.2, C10.2, C12.2, C14.2, C17.2, C20.2, D3.2 (A), D4.1 (K), R3.1, U1.4 (V-), U2.4 (V-), U3.12 (V-), U12.4 (V-), U22.4 (V-), U41.3 (VO)
ADJ+: C5.1, D1.2 (A), R1.2, R2.1, U40.1 (ADJ)
ADJ-: C7.2, D3.1 (K), R3.2, R4.1, U41.1 (ADJ)
AGND: C1.2, C2.1, C3.2, C4.1, C5.2, C6.2, C7.1, C8.1, C9.2, C10.1, C11.2, C12.1, C13.2, C14.1, C16.2, C17.1, C19.2, C20.1, J1.a13, J1.a14, J1.a15, J1.a16, J1.a17, J1.a18, J1.a19, J1.a20, J2.1, J2.3, J2.5, J2.7, J2.9, J2.11, J3.1, J3.4, J3.7, J3.10, R2.2, R4.2, R18.2, R29.2, R32.2, R34.2, R36.2, U2.3 (+), U2.5 (+), U3.11 (+), U12.3 (+), U22.3 (+)
B2_C: Q12.2 (E), Q14.3 (B), R23.2
B2_H: Q5.2 (E), Q7.3 (B), R12.2
BC: R6.2, R8.1, U2.1
BH: R7.1, U1.6 (-), U1.7
BIN: R5.2, R6.1, U2.2 (-)
BOC: K2.6, R8.2
BOH: K2.3, R7.2
BOOTH_R: J2.8, R5.1, U1.5 (+)
BU_C: D23.2 (A), Q8.2 (S), Q9.3 (B), R20.2
BU_H: D5.2 (A), Q1.2 (S), Q2.3 (B), R9.2
CHALF: R37.2, R38.1, U3.9 (+)
CHASSIS: H1.1, H2.1, J1.a25, J1.a26
CLAT: C21.1, D41.3 (K), R39.2, R40.2, U3.8 (-)
CLD: R31.2, R32.1, U3.5 (+), U3.6 (-)
CLIP_R: D42.3 (K), J2.14, R41.2, R42.2
CLO: R41.1, U3.14
CLX: R39.1, U3.1, U3.2
CTN: R35.2, R36.1, U3.4 (-)
CTP: R33.2, R34.1, U3.7 (+), U3.10 (-)
CTRL_GND: C21.2, D41.1 (A), D42.1 (A), J1.a23, J1.a24, J1.c16, J1.c20, J1.c24, J1.c28, Q15.2 (S), Q16.2 (S), R38.2
DRV_C: Q12.3 (C), Q13.3 (B), R22.1, U21.1
DRV_H: Q5.3 (C), Q6.3 (B), R11.1, U11.1
E1_C: Q13.1 (E), R24.1
E1_H: Q6.1 (E), R13.1
E2_C: Q14.1 (E), R25.1
E2_H: Q7.1 (E), R14.1
GLOBAL_MUTE: J1.c9, R44.1, R45.1
GMG: Q16.1 (G), R45.2
INN_C: R26.2, R27.2, U21.2 (-)
INN_H: R17.2, R18.1, U11.2 (-)
INP_C: R28.2, R29.1, U21.3 (+)
INP_H: R15.2, R16.2, U11.3 (+)
J1S_C: Q8.1 (G), R20.1
J1S_H: Q1.1 (G), R9.1
J2S_C: Q10.1 (G), R21.1
J2S_H: Q3.1 (G), R10.1
KD: D43.2 (A), K1.8, K2.8, Q15.3 (D)
KG: Q15.1 (G), R43.2
KG0: Q16.3 (D), R43.1, R46.1
MAST_R: J2.4, U1.3 (+)
MID_C: Q12.1 (B), R22.2, R23.1
MID_H: Q5.1 (B), R11.2, R12.1
MRX: R15.1, R26.1, U1.1, U1.2 (-)
NB2_C: D40.1 (K), Q10.3 (D), Q11.3 (B)
NB2_H: D22.1 (K), Q3.3 (D), Q4.3 (B)
NU: U2.6 (-), U2.7
OUT_C: D31.1 (K), D32.2 (A), K1.6, R24.2, R25.2, R27.1, R30.1, U21.5 (+)
OUT_H: D13.1 (K), D14.2 (A), K1.3, R13.2, R14.2, R17.1, R19.1, R31.1, U11.5 (+)
RAW+26: FB1.1, J1.a9, J1.a10
RAW-26: FB2.1, J1.a11, J1.a12
S1_C: D23.1 (K), D24.2 (A)
S1_H: D5.1 (K), D6.2 (A)
S2_C: D24.1 (K), D25.2 (A)
S2_H: D6.1 (K), D7.2 (A)
S3_C: D25.1 (K), D26.2 (A)
S3_H: D7.1 (K), D8.2 (A)
S4_C: D26.1 (K), D27.2 (A)
S4_H: D8.1 (K), D9.2 (A)
S5_C: D27.1 (K), D28.2 (A)
S5_H: D9.1 (K), D10.2 (A)
S6_C: D28.1 (K), D29.2 (A)
S6_H: D10.1 (K), D11.2 (A)
S7_C: D29.1 (K), D30.2 (A)
S7_H: D11.1 (K), D12.2 (A)
S8_C: D30.1 (K), D31.2 (A)
S8_H: D12.1 (K), D13.2 (A)
SVN_C: C18.1, R30.2, U22.2 (-)
SVN_H: C15.1, R19.2, U12.2 (-)
SV_C: C18.2, R28.1, U22.6
SV_H: C15.2, R16.1, U12.6
T1_C: D32.1 (K), D33.2 (A)
T1_H: D14.1 (K), D15.2 (A)
T2_C: D33.1 (K), D34.2 (A)
T2_H: D15.1 (K), D16.2 (A)
T3_C: D34.1 (K), D35.2 (A)
T3_H: D16.1 (K), D17.2 (A)
T4_C: D35.1 (K), D36.2 (A)
T4_H: D17.1 (K), D18.2 (A)
T5_C: D36.1 (K), D37.2 (A)
T5_H: D18.1 (K), D19.2 (A)
T6_C: D37.1 (K), D38.2 (A)
T6_H: D19.1 (K), D20.2 (A)
T7_C: D38.1 (K), D39.2 (A)
T7_H: D20.1 (K), D21.2 (A)
T8_C: D39.1 (K), D40.2 (A)
T8_H: D21.1 (K), D22.2 (A)
UB_C: U21.6 (-), U21.7
UB_H: U11.6 (-), U11.7
V26F+: C1.1, C3.1, D2.1 (K), FB1.2, Q1.3 (D), Q2.2 (C), Q6.2 (C), Q8.3 (D), Q9.2 (C), Q13.2 (C), R33.1, U40.3 (VI)
V26F-: C2.2, C4.2, D4.2 (A), FB2.2, Q3.2 (S), Q4.2 (C), Q7.2 (C), Q10.2 (S), Q11.2 (C), Q14.2 (C), R10.2, R21.2, R35.1, U41.2 (VI)
VM_C: Q11.1 (E), U21.4 (V-)
VM_H: Q4.1 (E), U11.4 (V-)
VP_C: Q9.1 (E), U21.8 (V+)
VP_H: Q2.1 (E), U11.8 (V+)
XBC: J3.6, K2.5
XBH: J3.5, K2.4
XMC: J3.3, K1.5
XMH: J3.2, K1.4

Notes on the sheet:
BACKPLANE C96 (classe MASTER-OUT, dec. 143): solo alimentazioni
ALIMENTAZIONE [M]: statici +-26 filtrati, +-18 locali (LM317/337)
RICEVITORE del MASTER e DRIVER del BOOTH [B3] (OPA1612 diretto, §3.4)
STADIO D'USCITA caldo [F]+[G] (bootstrap, dec. 86)
STADIO D'USCITA freddo [F]+[G] (bootstrap, invertente)
CLIP detector: finestra sul caldo, soglia 0,86 x statico, tenuta ~0,5 s (NOTA, da simulare)
RELE' di MASTER e BOOTH (G6K-2F, 5 V, 237 ohm; eccitati = suono, failsafe)
COMANDO DEI RELE' dalla GLOBAL_MUTE (c9): basso = suona
CONNETTORI: J2 dalla scheda di segnale, J3 verso la schedina dei connettori sul retro

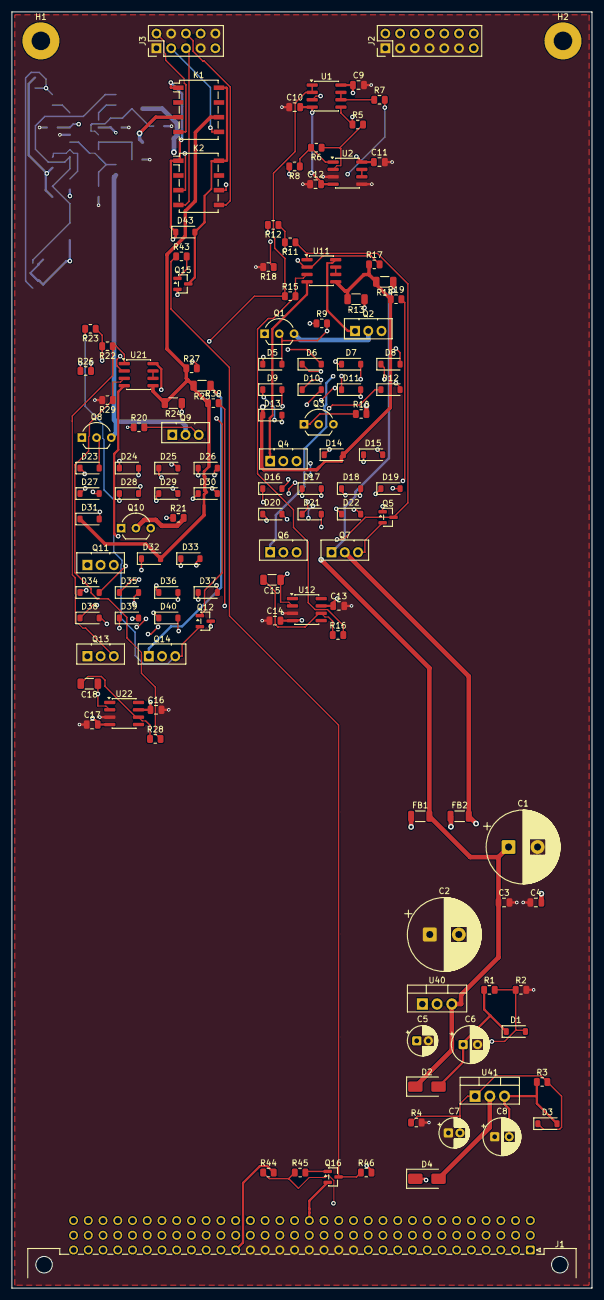
[picture p40: board master-uscita-R.kicad_pcb from above]

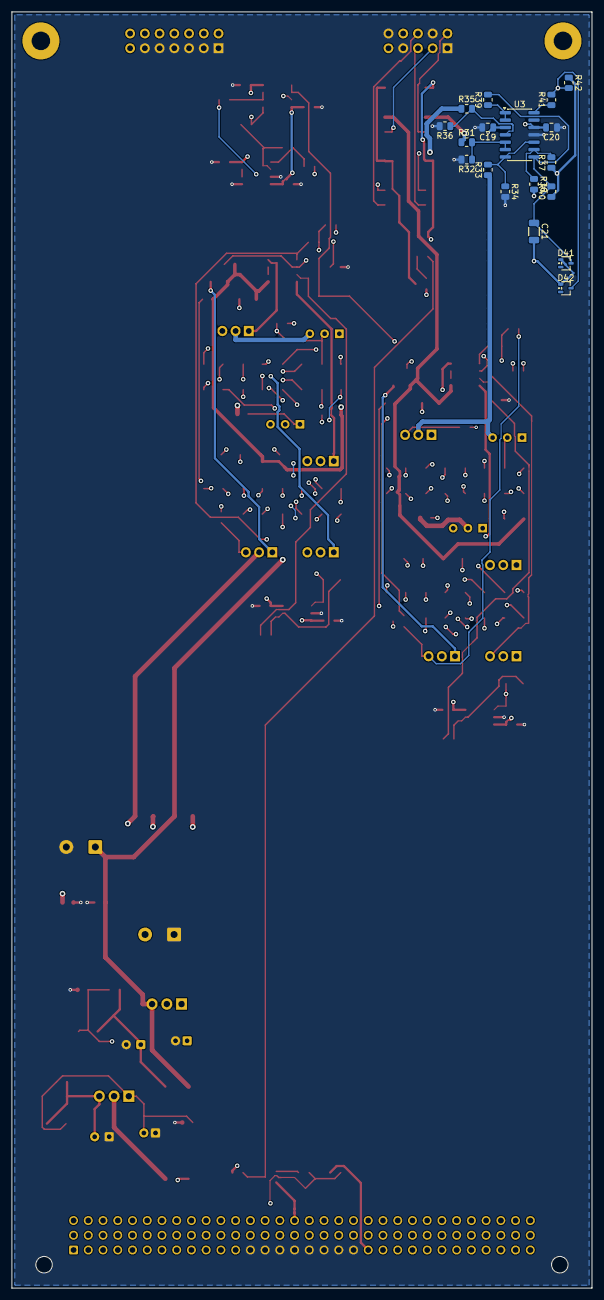
[picture p41: board master-uscita-R.kicad_pcb from below]

Board: 4 copper layers, 100.0 x 220.0 mm, 144 parts (18 on the bottom side), 104 nets.
