dj-filippo241/maelcum_mixer/pcb/fx-send/fx-send.kicad_pcb

## KiCad design pcb/fx-send/fx-send.kicad_pcb (2026-11-12)

Schematic: fx-send.kicad_sch, maelcum FX-SEND (dec. 91a) - bozza v0.2

Parts:
C1, C2: 220u 35V; CP_Radial_D8.0mm_P3.50mm
C3: 47u 10V; CP_Radial_D5.0mm_P2.00mm
C4, C8: 10u 35V; CP_Radial_D5.0mm_P2.00mm
C5, C9: 47u 35V; CP_Radial_D6.3mm_P2.50mm
C6, C10: 470u 25V; CP_Radial_D8.0mm_P3.50mm
C7, C11: 100u 25V; CP_Radial_D6.3mm_P2.50mm
C12, C13: 1u 50V; C_1206_3216Metric
C14, C15: 1u 25V; C_1206_3216Metric
C16, C17, C22, C23, C24, C25, C30, C31, C32, C33, C34, C35, C36, C37, C38, C39, C40, C41: 100n; C_0805_2012Metric
C18, C19, C26, C27: 180n C0G; C_1206_3216Metric
C20, C21, C28, C29: 10n C0G; C_1206_3216Metric
D1, D3: 1N4148W; D_SOD-123
D2, D4: S1G; D_SMA
FB1, FB2, FB3, FB4, FB5: ferrite 600R; L_1206_3216Metric
H1, H2: CHASSIS; MountingHole_3.2mm_M3_Pad
J1: C96 maschio; DIN41612_C_3x32_Male_Horizontal_THT
J2: 2x12 cavo piatto; PinHeader_2x12_P2.54mm_Vertical
J3: 1x6 bottoni; PinHeader_1x06_P2.54mm_Vertical
Q1: BD139; TO-126-3_Vertical
Q2: BD140; TO-126-3_Vertical
Q3, Q4, Q5, Q6: 2N7002; SOT-23
R1, R4: 120 1%; R_0805_2012Metric
R2, R5: 1k74 1%; R_0805_2012Metric
R3, R6, R37, R40, R43, R46, R47: 1k; R_0805_2012Metric
R7, R8, R36, R39, R42, R45, R48: 100k; R_0805_2012Metric
R9, R10, R22, R23: 324 0.1%; R_0805_2012Metric
R11, R24: 5k23 0.1%; R_0805_2012Metric
R12, R25: 2k49 0.1%; R_0805_2012Metric
R13, R14, R18, R19, R20, R21, R26, R27, R31, R32, R33, R34: 10k 0.1%; R_0805_2012Metric
R15, R16, R17, R28, R29, R30: 49k9 0.1%; R_0805_2012Metric
R35, R38, R41, R44: 10k; R_0805_2012Metric
U1: OPA1612AIDR; SOIC-8_3.9x4.9mm_P1.27mm
U2, U3, U4, U5: OPA1654AIDR; SOIC-14_3.9x8.7mm_P1.27mm
U6, U7: ADG1434YRUZ; TSSOP-20_4.4x6.5mm_P0.65mm
U10: LM317; TO-220-3_Vertical
U11: LM337; TO-220-3_Vertical
U12: 78L15; SOT-89-3
U13: 79L15; SOT-89-3

Connections:
+5V: FB5.1, J1.a21, J1.a22
+5VF: C3.1, FB5.2, J3.1, R48.2
+15SW: C14.1, C34.1, C36.1, U6.16 (VDD), U7.16 (VDD), U12.1 (OUT)
+18V: C7.1, C16.1, C22.1, C24.1, C30.1, C32.1, Q1.1 (E), U1.8 (V+), U2.4 (V+), U3.4 (V+), U4.4 (V+), U5.4 (V+)
-15SW: C15.2, C35.2, C37.2, U6.5 (VSS), U7.5 (VSS), U13.3 (VO)
-18V: C11.2, C17.2, C23.2, C25.2, C31.2, C33.2, Q2.1 (E), U1.4 (V-), U2.11 (V-), U3.11 (V-), U4.11 (V-), U5.11 (V-)
ADJ+: C4.1, D1.2 (A), R1.2, R2.1, U10.1 (ADJ)
ADJ-: C8.2, D3.1 (K), R4.2, R5.1, U11.1 (ADJ)
AGND: C1.2, C2.1, C4.2, C5.2, C6.2, C7.2, C8.1, C9.1, C10.1, C11.1, C12.2, C13.1, C14.2, C15.1, C16.2, C17.1, C22.2, C23.1, C24.2, C25.1, C30.2, C31.1, C32.2, C33.1, C34.2, C35.1, C36.2, C37.1, J1.a13, J1.a14, J1.a15, J1.a16, J1.a17, J1.a18, J1.a19, J1.a20, J1.b3, J1.b6, J1.b9, J1.b12, J1.b15, J1.b18, J1.b21, J1.b24, J1.b27, J1.b30, J2.1, J2.5, J2.9, J2.13, J2.17, J2.20, J2.23, J2.24, R2.2, R5.2, R7.2, R8.2, R12.2, R25.2, U2.3 (+), U2.10 (+), U2.12 (+), U3.3 (+), U3.10 (+), U3.12 (+), U6.4 (S1B), U6.6 (GND), U6.7 (S2B), U6.14 (S3B), U6.17 (S4B), U7.4 (S1B), U7.6 (GND), U7.7 (S2B), U7.14 (S3B), U7.17 (S4B), U12.2 (GND), U13.1 (GND)
ASG1: C38.1, R35.2, R36.1, R37.1, U6.1 (IN1), U7.1 (IN1)
ASG2: C39.1, R38.2, R39.1, R40.1, U6.10 (IN2), U7.10 (IN2)
ASG3: C40.1, R41.2, R42.1, R43.1, U6.11 (IN3), U7.11 (IN3)
ASG4: C41.1, R44.2, R45.1, R46.1, U6.20 (IN4), U7.20 (IN4)
BASE+: C6.1, Q1.3 (B), R3.2
BASE-: C10.2, Q2.3 (B), R6.2
BTN1: J3.2, R35.1
BTN2: J3.3, R38.1
BTN3: J3.4, R41.1
BTN4: J3.5, R44.1
CHASSIS: H1.1, H2.1, J1.a25, J1.a26
CTRL_GND: C3.2, C38.2, C39.2, C40.2, C41.2, J1.a23, J1.a24, J1.c16, J1.c20, J1.c24, J1.c28, J3.6, Q3.2 (S), Q4.2 (S), Q5.2 (S), Q6.2 (S), R36.2, R39.2, R42.2, R45.2
GLOBAL_MUTE: J1.c9, R47.1
INJ1_L: R18.1, U4.1, U4.2 (-)
INJ1_R: R31.1, U5.1, U5.2 (-)
INJ2_L: R19.1, U4.6 (-), U4.7
INJ2_R: R32.1, U5.6 (-), U5.7
INJ3_L: R20.1, U4.8, U4.9 (-)
INJ3_R: R33.1, U5.8, U5.9 (-)
INJ4_L: R21.1, U4.13 (-), U4.14
INJ4_R: R34.1, U5.13 (-), U5.14
LVL_W_L: J2.19, U6.2 (S1A), U6.9 (S2A), U6.12 (S3A), U6.19 (S4A)
LVL_W_R: J2.22, U7.2 (S1A), U7.9 (S2A), U7.12 (S3A), U7.19 (S4A)
MD1: Q3.3 (D), R37.2
MD2: Q4.3 (D), R40.2
MD3: Q5.3 (D), R43.2
MD4: Q6.3 (D), R46.2
MUTE_G: Q3.1 (G), Q4.1 (G), Q5.1 (G), Q6.1 (G), R47.2, R48.1
NA_L: C18.1, J2.2, R9.2
NA_R: C26.1, J2.6, R22.2
NB_L: C18.2, C19.1, J2.3, U2.2 (-)
NB_R: C26.2, C27.1, J2.7, U3.2 (-)
NC_L: C19.2, J2.4, R10.1
NC_R: C27.2, J2.8, R23.1
NHA_L: C20.2, C21.1, R11.1
NHA_R: C28.2, C29.1, R24.1
NHB_L: C21.2, R12.1, U2.5 (+)
NHB_R: C29.2, R25.1, U3.5 (+)
NSH_L: R15.2, R16.2, R17.1, U2.13 (-)
NSH_R: R28.2, R29.2, R30.1, U3.13 (-)
NVH_L: R13.2, R14.1, U2.9 (-)
NVH_R: R26.2, R27.1, U3.9 (-)
RAW+22: FB3.1, J1.a5, J1.a6
RAW+27: FB1.1, J1.a1, J1.a2
RAW-22: FB4.1, J1.a7, J1.a8
RAW-27: FB2.1, J1.a3, J1.a4
S1_OUT_L: J1.b4, R18.2
S1_OUT_R: J1.b5, R31.2
S2_OUT_L: J1.b7, R19.2
S2_OUT_R: J1.b8, R32.2
S3_OUT_L: J1.b10, R20.2
S3_OUT_R: J1.b11, R33.2
S4_OUT_L: J1.b13, R21.2
S4_OUT_R: J1.b14, R34.2
SEND_IN_L: J1.b1, R7.1, U1.3 (+)
SEND_IN_R: J1.b2, R8.1, U1.5 (+)
SW1_L: U4.3 (+), U6.3 (D1)
SW1_R: U5.3 (+), U7.3 (D1)
SW2_L: U4.5 (+), U6.8 (D2)
SW2_R: U5.5 (+), U7.8 (D2)
SW3_L: U4.10 (+), U6.13 (D3)
SW3_R: U5.10 (+), U7.13 (D3)
SW4_L: U4.12 (+), U6.18 (D4)
SW4_R: U5.12 (+), U7.18 (D4)
V22F+: C12.1, FB3.2, U12.3 (IN)
V22F-: C13.2, FB4.2, U13.2 (VI)
V27F+: C1.1, D2.1 (K), FB1.2, U10.3 (VI)
V27F-: C2.2, D4.2 (A), FB2.2, U11.2 (VI)
VHI_L: J2.18, R17.2, U2.14
VHI_R: J2.21, R30.2, U3.14
VHN_L: J2.10, R14.2, U2.8
VHN_R: J2.14, R27.2, U3.8
VHP_L: J2.12, R11.2, R13.1, U2.6 (-), U2.7
VHP_R: J2.16, R24.2, R26.1, U3.6 (-), U3.7
VLO_L: C20.1, R10.2, R15.1, U2.1
VLO_R: C28.1, R23.2, R28.1, U3.1
VPRE_L: R9.1, U1.1, U1.2 (-)
VPRE_R: R22.1, U1.6 (-), U1.7
VREG+: C5.1, D1.1 (K), D2.2 (A), Q1.2 (C), R1.1, R3.1, U10.2 (VO)
VREG-: C9.2, D3.2 (A), D4.1 (K), Q2.2 (C), R4.1, R6.1, U11.3 (VO)
WPH_L: J2.11, R16.1
WPH_R: J2.15, R29.1

Notes on the sheet:
BACKPLANE C96 (classe FX-SEND)
ALIMENTAZIONE +-18 audio, +-15 switch, +5
BUFFER IN (OPA1612)
EQ2 lato L (LOW 120 Hz + HIGH 4,5 kHz, fx-eq2-pot10k.cir)
INIEZIONE lato L (OPA1654 + 10k verso i bus)
EQ2 lato R (LOW 120 Hz + HIGH 4,5 kHz, fx-eq2-pot10k.cir)
INIEZIONE lato R (OPA1654 + 10k verso i bus)
ASSIGN S1-S4 (ADG1434 pi SPDT, soft-switch 1 ms, mute globale)
CAVO SCHEDA COMANDI (J2) e BOTTONI ASSIGN (J3)

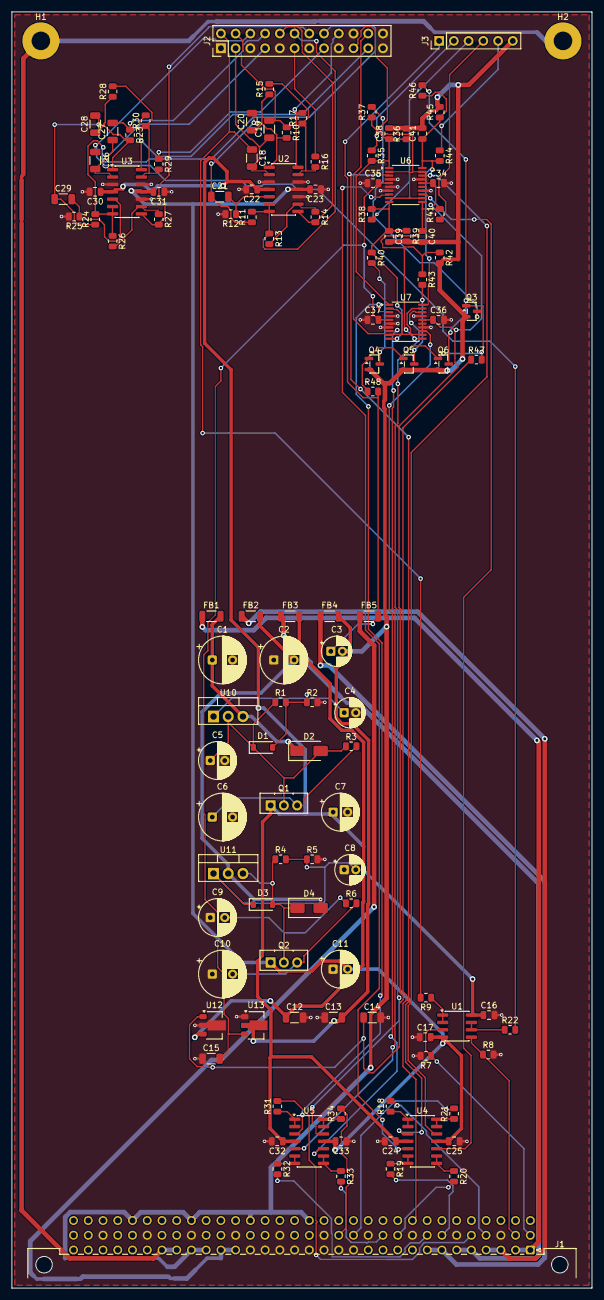
[picture p42: board fx-send.kicad_pcb from above]

Board: 4 copper layers, 100.0 x 220.0 mm, 120 parts (0 on the bottom side), 91 nets.
