dj-filippo241/maelcum_mixer/pcb/fx-ret/fx-ret.kicad_pcb

## KiCad design pcb/fx-ret/fx-ret.kicad_pcb (2026-11-12)

Schematic: fx-ret.kicad_sch, maelcum FX-RET (dec. 130) - bozza v0.1

Parts:
C1, C2: 220u 35V; CP_Radial_D8.0mm_P3.50mm
C3: 47u 10V; CP_Radial_D5.0mm_P2.00mm
C4, C8: 10u 35V; CP_Radial_D5.0mm_P2.00mm
C5, C9: 47u 35V; CP_Radial_D6.3mm_P2.50mm
C6, C10: 470u 25V; CP_Radial_D8.0mm_P3.50mm
C7, C11: 100u 25V; CP_Radial_D6.3mm_P2.50mm
C12, C13, C15, C16: 4u7 25V; C_1206_3216Metric
C14, C17: 10u 25V; C_1206_3216Metric
C18: 1u; C_1206_3216Metric
C19, C20, C23, C24, C25, C26, C29, C30, C31, C32, C33, C34, C39, C40, C41, C42, C47, C48, C51, C52, C53, C54, C56, C57, C59, C60, C62, C63: 100n; C_0805_2012Metric
C21, C22: 10p C0G; C_0805_2012Metric
C27, C28: 15n C0G; C_1206_3216Metric
C35, C36, C43, C44: 180n C0G; C_1206_3216Metric
C37, C38, C45, C46: 10n C0G; C_1206_3216Metric
C49: 47p C0G; C_0805_2012Metric
C50: 100n C0G; C_1206_3216Metric
C55, C58: 22p C0G; C_0805_2012Metric
C61: 56n C0G; C_1210_3225Metric
D1, D3, D10, D11, D12, D13: 1N4148W; D_SOD-123
D2, D4: S1G; D_SMA
D5: LM4040-5.0; SOT-23
D6, D7, D8, D9: TVS bidir <=5 pF; D_SOD-323
FB1, FB2, FB3: ferrite 600R; L_1206_3216Metric
H1, H2: CHASSIS; MountingHole_3.2mm_M3_Pad
J1: C96 maschio; DIN41612_C_3x32_Male_Horizontal_THT
J2: 2x18 cavo piatto; PinHeader_2x18_P2.54mm_Vertical
J3: 1x7 jack pedale; PinHeader_1x07_P2.54mm_Vertical
J4: 2x16 ponte reroute; PinHeader_2x16_P2.54mm_Vertical
Q40: BD139; TO-126-3_Vertical
Q41: BD140; TO-126-3_Vertical
R1, R4: 120 1%; R_0805_2012Metric
R2, R5: 1k74 1%; R_0805_2012Metric
R3, R6, R53: 1k; R_0805_2012Metric
R7, R8: 150k 0.1%; R_0805_2012Metric
R9: 1k5; R_0805_2012Metric
R10, R11, R12, R14, R18, R23, R33, R34, R45, R46, R55, R56, R57, R58, R59, R60, R61, R62, R82: 10k 0.1%; R_0805_2012Metric
R13, R15, R16, R21: 100; R_0805_2012Metric
R17, R19, R20, R22, R24, R25: 1M; R_0805_2012Metric
R26, R38: 1k24 0.1%; R_0805_2012Metric
R27, R39: 3k24 0.1%; R_0805_2012Metric
R28, R40, R52: 4k02 0.1%; R_0805_2012Metric
R29, R30, R41, R42: 324 0.1%; R_0805_2012Metric
R31, R43: 5k23 0.1%; R_0805_2012Metric
R32, R44: 2k49 0.1%; R_0805_2012Metric
R35, R36, R37, R47, R48, R49: 49k9 0.1%; R_0805_2012Metric
R50, R51, R63, R67, R69, R73: 20k 0.1%; R_0805_2012Metric
R54: 3M; R_0805_2012Metric
R64, R70: 6k19; R_0805_2012Metric
R65, R71: 150k; R_0805_2012Metric
R66, R72: 51; R_0805_2012Metric
R68, R74: 47; R_0805_2012Metric
R75: 43.2k 0.1%; R_0805_2012Metric
R76: 68.1k 0.1%; R_0805_2012Metric
R77: 357k 0.1%; R_0805_2012Metric
R78: 20.0k 0.1%; R_0805_2012Metric
R79: 38.3k 0.1%; R_0805_2012Metric
R80: 976 0.1%; R_0805_2012Metric
R81: 1.33k 0.1%; R_0805_2012Metric
R83: 9k76 0.1%; R_0805_2012Metric
R84: 18k7 0.1%; R_0805_2012Metric
R85: 100k; R_0805_2012Metric
R86: 18k2 0.1%; R_0805_2012Metric
R87, R89: 1k 0.1%; R_0805_2012Metric
R88: 17k4 0.1%; R_0805_2012Metric
R90: 2M7; R_0805_2012Metric
RV1, RV2, RV4: 50k; Potentiometer_Bourns_3266W_Vertical
RV3: 2k; Potentiometer_Bourns_3266W_Vertical
U1, U2, U4, U5, U6, U30, U31, U46: OPA1612AIDR; SOIC-8_3.9x4.9mm_P1.27mm
U3: OPA1642AIDR; SOIC-8_3.9x4.9mm_P1.27mm
U7, U8, U9: OPA1654AIDR; SOIC-14_3.9x8.7mm_P1.27mm
U28, U29: V2181L; SOIC-8_3.9x4.9mm_P1.27mm
U40: LM317; TO-220-3_Vertical
U41: LM337; TO-220-3_Vertical
U44: LT3045EMSE; MSOP-12-1EP_3x4.039mm_P0.65mm_EP1.651x2.845mm
U45: LT3094EMSE; MSOP-12-1EP_3x4.039mm_P0.65mm_EP1.651x2.845mm

Connections:
+5V: FB3.1, J1.a21, J1.a22
+5VF: C3.1, FB3.2, J2.33
+15LN: C14.1, C19.1, C62.1, J4.7, R9.1, RV1.1, RV2.1, RV4.1, U31.8 (V+), U44.10 (OUTS), U44.11 (OUT), U44.12 (OUT), U46.8 (V+)
+18V: C7.1, C13.1, C23.1, C25.1, C29.1, C31.1, C33.1, C39.1, C41.1, C47.1, C51.1, C53.1, C56.1, C59.1, J4.1, J4.2, Q40.1 (E), U1.8 (V+), U2.8 (V+), U3.8 (V+), U4.8 (V+), U5.8 (V+), U6.8 (V+), U7.4 (V+), U8.4 (V+), U9.4 (V+), U28.7 (V+), U29.7 (V+), U30.8 (V+), U44.1 (IN), U44.2 (IN), U44.3 (IN), U44.4 (EN/UV), U44.7 (PGFB)
+REF5: J2.24, J4.11, R10.1, U46.1, U46.2 (-)
-15LN: C17.2, C20.2, C63.2, J4.8, RV1.3, RV2.3, RV4.3, U31.4 (V-), U45.10 (OUTS), U45.11 (OUT), U45.12 (OUT), U46.4 (V-)
-18V: C11.2, C16.2, C24.2, C26.2, C30.2, C32.2, C34.2, C40.2, C42.2, C48.2, C52.2, C54.2, C57.2, C60.2, J4.5, J4.6, Q41.1 (E), R64.2, R70.2, U1.4 (V-), U2.4 (V-), U3.4 (V-), U4.4 (V-), U5.4 (V-), U6.4 (V-), U7.11 (V-), U8.11 (V-), U9.11 (V-), U30.4 (V-), U45.1 (IN), U45.2 (IN), U45.3 (EN/UV), U45.5 (PGFB), U45.13 (IN)
-REF5: J4.12, R11.2, R77.2, R79.2, R81.2, U46.7
ADJ+: C4.1, D1.2 (A), R1.2, R2.1, U40.1 (ADJ)
ADJ-: C8.2, D3.1 (K), R4.2, R5.1, U41.1 (ADJ)
AGND: C1.2, C2.1, C4.2, C5.2, C6.2, C7.2, C8.1, C9.1, C10.1, C11.1, C12.2, C13.2, C14.2, C15.1, C16.1, C17.1, C18.2, C19.2, C20.1, C23.2, C24.1, C25.2, C26.1, C29.2, C30.1, C31.2, C32.1, C33.2, C34.1, C39.2, C40.1, C41.2, C42.1, C47.2, C48.1, C50.2, C51.2, C52.1, C53.2, C54.1, C56.2, C57.1, C59.2, C60.1, C62.2, C63.1, D5.2 (A), D6.2 (A2), D7.2 (A2), D8.2 (A2), D9.2 (A2), J1.a13, J1.a14, J1.a15, J1.a16, J1.a17, J1.a18, J1.a19, J1.a20, J1.b3, J1.b6, J1.b9, J1.b12, J1.b15, J1.b18, J1.b21, J1.b24, J1.b27, J1.b30, J2.1, J2.5, J2.9, J2.16, J2.23, J2.30, J2.32, J2.35, J2.36, J3.3, J3.6, J4.3, J4.4, J4.9, J4.10, J4.13, J4.14, J4.17, J4.18, J4.27, J4.28, R2.2, R5.2, R7.2, R8.2, R17.2, R22.2, R32.2, R44.2, R52.2, R54.2, R66.2, R72.2, R85.2, R87.2, R89.2, U1.3 (+), U1.5 (+), U4.3 (+), U4.5 (+), U5.3 (+), U5.5 (+), U6.3 (+), U6.5 (+), U7.3 (+), U7.10 (+), U7.12 (+), U8.3 (+), U8.10 (+), U8.12 (+), U9.12 (+), U28.2 (EC+), U28.6 (GND), U29.2 (EC+), U29.6 (GND), U30.3 (+), U30.5 (+), U31.3 (+), U31.5 (+), U44.6 (ILIM), U44.9 (GND), U44.13 (GND), U45.6 (ILIM), U45.9 (GND), U46.5 (+)
BASE+: C6.1, Q40.3 (B), R3.2
BASE-: C10.2, Q41.3 (B), R6.2
BOUT_L: R18.1, R26.1, U3.1
BOUT_R: R23.1, R38.1, U3.7
BSUM_L: C21.2, R12.2, U1.1, U2.3 (+)
BSUM_R: C22.2, R14.2, U1.7, U2.5 (+)
BUS_IN_L: C21.1, J1.b1, R12.1, U1.2 (-)
BUS_IN_R: C22.1, J1.b2, R14.1, U1.6 (-)
CHASSIS: H1.1, H2.1, J1.a25, J1.a26, J3.7
CTRL_GND: C3.2, J1.a23, J1.a24, J1.c16, J1.c20, J1.c24, J1.c28, J2.34
CVP_F: C61.2, R84.2, R86.1, R88.1, U31.7
D1A: D10.2 (A), R53.2
DIR1_L: J4.19, R55.1
DIR1_R: J4.20, R56.1
DIR2_L: J4.21, R57.1
DIR2_R: J4.22, R58.1
DIR3_L: J4.23, R59.1
DIR3_R: J4.24, R60.1
DIR4_L: J4.25, R61.1
DIR4_R: J4.26, R62.1
DOUT: C49.1, R53.1, U9.7
ECF_L: R86.2, R87.1, U28.3 (EC-)
ECF_R: R89.1, R90.2, RV3.2, RV3.3, U29.3 (EC-)
FAD_L: C55.2, R67.2, R68.1, U30.1
FAD_R: C58.2, R73.2, R74.1, U30.7
G2_L: R28.2, R29.1, U5.7
G2_R: R40.2, R41.1, U6.7
GA_L: J2.2, R26.2
GA_R: J2.6, R38.2
GW_L: J2.3, U5.2 (-)
GW_R: J2.7, U6.2 (-)
HOLD: C49.2, C50.1, D10.1 (K), R54.1, U9.6 (-), U9.10 (+)
JRET_L: J3.4, R16.1
JRET_R: J3.5, R21.1
LT_F: R88.2, RV3.1
MET: J2.31, U9.8, U9.9 (-)
MG: R50.2, R51.2, R52.1, U9.3 (+)
MGB: U9.1, U9.2 (-), U9.5 (+)
NA_L: C35.1, J2.10, R29.2
NA_R: C43.1, J2.17, R41.2
NB_L: C35.2, C36.1, J2.11, U7.2 (-)
NB_R: C43.2, C44.1, J2.18, U8.2 (-)
NC_L: C36.2, J2.12, R30.1
NC_R: C44.2, J2.19, R42.1
NFB_L: R18.2, R19.2, U3.2 (-)
NFB_R: R23.2, R24.2, U3.6 (-)
NHA_L: C37.2, C38.1, R31.1
NHA_R: C45.2, C46.1, R43.1
NHB_L: C38.2, R32.1, U7.5 (+)
NHB_R: C46.2, R44.1, U8.5 (+)
NIF_L: C55.1, R67.1, U28.8 (OUT), U30.2 (-)
NIF_R: C58.1, R73.1, U29.8 (OUT), U30.6 (-)
NP_F: C61.1, R83.2, R84.1, U31.6 (-)
NREF5I: R10.2, R11.1, U46.6 (-)
NSH_L: R35.2, R36.2, R37.1, U7.13 (-)
NSH_R: R47.2, R48.2, R49.1, U8.13 (-)
NU9: U9.13 (-), U9.14
NVH_L: R33.2, R34.1, U7.9 (-)
NVH_R: R45.2, R46.1, U8.9 (-)
O2A_L: J2.4, R20.1, R27.1, U5.1
O2A_R: J2.8, R25.1, R39.1, U6.1
OF_F: R90.1, RV4.2
PDRV_L: R13.1, U2.1, U2.2 (-)
PDRV_R: R15.1, U2.6 (-), U2.7
POT_F: J2.29, R75.1, R76.1, R78.1, R80.1, R85.1
POT_R1: J2.25, J4.29
POT_R2: J2.26, J4.30
POT_R3: J2.27, J4.31
POT_R4: J2.28, J4.32
RAW+22: J1.a5, J1.a6
RAW+27: FB1.1, J1.a1, J1.a2
RAW-22: J1.a7, J1.a8
RAW-27: FB2.1, J1.a3, J1.a4
REF5K: C18.1, D5.1 (K), R9.2, U46.3 (+)
RET_OUT_L: J1.b16, R68.2
RET_OUT_R: J1.b17, R74.2
RIN_L: D8.1 (A1), R16.2, R17.1, U3.3 (+)
RIN_R: D9.1 (A1), R21.2, R22.1, U3.5 (+)
RRN_L: J4.15, R37.2, R50.1, R63.1, U7.14
RRN_R: J4.16, R49.2, R51.1, R69.1, U8.14
S1_OUT_L: J1.b4, R55.2
S1_OUT_R: J1.b5, R56.2
S2_OUT_L: J1.b7, R57.2
S2_OUT_R: J1.b8, R58.2
S3_OUT_L: J1.b10, R59.2
S3_OUT_R: J1.b11, R60.2
S4_OUT_L: J1.b13, R61.2
S4_OUT_R: J1.b14, R62.2
SEND_L: D6.1 (A1), J3.1, R13.2
SEND_R: D7.1 (A1), J3.2, R15.2
SETN: C15.2, R8.1, U45.8 (SET)
SETP: C12.1, R7.1, U44.8 (SET)
SH_F: R82.2, R83.1, U31.1
SINT_L: C27.1, R20.2, U4.2 (-)
SINT_R: C28.1, R25.2, U4.6 (-)
SJ_F: D11.1 (K), D12.1 (K), D13.1 (K), R75.2, R82.1, U31.2 (-)
SN1_F: D11.2 (A), R76.2, R77.1
SN2_F: D12.2 (A), R78.2, R79.1
SN3_F: D13.2 (A), R80.2, R81.1
SW_fl: R65.1, RV1.2
SW_fr: R71.1, RV2.2
SYM_fl: R65.2, R66.1, U28.4 (SYM)
SYM_fr: R71.2, R72.1, U29.4 (SYM)
V27F+: C1.1, D2.1 (K), FB1.2, U40.3 (VI)
V27F-: C2.2, D4.2 (A), FB2.2, U41.2 (VI)
VEE_fl: R64.1, U28.5 (V-)
VEE_fr: R70.1, U29.5 (V-)
VHN_L: J2.13, R34.2, U7.8
VHN_R: J2.20, R46.2, U8.8
VHP_L: J2.15, R31.2, R33.1, U7.6 (-), U7.7
VHP_R: J2.22, R43.2, R45.1, U8.6 (-), U8.7
VINT_L: C27.2, R19.1, U4.1
VINT_R: C28.2, R24.1, U4.7
VIN_fl: R63.2, U28.1 (IN)
VIN_fr: R69.2, U29.1 (IN)
VK2_L: R27.2, R28.1, U5.6 (-)
VK2_R: R39.2, R40.1, U6.6 (-)
VLO_L: C37.1, R30.2, R35.1, U7.1
VLO_R: C45.1, R42.2, R47.1, U8.1
VREG+: C5.1, D1.1 (K), D2.2 (A), Q40.2 (C), R1.1, R3.1, U40.2 (VO)
VREG-: C9.2, D3.2 (A), D4.1 (K), Q41.2 (C), R4.1, R6.1, U41.3 (VO)
WPH_L: J2.14, R36.1
WPH_R: J2.21, R48.1

Notes on the sheet:
BACKPLANE C96 (classe FX-RET, dec. 130)
ALIMENTAZIONE +-18 audio, +5, +-15 LN, +-5 riferimento
SOMMA DEL BUS (slot 1, Rf 10k, Cf 10p) e DRIVER DEL PEDALE
RITORNO: protezione, buffer JFET g=1, servo DC (ritorno-buffer-g1.cir)
GAIN T2 (pot doppio 10k lin sul cavo, dec. 162; x1,24 todo 220) e EQ2
METER del ritorno (mono centrato, g = 0,288; detector meter-det-03s.cir)
PONTE verso la scheda REROUTE (J4) e 10k verso i bus S1-S4
FADER (2 VCA, shaper del fader, dec. 126) e USCITA verso MSUM (slot 6)
CAVO SCHEDA COMANDI (J2) e JACK DEL PEDALE (J3)

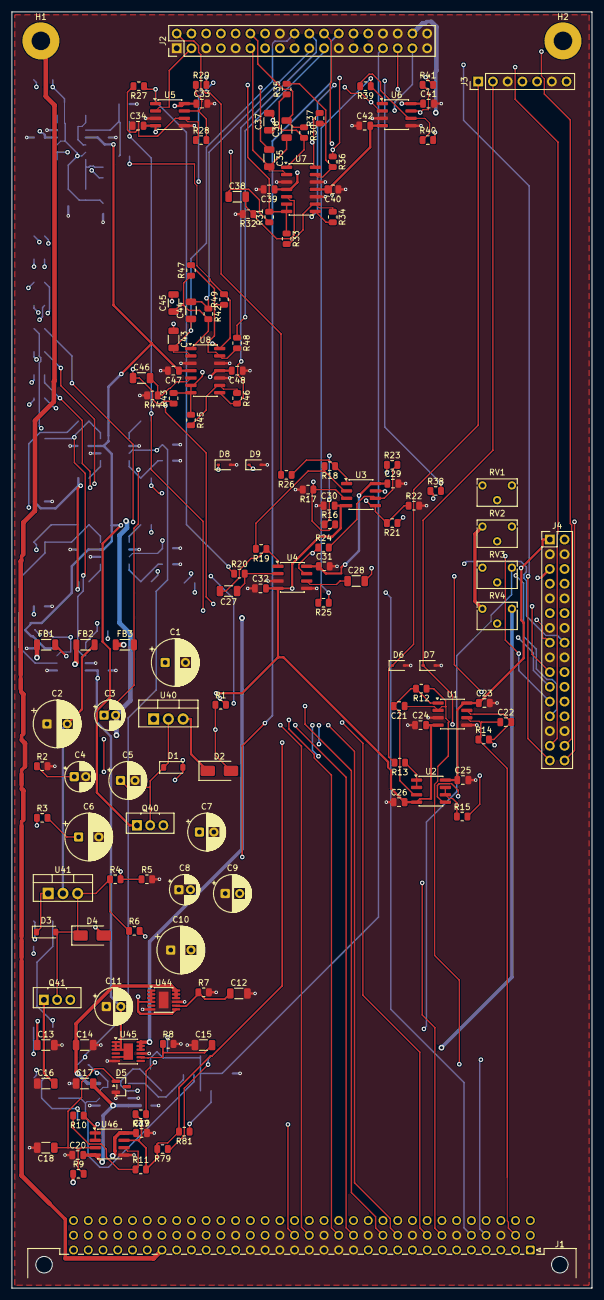
[picture p43: board fx-ret.kicad_pcb from above]

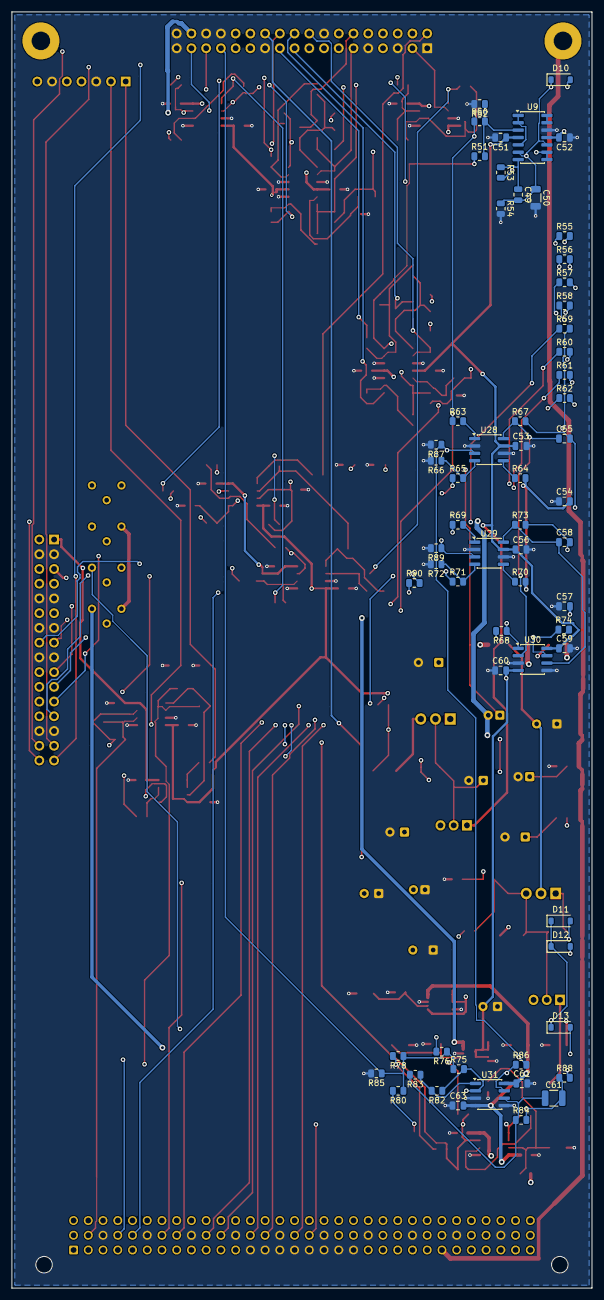
[picture p44: board fx-ret.kicad_pcb from below]

Board: 4 copper layers, 100.0 x 220.0 mm, 199 parts (62 on the bottom side), 134 nets.
