dj-filippo241/maelcum_mixer/pcb/cue/cue.kicad_pcb

## KiCad design pcb/cue/cue.kicad_pcb (2026-11-12)

Schematic: cue.kicad_sch, maelcum CUE / cuffie (sistema-cue v0.2) - bozza v0.1

Parts:
C1, C4: 220u 35V; CP_Radial_D8.0mm_P3.50mm
C2, C5: 10u 35V; CP_Radial_D5.0mm_P2.00mm
C3, C6: 1000u 25V; CP_Radial_D10.0mm_P5.00mm
C7, C12: 47u 35V; CP_Radial_D6.3mm_P2.50mm
C8, C11, C13, C16: 10u 25V; C_1206_3216Metric
C9, C10, C14, C15: 4u7 25V; C_1206_3216Metric
C17, C18, C21, C22: 10p C0G; C_0805_2012Metric
C19, C20, C23, C24, C25, C26, C27, C28, C31, C32, C33, C34, C37, C38, C40, C42: 100n; C_0805_2012Metric
C29, C35: 330p C0G; C_0805_2012Metric
C30, C36: 1u film; C_Rect_L7.2mm_W3.5mm_P5.00mm_FKS2_FKP2_MKS2_MKP2
C39: 47u 10V; CP_Radial_D5.0mm_P2.00mm
C41: 2u2 X7R; C_1206_3216Metric
D1, D3, D5: 1N4148W; D_SOD-123
D2, D4: S1G; D_SMA
D6, D7, D8: BAT54W; SOT-323_SC-70
FB1, FB2: ferrite 600R 2A; L_1206_3216Metric
FB3, FB4: ferrite 600R; L_1206_3216Metric
H1, H2: CHASSIS; MountingHole_3.2mm_M3_Pad
J1: C96 maschio; DIN41612_C_3x32_Male_Horizontal_THT
J2: 2x7 cavo piatto; PinHeader_2x07_P2.54mm_Vertical
J3: 2x3 cavo; PinHeader_2x03_P2.54mm_Vertical
K1, K2: G6K-2F DC5; Relay_DPDT_Omron_G6K-2F
Q1, Q6, Q8, Q13: BC847B; SOT-23
Q2, Q3, Q9, Q10: BF245B; TO-92_Inline_Wide
Q4, Q11: MJE340; TO-126-3_Vertical
Q5, Q12: MJE350; TO-126-3_Vertical
Q7, Q14: BC857B; SOT-23
Q15: AO3400A; SOT-23
R1, R3, R5, R8: 120 1%; R_0805_2012Metric
R2, R4: 1k62 1%; R_0805_2012Metric
R6, R9: 1k47 1%; R_0805_2012Metric
R7, R10: 150k 0.1%; R_0805_2012Metric
R11, R12, R13, R14, R15, R16, R17, R18, R19, R20: 10k 0.1%; R_0805_2012Metric
R21, R22, R23, R24: 20k 0.1%; R_0805_2012Metric
R25, R26, R27, R40: 1M; R_0805_2012Metric
R28, R41: 470 1%; R_0805_2012Metric
R29, R30, R31, R42, R43, R44: 1k 1%; R_0805_2012Metric
R32, R33, R45, R46: 22; R_0805_2012Metric
R34, R35, R47, R48: 6.8 1%; R_1206_3216Metric
R36, R37, R49, R50, R53: 100; R_0805_2012Metric
R38, R39, R51, R52: 10 2W; R_Axial_DIN0414_L11.9mm_D4.5mm_P15.24mm_Horizontal
R54: 0; R_1206_3216Metric
R55: 1k; R_0805_2012Metric
R56, R58: 160k 1%; R_0805_2012Metric
R57: 27k4 1%; R_0805_2012Metric
R59: 22k6 1%; R_0805_2012Metric
R60: 15k 1%; R_0805_2012Metric
R61, R62, R64: 10k 1%; R_0805_2012Metric
R63: 120k 1%; R_0805_2012Metric
R65: 140k 1%; R_0805_2012Metric
R66, R68: 10k; R_0805_2012Metric
R67: 1M2 1%; R_0805_2012Metric
RV1, RV2: 500; Potentiometer_Bourns_3266W_Vertical
U1, U2, U3, U4, U8: OPA1612AIDR; SOIC-8_3.9x4.9mm_P1.27mm
U5: TL431; SOT-23
U6, U7: LM339; SOIC-14_3.9x8.7mm_P1.27mm
U40: LM317; TO-220-3_Vertical
U41: LM337; TO-220-3_Vertical
U42: LM317; SOT-223-3_TabPin2
U43: LM337; SOT-223-3_TabPin2
U44: LT3045EMSE; MSOP-12-1EP_3x4.039mm_P0.65mm_EP1.651x2.845mm
U45: LT3094EMSE; MSOP-12-1EP_3x4.039mm_P0.65mm_EP1.651x2.845mm

Connections:
+5V: C39.1, C40.1, C42.1, D5.1 (K), J1.a21, J1.a22, K1.1, K2.1, R55.1, R66.2, R68.2, U6.3 (V+), U7.3 (V+)
+15LN: C11.1, C19.1, C23.1, C25.1, U1.8 (V+), U2.8 (V+), U3.8 (V+), U44.10 (OUTS), U44.11 (OUT), U44.12 (OUT)
+16V5: C8.1, C10.1, R5.1, U42.2 (VO), U44.1 (IN), U44.2 (IN), U44.3 (IN), U44.4 (EN/UV), U44.7 (PGFB)
+18V: C3.1, C27.1, C31.1, C33.1, C37.1, D1.1 (K), D2.2 (A), Q2.3 (D), Q4.2 (C), Q9.3 (D), Q11.2 (C), R1.1, U4.8 (V+), U8.8 (V+), U40.2 (VO)
-15LN: C16.2, C20.2, C24.2, C26.2, U1.4 (V-), U2.4 (V-), U3.4 (V-), U45.10 (OUTS), U45.11 (OUT), U45.12 (OUT)
-16V5: C13.2, C15.2, R8.1, U43.3 (VO), U45.1 (IN), U45.2 (IN), U45.3 (EN/UV), U45.5 (PGFB), U45.13 (IN)
-18V: C6.2, C28.2, C32.2, C34.2, C38.2, D3.2 (A), D4.1 (K), Q3.1 (G), Q3.2 (S), Q5.2 (C), Q10.1 (G), Q10.2 (S), Q12.2 (C), R3.1, U4.4 (V-), U8.4 (V-), U41.3 (VO)
ADJ16+: R5.2, R6.1, U42.1 (ADJ)
ADJ16-: R8.2, R9.1, U43.1 (ADJ)
ADJ18+: C2.1, D1.2 (A), R1.2, R2.1, U40.1 (ADJ)
ADJ18-: C5.2, D3.1 (K), R3.2, R4.1, U41.1 (ADJ)
AGND: C1.2, C2.2, C3.2, C4.1, C5.1, C6.1, C7.2, C8.2, C9.2, C10.2, C11.2, C12.1, C13.1, C14.1, C15.1, C16.1, C19.2, C20.1, C23.2, C24.1, C25.2, C26.1, C27.2, C28.1, C31.2, C32.1, C33.2, C34.1, C37.2, C38.1, J1.a13, J1.a14, J1.a15, J1.a16, J1.a17, J1.a18, J1.a19, J1.a20, J1.b3, J1.b6, J1.b9, J1.b12, J1.b15, J2.2, J2.6, J2.9, J2.13, R2.2, R4.2, R6.2, R7.2, R9.2, R10.2, R25.2, R26.2, R27.2, R40.2, R54.2, U1.3 (+), U1.5 (+), U2.3 (+), U2.5 (+), U4.5 (+), U8.5 (+), U44.6 (ILIM), U44.9 (GND), U44.13 (GND), U45.6 (ILIM), U45.9 (GND)
BLB_L: J2.5, U3.1, U3.2 (-)
BLB_R: J2.12, U3.6 (-), U3.7
BLN_L: Q6.1 (B), R36.2
BLN_R: Q13.1 (B), R49.2
BLP_L: Q7.1 (B), R37.2
BLP_R: Q14.1 (B), R50.2
BL_L: J2.4, R25.1, U3.3 (+)
BL_R: J2.11, R26.1, U3.5 (+)
BN_L: Q4.3 (B), R32.2
BN_R: Q11.3 (B), R45.2
BP_L: Q5.3 (B), R33.2
BP_R: Q12.3 (B), R46.2
CHASSIS: H1.1, H2.1, J1.a25, J1.a26
CS_L: C17.2, J2.1, R15.2, U1.1
CS_R: C18.2, J2.8, R20.2, U1.7
CT: C41.1, D8.1 (A), R67.2, U7.9 (+)
CTRL_GND: C39.2, C40.2, C41.2, C42.2, D6.1 (A), D7.1 (A), J1.a23, J1.a24, J1.c16, J1.c20, J1.c24, J1.c28, Q15.2 (S), R57.2, R59.2, R61.2, U5.3 (A), U6.12 (V-), U7.5 (+), U7.7 (+), U7.11 (+), U7.12 (V-)
CUE1_L: J1.b1, R11.1
CUE1_R: J1.b2, R16.1
CUE2_L: J1.b4, R12.1
CUE2_R: J1.b5, R17.1
CUE3_L: J1.b7, R13.1
CUE3_R: J1.b8, R18.1
CUE4_L: J1.b10, R14.1
CUE4_R: J1.b11, R19.1
D22: R56.2, R57.1, U6.7 (+)
D27: R58.2, R59.1, U6.5 (+)
EN_L: Q4.1 (E), R34.1, R36.1
EN_R: Q11.1 (E), R47.1, R49.1
EP_L: Q5.1 (E), R35.1, R37.1
EP_R: Q12.1 (E), R48.1, R50.1
FB_L: C29.2, R28.2, U4.2 (-)
FB_R: C35.2, R41.2, U8.2 (-)
HP1_R: J3.3, K1.5
HP1_T: J3.1, K1.4
HP2_R: J3.6, K2.5
HP2_T: J3.4, K2.4
HPG: J3.2, J3.5, R54.1
KD: D5.2 (A), K1.8, K2.8, Q15.3 (D)
KG: Q15.1 (G), R53.2
KG0: R53.1, R68.1, U7.14
LV_L: J2.7, R27.1, U4.3 (+)
LV_R: J2.14, R40.1, U8.3 (+)
MB_L: C21.2, J2.3, R22.2, U2.1
MB_R: C22.2, J2.10, R24.2, U2.7
MON_L: J1.b13, R21.1
MON_R: J1.b14, R23.1
N22: D6.3 (K), R62.2, R63.1, U6.8 (-)
N27: D7.3 (K), R64.2, R65.1, U6.10 (-)
NB_L: C30.2, Q1.2 (E), Q3.3 (D), Q7.3 (C), R29.2, R31.2, R33.1
NB_R: C36.2, Q8.2 (E), Q10.3 (D), Q14.3 (C), R42.2, R44.2, R46.1
NMB_L: C21.1, R21.2, R22.1, U2.2 (-)
NMB_R: C22.1, R23.2, R24.1, U2.6 (-)
NS_L: C17.1, R11.2, R12.2, R13.2, R14.2, R15.1, U1.2 (-)
NS_R: C18.1, R16.2, R17.2, R18.2, R19.2, R20.1, U1.6 (-)
NU_L: U4.6 (-), U4.7
NU_R: U8.6 (-), U8.7
OUTA_L: Q6.2 (E), Q7.2 (E), R28.1, R34.2, R35.2, R38.1, R39.1
OUTA_R: Q13.2 (E), Q14.2 (E), R41.1, R47.2, R48.2, R51.1, R52.1
PB_L: C30.1, Q1.3 (C), Q2.1 (G), Q2.2 (S), Q6.3 (C), R30.1, R32.1
PB_R: C36.1, Q8.3 (C), Q9.1 (G), Q9.2 (S), Q13.3 (C), R43.1, R45.1
RAW+22: FB3.1, J1.a5, J1.a6, R56.1
RAW+27: FB1.1, J1.a1, J1.a2, R58.1
RAW-22: FB4.1, J1.a7, J1.a8, R63.2
RAW-27: FB2.1, J1.a3, J1.a4, R65.2
ROK: D8.3 (K), R66.1, R67.1, U6.1, U6.2, U6.13, U6.14
RS1_L: K1.3, R38.2
RS1_R: K1.6, R51.2
RS2_L: K2.3, R39.2
RS2_R: K2.6, R52.2
RT_L: R30.2, RV1.1
RT_R: R43.2, RV2.1
SETN: C14.2, R10.1, U45.8 (SET)
SETP: C9.1, R7.1, U44.8 (SET)
TAP_L: Q1.1 (B), R31.1, RV1.2, RV1.3
TAP_R: Q8.1 (B), R44.1, RV2.2, RV2.3
THN: R60.2, R61.1, U6.9 (+), U6.11 (+)
UO_L: C29.1, R29.1, U4.1
UO_R: C35.1, R42.1, U8.1
V22F+: C7.1, FB3.2, U42.3 (VI)
V22F-: C12.2, FB4.2, U43.2 (VI)
V27F+: C1.1, D2.1 (K), FB1.2, U40.3 (VI)
V27F-: C4.2, D4.2 (A), FB2.2, U41.2 (VI)
VREF: R55.2, R60.1, R62.1, R64.1, U5.1 (K), U5.2 (REF), U6.4 (-), U6.6 (-), U7.4 (-), U7.6 (-), U7.8 (-), U7.10 (-)

Notes on the sheet:
BACKPLANE C96 (classe CUE: slot 1-4 = CUE1-4 in, slot 5 = MON in)
ALIMENTAZIONE +18 audio (LM317 dal raw +27, bulk 1000 uF)
ALIMENTAZIONE -18 audio (LM337 dal raw -27, bulk 1000 uF)
ALIMENTAZIONE +15 LN (LM317 a +16,5 dal raw +22, poi LT3045)
ALIMENTAZIONE -15 LN (LM337 a -16,5 dal raw -22, poi LT3094)
[A] CUE SUMMING L/R (massa virtuale, Rf 10k, -1) e [B] MON (invertente 20k/20k, F4)
[C2] buffer fra BLEND e LEVEL (NOTA: tiene la law del blend esatta)
[E] AMPLI CUFFIA L (OPA1612 + diamond MJE340/350, v0.2)
[F] RSERIE L (10 ohm 2 W, una per jack)
[E] AMPLI CUFFIA R (OPA1612 + diamond MJE340/350, v0.2)
[F] RSERIE R (10 ohm 2 W, una per jack)
[F] RELE' delle cuffie (G6K-2F, 5 V, 237 ohm; eccitati = suono; failsafe)
[G] PROTEZIONE: finestre sui raw +-22 e +-27, timer 1,8 s (il CUE non ascolta c9)
CAVI verso la scheda comandi: J2 pot, J3 cuffie

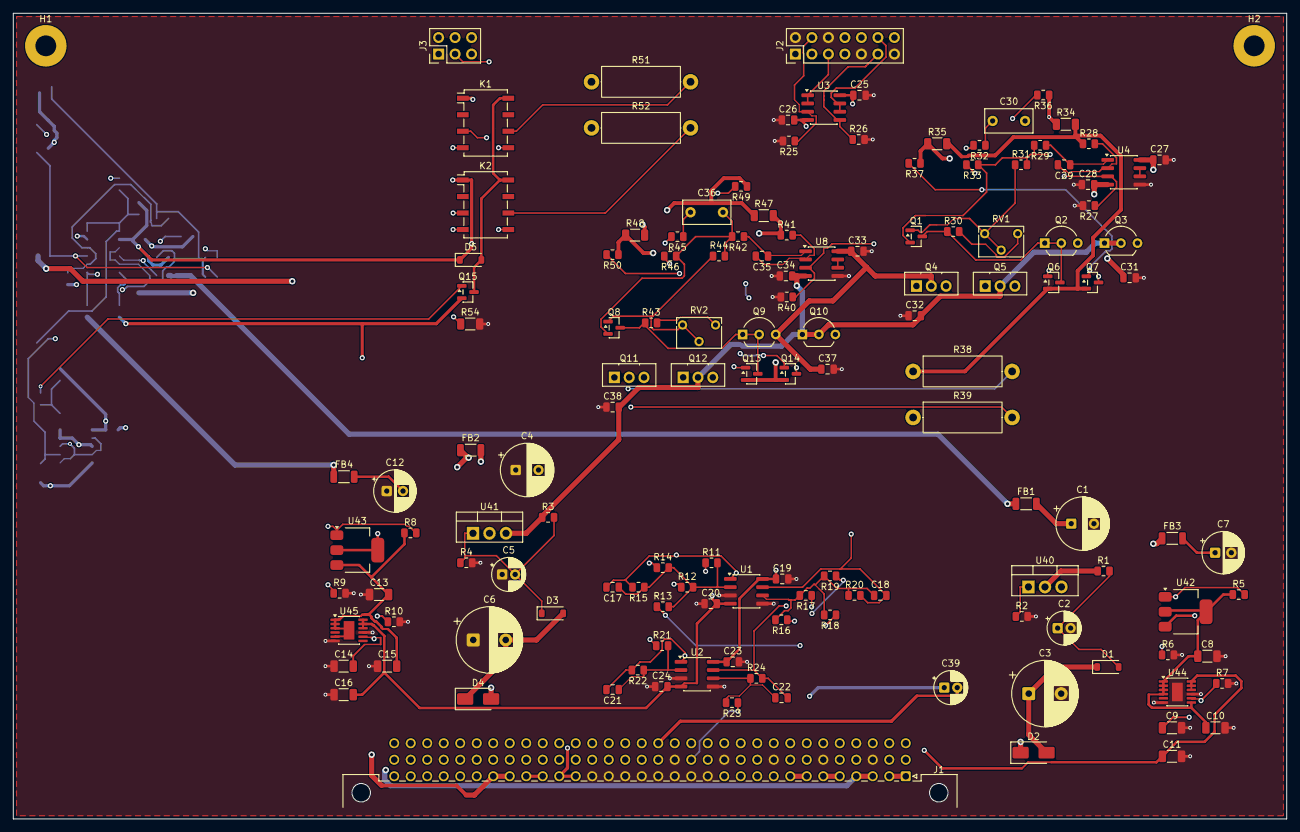
[picture p45: board cue.kicad_pcb from above]

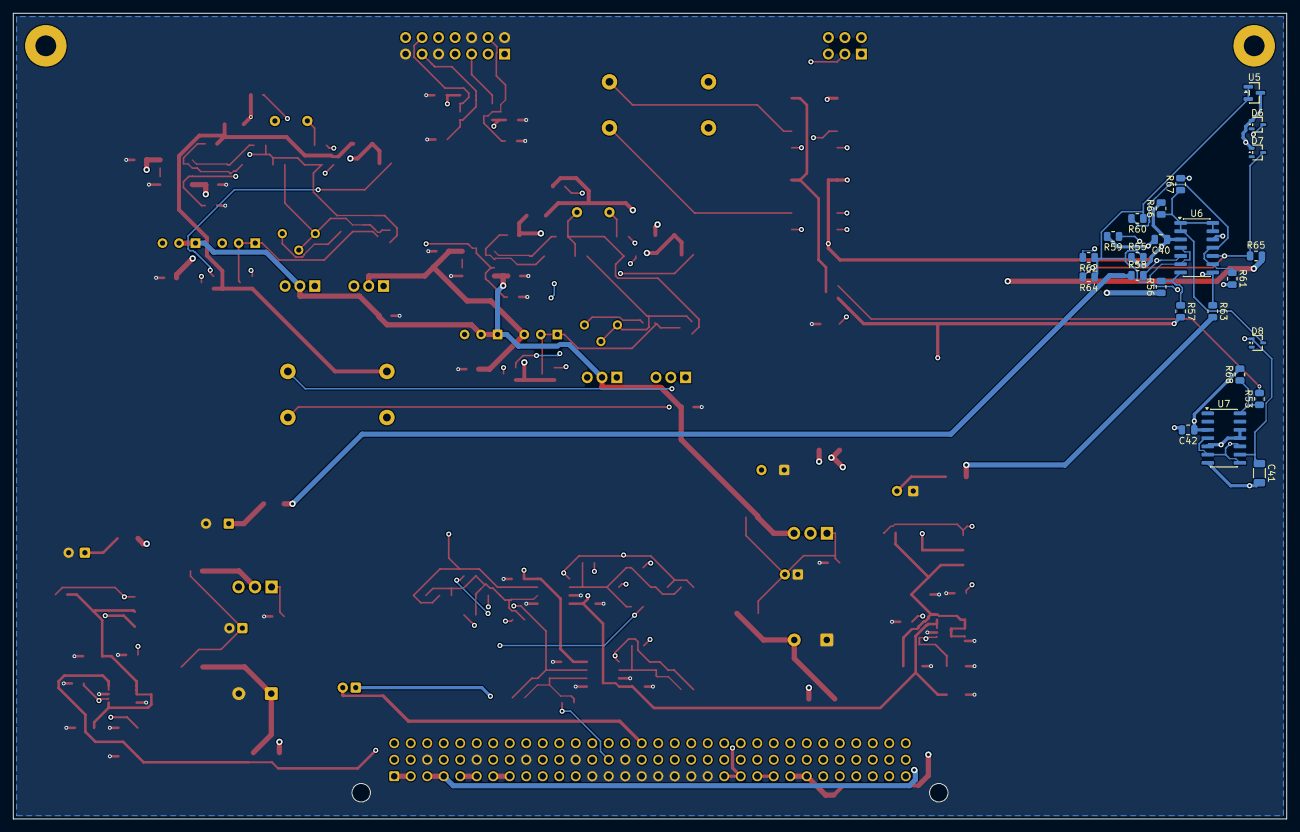
[picture p46: board cue.kicad_pcb from below]

Board: 4 copper layers, 196.0 x 124.0 mm, 160 parts (24 on the bottom side), 96 nets.
