dj-filippo241/maelcum_mixer/pcb/master/segnale/master-segnale.kicad_pcb

## KiCad design pcb/master/segnale/master-segnale.kicad_pcb (2026-11-12)

Schematic: master-segnale.kicad_sch, maelcum MASTER scheda di segnale (dec. 140) - bozza v0.1

Parts:
C1, C2: 220u 35V; CP_Radial_D8.0mm_P3.50mm
C3, C7: 10u 35V; CP_Radial_D5.0mm_P2.00mm
C4, C8: 47u 35V; CP_Radial_D6.3mm_P2.50mm
C5, C9: 470u 25V; CP_Radial_D8.0mm_P3.50mm
C6, C10: 100u 25V; CP_Radial_D6.3mm_P2.50mm
C11, C12, C14, C15: 4u7 25V; C_1206_3216Metric
C13, C16: 10u 25V; C_1206_3216Metric
C17: 1u; C_1206_3216Metric
C18, C19, C20, C21, C25, C26, C27, C28, C30, C31, C33, C34, C35, C36, C37, C38, C39, C40, C41, C42, C43, C44, C45, C46, C47, C48, C49, C50, C53, C54, C55, C56, C57, C58, C59, C60, C63, C64, C65, C66, C67, C68, C71, C72, C73, C74, C77, C78, C79, C80, C81, C82: 100n; C_0805_2012Metric
C22, C23: 10p C0G; C_0805_2012Metric
C24, C69, C75: 47p C0G; C_0805_2012Metric
C29, C51, C52, C61, C62: 22p C0G; C_0805_2012Metric
C32: 100n C0G; C_0805_2012Metric
C70, C76: 100n C0G; C_1206_3216Metric
D1, D3, D6, D7, D8, D9, D10, D11, D12, D13, D14: 1N4148W; D_SOD-123
D2, D4: S1G; D_SMA
D5: LM4040-5.0; SOT-23
FB1, FB2: ferrite 600R; L_1206_3216Metric
H1, H2: CHASSIS; MountingHole_3.2mm_M3_Pad
J1: C96 maschio; DIN41612_C_3x32_Male_Horizontal_THT
J2: 2x7 cavo piatto; PinHeader_2x07_P2.54mm_Vertical
J3: 2x10 cavo piatto; PinHeader_2x10_P2.54mm_Vertical
JP1, JP4: 0 dB; SolderJumper-2_P1.3mm_Bridged_RoundedPad1.0x1.5mm
JP2, JP5: -10 dB; SolderJumper-2_P1.3mm_Open_RoundedPad1.0x1.5mm
JP3, JP6: -20 dB; SolderJumper-2_P1.3mm_Open_RoundedPad1.0x1.5mm
Q40: BD139; TO-126-3_Vertical
Q41: BD140; TO-126-3_Vertical
R1, R4: 120 1%; R_0805_2012Metric
R2, R5: 1k72 1%; R_0805_2012Metric
R3, R6, R126, R130: 1k; R_0805_2012Metric
R7, R8: 150k 0.1%; R_0805_2012Metric
R9: 1k5; R_0805_2012Metric
R10, R11, R30, R32, R34, R87, R113, R124, R128, R132, R134: 10k 0.1%; R_0805_2012Metric
R12, R13, R14, R15, R16, R19, R20, R21, R22, R23, R24, R27, R28, R29, R31, R33, R35, R39, R40, R41, R42, R43, R44, R45, R46, R67, R71, R75, R76, R96, R100, R104, R105: 20k 0.1%; R_0805_2012Metric
R17, R18, R25, R26: 0; R_0805_2012Metric
R36, R68, R72, R97, R101: 6k19; R_0805_2012Metric
R37, R69, R73, R98, R102: 150k; R_0805_2012Metric
R38, R70, R74, R99, R103: 51; R_0805_2012Metric
R47, R48: 10k; R_0805_2012Metric
R49: 10k2 0.1%; R_0805_2012Metric
R50: 7k5 0.1%; R_0805_2012Metric
R51, R91, R117: 18k2 0.1%; R_0805_2012Metric
R52, R92, R94, R118, R120: 1k 0.1%; R_0805_2012Metric
R53, R54, R63, R64, R65, R66, R122, R123: 47; R_0805_2012Metric
R55, R56, R90, R116: 100k; R_0805_2012Metric
R57, R60: 6k81 0.1%; R_0805_2012Metric
R58, R61: 3k16 0.1%; R_0805_2012Metric
R59, R62: 757 0.1%; R_0805_2012Metric
R77, R107: 68.1k 0.1%; R_0805_2012Metric
R78: 137k 0.1%; R_0805_2012Metric
R79: 1.91k 0.1%; R_0805_2012Metric
R80, R84: 2.43k 0.1%; R_0805_2012Metric
R81: 16.9k 0.1%; R_0805_2012Metric
R82, R110: 38.3k 0.1%; R_0805_2012Metric
R83: 1.82k 0.1%; R_0805_2012Metric
R85: 1.96k 0.1%; R_0805_2012Metric
R86: 2.61k 0.1%; R_0805_2012Metric
R88, R114: 9k76 0.1%; R_0805_2012Metric
R89, R115: 18k7 0.1%; R_0805_2012Metric
R93, R119: 17k4 0.1%; R_0805_2012Metric
R95, R121: 2M7; R_0805_2012Metric
R106: 43.2k 0.1%; R_0805_2012Metric
R108: 357k 0.1%; R_0805_2012Metric
R109: 20.0k 0.1%; R_0805_2012Metric
R111: 976 0.1%; R_0805_2012Metric
R112: 1.33k 0.1%; R_0805_2012Metric
R125, R129: 4k02 0.1%; R_0805_2012Metric
R127, R131: 3M; R_0805_2012Metric
R133: 5k 0.1%; R_0805_2012Metric
R135: 4k64 0.1%; R_0805_2012Metric
RV1, RV2, RV3, RV5, RV6, RV7, RV9: 50k; Potentiometer_Bourns_3266W_Vertical
RV4, RV8: 2k; Potentiometer_Bourns_3266W_Vertical
U1, U2, U3, U4, U5, U6, U7, U8, U10, U11, U14, U15, U16, U19, U20, U21, U22, U23, U24, U25, U30: OPA1612AIDR; SOIC-8_3.9x4.9mm_P1.27mm
U9, U12, U13, U17, U18: V2181L; SOIC-8_3.9x4.9mm_P1.27mm
U40: LM317; TO-220-3_Vertical
U41: LM337; TO-220-3_Vertical
U42: LT3045EMSE; MSOP-12-1EP_3x4.039mm_P0.65mm_EP1.651x2.845mm
U43: LT3094EMSE; MSOP-12-1EP_3x4.039mm_P0.65mm_EP1.651x2.845mm

Connections:
+15LN: C13.1, C18.1, C20.1, C25.1, C30.1, C33.1, C35.1, C37.1, C43.1, C45.1, C55.1, C65.1, C71.1, C73.1, C77.1, C79.1, C81.1, R9.1, R132.1, RV1.1, RV2.1, RV3.1, RV5.1, RV6.1, RV7.1, RV9.1, U1.8 (V+), U2.8 (V+), U3.8 (V+), U4.8 (V+), U5.8 (V+), U6.8 (V+), U10.8 (V+), U11.8 (V+), U15.8 (V+), U16.8 (V+), U21.8 (V+), U22.8 (V+), U23.8 (V+), U24.8 (V+), U25.8 (V+), U30.8 (V+), U42.10 (OUTS), U42.11 (OUT), U42.12 (OUT)
+18V: C6.1, C12.1, C27.1, C39.1, C41.1, C47.1, C49.1, C53.1, C57.1, C59.1, C63.1, C67.1, Q40.1 (E), U7.8 (V+), U8.8 (V+), U9.7 (V+), U12.7 (V+), U13.7 (V+), U14.8 (V+), U17.7 (V+), U18.7 (V+), U19.8 (V+), U20.8 (V+), U42.1 (IN), U42.2 (IN), U42.3 (IN), U42.4 (EN/UV), U42.7 (PGFB)
+REF5: J3.5, R10.1, U30.1, U30.2 (-)
-15LN: C16.2, C19.2, C21.2, C26.2, C31.2, C34.2, C36.2, C38.2, C44.2, C46.2, C56.2, C66.2, C72.2, C74.2, C78.2, C80.2, C82.2, RV1.3, RV2.3, RV3.3, RV5.3, RV6.3, RV7.3, RV9.3, U1.4 (V-), U2.4 (V-), U3.4 (V-), U4.4 (V-), U5.4 (V-), U6.4 (V-), U10.4 (V-), U11.4 (V-), U15.4 (V-), U16.4 (V-), U21.4 (V-), U22.4 (V-), U23.4 (V-), U24.4 (V-), U25.4 (V-), U30.4 (V-), U43.10 (OUTS), U43.11 (OUT), U43.12 (OUT)
-18V: C10.2, C15.2, C28.2, C40.2, C42.2, C48.2, C50.2, C54.2, C58.2, C60.2, C64.2, C68.2, Q41.1 (E), R36.2, R68.2, R72.2, R97.2, R101.2, U7.4 (V-), U8.4 (V-), U14.4 (V-), U19.4 (V-), U20.4 (V-), U43.1 (IN), U43.2 (IN), U43.3 (EN/UV), U43.5 (PGFB), U43.13 (IN)
-REF5: R11.2, R78.1, R80.2, R82.2, R84.2, R86.2, R108.2, R110.2, R112.2, U30.7
ADJ+: C3.1, D1.2 (A), R1.2, R2.1, U40.1 (ADJ)
ADJ-: C7.2, D3.1 (K), R4.2, R5.1, U41.1 (ADJ)
AGND: C1.2, C2.1, C3.2, C4.2, C5.2, C6.2, C7.1, C8.1, C9.1, C10.1, C11.2, C12.2, C13.2, C14.1, C15.1, C16.1, C17.2, C18.2, C19.1, C20.2, C21.1, C25.2, C26.1, C27.2, C28.1, C30.2, C31.1, C32.2, C33.2, C34.1, C35.2, C36.1, C37.2, C38.1, C39.2, C40.1, C41.2, C42.1, C43.2, C44.1, C45.2, C46.1, C47.2, C48.1, C49.2, C50.1, C53.2, C54.1, C55.2, C56.1, C57.2, C58.1, C59.2, C60.1, C63.2, C64.1, C65.2, C66.1, C67.2, C68.1, C70.2, C71.2, C72.1, C73.2, C74.1, C76.2, C77.2, C78.1, C79.2, C80.1, C81.2, C82.1, D5.2 (A), J1.a13, J1.a14, J1.a15, J1.a16, J1.a17, J1.a18, J1.a19, J1.a20, J1.b3, J1.b6, J1.b9, J1.b12, J1.b15, J1.b18, J1.b21, J1.b24, J1.b27, J1.b30, J2.1, J2.3, J2.5, J2.7, J2.9, J2.11, J3.2, J3.4, J3.6, J3.8, J3.10, J3.12, JP2.2 (B), JP3.2 (B), JP5.2 (B), JP6.2 (B), R2.2, R5.2, R7.2, R8.2, R32.2, R38.2, R44.2, R47.2, R50.2, R52.2, R55.2, R56.2, R70.2, R74.2, R90.2, R92.2, R94.2, R99.2, R103.2, R116.2, R118.2, R120.2, R125.2, R127.2, R129.2, R131.2, R133.2, R135.2, U1.3 (+), U1.5 (+), U2.3 (+), U3.3 (+), U3.5 (+), U9.2 (EC+), U9.6 (GND), U12.2 (EC+), U12.6 (GND), U13.2 (EC+), U13.6 (GND), U14.3 (+), U14.5 (+), U15.3 (+), U15.5 (+), U16.3 (+), U16.5 (+), U17.2 (EC+), U17.6 (GND), U18.2 (EC+), U18.6 (GND), U19.3 (+), U19.5 (+), U22.5 (+), U24.5 (+), U30.5 (+), U42.6 (ILIM), U42.9 (GND), U42.13 (GND), U43.6 (ILIM), U43.9 (GND)
BASE+: C5.1, Q40.3 (B), R3.2
BASE-: C9.2, Q41.3 (B), R6.2
BA_L: R67.1, U7.1, U7.2 (-)
BA_R: R71.1, U7.6 (-), U7.7
BB_L: R96.1, U8.1, U8.2 (-)
BB_R: R100.1, U8.6 (-), U8.7
BOOTH_L: C61.2, J2.6, R104.2, U19.1
BOOTH_R: C62.2, J2.8, R105.2, U19.7
CHASSIS: H1.1, H2.1, J1.a25, J1.a26
CLIP_L: J2.13, J3.15
CLIP_R: J2.14, J3.16
CTRL_GND: J1.c16, J1.c20, J1.c24, J1.c28
CVP_B: R115.2, R117.1, R119.1, U16.7
CVP_M: R89.2, R91.1, R93.1, U15.7
D1A_L: D13.2 (A), R126.2
D1A_R: D14.2 (A), R130.2
DOUT_L: C69.1, R126.1, U21.7
DOUT_R: C75.1, R130.1, U23.7
DRVREC_L: R63.1, U10.1, U10.2 (-)
DRVREC_R: R64.1, U10.6 (-), U10.7
ECM_BL: R117.2, R118.1, U17.3 (EC-)
ECM_BR: R120.1, R121.2, RV8.2, RV8.3, U18.3 (EC-)
ECM_ML: R91.2, R92.1, U12.3 (EC-)
ECM_MONO: R51.2, R52.1, U9.3 (EC-)
ECM_MR: R94.1, R95.2, RV4.2, RV4.3, U13.3 (EC-)
HOLD_L: C69.2, C70.1, D13.1 (K), R127.1, U21.6 (-), U22.3 (+)
HOLD_R: C75.2, C76.1, D14.1 (K), R131.1, U23.6 (-), U24.3 (+)
INS_RET_L: J1.b28, R55.1, U6.3 (+)
INS_RET_R: J1.b29, R56.1, U6.5 (+)
INS_SEND_L: J1.b25, R53.2
INS_SEND_R: J1.b26, R54.2
ISD_L: R53.1, U5.1, U5.2 (-)
ISD_R: R54.1, U5.6 (-), U5.7
LO_L: R46.2, U4.1, U5.3 (+)
LO_R: R42.2, U3.7, U5.5 (+)
LT_B: R119.2, RV8.1
LT_M: R93.2, RV4.1
MAST_L: C51.2, J2.2, R75.2, R124.1, U14.1, U20.3 (+)
MAST_R: C52.2, J2.4, R76.2, R128.1, U14.7, U20.5 (+)
MBUF: R49.2, R51.1, U4.7
MET_L: J3.9, U22.1, U22.2 (-)
MET_R: J3.11, U24.1, U24.2 (-)
MFB: R49.1, R50.1, U4.6 (-)
MGB_L: U21.1, U21.2 (-), U21.5 (+)
MGB_R: U23.1, U23.2 (-), U23.5 (+)
MG_L: R124.2, R125.1, U21.3 (+)
MG_R: R128.2, R129.1, U23.3 (+)
MID: C24.2, R30.2, R40.1, R45.1, U2.1
MONB_L: R65.1, U11.1, U11.2 (-)
MONB_R: R66.1, U11.6 (-), U11.7
MONO_SW: J3.7, R47.1, R48.1
MON_OUT_L: J1.b22, R65.2
MON_OUT_R: J1.b23, R66.2
MRC: C32.1, R48.2, U4.5 (+)
MSUM1_L: J1.b1, R12.1
MSUM1_R: J1.b2, R20.1
MSUM2_L: J1.b4, R13.1
MSUM2_R: J1.b5, R21.1
MSUM3_L: J1.b7, R14.1
MSUM3_R: J1.b8, R22.1
MSUM4_L: J1.b10, R15.1
MSUM4_R: J1.b11, R23.1
MSUM5_L: J1.b13, R16.1
MSUM5_R: J1.b14, R24.1
MSUM6_L: J1.b16, R17.1
MSUM6_R: J1.b17, R25.1
MSUM7_L: J1.b19, R18.1
MSUM7_R: J1.b20, R26.1
NIB_L: C61.1, R104.1, U17.8 (OUT), U19.2 (-)
NIB_R: C62.1, R105.1, U18.8 (OUT), U19.6 (-)
NIM_L: C51.1, R75.1, U12.8 (OUT), U14.2 (-)
NIM_R: C52.1, R76.1, U13.8 (OUT), U14.6 (-)
NLO: R40.2, R41.2, R42.1, U3.6 (-)
NM: C24.1, R28.2, R29.2, R30.1, U2.2 (-)
NP_B: R114.2, R115.1, U16.6 (-)
NP_M: R88.2, R89.1, U15.6 (-)
NREF5I: R10.2, R11.1, U30.6 (-)
NSV: C29.1, R39.1, U3.2 (-), U9.8 (OUT)
NS_L: C22.1, R12.2, R13.2, R14.2, R15.2, R16.2, R17.2, R18.2, R19.1, U1.2 (-)
NS_R: C23.1, R20.2, R21.2, R22.2, R23.2, R24.2, R25.2, R26.2, R27.1, U1.6 (-)
NU_L: U22.6 (-), U22.7
NU_R: U24.6 (-), U24.7
OF_B: R121.1, RV9.2
OF_M: R95.1, RV5.2
P10_L: JP2.1 (A), R58.2
P10_R: JP5.1 (A), R61.2
P20_L: JP3.1 (A), R59.2
P20_R: JP6.1 (A), R62.2
PAD_L: JP1.2 (B), R57.2, R58.1, R59.1, U10.3 (+)
PAD_R: JP4.2 (B), R60.2, R61.1, R62.1, U10.5 (+)
POT_B: J3.3, R106.1, R107.1, R109.1, R111.1, R116.1
POT_M: J3.1, R77.1, R79.1, R81.1, R83.1, R85.1, R90.1
PROG_L: JP1.1 (A), R57.1, U6.1, U6.2 (-), U7.3 (+), U8.3 (+), U11.3 (+)
PROG_R: JP4.1 (A), R60.1, U6.6 (-), U6.7, U7.5 (+), U8.5 (+), U11.5 (+)
RAW+27: FB1.1, J1.a1, J1.a2
RAW-27: FB2.1, J1.a3, J1.a4
RDN: R45.2, R46.1, U4.2 (-)
RDP: R43.2, R44.1, U4.3 (+)
REC_L: J2.10, R63.2
REC_R: J2.12, R64.2
REF5K: C17.1, D5.1 (K), R9.2, U30.3 (+)
SDN: R33.2, R34.1, U2.6 (-)
SDP: R31.2, R32.1, U2.5 (+)
SETN: C14.2, R8.1, U43.8 (SET)
SETP: C11.1, R7.1, U42.8 (SET)
SH_B: R113.2, R114.1, U16.1
SH_M: R87.2, R88.1, U15.1
SIDE: R34.2, R35.1, U2.7
SJ_B: D10.1 (K), D11.1 (K), D12.1 (K), R106.2, R113.1, U16.2 (-)
SJ_M: D6.1 (K), D7.1 (K), D8.1 (K), D9.1 (K), R77.2, R78.2, R87.1, U15.2 (-)
SN1_B: D10.2 (A), R107.2, R108.1
SN1_M: D6.2 (A), R79.2, R80.1
SN2_B: D11.2 (A), R109.2, R110.1
SN2_M: D7.2 (A), R81.2, R82.1
SN3_B: D12.2 (A), R111.2, R112.1
SN3_M: D8.2 (A), R83.2, R84.1
SN4_M: D9.2 (A), R85.2, R86.1
SUM_L: C22.2, R19.2, R28.1, R31.1, U1.1
SUM_R: C23.2, R27.2, R29.1, R33.1, U1.7
SV: C29.2, R39.2, R41.1, R43.1, U3.1
SW_u9: R37.1, RV1.2
SW_u12: R69.1, RV2.2
SW_u13: R73.1, RV3.2
SW_u17: R98.1, RV6.2
SW_u18: R102.1, RV7.2
SYM_u9: R37.2, R38.1, U9.4 (SYM)
SYM_u12: R69.2, R70.1, U12.4 (SYM)
SYM_u13: R73.2, R74.1, U13.4 (SYM)
SYM_u17: R98.2, R99.1, U17.4 (SYM)
SYM_u18: R102.2, R103.1, U18.4 (SYM)
V27F+: C1.1, D2.1 (K), FB1.2, U40.3 (VI)
V27F-: C2.2, D4.2 (A), FB2.2, U41.2 (VI)
VEE_u9: R36.1, U9.5 (V-)
VEE_u12: R68.1, U12.5 (V-)
VEE_u13: R72.1, U13.5 (V-)
VEE_u17: R97.1, U17.5 (V-)
VEE_u18: R101.1, U18.5 (V-)
VIE_TAP_L: J1.b31, R122.2
VIE_TAP_R: J1.b32, R123.2
VIN_u9: R35.2, U9.1 (IN)
VIN_u12: R67.2, U12.1 (IN)
VIN_u13: R71.2, U13.1 (IN)
VIN_u17: R96.2, U17.1 (IN)
VIN_u18: R100.2, U18.1 (IN)
VRA0: R132.2, R133.1, U25.3 (+)
VRB0: R134.2, R135.1, U25.5 (+)
VREFA: J3.13, R134.1, U25.1, U25.2 (-)
VREFB: J3.14, U25.6 (-), U25.7
VREG+: C4.1, D1.1 (K), D2.2 (A), Q40.2 (C), R1.1, R3.1, U40.2 (VO)
VREG-: C8.2, D3.2 (A), D4.1 (K), Q41.2 (C), R4.1, R6.1, U41.3 (VO)
VTD_L: R122.1, U20.1, U20.2 (-)
VTD_R: R123.1, U20.6 (-), U20.7

Notes on the sheet:
BACKPLANE C96 (classe MASTER)
ALIMENTAZIONE +-18 (LM317/337 + cap-moltiplicatore), +-15 LN (LT3045/LT3094)
MASTER SUMMING [A2] (invertente, 20k/20k/10p, sum-noise-71A.cir)
MONO [A3] (matrice M/S + VCA su S, mono-ms.cir; resistenze NOTA)
INS_SEND driver + INS_RET buffer (slot 9-10, ponticello JMS sul backplane)
BUFFER [A] [B] [C] [N] (un buffer per uscita, voce 11)
MASTER LEVEL [D]: 2 VCA, shaper (shaper-master.cir), trim di law (vca-trim §3.2)
BOOTH LEVEL [B2]: 2 VCA, shaper del fader (shaper-fader.cir), trim di law
VIE_TAP [V]: driver dopo MASTER LEVEL verso b31-b32
METER [E]: detector di picco L/R (meter-det-03s.cir) e albero dei riferimenti (metering §5)
CONNETTORI: J2 verso la scheda di USCITA, J3 verso la scheda COMANDI

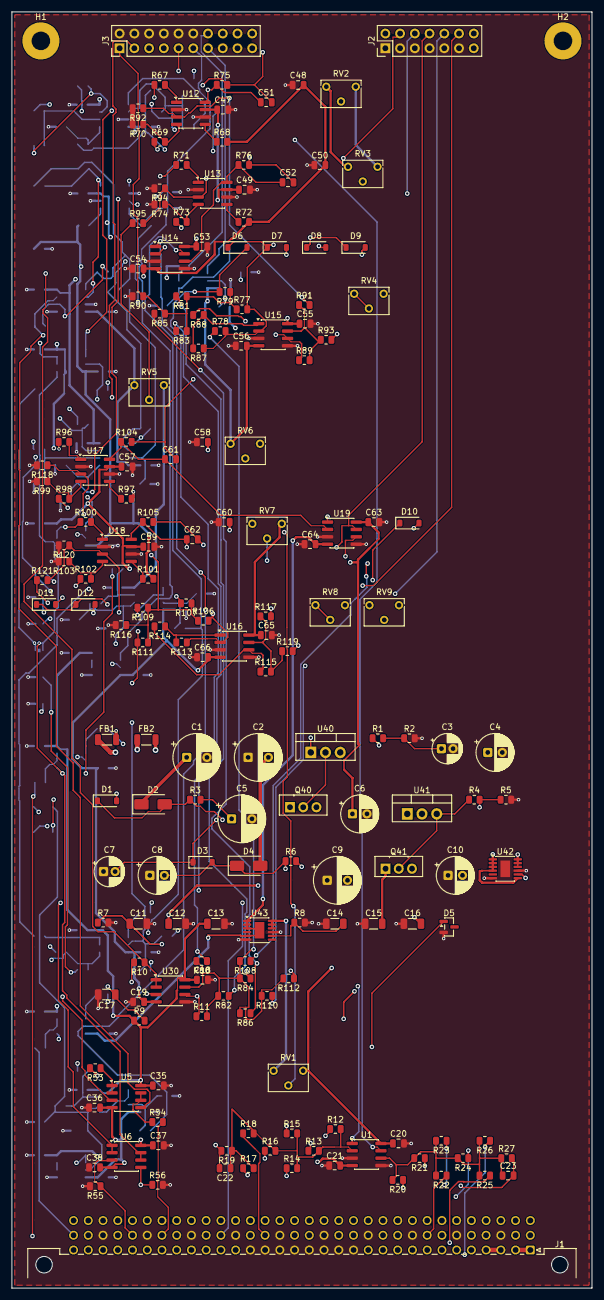
[picture p47: board master-segnale.kicad_pcb from above]

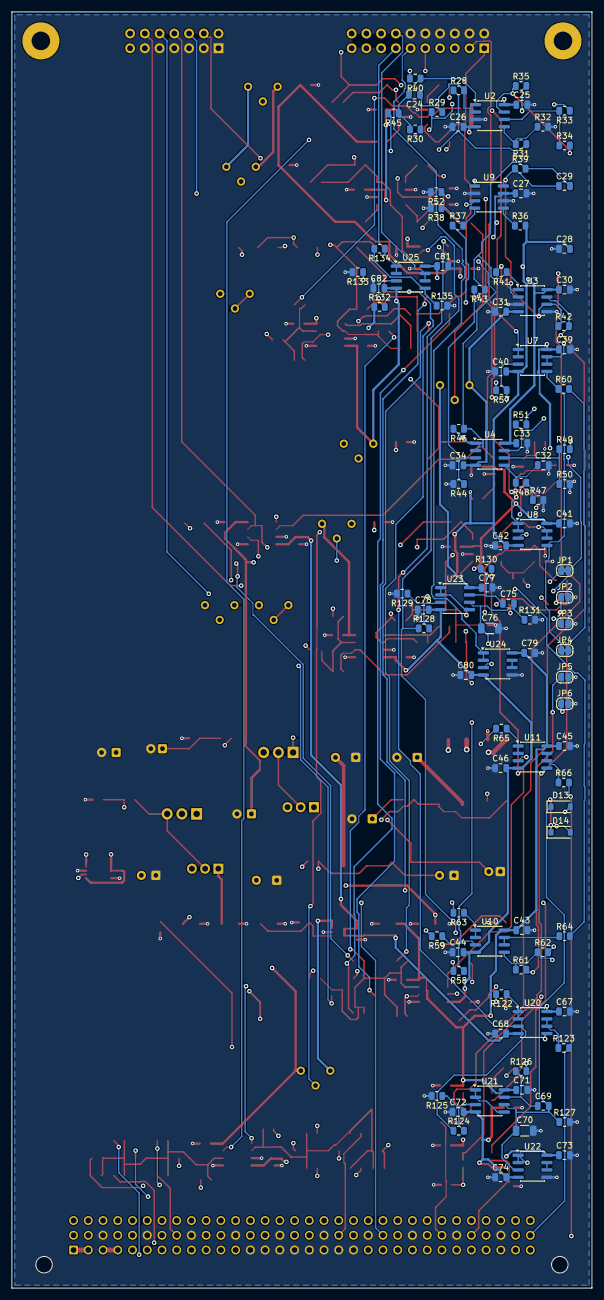
[picture p48: board master-segnale.kicad_pcb from below]

Board: 4 copper layers, 100.0 x 220.0 mm, 285 parts (106 on the bottom side), 161 nets.
