dj-filippo241/maelcum_mixer/pcb/mic/mic.kicad_pcb

## KiCad design pcb/mic/mic.kicad_pcb (2026-11-12)

Schematic: mic.kicad_sch, maelcum MIC (dec. 97) - bozza v0.1

Parts:
C1, C2: 220u 35V; CP_Radial_D8.0mm_P3.50mm
C3: 47u 10V; CP_Radial_D5.0mm_P2.00mm
C4, C8: 10u 35V; CP_Radial_D5.0mm_P2.00mm
C5, C9: 47u 35V; CP_Radial_D6.3mm_P2.50mm
C6, C10: 470u 25V; CP_Radial_D8.0mm_P3.50mm
C7, C11: 100u 25V; CP_Radial_D6.3mm_P2.50mm
C12, C13: 1u 50V; C_1206_3216Metric
C14, C15, C39: 1u 25V; C_1206_3216Metric
C16, C17, C19, C20: 4u7 25V; C_1206_3216Metric
C18, C21: 10u 25V; C_1206_3216Metric
C22, C23: 100p C0G; C_0805_2012Metric
C24, C25, C26, C27, C33, C34, C35, C36, C37, C38, C40, C45, C46, C47, C48, C52, C53, C54, C56, C57, C58, C59, C62, C63, C64, C65, C66, C67: 100n; C_0805_2012Metric
C28, C29: 220n C0G; C_1210_3225Metric
C30: 22p C0G; C_0805_2012Metric
C31, C49: 47p C0G; C_0805_2012Metric
C32: 100n C0G; C_1206_3216Metric
C41, C42: 180n C0G; C_1206_3216Metric
C43, C44: 10n C0G; C_1206_3216Metric
C50, C51: 1u C0G; C_1206_3216Metric
C55: 220n C0G; C_1206_3216Metric
C60, C61: 10p C0G; C_0805_2012Metric
D1, D3, D5, D6, D7, D8, D9, D10, D11, D12, D13, D14, D15: 1N4148W; D_SOD-123
D2, D4: S1G; D_SMA
FB1, FB2, FB3, FB4, FB5, FB6, FB7: ferrite 600R; L_1206_3216Metric
H1, H2: CHASSIS; MountingHole_3.2mm_M3_Pad
J1: C96 maschio; DIN41612_C_3x32_Male_Horizontal_THT
J2: 2x12 cavo piatto; PinHeader_2x12_P2.54mm_Vertical
J3: XLR (cavo); PinHeader_1x03_P2.54mm_Vertical
Q1, Q2: 2N7002; SOT-23
Q40: BD139; TO-126-3_Vertical
Q41: BD140; TO-126-3_Vertical
R1, R4: 120 1%; R_0805_2012Metric
R2, R5: 1k74 1%; R_0805_2012Metric
R3, R6, R27, R37, R38, R58, R87: 1k; R_0805_2012Metric
R7, R8: 150k 0.1%; R_0805_2012Metric
R9, R11: 10 1%; R_0805_2012Metric
R10, R12: 47k 1%; R_0805_2012Metric
R13: 2k32 1%; R_0805_2012Metric
R14, R15: 499 0.1%; R_0805_2012Metric
R16: 32.4 0.1%; R_0805_2012Metric
R17, R18, R19, R20, R69, R71: 1k 0.1%; R_0805_2012Metric
R21: 8k45 0.1%; R_0805_2012Metric
R22: 16k9 0.1%; R_0805_2012Metric
R23: 332 0.1%; R_0805_2012Metric
R24: 5k36 0.1%; R_0805_2012Metric
R25, R43, R44, R53, R54, R56, R57, R62, R64, R65, R66, R89, R90, R91, R92, R93, R94, R95, R96: 10k 0.1%; R_0805_2012Metric
R26: 2k49 0.1%; R_0805_2012Metric
R28: 3M; R_0805_2012Metric
R29: 133k 0.1%; R_0805_2012Metric
R30: 7k68 0.1%; R_0805_2012Metric
R31: 6k65 0.1%; R_0805_2012Metric
R32: 1k1 0.1%; R_0805_2012Metric
R33, R34, R36, R67, R68, R86: 10k; R_0805_2012Metric
R35: 750k; R_0805_2012Metric
R39, R40: 324 0.1%; R_0805_2012Metric
R41: 4k75 0.1%; R_0805_2012Metric
R42: 2k26 0.1%; R_0805_2012Metric
R45, R46, R47: 49k9 0.1%; R_0805_2012Metric
R48, R52, R55, R76, R77, R78, R79, R80, R81: 20k 0.1%; R_0805_2012Metric
R49: 5k1; R_0805_2012Metric
R50: 150k; R_0805_2012Metric
R51: 51; R_0805_2012Metric
R59: 1M; R_0805_2012Metric
R60: 100; R_0805_2012Metric
R61: 16k 0.1%; R_0805_2012Metric
R63: 169k 0.1%; R_0805_2012Metric
R70: 2k 0.1%; R_0805_2012Metric
R72, R74: 4k99 0.1%; R_0805_2012Metric
R73, R75: 274 0.1%; R_0805_2012Metric
R82, R83, R84, R85: 2k2; R_0805_2012Metric
R88: 100k; R_0805_2012Metric
RV1: 50k; Potentiometer_Bourns_3266W_Vertical
U1, U2, U8, U11: OPA1612AIDR; SOIC-8_3.9x4.9mm_P1.27mm
U3, U4, U6, U7, U10: OPA1654AIDR; SOIC-14_3.9x8.7mm_P1.27mm
U5: V2181L; SOIC-8_3.9x4.9mm_P1.27mm
U9: ADG1434YRUZ; TSSOP-20_4.4x6.5mm_P0.65mm
U30: LM339DR; SOIC-14_3.9x8.7mm_P1.27mm
U40: LM317; TO-220-3_Vertical
U41: LM337; TO-220-3_Vertical
U42: 78L15; SOT-89-3
U43: 79L15; SOT-89-3
U44: LT3045EMSE; MSOP-12-1EP_3x4.039mm_P0.65mm_EP1.651x2.845mm
U45: LT3094EMSE; MSOP-12-1EP_3x4.039mm_P0.65mm_EP1.651x2.845mm

Connections:
+5V: FB5.1, J1.a21, J1.a22
+5VF: C3.1, C40.1, FB5.2, J2.20, R33.1, R35.1, R36.1, R86.1, R88.2, U30.3 (VCC)
+15LN: C18.1, C24.1, C26.1, C33.1, C47.1, C52.1, C56.1, C58.1, D5.1 (K), D7.1 (K), R29.1, R63.1, RV1.1, U1.8 (V+), U2.8 (V+), U3.4 (V+), U5.7 (V+), U6.4 (V+), U7.4 (V+), U11.8 (V+), U44.10 (OUTS), U44.11 (OUT), U44.12 (OUT)
+15SW: C14.1, C64.1, U9.16 (VDD), U42.1 (OUT)
+18V: C7.1, C17.1, C45.1, C62.1, C66.1, Q40.1 (E), U4.4 (V+), U8.8 (V+), U10.4 (V+), U44.1 (IN), U44.2 (IN), U44.3 (IN), U44.4 (EN/UV), U44.7 (PGFB)
-15LN: C21.2, C25.2, C27.2, C34.2, C48.2, C53.2, C57.2, C59.2, D6.2 (A), D8.2 (A), R49.2, RV1.3, U1.4 (V-), U2.4 (V-), U3.11 (V-), U6.11 (V-), U7.11 (V-), U11.4 (V-), U45.10 (OUTS), U45.11 (OUT), U45.12 (OUT)
-15SW: C15.2, C65.2, U9.5 (VSS), U43.3 (VO)
-18V: C11.2, C20.2, C46.2, C63.2, C67.2, Q41.1 (E), U4.11 (V-), U8.4 (V-), U10.11 (V-), U45.1 (IN), U45.2 (IN), U45.3 (EN/UV), U45.5 (PGFB), U45.13 (IN)
ADJ+: C4.1, D1.2 (A), R1.2, R2.1, U40.1 (ADJ)
ADJ-: C8.2, D3.1 (K), R4.2, R5.1, U41.1 (ADJ)
AGND: C1.2, C2.1, C4.2, C5.2, C6.2, C7.2, C8.1, C9.1, C10.1, C11.1, C12.2, C13.1, C14.2, C15.1, C16.2, C17.2, C18.2, C19.1, C20.1, C21.1, C24.2, C25.1, C26.2, C27.1, C32.2, C33.2, C34.1, C35.2, C36.2, C37.2, C45.2, C46.1, C47.2, C48.1, C50.2, C51.2, C52.2, C53.1, C54.2, C55.2, C56.2, C57.1, C58.2, C59.1, C62.2, C63.1, C64.2, C65.1, C66.2, C67.1, J1.a13, J1.a14, J1.a15, J1.a16, J1.a17, J1.a18, J1.a19, J1.a20, J1.b3, J1.b6, J1.b9, J1.b12, J1.b15, J1.b18, J1.b21, J1.b24, J1.b27, J1.b30, J2.1, J2.5, J2.9, J2.13, J2.19, R2.2, R5.2, R7.2, R8.2, R10.2, R12.2, R20.2, R22.2, R26.2, R28.2, R32.2, R42.2, R51.2, R59.2, R64.2, R68.2, R71.2, R73.2, R75.2, U2.5 (+), U3.5 (+), U4.3 (+), U4.10 (+), U4.12 (+), U5.2 (EC+), U5.6 (GND), U6.3 (+), U6.5 (+), U6.10 (+), U7.10 (+), U8.3 (+), U8.5 (+), U9.4 (S1B), U9.6 (GND), U9.7 (S2B), U9.14 (S3B), U9.17 (S4B), U11.5 (+), U42.2 (GND), U43.1 (GND), U44.6 (ILIM), U44.9 (GND), U44.13 (GND), U45.6 (ILIM), U45.9 (GND)
BASE+: C6.1, Q40.3 (B), R3.2
BASE-: C10.2, Q41.3 (B), R6.2
CF: C23.1, FB7.2, R11.1
CHASSIS: C22.2, C23.2, H1.1, H2.1, J1.a25, J1.a26, J3.1
CTRL_GND: C3.2, C38.2, C39.2, C40.2, J1.a23, J1.a24, J1.c16, J1.c20, J1.c24, J1.c28, J2.24, Q2.2 (S), R34.2, U30.12 (GND)
D1A: D9.2 (A), R27.2
DN: R17.2, R18.1, U2.2 (-)
DOUT: C31.1, R27.1, U3.8
DP: R19.2, R20.1, U2.3 (+)
DRV_L: C60.2, R77.2, R78.1, U8.1
DRV_R: C61.2, R80.2, R81.1, U8.7
DSUB: R62.2, R65.1, U7.7
ECF: R72.1, R73.1, U11.2 (-)
ECM: R74.2, R75.1, U5.3 (EC-)
ECO: R72.2, R74.1, U11.1
ECS: R69.2, R70.2, R71.1, U11.3 (+)
F1: R14.2, R16.1, U1.2 (-)
F2: R15.2, R16.2, U1.6 (-)
GFD: Q1.3 (D), R38.2
GINV: C30.1, J2.3, U3.6 (-)
GLOBAL_MUTE: J1.c9, R87.1
GP1: J2.2, R23.2
GP2: J2.4, R24.1
HF: C22.1, FB6.2, R9.1
HN: D15.2 (A), R65.2, R66.1, U7.9 (-)
HO: D14.2 (A), D15.1 (K), U7.8
HOLD: C31.2, C32.1, D9.1 (K), R28.1, U3.9 (-), U3.12 (+)
HP: R21.2, R23.1, U3.1, U3.2 (-)
HW: D11.2 (A), R54.2, R56.1
IC: D7.2 (A), D8.1 (K), R11.2, R12.1, R13.2, U1.5 (+)
IH: D5.2 (A), D6.1 (K), R9.2, R10.1, R13.1, U1.3 (+)
INJ1: R89.1, R90.1, U10.1, U10.2 (-)
INJ2: R91.1, R92.1, U10.6 (-), U10.7
INJ3: R93.1, R94.1, U10.8, U10.9 (-)
INJ4: R95.1, R96.1, U10.13 (-), U10.14
K1: C28.2, C29.1, R21.1
K2: C29.2, R22.1, U3.3 (+)
KG: Q1.2 (S), U30.13 (4OUT)
KR: D10.2 (A), R37.2, U30.14 (3OUT)
LIM: D14.1 (K), R66.2, R69.1
LKG: J2.21, R38.1
LKR: J2.22, R37.1
LQ: D10.1 (K), Q1.1 (G), R36.2, U30.2 (2OUT)
LT: C39.1, R35.2, U30.1 (1OUT), U30.5 (2IN+)
MET: U3.13 (-), U3.14, U30.6 (1IN-), U30.8 (3IN-), U30.10 (4IN-)
MG: R25.2, R26.1, U3.10 (+)
MRC: C55.1, R67.2, R68.1, U7.12 (+)
MSUM6_L: J1.b1, R78.2
MSUM6_R: J1.b2, R81.2
MUTE_CV: R70.1, U7.13 (-), U7.14
MUTE_G: Q2.1 (G), R87.2, R88.1
MUTE_SW: J2.23, R67.1
NA: C41.1, J2.6, R39.2
NB: C41.2, C42.1, J2.7, U4.2 (-)
NC: C42.2, J2.8, R40.1
NDR_L: C60.1, R76.2, R77.1, U8.2 (-)
NDR_R: C61.1, R79.2, R80.1, U8.6 (-)
NHA: C43.2, C44.1, R41.1
NHB: C44.2, R42.1, U4.5 (+)
NIV: C49.1, R52.1, U5.8 (OUT), U6.2 (-)
NSH: R45.2, R46.2, R47.1, U4.13 (-)
NU2: U2.6 (-), U2.7
NU11: U11.6 (-), U11.7
NVH: R43.2, R44.1, U4.9 (-)
O1: R14.1, R17.1, U1.1
O2: R15.1, R19.1, U1.7
PK: C50.1, R58.2, R59.1, R60.1
POST: C49.2, J2.14, R52.2, R53.1, R55.1, R76.1, R79.1, U6.1
POSTEQ: R47.2, R48.1, U4.14
PRE: C30.2, R24.2, R25.1, R39.1, U3.7
RAN: D12.1 (K), R53.2, R54.1, U6.6 (-)
RAO: D11.1 (K), D12.2 (A), U6.7
RAW+22: FB3.1, J1.a5, J1.a6
RAW+27: FB1.1, J1.a1, J1.a2
RAW-22: FB4.1, J1.a7, J1.a8
RAW-27: FB2.1, J1.a3, J1.a4
RBN: R55.2, R56.2, R57.1, U6.9 (-)
RECT: R57.2, U6.8, U6.12 (+)
S1: C28.1, R18.2, U2.1
S1_OUT_L: J1.b4, R89.2
S1_OUT_R: J1.b5, R90.2
S2_OUT_L: J1.b7, R91.2
S2_OUT_R: J1.b8, R92.2
S3_OUT_L: J1.b10, R93.2
S3_OUT_R: J1.b11, R94.2
S4_OUT_L: J1.b13, R95.2
S4_OUT_R: J1.b14, R96.2
SDK: D13.1 (K), R58.1, U6.13 (-)
SDO: D13.2 (A), U6.14
SETN: C19.2, R8.1, U45.8 (SET)
SETP: C16.1, R7.1, U44.8 (SET)
SIN1: R82.2, U9.2 (S1A), U9.3 (D1), U10.3 (+)
SIN2: R83.2, U9.8 (D2), U9.9 (S2A), U10.5 (+)
SIN3: R84.2, U9.12 (S3A), U9.13 (D3), U10.10 (+)
SIN4: R85.2, U9.18 (D4), U9.19 (S4A), U10.12 (+)
SM: C51.1, R60.2, U7.3 (+)
SMB: R61.1, U7.1, U7.2 (-)
SMUTE_N: Q2.3 (D), R86.2, U9.1 (IN1), U9.10 (IN2), U9.11 (IN3), U9.20 (IN4)
SUBN: R61.2, R62.1, U7.6 (-)
SUBP: C54.1, R63.2, R64.1, U7.5 (+)
SW1: J2.15, R82.1
SW2: J2.16, R83.1
SW3: J2.17, R84.1
SW4: J2.18, R85.1
SWSYM: R50.1, RV1.2
SYM: R50.2, R51.1, U5.4 (SYM)
V22F+: C12.1, FB3.2, U42.3 (IN)
V22F-: C13.2, FB4.2, U43.2 (VI)
V27F+: C1.1, D2.1 (K), FB1.2, U40.3 (VI)
V27F-: C2.2, D4.2 (A), FB2.2, U41.2 (VI)
VEE: R49.1, U5.5 (V-)
VG: C37.1, R31.2, R32.1, U30.11 (4IN+)
VHN: J2.10, R44.2, U4.8
VHP: J2.12, R41.2, R43.1, U4.6 (-), U4.7
VIN: R48.2, U5.1 (IN)
VLO: C43.1, R40.2, R45.1, U4.1
VR: C35.1, R29.2, R30.1, U30.7 (1IN+)
VREG+: C5.1, D1.1 (K), D2.2 (A), Q40.2 (C), R1.1, R3.1, U40.2 (VO)
VREG-: C9.2, D3.2 (A), D4.1 (K), Q41.2 (C), R4.1, R6.1, U41.3 (VO)
VTL: C38.1, R33.2, R34.1, U30.4 (2IN-)
VY: C36.1, R30.2, R31.1, U30.9 (3IN+)
WPH: J2.11, R46.1
XCOLD: FB7.1, J3.3
XHOT: FB6.1, J3.2

Notes on the sheet:
BACKPLANE C96 (classe MIC/GEN, MSUM6)
ALIM: +18V (LM317 + BD139)
ALIM: -18V (LM337 + BD140)
ALIM: +15SW (78L15)
ALIM: -15SW (79L15)
ALIM: +5VF
ALIM: +15LN (LT3045)
ALIM: -15LN (LT3094)
INGRESSO XLR: RFI, clamp, carico 2,32k, bias 2x47k (mic-pre.inc)
INA +30,05 dB e differenziale unity (OPA1612)
PASSA-ALTO 60 Hz, STADIO 2 (0...+30 dB), DETECTOR del LED (OPA1654)
LED tricolore (LM339)
EQ2 (+-18)
VCA del MUTE e del limiter (dec. 111, 145; sim/mic/mic-limiter.cir)
DRIVER MSUM6 L/R (invertenti, todo 227)
MANDATE S1-S4 (pot sul cavo, mute globale, iniezione)
CAVO SCHEDA COMANDI (J2)

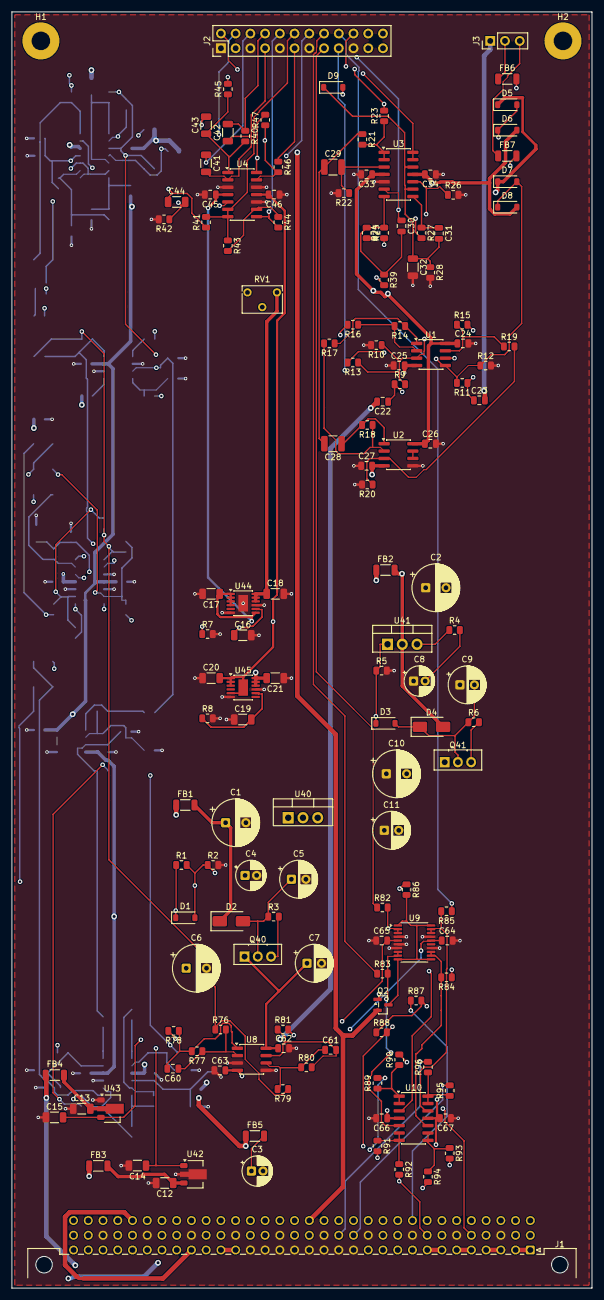
[picture p49: board mic.kicad_pcb from above]

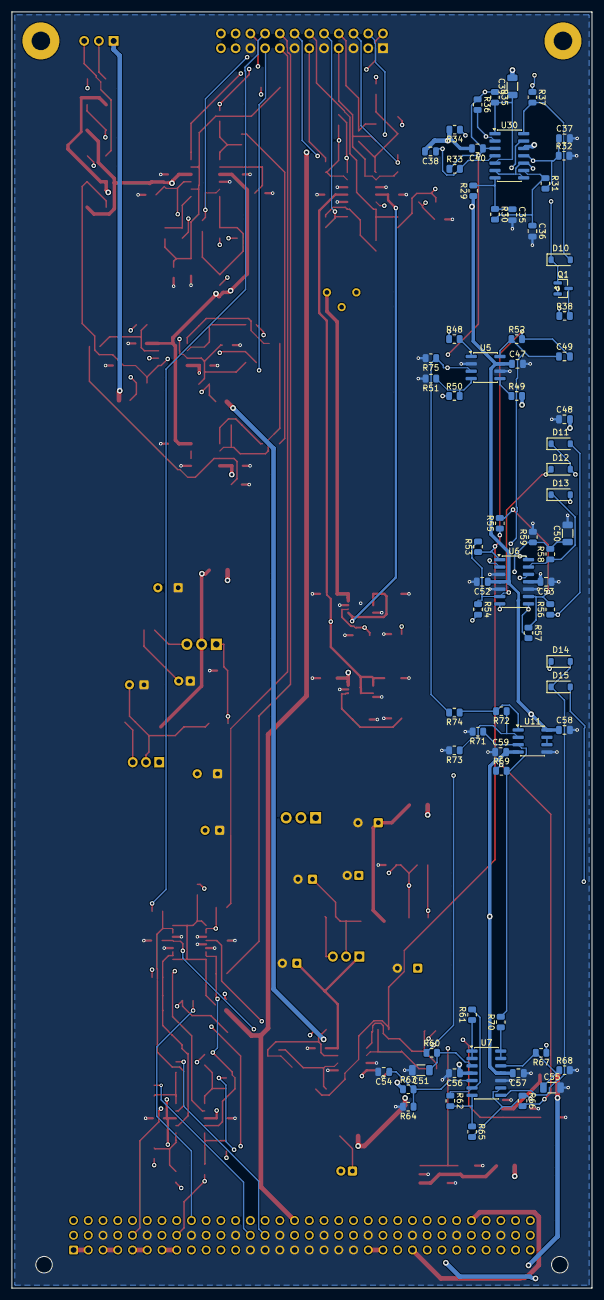
[picture p50: board mic.kicad_pcb from below]

Board: 4 copper layers, 100.0 x 220.0 mm, 213 parts (69 on the bottom side), 135 nets.
