dj-filippo241/maelcum_mixer/pcb/psu-in/psu-in.kicad_pcb

## KiCad design pcb/psu-in/psu-in.kicad_pcb (2026-11-12)

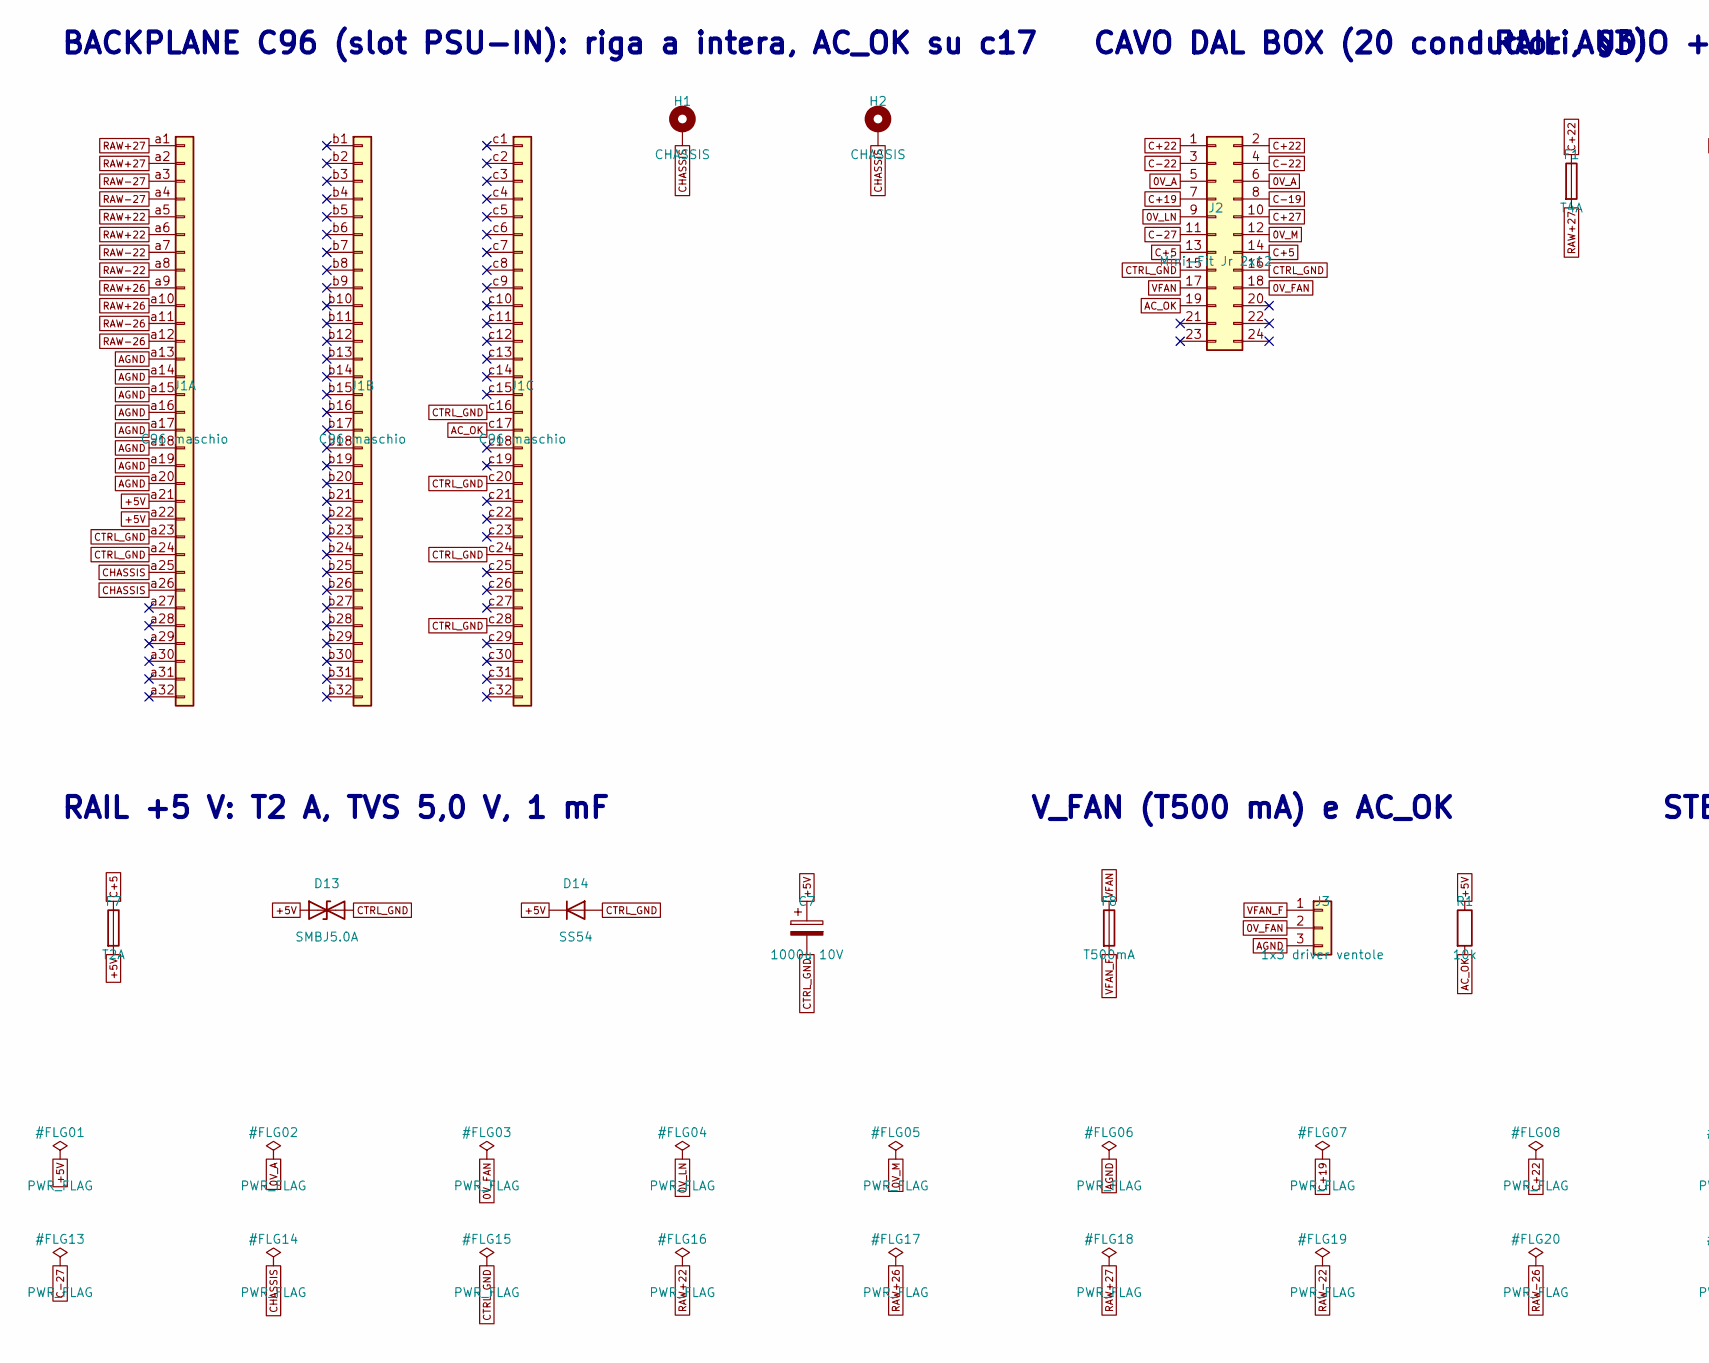
[picture p51: schematic psu-in.kicad_sch, maelcum PSU-IN (dec. 113) - bozza v0.1, part in row 1, column 1]

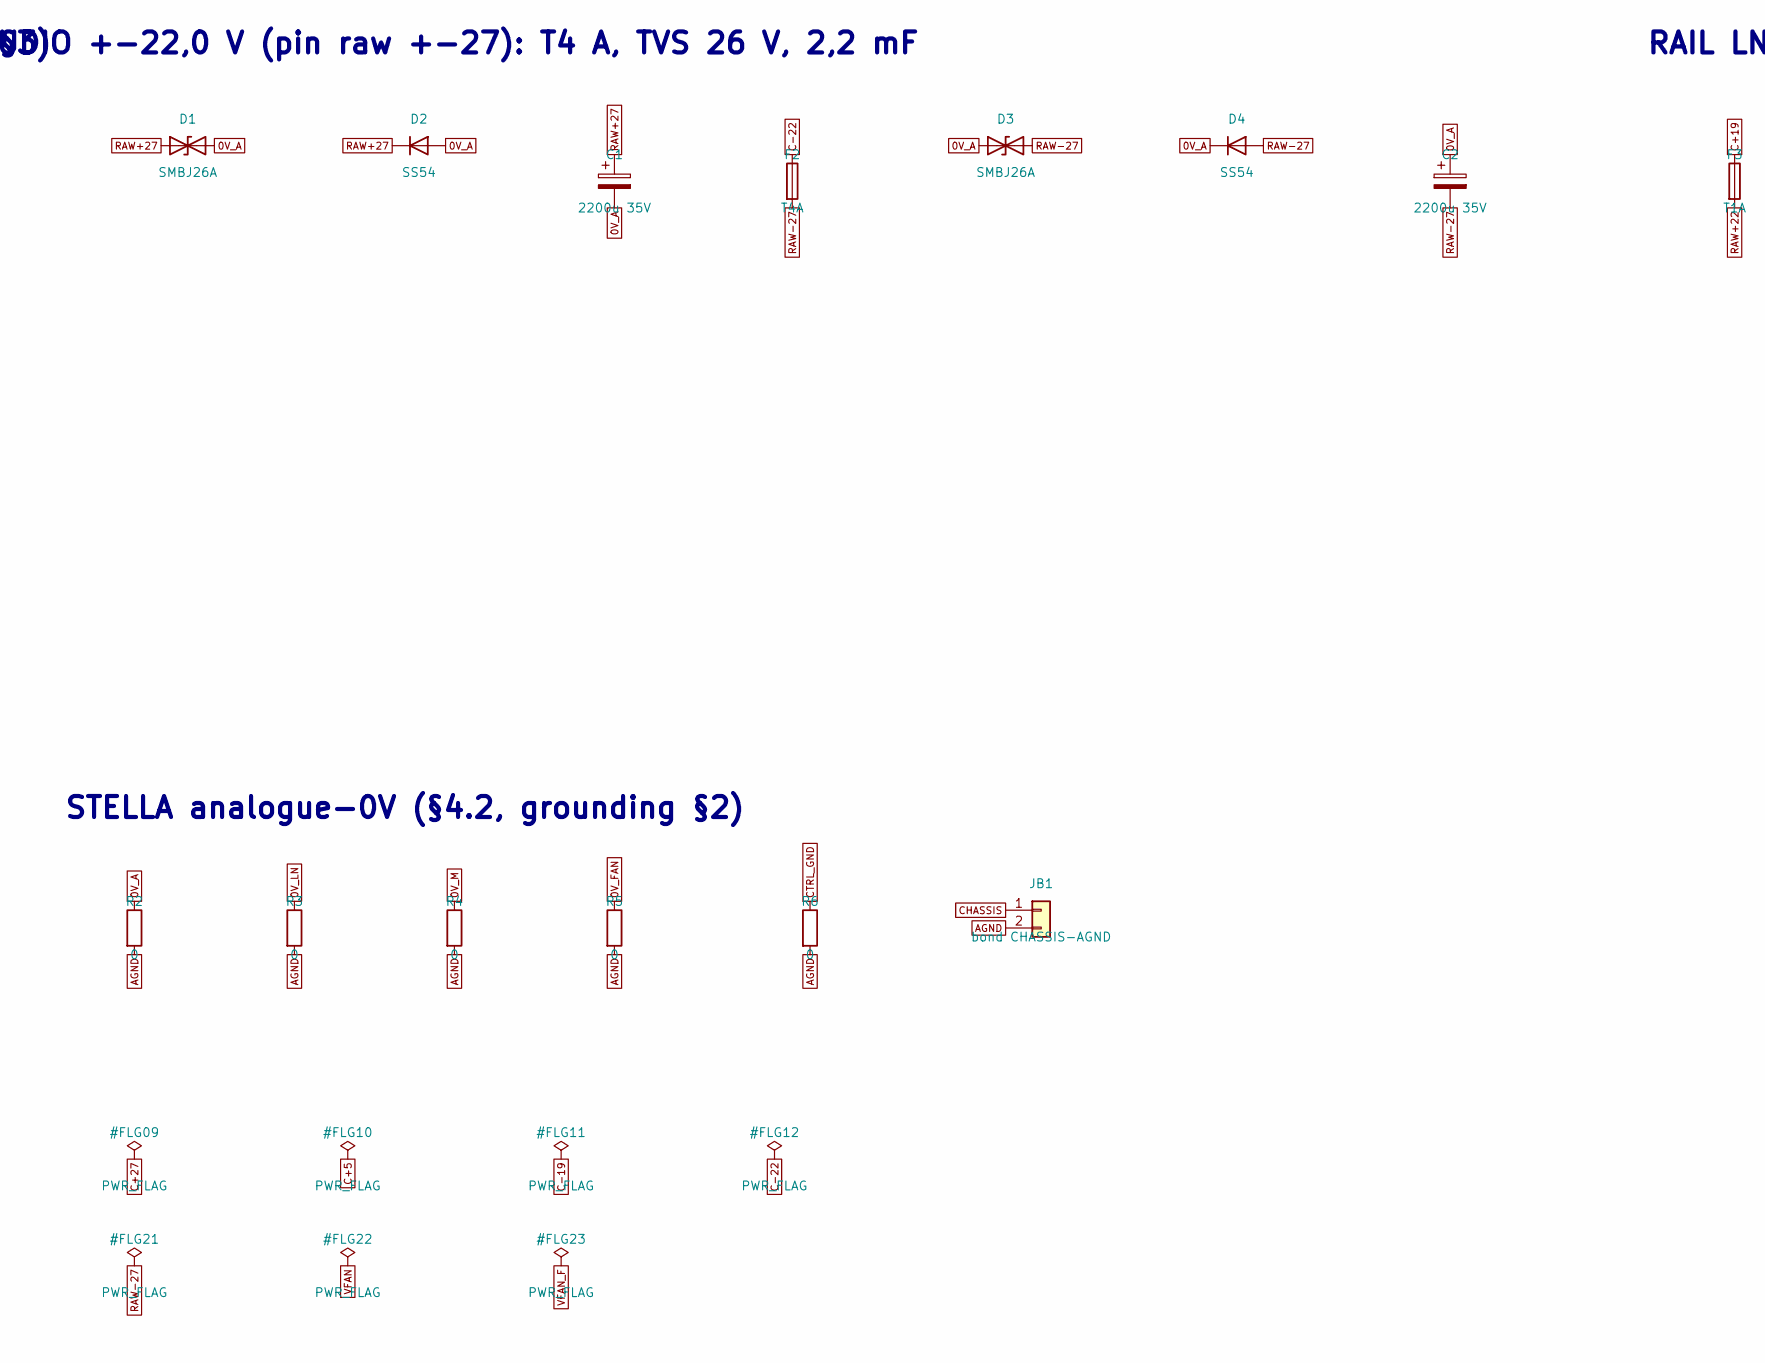
[picture p52: schematic psu-in.kicad_sch, maelcum PSU-IN (dec. 113) - bozza v0.1, part in row 1, column 2]

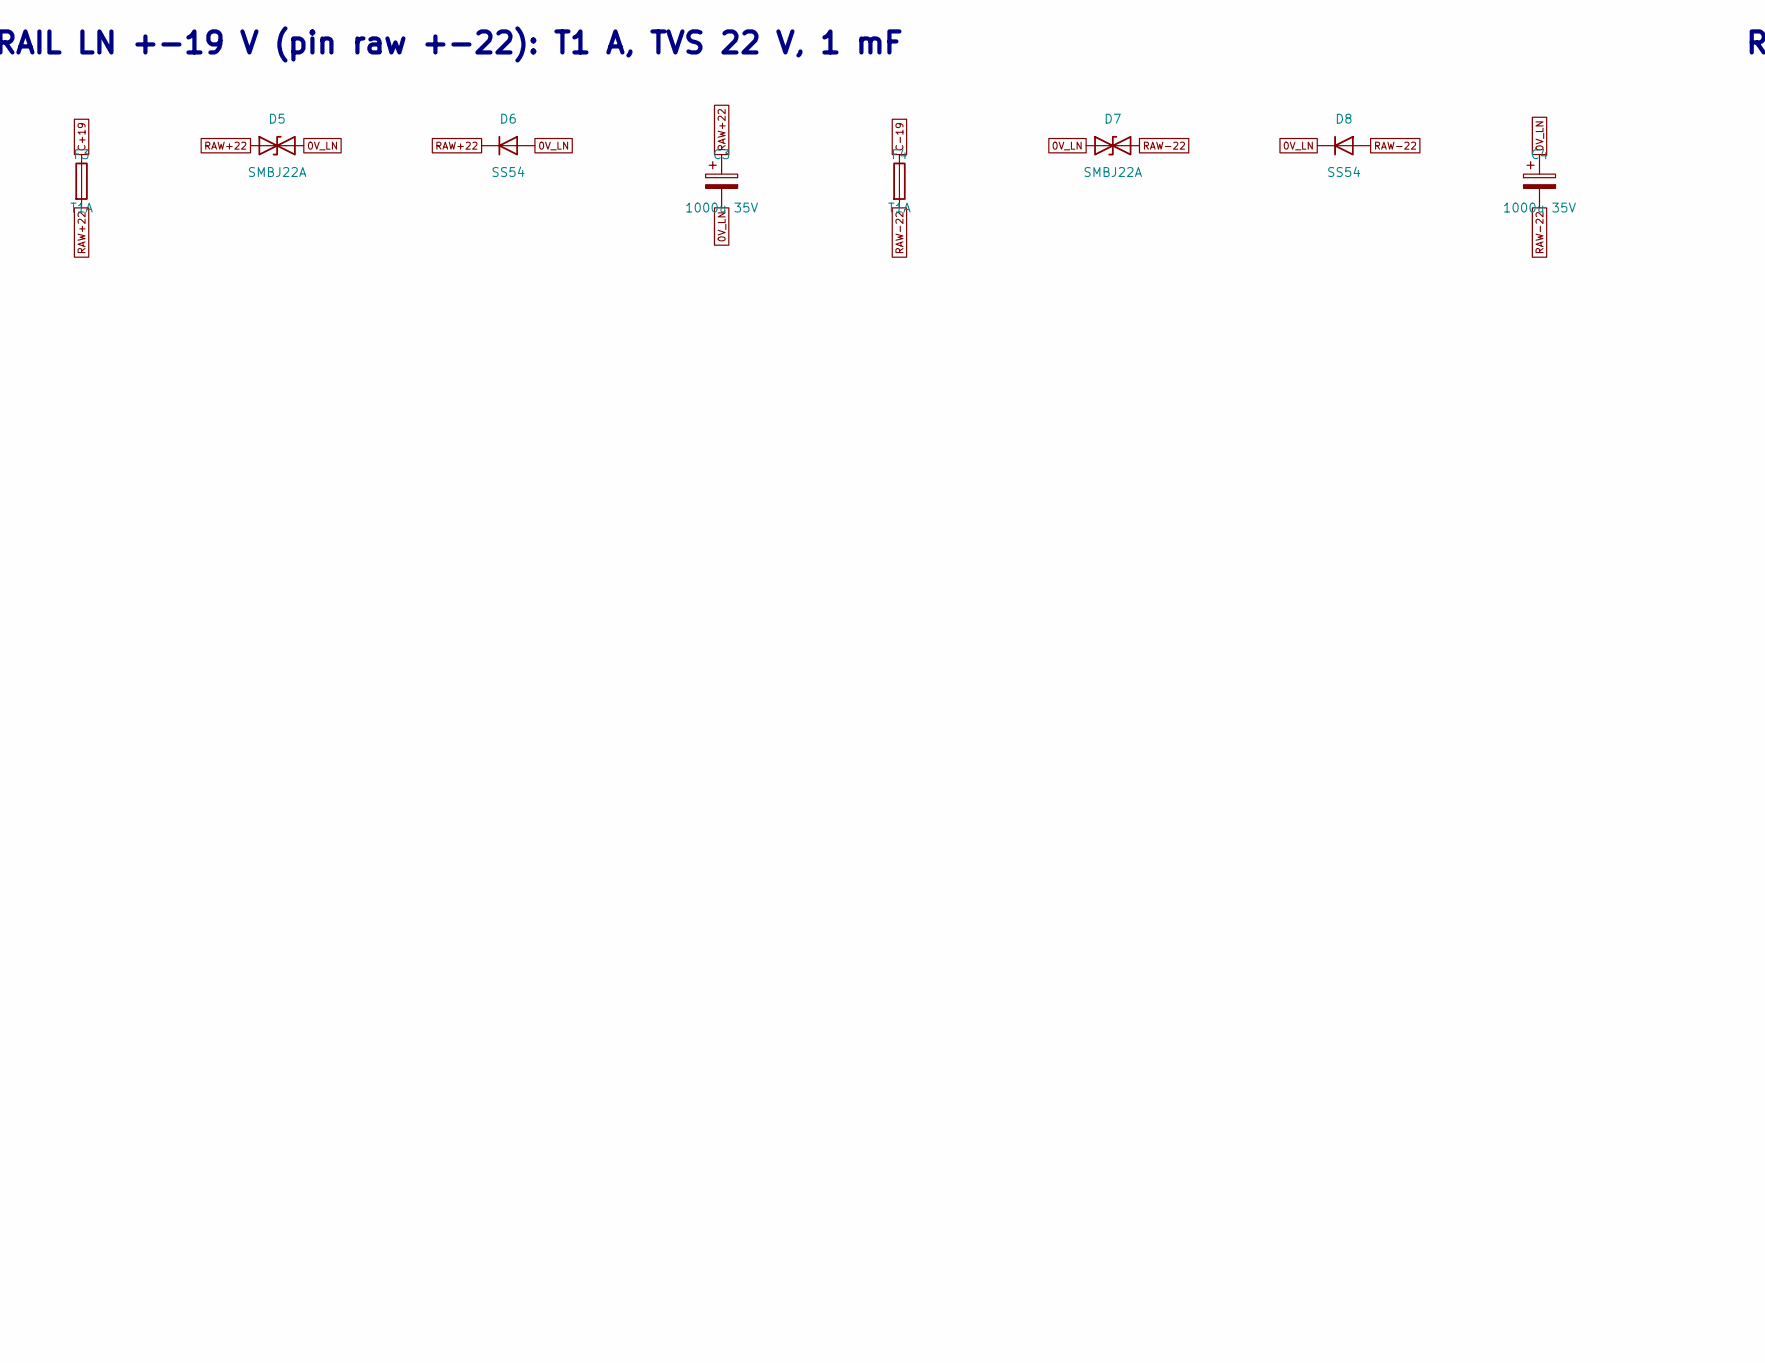
[picture p53: schematic psu-in.kicad_sch, maelcum PSU-IN (dec. 113) - bozza v0.1, part in row 1, column 3]

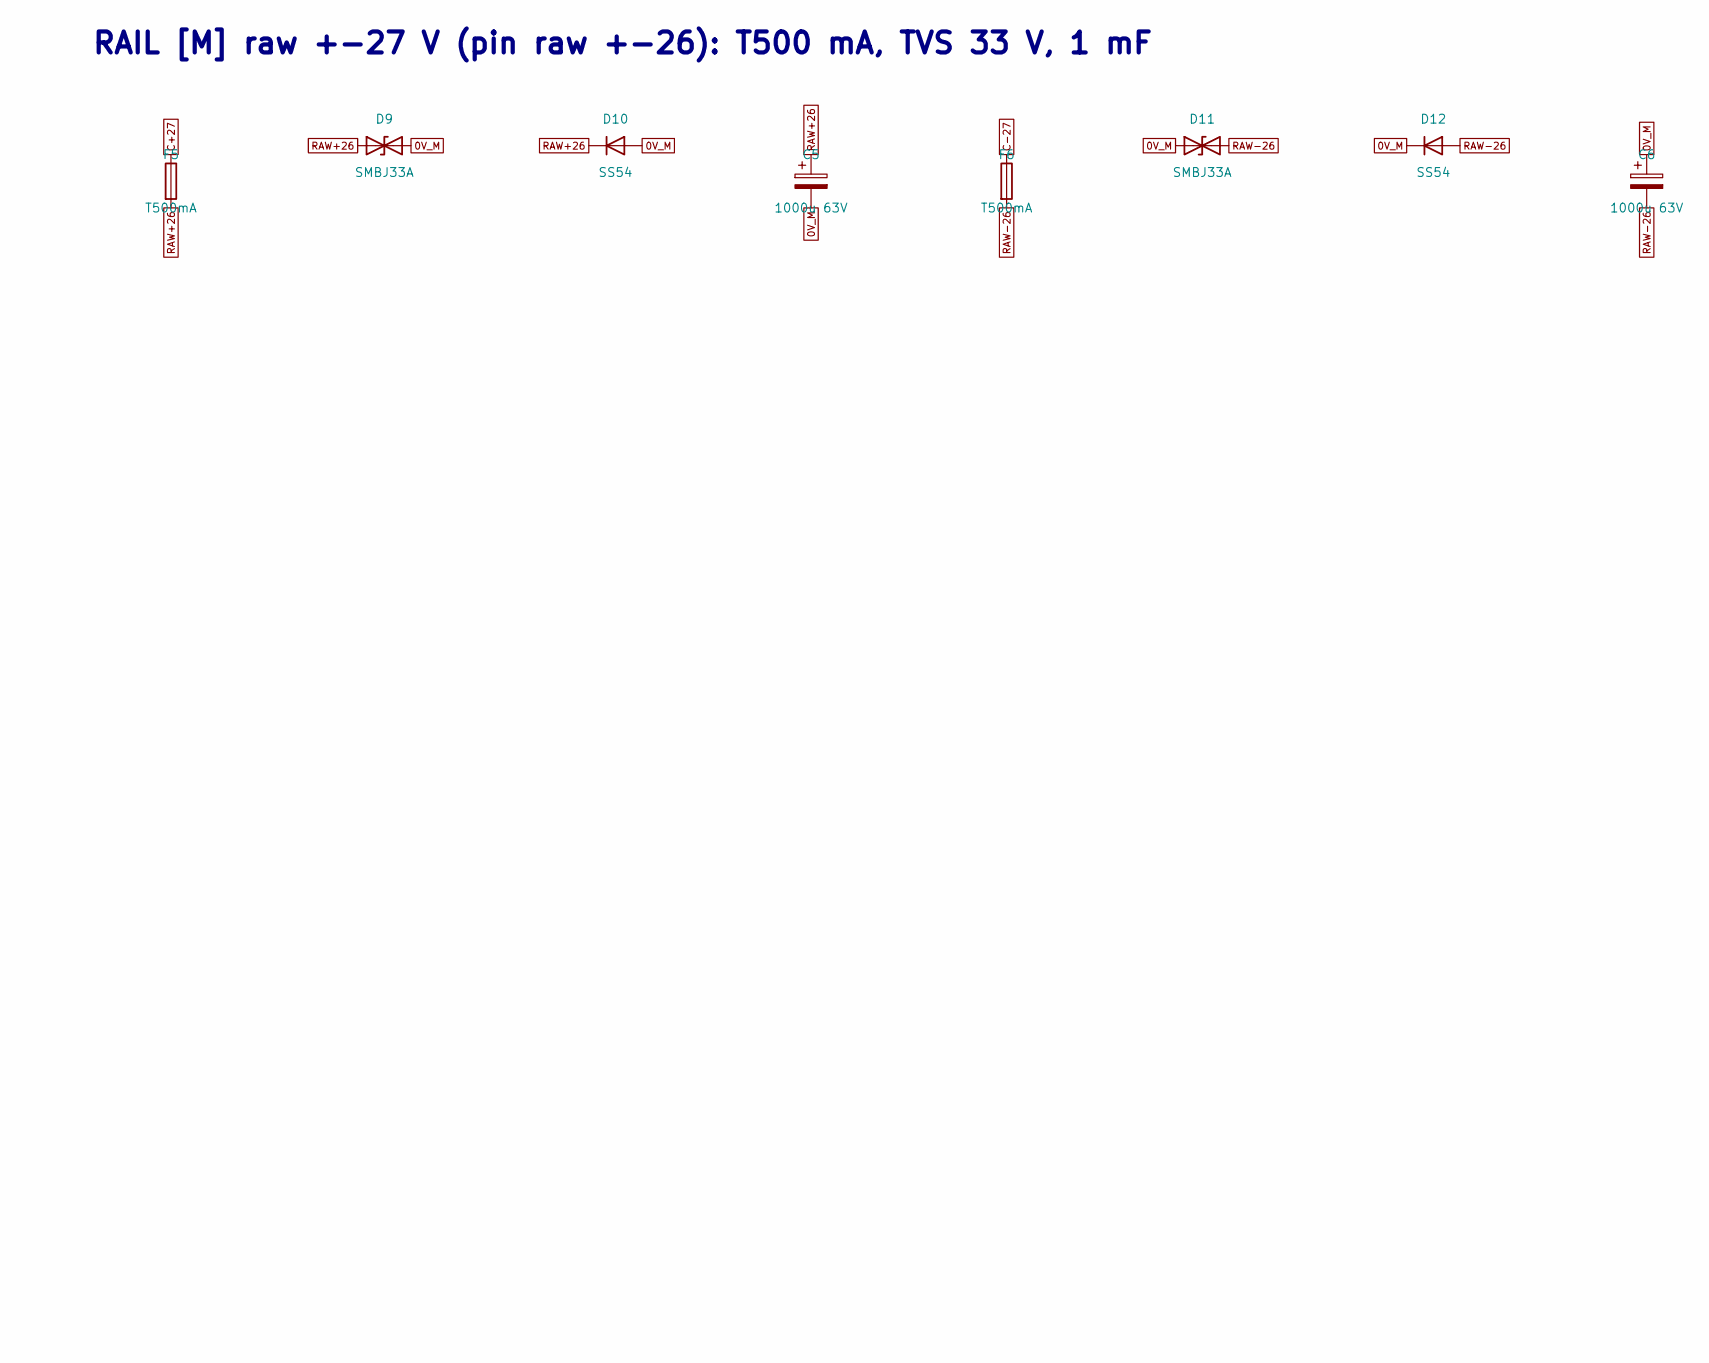
[picture p54: schematic psu-in.kicad_sch, maelcum PSU-IN (dec. 113) - bozza v0.1, part in row 1, column 4]

Parts:
C1, C2: 2200u 35V; CP_Radial_D18.0mm_P7.50mm
C3, C4: 1000u 35V; CP_Radial_D12.5mm_P5.00mm
C5, C6: 1000u 63V; CP_Radial_D12.5mm_P5.00mm
C7: 1000u 10V; CP_Radial_D12.5mm_P5.00mm
D1, D3: SMBJ26A; D_SMB
D2, D4, D6, D8, D10, D12, D14: SS54; D_SMC
D5, D7: SMBJ22A; D_SMB
D9, D11: SMBJ33A; D_SMB
D13: SMBJ5.0A; D_SMB
F1, F2: T4A; Fuseholder_Cylinder-5x20mm_Stelvio-Kontek_PTF78_Horizontal_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
F3, F4: T1A; Fuseholder_Cylinder-5x20mm_Stelvio-Kontek_PTF78_Horizontal_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
F5, F6, F8: T500mA; Fuseholder_Cylinder-5x20mm_Stelvio-Kontek_PTF78_Horizontal_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
F7: T2A; Fuseholder_Cylinder-5x20mm_Stelvio-Kontek_PTF78_Horizontal_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
H1, H2: CHASSIS; MountingHole_3.2mm_M3_Pad
J1: C96 maschio; DIN41612_C_3x32_Male_Horizontal_THT
J2: Mini-Fit Jr 2x12; Molex_Mini-Fit_Jr_5566-24A2_2x12_P4.20mm_Vertical
J3: 1x3 driver ventole; PinHeader_1x03_P2.54mm_Vertical
JB1: bond CHASSIS-AGND; PinHeader_1x02_P2.54mm_Vertical
R1: 10k; R_0805_2012Metric
R2, R3, R4, R5, R6: 0; R_2512_6332Metric

Connections:
0V_A: C1.2, C2.1, D1.2 (A2), D2.2 (A), D3.1 (A1), D4.1 (K), J2.5, J2.6, R2.1
0V_FAN: J2.18, J3.2, R5.1
0V_LN: C3.2, C4.1, D5.2 (A2), D6.2 (A), D7.1 (A1), D8.1 (K), J2.9, R3.1
0V_M: C5.2, C6.1, D9.2 (A2), D10.2 (A), D11.1 (A1), D12.1 (K), J2.12, R4.1
+5V: C7.1, D13.1 (A1), D14.1 (K), F7.2, J1.a21, J1.a22, R1.1
AC_OK: J1.c17, J2.19, R1.2
AGND: J1.a13, J1.a14, J1.a15, J1.a16, J1.a17, J1.a18, J1.a19, J1.a20, J3.3, JB1.2, R2.2, R3.2, R4.2, R5.2, R6.2
C+5: F7.1, J2.13, J2.14
C+19: F3.1, J2.7
C+22: F1.1, J2.1, J2.2
C+27: F5.1, J2.10
C-19: F4.1, J2.8
C-22: F2.1, J2.3, J2.4
C-27: F6.1, J2.11
CHASSIS: H1.1, H2.1, J1.a25, J1.a26, JB1.1
CTRL_GND: C7.2, D13.2 (A2), D14.2 (A), J1.a23, J1.a24, J1.c16, J1.c20, J1.c24, J1.c28, J2.15, J2.16, R6.1
RAW+22: C3.1, D5.1 (A1), D6.1 (K), F3.2, J1.a5, J1.a6
RAW+26: C5.1, D9.1 (A1), D10.1 (K), F5.2, J1.a9, J1.a10
RAW+27: C1.1, D1.1 (A1), D2.1 (K), F1.2, J1.a1, J1.a2
RAW-22: C4.2, D7.2 (A2), D8.2 (A), F4.2, J1.a7, J1.a8
RAW-26: C6.2, D11.2 (A2), D12.2 (A), F6.2, J1.a11, J1.a12
RAW-27: C2.2, D3.2 (A2), D4.2 (A), F2.2, J1.a3, J1.a4
VFAN: F8.1, J2.17
VFAN_F: F8.2, J3.1

Notes on the sheet:
BACKPLANE C96 (slot PSU-IN): riga a intera, AC_OK su c17
CAVO DAL BOX (20 conduttori, §3)
RAIL AUDIO +-22,0 V (pin raw +-27): T4 A, TVS 26 V, 2,2 mF
RAIL LN +-19 V (pin raw +-22): T1 A, TVS 22 V, 1 mF
RAIL [M] raw +-27 V (pin raw +-26): T500 mA, TVS 33 V, 1 mF
RAIL +5 V: T2 A, TVS 5,0 V, 1 mF
V_FAN (T500 mA) e AC_OK
STELLA analogue-0V (§4.2, grounding §2)

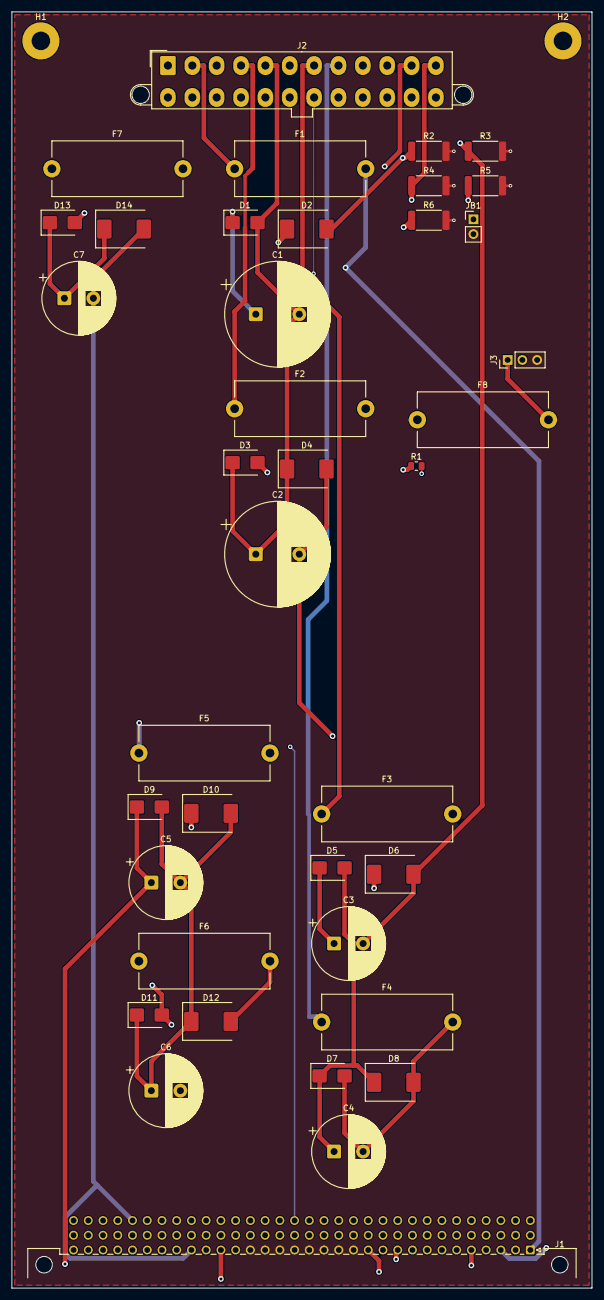
[picture p55: board psu-in.kicad_pcb from above]

Board: 4 copper layers, 100.0 x 220.0 mm, 41 parts (0 on the bottom side), 24 nets.
