dj-filippo241/maelcum_mixer/pcb/mono/mono.kicad_pcb

## KiCad design pcb/mono/mono.kicad_pcb (2026-11-12)

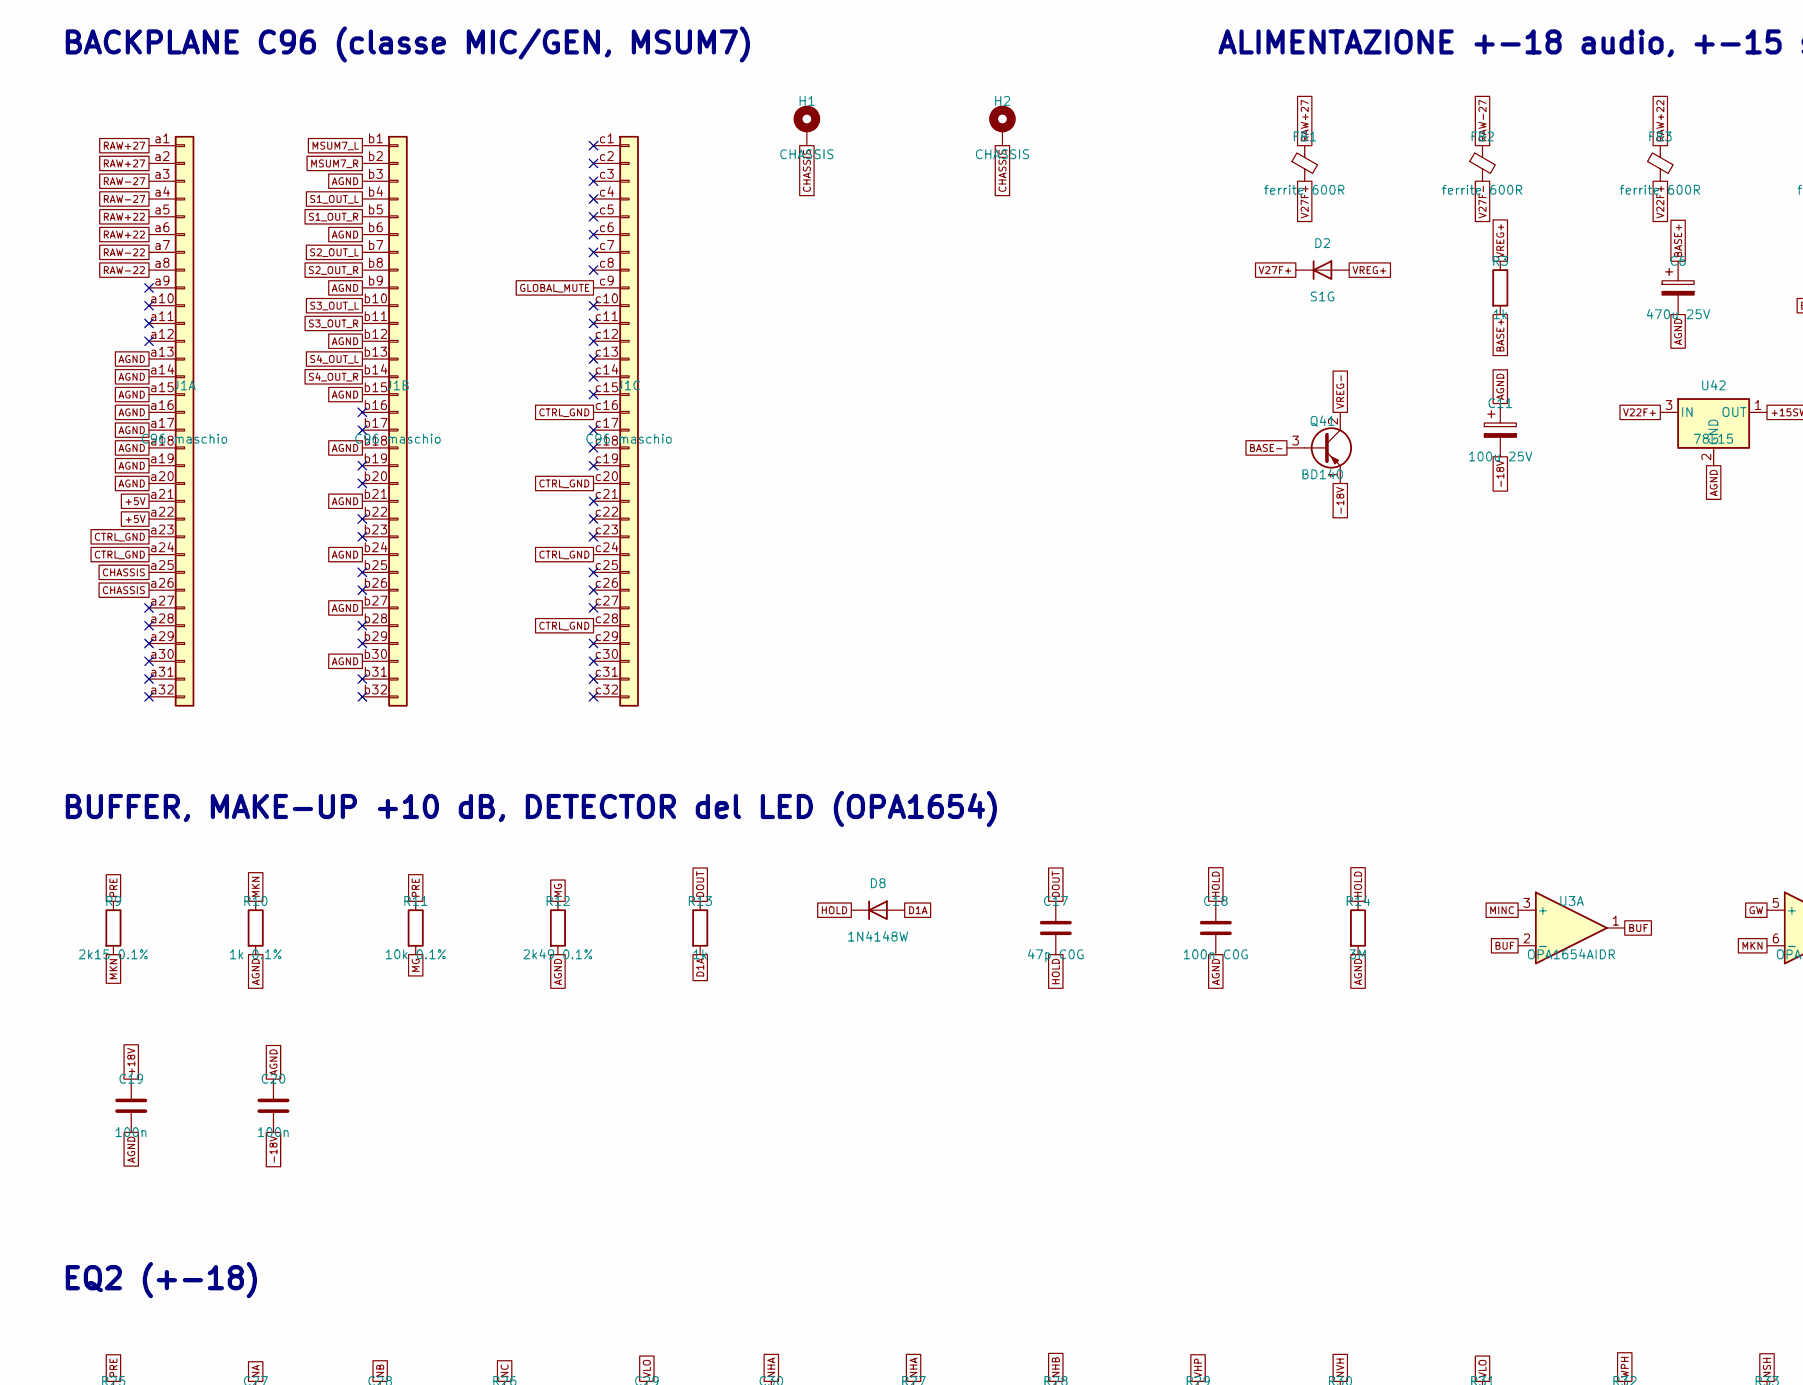
[picture p56: schematic mono.kicad_sch, maelcum MONO (dec. 97) - bozza v0.1, part in row 1, column 1]

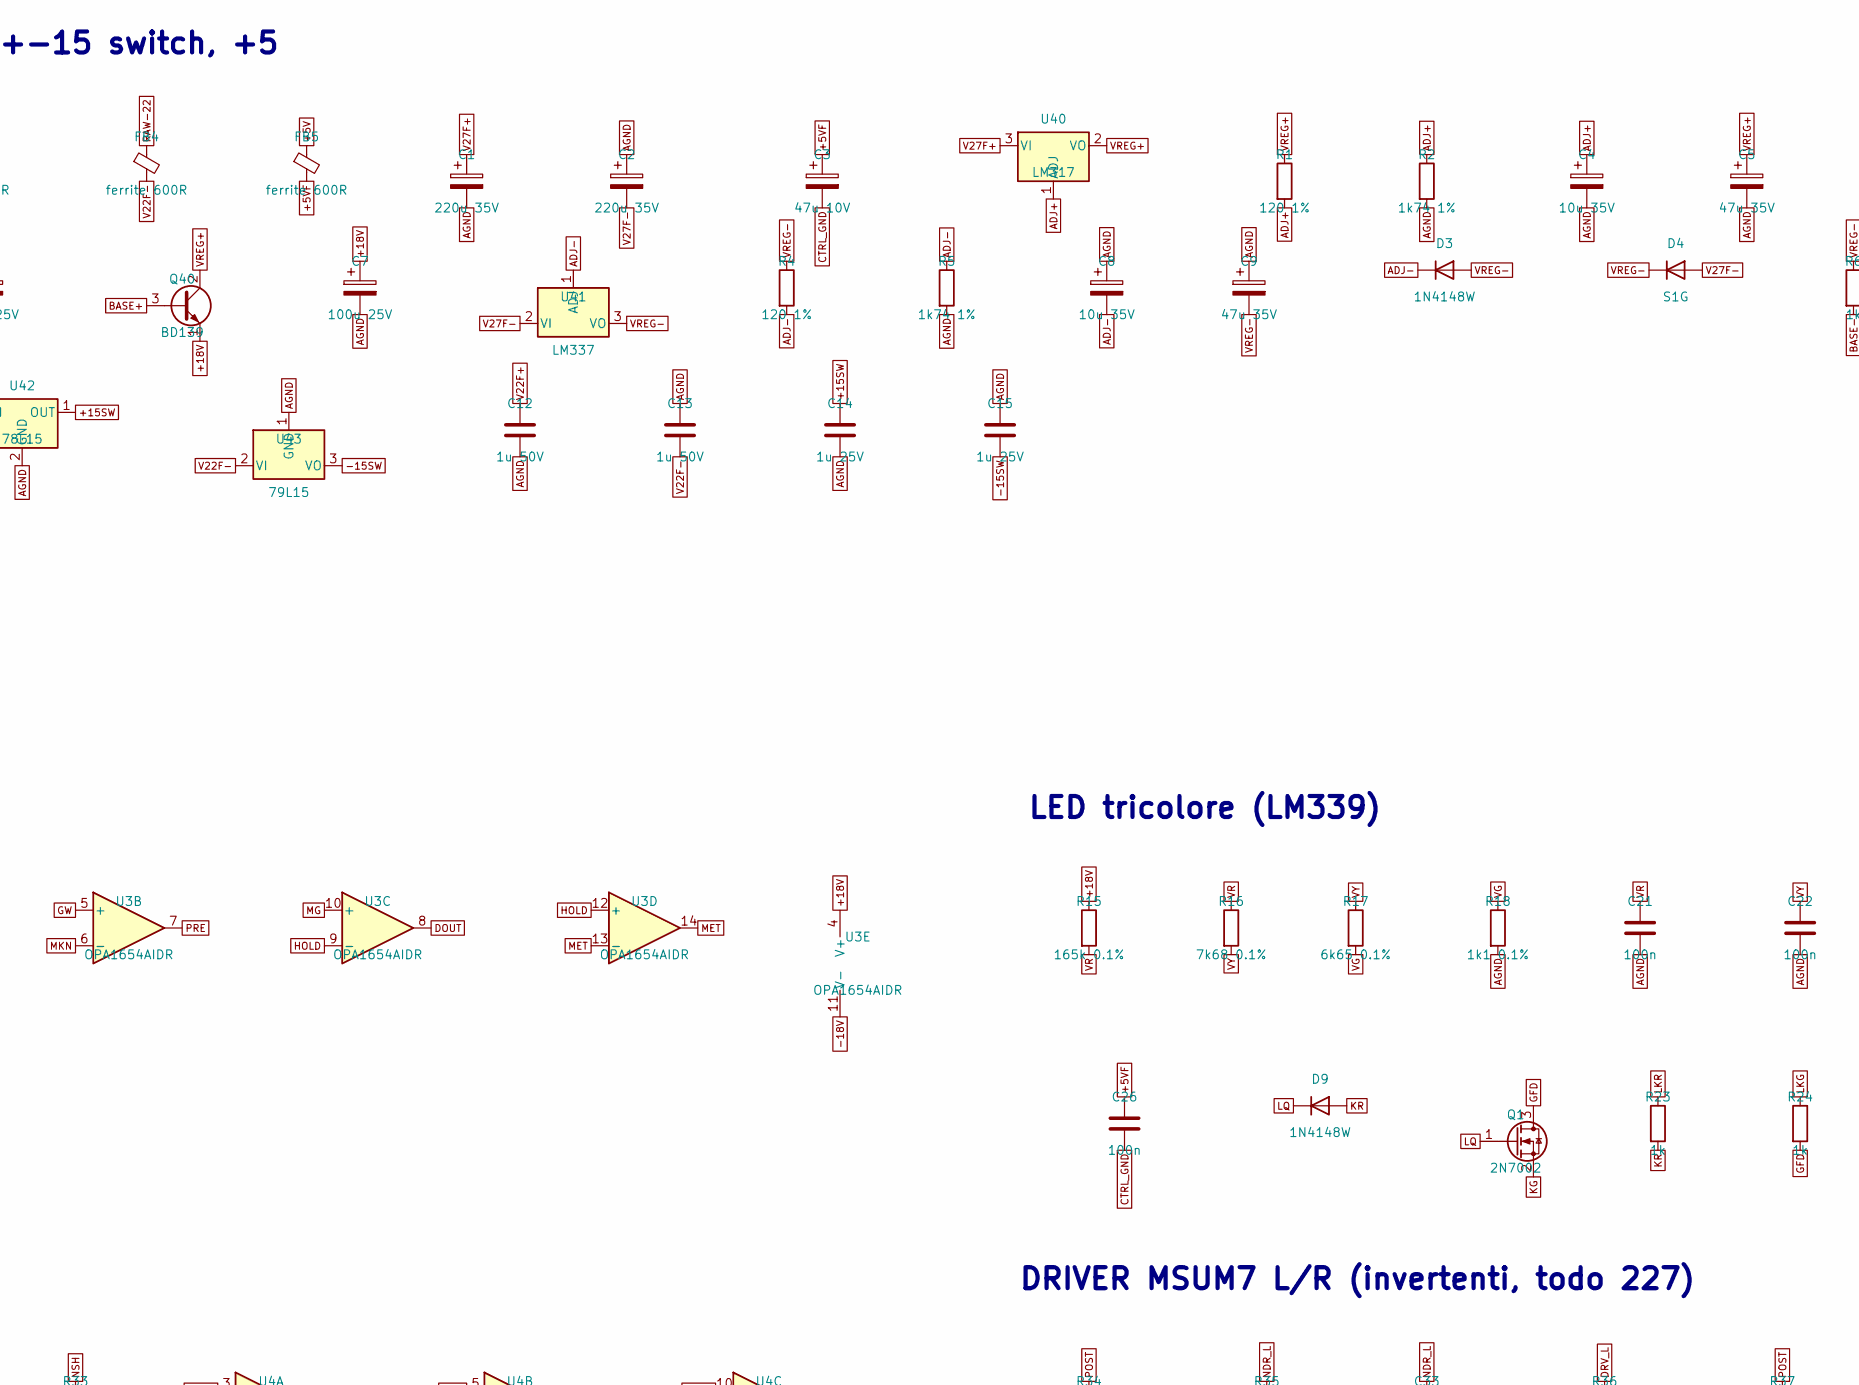
[picture p57: schematic mono.kicad_sch, maelcum MONO (dec. 97) - bozza v0.1, part in row 1, column 2]

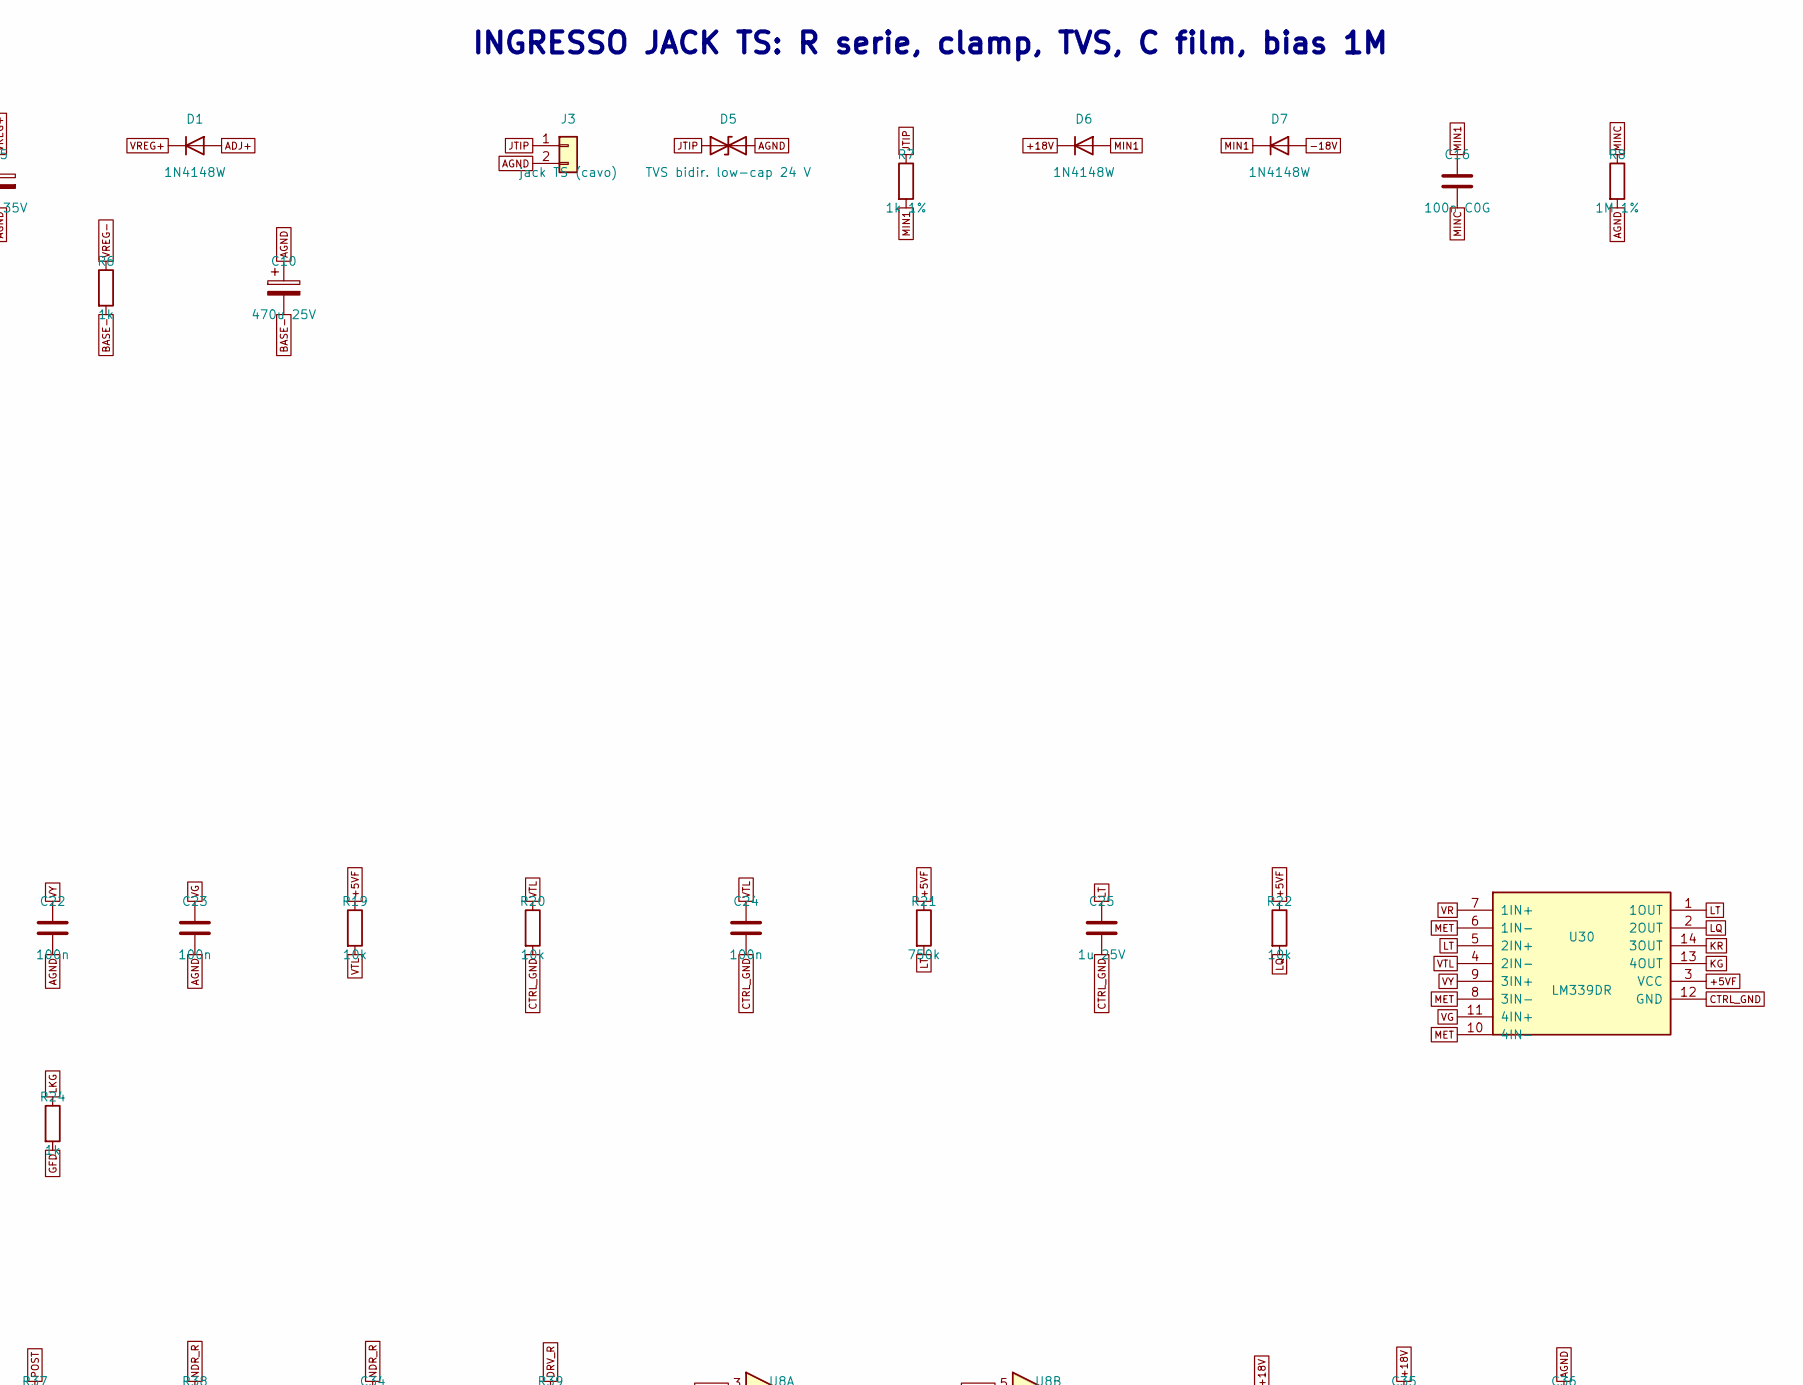
[picture p58: schematic mono.kicad_sch, maelcum MONO (dec. 97) - bozza v0.1, part in row 1, column 3]

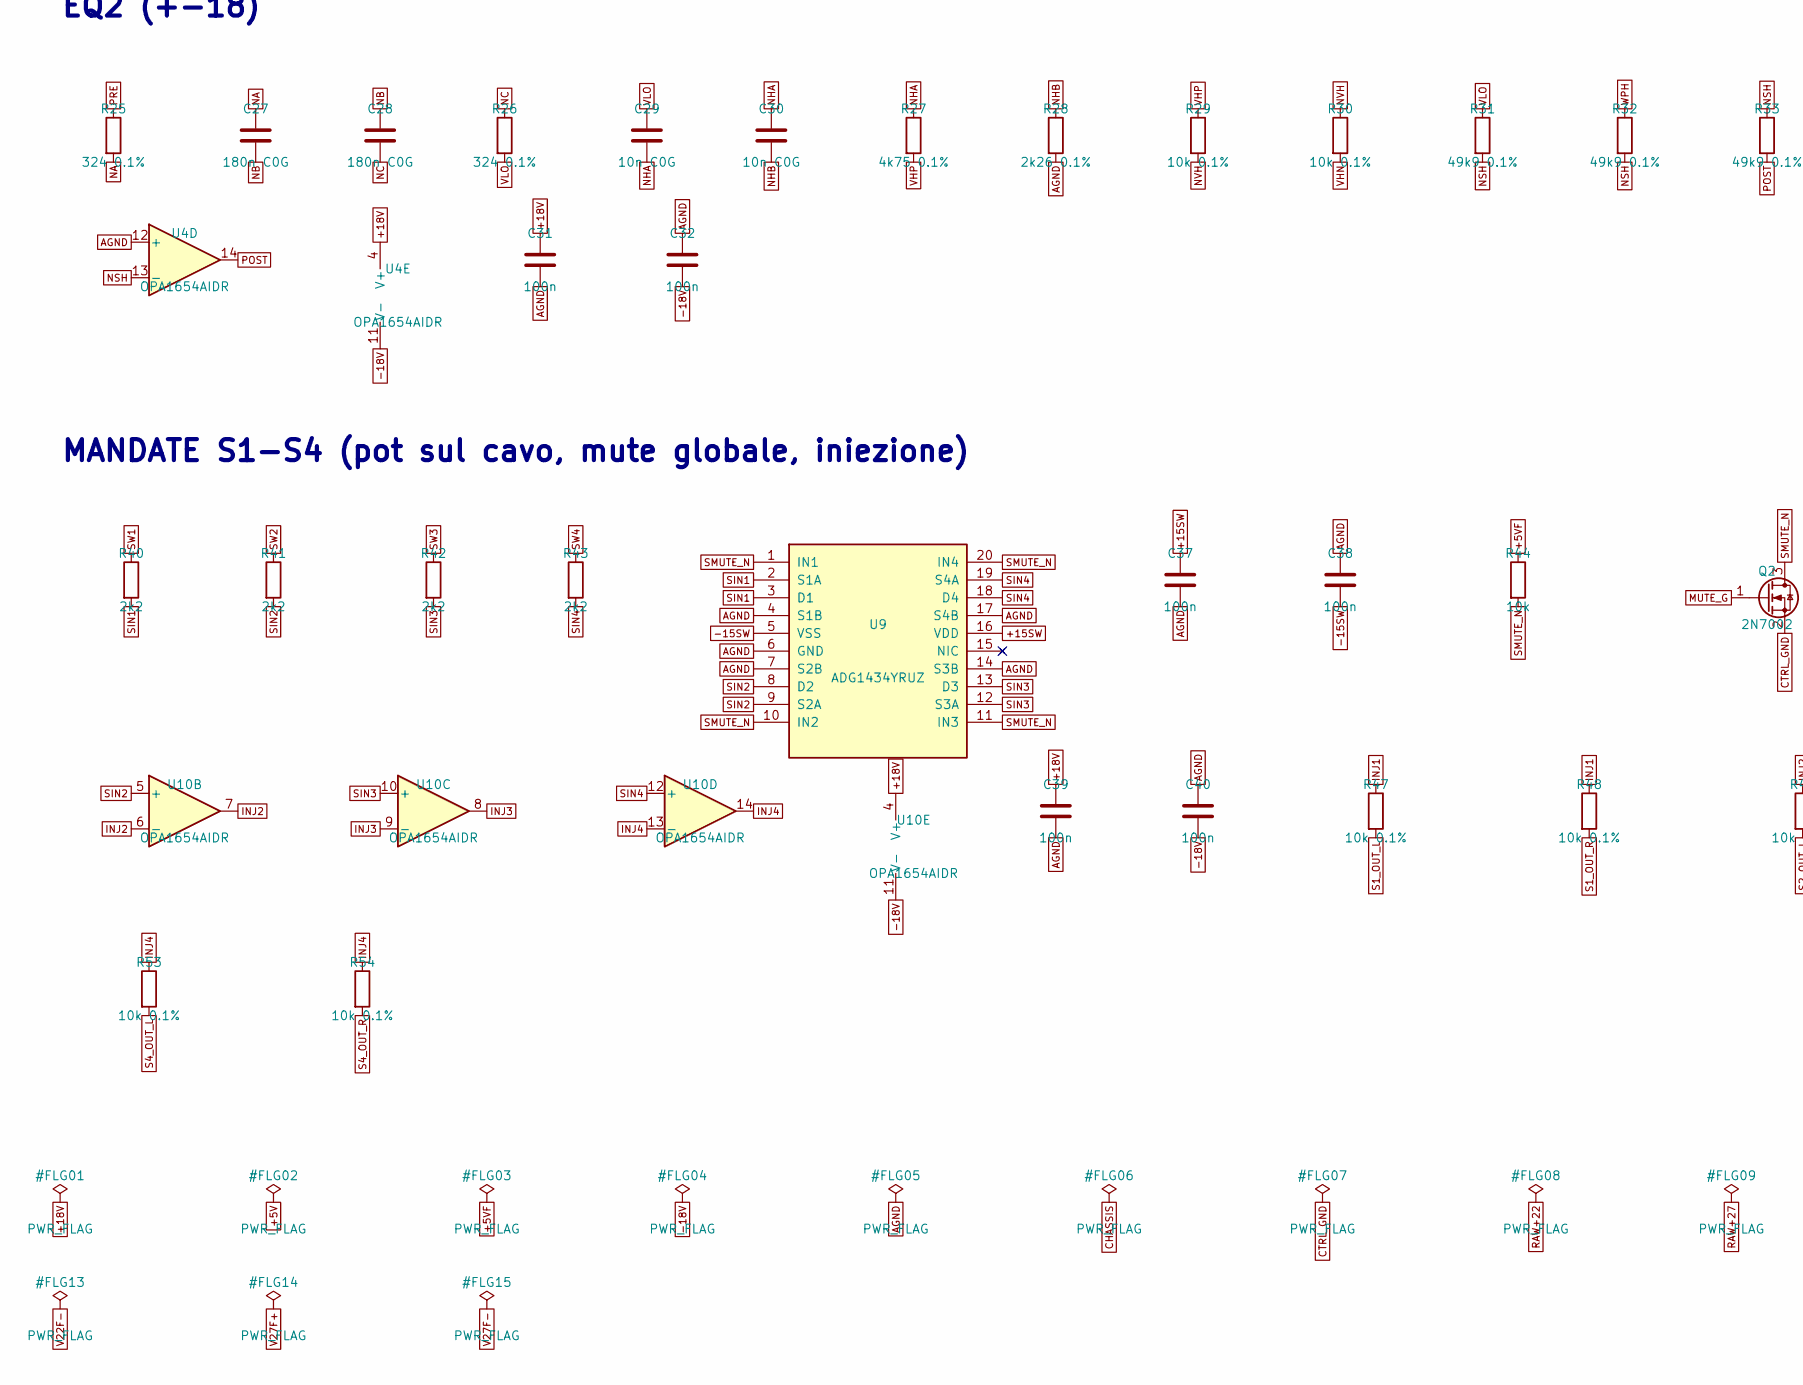
[picture p59: schematic mono.kicad_sch, maelcum MONO (dec. 97) - bozza v0.1, part in row 2, column 1]

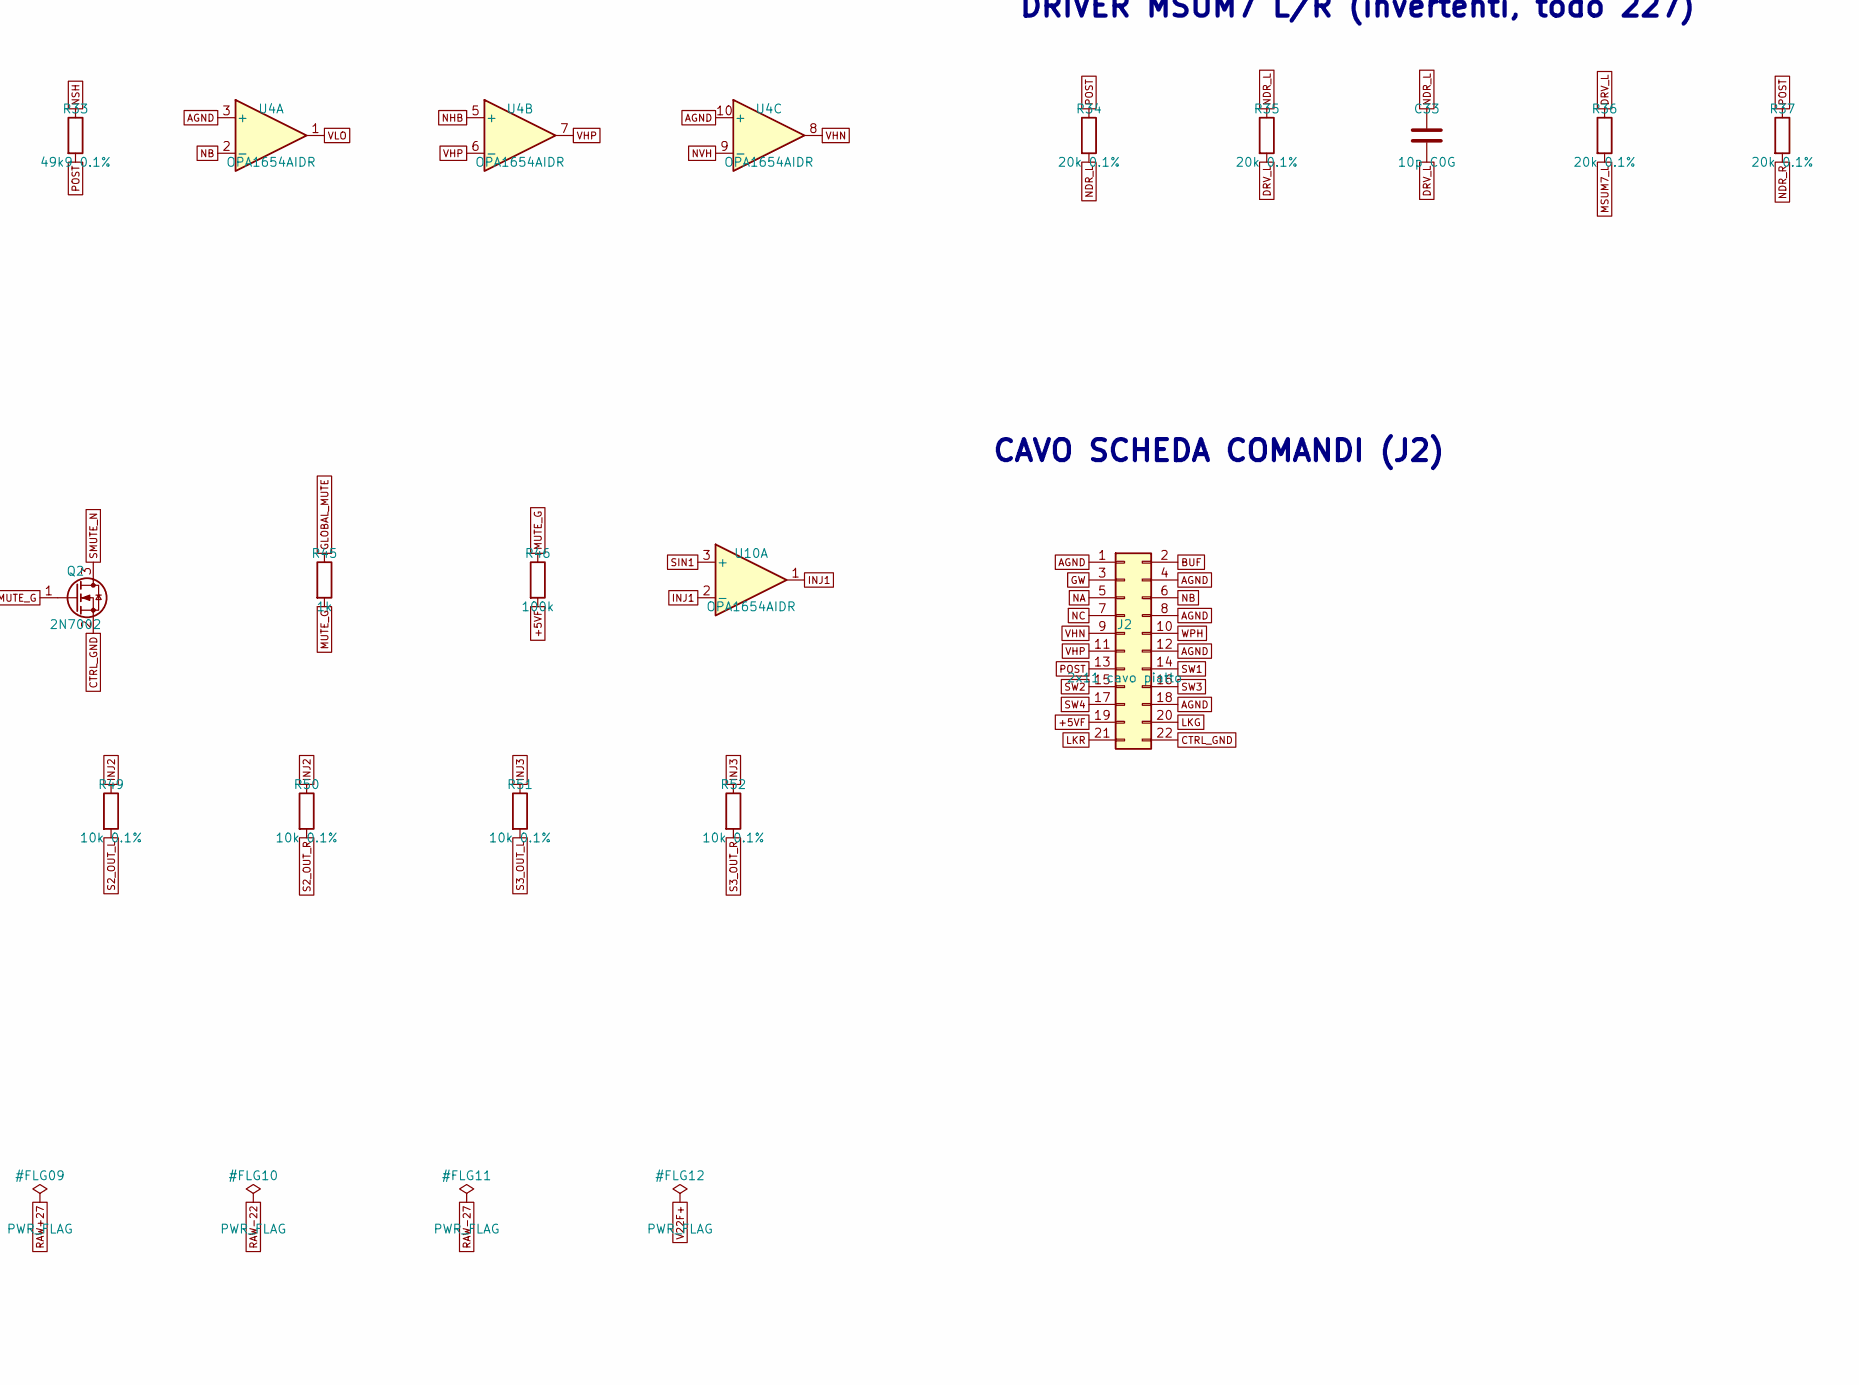
[picture p60: schematic mono.kicad_sch, maelcum MONO (dec. 97) - bozza v0.1, part in row 2, column 2]

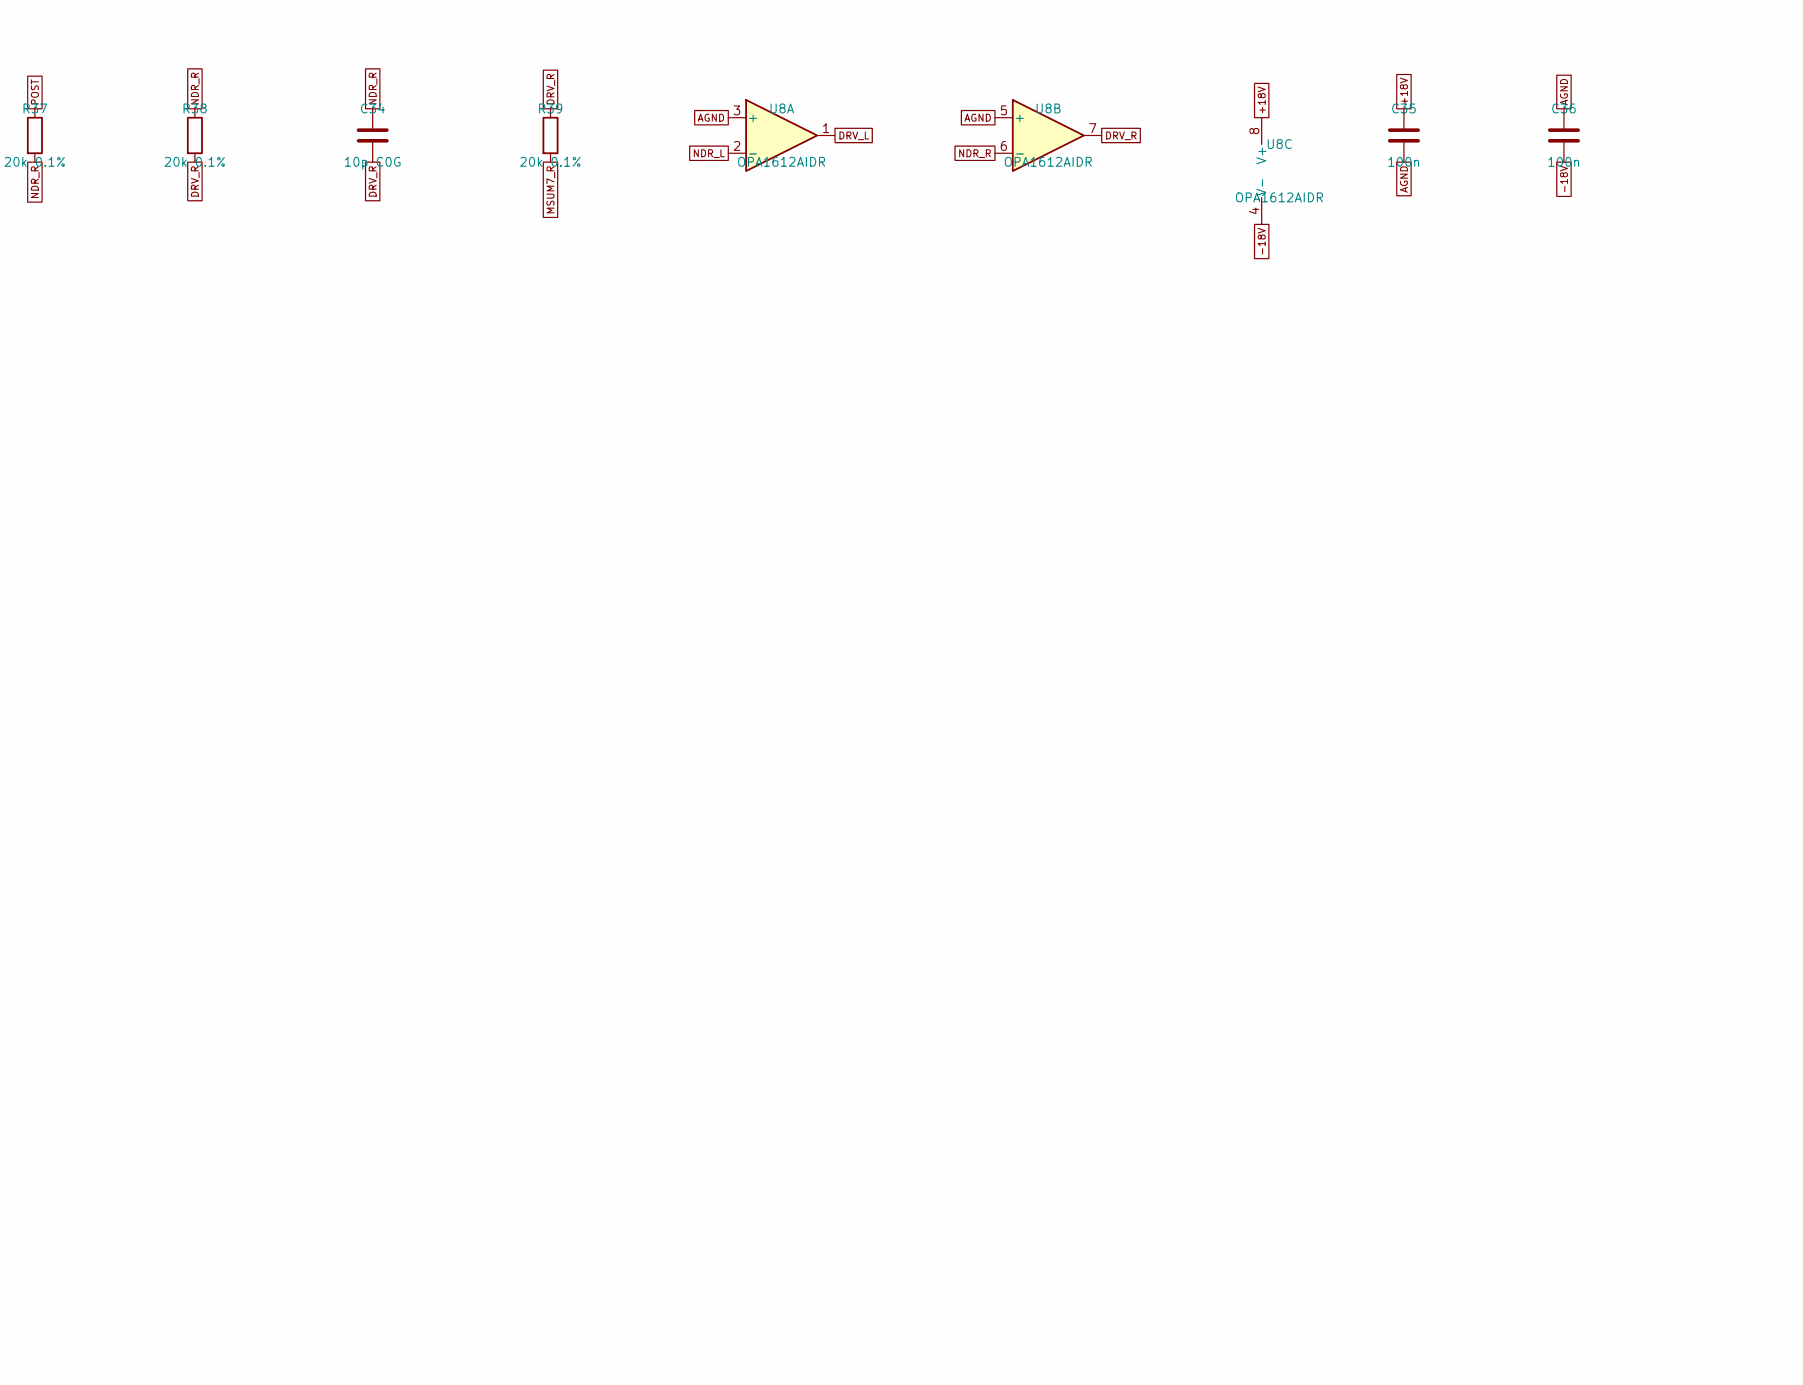
[picture p61: schematic mono.kicad_sch, maelcum MONO (dec. 97) - bozza v0.1, part in row 2, column 3]

Parts:
C1, C2: 220u 35V; CP_Radial_D8.0mm_P3.50mm
C3: 47u 10V; CP_Radial_D5.0mm_P2.00mm
C4, C8: 10u 35V; CP_Radial_D5.0mm_P2.00mm
C5, C9: 47u 35V; CP_Radial_D6.3mm_P2.50mm
C6, C10: 470u 25V; CP_Radial_D8.0mm_P3.50mm
C7, C11: 100u 25V; CP_Radial_D6.3mm_P2.50mm
C12, C13: 1u 50V; C_1206_3216Metric
C14, C15, C25: 1u 25V; C_1206_3216Metric
C16, C18: 100n C0G; C_1206_3216Metric
C17: 47p C0G; C_0805_2012Metric
C19, C20, C21, C22, C23, C24, C26, C31, C32, C35, C36, C37, C38, C39, C40: 100n; C_0805_2012Metric
C27, C28: 180n C0G; C_1206_3216Metric
C29, C30: 10n C0G; C_1206_3216Metric
C33, C34: 10p C0G; C_0805_2012Metric
D1, D3, D6, D7, D8, D9: 1N4148W; D_SOD-123
D2, D4: S1G; D_SMA
D5: TVS bidir. low-cap 24 V; D_SOD-323
FB1, FB2, FB3, FB4, FB5: ferrite 600R; L_1206_3216Metric
H1, H2: CHASSIS; MountingHole_3.2mm_M3_Pad
J1: C96 maschio; DIN41612_C_3x32_Male_Horizontal_THT
J2: 2x11 cavo piatto; PinHeader_2x11_P2.54mm_Vertical
J3: jack TS (cavo); PinHeader_1x02_P2.54mm_Vertical
Q1, Q2: 2N7002; SOT-23
Q40: BD139; TO-126-3_Vertical
Q41: BD140; TO-126-3_Vertical
R1, R4: 120 1%; R_0805_2012Metric
R2, R5: 1k74 1%; R_0805_2012Metric
R3, R6, R13, R23, R24, R45: 1k; R_0805_2012Metric
R7: 1k 1%; R_0805_2012Metric
R8: 1M 1%; R_0805_2012Metric
R9: 2k15 0.1%; R_0805_2012Metric
R10: 1k 0.1%; R_0805_2012Metric
R11, R29, R30, R47, R48, R49, R50, R51, R52, R53, R54: 10k 0.1%; R_0805_2012Metric
R12: 2k49 0.1%; R_0805_2012Metric
R14: 3M; R_0805_2012Metric
R15: 165k 0.1%; R_0805_2012Metric
R16: 7k68 0.1%; R_0805_2012Metric
R17: 6k65 0.1%; R_0805_2012Metric
R18: 1k1 0.1%; R_0805_2012Metric
R19, R20, R22, R44: 10k; R_0805_2012Metric
R21: 750k; R_0805_2012Metric
R25, R26: 324 0.1%; R_0805_2012Metric
R27: 4k75 0.1%; R_0805_2012Metric
R28: 2k26 0.1%; R_0805_2012Metric
R31, R32, R33: 49k9 0.1%; R_0805_2012Metric
R34, R35, R36, R37, R38, R39: 20k 0.1%; R_0805_2012Metric
R40, R41, R42, R43: 2k2; R_0805_2012Metric
R46: 100k; R_0805_2012Metric
U3, U4, U10: OPA1654AIDR; SOIC-14_3.9x8.7mm_P1.27mm
U8: OPA1612AIDR; SOIC-8_3.9x4.9mm_P1.27mm
U9: ADG1434YRUZ; TSSOP-20_4.4x6.5mm_P0.65mm
U30: LM339DR; SOIC-14_3.9x8.7mm_P1.27mm
U40: LM317; TO-220-3_Vertical
U41: LM337; TO-220-3_Vertical
U42: 78L15; SOT-89-3
U43: 79L15; SOT-89-3

Connections:
+5V: FB5.1, J1.a21, J1.a22
+5VF: C3.1, C26.1, FB5.2, J2.19, R19.1, R21.1, R22.1, R44.1, R46.2, U30.3 (VCC)
+15SW: C14.1, C37.1, U9.16 (VDD), U42.1 (OUT)
+18V: C7.1, C19.1, C31.1, C35.1, C39.1, D6.1 (K), Q40.1 (E), R15.1, U3.4 (V+), U4.4 (V+), U8.8 (V+), U10.4 (V+)
-15SW: C15.2, C38.2, U9.5 (VSS), U43.3 (VO)
-18V: C11.2, C20.2, C32.2, C36.2, C40.2, D7.2 (A), Q41.1 (E), U3.11 (V-), U4.11 (V-), U8.4 (V-), U10.11 (V-)
ADJ+: C4.1, D1.2 (A), R1.2, R2.1, U40.1 (ADJ)
ADJ-: C8.2, D3.1 (K), R4.2, R5.1, U41.1 (ADJ)
AGND: C1.2, C2.1, C4.2, C5.2, C6.2, C7.2, C8.1, C9.1, C10.1, C11.1, C12.2, C13.1, C14.2, C15.1, C18.2, C19.2, C20.1, C21.2, C22.2, C23.2, C31.2, C32.1, C35.2, C36.1, C37.2, C38.1, C39.2, C40.1, D5.2 (A2), J1.a13, J1.a14, J1.a15, J1.a16, J1.a17, J1.a18, J1.a19, J1.a20, J1.b3, J1.b6, J1.b9, J1.b12, J1.b15, J1.b18, J1.b21, J1.b24, J1.b27, J1.b30, J2.1, J2.4, J2.8, J2.12, J2.18, J3.2, R2.2, R5.2, R8.2, R10.2, R12.2, R14.2, R18.2, R28.2, U4.3 (+), U4.10 (+), U4.12 (+), U8.3 (+), U8.5 (+), U9.4 (S1B), U9.6 (GND), U9.7 (S2B), U9.14 (S3B), U9.17 (S4B), U42.2 (GND), U43.1 (GND)
BASE+: C6.1, Q40.3 (B), R3.2
BASE-: C10.2, Q41.3 (B), R6.2
BUF: J2.2, U3.1, U3.2 (-)
CHASSIS: H1.1, H2.1, J1.a25, J1.a26
CTRL_GND: C3.2, C24.2, C25.2, C26.2, J1.a23, J1.a24, J1.c16, J1.c20, J1.c24, J1.c28, J2.22, Q2.2 (S), R20.2, U30.12 (GND)
D1A: D8.2 (A), R13.2
DOUT: C17.1, R13.1, U3.8
DRV_L: C33.2, R35.2, R36.1, U8.1
DRV_R: C34.2, R38.2, R39.1, U8.7
GFD: Q1.3 (D), R24.2
GLOBAL_MUTE: J1.c9, R45.1
GW: J2.3, U3.5 (+)
HOLD: C17.2, C18.1, D8.1 (K), R14.1, U3.9 (-), U3.12 (+)
INJ1: R47.1, R48.1, U10.1, U10.2 (-)
INJ2: R49.1, R50.1, U10.6 (-), U10.7
INJ3: R51.1, R52.1, U10.8, U10.9 (-)
INJ4: R53.1, R54.1, U10.13 (-), U10.14
JTIP: D5.1 (A1), J3.1, R7.1
KG: Q1.2 (S), U30.13 (4OUT)
KR: D9.2 (A), R23.2, U30.14 (3OUT)
LKG: J2.20, R24.1
LKR: J2.21, R23.1
LQ: D9.1 (K), Q1.1 (G), R22.2, U30.2 (2OUT)
LT: C25.1, R21.2, U30.1 (1OUT), U30.5 (2IN+)
MET: U3.13 (-), U3.14, U30.6 (1IN-), U30.8 (3IN-), U30.10 (4IN-)
MG: R11.2, R12.1, U3.10 (+)
MIN1: C16.1, D6.2 (A), D7.1 (K), R7.2
MINC: C16.2, R8.1, U3.3 (+)
MKN: R9.2, R10.1, U3.6 (-)
MSUM7_L: J1.b1, R36.2
MSUM7_R: J1.b2, R39.2
MUTE_G: Q2.1 (G), R45.2, R46.1
NA: C27.1, J2.5, R25.2
NB: C27.2, C28.1, J2.6, U4.2 (-)
NC: C28.2, J2.7, R26.1
NDR_L: C33.1, R34.2, R35.1, U8.2 (-)
NDR_R: C34.1, R37.2, R38.1, U8.6 (-)
NHA: C29.2, C30.1, R27.1
NHB: C30.2, R28.1, U4.5 (+)
NSH: R31.2, R32.2, R33.1, U4.13 (-)
NVH: R29.2, R30.1, U4.9 (-)
POST: J2.13, R33.2, R34.1, R37.1, U4.14
PRE: R9.1, R11.1, R25.1, U3.7
RAW+22: FB3.1, J1.a5, J1.a6
RAW+27: FB1.1, J1.a1, J1.a2
RAW-22: FB4.1, J1.a7, J1.a8
RAW-27: FB2.1, J1.a3, J1.a4
S1_OUT_L: J1.b4, R47.2
S1_OUT_R: J1.b5, R48.2
S2_OUT_L: J1.b7, R49.2
S2_OUT_R: J1.b8, R50.2
S3_OUT_L: J1.b10, R51.2
S3_OUT_R: J1.b11, R52.2
S4_OUT_L: J1.b13, R53.2
S4_OUT_R: J1.b14, R54.2
SIN1: R40.2, U9.2 (S1A), U9.3 (D1), U10.3 (+)
SIN2: R41.2, U9.8 (D2), U9.9 (S2A), U10.5 (+)
SIN3: R42.2, U9.12 (S3A), U9.13 (D3), U10.10 (+)
SIN4: R43.2, U9.18 (D4), U9.19 (S4A), U10.12 (+)
SMUTE_N: Q2.3 (D), R44.2, U9.1 (IN1), U9.10 (IN2), U9.11 (IN3), U9.20 (IN4)
SW1: J2.14, R40.1
SW2: J2.15, R41.1
SW3: J2.16, R42.1
SW4: J2.17, R43.1
V22F+: C12.1, FB3.2, U42.3 (IN)
V22F-: C13.2, FB4.2, U43.2 (VI)
V27F+: C1.1, D2.1 (K), FB1.2, U40.3 (VI)
V27F-: C2.2, D4.2 (A), FB2.2, U41.2 (VI)
VG: C23.1, R17.2, R18.1, U30.11 (4IN+)
VHN: J2.9, R30.2, U4.8
VHP: J2.11, R27.2, R29.1, U4.6 (-), U4.7
VLO: C29.1, R26.2, R31.1, U4.1
VR: C21.1, R15.2, R16.1, U30.7 (1IN+)
VREG+: C5.1, D1.1 (K), D2.2 (A), Q40.2 (C), R1.1, R3.1, U40.2 (VO)
VREG-: C9.2, D3.2 (A), D4.1 (K), Q41.2 (C), R4.1, R6.1, U41.3 (VO)
VTL: C24.1, R19.2, R20.1, U30.4 (2IN-)
VY: C22.1, R16.2, R17.1, U30.9 (3IN+)
WPH: J2.10, R32.1

Notes on the sheet:
BACKPLANE C96 (classe MIC/GEN, MSUM7)
ALIMENTAZIONE +-18 audio, +-15 switch, +5
INGRESSO JACK TS: R serie, clamp, TVS, C film, bias 1M
BUFFER, MAKE-UP +10 dB, DETECTOR del LED (OPA1654)
LED tricolore (LM339)
EQ2 (+-18)
DRIVER MSUM7 L/R (invertenti, todo 227)
MANDATE S1-S4 (pot sul cavo, mute globale, iniezione)
CAVO SCHEDA COMANDI (J2)

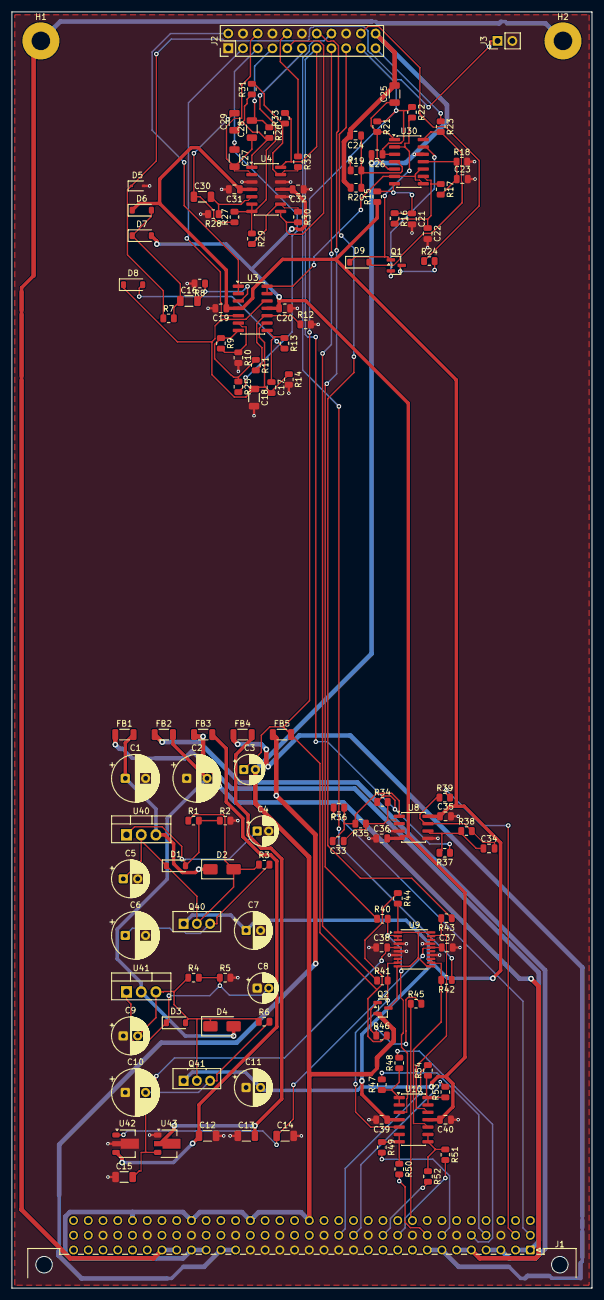
[picture p62: board mono.kicad_pcb from above]

Board: 4 copper layers, 100.0 x 220.0 mm, 127 parts (0 on the bottom side), 87 nets.
