dj-filippo241/maelcum_mixer/pcb/backplane/t2/backplane-t2.kicad_pcb

## KiCad design pcb/backplane/t2/backplane-t2.kicad_pcb (2026-11-12)

Schematic: backplane-t2.kicad_sch, maelcum backplane T2 (canali: FILTRO, 4 CANALI, 4 FX-SEND) …

Parts:
C1, C3, C5, C7, C9, C11, C13, C15, C17, C19, C21, C23, C25, C27, C29, C31, C33, C35, C37, C39, C41, C43, C45, C47, C49, C51, C53, C55, C57, C59, C61, C63, C65, C67, C69, C71, C73, C75, C77, C79, C81, C83, C85, C87, C89, C91, C93, C95, C97, C99: 100n 50V; C_0805_2012Metric
C2, C4, C6, C8, C10, C12, C14, C16, C18, C20, C22, C24, C26, C28, C30, C32, C34, C36, C38, C40, C42, C44, C46, C48, C50, C52, C54, C56, C58, C60, C62, C64, C66, C68, C70, C72, C74, C76, C78, C80, C82, C84, C86, C88, C90, C92, C94, C96, C98, C100: 10u 50V X7R; C_1206_3216Metric
F1, F11, F21, F31: PTC 0.2 A; Fuse_1812_4532Metric
F2, F4, F8, F10, F12, F14, F18, F20, F22, F24, F28, F30, F32, F34, F38, F40, F41, F46: PTC 0.1 A; Fuse_1812_4532Metric
F3, F5, F13, F15, F23, F25, F33, F35, F42, F43, F44, F45, F47, F48, F49, F50: PTC 0.3 A; Fuse_1812_4532Metric
F6, F7, F9, F16, F17, F19, F26, F27, F29, F36, F37, F39: PTC 0.05 A; Fuse_1812_4532Metric
H1, H2, H3, H4, H5: CHASSIS; MountingHole_3.2mm_M3_Pad
JC1: cavo C1 T1-T2 (VE); IDC-Header_2x05_P2.54mm_Vertical
JC2: cavo C2 T1-T2 (pilotato); IDC-Header_2x05_P2.54mm_Vertical
JC3: cavo C3 T2-T3 (pilotato); IDC-Header_2x11_P2.54mm_Vertical
JC4: cavo C4 T2-T4 (VE); IDC-Header_2x09_P2.54mm_Vertical
JCH1: C96 femmina CH1; DIN41612_C_3x32_Female_Vertical_THT
JCH2: C96 femmina CH2; DIN41612_C_3x32_Female_Vertical_THT
JCH3: C96 femmina CH3; DIN41612_C_3x32_Female_Vertical_THT
JCH4: C96 femmina CH4; DIN41612_C_3x32_Female_Vertical_THT
JFIL1: C96 femmina FIL1; DIN41612_C_3x32_Female_Vertical_THT
JFIL2: C96 femmina FIL2; DIN41612_C_3x32_Female_Vertical_THT
JP2: potenza P2 T1-T2; Molex_Mini-Fit_Jr_5566-10A2_2x05_P4.20mm_Vertical
JSEND1: C96 femmina SEND1; DIN41612_C_3x32_Female_Vertical_THT
JSEND2: C96 femmina SEND2; DIN41612_C_3x32_Female_Vertical_THT
JSEND3: C96 femmina SEND3; DIN41612_C_3x32_Female_Vertical_THT
JSEND4: C96 femmina SEND4; DIN41612_C_3x32_Female_Vertical_THT

Connections:
+5V: F1.1, F6.1, F11.1, F16.1, F21.1, F26.1, F31.1, F36.1, F41.1, F46.1, JP2.5
+5V_CH1: C1.1, C2.1, F1.2, JCH1.a21, JCH1.a22
+5V_CH2: C21.1, C22.1, F11.2, JCH2.a21, JCH2.a22
+5V_CH3: C41.1, C42.1, F21.2, JCH3.a21, JCH3.a22
+5V_CH4: C61.1, C62.1, F31.2, JCH4.a21, JCH4.a22
+5V_FIL1: C81.1, C82.1, F41.2, JFIL1.a21, JFIL1.a22
+5V_FIL2: C91.1, C92.1, F46.2, JFIL2.a21, JFIL2.a22
+5V_SEND1: C11.1, C12.1, F6.2, JSEND1.a21, JSEND1.a22
+5V_SEND2: C31.1, C32.1, F16.2, JSEND2.a21, JSEND2.a22
+5V_SEND3: C51.1, C52.1, F26.2, JSEND3.a21, JSEND3.a22
+5V_SEND4: C71.1, C72.1, F36.2, JSEND4.a21, JSEND4.a22
AGND: C1.2, C2.2, C3.2, C4.2, C5.2, C6.2, C7.1, C8.1, C9.1, C10.1, C11.2, C12.2, C13.2, C14.2, C15.2, C16.2, C17.1, C18.1, C19.1, C20.1, C21.2, C22.2, C23.2, C24.2, C25.2, C26.2, C27.1, C28.1, C29.1, C30.1, C31.2, C32.2, C33.2, C34.2, C35.2, C36.2, C37.1, C38.1, C39.1, C40.1, C41.2, C42.2, C43.2, C44.2, C45.2, C46.2, C47.1, C48.1, C49.1, C50.1, C51.2, C52.2, C53.2, C54.2, C55.2, C56.2, C57.1, C58.1, C59.1, C60.1, C61.2, C62.2, C63.2, C64.2, C65.2, C66.2, C67.1, C68.1, C69.1, C70.1, C71.2, C72.2, C73.2, C74.2, C75.2, C76.2, C77.1, C78.1, C79.1, C80.1, C81.2, C82.2, C83.2, C84.2, C85.2, C86.2, C87.1, C88.1, C89.1, C90.1, C91.2, C92.2, C93.2, C94.2, C95.2, C96.2, C97.1, C98.1, C99.1, C100.1, JC1.1, JC1.3, JC1.5, JC1.6, JC1.7, JC1.8, JC1.9, JC1.10, JC2.1, JC2.3, JC2.7, JC2.8, JC2.9, JC2.10, JC3.1, JC3.3, JC3.5, JC3.7, JC3.9, JC3.11, JC3.13, JC3.15, JC3.17, JC3.19, JC3.21, JC3.22, JC4.1, JC4.3, JC4.5, JC4.7, JC4.9, JC4.11, JC4.13, JC4.15, JC4.17, JC4.18, JCH1.a13, JCH1.a14, JCH1.a15, JCH1.a16, JCH1.a17, JCH1.a18, JCH1.a19, JCH1.a20, JCH1.b3, JCH1.b6, JCH1.b9, JCH1.b12, JCH1.b15, JCH1.b18, JCH1.b21, JCH1.b24, JCH1.b27, JCH1.b30, JCH2.a13, JCH2.a14, JCH2.a15, JCH2.a16, JCH2.a17, JCH2.a18, JCH2.a19, JCH2.a20, JCH2.b3, JCH2.b6, JCH2.b9, JCH2.b12, JCH2.b15, JCH2.b18, JCH2.b21, JCH2.b24, JCH2.b27, JCH2.b30, JCH3.a13, JCH3.a14, JCH3.a15, JCH3.a16, JCH3.a17, JCH3.a18, JCH3.a19, JCH3.a20, JCH3.b3, JCH3.b6, JCH3.b9, JCH3.b12, JCH3.b15, JCH3.b18, JCH3.b21, JCH3.b24, JCH3.b27, JCH3.b30, JCH4.a13, JCH4.a14, JCH4.a15, JCH4.a16, JCH4.a17, JCH4.a18, JCH4.a19, JCH4.a20, JCH4.b3, JCH4.b6, JCH4.b9, JCH4.b12, JCH4.b15, JCH4.b18, JCH4.b21, JCH4.b24, JCH4.b27, JCH4.b30, JFIL1.a13, JFIL1.a14, JFIL1.a15, JFIL1.a16, JFIL1.a17, JFIL1.a18, JFIL1.a19, JFIL1.a20, JFIL1.b3, JFIL1.b6, JFIL1.b9, JFIL1.b12, JFIL1.b15, JFIL1.b18, JFIL1.b21, JFIL1.b24, JFIL1.b27, JFIL1.b30, JFIL2.a13, JFIL2.a14, JFIL2.a15, JFIL2.a16, JFIL2.a17, JFIL2.a18, JFIL2.a19, JFIL2.a20, JP2.6, JP2.7, JP2.8, JSEND1.a13, JSEND1.a14, JSEND1.a15, JSEND1.a16, JSEND1.a17, JSEND1.a18, JSEND1.a19, JSEND1.a20, JSEND1.b3, JSEND1.b6, JSEND1.b9, JSEND1.b12, JSEND1.b15, JSEND1.b18, JSEND1.b21, JSEND1.b24, JSEND1.b27, JSEND1.b30, JSEND2.a13, JSEND2.a14, JSEND2.a15, JSEND2.a16, JSEND2.a17, JSEND2.a18, JSEND2.a19, JSEND2.a20, JSEND2.b3, JSEND2.b6, JSEND2.b9, JSEND2.b12, JSEND2.b15, JSEND2.b18, JSEND2.b21, JSEND2.b24, JSEND2.b27, JSEND2.b30, JSEND3.a13, JSEND3.a14, JSEND3.a15, JSEND3.a16, JSEND3.a17, JSEND3.a18, JSEND3.a19, JSEND3.a20, JSEND3.b3, JSEND3.b6, JSEND3.b9, JSEND3.b12, JSEND3.b15, JSEND3.b18, JSEND3.b21, JSEND3.b24, JSEND3.b27, JSEND3.b30, JSEND4.a13, JSEND4.a14, JSEND4.a15, JSEND4.a16, JSEND4.a17, JSEND4.a18, JSEND4.a19, JSEND4.a20, JSEND4.b3, JSEND4.b6, JSEND4.b9, JSEND4.b12, JSEND4.b15, JSEND4.b18, JSEND4.b21, JSEND4.b24, JSEND4.b27, JSEND4.b30
BUS_HPF_L: JCH1.b10, JCH2.b10, JCH3.b10, JCH4.b10, JFIL1.b1
BUS_HPF_R: JCH1.b11, JCH2.b11, JCH3.b11, JCH4.b11, JFIL1.b2
BUS_LPF_L: JCH1.b13, JCH2.b13, JCH3.b13, JCH4.b13, JFIL1.b4
BUS_LPF_R: JCH1.b14, JCH2.b14, JCH3.b14, JCH4.b14, JFIL1.b5
CHASSIS: H1.1, H2.1, H3.1, H4.1, H5.1, JCH1.a25, JCH1.a26, JCH2.a25, JCH2.a26, JCH3.a25, JCH3.a26, JCH4.a25, JCH4.a26, JFIL1.a25, JFIL1.a26, JFIL2.a25, JFIL2.a26, JP2.10, JSEND1.a25, JSEND1.a26, JSEND2.a25, JSEND2.a26, JSEND3.a25, JSEND3.a26, JSEND4.a25, JSEND4.a26
CTRL_GND: JC2.5, JCH1.a23, JCH1.a24, JCH1.c16, JCH1.c20, JCH1.c24, JCH1.c28, JCH2.a23, JCH2.a24, JCH2.c16, JCH2.c20, JCH2.c24, JCH2.c28, JCH3.a23, JCH3.a24, JCH3.c16, JCH3.c20, JCH3.c24, JCH3.c28, JCH4.a23, JCH4.a24, JCH4.c16, JCH4.c20, JCH4.c24, JCH4.c28, JFIL1.a23, JFIL1.a24, JFIL1.c16, JFIL1.c20, JFIL1.c24, JFIL1.c28, JFIL2.a23, JFIL2.a24, JFIL2.c16, JFIL2.c20, JFIL2.c24, JFIL2.c28, JP2.9, JSEND1.a23, JSEND1.a24, JSEND1.c16, JSEND1.c20, JSEND1.c24, JSEND1.c28, JSEND2.a23, JSEND2.a24, JSEND2.c16, JSEND2.c20, JSEND2.c24, JSEND2.c28, JSEND3.a23, JSEND3.a24, JSEND3.c16, JSEND3.c20, JSEND3.c24, JSEND3.c28, JSEND4.a23, JSEND4.a24, JSEND4.c16, JSEND4.c20, JSEND4.c24, JSEND4.c28
CUE1_L: JC3.2, JCH1.b4
CUE1_R: JC3.4, JCH1.b5
CUE2_L: JC3.6, JCH2.b4
CUE2_R: JC3.8, JCH2.b5
CUE3_L: JC3.10, JCH3.b4
CUE3_R: JC3.12, JCH3.b5
CUE4_L: JC3.14, JCH4.b4
CUE4_R: JC3.16, JCH4.b5
DJBUS_L: JC1.2, JCH1.b1, JCH2.b1, JCH3.b1, JCH4.b1, JFIL1.b7, JFIL1.b10
DJBUS_R: JC1.4, JCH1.b2, JCH2.b2, JCH3.b2, JCH4.b2, JFIL1.b8, JFIL1.b11
FILT_MODE1_0: JCH1.c1, JFIL1.c1
FILT_MODE1_1: JCH1.c2, JFIL1.c2
FILT_MODE2_0: JCH2.c1, JFIL1.c3
FILT_MODE2_1: JCH2.c2, JFIL1.c4
FILT_MODE3_0: JCH3.c1, JFIL1.c5
FILT_MODE3_1: JCH3.c2, JFIL1.c6
FILT_MODE4_0: JCH4.c1, JFIL1.c7
FILT_MODE4_1: JCH4.c2, JFIL1.c8
GLOBAL_MUTE: JC2.6, JSEND1.c9, JSEND2.c9, JSEND3.c9, JSEND4.c9
MON_L: JC2.2, JC3.18
MON_R: JC2.4, JC3.20
RAW+22: F2.1, F7.1, F12.1, F17.1, F22.1, F27.1, F32.1, F37.1, F42.1, F47.1, JP2.3
RAW+22_CH1: C3.1, C4.1, F2.2, JCH1.a5, JCH1.a6
RAW+22_CH2: C23.1, C24.1, F12.2, JCH2.a5, JCH2.a6
RAW+22_CH3: C43.1, C44.1, F22.2, JCH3.a5, JCH3.a6
RAW+22_CH4: C63.1, C64.1, F32.2, JCH4.a5, JCH4.a6
RAW+22_FIL1: C83.1, C84.1, F42.2, JFIL1.a5, JFIL1.a6
RAW+22_FIL2: C93.1, C94.1, F47.2, JFIL2.a5, JFIL2.a6
RAW+22_SEND1: C13.1, C14.1, F7.2, JSEND1.a5, JSEND1.a6
RAW+22_SEND2: C33.1, C34.1, F17.2, JSEND2.a5, JSEND2.a6
RAW+22_SEND3: C53.1, C54.1, F27.2, JSEND3.a5, JSEND3.a6
RAW+22_SEND4: C73.1, C74.1, F37.2, JSEND4.a5, JSEND4.a6
RAW+27: F3.1, F8.1, F13.1, F18.1, F23.1, F28.1, F33.1, F38.1, F43.1, F48.1, JP2.1
RAW+27_CH1: C5.1, C6.1, F3.2, JCH1.a1, JCH1.a2
RAW+27_CH2: C25.1, C26.1, F13.2, JCH2.a1, JCH2.a2
RAW+27_CH3: C45.1, C46.1, F23.2, JCH3.a1, JCH3.a2
RAW+27_CH4: C65.1, C66.1, F33.2, JCH4.a1, JCH4.a2
RAW+27_FIL1: C85.1, C86.1, F43.2, JFIL1.a1, JFIL1.a2
RAW+27_FIL2: C95.1, C96.1, F48.2, JFIL2.a1, JFIL2.a2
RAW+27_SEND1: C15.1, C16.1, F8.2, JSEND1.a1, JSEND1.a2
RAW+27_SEND2: C35.1, C36.1, F18.2, JSEND2.a1, JSEND2.a2
RAW+27_SEND3: C55.1, C56.1, F28.2, JSEND3.a1, JSEND3.a2
RAW+27_SEND4: C75.1, C76.1, F38.2, JSEND4.a1, JSEND4.a2
RAW-22: F4.1, F9.1, F14.1, F19.1, F24.1, F29.1, F34.1, F39.1, F44.1, F49.1, JP2.4
RAW-22_CH1: C7.2, C8.2, F4.2, JCH1.a7, JCH1.a8
RAW-22_CH2: C27.2, C28.2, F14.2, JCH2.a7, JCH2.a8
RAW-22_CH3: C47.2, C48.2, F24.2, JCH3.a7, JCH3.a8
RAW-22_CH4: C67.2, C68.2, F34.2, JCH4.a7, JCH4.a8
RAW-22_FIL1: C87.2, C88.2, F44.2, JFIL1.a7, JFIL1.a8
RAW-22_FIL2: C97.2, C98.2, F49.2, JFIL2.a7, JFIL2.a8
RAW-22_SEND1: C17.2, C18.2, F9.2, JSEND1.a7, JSEND1.a8
RAW-22_SEND2: C37.2, C38.2, F19.2, JSEND2.a7, JSEND2.a8
RAW-22_SEND3: C57.2, C58.2, F29.2, JSEND3.a7, JSEND3.a8
RAW-22_SEND4: C77.2, C78.2, F39.2, JSEND4.a7, JSEND4.a8
RAW-27: F5.1, F10.1, F15.1, F20.1, F25.1, F30.1, F35.1, F40.1, F45.1, F50.1, JP2.2
RAW-27_CH1: C9.2, C10.2, F5.2, JCH1.a3, JCH1.a4
RAW-27_CH2: C29.2, C30.2, F15.2, JCH2.a3, JCH2.a4
RAW-27_CH3: C49.2, C50.2, F25.2, JCH3.a3, JCH3.a4
RAW-27_CH4: C69.2, C70.2, F35.2, JCH4.a3, JCH4.a4
RAW-27_FIL1: C89.2, C90.2, F45.2, JFIL1.a3, JFIL1.a4
RAW-27_FIL2: C99.2, C100.2, F50.2, JFIL2.a3, JFIL2.a4
RAW-27_SEND1: C19.2, C20.2, F10.2, JSEND1.a3, JSEND1.a4
RAW-27_SEND2: C39.2, C40.2, F20.2, JSEND2.a3, JSEND2.a4
RAW-27_SEND3: C59.2, C60.2, F30.2, JSEND3.a3, JSEND3.a4
RAW-27_SEND4: C79.2, C80.2, F40.2, JSEND4.a3, JSEND4.a4
S1_L: JC4.2, JSEND1.b4, JSEND2.b4, JSEND3.b4, JSEND4.b4
S1_R: JC4.4, JSEND1.b5, JSEND2.b5, JSEND3.b5, JSEND4.b5
S2_L: JC4.6, JSEND1.b7, JSEND2.b7, JSEND3.b7, JSEND4.b7
S2_R: JC4.8, JSEND1.b8, JSEND2.b8, JSEND3.b8, JSEND4.b8
S3_L: JC4.10, JSEND1.b10, JSEND2.b10, JSEND3.b10, JSEND4.b10
S3_R: JC4.12, JSEND1.b11, JSEND2.b11, JSEND3.b11, JSEND4.b11
S4_L: JC4.14, JSEND1.b13, JSEND2.b13, JSEND3.b13, JSEND4.b13
S4_R: JC4.16, JSEND1.b14, JSEND2.b14, JSEND3.b14, JSEND4.b14
SEND_TAP1_L: JCH1.b7, JSEND1.b1
SEND_TAP1_R: JCH1.b8, JSEND1.b2
SEND_TAP2_L: JCH2.b7, JSEND2.b1
SEND_TAP2_R: JCH2.b8, JSEND2.b2
SEND_TAP3_L: JCH3.b7, JSEND3.b1
SEND_TAP3_R: JCH3.b8, JSEND3.b2
SEND_TAP4_L: JCH4.b7, JSEND4.b1
SEND_TAP4_R: JCH4.b8, JSEND4.b2

Notes on the sheet:
SLOT CH1 (canale)
SLOT SEND1 (fx-send)
SLOT CH2 (canale)
SLOT SEND2 (fx-send)
SLOT CH3 (canale)
SLOT SEND3 (fx-send)
SLOT CH4 (canale)
SLOT SEND4 (fx-send)
SLOT FIL1 (filtro)
SLOT FIL2 (filtro)
CAVO C1
CAVO C2
CAVO C3
CAVO C4
POTENZA P2

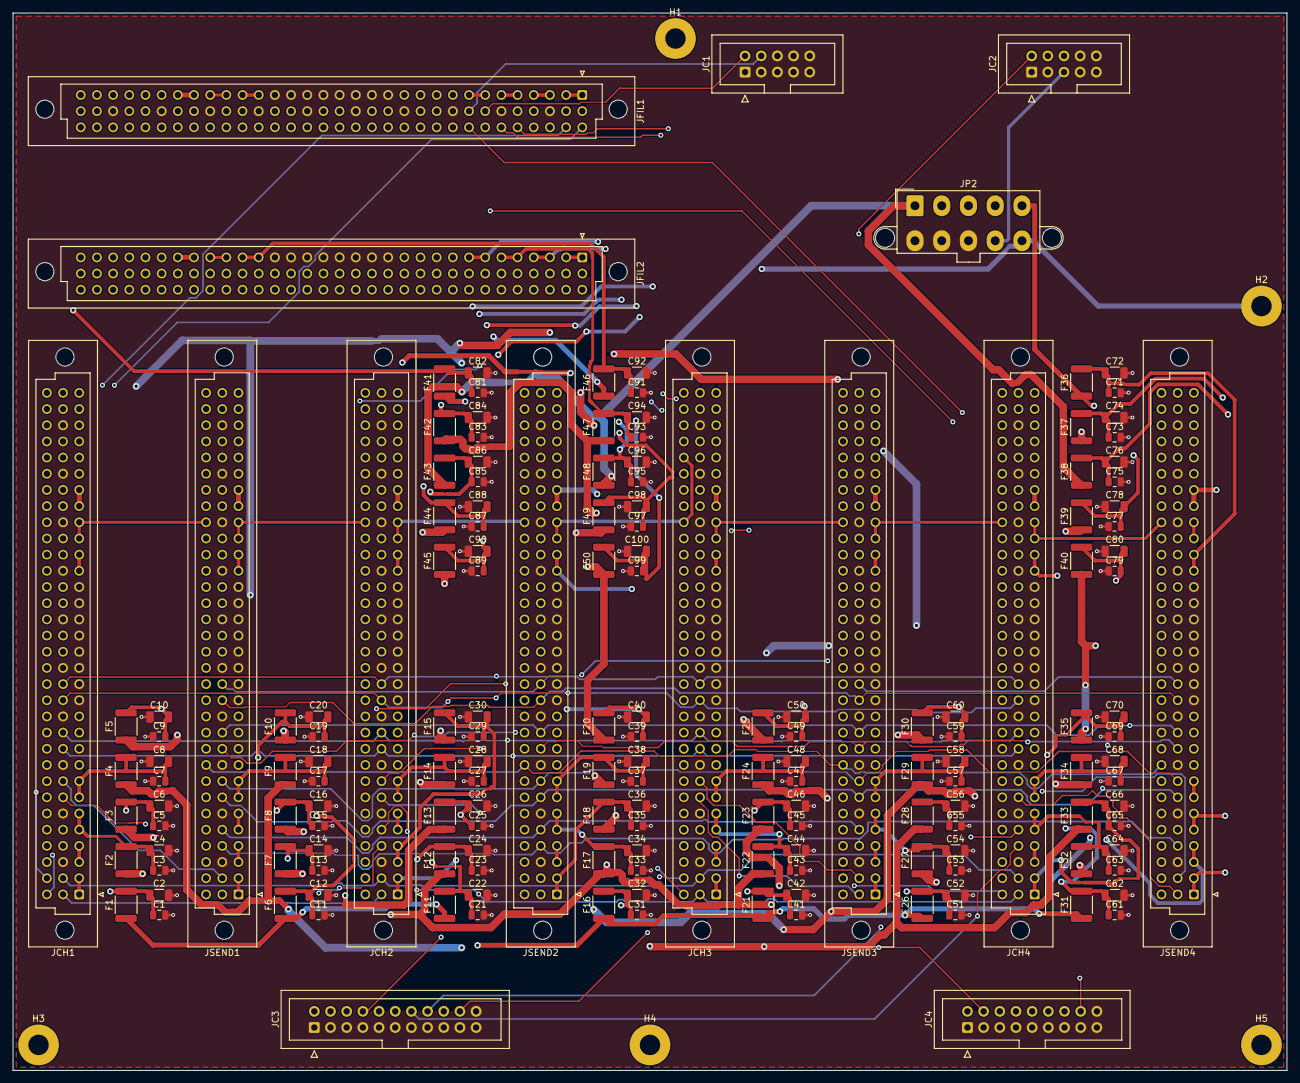
[picture p63: board backplane-t2.kicad_pcb from above]

Board: 4 copper layers, 200.0 x 166.0 mm, 170 parts (0 on the bottom side), 99 nets.
