dj-filippo241/maelcum_mixer/pcb/backplane/t3/backplane-t3.kicad_pcb

## KiCad design pcb/backplane/t3/backplane-t3.kicad_pcb (2026-11-12)

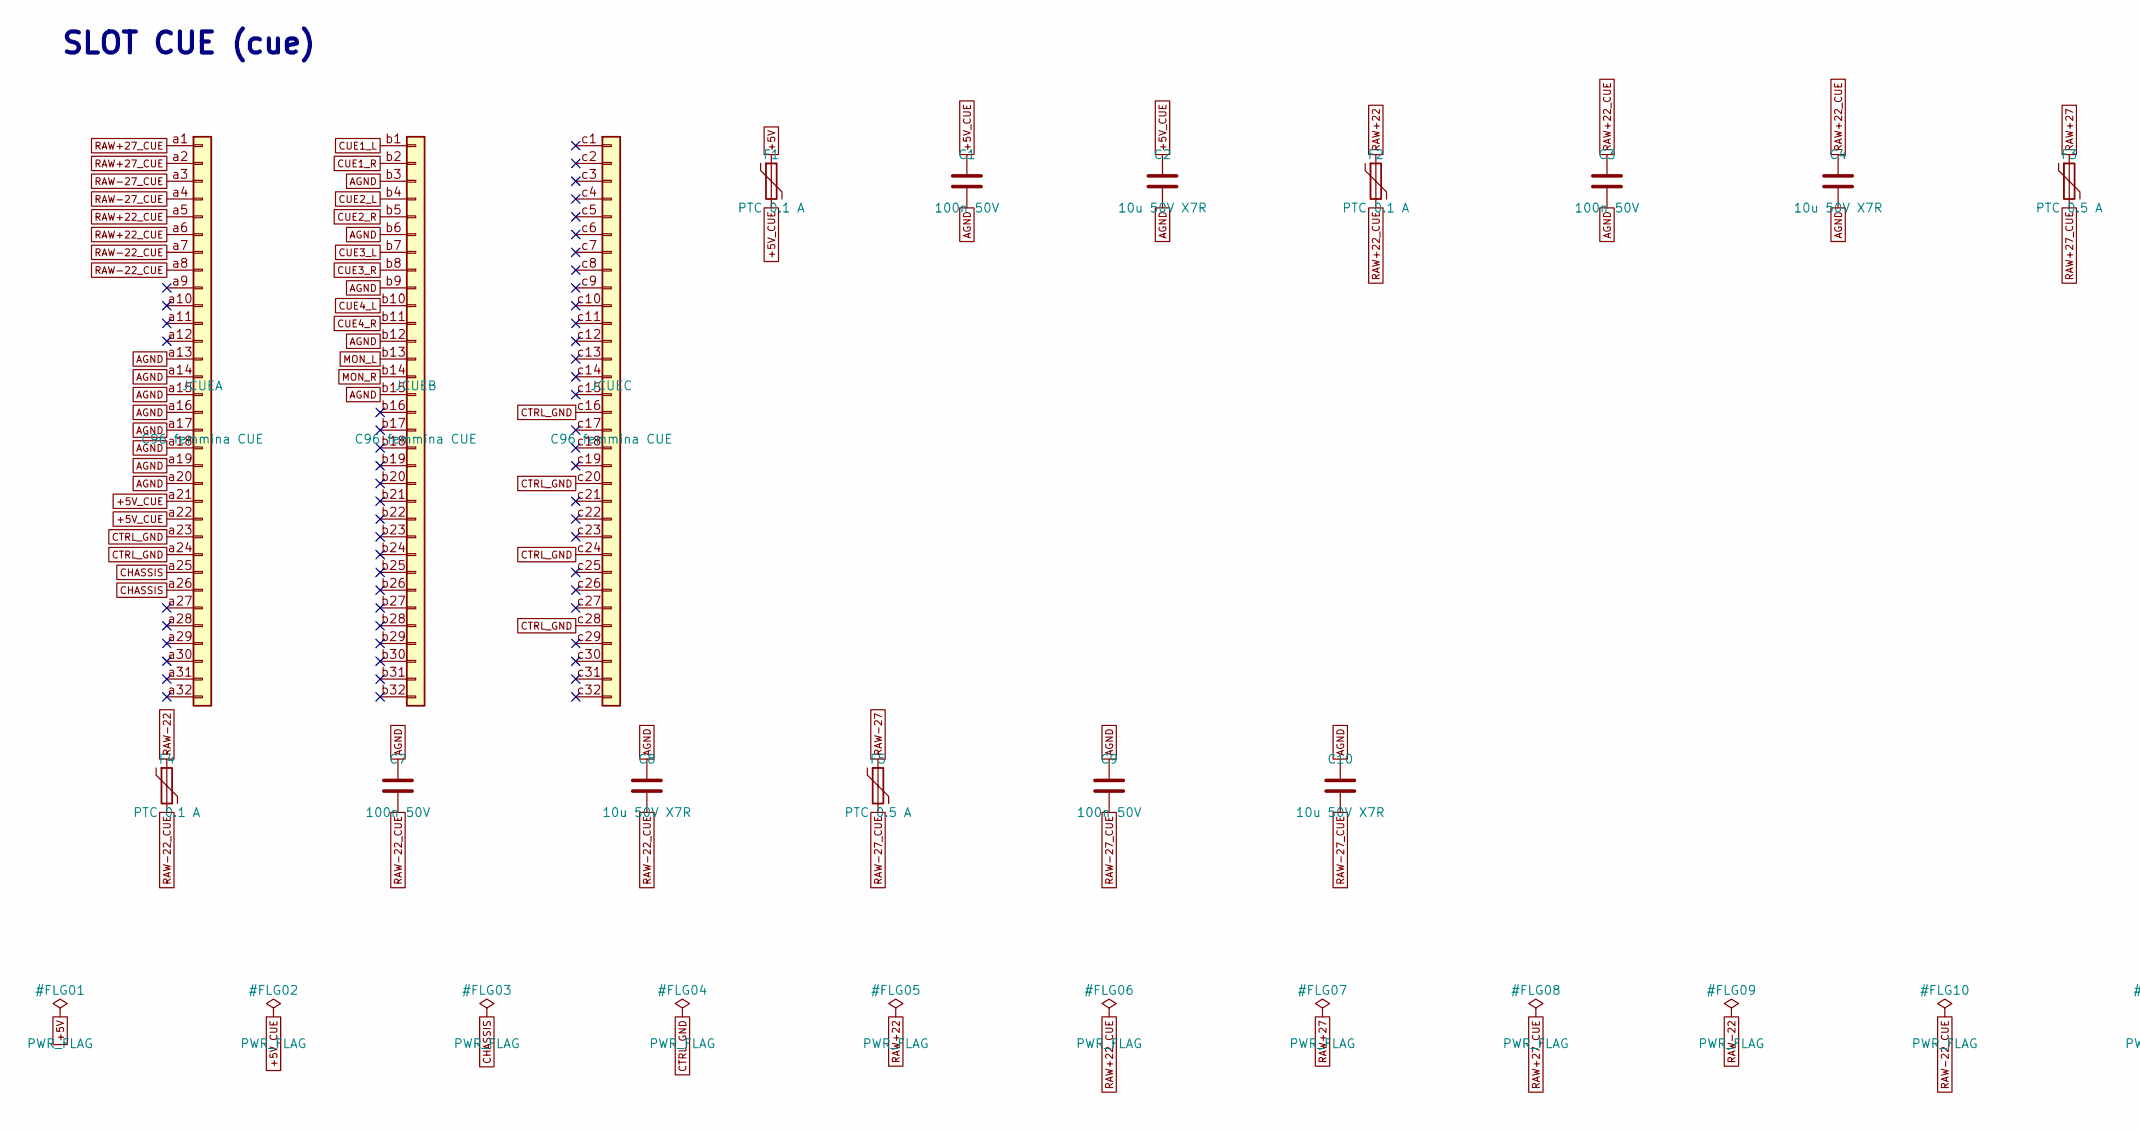
[picture p64: schematic backplane-t3.kicad_sch, maelcum backplane T3 (cuffie: CUE) - bozza v0.1, part in row 1, column 1]

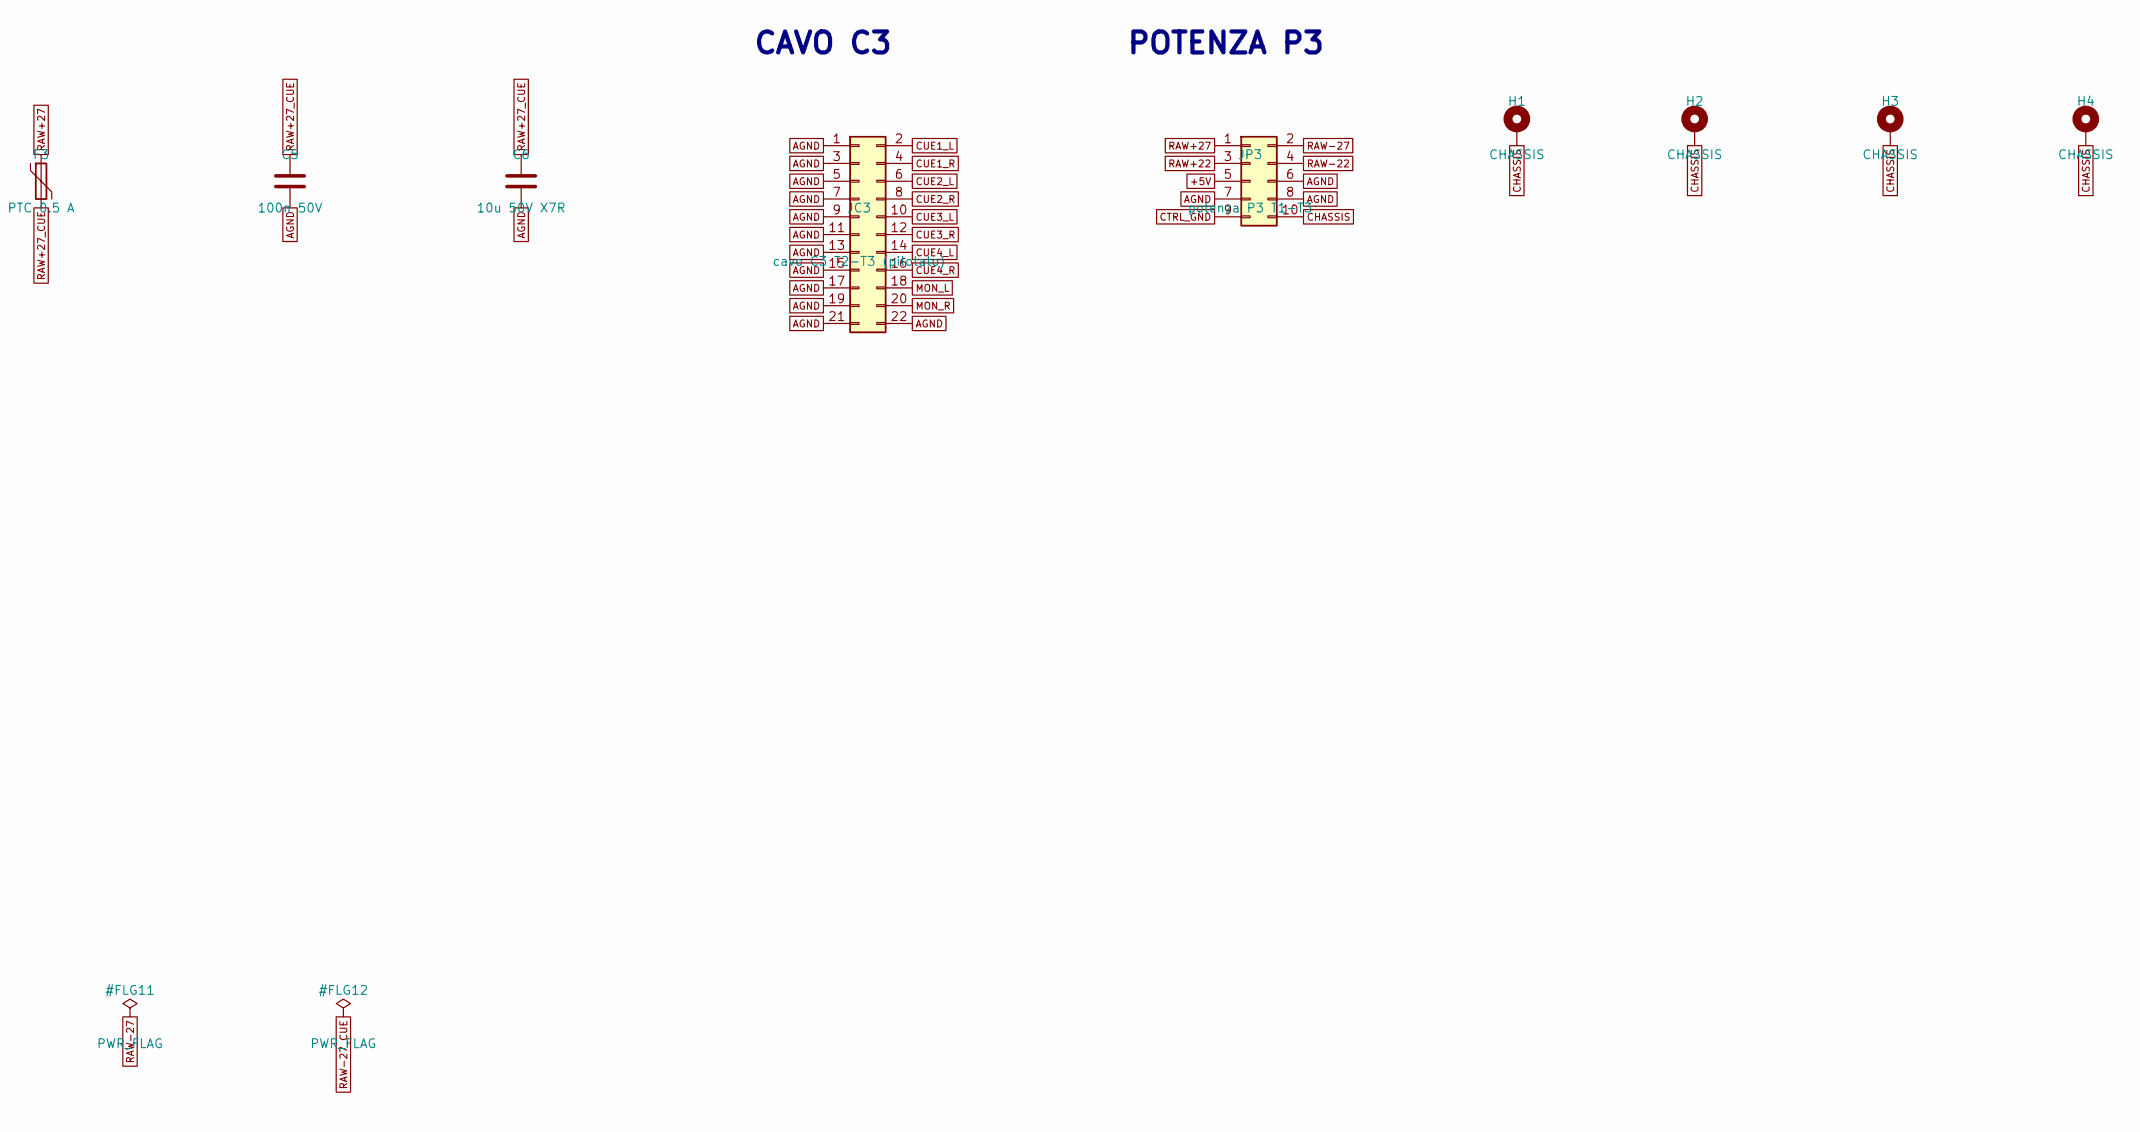
[picture p65: schematic backplane-t3.kicad_sch, maelcum backplane T3 (cuffie: CUE) - bozza v0.1, part in row 1, column 2]

Parts:
C1, C3, C5, C7, C9: 100n 50V; C_0805_2012Metric
C2, C4, C6, C8, C10: 10u 50V X7R; C_1206_3216Metric
F1, F2, F4: PTC 0.1 A; Fuse_1812_4532Metric
F3, F5: PTC 0.5 A; Fuse_1812_4532Metric
H1, H2, H3, H4: CHASSIS; MountingHole_3.2mm_M3_Pad
JC3: cavo C3 T2-T3 (pilotato); IDC-Header_2x11_P2.54mm_Vertical
JCUE: C96 femmina CUE; DIN41612_C_3x32_Female_Vertical_THT
JP3: potenza P3 T1-T3; Molex_Mini-Fit_Jr_5566-10A2_2x05_P4.20mm_Vertical

Connections:
+5V: F1.1, JP3.5
+5V_CUE: C1.1, C2.1, F1.2, JCUE.a21, JCUE.a22
AGND: C1.2, C2.2, C3.2, C4.2, C5.2, C6.2, C7.1, C8.1, C9.1, C10.1, JC3.1, JC3.3, JC3.5, JC3.7, JC3.9, JC3.11, JC3.13, JC3.15, JC3.17, JC3.19, JC3.21, JC3.22, JCUE.a13, JCUE.a14, JCUE.a15, JCUE.a16, JCUE.a17, JCUE.a18, JCUE.a19, JCUE.a20, JCUE.b3, JCUE.b6, JCUE.b9, JCUE.b12, JCUE.b15, JP3.6, JP3.7, JP3.8
CHASSIS: H1.1, H2.1, H3.1, H4.1, JCUE.a25, JCUE.a26, JP3.10
CTRL_GND: JCUE.a23, JCUE.a24, JCUE.c16, JCUE.c20, JCUE.c24, JCUE.c28, JP3.9
CUE1_L: JC3.2, JCUE.b1
CUE1_R: JC3.4, JCUE.b2
CUE2_L: JC3.6, JCUE.b4
CUE2_R: JC3.8, JCUE.b5
CUE3_L: JC3.10, JCUE.b7
CUE3_R: JC3.12, JCUE.b8
CUE4_L: JC3.14, JCUE.b10
CUE4_R: JC3.16, JCUE.b11
MON_L: JC3.18, JCUE.b13
MON_R: JC3.20, JCUE.b14
RAW+22: F2.1, JP3.3
RAW+22_CUE: C3.1, C4.1, F2.2, JCUE.a5, JCUE.a6
RAW+27: F3.1, JP3.1
RAW+27_CUE: C5.1, C6.1, F3.2, JCUE.a1, JCUE.a2
RAW-22: F4.1, JP3.4
RAW-22_CUE: C7.2, C8.2, F4.2, JCUE.a7, JCUE.a8
RAW-27: F5.1, JP3.2
RAW-27_CUE: C9.2, C10.2, F5.2, JCUE.a3, JCUE.a4

Notes on the sheet:
SLOT CUE (cue)
CAVO C3
POTENZA P3

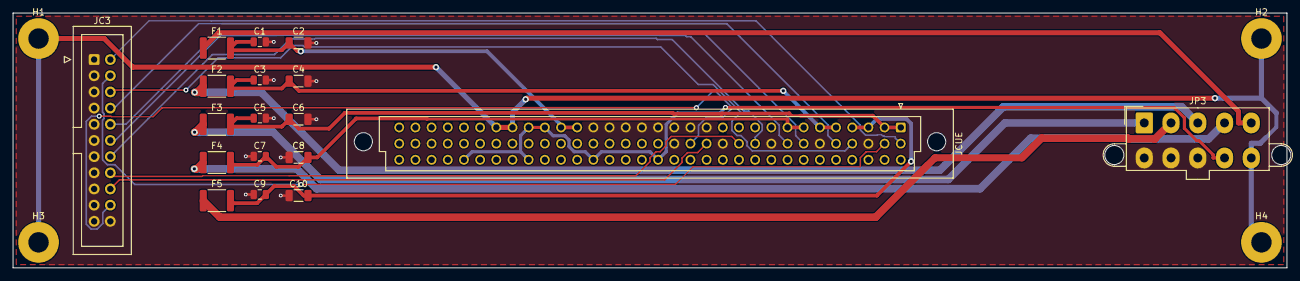
[picture p66: board backplane-t3.kicad_pcb from above]

Board: 4 copper layers, 200.0 x 40.0 mm, 22 parts (0 on the bottom side), 23 nets.
