dj-filippo241/maelcum_mixer/pcb/backplane/t1/backplane-t1.kicad_pcb

## KiCad design pcb/backplane/t1/backplane-t1.kicad_pcb (2026-11-12)

Schematic: backplane-t1.kicad_sch, maelcum backplane T1 (fondo: MASTER, 5-WAY, PSU-IN) - bozza…

Parts:
C1, C3, C5, C7, C9, C11, C13, C15, C17, C19, C21, C23, C25, C27, C29, C31, C33, C35: 100n 50V; C_0805_2012Metric
C2, C4, C6, C8, C10, C12, C14, C16, C18, C20, C22, C24, C26, C28, C30, C32, C34, C36: 10u 50V X7R; C_1206_3216Metric
F1, F2: PTC 0.3 A; Fuse_1812_4532Metric
F3, F4, F5, F6, F7, F8: PTC 0.2 A; Fuse_1812_4532Metric
F9, F14: PTC 0.1 A; Fuse_1812_4532Metric
F10, F12, F15, F17: PTC 0.05 A; Fuse_1812_4532Metric
F11, F13, F16, F18: PTC 0.5 A; Fuse_1812_4532Metric
H1, H2, H3, H4, H5: CHASSIS; MountingHole_3.2mm_M3_Pad
J5W: ponticello J5W; PinHeader_2x02_P2.54mm_Vertical
J5W1: C96 femmina 5W1; DIN41612_C_3x32_Female_Vertical_THT
J5W2: C96 femmina 5W2; DIN41612_C_3x32_Female_Vertical_THT
JC1: cavo C1 T1-T2 (VE); IDC-Header_2x05_P2.54mm_Vertical
JC2: cavo C2 T1-T2 (pilotato); IDC-Header_2x05_P2.54mm_Vertical
JC5: cavo C5 T1-T4 (VE); IDC-Header_2x05_P2.54mm_Vertical
JC6: cavo C6 T1-T4 (pilotato); IDC-Header_2x10_P2.54mm_Vertical
JMAS: C96 femmina MAS; DIN41612_C_3x32_Female_Vertical_THT
JMS: ponticello JMS; PinHeader_2x02_P2.54mm_Vertical
JOUT_L: C96 femmina OUT_L; DIN41612_C_3x32_Female_Vertical_THT
JOUT_R: C96 femmina OUT_R; DIN41612_C_3x32_Female_Vertical_THT
JP2: potenza P2 T1-T2; Molex_Mini-Fit_Jr_5566-10A2_2x05_P4.20mm_Vertical
JP3: potenza P3 T1-T3; Molex_Mini-Fit_Jr_5566-10A2_2x05_P4.20mm_Vertical
JP4: potenza P4 T1-T4; Molex_Mini-Fit_Jr_5566-10A2_2x05_P4.20mm_Vertical
JPSU: C96 femmina PSU; DIN41612_C_3x32_Female_Vertical_THT
JVIE: presa JVIE; PinHeader_1x03_P2.54mm_Vertical

Connections:
5W_OUT_L: J5W.1, J5W1.b4
5W_OUT_R: J5W.3, J5W1.b5
+5V: F3.1, F6.1, F9.1, F14.1, JP2.5, JP3.5, JP4.5, JPSU.a21, JPSU.a22
+5V_5W1: C17.1, C18.1, F9.2, J5W1.a21, J5W1.a22
+5V_5W2: C27.1, C28.1, F14.2, J5W2.a21, J5W2.a22
+5V_OUT_L: C5.1, C6.1, F3.2, JOUT_L.a21, JOUT_L.a22
+5V_OUT_R: C11.1, C12.1, F6.2, JOUT_R.a21, JOUT_R.a22
AC_OK: JOUT_L.c17, JPSU.c17
AGND: C1.2, C2.2, C3.1, C4.1, C5.2, C6.2, C7.2, C8.2, C9.1, C10.1, C11.2, C12.2, C13.2, C14.2, C15.1, C16.1, C17.2, C18.2, C19.2, C20.2, C21.2, C22.2, C23.1, C24.1, C25.1, C26.1, C27.2, C28.2, C29.2, C30.2, C31.2, C32.2, C33.1, C34.1, C35.1, C36.1, J5W1.a13, J5W1.a14, J5W1.a15, J5W1.a16, J5W1.a17, J5W1.a18, J5W1.a19, J5W1.a20, J5W1.b3, J5W1.b6, J5W1.b9, J5W1.b12, J5W1.b15, J5W1.b18, J5W1.b21, J5W1.b24, J5W1.b27, J5W1.b30, J5W2.a13, J5W2.a14, J5W2.a15, J5W2.a16, J5W2.a17, J5W2.a18, J5W2.a19, J5W2.a20, JC1.1, JC1.3, JC1.5, JC1.6, JC1.7, JC1.8, JC1.9, JC1.10, JC2.1, JC2.3, JC2.7, JC2.8, JC2.9, JC2.10, JC5.1, JC5.3, JC5.5, JC5.7, JC5.9, JC5.10, JC6.1, JC6.3, JC6.5, JC6.7, JC6.9, JC6.11, JC6.13, JC6.15, JC6.19, JC6.20, JMAS.a13, JMAS.a14, JMAS.a15, JMAS.a16, JMAS.a17, JMAS.a18, JMAS.a19, JMAS.a20, JMAS.b3, JMAS.b6, JMAS.b9, JMAS.b12, JMAS.b15, JMAS.b18, JMAS.b21, JMAS.b24, JMAS.b27, JMAS.b30, JOUT_L.a13, JOUT_L.a14, JOUT_L.a15, JOUT_L.a16, JOUT_L.a17, JOUT_L.a18, JOUT_L.a19, JOUT_L.a20, JOUT_R.a13, JOUT_R.a14, JOUT_R.a15, JOUT_R.a16, JOUT_R.a17, JOUT_R.a18, JOUT_R.a19, JOUT_R.a20, JP2.6, JP2.7, JP2.8, JP3.6, JP3.7, JP3.8, JP4.6, JP4.7, JP4.8, JPSU.a13, JPSU.a14, JPSU.a15, JPSU.a16, JPSU.a17, JPSU.a18, JPSU.a19, JPSU.a20, JVIE.2
CHASSIS: H1.1, H2.1, H3.1, H4.1, H5.1, J5W1.a25, J5W1.a26, J5W2.a25, J5W2.a26, JMAS.a25, JMAS.a26, JOUT_L.a25, JOUT_L.a26, JOUT_R.a25, JOUT_R.a26, JP2.10, JP3.10, JP4.10, JPSU.a25, JPSU.a26
CTRL_GND: J5W1.a23, J5W1.a24, J5W1.c16, J5W1.c20, J5W1.c24, J5W1.c28, J5W2.a23, J5W2.a24, J5W2.c16, J5W2.c20, J5W2.c24, J5W2.c28, JC2.5, JC6.17, JMAS.c16, JMAS.c20, JMAS.c24, JMAS.c28, JOUT_L.a23, JOUT_L.a24, JOUT_L.c16, JOUT_L.c20, JOUT_L.c24, JOUT_L.c28, JOUT_R.a23, JOUT_R.a24, JOUT_R.c16, JOUT_R.c20, JOUT_R.c24, JOUT_R.c28, JP2.9, JP3.9, JP4.9, JPSU.a23, JPSU.a24, JPSU.c16, JPSU.c20, JPSU.c24, JPSU.c28
DJBUS_L: J5W1.b1, JC1.2
DJBUS_R: J5W1.b2, JC1.4
GLOBAL_MUTE: JC2.6, JC6.18, JOUT_L.c9, JOUT_R.c9
INS_RET_L: JMAS.b28, JMS.2
INS_RET_R: JMAS.b29, JMS.4
INS_SEND_L: JMAS.b25, JMS.1
INS_SEND_R: JMAS.b26, JMS.3
MON_L: JC2.2, JMAS.b22
MON_R: JC2.4, JMAS.b23
MSUM1_L: J5W.2, JMAS.b1
MSUM1_R: J5W.4, JMAS.b2
MSUM2_L: JC6.2, JMAS.b4
MSUM2_R: JC6.4, JMAS.b5
MSUM3_L: JC6.6, JMAS.b7
MSUM3_R: JC6.8, JMAS.b8
MSUM4_L: JC6.10, JMAS.b10
MSUM4_R: JC6.12, JMAS.b11
MSUM5_L: JC6.14, JMAS.b13
MSUM5_R: JC6.16, JMAS.b14
MSUM6_L: JC5.2, JMAS.b16
MSUM6_R: JC5.4, JMAS.b17
MSUM7_L: JC5.6, JMAS.b19
MSUM7_R: JC5.8, JMAS.b20
RAW+22: F10.1, F15.1, JOUT_L.a5, JOUT_L.a6, JP2.3, JP3.3, JP4.3, JPSU.a5, JPSU.a6
RAW+22_5W1: C19.1, C20.1, F10.2, J5W1.a5, J5W1.a6
RAW+22_5W2: C29.1, C30.1, F15.2, J5W2.a5, J5W2.a6
RAW+26: F4.1, F7.1, JPSU.a9, JPSU.a10
RAW+26_OUT_L: C7.1, C8.1, F4.2, JOUT_L.a9, JOUT_L.a10
RAW+26_OUT_R: C13.1, C14.1, F7.2, JOUT_R.a9, JOUT_R.a10
RAW+27: F1.1, F11.1, F16.1, JP2.1, JP3.1, JP4.1, JPSU.a1, JPSU.a2
RAW+27_5W1: C21.1, C22.1, F11.2, J5W1.a1, J5W1.a2
RAW+27_5W2: C31.1, C32.1, F16.2, J5W2.a1, J5W2.a2
RAW+27_MAS: C1.1, C2.1, F1.2, JMAS.a1, JMAS.a2
RAW-22: F12.1, F17.1, JP2.4, JP3.4, JP4.4, JPSU.a7, JPSU.a8
RAW-22_5W1: C23.2, C24.2, F12.2, J5W1.a7, J5W1.a8
RAW-22_5W2: C33.2, C34.2, F17.2, J5W2.a7, J5W2.a8
RAW-26: F5.1, F8.1, JPSU.a11, JPSU.a12
RAW-26_OUT_L: C9.2, C10.2, F5.2, JOUT_L.a11, JOUT_L.a12
RAW-26_OUT_R: C15.2, C16.2, F8.2, JOUT_R.a11, JOUT_R.a12
RAW-27: F2.1, F13.1, F18.1, JP2.2, JP3.2, JP4.2, JPSU.a3, JPSU.a4
RAW-27_5W1: C25.2, C26.2, F13.2, J5W1.a3, J5W1.a4
RAW-27_5W2: C35.2, C36.2, F18.2, J5W2.a3, J5W2.a4
RAW-27_MAS: C3.2, C4.2, F2.2, JMAS.a3, JMAS.a4
VIE_TAP_L: JMAS.b31, JVIE.1
VIE_TAP_R: JMAS.b32, JVIE.3

Notes on the sheet:
SLOT MAS (master)
SLOT OUT_L (uscita)
SLOT OUT_R (uscita)
SLOT 5W1 (5way)
SLOT 5W2 (5way)
SLOT PSU (psu-in)
CAVO C1
CAVO C2
CAVO C5
CAVO C6
POTENZA P2
POTENZA P3
POTENZA P4
PONTICELLI

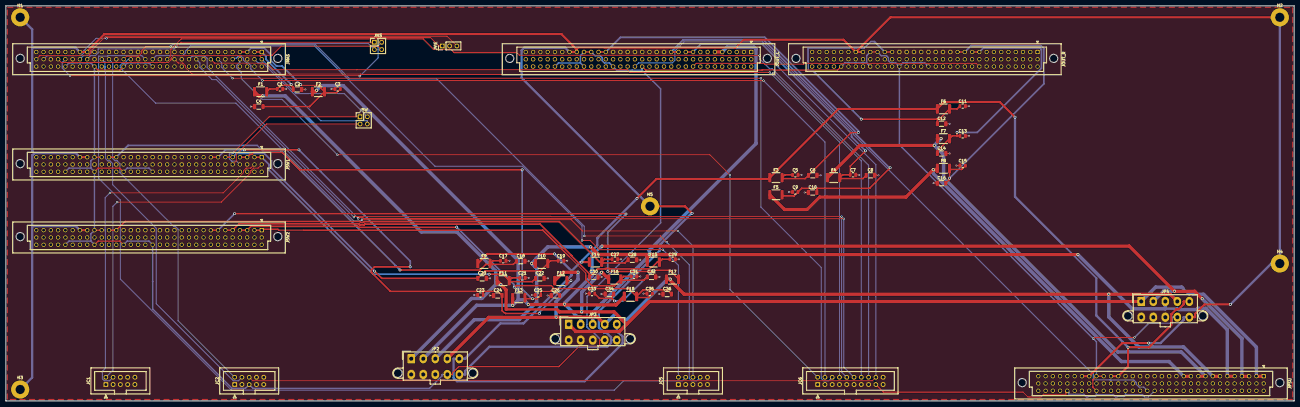
[picture p67: board backplane-t1.kicad_pcb from above]

Board: 4 copper layers, 450.0 x 138.0 mm, 75 parts (0 on the bottom side), 56 nets.
