dj-filippo241/maelcum_mixer/pcb/cue/comandi/cue-comandi.kicad_pcb

## KiCad design pcb/cue/comandi/cue-comandi.kicad_pcb (2026-11-11)

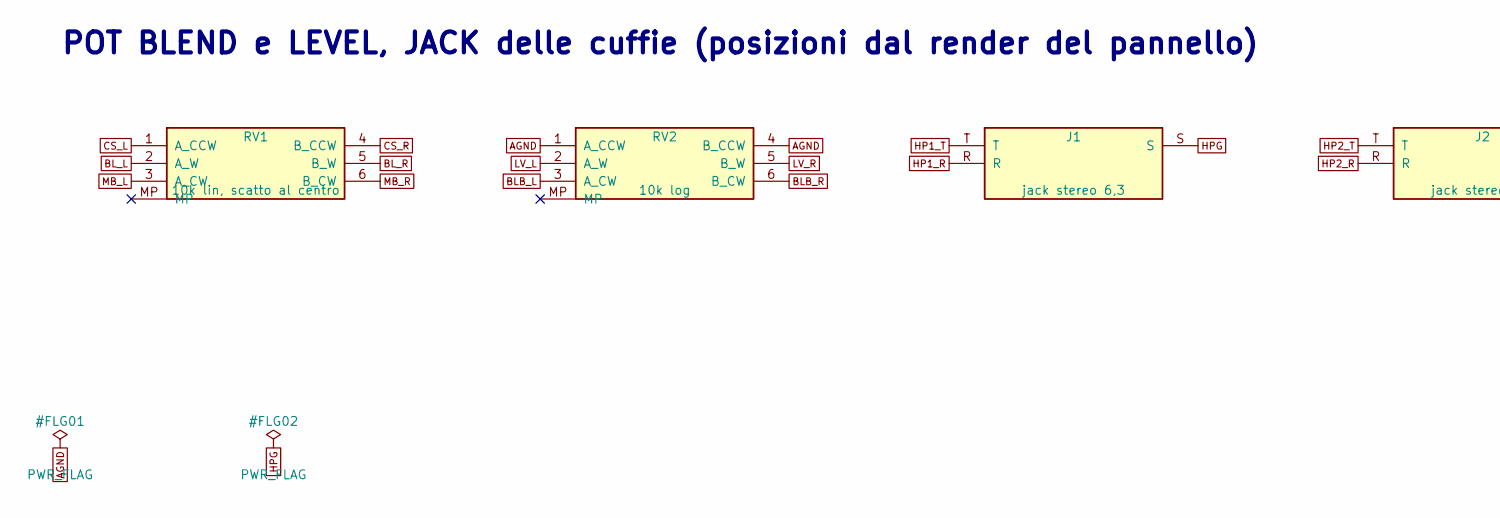
[picture p68: schematic cue-comandi.kicad_sch, maelcum CUE scheda comandi - bozza v0.1, part in row 1, column 1]

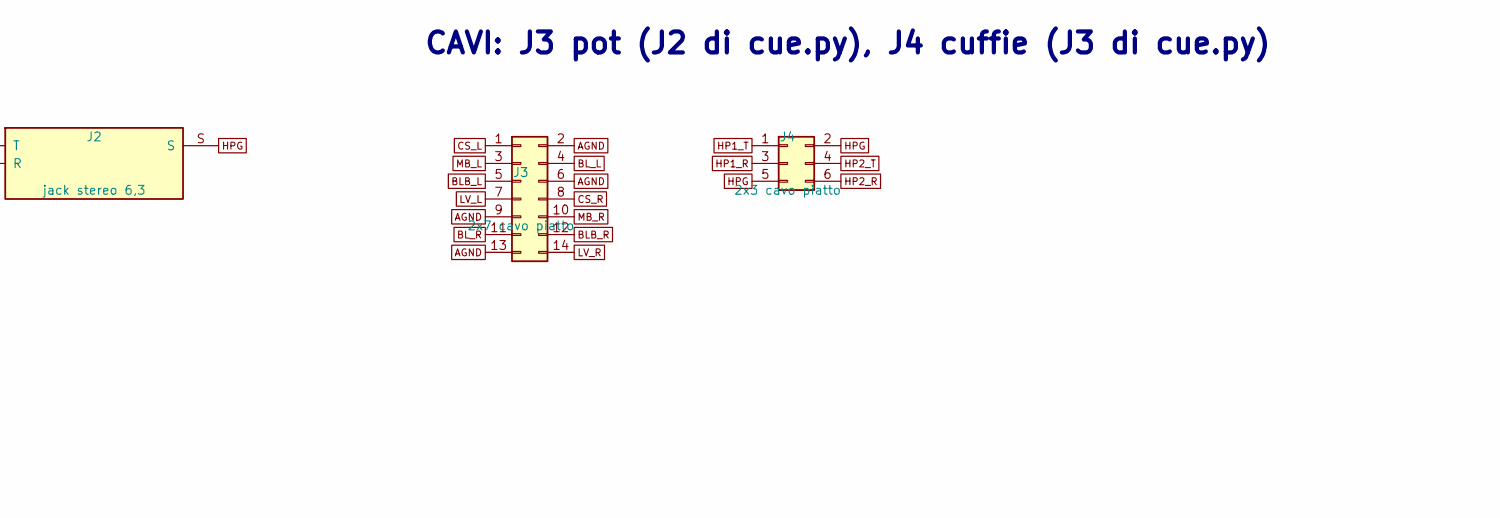
[picture p69: schematic cue-comandi.kicad_sch, maelcum CUE scheda comandi - bozza v0.1, part in row 1, column 2]

Parts:
J1, J2: jack stereo 6,3; Jack_6.35mm_Neutrik_NJ3FD-V_Vertical
J3: 2x7 cavo piatto; PinHeader_2x07_P2.54mm_Vertical
J4: 2x3 cavo piatto; PinHeader_2x03_P2.54mm_Vertical
RV1: 10k lin, scatto al centro; Potentiometer_Alps_RK09L_Double_Vertical
RV2: 10k log; Potentiometer_Alps_RK09L_Double_Vertical

Connections:
AGND: J3.2, J3.6, J3.9, J3.13, RV2.1 (A_CCW), RV2.4 (B_CCW)
BLB_L: J3.5, RV2.3 (A_CW)
BLB_R: J3.12, RV2.6 (B_CW)
BL_L: J3.4, RV1.2 (A_W)
BL_R: J3.11, RV1.5 (B_W)
CS_L: J3.1, RV1.1 (A_CCW)
CS_R: J3.8, RV1.4 (B_CCW)
HP1_R: J1.R, J4.3
HP1_T: J1.T, J4.1
HP2_R: J2.R, J4.6
HP2_T: J2.T, J4.4
HPG: J1.S, J2.S, J4.2, J4.5
LV_L: J3.7, RV2.2 (A_W)
LV_R: J3.14, RV2.5 (B_W)
MB_L: J3.3, RV1.3 (A_CW)
MB_R: J3.10, RV1.6 (B_CW)

Notes on the sheet:
POT BLEND e LEVEL, JACK delle cuffie (posizioni dal render del pannello)
CAVI: J3 pot (J2 di cue.py), J4 cuffie (J3 di cue.py)

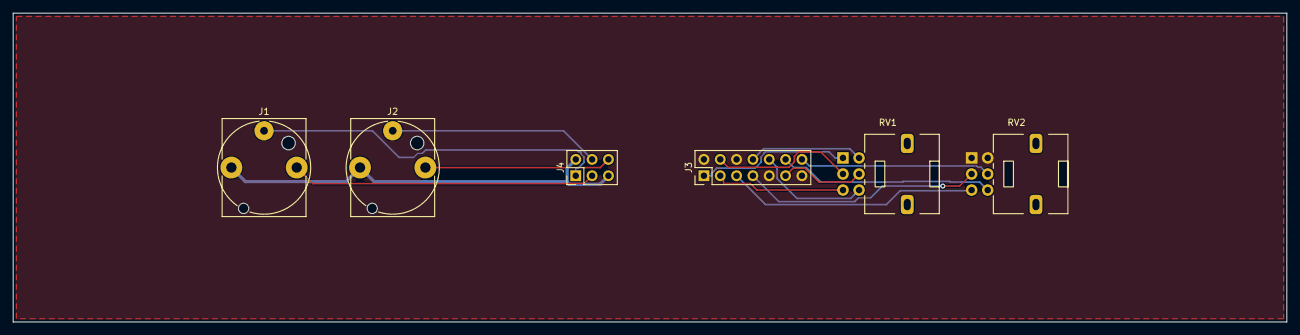
[picture p70: board cue-comandi.kicad_pcb from above]

Board: 4 copper layers, 198.0 x 48.0 mm, 6 parts (0 on the bottom side), 16 nets.
