dj-filippo241/maelcum_mixer/pcb/fx-ret/comandi/fx-ret-comandi.kicad_pcb

## KiCad design pcb/fx-ret/comandi/fx-ret-comandi.kicad_pcb (2026-11-11)

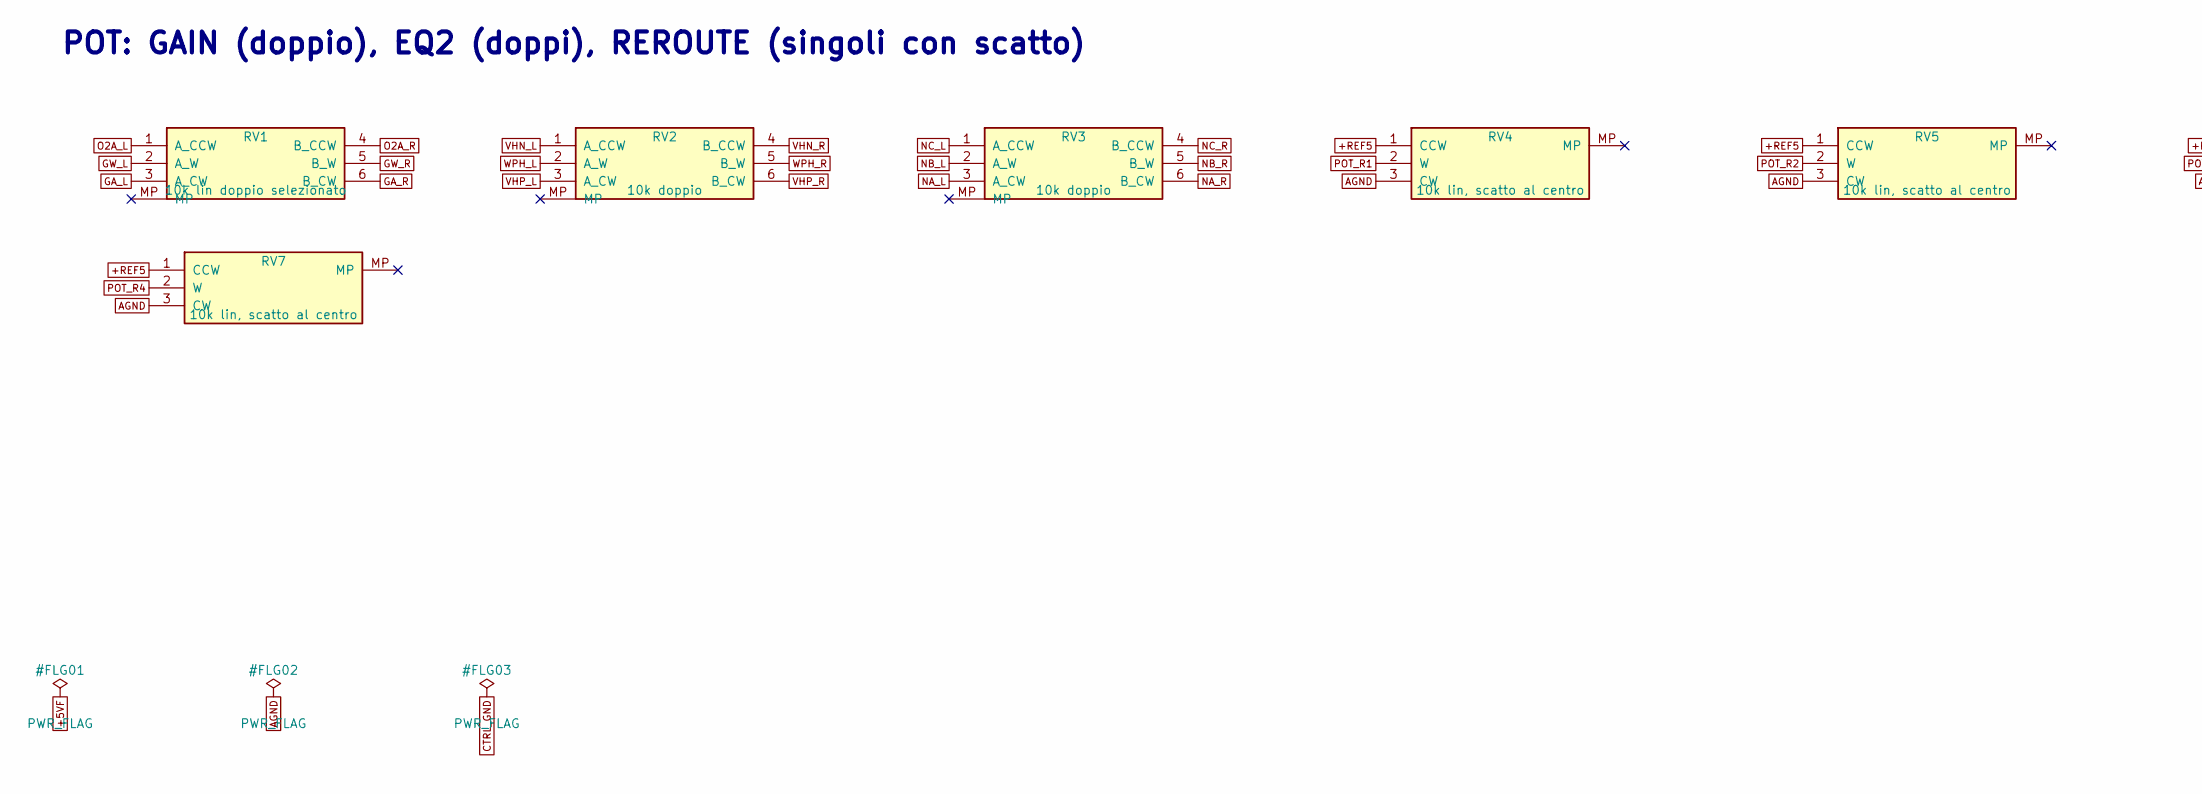
[picture p71: schematic fx-ret-comandi.kicad_sch, maelcum FX-RET scheda comandi - bozza v0.1, part in row 1, column 1]

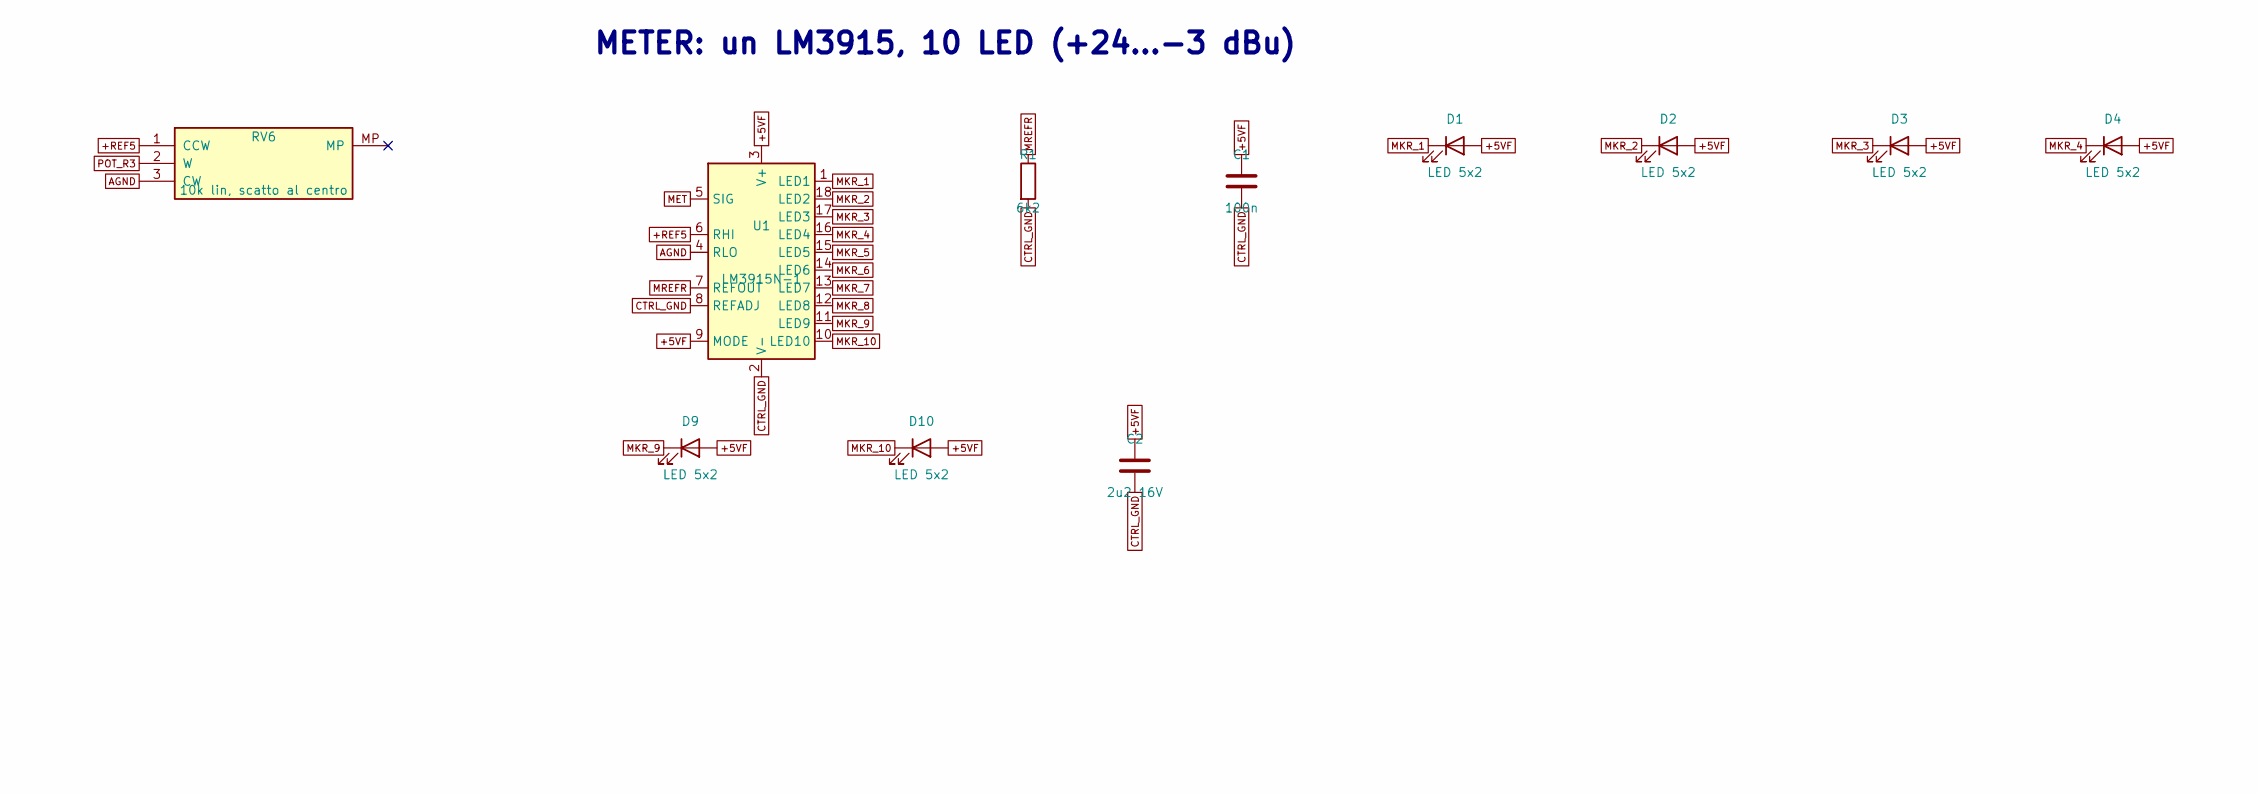
[picture p72: schematic fx-ret-comandi.kicad_sch, maelcum FX-RET scheda comandi - bozza v0.1, part in row 1, column 2]

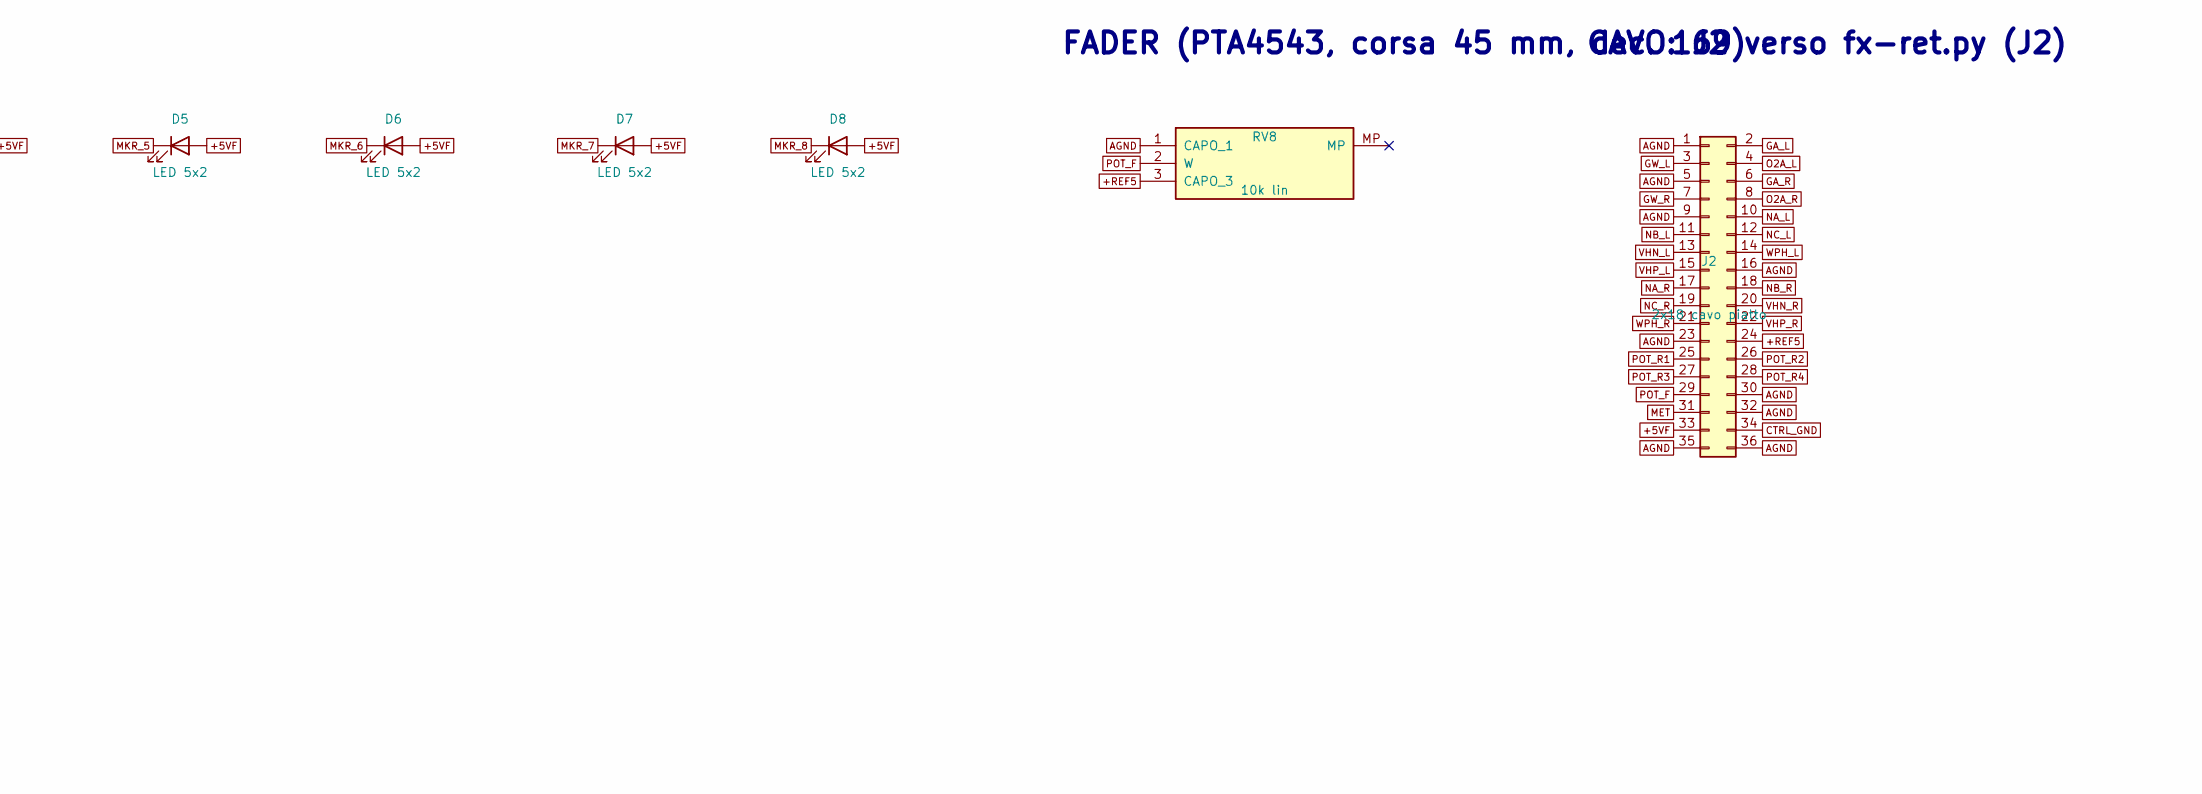
[picture p73: schematic fx-ret-comandi.kicad_sch, maelcum FX-RET scheda comandi - bozza v0.1, part in row 1, column 3]

Parts:
C1: 100n; C_0805_2012Metric
C2: 2u2 16V; C_1206_3216Metric
D1, D2, D3, D4, D5, D6, D7, D8, D9, D10: LED 5x2; LED_Rectangular_W5.0mm_H2.0mm
J2: 2x18 cavo piatto; PinHeader_2x18_P2.54mm_Vertical
R1: 6k2; R_0805_2012Metric
RV1: 10k lin doppio selezionato; Potentiometer_Alps_RK09L_Double_Vertical
RV2, RV3: 10k doppio; Potentiometer_Alps_RK09L_Double_Vertical
RV4, RV5, RV6, RV7: 10k lin, scatto al centro; Potentiometer_Alps_RK09L_Single_Vertical
RV8: 10k lin; Potentiometer_Bourns_PTA4543_Single_Slide
U1: LM3915N-1; DIP-18_W7.62mm

Connections:
+5VF: C1.1, C2.1, D1.2 (A), D2.2 (A), D3.2 (A), D4.2 (A), D5.2 (A), D6.2 (A), D7.2 (A), D8.2 (A), D9.2 (A), D10.2 (A), J2.33, U1.3 (V+), U1.9 (MODE)
+REF5: J2.24, RV4.1 (CCW), RV5.1 (CCW), RV6.1 (CCW), RV7.1 (CCW), RV8.3 (CAPO_3), U1.6 (RHI)
AGND: J2.1, J2.5, J2.9, J2.16, J2.23, J2.30, J2.32, J2.35, J2.36, RV4.3 (CW), RV5.3 (CW), RV6.3 (CW), RV7.3 (CW), RV8.1 (CAPO_1), U1.4 (RLO)
CTRL_GND: C1.2, C2.2, J2.34, R1.2, U1.2 (V-), U1.8 (REFADJ)
GA_L: J2.2, RV1.3 (A_CW)
GA_R: J2.6, RV1.6 (B_CW)
GW_L: J2.3, RV1.2 (A_W)
GW_R: J2.7, RV1.5 (B_W)
MET: J2.31, U1.5 (SIG)
MKR_1: D1.1 (K), U1.1 (LED1)
MKR_2: D2.1 (K), U1.18 (LED2)
MKR_3: D3.1 (K), U1.17 (LED3)
MKR_4: D4.1 (K), U1.16 (LED4)
MKR_5: D5.1 (K), U1.15 (LED5)
MKR_6: D6.1 (K), U1.14 (LED6)
MKR_7: D7.1 (K), U1.13 (LED7)
MKR_8: D8.1 (K), U1.12 (LED8)
MKR_9: D9.1 (K), U1.11 (LED9)
MKR_10: D10.1 (K), U1.10 (LED10)
MREFR: R1.1, U1.7 (REFOUT)
NA_L: J2.10, RV3.3 (A_CW)
NA_R: J2.17, RV3.6 (B_CW)
NB_L: J2.11, RV3.2 (A_W)
NB_R: J2.18, RV3.5 (B_W)
NC_L: J2.12, RV3.1 (A_CCW)
NC_R: J2.19, RV3.4 (B_CCW)
O2A_L: J2.4, RV1.1 (A_CCW)
O2A_R: J2.8, RV1.4 (B_CCW)
POT_F: J2.29, RV8.2 (W)
POT_R1: J2.25, RV4.2 (W)
POT_R2: J2.26, RV5.2 (W)
POT_R3: J2.27, RV6.2 (W)
POT_R4: J2.28, RV7.2 (W)
VHN_L: J2.13, RV2.1 (A_CCW)
VHN_R: J2.20, RV2.4 (B_CCW)
VHP_L: J2.15, RV2.3 (A_CW)
VHP_R: J2.22, RV2.6 (B_CW)
WPH_L: J2.14, RV2.2 (A_W)
WPH_R: J2.21, RV2.5 (B_W)

Notes on the sheet:
POT: GAIN (doppio), EQ2 (doppi), REROUTE (singoli con scatto)
METER: un LM3915, 10 LED (+24...-3 dBu)
FADER (PTA4543, corsa 45 mm, dec. 169)
CAVO: J2 verso fx-ret.py (J2)

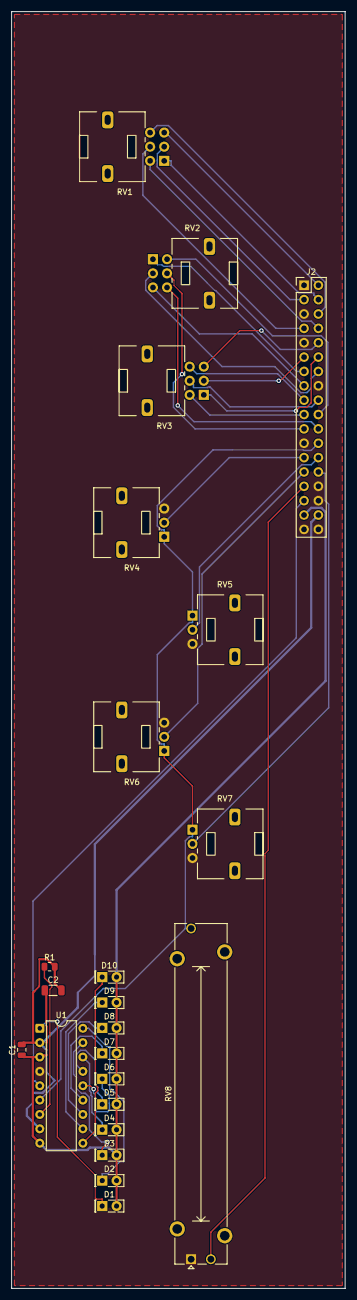
[picture p74: board fx-ret-comandi.kicad_pcb from above]

Board: 4 copper layers, 59.0 x 225.9 mm, 23 parts (0 on the bottom side), 39 nets.
