dj-filippo241/maelcum_mixer/pcb/master/comandi/master-comandi.kicad_pcb

## KiCad design pcb/master/comandi/master-comandi.kicad_pcb (2026-11-11)

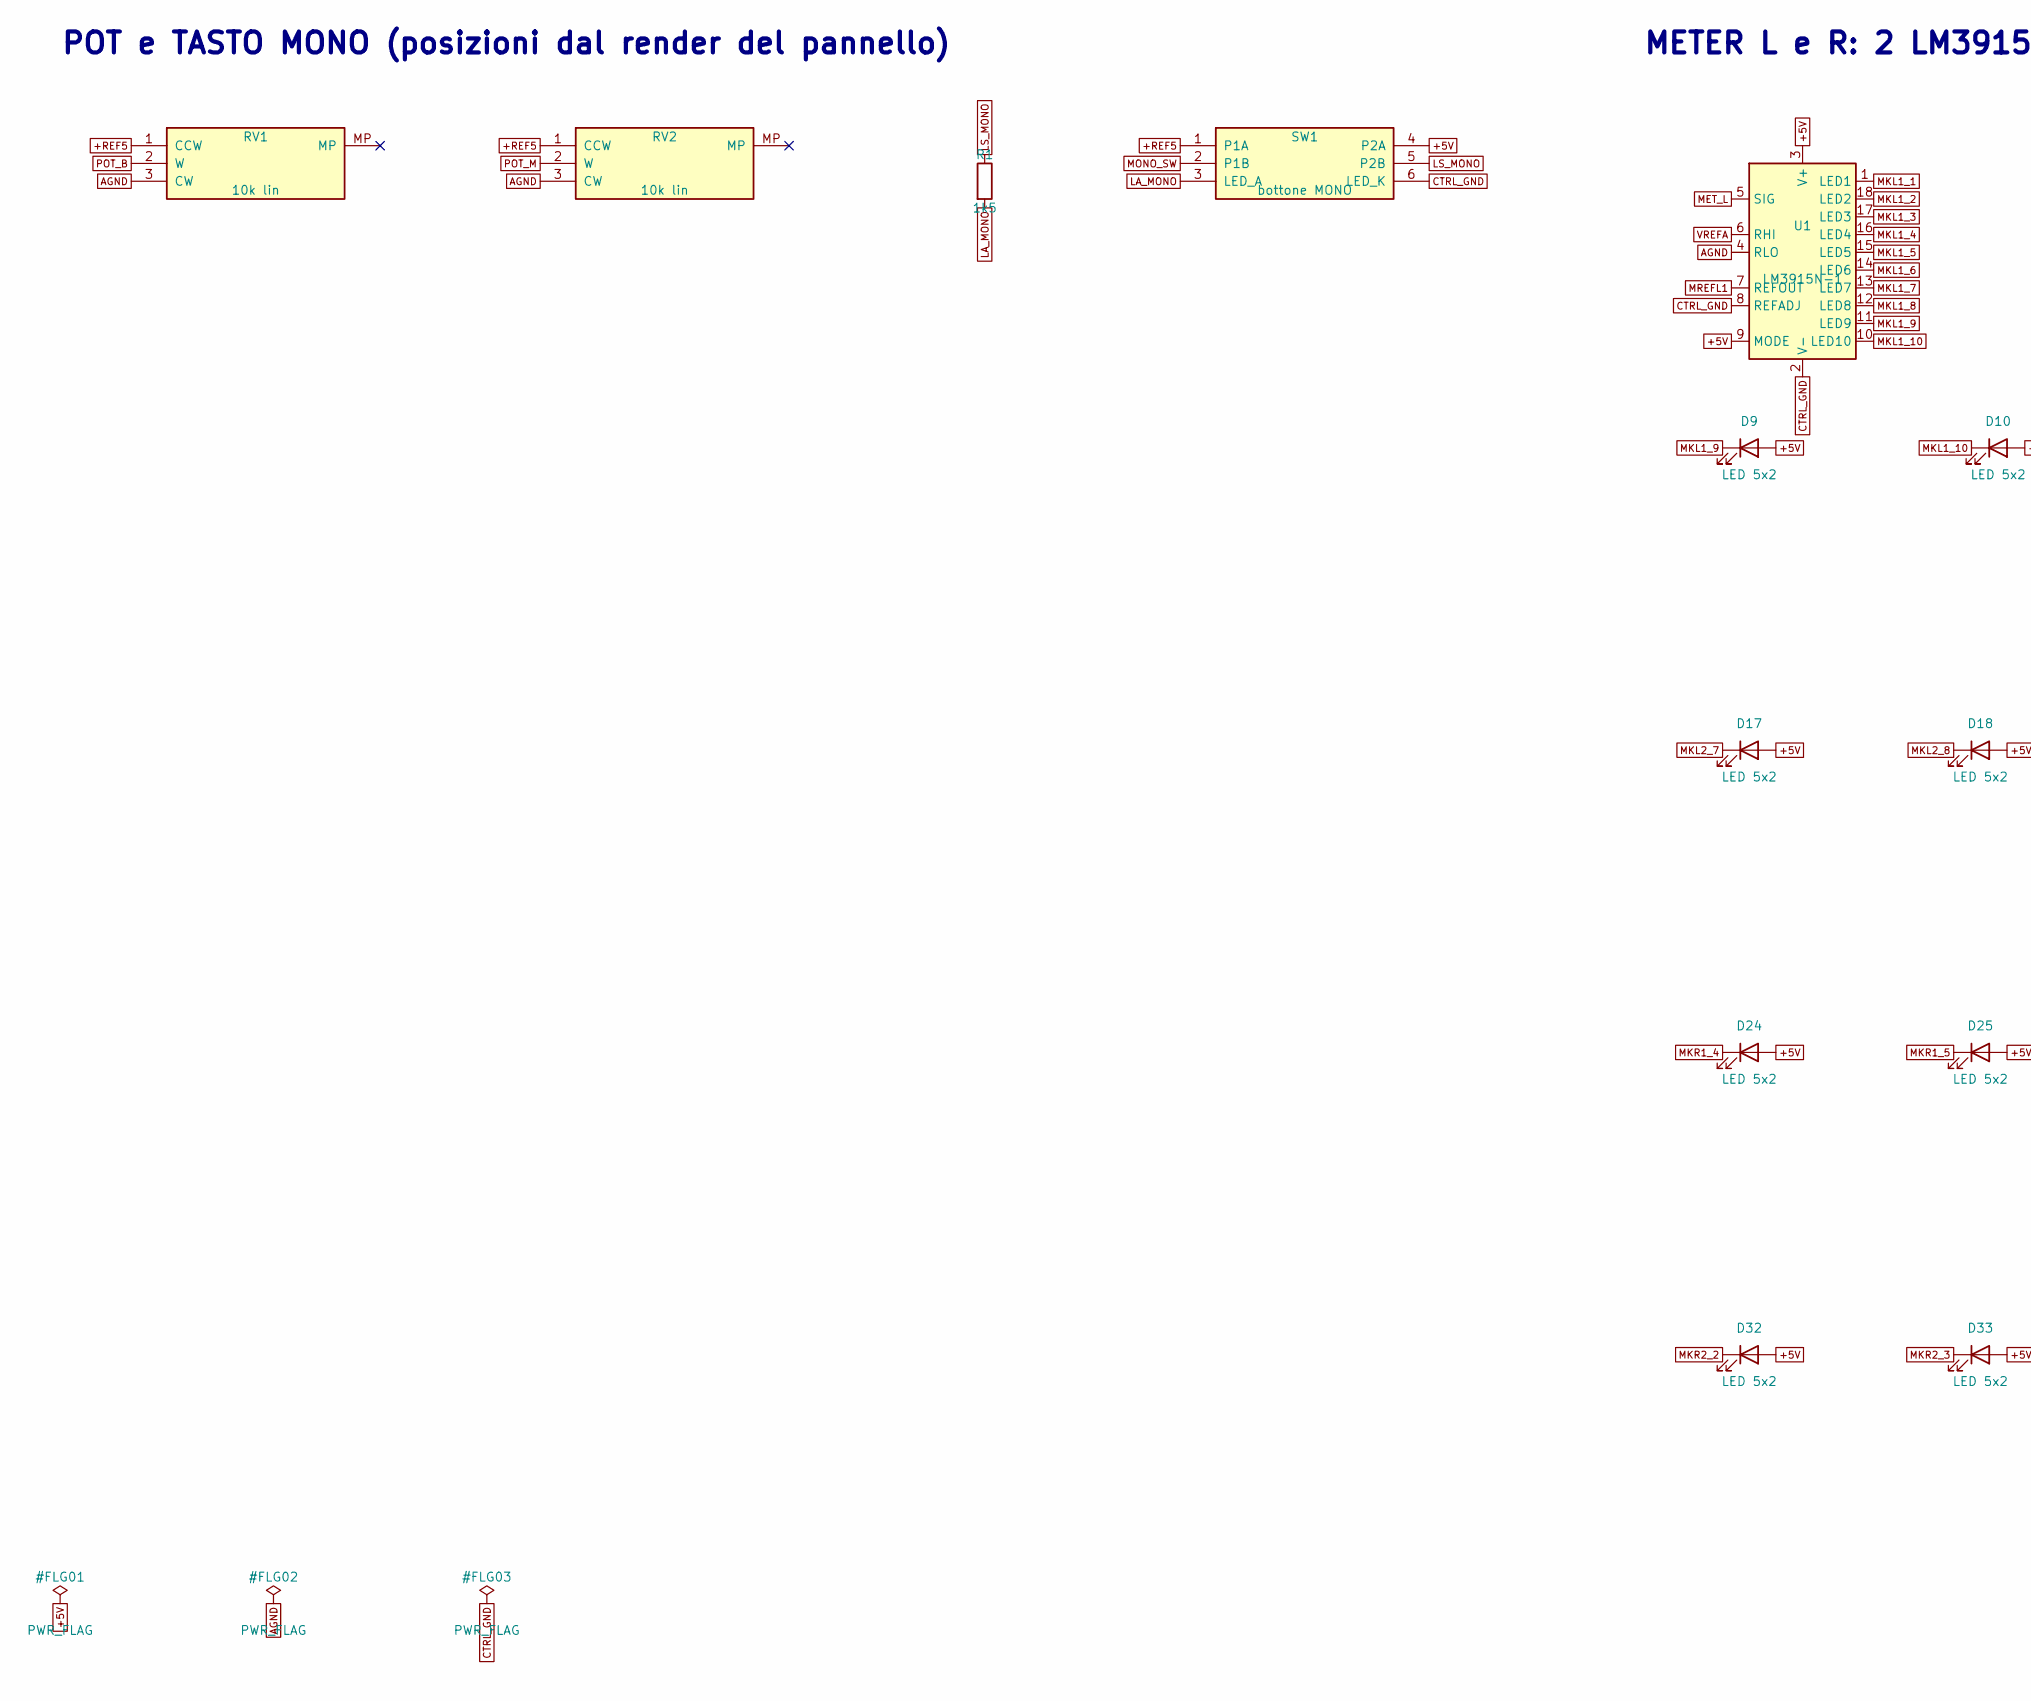
[picture p75: schematic master-comandi.kicad_sch, maelcum MASTER scheda comandi - bozza v0.1, part in row 1, column 1]

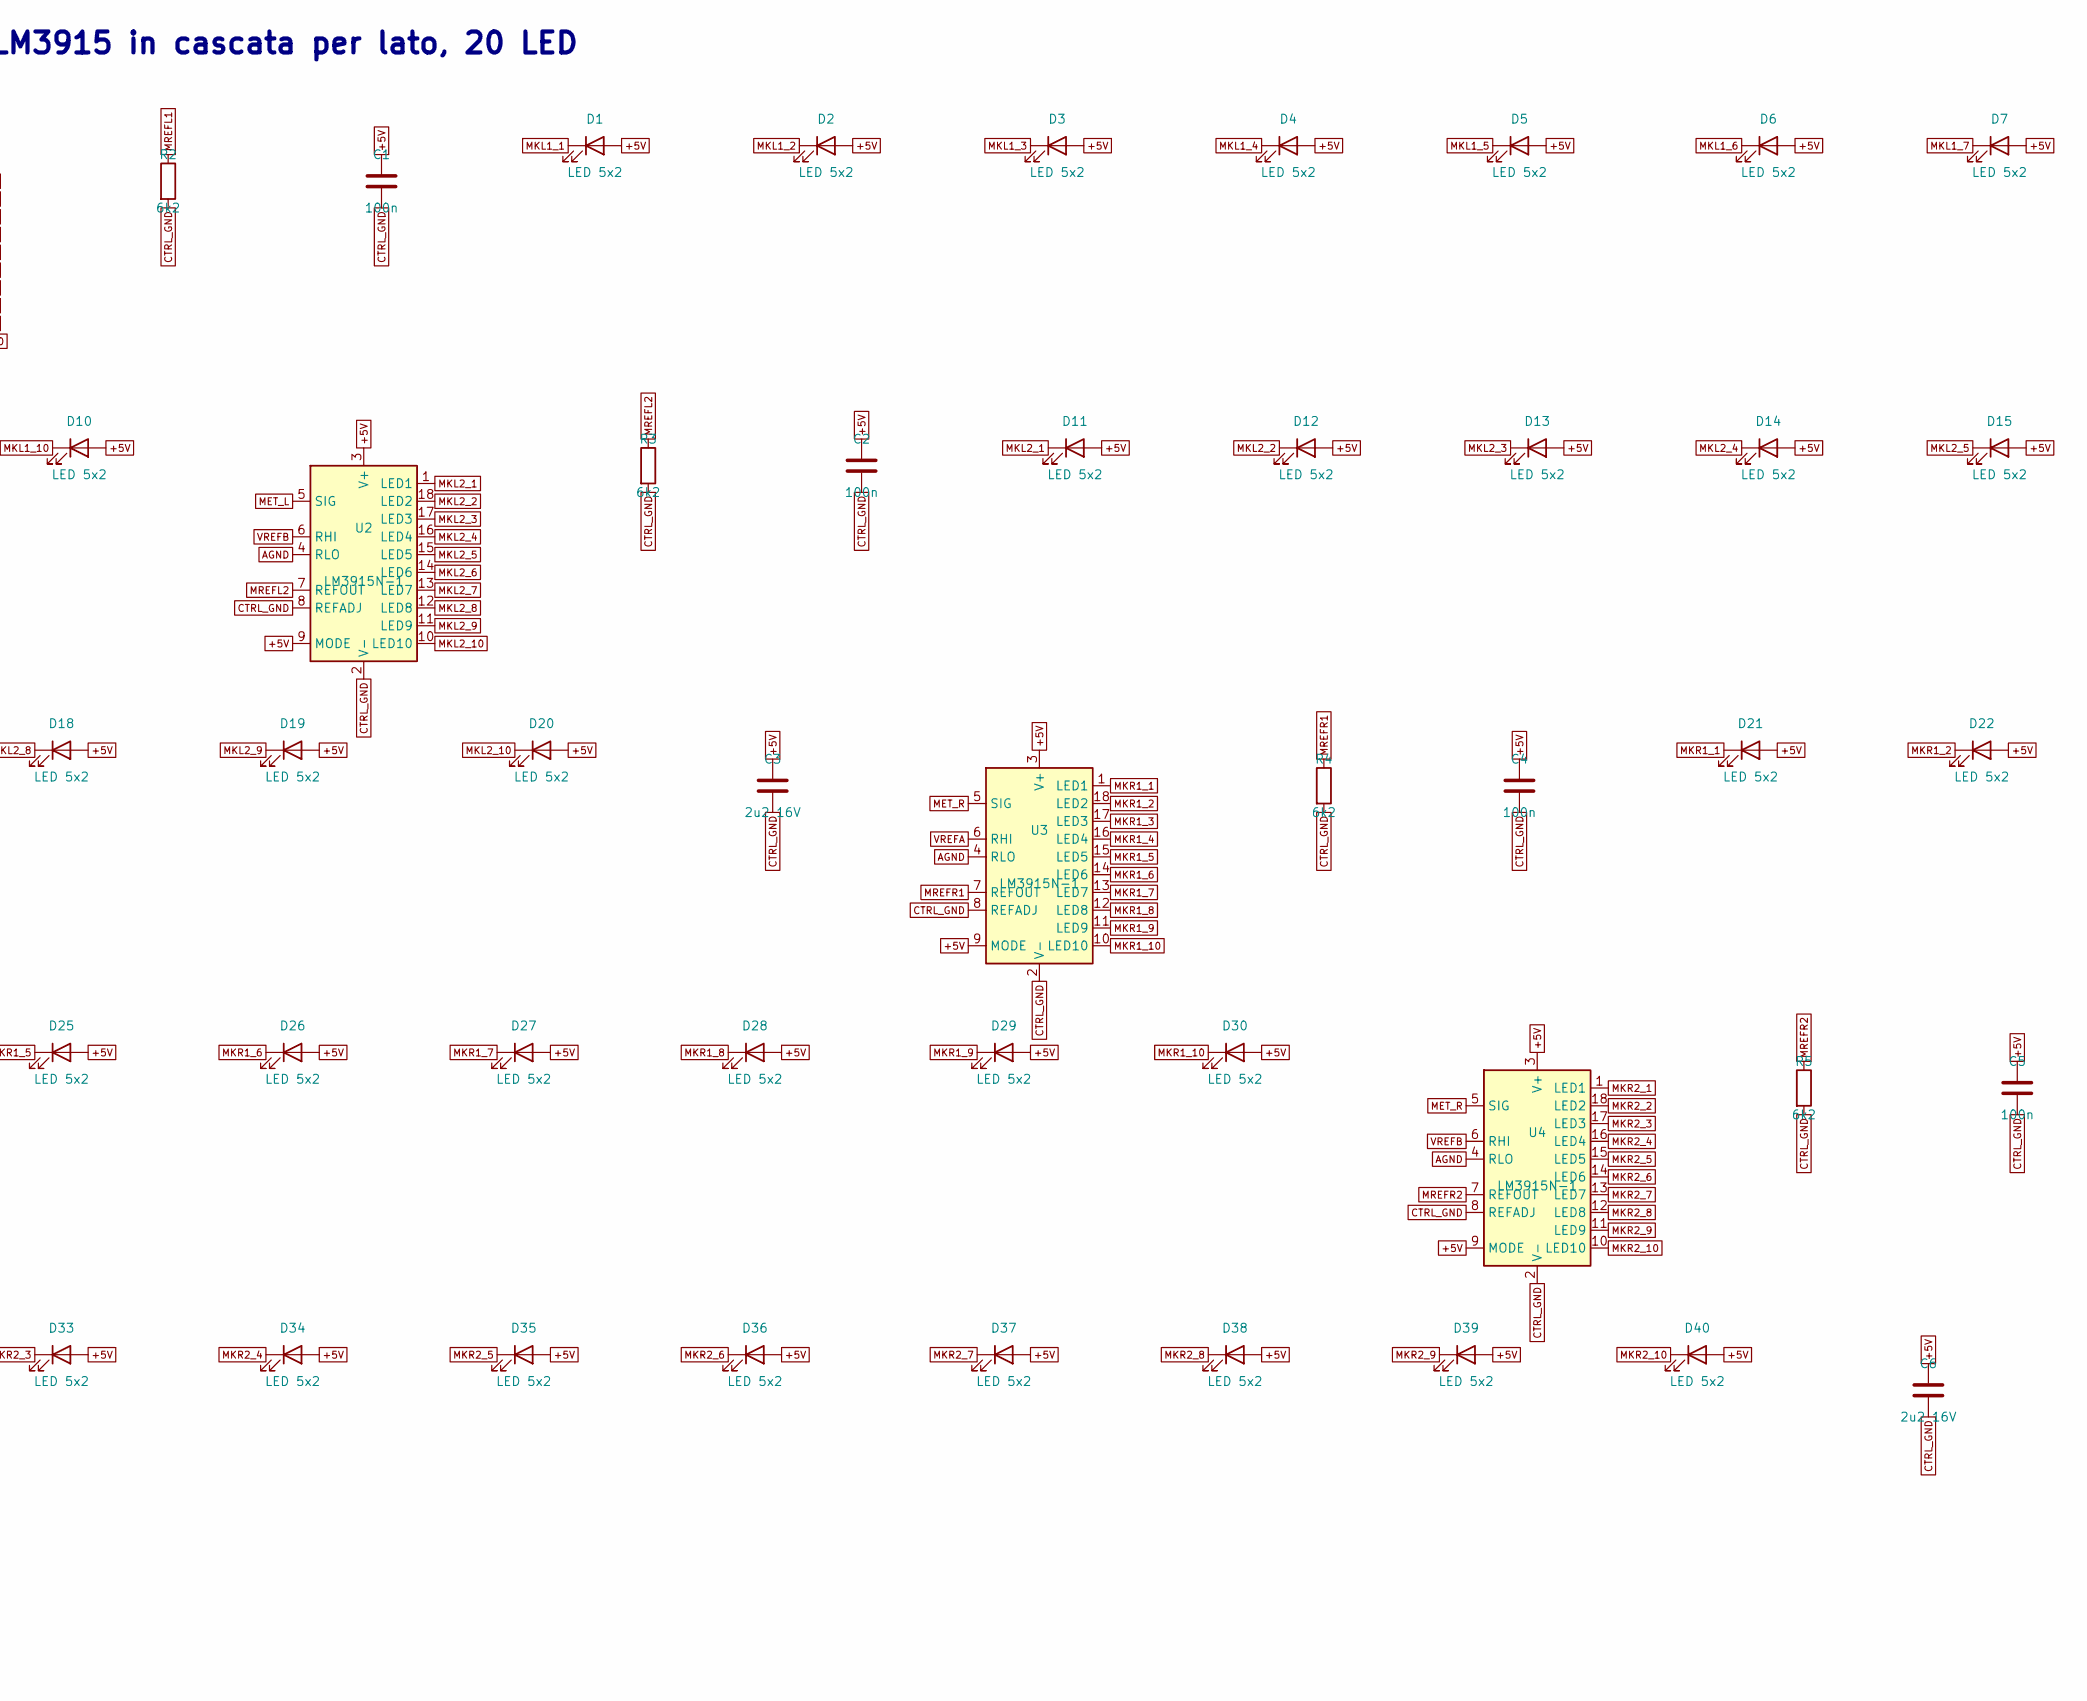
[picture p76: schematic master-comandi.kicad_sch, maelcum MASTER scheda comandi - bozza v0.1, part in row 1, column 2]

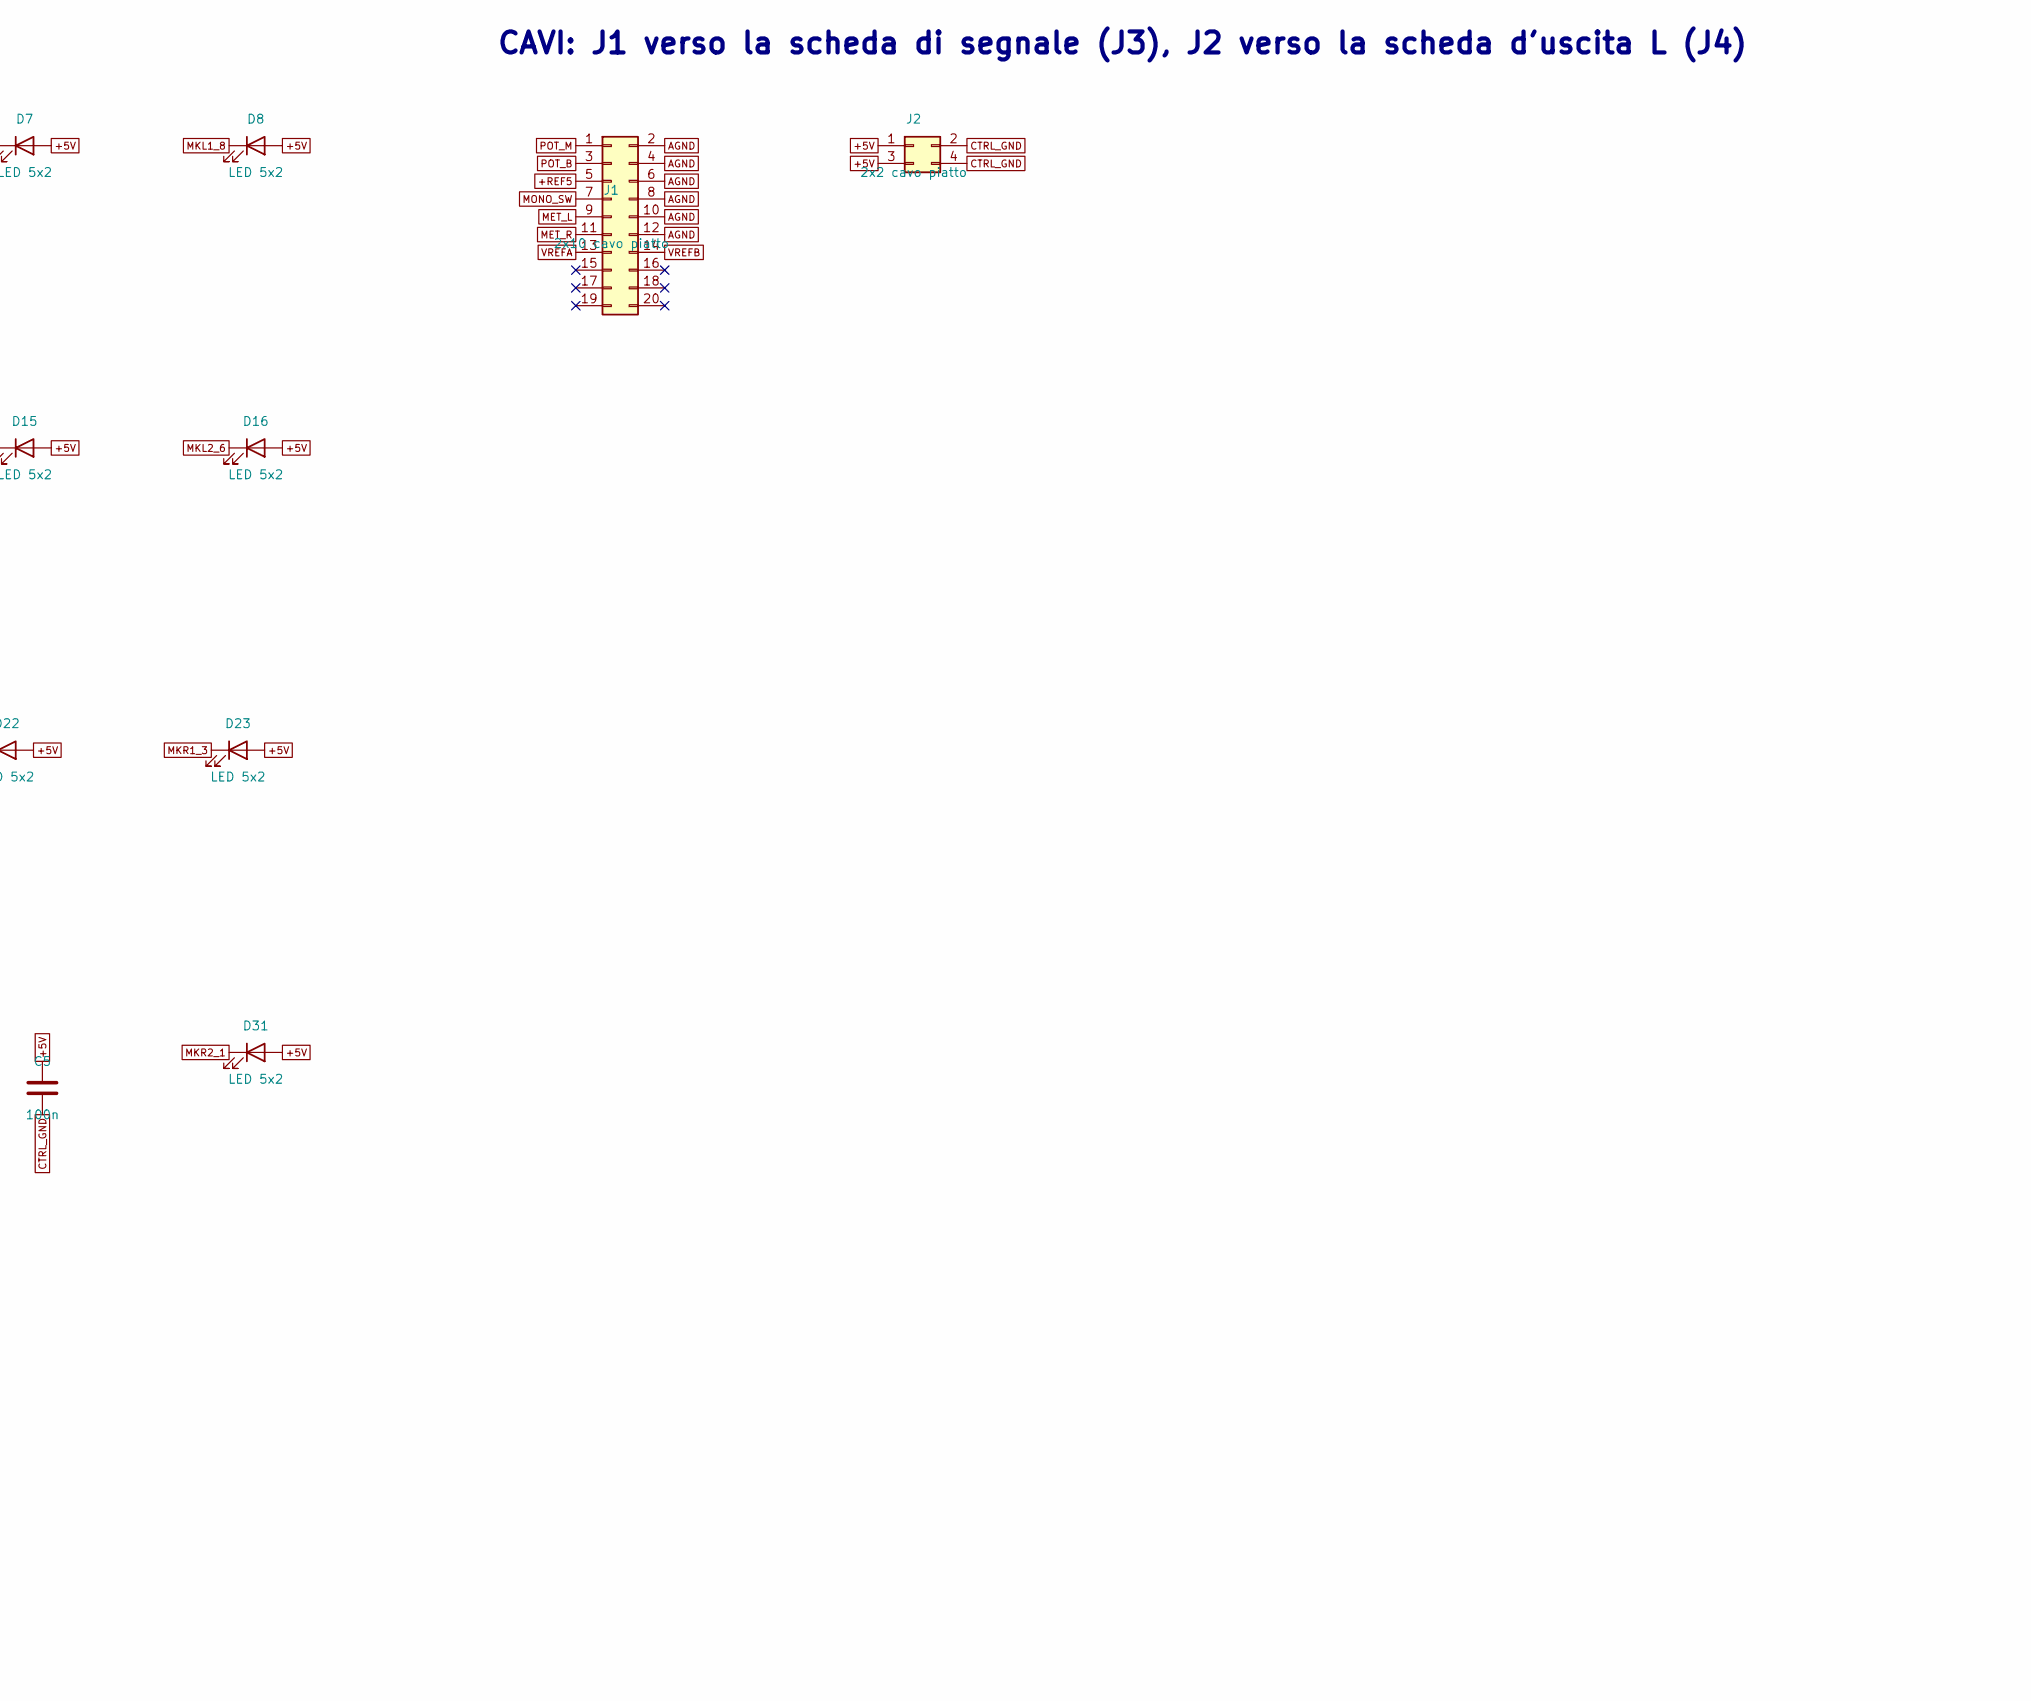
[picture p77: schematic master-comandi.kicad_sch, maelcum MASTER scheda comandi - bozza v0.1, part in row 1, column 3]

Parts:
C1, C2, C4, C5: 100n; C_0805_2012Metric
C3, C6: 2u2 16V; C_1206_3216Metric
D1, D2, D3, D4, D5, D6, D7, D8, D9, D10, D11, D12, D13, D14, D15, D16, D17, D18, D19, D20, D21, D22, D23, D24, D25, D26, D27, D28, D29, D30, D31, D32, D33, D34, D35, D36, D37, D38, D39, D40: LED 5x2; LED_Rectangular_W5.0mm_H2.0mm
J1: 2x10 cavo piatto; PinHeader_2x10_P2.54mm_Vertical
J2: 2x2 cavo piatto; PinHeader_2x02_P2.54mm_Vertical
R1: 1k5; R_0805_2012Metric
R2, R3, R4, R5: 6k2; R_0805_2012Metric
RV1, RV2: 10k lin; Potentiometer_Alps_RK09L_Single_Vertical
SW1: bottone MONO; SW_NKK_GW12LJP
U1, U2, U3, U4: LM3915N-1; DIP-18_W7.62mm

Connections:
+5V: C1.1, C2.1, C3.1, C4.1, C5.1, C6.1, D1.2 (A), D2.2 (A), D3.2 (A), D4.2 (A), D5.2 (A), D6.2 (A), D7.2 (A), D8.2 (A), D9.2 (A), D10.2 (A), D11.2 (A), D12.2 (A), D13.2 (A), D14.2 (A), D15.2 (A), D16.2 (A), D17.2 (A), D18.2 (A), D19.2 (A), D20.2 (A), D21.2 (A), D22.2 (A), D23.2 (A), D24.2 (A), D25.2 (A), D26.2 (A), D27.2 (A), D28.2 (A), D29.2 (A), D30.2 (A), D31.2 (A), D32.2 (A), D33.2 (A), D34.2 (A), D35.2 (A), D36.2 (A), D37.2 (A), D38.2 (A), D39.2 (A), D40.2 (A), J2.1, J2.3, SW1.4 (P2A), U1.3 (V+), U1.9 (MODE), U2.3 (V+), U2.9 (MODE), U3.3 (V+), U3.9 (MODE), U4.3 (V+), U4.9 (MODE)
+REF5: J1.5, RV1.1 (CCW), RV2.1 (CCW), SW1.1 (P1A)
AGND: J1.2, J1.4, J1.6, J1.8, J1.10, J1.12, RV1.3 (CW), RV2.3 (CW), U1.4 (RLO), U2.4 (RLO), U3.4 (RLO), U4.4 (RLO)
CTRL_GND: C1.2, C2.2, C3.2, C4.2, C5.2, C6.2, J2.2, J2.4, R2.2, R3.2, R4.2, R5.2, SW1.6 (LED_K), U1.2 (V-), U1.8 (REFADJ), U2.2 (V-), U2.8 (REFADJ), U3.2 (V-), U3.8 (REFADJ), U4.2 (V-), U4.8 (REFADJ)
LA_MONO: R1.2, SW1.3 (LED_A)
LS_MONO: R1.1, SW1.5 (P2B)
MET_L: J1.9, U1.5 (SIG), U2.5 (SIG)
MET_R: J1.11, U3.5 (SIG), U4.5 (SIG)
MKL1_1: D1.1 (K), U1.1 (LED1)
MKL1_2: D2.1 (K), U1.18 (LED2)
MKL1_3: D3.1 (K), U1.17 (LED3)
MKL1_4: D4.1 (K), U1.16 (LED4)
MKL1_5: D5.1 (K), U1.15 (LED5)
MKL1_6: D6.1 (K), U1.14 (LED6)
MKL1_7: D7.1 (K), U1.13 (LED7)
MKL1_8: D8.1 (K), U1.12 (LED8)
MKL1_9: D9.1 (K), U1.11 (LED9)
MKL1_10: D10.1 (K), U1.10 (LED10)
MKL2_1: D11.1 (K), U2.1 (LED1)
MKL2_2: D12.1 (K), U2.18 (LED2)
MKL2_3: D13.1 (K), U2.17 (LED3)
MKL2_4: D14.1 (K), U2.16 (LED4)
MKL2_5: D15.1 (K), U2.15 (LED5)
MKL2_6: D16.1 (K), U2.14 (LED6)
MKL2_7: D17.1 (K), U2.13 (LED7)
MKL2_8: D18.1 (K), U2.12 (LED8)
MKL2_9: D19.1 (K), U2.11 (LED9)
MKL2_10: D20.1 (K), U2.10 (LED10)
MKR1_1: D21.1 (K), U3.1 (LED1)
MKR1_2: D22.1 (K), U3.18 (LED2)
MKR1_3: D23.1 (K), U3.17 (LED3)
MKR1_4: D24.1 (K), U3.16 (LED4)
MKR1_5: D25.1 (K), U3.15 (LED5)
MKR1_6: D26.1 (K), U3.14 (LED6)
MKR1_7: D27.1 (K), U3.13 (LED7)
MKR1_8: D28.1 (K), U3.12 (LED8)
MKR1_9: D29.1 (K), U3.11 (LED9)
MKR1_10: D30.1 (K), U3.10 (LED10)
MKR2_1: D31.1 (K), U4.1 (LED1)
MKR2_2: D32.1 (K), U4.18 (LED2)
MKR2_3: D33.1 (K), U4.17 (LED3)
MKR2_4: D34.1 (K), U4.16 (LED4)
MKR2_5: D35.1 (K), U4.15 (LED5)
MKR2_6: D36.1 (K), U4.14 (LED6)
MKR2_7: D37.1 (K), U4.13 (LED7)
MKR2_8: D38.1 (K), U4.12 (LED8)
MKR2_9: D39.1 (K), U4.11 (LED9)
MKR2_10: D40.1 (K), U4.10 (LED10)
MONO_SW: J1.7, SW1.2 (P1B)
MREFL1: R2.1, U1.7 (REFOUT)
MREFL2: R3.1, U2.7 (REFOUT)
MREFR1: R4.1, U3.7 (REFOUT)
MREFR2: R5.1, U4.7 (REFOUT)
POT_B: J1.3, RV1.2 (W)
POT_M: J1.1, RV2.2 (W)
VREFA: J1.13, U1.6 (RHI), U3.6 (RHI)
VREFB: J1.14, U2.6 (RHI), U4.6 (RHI)

Notes on the sheet:
POT e TASTO MONO (posizioni dal render del pannello)
METER L e R: 2 LM3915 in cascata per lato, 20 LED
CAVI: J1 verso la scheda di segnale (J3), J2 verso la scheda d'uscita L (J4)

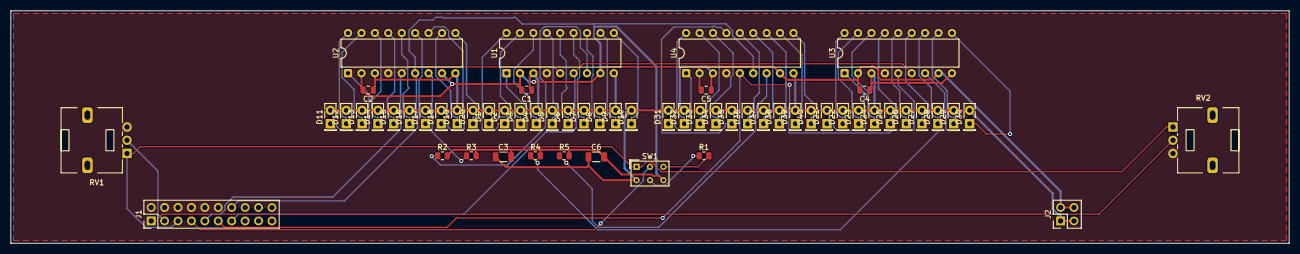
[picture p78: board master-comandi.kicad_pcb from above]

Board: 4 copper layers, 242.0 x 44.0 mm, 60 parts (0 on the bottom side), 57 nets.
