dj-filippo241/maelcum_mixer/pcb/canale/comandi/canale-comandi.kicad_pcb

## KiCad design pcb/canale/comandi/canale-comandi.kicad_pcb (2026-11-11)

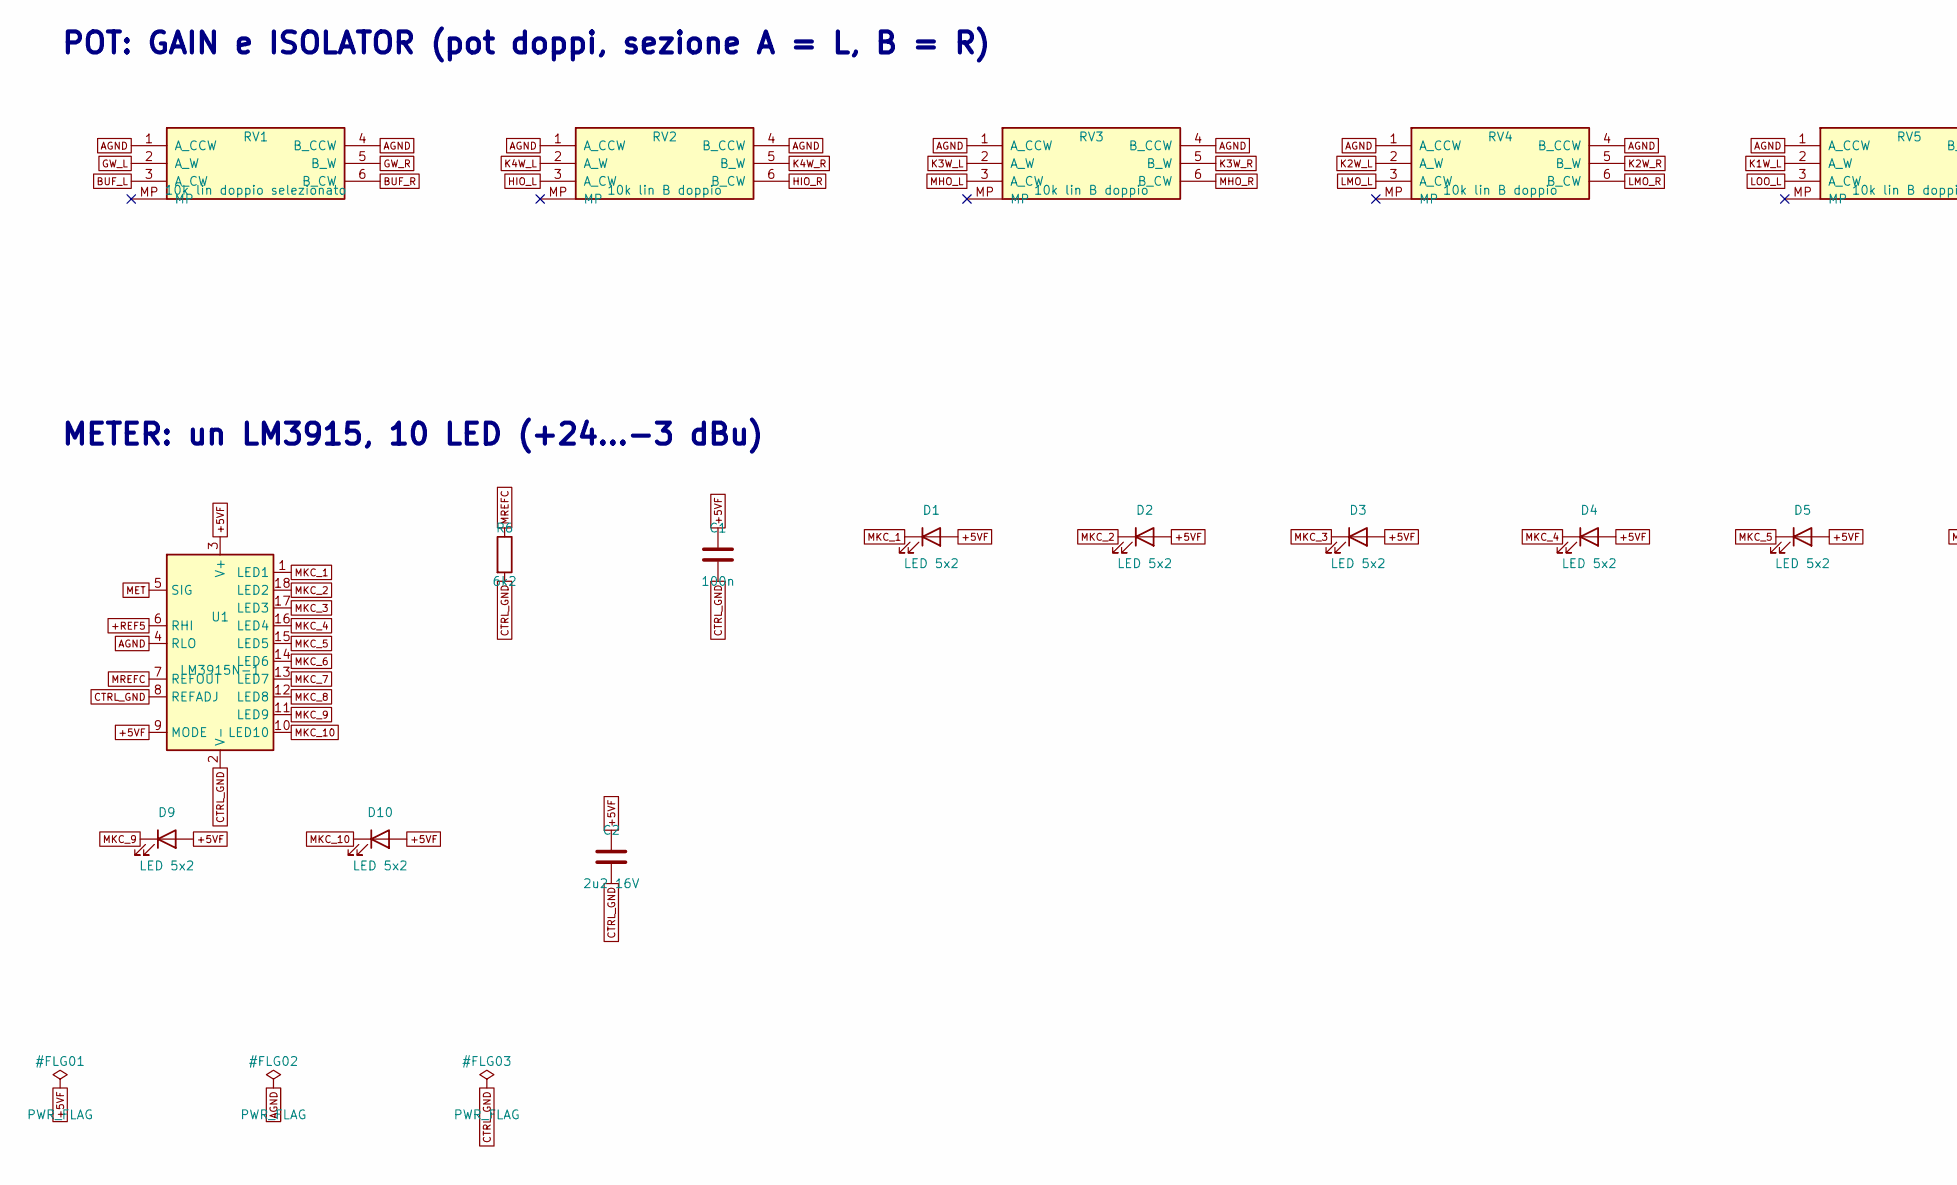
[picture p79: schematic canale-comandi.kicad_sch, maelcum CANALE scheda comandi - bozza v0.1, part in row 1, column 1]

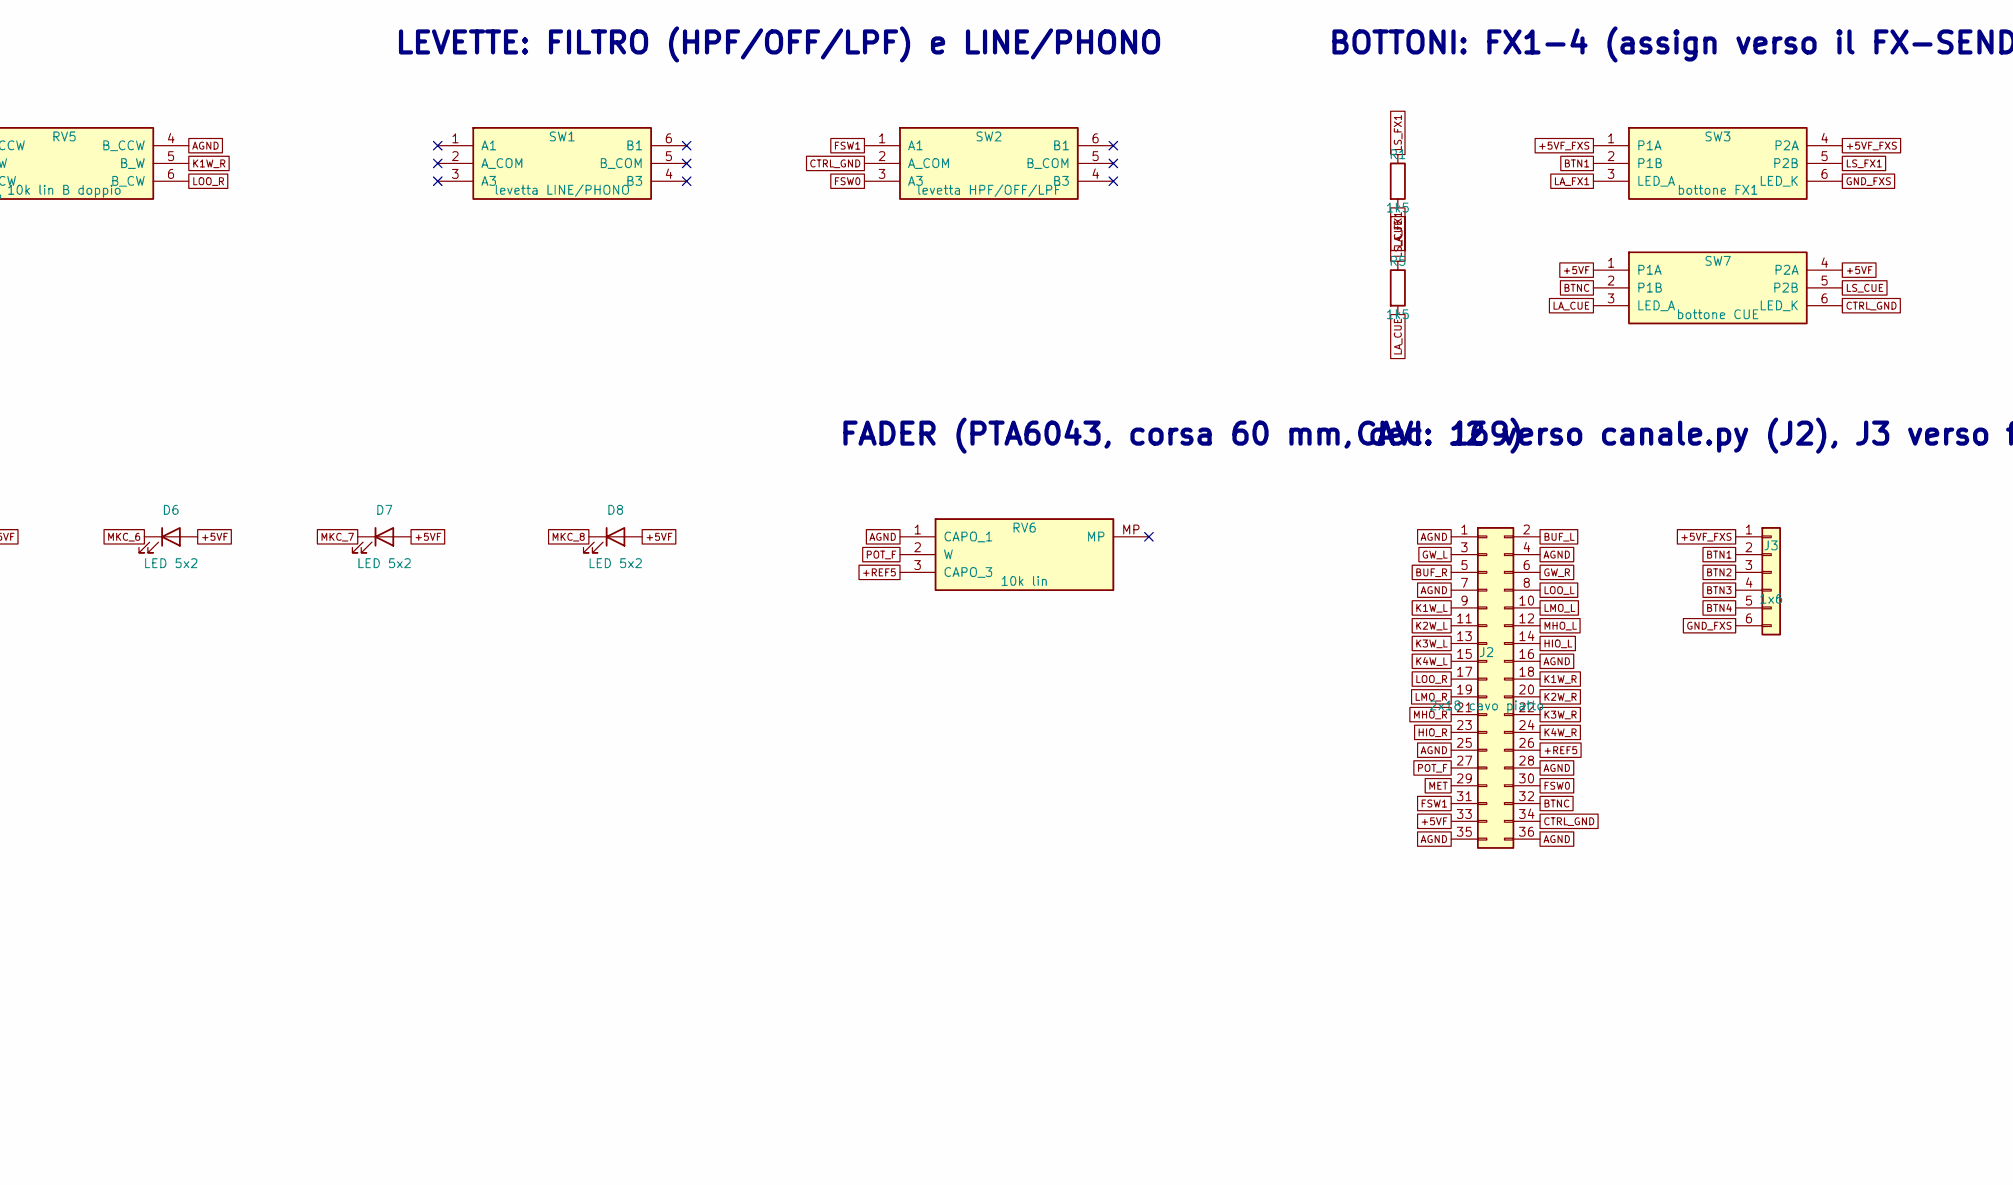
[picture p80: schematic canale-comandi.kicad_sch, maelcum CANALE scheda comandi - bozza v0.1, part in row 1, column 2]

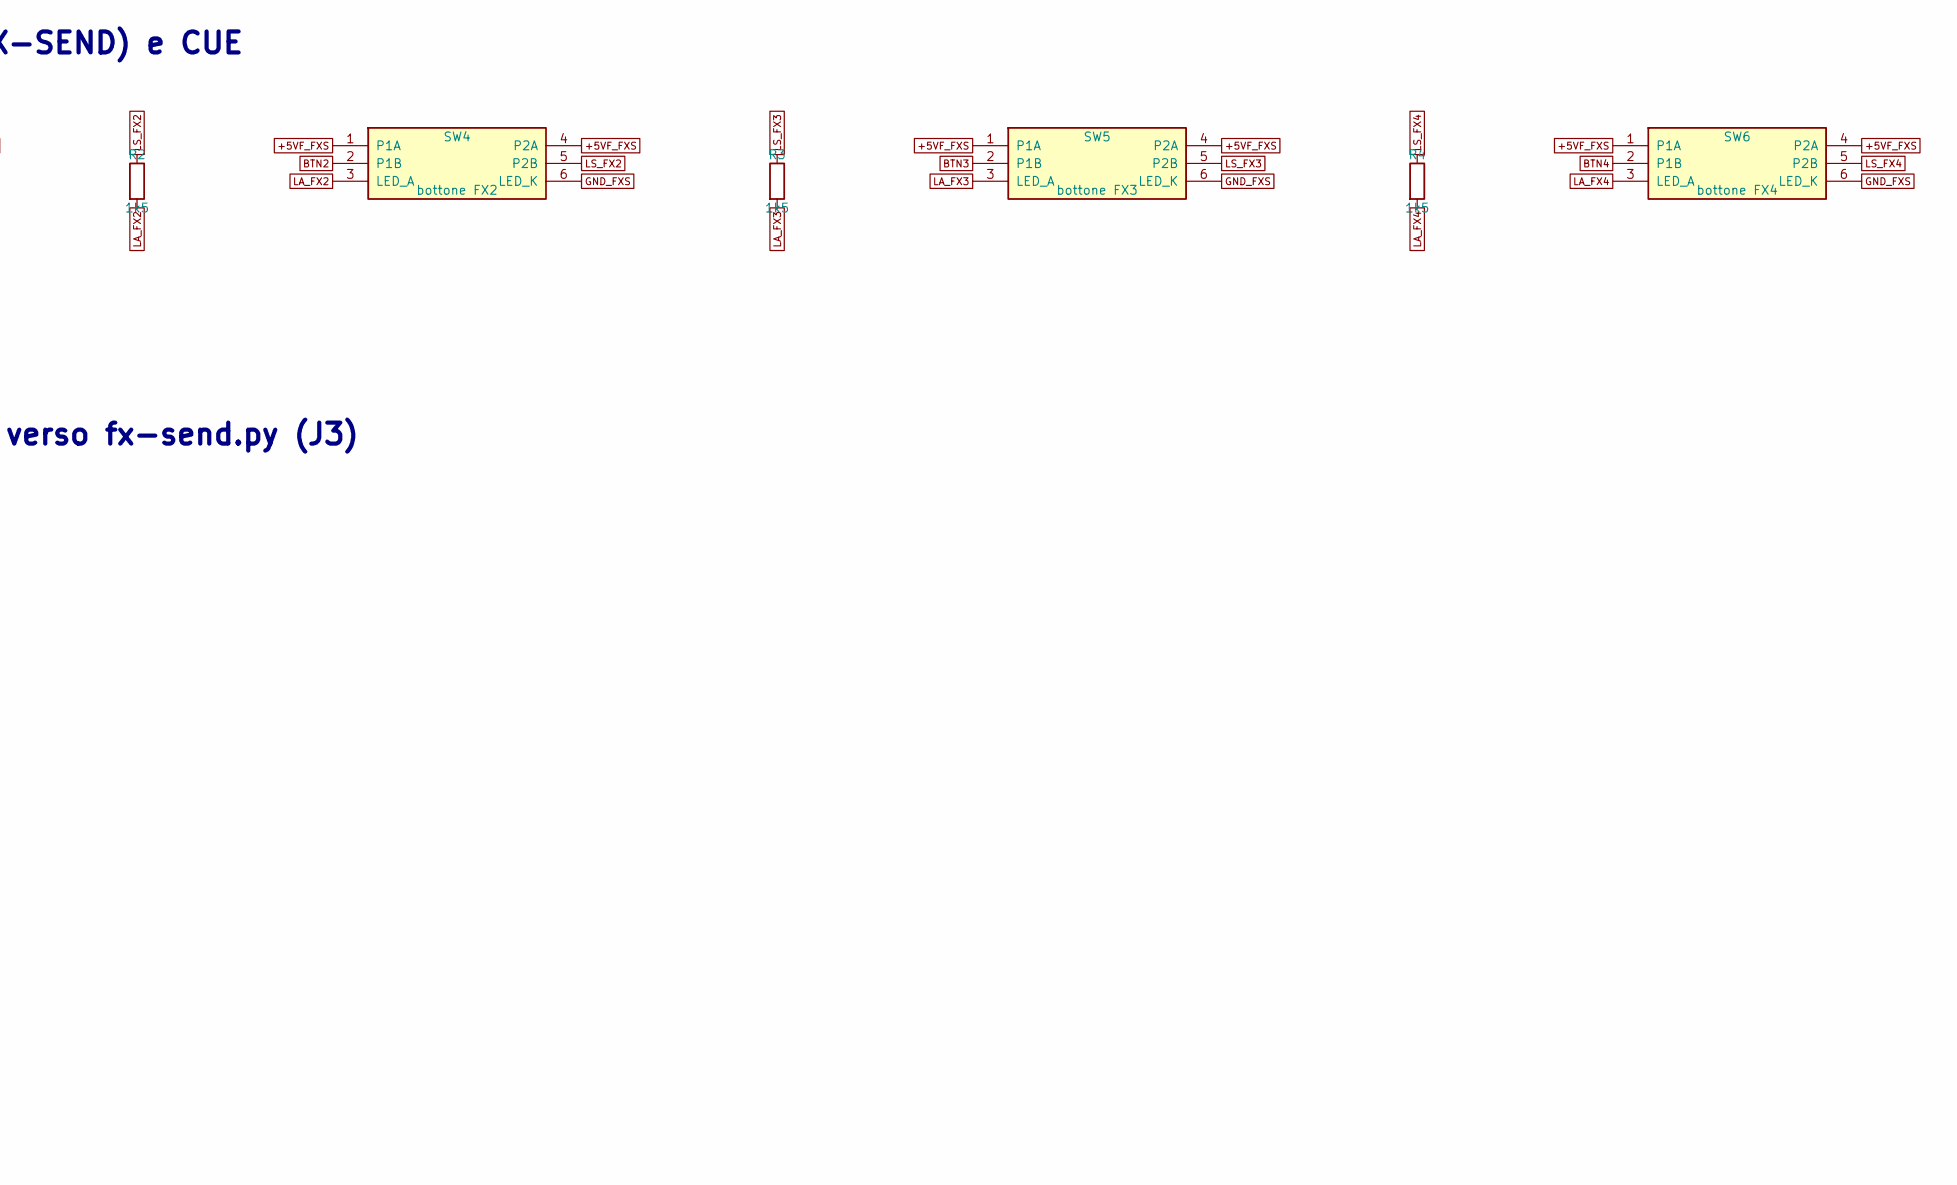
[picture p81: schematic canale-comandi.kicad_sch, maelcum CANALE scheda comandi - bozza v0.1, part in row 1, column 3]

Parts:
C1: 100n; C_0805_2012Metric
C2: 2u2 16V; C_1206_3216Metric
D1, D2, D3, D4, D5, D6, D7, D8, D9, D10: LED 5x2; LED_Rectangular_W5.0mm_H2.0mm
J2: 2x18 cavo piatto; PinHeader_2x18_P2.54mm_Vertical
J3: 1x6; PinHeader_1x06_P2.54mm_Vertical
R1, R2, R3, R4, R5: 1k5; R_0805_2012Metric
R6: 6k2; R_0805_2012Metric
RV1: 10k lin doppio selezionato; Potentiometer_Alps_RK09L_Double_Vertical
RV2, RV3, RV4, RV5: 10k lin B doppio; Potentiometer_Alps_RK09L_Double_Vertical
RV6: 10k lin; Potentiometer_Bourns_PTA6043_Single_Slide
SW1: levetta LINE/PHONO; SW_NKK_G1xJP
SW2: levetta HPF/OFF/LPF; SW_NKK_G1xJP
SW3: bottone FX1; SW_NKK_GW12LJP
SW4: bottone FX2; SW_NKK_GW12LJP
SW5: bottone FX3; SW_NKK_GW12LJP
SW6: bottone FX4; SW_NKK_GW12LJP
SW7: bottone CUE; SW_NKK_GW12LJP
U1: LM3915N-1; DIP-18_W7.62mm

Connections:
+5VF: C1.1, C2.1, D1.2 (A), D2.2 (A), D3.2 (A), D4.2 (A), D5.2 (A), D6.2 (A), D7.2 (A), D8.2 (A), D9.2 (A), D10.2 (A), J2.33, SW7.1 (P1A), SW7.4 (P2A), U1.3 (V+), U1.9 (MODE)
+5VF_FXS: J3.1, SW3.1 (P1A), SW3.4 (P2A), SW4.1 (P1A), SW4.4 (P2A), SW5.1 (P1A), SW5.4 (P2A), SW6.1 (P1A), SW6.4 (P2A)
+REF5: J2.26, RV6.3 (CAPO_3), U1.6 (RHI)
AGND: J2.1, J2.4, J2.7, J2.16, J2.25, J2.28, J2.35, J2.36, RV1.1 (A_CCW), RV1.4 (B_CCW), RV2.1 (A_CCW), RV2.4 (B_CCW), RV3.1 (A_CCW), RV3.4 (B_CCW), RV4.1 (A_CCW), RV4.4 (B_CCW), RV5.1 (A_CCW), RV5.4 (B_CCW), RV6.1 (CAPO_1), U1.4 (RLO)
BTN1: J3.2, SW3.2 (P1B)
BTN2: J3.3, SW4.2 (P1B)
BTN3: J3.4, SW5.2 (P1B)
BTN4: J3.5, SW6.2 (P1B)
BTNC: J2.32, SW7.2 (P1B)
BUF_L: J2.2, RV1.3 (A_CW)
BUF_R: J2.5, RV1.6 (B_CW)
CTRL_GND: C1.2, C2.2, J2.34, R6.2, SW2.2 (A_COM), SW7.6 (LED_K), U1.2 (V-), U1.8 (REFADJ)
FSW0: J2.30, SW2.3 (A3)
FSW1: J2.31, SW2.1 (A1)
GND_FXS: J3.6, SW3.6 (LED_K), SW4.6 (LED_K), SW5.6 (LED_K), SW6.6 (LED_K)
GW_L: J2.3, RV1.2 (A_W)
GW_R: J2.6, RV1.5 (B_W)
HIO_L: J2.14, RV2.3 (A_CW)
HIO_R: J2.23, RV2.6 (B_CW)
K1W_L: J2.9, RV5.2 (A_W)
K1W_R: J2.18, RV5.5 (B_W)
K2W_L: J2.11, RV4.2 (A_W)
K2W_R: J2.20, RV4.5 (B_W)
K3W_L: J2.13, RV3.2 (A_W)
K3W_R: J2.22, RV3.5 (B_W)
K4W_L: J2.15, RV2.2 (A_W)
K4W_R: J2.24, RV2.5 (B_W)
LA_CUE: R5.2, SW7.3 (LED_A)
LA_FX1: R1.2, SW3.3 (LED_A)
LA_FX2: R2.2, SW4.3 (LED_A)
LA_FX3: R3.2, SW5.3 (LED_A)
LA_FX4: R4.2, SW6.3 (LED_A)
LMO_L: J2.10, RV4.3 (A_CW)
LMO_R: J2.19, RV4.6 (B_CW)
LOO_L: J2.8, RV5.3 (A_CW)
LOO_R: J2.17, RV5.6 (B_CW)
LS_CUE: R5.1, SW7.5 (P2B)
LS_FX1: R1.1, SW3.5 (P2B)
LS_FX2: R2.1, SW4.5 (P2B)
LS_FX3: R3.1, SW5.5 (P2B)
LS_FX4: R4.1, SW6.5 (P2B)
MET: J2.29, U1.5 (SIG)
MHO_L: J2.12, RV3.3 (A_CW)
MHO_R: J2.21, RV3.6 (B_CW)
MKC_1: D1.1 (K), U1.1 (LED1)
MKC_2: D2.1 (K), U1.18 (LED2)
MKC_3: D3.1 (K), U1.17 (LED3)
MKC_4: D4.1 (K), U1.16 (LED4)
MKC_5: D5.1 (K), U1.15 (LED5)
MKC_6: D6.1 (K), U1.14 (LED6)
MKC_7: D7.1 (K), U1.13 (LED7)
MKC_8: D8.1 (K), U1.12 (LED8)
MKC_9: D9.1 (K), U1.11 (LED9)
MKC_10: D10.1 (K), U1.10 (LED10)
MREFC: R6.1, U1.7 (REFOUT)
POT_F: J2.27, RV6.2 (W)

Notes on the sheet:
POT: GAIN e ISOLATOR (pot doppi, sezione A = L, B = R)
LEVETTE: FILTRO (HPF/OFF/LPF) e LINE/PHONO
BOTTONI: FX1-4 (assign verso il FX-SEND) e CUE
METER: un LM3915, 10 LED (+24...-3 dBu)
FADER (PTA6043, corsa 60 mm, dec. 169)
CAVI: J2 verso canale.py (J2), J3 verso fx-send.py (J3)

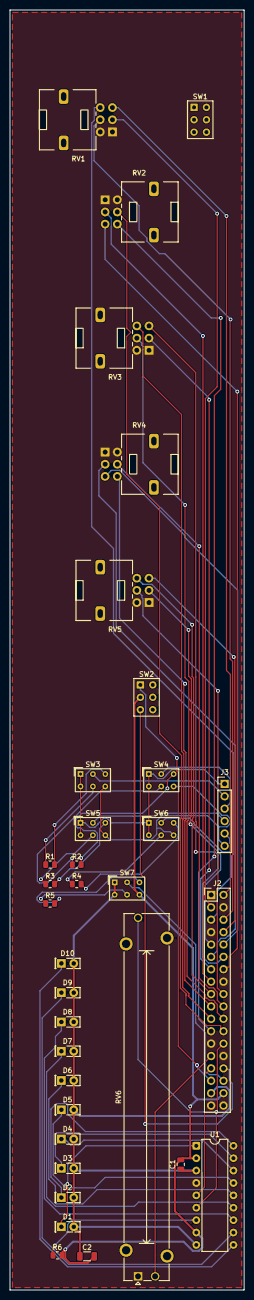
[picture p82: board canale-comandi.kicad_pcb from above]

Board: 4 copper layers, 48.0 x 262.4 mm, 34 parts (0 on the bottom side), 56 nets.
