dj-filippo241/maelcum_mixer/pcb/fx-send/comandi/fx-send-comandi.kicad_pcb

## KiCad design pcb/fx-send/comandi/fx-send-comandi.kicad_pcb (2026-11-10)

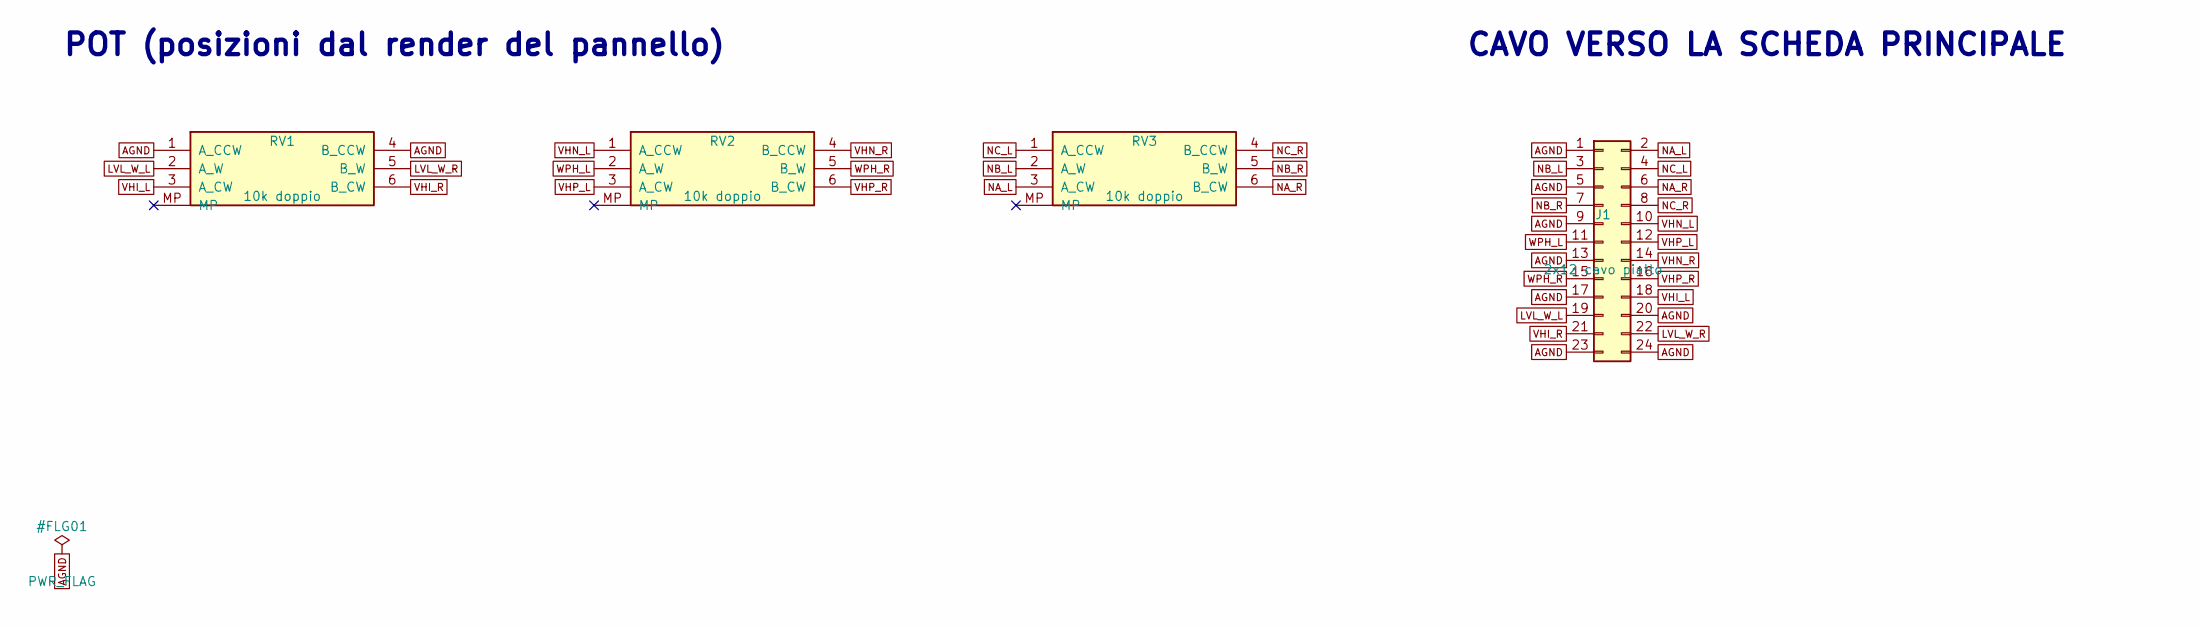
[picture p83: schematic fx-send-comandi.kicad_sch, maelcum FX-SEND scheda comandi - bozza v0.2]

Parts:
J1: 2x12 cavo piatto; PinHeader_2x12_P2.54mm_Vertical
RV1, RV2, RV3: 10k doppio; Potentiometer_Alps_RK09L_Double_Vertical

Connections:
AGND: J1.1, J1.5, J1.9, J1.13, J1.17, J1.20, J1.23, J1.24, RV1.1 (A_CCW), RV1.4 (B_CCW)
LVL_W_L: J1.19, RV1.2 (A_W)
LVL_W_R: J1.22, RV1.5 (B_W)
NA_L: J1.2, RV3.3 (A_CW)
NA_R: J1.6, RV3.6 (B_CW)
NB_L: J1.3, RV3.2 (A_W)
NB_R: J1.7, RV3.5 (B_W)
NC_L: J1.4, RV3.1 (A_CCW)
NC_R: J1.8, RV3.4 (B_CCW)
VHI_L: J1.18, RV1.3 (A_CW)
VHI_R: J1.21, RV1.6 (B_CW)
VHN_L: J1.10, RV2.1 (A_CCW)
VHN_R: J1.14, RV2.4 (B_CCW)
VHP_L: J1.12, RV2.3 (A_CW)
VHP_R: J1.16, RV2.6 (B_CW)
WPH_L: J1.11, RV2.2 (A_W)
WPH_R: J1.15, RV2.5 (B_W)

Notes on the sheet:
POT (posizioni dal render del pannello)
CAVO VERSO LA SCHEDA PRINCIPALE

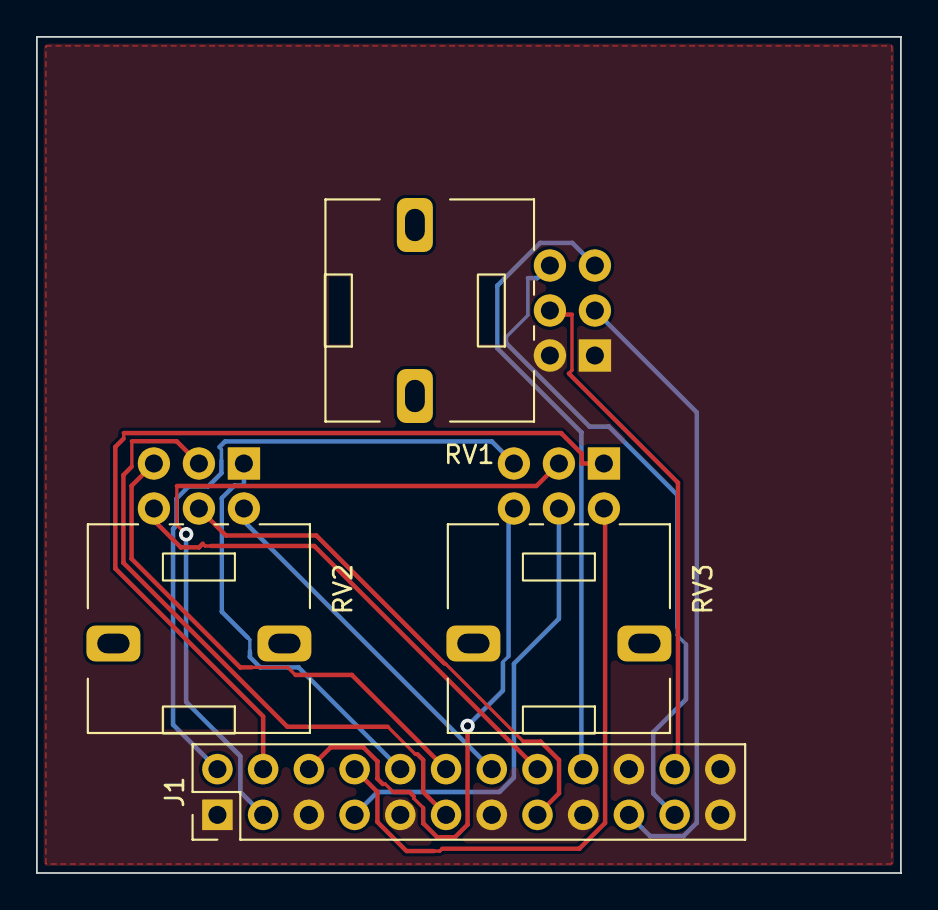
[picture p84: board fx-send-comandi.kicad_pcb from above]

Board: 4 copper layers, 48.0 x 46.5 mm, 4 parts (0 on the bottom side), 17 nets.
