dj-filippo241/maelcum_mixer/pcb/mic/comandi/mic-comandi.kicad_pcb

## KiCad design pcb/mic/comandi/mic-comandi.kicad_pcb (2026-11-10)

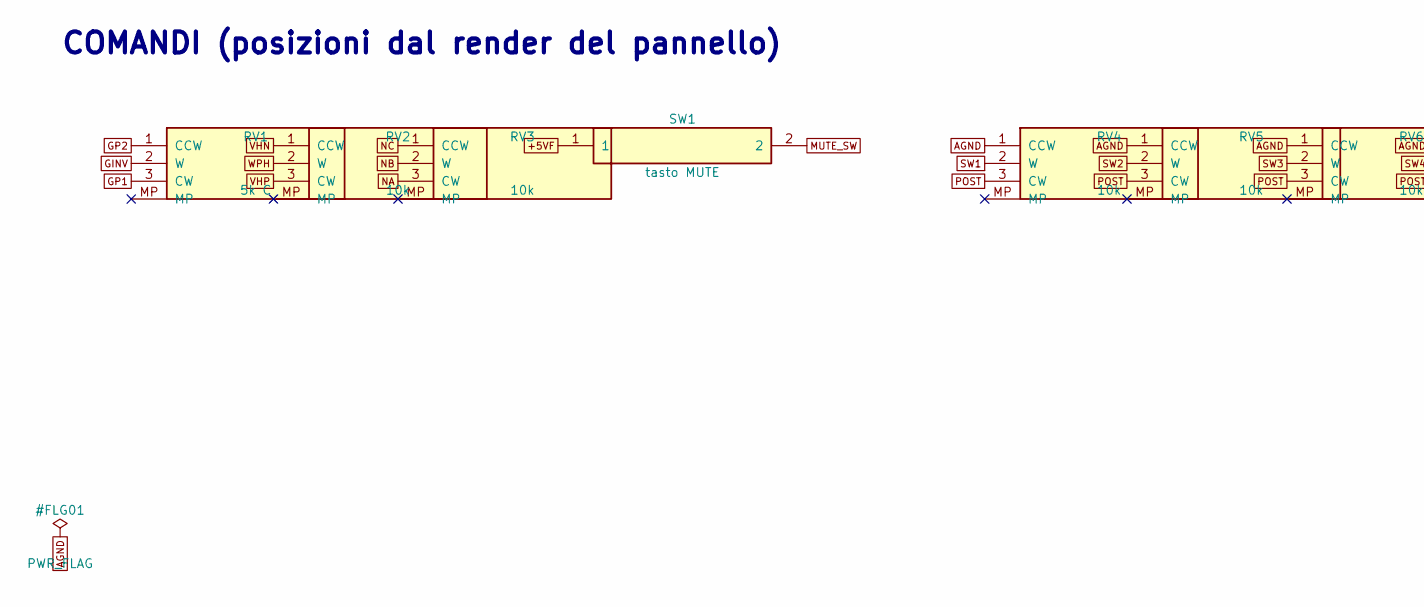
[picture p85: schematic mic-comandi.kicad_sch, maelcum MIC scheda comandi - bozza v0.1, part in row 1, column 1]

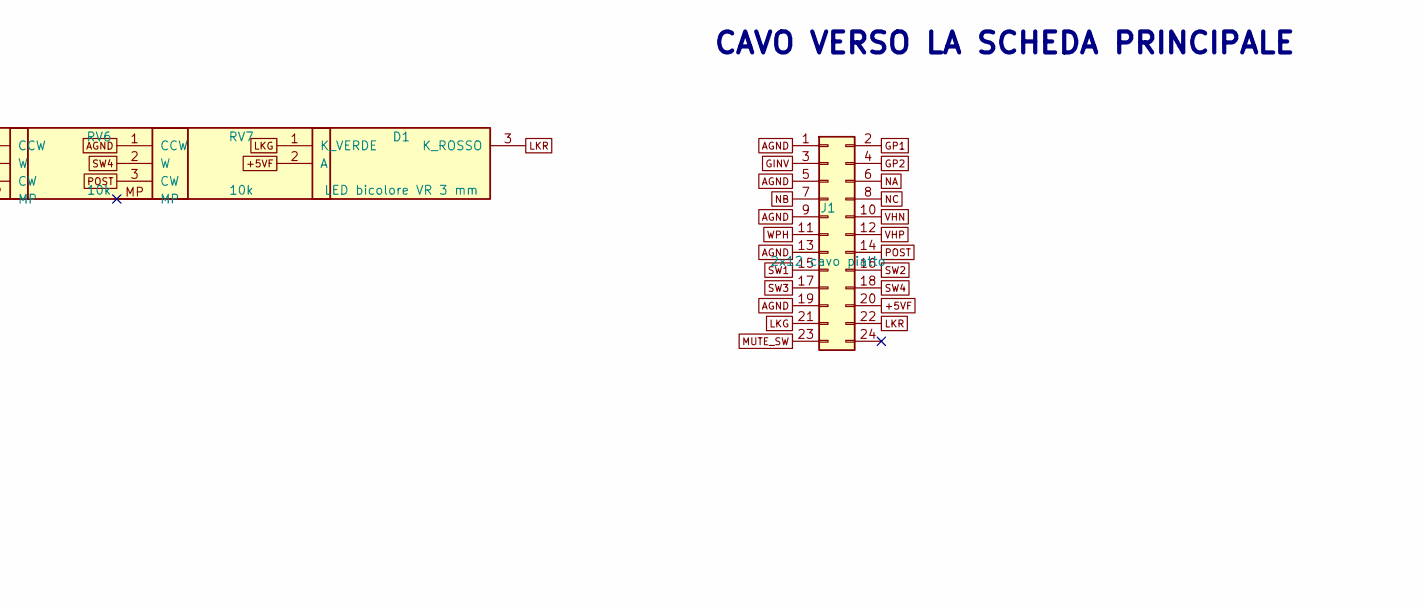
[picture p86: schematic mic-comandi.kicad_sch, maelcum MIC scheda comandi - bozza v0.1, part in row 1, column 2]

Parts:
D1: LED bicolore VR 3 mm; LED_D3.0mm-3
J1: 2x12 cavo piatto; PinHeader_2x12_P2.54mm_Vertical
RV1: 5k C; Potentiometer_Alps_RK09L_Single_Vertical
RV2, RV3, RV4, RV5, RV6, RV7: 10k; Potentiometer_Alps_RK09L_Single_Vertical
SW1: tasto MUTE; SW_PUSH_6mm

Connections:
+5VF: D1.2 (A), J1.20, SW1.1
AGND: J1.1, J1.5, J1.9, J1.13, J1.19, RV4.1 (CCW), RV5.1 (CCW), RV6.1 (CCW), RV7.1 (CCW)
GINV: J1.3, RV1.2 (W)
GP1: J1.2, RV1.3 (CW)
GP2: J1.4, RV1.1 (CCW)
LKG: D1.1 (K_VERDE), J1.21
LKR: D1.3 (K_ROSSO), J1.22
MUTE_SW: J1.23, SW1.2
NA: J1.6, RV3.3 (CW)
NB: J1.7, RV3.2 (W)
NC: J1.8, RV3.1 (CCW)
POST: J1.14, RV4.3 (CW), RV5.3 (CW), RV6.3 (CW), RV7.3 (CW)
SW1: J1.15, RV4.2 (W)
SW2: J1.16, RV5.2 (W)
SW3: J1.17, RV6.2 (W)
SW4: J1.18, RV7.2 (W)
VHN: J1.10, RV2.1 (CCW)
VHP: J1.12, RV2.3 (CW)
WPH: J1.11, RV2.2 (W)

Notes on the sheet:
COMANDI (posizioni dal render del pannello)
CAVO VERSO LA SCHEDA PRINCIPALE

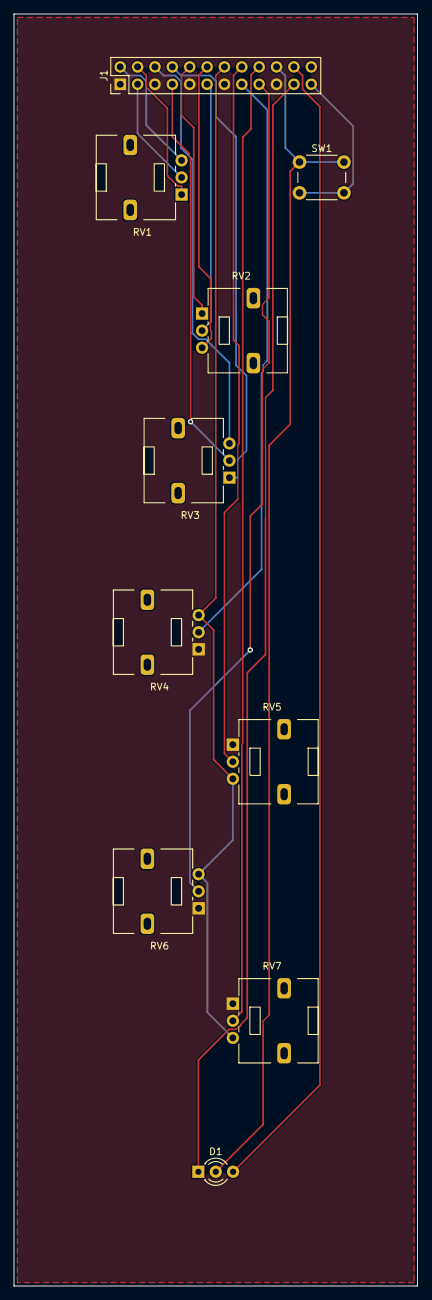
[picture p87: board mic-comandi.kicad_pcb from above]

Board: 4 copper layers, 59.0 x 186.0 mm, 10 parts (0 on the bottom side), 19 nets.
