dj-filippo241/maelcum_mixer/pcb/mono/comandi/mono-comandi.kicad_pcb

## KiCad design pcb/mono/comandi/mono-comandi.kicad_pcb (2026-11-10)

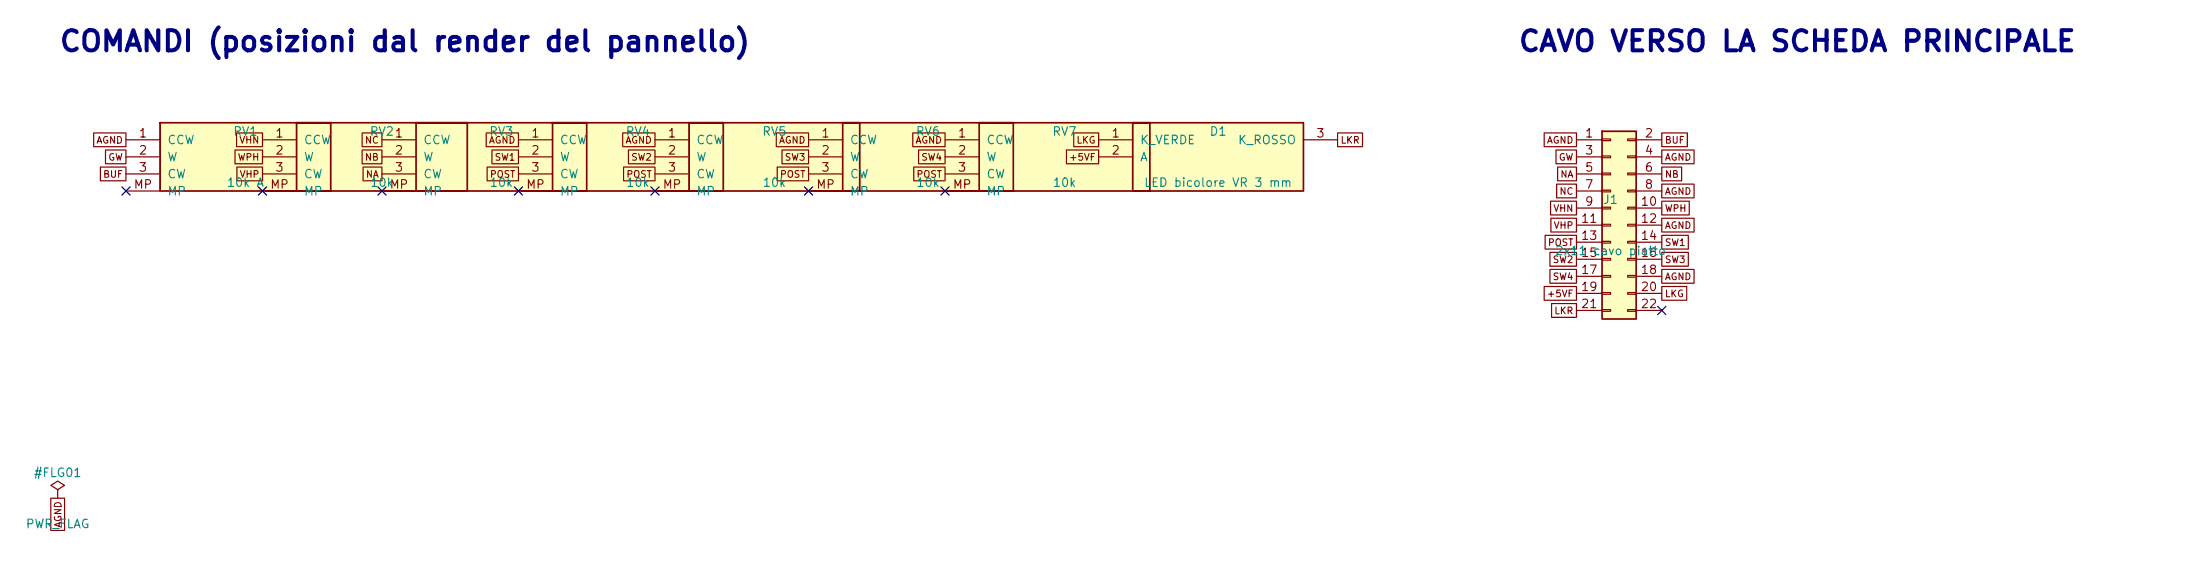
[picture p88: schematic mono-comandi.kicad_sch, maelcum MONO scheda comandi - bozza v0.1]

Parts:
D1: LED bicolore VR 3 mm; LED_D3.0mm-3
J1: 2x11 cavo piatto; PinHeader_2x11_P2.54mm_Vertical
RV1: 10k A; Potentiometer_Alps_RK09L_Single_Vertical
RV2, RV3, RV4, RV5, RV6, RV7: 10k; Potentiometer_Alps_RK09L_Single_Vertical

Connections:
+5VF: D1.2 (A), J1.19
AGND: J1.1, J1.4, J1.8, J1.12, J1.18, RV1.1 (CCW), RV4.1 (CCW), RV5.1 (CCW), RV6.1 (CCW), RV7.1 (CCW)
BUF: J1.2, RV1.3 (CW)
GW: J1.3, RV1.2 (W)
LKG: D1.1 (K_VERDE), J1.20
LKR: D1.3 (K_ROSSO), J1.21
NA: J1.5, RV3.3 (CW)
NB: J1.6, RV3.2 (W)
NC: J1.7, RV3.1 (CCW)
POST: J1.13, RV4.3 (CW), RV5.3 (CW), RV6.3 (CW), RV7.3 (CW)
SW1: J1.14, RV4.2 (W)
SW2: J1.15, RV5.2 (W)
SW3: J1.16, RV6.2 (W)
SW4: J1.17, RV7.2 (W)
VHN: J1.9, RV2.1 (CCW)
VHP: J1.11, RV2.3 (CW)
WPH: J1.10, RV2.2 (W)

Notes on the sheet:
COMANDI (posizioni dal render del pannello)
CAVO VERSO LA SCHEDA PRINCIPALE

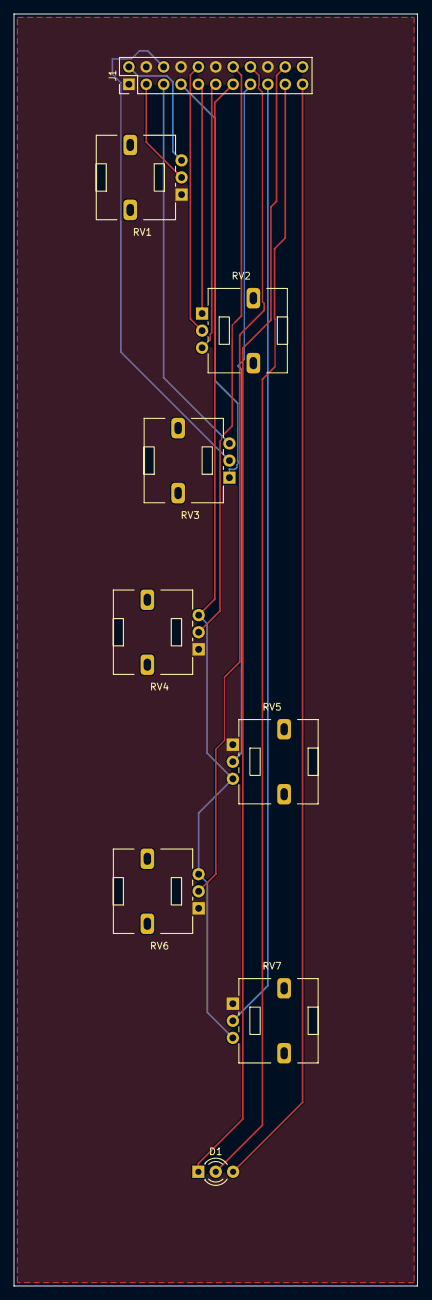
[picture p89: board mono-comandi.kicad_pcb from above]

Board: 4 copper layers, 59.0 x 186.0 mm, 9 parts (0 on the bottom side), 17 nets.
