dj-filippo241/maelcum_mixer/(commit log)

2026-09-18 feat(fase1): design circuitale modulo MASTER OUT v0.1 + deroga pre-export registrata
2026-09-18 docs: decisioni 58-66 (risposte Filippo), corpus chiuso, correzione filtro esterno, requisito infrasub 10Hz, chiusure questioni, addendum design
2026-09-18 docs: decisione 67-69 — architettura filtro B' (6 knob, core per canale, no BPF), HPF min 10 Hz, phono rca/capacita confermata
2026-09-18 feat(fase1): prime simulazioni LTspice composite master-out — swing ±15,85V (+23,2dBu, sotto requisito +24: questione 60), banda OK ±0,15dB, THD <0,005%, corto 460mA senza protezione
2026-09-24 feat(fase1): simulazioni EQ CDJ complete — questione 62 CRITICA: la fase delle celle rompe kill/boost LOW/HIGH (kill -8 dB @20 Hz + bump +1,5 dB @70, leak all-kill -0,67 dB, boost HIGH ~0 dB @5k); de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
2026-09-24 docs: decisione 76 [F] — topologia EQ canale CDJ = serie per banda (famiglia Baxandall); questione 62 chiusa, 59 riformulata (residuo all-kill da quantificare in EQ v0.3), 53 aggiornata; CLAUDE.md al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
2026-09-24 feat(fase2): design modulo filtro v0.1 + fattibilita SVF OTA/converter esponenziale dimostrata in simulazione — range 10 Hz-33,5 kHz spaziato a ottave (2,00), law ±2-3% post-calibrazione, deriva term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
2026-09-24 docs: CLAUDE.md allineato a fine sessione — filtro v0.1 fatto (49 chiusa, 51 aggiornata, 2 nuove APERTO-F), EQ v0.3 priorità, struttura aggiornata (docs/fase2/, sim/cdj-eq/, sim/filtro/)
2026-09-24 docs: fix da review di completezza — SPECIFICA allineata a decisione 76 (topologia EQ [SUPERATO]) e fattibilita filtro (§5); questioni 63/64/65 registrate (mux CV, allineamento 4 poli, EQ2 FX eredita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
2026-09-24 feat(fase1): EQ v0.3-ALPHA — cella serie Baxandall a law asimmetrica dimostrata in LTspice: detent −0,02 dB piatto, boost +5,8 dB shelf liscio (niente buco a 150 Hz), kill −29,8 dB MONOTONO senza bum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
2026-09-24 docs: decisione 77 [F] — profondità kill EQ = −30 dB (Rp/R ≈ 31); questione 66 chiusa; eq-serie-v0.3 §5 aggiornato
2026-09-24 docs: decisione 78 [F] — prototipo musicale Max for Live del mixer completo PRIMA del millefori; piano P0-P4 (docs/proto-max/piano.md): famiglia dispositivi MC-PROTO, validazione a orecchio di curve/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
2026-09-24 docs: fix da review 2 — SPECIFICA recepisce decisione 77 (kill EQ = −30 dB, fader per silenzio assoluto) e decisione 78 (prototipo M4L nella regola trasversale §16), header decisioni 1-78; eq-serie-v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
2026-09-25 docs: CLAUDE.md allineato (gap G3 review 2, autorizzato da Filippo via housekeeping) — EQ v0.3-alpha fatta, decisioni 77/78, struttura con eq-serie/proto-max/sim aggiornata, 78 voci, prossimo passo: 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
2026-09-25 feat(fase1): EQ v0.3-BETA-1 — cascata 4 bande completa validata in LTspice: celle MID a campana (notch −45 dB esatto al centro) e HIGH sottrattiva (duale serie-RC bocciato); detent piatto ±0,02 dB (o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
2026-09-25 feat(fase1): EQ v0.3-BETA-2 + integrazione cdj-line-channel v0.3 — riferimento interno −6 dB (picchi interni 7,6 V: headroom risolto), summer 49,9k, curve invariate, rumore −110,7 dBu PASS (18,7 dB m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
2026-09-25 feat(fase2): modulo filtro v0.2 — risonanza SIMULATA: iniezione OTA (1/Q=Rf·gm_res, sezione LM13700 di riserva per core), auto-oscillazione +7,3…+8,6 dBu con soft limiter 3×1N4148 (target SPEC +6…+10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
2026-09-25 feat(fase1): modulo FX design v0.1 — architettura completa (4 bus + pad/driver pedali, 4 ritorni JFET hi-Z + DC servo, matrice feedback 12× THAT 2181 con law a tratti SPEC); loop feedback SIMULATO: b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
2026-09-25 feat(fase2): modulo 5-WAY design v0.1 — KILL bank LR4 con gate VCA VALIDATO (kill per via −24…−76 dB, all-kill = silenzio assoluto); FINDING: somma piatta esatta richiede banca allineata in fase (all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
2026-09-25 docs: fix da review 3 — cascade.cir allineato al Q HP2 corretto (run di riferimento: cascade-b2), fx-module numeri kill HIGH aggiornati + questione 69 numerata, SPECIFICA §6 punta a five-way-module v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
2026-09-25 docs: CLAUDE.md allineato a fine sessione 2 (autorizzato da Filippo via menu) — EQ beta-2, filtro v0.2, FX v0.1, 5-way v0.1, M4L in pausa, fix Q HP2, struttura con fx-module/five-way/sim aggiornate, 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
2026-09-27 docs: housekeeping da review sessione 2 — bank-debug.cir marcato STORICO (contiene SKHP pre-fix Q 0,354: non riusare, riferimento bank-lr4.cir) e citato in five-way §8.1; frase silicon/BOM ripulita i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
2026-09-27 feat(fase2): 5-WAY v0.2-WIP — KILL BANK ALLINEATA IN FASE VALIDATA: somma piatta ESATTA (−0,0002…−0,008 dB su 5 Hz–60 kHz, requisito ±0,1 dB con margine 12×); questione 8 chiusa per la matematica. Te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
2026-09-27 feat(fase2): 5-WAY v0.2-WIP celle parametriche + cascata VALIDATE — cella sottrattiva SVF completa (param-cell.cir, griglia Q 0,5/1/3 × b): detent ±0,0001 dB piatto per costruzione, boost +9,005/+12,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
2026-09-27 feat(fase2): 5-WAY v0.2 rumore percorso completo SIMULATO — PASS −108,4 dBu (integrato 20 Hz-20 kHz non A-pesato, macro uniforme ~6 nV conservativa) contro target sheet §3 ≤−90: margine 18,4 dB; deco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
2026-09-27 feat(fase2): 5-WAY v0.2 gate VCA + ramp 1 ms VALIDATO + modello THAT 218x CONDIVISO (sim/lib/that2181.inc, un modello tre usi: gate 5-way/FX v0.2/CDJ §7) — kill al picco +10 dBu: click HF 3,64 V brus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
2026-09-27 feat(fase1): EQ v0.3 BETA-3 — macro op-amp REALI (sim/lib/opamp-audio.inc condivisa: OP1654 en 4,5 nV A0 120dB GBW 20MHz / OP1612 en 1,1 nV A0 130dB GBW 80MHz, calibrazione Rn=en²/4kT, polo R-piccola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
2026-09-27 feat(fase1): CDJ §7 item 2 — VCA GAIN THAT 218x VERIFICATO (sim/cdj/vca-law.cir + vca-headroom.cir, macro condiviso): law dB(θ) via shaper a tratti esatta (−100/−80/−50/0/+2,5/+5/+7,5/+10 dB ai θ di 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
2026-09-27 feat(fase1): CDJ §7 item 4 — SUMMING DJ BUS 4 canali VERIFICATO (djbus-level.cir + djbus-crosstalk.cir, OP1612 reale da lib): worst sheet CONFERMATO +12,0 dBu (4×0 correlati = 4,36 Vpk, margine 11,6 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
2026-09-27 feat(fase1): FX v0.2 parziale — LAW A TRATTI REROUTE VERIFICATA end-to-end (reroute-law.cir: pot → shaper PWL a 6 breakpoint → smoothing RC → THAT 218x con macro condiviso): griglia 13 punti ESATTA a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
2026-09-27 feat(meter): PEAK DETECTOR CONDIVISO simulato (sim/meter/ + RISULTATI-peak-det.md — chiude CDJ §7.3, FX §11.2, alimenta questione 19) — circuito candidato: superdiodo OP1612-class + clamp anti-windup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
2026-09-27 feat(fase1): FX v0.2 design COMPLETO — (a) TVS/banda 40 kHz VERIFICATA con CORREZIONE del claim v0.1: il polo HF lo fa la Z sorgente, non la R bias 1 MΩ ('−1,6 dB @40k con 10 pF' era sbagliato due vo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
2026-09-27 docs(fase1): fx-module header allineato a v0.2 (2026-09-28) — law reroute §8.3, DC servo/EQ2/TVS §8.4, peak detector condiviso, correzione 218x single; design completo salvo shaper discreto e ratific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
2026-09-28 docs: housekeeping D1-D9 (review completezza 2026-09-28) — D1 puntatori 'CDJ §7.3' pendoli → '§7 item 6' (fx-module, five-way ×2, RISULTATI-peak-det, peak-det-lf.cir) + fx 'item 2'→4; D2 lista FATTE 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
2026-09-28 feat(fase2): LM13700 REALE + ramp BBM — filtro v0.3 parziale e coda beta-3 5-way (NUOVA questione 70)
    (a) MODELLO CONDIVISO sim/lib/lm13700.inc: transistor-level calibrato su datasheet TI SNOSBW2F — gm 19,4·Iabc ±0,5% su 100n-500µ, Iout_max ≈ Iabc (350-650µ a 500µ), rumore FISICO (limite della coppia: 2,6 nV/√Hz a 500µ … 133 a 100n; die reale 2-5x peggio, datasheet senza spec numerica), Vos per istanza, Vaf=2000 (Zout 7M ≈ 8M datasheet; con Vaf=100 gm +20% e offset 7%·Iabc = artefatti), diodi linearizzanti inclusi. Self-test 4 netlist (ac/tran/diode/noise).
    (b) FINDING STRUTTURALE — TETTO DEI 52 mV: Vstato_max(f0) = 1/19,2 per ogni integratore OTA, indipendente da Iabc/C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
2026-09-28 feat(fase2): PoC questione 70 VALIDATO — due topologie 'pulite' per i core SVF simulate e confrontate (RISULTATI-cell-clean.md)
    (a) ANALISI: lo schizzo iniziale 'op-amp integrator + OTA scalatore gm' è BOCCIATO senza simulazione — muro doppio del rumore: ogni divisione k del segnale con make-up ×k riferisce l'en dell'elemento di controllo ×k (OTA ≥2,6 nV × k≥155 → ≥−83 dBu FAIL) e il prodotto THD×rumore è costante in k (THD ∝1/k², rumore ∝k²). L'elemento variabile deve essere resistivo a 2 terminali (solo termica) o un moltiplicatore nel loop.
    (b) (c-B) VCA THAT 218x ×2 nel loop SVF — VALIDATA (cell-vca-ac/law.cir): law position ESATTA a 5 cifre (284,1/445,8/699,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
2026-09-28 feat(fase2): CELLE 5-WAY v0.2.1 — design definitivo rilasciato su topologia (c-A) JFET VCR (questione 70 lato celle CHIUSA)
    Circuito per cella (five-way §4.2, 7 sezioni op-amp + 1 dual JFET matched): summer con Rvin 40,2k (core a −12 dBu locale: stato Q3 291 mV vs finestra ≥494 mV), integratori op-amp + JFET in triode come VCR bootstrappato (gate = Vcm + vds/2 via 2×100k da riferimento ×2: quadraticità cancellata esatta per square-law), damping da −bp_b (l'invertitore del pot già a BOM), pot gain cablato sul terminale opposto (H(f0)=|1+b|: notch a b=−1 — gesto/taper/detent invariati), make-up ×4 assorbito in Rbw = 2,5k·Q/4,62 (zero silicon extra).
    Position: f0 ∝ (Vcm−V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
2026-09-28 docs: SPECIFICA allineata a questione 70/celle v0.2.1 — §5 filtro: topologia SVF = scelta musicale (a) carattere OTA nudo vs (c-B) VCA pulito (entrambe quantificate, converter valido in entrambi i ca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
2026-09-28 docs: diagrammi a blocchi SVG dei 5 moduli (docs/diagrammi/) + index.html
    Generati dai design doc correnti al 2026-09-28: canale-cdj.svg (v0.3, EQ serie beta-3, split post-EQ CUE/FX/filtro, meter condiviso), fx.svg (v0.2: una delle 4 sezioni bus, matrice reroute pre-fader con self-route escluso, catena CV con smoothing 1 ms, livelli worst summing +21,5 dBu), master-out.svg (v0.2+REC: tre rami indipendenti, mute controller analogico, PSU rail), five-way.svg (v0.2 + ZOOM cella v0.2.1 JFET VCR: summer/VCR bootstrappato/pot ±bp_b/summer out, position via shaper θ→Vcm, tabella C e note livelli), filtro.svg (v0.2+v0.3-WIP: 8 core SVF 4 poli, mux BBM+ramp 1 ms, drive bloccato su 61, sezione con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
2026-09-28 feat(fase1): FRONT-END PHONO MM v0.1 (decisione 79, chiude questione 6) — phono-stage.md + sim/cdj/phono-riaa-*.cir
    Topologia: stadio 1 OPA1612 non-inv x21 → subsonica Sallen-Key HP 13 Hz Q 0,707 (unity) → RIAA PASSIVA (R1 21,8k/C1 34,8n/R2 3,16k/C2 100n, equazioni chiuse tau318=R2C2, tau1+tau3=R1C1+R1C2+R2C2, tau1*tau3=R1R2C1C2) → stadio 2 OPA1654 x60,6 → selettore LINE/PHONO → [B] GAIN. Niente RIAA in feedback (warp nel loop), niente elettrolitici (DC bloccata dalla SK).
    Simulato: gain 42,0 dB a 1 kHz esatti (out +18,0 dBu al punto di overload sheet; clip +24,9); errore curva ≤±0,14 dB 200 Hz-20 kHz, −0,5/−1,4/−3,9 dB a 100/50/20 Hz (subsonica + residuo non attribuito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
2026-09-28 docs: CLAUDE.md allineato a fine sessione 2026-09-28 (unlock hook su conferma esplicita Filippo, poi rimosso) — sessione: LM13700 reale + q70, celle v0.2.1 JFET VCR, BBM 1 ms, phono MM v0.1 (dec. 79,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
2026-09-28 docs: fix da review di completezza fine-sessione — BLOCCANTE: SPECIFICA §7 phono riscritto su decisione 79 (era rimasto alla Rev A su carta: RIAA ibrida/JFET/no-subsonica/C 0-150p, contraddiceva phon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
2026-09-28 docs: SESSIONE DECISIONI 2026-09-28 — decisioni 80-85 + voce 37 con ricerca
    - Voce 37 (VCA): FINDING CRITICO — serie THAT 2180/2181/2162 END OF LIFE (memo
    ufficiale 2026-09-01, LTB entro 2026-09-30 via sales@thatcorp.com); prezzi
    annotati (originale $4,61/listino, Mouser $6,30-7,92, clone CoolAudio V2181L
    $2,10-2,95 / €2,80-3,75); decisione approvvigionamento PENDING di Filippo.
    - Decisione 80 (ratifica voce 55): famiglia unica BBM + ramp 1 ms per tutte le
    commutazioni CV (gate 5-way, reroute/assign FX, modo filtro).
    - Decisione 81 (ratifica voce 19): ballistica meter stile Pioneer DJM — release
    ~0,3 s, attacco rapido, latch clip 442 ms invariato; REVISIONE dec. 65 parte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
2026-09-28 docs: CLAUDE.md + header SPECIFICA allineati a sessione decisioni 2026-09-28/29 — decisioni 80-85 (85 voci), master-out → v0.3 da ridisegno finale (dec. 83), voce 37 EOL/LTB 30-09 con ricerca prezzi,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
2026-09-29 feat(master-out): VAS discreto a guadagno PROVATO E BOCCIATO — decisione 86 adotta il BOOTSTRAP (rev. decisione 83)
    - compG-*.cir: composito con CE NPN + CCS tra OPA1612 e diamond, feedback
    globale a +in (due inversioni → il −in dà anello positivo, verificato).
    - Finding 1: latch d'accensione — CE satura, il segno dell'anello si inverte,
    uscita bloccata a +11,3 V (misurato in compG-op: Vce 0,03 V, catena bias
    diamond morta); mitigabile (CCS 12 mA, Rb 10k, Baker) ma strutturale.
    - Finding 2 (killer): muro di stabilità — macro compensata (−90° da 25 Hz) +
    polo VAS sotto crossover = doppio integratore: 15 combinazioni Cc×Rz×Cf,
    picchi closed-loop +4,7…+14 dB a 56-14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
2026-09-29 feat(master-out): BOOTSTRAP rail OPA1612 VALIDATO sullo swing (decisione 86) — capability +21,5/−21,15 V = +25,0…+25,2 dBu, requisito ≥+24 PASS con ~1,7 dB di margine
    - compB-swing.cir: composito v0.2 invariato + rail locali flottanti
    OUT±4,4 V (stringa 7×1N4148, pass MJE340/350, bias 4,7k, bleed 10k solo-sim);
    tracking verificato (vplus = OUT+4,36 a OUT 10 V), handoff dolce ai rail
    statici ±23,7 V oltre OUT ≈ ±19,3.
    - Asimmetria −0,35 V sul negativo (stringa inferiore perde bias vicino a −24):
    accettata, fix candidato = JFET CCS al posto di Rbl.
    - Limiti macro dichiarati: PSRR/Iq assenti → nel reale pass dimensionati per
    40 mA (worst ~1,6 W) e rumore stringhe a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
2026-09-29 docs: CLAUDE.md allineato a sessione 2026-09-29 (unlock hook su conferma Filippo, poi rimosso) — VAS discreto bocciato (latch + muro stabilità, compG-*.cir), decisione 86 bootstrap rail OPA1612, swin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
2026-09-29 feat(master-out+5-way): v0.3 DEFINITIVE — bootstrap master VERIFICATO con Iq reale (Test 7-12) + DRIVE 5-way VALIDATO (law esatta, griglia musicale)
    MASTER-OUT v0.3 (task 2, decisione 86): FINDING il Test 6 era ottimistico (macro senza Iq): con assorbimento reale 40 mA e bias a R lo swing crolla a +19,3/-17,9 V. Rete finale: stringa 9x1N4148 (delta ~5,3 V) + bias JFET modo CRD (Idss ~4 mA, handoff a bassa Z, simmetria) + Re 33. Suite completa (compB-*.cir + opamac-isup{,-t}.inc): capability ±20,4-20,9 V = +25,4…+25,6 dBu PASS (margine 1,4-1,6 dB); THD a +24 dBu (17,37 Vp, requisito vero) 0,00012%@1k / 0,0042%@35k su 600R PASS (a 14 Vp identica v0.2 = A/B); banda 8Hz-35kHz -0,0002…+0,0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
2026-09-29 docs(five-way): header drive-chain8 allineato ai misurati finali (G2 +9,4 dB end-to-end, law totale esatta — la stima desk 13,1 era smentita dal carico del pair)
2026-09-29 docs: fix da review di completezza fine-sessione — IMPORTANTI: conversione dBu Test 6 corretta anche in dec 86/CLAUDE/master-out (era +25,7…+25,9 non +25,0…+25,2, con nota ATTESO SUPERATO dal Test 7)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
2026-09-30 feat(5-way+phono): SESSIONE 2026-09-30 — decisioni 87+88, quirk INTEG, benchmark scena
    (1) DECISIONE 87: griglia musicale drive §5.3 CONFERMATA da Filippo — valori
    bloccati come punto di partenza, review estetica sul prototipo M4L.
    (2) PHONO sub-100 Hz ATTRIBUITO E RISOLTO: residuo −0,5/−1,4/−3,9 dB a
    100/50/20 Hz = polo DC block 15,9 Hz (C3+Rb2 100k: attenuazione diretta
    −2,13 dB a 20 Hz + carico rete RIAA −1,04). Fix: Rb2 100k→1M (polo 1,59 Hz)
    → curva ≤±0,05 dB su 100 Hz-20 kHz, −0,24 dB a 30 Hz (requisito PASS).
    Finding: netlist rumore/overload v0.1 senza polo → EIN/warp già coerenti.
    (phono-sub100.cir attribution, phono-sub100-fix.cir, phono-noise-fix.cir)
    (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
2026-09-30 feat(5-way): GATE KILL A SWITCH — design CHIUSO (dec. 88): π SPDT classe ADG1434 + invertitori SUB/MID
    (1) TOPOLOGIA: serie semplice BOCCIATA dai numeri (off-isolation −22…−52 dB
    @20 kHz su 10k, Coff 2-60 pF — la stima doc −60…−70 non raggiungibile);
    π SPDT (serie + shunt a GND da off) VALIDATO: −89…−119 dB @20 kHz anche con
    Coff pessimistica; all-kill ≤ −85,5 dB su 5 Hz-60 kHz = sotto il floor del
    modulo (−83,2 dBu): via killata inudibile. Perdita d'inserzione −0,039 dB
    uniforme (assorbita dal make-up).
    (2) POLARITA': la somma telescopica LR4 richiede segni uniformi; naturali
    SUB−/KICK+/MID−/HIGH+/SUPER+ (AP2 invertenti); lo switch in serie non
    inverte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
2026-09-30 feat(71A): budget canale DJ completo + rerun filtro — PROPOSTA ritaratura (docs/06, BOZZA pre-FX)
    (1) CANALE CDJ completo (channel-noise-71A.cir, out driver, gain nominali,
    ingressi terminati): densità piatta 210 nV/√Hz → −88,4 dBu unwt /
    −90,3 A-wtd vs target −92: FAIL 1,7 dB. Ripartizione: EQ β3 82% (190 nV),
    GAIN VCA 18% (89 nV, −98 dBV datasheet con Rvn 476k esatto), fader/driver ~0.
    Fix ingegneristiche: (a) R EQ ×0,5 → ~134 nV (pot custom 5k: voce 40);
    (b) I/V 10k su GAIN VCA; (a)+(b) → −93,8 A-wtd stimato.
    (2) RERUN FILTRO (fork, metodo 31 punti 1/6 ottava): delta reali +8,8…+9,1 dB
    (fc ≤1 kHz, spettro 1/f da Rb 100M) e +17,5 dB a fc 37 kHz (quasi bianco)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
2026-09-30 feat(71A): budget FX bus send — PASS 12,8 dB (−100,8 A-wtd vs −88); docs/06 completa nei numeri
    FX send jack L, contributori terminati, metodo §8.9 (densità 10 punti +
    trapezoidale + A-wtd IEC 61672): densità piatta 62 nV/√Hz → −98,9 dBu unwt
    / −100,8 A-wtd; mono sum L+R −95,9/−97,8. Dominante: 3 VCA reroute ~60%
    (conservativo: floor −98 dBV assunto anche a pot chiuso), rete summing 37%,
    op-amp 3%. A reroute chiusi il bus reale sta sotto ~−102. Assunzioni
    dichiarate: carico jack 10k, interfaccia matrice→bus peso 1/3 da fissare nel
    design di dettaglio, EQ2/servo esclusi (lato ritorno).
    Coda 71A nuova: budget canale di RITORNO FX (JFET hi-Z + GAIN VCA + EQ2 +
    servo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
2026-09-30 docs: DECISIONE 89 registrata — ritaratura rumore sheet §3 (chiude voce 71A)
    Target ratificati da Filippo 2026-09-30 sera: canale CDJ ≤ −80 dBu A-wtd
    (misurato −90,3 = PASS 10,3 dB, NESSUNA fix: proposte EQ R×0,5/pot 5k e
    I/V GAIN respinte, voce 40 invariata); filtro ≤ −80 (core nudo (a) al
    limite worst-case die a fc max −76…−84 → input per l'ascolto q70, non un
    veto); FX bus send ≤ −88 confermato (misurato −100,8); sistema XLR ≤ −78
    A-wtd alle condizioni dichiarate docs/06 §2; stadio master ≤ −92 (−119,2);
    5-way invariato ≤ −80 (dec. 88).
    Coda 71A (non blocca): budget canale RITORNO FX (vero contributo FX al
    sistema, mai simulato), rerun consolida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
2026-09-30 docs: fix da review di completezza fine-sessione (dec. 88/89)
    BLOCCANTE: SPECIFICA §14 target rumore allineati a dec. 89 (canale −80,
    FX send −88, filtro −80 riga nuova, stadio XLR −92, sistema −78; rimossi
    i [DA RITARARE 71A]) + header decisioni 76-89/1-89.
    IMPORTANTE: cdj §3.3 item 6 chiuso (dec. 89); five-way §8.1/§8.2 off-isolation
    misurata (§8.10: −95 dB @20k, all-kill ≤−85,5) al posto di 'da quantificare';
    BOM §7 tabellare allineata al prose (~34-36 quad con invertitori, 10 SPDT π
    ADG1434 = 3 IC); §10 item 6 ritaratura marcata FATTA; filter-module §header/§8
    + docs/02 voce 11: claim rumore INTEG marcati SUPERATI (rerun 71A, die reale
    −84…−76 a fc max, in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
2026-10-01 feat(71A-coda): CHIUSA — ritorno FX + summer + v031: sistema −80,5 dBu A-wtd = PASS 2,5 dB (dec. 89 confermata)
    (1) RITORNO FX (mai simulato, fx-return-noise-71A.cir): punto di misura =
    uscita buffer ritorno su iniezione master 10k, jack terminato 100 Ω, GAIN
    VCA detent 0 dB (Rvn 476k = −98 dBV senza I/V, dichiarato), EQ2 detent,
    fader unity → densità piatta ~103 nV/√Hz = −94,5 dBu unwt / −96,4 A-wtd;
    mono sum −93,4; 4 ritorni al master sum = −90,4 A-wtd (in cima alla stima
    docs/06 −88…−92). Dominante GAIN VCA 75%; front-end 25%. Finding: R bias
    1 MΩ innocua (sweep 100k/220k/1M identico — nodo a bassa Z). Assunzioni
    dichiarate: carico 10k, meter pickup 100k passi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
2026-10-01 docs: fix da review completezza (commit 8ffeb98) — IMPORTANTI: sheet §3 riga 5-way e header five-way (:15 + §9 q10) aggiornati al rerun v031 (−83,9 A-wtd, margine 3,9 dB) con puntatore §8.10 item 6. 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
2026-10-01 docs(sistema): DECISIONE 90 + piano fase 3 — metering barre LED a zone (verde +6/ambra +18/rosso +24/purple latch +23, dec. 81 ballistica), CUE blend + 2 uscite, PSU toroidale unico multi-avvolgiment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
    Scelte di Filippo 2026-10-01 (sessione design di sistema, task 1 handoff):
    (a) voce 19 metering: barre LED verticali a zone stile DJM (master stereo +
    zone DJ/FX/5-way); soglie verde ≤+6 dBu, ambra +6…+18, rosso +18…+24,
    purple = latch clip ≥+23 (saturazione reale dominio ±18 V); driver famiglia
    LM3915 [PROVVISORIO]; ballistica dec. 81 invariata.
    (b) voce 18 CUE: knob blend CUE↔Master + level, 2 uscite cuffia parallele,
    switch cue per canale multipli (punto loc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
2026-10-01 feat(sistema): S2 grounding + S4 metering (onda 1) + DECISIONE 91
    DEC. 91 (Filippo, 2026-10-01): (a) MICRO-MODULO FX-SEND ×4 — EQ2+level+
    switch assign escono dal canale, uno identico per canale, bottoni sul
    pannello canale via linee logiche +5 V (audio mai dai contatti, schema
    dec. 88); catena locked SPECIFICA invariata. (b) SELF-FEEDBACK = quarto
    pot per bus: matrice reroute 12×→16× 218x, law famiglia §8.3 + 1 ms
    (dec. 80), carattere BOUNDED-BY-DESIGN come i cross (pedale satura, mai
    ai rail; senza pedale a pot max può fischiare = K4 dec. 84); stabilità
    da riverificare (fx-loop-self). Chip ~28-30, lotto clone ~44-52
    [PROVVISORIO]. Design in corso (fork): fx-send-module.md + fx-mo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
2026-10-01 feat(sistema): S1 PSU q20 v0.1 (dec. 90c) — toroidale ~120 VA 4 secondari, protezione corto 3 strati, sim PASS
    Architettura (docs/fase3/sistema-psu.md): W1 2×19 V/1,2 A (raw ±27 →
    LM317/337 locali ±18 audio), W2 2×17 V/0,6 A (raw LN/OTA ±22 → LT3045/94
    locali + 78L15 ±15 switch), W3 2×17 V/0,3 A (master HV ±24 [M]), W4 8 V/1,2 A
    (7805 +5 control); NTC inrush + termico integrato; carico ~86 VA (margine 40%).
    Rail idle/picco: ±18 audio 0,9/1,0 A · ±24 M 0,13/0,17 · ±15 LN/OTA
    0,28/0,45 (incl. albero rif. meter S4 su coppia dedicata) · ±15 switch <30 mA
    · +5 V 0,5/0,9 A (LED 103 segmenti, dato S4). Termico fanless 22-27 W
    distribuiti (7805 worst 5,1 W su piastra).
    Protezi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
2026-10-01 feat(sistema+FX): DECISIONI 91 implementata + 92 (CV 6,1) — micro-moduli FX-SEND ×4, self-feedback 16×218x bounded, backplane classe FX-SEND
    DEC. 91 implementata (fork): (a) docs/fase1/fx-send-module.md NUOVO —
    micro-modulo identico ×4: buffer in → EQ2 stereo (LOW 1 op/lato, HIGH 3
    op/lato, celle scalate fx-eq2) → level doppio 10k passivo → 8 π SPDT
    ADG1434-class (2 quad) → 8 buffer iniezione + 10k → S1-S4; al canale
    restano send tap bufferizzato ≤50 Ω (locked) e bottoni pannello →
    harness diretto al front connector (+5 V, 10k+100n+pull-down = ramp
    τ≈0,5-1 ms sul pin IN: soft-switch nella regione resistiva del Ron,
    famiglia dec. 80; audio mai dai contatti, schema de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
2026-10-01 docs: fix da review completezza sessione sistema — IMPORTANTI: fx-module §1 self-route REV dec. 91b (era 'proibito fisicamente'), reroute 3→4 destinazioni; cdj §1/§2/§6 allineati a dec. 91a (EQ2+leve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
2026-10-01 docs: fixup review completezza — psu CV APERTO-F → dec. 92 + puntatore §5/§9; docs/02 voci 37/70/21/22 aggiornate (chip ~28-30, design S2/S3 fatti, BLOCCANTE rail aperto); piano fase3 S1-S4 spuntati 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
2026-10-01 docs: fixup 2 review completezza — docs/02 voci 37/70/21/22 (chip ~28-30 dec. 91, design S2/S3 fatti, BLOCCANTE rail S1↔S3↔SPECIFICA §3 registrato aperto), piano fase3 S1-S4 spuntati + esito review, 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
2026-10-01 docs: fixup 3 — q70 conteggio chip post-dec. 91 (~28-30) + incongruenza storica ~54-56 marcata; albero CLAUDE.md riga fase3
2026-10-01 docs: albero CLAUDE.md — riga docs/fase3 (design di sistema)
2026-10-01 feat(sistema): DECISIONE 93 — TASK 0 riconciliazione-power-rails CHIUSA (BLOCCANTE review 01/10 risolto)
    Set unico raw/correnti sul backplane, ratificato da Filippo, che attua la dec. 90(c):
    - raw ±27 V audio (W1 2×19 V/1,2 A) · raw ±22 V LN/OTA (W2 2×17 V/0,6 A) ·
    raw ±26 V [M] HV solo master (W3 RIDIMENSIONATO 2×17→2×20 V/0,3 A) ·
    +5 V control REGOLATO nella PSU (il «+10 raw sul backplane» di S1 v0.1 era un errore).
    - W3: il 2×17 dava raw ~22,4 V < statici ±23,7 richiesti dallo swing master-out v0.3
    VERIFICATO; con 2×20 V l'inviluppo statici è ±23,6…29,2 V su rete ±10% — il punto
    verificato ±23,7 (capability +25,4…+25,6 dBu) diventa il worst case a rete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
2026-10-01 docs: DECISIONE 94 — ratifiche fase 3: q38 CHIUSA, GLOBAL_MUTE sui send FX, ergonomia backplane
    Sessione ratifiche con Filippo (task 3 handoff):
    (a) q38 chiusa e spostata in docs/01: standard elettrico single-ended 0 dBu tra
    moduli (bilanciato solo verso l'esterno), MASTER SUM 7 contributori stereo
    (5-way + 4 ritorni FX + mic + generic), summing nel modulo master (§A2) —
    numeri confermati (crosstalk DJ bus, isolamento slot, sistema −80,5 A-wtd).
    SPECIFICA §3: riga [APERTO] questioni 22/38 → [BLOCCATO dec. 94a] standard I/O
    + [PROVVISORIO → design S3 v0.2] pinout/connettori/comportamento modulo rimosso.
    (b) GLOBAL_MUTE (linea c9, power-on/off + guasto rail) mut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
2026-10-01 docs: housekeeping docs/02 — task 4 handoff chiuso (voci 18-22 + roadmap allineate)
    - Voce 19 metering: DESIGN FATTO → sistema-metering.md (S4: scala assoluta,
    2×20+10 segmenti, soglie dec. 90 ±0,005 dB, purple latch 479 ms; restano
    tarature a banco q54).
    - Voce 18 CUE: S5 = ultimo workstream, rail dec. 93 pronti, GLOBAL_MUTE→CUE
    da disegnare in S5 (dec. 94b).
    - Roadmap: TASK 0 → dec. 93, ratifiche → dec. 94, design di sistema = resta
    solo S5 CUE; housekeeping 18-22 in gran parte fatto; voce 19 soglie dec. 90a.
2026-10-01 feat(master-out): TEST 13 — inviluppo statici [M] dec. 93 VERIFICATO in sim a entrambi gli estremi
    compB-swing3-env.cir + compB-short-env.cir (.step vstat 23.6/26.5/29.2, amp 22 Vp):
    - Swing a rete −10% (statici 23.6 V): capability +20.57/−20.05 V = +25.2…+25.5 dBu
    → requisito ≥+24 dBu PASS con margine 1.2-1.5 dB (coerente col Test 7b a 23.7 V).
    - Rete nominale/alta: uscita limitata dall'input (±22.00) → capability ≥+26.3 dBu;
    level plan worst +22 dBu dentro.
    - Corto sostenuto: limite bootstrap INVARIATO 106 mA agli estremi; Q1 1.00→1.28 W
    medi a rete alta (+28%) — dentro il sizing "worst di programma" (rame ≥4 cm²);
    rail bootstrap collassati a ±5.6…5.9 V c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
2026-10-01 docs: ADG1434 — datasheet Rev. E VERIFICATO (task 2 handoff chiuso) + second source BOCCIATE
    Nuovo doc/fase1/adg1434-datasheet-verify.md (fonti: Rev. E 8/2016 da mirror —
    analog.com in timeout — + DigiKey + EngineerZone):
    - CONFERME: Ron 4.7 Ω = max @25 °C (typ 4.0; caveat 5.7 Ω @85 °C), range
    ±4.5…±16.5 V (dec. 90c ok, rail ±15 dec. 93 dentro), off-isolation Fig. 20
    coerente con −95 dB π @20 kHz, pilotaggio +5 V via 10k dentro specifica.
    - FINDING: pin VL NON esiste (soglie IN fisse 2.0/0.8 V) — terminologia doc
    corretta; TSSOP-20 YRUZ senza EN (il design usa IN) preferito per saldabilità.
    - Power-off: non è power-off protected (clamp 30 mA; <1 mA fuori specifica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
2026-10-01 chore(sim): cleanup task 15 — dbg-bus-noise rimosso (diagnostica 30/09 confluita nei RISULTATI; file nel Cestino, conferma Filippo); store handoff a 5 (29/09 00-11 nel Cestino)
2026-10-02 feat(sistema): S5 CUE design CHIUSO — ultimo workstream fase 3 (design COMPLETO)
    docs/fase3/sistema-cue.md v0.1 + sim/system/cue-*.cir + RISULTATI-cue.md:
    summing 4 cue a massa virtuale (-1); MON post-[A2] pre-level via buffer
    [N] nel master (stile DJM-900NXS2, scelta Filippo su confronto manuali);
    blend pot lin 10k con centro -6/-6: law ESATTA e isolamento -116 dB
    verificati; polarita' relativa cue/MON VERIFICATA (Test 3: il controllo
    invertito cancella a -104 dB); level pot log; ampli cuffia OP1612 +
    diamond MJE340/350 su +-18 V locali (stadio potenza FUORI dal rail LN)
    con bias Vbe-multiplier + CCS JFET e limitatori Vbe ~141 mA: THD
    <=0,055% @1 Vrms su 16-250 ohm, headroom +12,4...+14,8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
2026-10-02 feat(71A-coda): send chain FX a canali vivi MISURATA — stima -95 confermata conservativa (-98,5 A-wtd/canale); FINDING floor di sistema con assign ON (-73...-66,6 vs target -78) aperto a decisione Fi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
2026-10-02 feat(master-out-banco): Test 14-16 in sim — THD +24 dBu su inviluppo statici sotto pavimento numerico; PSRR -142,8 dB @100 Hz (ripple out 26 nVpp, tema chiuso); Zobel e L-reti d'uscita BOCCIATI (wors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
2026-10-02 feat(banco-modelli): ADG1434 Ron @85 C (5,7 ohm) CHIUSO in sim — isolamento/inserzione/click invariati (delta 0,0009 dB), nessuna azione di design; chiude caveat verify-doc 5.3
2026-10-02 docs: DECISIONE 95 — deroga d'uso rumore FX-send ratificata da Filippo (target -78 a send non assegnati; con FX in uso floor -73...-66,6 accettato, disciplina level K4)
2026-10-02 fix(cue-banco): pin BJT C-B-E del Vbe-multiplier corretti nei netlist — Test 1 INVALIDATO e rigenerato: THD 4,8-13,5% @1 Vrms, clamp assente (462 mA), guadagno anomalo 250 ohm → rete bias+limitatori 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
2026-10-12 feat(cue): ampli cuffia v0.2 CHIUSO in sim + DECISIONE 96 — diagnosi Test 1 corretta (il THD 5-13 % era oscillazione RF a burst ai passaggi per lo zero, non crossover: Partial 0,0007-0,010 %, guadagn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
2026-10-12 docs(diagrammi): 7 SVG rigenerati allo stato dec. 96 (canale v0.4 senza send a bordo, FX v0.3-WIP matrice 16x, 5-way kill a switch + drive v0.3, filtro rumore dec. 89, master bootstrap + summing 7 co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
2026-10-13 feat(mic-mono + sistema): architettura MIC e MONO v0.1 (DECISIONE 97: due moduli separati, gain + EQ2 + 4 pot send + LED tricolore, max 4, passa-alto 60 Hz sul mic) + design teorico completo — quirk 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
2026-10-13 feat(drive + overdrive): DECISIONI 99 e 100 — drive 5-way v0.4 = GROWL (sotto 350 Hz, clipper a diodi asimmetrico) + NASTRO (CS JFET con Rs divisa) in parallelo al pulito, due manopole, niente fuzz, 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
2026-10-13 docs: DECISIONE 101 — filtro a un percorso per canale (HPF oppure LPF), chiude la questione 63
2026-10-13 docs: DECISIONE 102 — law FREQ e RES del filtro = Xone:96 come punto di partenza (FREQ 20 Hz-20 kHz esponenziale tra 5 % e 95 % di corsa, estremi 10 Hz / 35 kHz negli ultimi 5 %; RES curva Xone sul p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
2026-10-13 feat(shaper): shaper di frequenza del filtro sulla law dec. 102 (Xone:96 nel 90 % centrale) — Rm 9,09k + ramo alto 20k/24,3k + ramo basso 11,3k/80,6k, esatto dal 10 al 90 % di corsa, ginocchi -12...+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
2026-10-13 docs: DECISIONE 103 — EQ dei canali DJ = isolator (ogni banda fino al silenzio, tutte al minimo = canale muto); revoca dec. 77, supera topologia dec. 76 e EQ v0.3 beta-3 (archiviato); chiude 59 e 68;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
2026-10-13 docs: DECISIONE 104 — revoca la 103 (isolator): EQ di canale resta in serie v0.3 beta-3 + muto a fine corsa con tutte le manopole a zero; chiude 59, riapre 68 con peso ridotto
2026-10-13 docs(pulizia): allineamento alle decisioni 93-104 — CLAUDE.md (dec. 93-96, S5 chiuso, design correnti drive v0.4 / overdrive v0.2, contatori), SPECIFICA (header, condizioni d'uso del target di rumore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
2026-10-13 feat(eq): DECISIONE 105 — EQ dei canali DJ = isolator a 4 bande (revoca la 104); servo DC di filtro e 5-way; DECISIONE 106 — trasformatore ~225 VA
    - EQ isolator v0.4-beta (docs/fase1/eq-isolator-v0.4.md, sim/eq-iso/): banca LR4 allineata a 3 incroci, pot lineare + buffer, contatto di fondo corsa per banda (-100 dB a manopole chiuse), servo DC, centro piatto 0,01 dB, rumore -97,1 dBu A-wtd; incroci/boost/law rinviati all'ascolto (B7); EQ in serie v0.3 archiviato
    - Servo DC su overdrive filtro e make-up 5-way (todo 39): continua <= 2 mV, rumore invariato
    - Dec. 106: avvolgimento audio 2x21 V 3,0 A (sim/system/psu-w1-iso.cir)
    - CLAUDE.md asciugato (33 -> 10 KB): comandi e regole di simulazi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
2026-10-13 feat(eq): isolator integrato nel canale — somma non invertente (polarita' diritta, zero op-amp in piu'), servo DC sul nodo di mix; canale -94,6 dBu A-wtd, sistema a filtri OFF -82,9 (docs/06 §10); ch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
2026-10-14 docs(claude-md): stato corrente allineato — isolator integrato nel canale (polarita' diritta), rumore di sistema -82,9 dBu A-wtd (docs/06 §10); chiude todo 43
2026-10-14 docs(pulizia): chiude todo 4 — master-out §2 schema a blocchi allineato a dec. 63/94a/[N] (somma nel master, 4 buffer dal nodo somma); regola THD Partial+Total (fourier_tab.py + CLAUDE.md); comandi e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
2026-10-14 docs: DECISIONI 107 e 108 — tracking stereo EQ con pot doppi lineari selezionati (chiude 53/A6); pedali: solo LEVEL in mandata, pad fisso 0 dB, compensazione col GAIN del ritorno (chiude 25/A9, super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
2026-10-14 feat(filtro): D5 — core (a) nudo non funziona col chip reale; DECISIONE 109: core OTA (a') con partitore 1/30 (C 1,1 nF, mappa Iabc invariata) + limitatore a perdita non lineare verso il summer; cate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
2026-10-14 docs(claude-md): regola di simulazione per SVF OTA con RES (uic, PP)
2026-10-14 docs(diagrammi): SVG rigenerati allo stato dec. 109 (5-way drive v0.4 GROWL+NASTRO, filtro core (a') + overdrive v0.2 + D5, FX/FX-SEND dec. 108, canale isolator, LED mic/mono tricolore) + nuovo schem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
2026-10-14 docs(diagrammi): nuovi psu.svg (toroidale ~225 VA, 4 secondari, regolazione locale, protezioni, supervisor/mute) e metering.svg (punti di presa, catena detector, scala colori, albero riferimenti, LED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
2026-10-14 docs: DECISIONE 110 — numeri del filtro col chip reale accettati come partenza (chiude A17): risonanza Xone-like (+7...+9 dB su -10 dBu, ~+1-2 su 0 dBu), griglia overdrive = d5-chain.cir (sostituisce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
2026-10-14 docs(diagrammi): filtro e schema totale allineati alla dec. 110 (oscillazione ~+5 dBu, calo di nota = carattere, A17 chiusa); nuovo maelcum-diagrammi.pdf con gli 11 diagrammi (schema totale in testa,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
2026-10-14 docs: benchmark esteso (07) — 9 preamp dub in più (18), mixer DJ schedati 6+10, mixer live e banchi 8; numeri pubblicati e fonti; lista approvata da Filippo
2026-10-14 docs: review del progetto contro il benchmark (08) — 13 domande a Filippo: ibrido DJ/sound system/live, nessun fork, tutto predisposto per moduli opzionali (uscite per via, crossfader, EQ grafico); a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
2026-10-14 docs: DECISIONE 111 — review contro il benchmark ratificata: ibrido DJ/sound system/live, nessun fork, moduli opzionali predisposti (uscite per via, crossfader, EQ grafico, sirena), uscita full-range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
2026-10-14 feat(sistema): todo 47-49 dalla dec. 111 — backplane predisposto (anello crossfader post-fader, inserzioni EQ grafico, VIE_TAP, slot UTIL), W1 3,5 A e trasformatore ~250 VA (psu-w1-opt), tasto MONO =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
2026-10-14 docs: DECISIONE 112 — due ventole a termostato (revisiona la parte fanless della dec. 90c): interno ~45 C a 40 C fuori, spente sotto ~35 C, controllo lineare, lavoro a ventole ferme fino a ~30 C ambi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
2026-10-14 docs: DECISIONE 113 — alimentatore esterno: box con toroidale, bulk, pre-regolatori +-22,5 V audio e +-19 V LN, [M] raw, +5 V; regolazione finale, stella e fusibili restano nel mixer (modulo PSU-IN);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
2026-10-14 feat(sistema): todo 51 — alimentatore esterno e PSU-IN progettati (sistema-psu-esterno.md): LDO discreti a MOSFET ±22,0 V (non 22,5: a rete -10 % usciva di regolazione) e ±19 V, in regolazione da ret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
2026-10-14 docs(claude-md): regole di simulazione per i regolatori in anello (niente uic) e per LTspice.exe rimasto acceso dopo il timeout
2026-10-14 feat(deriva): todo 50 — filtro: Iref PTAT classe LM334 (gm -8,9% -> <=0,23% da 35 a 65 C, modello LM13700 reale); 5-way: la deriva vera delle celle JFET e' +0,9...-2,4 semitoni (soglia e beta di segn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
2026-10-14 docs(proto-max): piano v0.2 = proposta di ripresa del prototipo Max (todo 1): isolator, filtro col chip reale + A/B pulito (B1/B2), GROWL/NASTRO e bande (B3/B6), FX 16 VCA + MONO, mic con MC vero; pr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
2026-10-14 docs(proto-max): piano v0.2 senza la prova del crossfader (scelta di Filippo; il modulo resta predisposto, dec. 111)
2026-10-14 docs(proto-max): piano v0.2 approvato da Filippo — ascolto in cuffia (scelte sui bassi di P2 provvisorie fino a un sub); chiude todo 1
2026-10-14 feat(proto-max): P0 MC-CHANNEL — GAIN, isolator A/B, fader in gen~ generato da proto-max/coefficienti/genera.py; FINDING: banca a 4x (halfband polifase), senza la bilineare sbagliava fino a 3,2 dB; m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
2026-10-14 docs(proto-max): P0 caricato in Live da Filippo — gen~ compila, trasparente al centro, silenzio a bande chiuse, CPU 4 % con 4 dispositivi; chiude todo 15 e 52
2026-10-14 feat(proto-max): variante C degli incroci (150 Hz LR2 dolce / 350 / 3150) nel selettore al posto di B; DECISIONE 114 dall'ascolto P0: +6 e GAIN confermati, curva solo con pot di serie, incroci A e B 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
2026-10-14 docs: benchmark degli EQ a 4 bande (09) — Xone:92/96/464, DJM-V10, Condesa, MasterSounds, crossover dei preamp; nessun confine Pioneer pubblicato o misurato
2026-10-14 feat(proto-max): variante D degli incroci (150 Hz dolce / 700 / 3150, come i mixer DJ del benchmark: HI-MID senza il colpo del kick, -38,6 dB a 250 Hz); selettore a tre posizioni A/C/D; prova_gen PASS
2026-10-14 docs(09): curva delle manopole Pioneer — dati scarsi (-12 dB a ore 9 DJM-600/850, -18 DJM-400); col pot lineare di serie -8...-9,5; nessuna rete passiva taglia di piu
2026-10-14 feat(proto-max): selettore CURVA LINEARE / PIONEER ideale ((2 theta)^1,5 sul taglio: -12 dB a ore 9 come DJM-600/850) per sentire se la differenza conta; prova_gen PASS
2026-10-14 feat(proto-max): P1 completo — MC-FILTRO con DRIVE (overdrive v0.2, modello su od2-chain <=0,1 dB) e PENDENZA Butterworth/LR/Bessel (B2); FINDING: mancava ap() nel genexpr, la prova ora usa solo le f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
2026-10-15 fix(proto-max): MC-FILTRO canale destro rotto — la Q della prima sezione (d1) era sovrascritta dal downsampling del lato L; ora dq1; prova_filtro confronta R con L; stress a 44,1/48/96 kHz senza valo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
2026-10-15 feat(proto-max): P2 parte 1 — modello fiveway.py: banca LR4 allineata (somma piatta esatta anche nel digitale), 5 celle a campana, GROWL e NASTRO contro drive2-chain (livello <=0,01 dB, THD <=0,65 pu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
2026-10-15 fix(proto-max): MC-5WAY in Live passava solo il SUB — svf() a tre ritorni e nomi esterni uguali ai locali; ora svlp/svbp/svhp a uscita singola e nomi distinti; prova PASS 155/155, conferma all'ascolto
2026-10-15 feat(proto-max): MC-5WAY dopo il primo ascolto — CROSSOVER E (impianto di Filippo 80/170/1,2k + 6k), NASTRO pot log al 30 %, GROWL Rf 47k kg 0,4634 (LTspice drive2-chain-g47: livello 0,00 dB, THD <=1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
2026-10-15 feat(proto-max): MC-5WAY — NASTRO fine corsa al 70 % (30 % troppo poco), selettore GROWL VER DEC.99 / LIBERO (spinta 0->+18 dB col pot + miscela, +6 dB di basso sul mix di Filippo); prova PASS 175/175
2026-10-15 sim(five-way): GROWL LIBERO in LTspice (drive2-libero.cir) — spinta nella R d'ingresso del clipper (10k->1,26k), niente stadio al rail; modello e LTspice coincidono in 12 caselle (THD <=0,1 punti, li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
2026-10-15 feat(proto-max): MC-5WAY terzo ascolto — GROWL LIBERO +5 dB (kl 0,6043), NASTRO 85 %; LTspice drive2-libero coincide in 12 caselle; prova PASS 175/175
2026-10-15 docs(proto-max): allinea 02, five-way §5bis REV, piano, montaggio e RISULTATI-P2 allo stato finale di P2 (CROSSOVER A-E, GROWL VER, NASTRO VER, NASTRO 85 %); via codice morto; miscele di confronto_al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
2026-10-15 feat(proto-max): MC-5WAY — NASTRO VER LIBERO: JFET di oggi con spinta 0->+12 dB davanti al gate (diodo gate-source modellato), kl 0,1977 = +3 dB a regime sul mix di Filippo; LTspice nastro-libero.cir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
2026-10-15 feat(proto-max): P3 — pedali = effetti veri di Live (scelta di Filippo): MC-SEND (EQ2, LEVEL, FX1-4 per canale), MC-BUS -> effetto -> MC-RET (GAIN, EQ2, meter, 4 REROUTE pre-fader) su 4 tracce FX, MC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
2026-10-15 sim(five-way): rumore del modulo con le versioni del prototipo P2 (module-noise-p2.cir): DEC.99/OGGI/COMPLETO/CLASSE A come il modulo chiuso (-85,9 A); GROWL LIBERO -79,6 (+27 dB a 50 Hz nel silenzio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
2026-10-15 feat(proto-max): P4 — MC-MIC: GAIN 30-60 dB (pot lineare del circuito), passa-alto 60 Hz, EQ2 di P3, FX1-4 verso i bus di P3, MUTE 1 ms (uscita e mandate), LED a tre colori pre-EQ e pre-MUTE; preamp 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
2026-10-15 feat(proto-max): MC-CHANNEL — selettore EQ TIPO = ISOLATOR / SERIE (B5, scelta di Filippo: l'EQ in serie archiviato come opzione d'ascolto); modello serie.py dai componenti di cascade-b3.cir contro L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
2026-10-15 fix(proto-max): MC-CHANNEL — law SERIE senza '+ -' nel codice gen~ (unica forma mai usata negli altri dispositivi; sospetta del guasto in Live); prova_gen PASS
2026-10-15 perf(proto-max): MC-CHANNEL e MC-FILTRO calcolano solo i blocchi che si sentono (traccia Live su un solo core: audio che salta muovendo le manopole); canale: una banca su quattro, stati a zero dei bl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
2026-10-21 docs: CLAUDE.md segna il prototipo bloccato dai salti in Live (todo 76); docs/02 stato al 2026-10-21, voci chiuse di A e B spostate in una sezione propria in fondo a C
2026-10-21 docs(proto-max): montaggio, livello della prova del 5-way-S corretto (+8 dBu di picco, non +12)
2026-10-21 fix(proto-max): MC-FILTRO e MC-FILTRO-S rispettano le regole gen~ — sezioni SVF a un solo ritorno (sez_*_hp / sez_*_lp, prima 'return hp, lp') e xin al posto di x (parametro delle funzioni); segnalat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
2026-10-21 docs(proto-max): tutorial spostato in proto-max/ accanto ai dispositivi (richiesta di Filippo)
2026-10-21 feat(sistema): trim dei VCA 2181/V2181L (todo 17) — simmetria su ogni chip, trim di law per coppia (offset a CV 0 + scala a -40 dB, CV bipolare su EC-, partitore 1k), LTspice = calcolo; coppia peggio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
2026-10-21 docs(diagrammi): psu.svg allineato alle dec. 112-113 (alimentatore esterno con LDO ±22,0/±19, cavo 20 conduttori + PE, PSU-IN con TVS e fusibili di gruppo, AC_OK, supervisor, ventole a termostato); g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
2026-10-21 fix(docs): conteggio VCA corretto (todo 114) — il modulo FX ha 40 VCA (32 reroute + 8 GAIN, 2181 singolo), non 20; mixer ~62 chip, lotto ~75-85 pz; corrente FX +48...+110 mA per ramo: W1 3,5 A al 98-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
2026-10-21 docs(diagrammi): psu.svg, corrente del ramo audio ±18 ~1,5 A base / ~1,8 A con gli opzionali dopo la correzione dei VCA FX (#114, fd0ee73); W1 invariato a 3,5 A in attesa della scelta di Filippo
2026-10-21 docs: DECISIONE 115 (Filippo) — W1 2x21 V 4,0 A, trasformatore ~270 VA, fusibile W1 T5 A: con i 40 VCA del modulo FX il W1 da 3,5 A lavorava al 98-100 % (psu-w1-vca.cir), con 4,0 A all'88 %; SPECIFIC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
2026-10-21 sim(system): box esterno con dec. 115 (W1 4,0 A) e carico 1,81 A — LDO in regolazione in tutti i casi, margine MOSFET 1,56 V (era 1,26), avvolgimento 88-91 %, calore MOSFET 14,5 W peggiore (aletta Rt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
2026-10-21 sim(filtro): D5 a 4 poli (todo 46) — core (a') k 1/30 in due sezioni Butterworth: risonanza e overdrive come il 2 poli (fischio ~1 dB piu' debole, max +2,9 dBu), auto-oscillazione identica; rumore mi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
2026-10-21 sim(filtro): rumore del core PULITO (c-B) a 4 poli (todo 116, A18 strada 3 di Filippo) — floor THAT 2181 da datasheet (-104 dBV su 10k, +10 dB ogni +15 dB di guadagno), VCA a 0 dB intorno a 6 kHz: -8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
2026-10-21 sim(filtro): core PULITO (c-B) a 4 poli, variante C — curva rumore/guadagno di Figure 4 del datasheet THAT 2181 (floor -110 dBV in attenuazione) e headroom Iin+Iout <= 2,5 mA: VCA a 0 dB a 12 kHz, -9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
2026-10-21 sim(filtro): rumore in modo HPF dei due core a 4 poli — caso peggiore: (a') -81,6 dBu A per core, sistema con 4 filtri -74,8 FAIL 3,2; (c-B) f1 12 kHz -88,4, sistema -79,6 PASS 1,6; A18 aggiornata
2026-10-21 sim(filtro): RES del core PULITO (c-B) a 4 poli — OTA a partitore che toglie smorzamento (spento a RES minima, rumore invariato) + limitatore a diodi dal ramo -bp_b; oscillazione stabile su tre decad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
2026-10-21 docs(pannelli): render BOZZA dei pannelli — moduli singoli, setup ridotto (2 CDJ, 2 FX-SEND, 1 MIC, 1 MONO) e completo (4 CDJ, 4 FX-SEND, 1 MIC, 3 MONO), tutti con filtro, FX 4 ritorni, 5-way, master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
2026-10-21 feat(proto-max): MC-FILTRO e MC-FILTRO-S — selettore LIMITATORE (PULITO 2+2 / 3+3) tarato su LTspice cb-4p-res (+4,5 / +6,7 dBu contro +4,4 / +6,8); il PULITO prima usava il limitatore del core (a') 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
2026-10-21 docs: DECISIONE 116 (Filippo) — un meter da 10 segmenti per ogni ritorno FX, come i canali CDJ (era 1); barre 8 -> 11, segmenti ~133, LM3915 13, +5 V worst ~1,15 A su 1,25 (LED 2 mA raccomandati); me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
2026-10-21 test(proto-max): prove nel repo (todo 119) — prova_semplice.py confronta i tre -S con gli originali (scarto 0, 18 casi, manopole che saltano); prova_filtro prova il LIMITATORE 3+3 (risonanza e fischi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
2026-10-21 sim(filtro): todo 118 — PULITO col 3+3: fischio nell'overdrive v0.2 frenato a +4,4 dBu a DRIVE 100 % (tetto rispettato); programma forte a RES zero: da +10 dBu il limitatore conduce, zona del taglio 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
2026-10-21 sim(filtro): todo 126 (Filippo) — limitatore del PULITO che si spegne con la RES: niente diodi, tetto = tanh dell'OTA della RES (Iabc ~0 a RES minima), k 1/15 [PROVVISORIO]; programma forte a RES zer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
2026-10-21 docs: DECISIONE 117 (Filippo) — WIDTH del 5-way diventa manopola continua Q3...Q0,3 (era switch Q3/Q1/Q0,5); cella v0.2.2 §4.3: pot doppio 1k partitore su bp_b + buffer x10 e invertitore OPA1612, GAI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
2026-10-21 docs: DECISIONE 118 (Filippo) — sessione manopole, blocco 1: rotativi principali classe 14 mm (Alps RK14K o equivalente) disposti disassati come sul Xone:DB4; EQ di FX-SEND, ritorni, MIC e MONO class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
2026-10-22 docs: DECISIONE 119 (Filippo) — sessione manopole, blocco 2: pot a corpo chiuso senza grado IP, protezione dal pannello (guarnizioni, coperchio del flight case), pot sostituibili; precisa la dec. 111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
2026-10-22 docs: DECISIONE 120 (Filippo) — fader di canali e ritorni FX a corsa 100 mm; tracking stereo <= 0,5 dB da risolvere (fader selezionati o fader -> VCA)
2026-10-22 docs: DECISIONE 121 (Filippo) — kill del 5-way a levetta sigillata ON-OFF-(ON): su kill fisso, giu kill a molla
2026-10-22 docs: DECISIONE 122 (Filippo) — modo del filtro di canale a levetta sigillata a tre posizioni fisse (su HPF, centro OFF, giu LPF)
2026-10-22 docs: DECISIONE 123 (Filippo) — canale: CUE e assign FX 1-4 bottoni con luce a ritenuta, LINE/PHONO levetta piccola
2026-10-22 docs: DECISIONE 124 (Filippo, provvisoria) — cappucci gommati, probabile stampa 3D; rotativi tutti con albero 6 mm a D
2026-10-22 docs(pannelli): render con le decisioni 117-124 — manopole 14 mm disassate come sul Xone:DB4, EQ secondari 9 mm senza scatto, fader 100 mm, levette (kill FISSO/MOLLA, filtro HPF/OFF/LPF, LINE/PHONO),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
2026-10-22 docs: DECISIONE 125 (Filippo) — taglia e scatto di ogni manopola (115: 64 grandi 14 mm, 10 medie = 14 mm con cappuccio ~12 mm, 41 piccole 9 mm; reroute/SELF piccole con scatto al centro); tabella in 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
2026-10-22 docs(comandi): ingegneria dei comandi dopo le dec. 117-125 — tre famiglie di curve (lineare, log A, asimmetrica con pot lineare + resistenze di legge), reroute RK09K con scatto, WIDTH 1k da verificar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
2026-10-22 docs: DECISIONE 126 (Filippo) — fader di canali e ritorni mono -> CV -> VCA per lato (come Xone:92), tracking <= 0,5 dB dai VCA; +16 VCA; precisa la dec. 59
2026-10-22 docs: DECISIONE 127 (Filippo) — EQ isolator senza contatto di fondo corsa: banda chiusa a circa -54 dB (residuo pot <= 20 ohm), muto vero = fader; precisa la dec. 105
2026-10-22 docs: DECISIONE 128 (Filippo) — uscite cuffia del CUE: due jack stereo 6,3 mm
2026-10-22 docs(02): voce 40, cosa resta dopo la sessione manopole (dec. 118-128)
2026-10-22 docs: DECISIONE 129 (Filippo, provvisoria) — curve dei pot A3 B2 C2 D1 E2 F1, fader come Pioneer DJM
2026-10-22 docs: dec. 129 G — fader come la curva graduale del Pioneer DJM (circa -12 dB a meta corsa, gia simulata)
2026-10-22 feat(proto-max): MC-MIC, GAIN a curva inversa C 20 % (dec. 129 E2): dB quasi uguali su tutta la corsa (46,4 dB a meta); la curva A dell'opzione presentata li ammassava in alto, corretta nei documenti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
2026-10-22 docs(diagrammi): decisioni 117-127 su richiesta di Filippo — canale (fader mono -> VCA, EQ senza contatto), FX (fader dei ritorni a VCA, 48 chip nel modulo, ~78 nel mixer), 5-way (WIDTH continuo, kil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
2026-10-22 docs(CLAUDE.md): stato al 2026-10-22 — decisioni 1-129, hardware dei comandi, fader a VCA, rumore -81,9, ~78 VCA, limitatore del PULITO
2026-10-22 docs(budget): costo per modulo e totale, prezzi letti il 2026-10-22 (Mouser, LCSC, RS, Schaeffer) e stime; completo ~5.400-10.700 € IVA esclusa; SPECIFICA app. B superata
2026-10-22 docs: DECISIONE 130 (Filippo) — il modulo FX si divide in 4 moduli FX-RET identici, uno per bus; reroute iniettati sui net S1-S4 con I/V + 10k (fx-module §2bis), pinout FX-RET nel backplane (~24 conn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
2026-10-22 cheap: nasce il progetto parallelo CHEAP (versione economica) — README, 11 opzioni di risparmio con stime, registro decisioni C
2026-10-26 sim: todo 125 — bbm-ramp e mono-ms rifatti a +18 dBu veri (8,70 Vp): dB invariati, volt x1,41; etichette dBu di svf-real-thd corrette (valori di picco)
2026-10-26 psu: todo 128 e 130 — carico 2,03 A per ramo (fader VCA, WIDTH continuo, iniezioni FX-RET): LDO regola (margine 1,19 V), MOSFET 15,6 W, mute prima di 7,4 ms; W1 4,0 A al 97-100 %, decisione A19; OPA1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
2026-10-26 mic-mono: todo 131 — GAIN del MONO = partitore passivo, curva log A (0 dB a ~60 % della corsa), non la C del MIC
2026-10-26 docs: todo 124 — trim dei VCA applicato a canale, master, FX-RET e overdrive del filtro (CV bipolare solo su EC-, partitore 1k/1k, piazzole)
2026-10-26 fx: todo 133 — bus FX-RET con 4 iniezioni dei reroute: rumore -101,3...-91,5 dBu A (PASS), Cf 10 pF obbligatorio, crosstalk verso net a massa virtuale (vincolo PCB <= 0,2 pF), catena SELF piatta
2026-10-26 psu: DECISIONE 131 (Filippo: riserva) — riconta dal basso del ramo audio (2,12 A base, 2,44 con opzionali, 2,70 di progetto; OPA1612 3,6 mA/canale), W1 7,0 A, W2 1,5 A, toroidale ~420 VA, Rsense 0,15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
2026-10-26 CLAUDE.md: dove sta KiCad 10.0.7 e perché non passa da brew
2026-10-27 pcb: generatore pcbgen.py (netlist Python -> schema, PCB 4 strati, Freerouting, ERC/DRC) e prima scheda FX-SEND v0.1-bozza: DRC 0 errori, 0 collegamenti mancanti; 7 incongruenze col design doc in pcb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
    [bom.csv, fx-send.dsn, fx-send.kicad_pcb, fx-send.kicad_sch]
2026-10-27 decisione 134: chiude A8 — montaggio misto (fabbrica SMD, a mano pot/connettori/componenti grandi)
2026-10-27 CLAUDE.md: due trappole delle PCB (piste sui TSSOP, datasheet analog.com)
2026-10-27 decisione 135: comandi dai render di oggi, coordinate.json per le PCB; pinout ADG1434 verificato (Rev. E) e simbolo corretto nel FX-SEND
2026-10-27 FX-SEND v0.2 (todo 165): pot su scheda comandi alle posizioni del pannello + cavo piatto, cella LOW Baxandall con pot doppio 10k (sim fx-eq2-pot10k); decisione 136; pcbgen piazza per ancora; gitignor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
    [bom.csv, fx-send-comandi.kicad_pcb, fx-send-comandi.kicad_sch, fx-send.dsn, fx-send.kicad_pcb, fx-send.kicad_sch]
2026-10-27 decisione 137 (chiude A20, todo 156): banda infrasub invariata, infrasub non più gesto, HPF del filtro da 20 Hz; benchmark dei limiti bassi in docs/07 §5
2026-10-27 decisione 138: subsonica del phono fissa a 18 Hz (anti-rumble come Rane), sim phono-sub18 contro phono-sub13-ref
2026-10-27 dec. 137-138 propagate: shaper HPF senza ramo basso (sim shaper-filtro-freq-hpf), MC-FILTRO rigenerato con HPF da 20 Hz (prova_filtro PASS), specifica, design doc, storici e diagramma del filtro aggi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
2026-10-27 pcb: revisione del generatore (esito PASSA/NON PASSA, report mai vecchi, confronto schema nei due sensi, disaccoppiamento a ~2 mm dal pin, controllo audio audiocheck.py, pinout C96 in backplane.py); 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
    [bom.csv, fx-send-comandi.kicad_pcb, fx-send-comandi.kicad_sch, fx-send.kicad_pcb, fx-send.kicad_sch]
2026-10-28 pcbgen: piazzamento a grappolo attorno all'op-amp (FX-SEND PASSA, A3 23 -> 12), masse in un punto, intestazione; audiocheck legge le regole dal modulo; mute controller del master simulato (sim/master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
    [fx-send.kicad_pcb]
2026-10-28 decisione 139: scatto del MASTER al centro = 0 dB (pot a catalogo); shaper del MASTER simulato (sim/shaper/shaper-master.cir, 4 rami + offset per il +6 dB): sopra il centro ±0,03 dB, scatto 0…−0,17 d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
2026-10-28 CLAUDE.md: cluster_gap 0,5 mm, con 0,2 Freerouting lascia reti aperte
2026-10-28 mute del master: relè G6K-2F coi dati del datasheet Omron (237 ohm, rilascio 3 ms max verificato, piedinatura), 5 relè; bobine scariche in 1,0 ms, accensione invariata
2026-10-28 master: sorgente della scheda di segnale (bozza, primo giro NON PASSA: 282 impronte, non sta in 100x165), NOTE con le scelte; AC_OK sul pin c17 del C96
2026-10-28 CLAUDE.md: stato delle schede del master e regola di stima delle impronte
2026-10-28 decisione 142: schede alte 220 mm, SMD sui due lati, master in 3 schede affiancate (rivede la dec. 140)
2026-10-28 generatore: SMD sul retro (d.side), strato interno di piste, fascia di bordo, ponticelli fuori distinta; FX-SEND a 100x220 (dec. 142), PASSA
    [fx-send.kicad_pcb, fx-send.kicad_sch]
2026-10-29 decisione 143: le schede d'uscita del master hanno un C96 loro (alimentazione e controllo), il master occupa 3 slot
2026-10-29 decisione 144: la forma del telaio non limita la funzione, misure e slot provvisori
2026-10-29 proto-max: MC-FILTRO-S rigenerato con l'HPF da 20 Hz (dec. 137, era rimasto alla legge vecchia), prova_semplice e prova_filtro PASS; tutorial: escursione di FREQ e prova 8.2 col fondo dell'HPF, PDF r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
2026-10-31 decisione 145: limiter fisso sul MIC nel VCA del MUTE (variante 2, rilascio 1 s), simulato; design doc REV col circuito; generatore: --solo-schema
2026-10-31 proto-max: protezione in MC-CHANNEL e -S (campione NaN/inf/oltre +36 dBFS -> stati a zero e silenzio), contro la traccia di Live avvelenata con EQ SERIE; prova_gen e prova_semplice PASS
2026-10-31 5-way: NASTRO VER COMPL. MEDI (COMPLETO con enfasi 300/600 Hz, senza head bump: 1 kHz 11,5 %, 8 kHz 15,5 % al nominale); modello contro LTspice 0,05/0,11 punti (alt-completo-medi*.cir); confronto_alt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
2026-10-31 dec. 156-158: tetto 70 %, telaio 19" 13U, inclinato 150-215 mm (schede a trapezio); piano delle schede #203 (pcb/PIANO-schede.md, piano_schede.py)
2026-10-31 CLAUDE.md: stato al 2026-10-31 (decisioni 1-158, Prova 0 passata, libretto fatto), trappole send~/receive~ e bilineare di ordine alto
2026-10-31 pannelli: proposte di disposizione A/B/C con schede per modulo (todo 203); pannelli.pdf pagine 4-7
2026-10-31 pannelli: proposte B e C con master e filtro larghi 144 mm davanti, 5-way 388 mm in fondo
2026-10-31 docs/11: benchmark delle dimensioni (22 modelli con misure), cosa decide la taglia di un mixer, confronto con maelcum
2026-10-31 filtro dopo il fader, 4 core sui bus HPF e LPF (dec. 159): documenti, backplane, budget, diagrammi, piano schede
2026-10-31 master: PGFB di LT3045/LT3094 a IN (a massa teneva acceso il fast start-up); pinout verificato sui datasheet Rev. B. FX-SEND: estremi e impronta RK09L verificati sul catalogo Alps (todo 201, 168)
2026-11-02 docs/02: A22, GAIN di canali e ritorni con pot doppio invece dei VCA (proposta)
2026-11-02 dec. 162: GAIN di canali e ritorni a pot doppio selezionato, meta sinistra = trim (chiude A22, apre A22bis); VCA ~74 -> ~58, sistema -82,9 dBu A
2026-11-02 A22bis simulata: levetta HPF/OFF/LPF col dip del VCA del fader (2 RC da 0,5 ms) toglie il click (+14 -> sotto la musica sul bus che riceve); possibile errore nella ramp degli assign FX-SEND (pin IN d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
2026-11-03 dec. 164: kill del 5-way secco ma senza scoppi, taglio al passaggio per lo zero della via (kill-zc.cir: gradino -92...-44 dB vs secco); corregge la lettura del benchmark in dec. 88
2026-11-03 FX-SEND assign (todo 224, 185): la ramp sul pin IN non esiste (pin logico, datasheet Rev. E) -> taglio allo zero come dec. 164; ADG a +-15 V tosa a +22,5 dBu -> switch dopo la R di iniezione, sul nod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
2026-11-03 todo 220: buffer d'ingresso del ritorno FX a guadagno 1 (tosava a +18 dBu: 17,4 Vp su +-18 V), 6 dB all'invertente finale di T2; rumore -96,2 dBu A (+0,1 dB)
2026-11-03 CLAUDE.md: trappola del pin IN dell'ADG1434 (logico, niente rampa) e del range del segnale
2026-11-03 todo 184: rumore del FX-SEND con la scheda v0.2 (cella LOW Baxandall, switch dopo la R): send -101,7 dBu A a LEVEL max, floor -111,2 (4 dB meglio); sistema con FX in uso -81,8 PASS; i -73/-66,6 della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
2026-11-03 todo 200: matrice MONO coi componenti; il VCA + I/V non inverte (datasheet THAT 2181 p. 7): uscite L/R scambiate, corrette nel generatore; 47p sul ramo M; separazione -38 dB (errore del VCA), rumore 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
2026-11-03 todo 223: budget dopo le dec. 162-164 e i todo 185/224: -16 VCA (58), GAIN a pot doppio, logica 74HC di levetta e kill, comparatori dello zero; conteggi di VCA e trimmer calcolati dallo script; compl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
2026-11-03 todo 169, 186: design doc FX-SEND allineato alla scheda v0.2 (4 OPA1654, scheda comandi col cavo piatto al posto del front connector, LEVEL curva A, comparatori e flip-flop degli assign)
2026-11-03 todo 230: addendum dec. 95 di docs/06 segnato SUPERATO (rimanda al §15); budget senza numeri scritti a mano (VCA per FX-RET da conta_modulo, variante c-B da costanti); totali invariati
2026-11-03 todo 227: netlist della misura di segno del 5-way nel repo (pol-5way-ac.cir)
2026-11-03 todo 215: filtro sui bus HPF e LPF (dec. 159): somma dei canali a guadagno 1, in banda passa fino a +12 dBu, sul taglio tetto del core fra -1 e +1,2 dBu (risonanza sul programma sparisce con 2 canali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
2026-11-03 todo 216 (parte): MC-FILTRO-HPF e MC-FILTRO-LPF, una sezione per la traccia del bus dopo il fader (dec. 159); genera_filtro.py --bus; prova_semplice PASS (scarto 0 contro -S con MODO); manca montaggi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
2026-11-04 todo 207: prova_semplice controlla che ogni .genexpr su disco sia quello che il generatore scrive oggi (8 versioni); il confronto campione per campione vedeva gia l'HPF vecchio (3 casi FUORI su 6), i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
    Claude-Session: https://claude.ai/code/session_01P1GC8eyAwPGC2AZvS1FY1h
2026-11-04 dec. 165-166: GROWL a bande (basso 4 poli 250 Hz, 470 ohm, ramo dei medi morbido) e NASTRO a bande dal LIBERO (sub e kick puliti, molto su medi e alti); tabelle in RISULTATI-P2 §12, modelli growl_ban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
    Claude-Session: https://claude.ai/code/session_01P1GC8csfV9moXLC4rpe2oB
2026-11-04 todo 205: FX-SEND rigenerato col generatore nuovo, PASSA (DRC 0, 0 aperti; audio 10/24/12/5/6); 1,74k E96 sugli ADJ, nota GLOBAL_MUTE tolta; generatore: regole delle classi sottili da una fonte sola 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
    [bom.csv, fx-send-comandi.kicad_pcb, fx-send.kicad_pcb, fx-send.kicad_sch]
2026-11-04 todo 30: schema e distinta dei moduli MIC e MONO (pcb/mic, pcb/mono, celle comuni in pcb/tools/celle_micmono.py): SCHEMA PASSA per tutti e due (ERC 0 errori); MIC 204 pezzi, MONO 125; differenziale s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
    [bom.csv, mic.kicad_sch, mono.kicad_sch]
2026-11-04 todo 211: isolator hardware riallineato agli incroci C (150 LR2 / 350 / 3150 Hz, dec. 152): banca = prototipo entro 0,05 dB, centro +0,004 dB, rumore -97,4 dBu A-wtd (invariato), 10 quad per canale i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
2026-11-04 todo 196: generatore, blocchi vicino al loro connettore (_place_near): EQ sotto il cavo, iniezione e buffer sul C96, alimentazione lontana dal cavo; FX-SEND PASSA, audio A1-A5 10/24/12/5/6 -> 9/14/12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
    [fx-send-comandi.kicad_pcb, fx-send.kicad_pcb]
2026-11-04 dec. 168: isolator con pot lineare B (Filippo, todo 239); rivede la dec. 146 per l'hardware
    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
2026-11-04 todo 233: GROWL e NASTRO a bande in MC-5WAY (voci BANDE di GROWL VER e NASTRO VER)
    Blocchi calcolati solo quando il selettore li pesa, stati a zero da spenti.
    prova_5way PASS (bande entro 0,05 dB sui due canali), prova_semplice PASS;
    MC-5WAY-S invariato. RISULTATI-P2 §13.
    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
2026-11-04 todo 240: MC-CHANNEL-S sulla curva LINEARE (dec. 168, pot lineare B come l'hardware)
    Il -S passa da PIONEER a LINEARE; MC-CHANNEL rigenerato identico (la voce
    LINEARE esiste gia e segue la simulazione hardware entro 0,3 dB).
    prova_semplice confronta il -S con CURVA LINEARE: PASS; prova_gen PASS;
    regole_gen nessuna collisione. RISULTATI-P0 e montaggio aggiornati.
    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
2026-11-04 todo 237: MONO, PCB principale e scheda comandi PASSA
    Principale 100x220 (127 impronte): DRC 0, nessuna rete di segnale aperta; audio A1-A5 9/21/10/3/0.
    Le distanze delle classi sottili vengono gia da Design._classrules (todo 205): nessuna modifica al generatore.
    Scheda comandi (mono-comandi.py): 7 pot RK09L singoli, LED bicolore, J1 2x11; PASSA.
    Ordine dei fili in cavo.py; celle_micmono.scheda_comandi comune col MIC.
    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
    [bom.csv, mono-comandi.kicad_pcb, mono-comandi.kicad_sch, mono.kicad_pcb]
2026-11-04 todo 167: schema e distinta del CANALE CDJ/LINE (pcb/canale, celle comuni in pcb/tools/celle_vca.py): SCHEMA PASSA (ERC 0 errori), 380 impronte, 30 chip; isolator incroci C con pot B, GAIN T1, fader 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
    [bom.csv, canale.kicad_sch]
2026-11-04 todo 237: MIC, PCB principale a due lati e scheda comandi PASSA (al limite)
    Principale 100x220, 206 impronte: LED e VCA/limiter sul retro, EQ2 davanti, piste +-18 a 0,4 mm.
    DRC 0, nessuna rete di segnale aperta; audio A1-A5 26/32/17/2/0.
    Esito instabile: 2 giri su 4 PASSA (altri: una rete aperta o 2 errori di distanza), in NOTE.md.
    Scheda comandi (mic-comandi.py): 7 pot RK09L, LED bicolore, tasto MUTE, J1 2x12; PASSA.
    Ordine dei fili in cavo.py. Generatore non toccato.
    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
    [bom.csv, mic-comandi.kicad_pcb, mic-comandi.kicad_sch, mic.kicad_pcb]
2026-11-04 todo 167: schema e distinta di FX-RET (412 impronte, 34 chip, 20 trimmer) e PSU-IN (41): SCHEMA PASSA tutte e due; PCB: FX-RET non sta su una 100x220 (proposta di due schede), PSU-IN NON PASSA (4 ape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
    [bom.csv, fx-ret.kicad_sch, psu-in.kicad_sch]
2026-11-04 todo 170: proposta per il C96 più lungo del pannello FX-SEND e l'altezza delle schede (trapezi della dec. 158): C96 3x32 per tutti, scheda dentro la colonna non dentro il pannello, generatore col tra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
2026-11-04 RISULTATI-P2 par. 15: ricerca per il ritocco di GROWL e NASTRO a bande chiesto da Filippo (proposta, non applicata)
    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
2026-11-04 CLAUDE.md: stato delle PCB al 2026-11-04 sera e trappola della THD a 12 kHz nel modello
    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
2026-11-04 todo 245: NASTRO a bande B9 (curva inversa, inclinazione dei medi, ramo -3,5 dB) nel modello e in MC-5WAY; LTspice fermo: la spinta a op-amp collassa il passo (RISULTATI-P2 par. 16)
2026-11-04 todo 167: PSU-IN PCB PASSA (portafusibile PTF78 a due pin: la clip 5x20 ha pad doppi che Freerouting non collega)
    [bom.csv, psu-in.kicad_pcb, psu-in.kicad_sch]
2026-11-04 todo 167: CANALE diviso in due schede (PROVVISORIA, todo 249): segnale col C96 e isolator senza C96, ponte 2x18; PCB PASSA tutte e due; logica 74HC in TSSOP-14, J3 fuori dal foro H2, ±18 a 0,4 mm
    [bom.csv, canale-isolator.kicad_pcb, canale-isolator.kicad_sch, canale.kicad_pcb, canale.kicad_sch]
2026-11-04 todo 204 e 206: master, scheda di segnale PASSA (giro 13: LEVEL sul davanti, BUFFER e VIE_TAP sul retro, RAW+-22/+5V/CTRL_GND fuori dal C96) e schede d'uscita L e R PASSA (J4 della L a pin alternati)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
    [bom.csv, master-segnale.kicad_pcb, master-segnale.kicad_sch, master-uscita-L.kicad_pcb, master-uscita-L.kicad_sch, master-uscita-R.kicad_pcb, master-uscita-R.kicad_sch]
2026-11-04 todo 167: FX-RET diviso in due schede (PROVVISORIA, todo 249): segnale col C96 e reroute senza C96, ponte 2x16; PCB PASSA tutte e due; trimmer SMD sul reroute, ±18/±15LN/V27F a 0,4 mm, J3 fuori dal f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
    [bom.csv, fx-ret-reroute.kicad_pcb, fx-ret-reroute.kicad_sch, fx-ret.kicad_pcb, fx-ret.kicad_sch]
2026-11-04 todo 245: NASTRO B9 in LTspice: modello e circuito coincidono a 50/120/500 Hz (0,05 punti), 3 e 12 kHz non terminano; rumore a fine corsa -79,8 dBu A; spinta come sorgente B, macro con polo; prove t9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
2026-11-05 dossier-en: dossier tecnico in inglese (HTML stampabile A4) per un costruttore di preamp
2026-11-05 diagrammi: tutti gli SVG allo stato delle decisioni 1-168 (richiesta di Filippo) + versione inglese in docs/diagrammi/en (traduzione_en.py, cella-v021-en.frag); index.html italiano e inglese; PDF non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
2026-11-05 todo 248: PCB del MIC stabile, 5 PASSA su 5; A1 26 -> 9
    Blocchi di alimentazione per regolatore (celle_micmono, opzione blocco=, default
    invariato), C dei regolatori legati al pin d'angolo, seconda ricerca del fanout di
    massa, In2 di segnale, link_pairs, cluster_gap 0,8, fino a 4 tentativi di
    Freerouting con la scheda ricostruita e -mp diverso, controllati col DRC.
    Generatore invariato. Esiti in pcb/mic/NOTE.md.
    [mic.kicad_pcb, mic.kicad_sch]
2026-11-05 CLAUDE.md: stato delle PCB al 2026-11-05, trappole di Freerouting e della macro op-amp
2026-11-05 MC-5WAY: GROWL a curva lenta (t^1,5), NASTRO B9 a curva inversa piu veloce (1-(1-t)^2,5), fine corsa invariati; RISULTATI-P2 par. 17
2026-11-05 todo 258: fusibili del ramo ±22 da T2,5 A a T4 A (2,70 A di progetto = 108 % del T2,5); PSU-IN rigenerato, PASSA
    [bom.csv, psu-in.kicad_pcb, psu-in.kicad_sch]
2026-11-05 benchmark: Deep Field Preamp V1 letto dai sorgenti (docs/07 §6: crossover 91/239/4168 LR4, kill sull'uscita per via, PCB 2 strati a foro passante); incroci e kill della via del kick contro il benchma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
2026-11-05 CLAUDE.md: trappola cshunt di LTspice e kill del 5-way contro le casse
2026-11-06 B3: varianti F 70/220/1,2k/8k e H 60/250/1,2k/8k nel CROSSOVER di MC-5WAY (via KICK piu larga, SUPER a 8k); kill sulle casse in sim/five-way/kill_casse.py; RISULTATI-P2 par. 20
2026-11-06 CLAUDE.md: una via piu larga non spegne la cassa
2026-11-09 Diagrams: English set in docs/diagrammi/en is now the maintained one (Italian frozen at 2026-11-05); PSU-IN fuse T4 A per rail (todo 258)
2026-11-09 dec. 169 (todo 218): taglia di ogni comando su cinque taglie, fader dei ritorni corti; inventario comandi con MUTE del MIC e MONO del master
2026-11-09 dec. 169: fader 60 mm sui canali e 45 mm sui ritorni FX (era 100 mm, dec. 120)
2026-11-09 dec. 169: taglia molto piccola = cappuccio 6 mm sul pot da 9 mm
2026-11-09 proposta E (todo 203): colonna filtro-canali-mandate-CUE, master in cima, 5-way, MIC/MONO, ritorni; misure libere, 10U = 444 mm
2026-11-09 proposta E: EQ dei canali nella colonna sfalsata di oggi (dec. 118), SEND di MIC e MONO a due a due; resta 10U
2026-11-09 proposta F (todo 203): master e 5-way larghi 19", niente pannelli ciechi, aria ai moduli fitti; 13U = 578 mm
2026-11-09 proposta F: colonne sfalsate in MIC, MONO, ritorni e sezione FX SEND; variante col CUE a destra a 12U = 533 mm
2026-11-09 render e coordinate.json dalla disposizione F (dec. 172); schede comandi FX-SEND, MIC, MONO rigenerate: PASSA in due giri; passo minimo 14 mm per i pot da 9 mm in colonna
    [bom.csv, fx-send-comandi.kicad_pcb, fx-send-comandi.kicad_sch, mic-comandi.kicad_pcb, mic-comandi.kicad_sch, mono-comandi.kicad_pcb]
2026-11-09 todo 203: piano schede sulla disposizione F (pcb/PIANO-SCHEDE.md): 32 schede, tutte entro il 70 %; C96 lungo 95 mm -> schede da sinistra a destra sotto master, 5-way, filtro e CUE
2026-11-09 piano schede F in pcb/PIANO-SCHEDE-F.md; ripristinato il piano del 31/10 (sovrascritto per maiuscole/minuscole su macOS), segnato superato
2026-11-09 CLAUDE.md: disposizione F (dec. 170-172), taglie e fader (dec. 169), C96 e passo dei pot da 9 mm, trappola maiuscole su macOS
2026-11-09 Schema leggibile delle 14 schede (pcb/tools/leggibile.py): fili, simboli di alimentazione, blocchi in fila; stesso netlist della PCB, confronto nei due sensi, PDF in pcb/<scheda>/leggibile/
    [canale-isolator.kicad_sch, canale.kicad_sch, fx-ret-reroute.kicad_sch, fx-ret.kicad_sch, fx-send-comandi.kicad_sch, fx-send.kicad_sch, master-segnale.kicad_sch, master-uscita-L.kicad_sch]
2026-11-09 Readable schematics in English and in one document: pcb/schematics-readable.pdf (cover, index, legend, 14 boards); translations in pcb/tools/leggibile_en.py
    [canale-isolator.kicad_sch, canale.kicad_sch, fx-ret-reroute.kicad_sch, fx-ret.kicad_sch, fx-send-comandi.kicad_sch, fx-send.kicad_sch, master-segnale.kicad_sch, master-uscita-L.kicad_sch]
2026-11-09 Readable schematics: FX-SEND and MIC control boards regenerated after today's board changes (todo 271)
    [fx-send-comandi.kicad_sch, mic-comandi.kicad_sch]
2026-11-09 CLAUDE.md: readable schematics command (pcb/tools/leggibile.py, pcb/schematics-readable.pdf)
2026-11-09 Decision 173: CDJ channel on a single ~287 mm board, FX return on two (todo 249 closed, 252 superseded); board plan F now 28 boards
2026-11-09 Decision 174: mixed digital/analog version starts (misto/): chip moves only CVs, same panel, USB editing, one chip per module; first inventory of control circuits (todo 263)
2026-11-09 misto: space counted on the generated boards: ~150 footprints less in the whole mixer, no board removed, panel unchanged
2026-11-09 misto M6: goes on for calibration and precision, not cost and space
2026-11-09 misto: footprint counting script kept in misto/script/
2026-11-09 misto 03: control block requirements and topology, first case FX-RET (todo 277)
2026-11-09 Generator: trapezoid boards (dec. 158, proposal P3); CDJ channel rewritten on one 287 mm board (dec. 173), not passing yet (35 open after round 4)
    pcbgen.py: board=(L, H_back, H_front), d.ytop(x), cut triangle as placement obstacle and
    stepped keepout; Freerouting gets the bounding rectangle (with the slanted outline it never
    finished). Rectangular boards unchanged. Two-board channel archived in pcb/canale/archivio/.
    KiCad files of the channel stay at the 4/11 signal board until the new one passes (todo 272).
    [bom.csv, canale-isolator.kicad_pcb, canale-isolator.kicad_sch, canale.kicad_pcb, canale.kicad_sch]
2026-11-09 CLAUDE.md: trapezoid boards in the generator (todo 272)
2026-11-09 misto: CV cell simulated in LTspice and firmware model, FX-RET (todo 278)
    DAC at 8 kHz with interpolation matches the continuous chain (delay 1.44 ms).
    Divider 15k/1k keeps the EC pin under its 1 V absolute max when the op-amp saturates.
    Firmware: 8-sample average and 2 LSB hysteresis pass R1-R7.
2026-11-10 misto M9: one USB socket on the master, bus between modules (todo 279)
2026-11-10 misto: CV cell offset from -15LN and feedback clamp, faults simulated (todo 280)
2026-11-10 regole_gen.py: rules R1-R5 from the lint_gen prototype, R4 as a warning until todo 209 (todo 267)
2026-11-10 VCA EC- pin kept within the +-1 V absolute maximum: high divider 18.2k/1k, x1.916 stage, channel dip into the shaper sum node; master and FX-RET regenerated, PASS (todo 281)
    [bom.csv, fx-ret-reroute.kicad_pcb, fx-ret-reroute.kicad_sch, fx-ret.kicad_pcb, fx-ret.kicad_sch, master-segnale.kicad_pcb, master-segnale.kicad_sch]
2026-11-10 Channel board rounds 5-7: link_pairs closes RAW, +5V and ECF_R; CTRL_GND stays open at any width, not passing yet (todo 272)
2026-11-10 CLAUDE.md: decision 175, VCA EC- pin limit
2026-11-10 Decision 176: F modules redrawn by Filippo, aligned to a grid; FX-SEND EQ pot Alpha RD902F linear (todo 217); control boards FX-SEND, MIC, MONO regenerated, PASS
    [bom.csv, fx-send-comandi.kicad_pcb, fx-send-comandi.kicad_sch, mic-comandi.kicad_pcb, mic-comandi.kicad_sch, mono-comandi.kicad_pcb]
2026-11-10 Decision 176 (g): level LED on all five 5-way bands, SUPER included (todo 291)
2026-11-10 Decision 159: origin corrected to [F], the post-fader filter was Filippo's idea (todo 262)
2026-11-10 Generator: link_pairs_masse (default off) also links twin pins of ground nets without a pour (CTRL_GND, CHASSIS); one open twin makes Freerouting 2.5 tear the whole net down (todo 272)
2026-11-11 VCA EC- pin of master MONO and MIC MUTE kept within +-1 V: gain stage plus high divider (MONO x2.36 + 18.2k/1k, MUTE x19.21 + 4.99k/274); limiter and MUTE unchanged, pin 0.80 V at the rail (was 1.88 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
    [bom.csv, master-segnale.kicad_pcb, master-segnale.kicad_sch, mic.kicad_pcb, mic.kicad_sch]
2026-11-11 Master control board (BOOTH, MASTER, MONO button, two 20-LED bars with LM3915): new shared cells in pcb/tools/comandi.py, PASS at first round; LM3915 decoupling caps still far from the chips (A1 warn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
    [bom.csv, master-comandi.kicad_pcb, master-comandi.kicad_sch]
2026-11-11 Readable schematics regenerated with the master control board, 15 pages, all PASS
    [canale.kicad_sch, fx-ret-reroute.kicad_sch, fx-ret.kicad_sch, fx-send-comandi.kicad_sch, mic-comandi.kicad_sch]
2026-11-11 CLAUDE.md: master control board PASS, EC- pin fixed on MONO and MUTE (todo 288)
2026-11-11 Channel on one trapezoid board (287 mm, dec. 173) PASS: Freerouting retry moved from mic.py into pcbgen.DesignRiprova, used by canale.py and mic.py; link_pairs_masse closes CTRL_GND; readable schemat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
    [bom.csv, canale.kicad_pcb, canale.kicad_sch]
2026-11-11 5-way level LEDs (dec. 176 g): read after the drive, analysis bank at H crossovers, MIC detector and LED3 per way; thresholds -18/+12/+18 dBu out within 0.4 dB; draft failure was the superdiode macro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
2026-11-11 Channel lever dip re-simulated with the real logic (todo 289): the drawn DIFF node released only through 100k (~40 ms hole) and a lever flicked back with CLK high muted the channel 40-80 ms; fix with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
    [bom.csv, canale.kicad_pcb, canale.kicad_sch]
2026-11-11 CLAUDE.md: logic modelling and switch-click trap (todo 289)
2026-11-11 Channel control board (todo 270): GAIN and isolator dual pots, FILTER and LINE/PHONO toggles, FX1-4 and CUE lit buttons, 10-LED LM3915 bar, 60 mm fader; J2 2x18 read from canale.py, J3 1x6 to fx-send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
    [bom.csv, canale-comandi.kicad_pcb, canale-comandi.kicad_sch, master-comandi.kicad_pcb, master-comandi.kicad_sch]
2026-11-11 CLAUDE.md: channel control board at PASS
2026-11-11 FX-RET control board (todo 270): GAIN dual pot (T2: CCW = O2A, wiper GW, CW = GA), EQ2 dual pots, 4 reroute pots with centre detent wired reversed to POT_R1-4 (position j = bus Sj, as the panel), 10-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
    [bom.csv, fx-ret-comandi.kicad_pcb, fx-ret-comandi.kicad_sch]
2026-11-11 Decision 177: 5-way lane LEDs read after the drive, thresholds -18/+12/+18 dBu at the module output, L+R sum (closes A24, todo 292); dec. 163 REV confirmed by Filippo (lever breath ~4 ms, todo 293)
2026-11-11 CUE signal board (todo 294): 196x124 mm, cue sum with 10k injection here, inverting MON buffer (F4), blend buffer C2 (keeps -6 dB per side at centre; sistema-cue §5 REV), headphone amp v0.2 with one 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
    [bom.csv, cue-comandi.kicad_pcb, cue-comandi.kicad_sch, cue.kicad_pcb, cue.kicad_sch, fx-ret-comandi.kicad_sch]
2026-11-11 Backplane for layout F in four sections (todo 269): T1 rear (master, outputs, 5-way, PSU-IN), T2 channels (filter, 4 channels, 4 FX-SEND), T3 headphones (CUE), T4 right (MIC, 3 MONO, 4 FX-RET). Slot 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
    [backplane-t1.kicad_pcb, backplane-t1.kicad_sch, backplane-t2.kicad_pcb, backplane-t2.kicad_sch, backplane-t3.kicad_pcb, backplane-t3.kicad_sch, backplane-t4.kicad_pcb, backplane-t4.kicad_sch]
2026-11-11 Readable schematics with the four backplane sections (todo 301): tratto.py exposes progetta() so leggibile.py reads tratto.py:T1-T4; English for slot, cable, power and jumper blocks and values by pat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
    [backplane-t1.kicad_sch, backplane-t2.kicad_sch, backplane-t3.kicad_sch, backplane-t4.kicad_sch]
2026-11-12 Backplane C96 geometry from the Harting drawing (todo 302): rows a/b/c sit on the module's component side, row a 2.11 mm from the module board mid-plane (1.6 mm board, row b 3.85 mm from the F face, 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
    [backplane-t1.kicad_pcb, backplane-t1.kicad_sch, backplane-t2.kicad_pcb, backplane-t2.kicad_sch, backplane-t3.kicad_pcb, backplane-t3.kicad_sch, backplane-t4.kicad_pcb, backplane-t4.kicad_sch]
2026-11-12 Module board C96 at the Harting edge distance (todo 303): generator place is the pad centre (row b), so y = H - 6.5 put row a 3.96 mm from the edge, not 6.5. New backplane.C96_DAL_BORDO = 5.3 + 2.54 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
    [canale.kicad_pcb, cue.kicad_pcb, fx-ret.kicad_pcb, fx-send.kicad_pcb, master-segnale.kicad_pcb, master-uscita-L.kicad_pcb, master-uscita-R.kicad_pcb, mic.kicad_pcb]
2026-11-12 CUE protection [G] simulated (todo 298): window thresholds 17.06 / 20.15 / -16.94 / -19.93 V, negative nodes never below -0.19 V, power-on 1.42-1.95 s with CT -20 % to +10 %, contacts open 4.1 ms aft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
2026-11-12 Decision 178: name on the chassis is "maelcum mixer" (todo 26, closes A10 and item 29); chassis size already set by dec. 158, 170, 172. A11 measuring instruments stays deferred until the prototype (t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
2026-11-12 Prototype -S devices on the latest choices, and a light browser bench (web/)
    MC-5WAY-S now fixes crossover H, GROWL BANDE and NASTRO BANDE B9 (dec. 175; was E, LIBERO,
    EXCITER) and computes only those blocks; GROWL and NASTRO at zero are skipped with states
    reset. prova_semplice: -S equals MC-5WAY at xo 6, gv 2, nver 6 (max error 3e-15).
    MC-5WAY: Param gv max 1 -> 2, so GROWL VER can reach BANDE (in Live BANDE probably played
    as LIBERO; to verify, todo 307). GAIN of channels and FX returns follows the dual pot of
    dec. 162 (T1 and T2 of sim/gain-pot) instead of the VCA law. prova_gen, prova_fx,
    prova_semplice, prova_5way, regole_gen pass.
    web/: top view of panel layout F with the four FX ped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
2026-11-12 Browser bench: review fixes and GitHub Pages support
    Four read-only reviews (engine, page, translation fidelity, usability). Fixes: 5-way worker
    no longer marks skipped blocks as done after a stall (stale audio), falls back to the in-engine
    5-way if the worker fails or Atomics.waitAsync is missing, queues knob messages during start-up;
    output guard against NaN; MIC LED reads the device state 0-3; filter toggle zones measured on the
    lever; fader drags from its cap; errors shown in a field the meter does not overwrite; touch
    scrolling and pinch on the panel, larger hit area on small knobs, zoom buttons, space = Play,
    readout of the control under the pointer. gen2js: NaN-safe set, state reset o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
2026-11-12 Browser bench: 5-way lane LEDs (dec. 177) from an analysis bank on the 5-way output (ledvie.js): L+R sum, Butterworth cells at H crossovers, peak with 0.3 s release, thresholds -18/+12/+18 dBu, red h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
    Claude-Session: https://claude.ai/code/session_01P1GC8dEPfhkynYSbKNpgLA
2026-11-12 Browser bench: MONO 1-3 play through a new MC-MONO device (genera_mic.py: jack buffer, passive A-taper GAIN, +10 dB make-up, EQ2, LED, 4 sends; no HPF, MUTE or limiter), NJD dub siren in MONO 1 and a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
    Claude-Session: https://claude.ai/code/session_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
2026-11-12 Browser bench: NJD S4 re-read from the schematic (C2 common feeds half A, C3 half B, C1 puts +9 V on D1/D2 in position 3: falling siren / chopped beep / two-tone / full sweep), power ramp 20 ms; Audi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
2026-11-12 CLAUDE.md: twin ground pins need link_pairs_masse
    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
2026-11-13 Browser bench lighter without losing functions: fixed 48 kHz context (96 kHz cards doubled the 5-way), 5-way split in two Workers one per side (gen2js writes mc-5way-s-l/-r from the lato markers; L+R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
